bergamifer/DS-Project/hardware/DS/renders/DS7.png

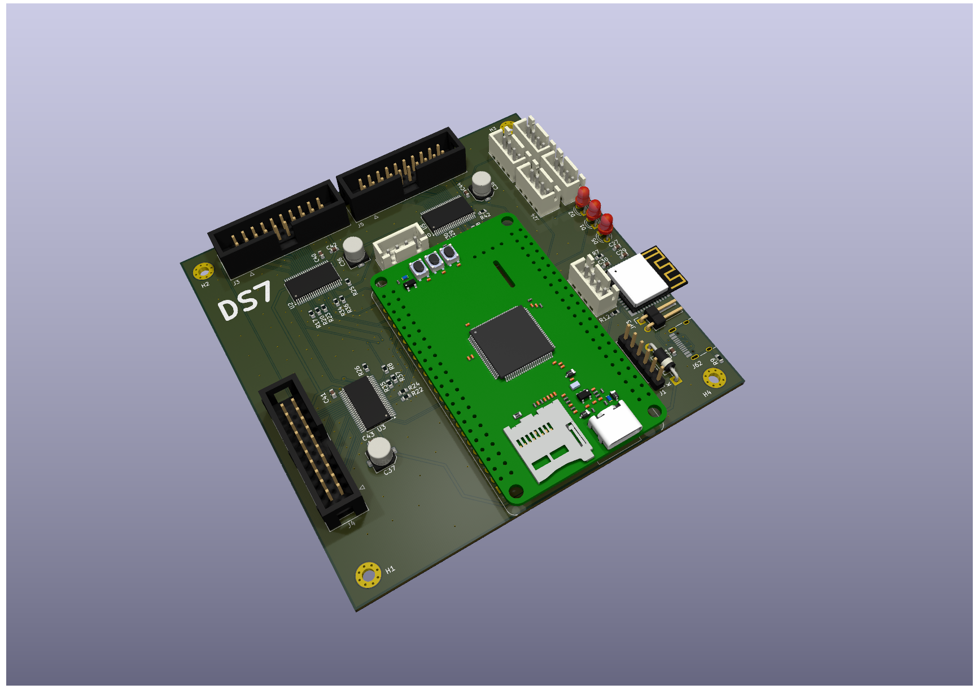
hardware/DS/renders/DS7.png
