bergamifer/DS-Project/hardware/DS/renders/DS9.png

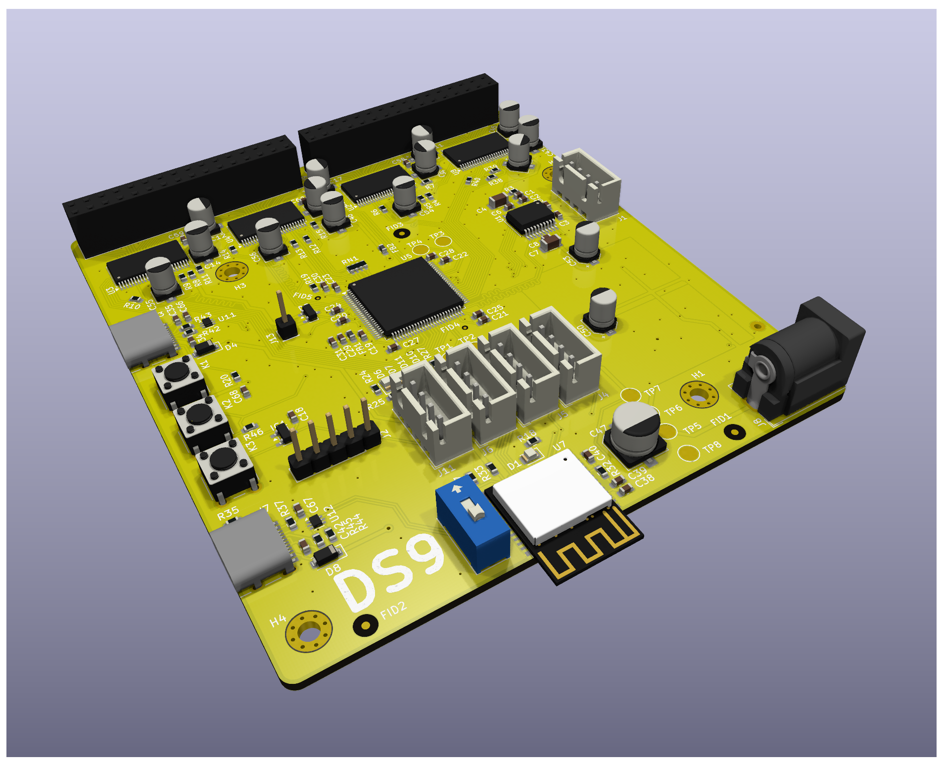
hardware/DS/renders/DS9.png
