bergamifer/DS-Project/Mis-comandos.md

# Comandos y Referencias - DS11 Beamforming (32 canales)

> Lo de más abajo que dice "DS9" es histórico. Lo vigente está en esta sección.

## Checklist al iniciar sesion

- [ ] Conectar ST-Link (SWD). ⚠️ **Cortar el pin 1 del cable** (3V3 sin Schottky
      → colapsa el dongle, ver `docs/ds11_errata.md`).
- [ ] **Si vas a usar ESP32 UART: desconectar ST-Link serial** (contención en PA0/PA1)
- [ ] Fuente a **19-20 V** (NO 24 V) y con **límite de corriente holgado** — un
      límite bajo hace reiniciar la placa al arrancar los amps.
- [ ] Abrir el monitor serie en terminal separada

---

## DS11 — Control por HTTP (lo que más se usa)

```bash
IP=domosonica.local      # mDNS; también sirve la IP de la línea "ESP:" del heartbeat

curl -s http://$IP/status                                   # telemetría completa
curl -X POST http://$IP/amps   -d '{"on":true}'             # ⚠️ arrancan APAGADOS
curl -X POST http://$IP/mode   -d '{"mode":1}'              # 0..15
curl -X POST http://$IP/volume -d '{"db":-24}'              # 0..-63, ≤-64 mute (SALIDA)
curl -X POST http://$IP/ingain -d '{"db":0}'                # 0..36 (ENTRADA: 0=línea, 30=mic)

# Foco TX (mm, relativo al centro del array; fy enfoca desde DS11)
curl -X POST http://$IP/beam -d '{"type":"tx","fx":0,"fy":-300,"fz":1000}'

# Foco de UNA fuente del MULTIFOCUS (src 0-7)
curl -X POST http://$IP/beam -d '{"type":"mf","src":2,"fx":600,"fy":0,"fz":1000}'
```

**Los amps arrancan apagados** desde el incidente de brown-out: sin `POST /amps`
la placa está muda aunque todo el pipeline corra. Sirve como herramienta de
diagnóstico — si algo reinicia con amps ON y no con OFF, es alimentación.

### Modos (16)

| # | modo | | # | modo |
|---|---|---|---|---|
| 0 | Monitor ADC | | 8-11 | RX beam / AUTOFOCUS |
| 1 | **Channel walker** (1 s/ch, 32 s la vuelta) | | 12-13 | Tono enfocado |
| 2-7 | Tonos / TX focus | | 14 | MULTIFOCUS tonos |
| | | | 15 | **MULTIFOCUS 8 entradas** (la intervención) |

### Qué mirar en el heartbeat

```
[Ns] Half: 50/s, Full: 50/s, Err: 0, Undr: N, ... | ESP: <IP>
     SYNC bancos: 1 us (839 cyc) | CPU fills: 26.6%
```

- `Err: 0` — lo único que de verdad tiene que ser cero.
- `SYNC bancos` ~1 µs. Si da **ms**, los bancos se desincronizaron.
- `CPU fills` ~26,6% en modo 7. Si volvés a ver ~60%, revirtió el I-cache o el `-O2`.
- `Undr` sube ~2/s **siempre**: son los prints bloqueantes, no el audio.

---

## Build y Flash (STM32)

```bash
cd /Users/bergamifer/STM32CubeIDE/DS-Firmware/firmware

# Solo compilar
make -j4

# Compilar + Flash via ST-Link (recomendado)
make flash-stlink # No olvidar luego resetar con boton K4

# Limpiar y recompilar
make clean && make -j4
```

**Nota DFU:** Para entrar en modo DFU, mantener BOOT0, presionar RESET, soltar BOOT0.

- Flashear en DFU:
```bash
cd firmware && make flash
```

---

## Debug Serial (UART)

```bash
# Monitor serial ST-Link (UART7, PA8/PA15)
minicom -D /dev/tty.usbmodem21102 -b 115200

# Buscar puertos serie
ls /dev/tty.usb*
ls /dev/cu.usb*

# Para salir de minicom: Ctrl+A luego X
```

## Debug Serial SCREEN (UART) <- el que estamos usando en DS11

screen /dev/cu.usbmodem11102 115200

Para matar screen:
Ctrl-A y después k, confirmás con y ← este es el atajo
Alternativa si quedó colgado de otra terminal: screen -ls y screen -X -S <id> quit

---

## Conexiones ST-Link → DS9

```
ST-Link          DS9 Board
--------         ---------
  GND    ─────   GND
  SWCLK  ─────   PA14 (SWCLK)
  SWDIO  ─────   PA13 (SWDIO)
  3.3V   ─────   3.3V  ⚠️ DS9 sin fuente externa (ver issue #1)
  RST    ─────   NRST (opcional, recomendado)
  TX     ─────   PA8  (UART7_RX) ← debug serial STM32 → host
  RX     ─────   PA15 (UART7_TX) ← debug serial host → STM32
```

```
⚠️ PA0/PA1 compartidos: ST-Link serial TX/RX vs ESP32 UART4
   Desconectar ST-Link serial ANTES de usar ESP32 (contención eléctrica)
```

```bash
# Verificar conexion ST-Link
st-info --probe
```

---

## VS Code Tasks (Cmd+Shift+B)

| Task | Descripcion |
|---|---|
| Build | Compilar (default) |
| Clean Build | Limpiar + compilar |
| Flash (ST-Link) | Flash via SWD |

---

## Webserver (control DS9)

```bash
cd /Users/bergamifer/STM32CubeIDE/DS-Firmware/webserver
./run.sh

# Acceso: http://localhost:5001
# Detener: Ctrl+C
```

---

## ESP32-C3 (IDF)

```bash
# Cargar entorno ESP-IDF
. $HOME/esp/esp-idf/export.sh

# Build + flash + monitor
idf.py build
idf.py flash -p /dev/cu.usbmodem1101
idf.py monitor -p /dev/cu.usbmodem1101

# Flash sin rebootear
idf.py flash -p /dev/cu.usbmodem1101 && idf.py monitor -p /dev/cu.usbmodem1101 --no-reset

# Listar puertos
ls /dev/cu.usb*
```

**UART DS9 wiring confirmado (trazas cruzadas en PCB, 2026-02-19):**
```
ESP32 GPIO0 (TX) ──── PA1 (STM32 UART4 RX)   ← firmware: STM32_UART_TX = GPIO_NUM_0
ESP32 GPIO1 (RX) ──── PA0 (STM32 UART4 TX)   ← firmware: STM32_UART_RX = GPIO_NUM_1
```

---

## Archivos Importantes

| Archivo | Descripcion |
|---|---|
| `firmware/Core/Src/main.c` | Init, clocks 480MHz, DMA, callbacks, main loop |
| `firmware/Core/Src/uart_protocol.c` | Parser binario ESP32→STM32 |
| `firmware/Core/Inc/uart_protocol.h` | Protocol defines, ds_config_t |
| `firmware/Core/Src/pcm1690.c` | Driver PCM1690 DAC |
| `firmware/Core/Src/epaper.c` | Driver SSD1681 e-paper |
| `firmware/STM32H743XX_FLASH.ld` | Linker script (.dma_buffer → RAM_D2) |
| `firmware/Makefile` | Build config (TARGET=ds11_beamforming) |
| `docs/pin_map.md` | Mapa completo de pines (DS10/DS11) |
| `docs/guia_operacion.md` | Guía de uso y conexionado (lenguaje no técnico) |

curl -X POST http://192.168.100.44/command \
  -H "Content-Type: application/json" \
  -d '{"master_gain":0.1,"channels":[
    {"channel_num":0,"channel_gain":1.0},{"channel_num":1,"channel_gain":1.0},
    {"channel_num":2,"channel_gain":1.0},{"channel_num":3,"channel_gain":1.0},
    {"channel_num":4,"channel_gain":1.0},{"channel_num":5,"channel_gain":1.0},
    {"channel_num":6,"channel_gain":1.0},{"channel_num":7,"channel_gain":1.0}
  ]}'
