bergamifer/DS-Project/docs/multinode.md

# Multi-nodo: coordinar 10-15 muros (~500 parlantes) sin conocer su disposición

> Escrito 2026-07-05. Responde: *"¿cómo nos preparamos para cuando el setup incluya 10-15
> de estos sistemas? ¿cómo coordinar todos los parlantes si no sabemos la disposición
> espacial?"* — La respuesta tiene tres capas independientes: **geometría** (dónde está
> cada parlante), **reloj** (cuándo dispara cada uno) y **control** (quién decide qué).

---

## 0. El estado de partida

Cada nodo DS10/DS11: 32 parlantes con geometría interna **conocida y rígida** (el muro),
STM32 que calcula delays muestra-exactos **dentro del nodo**, ESP32 con HTTP en la LAN.
Lo desconocido al montar: la **pose de cada muro** (posición + orientación en la sala) y
la **relación entre relojes** de los nodos.

La app iOS ya implementa la base: registro de nodos con pose (x, z, yaw), transformación
del foco global al marco local de cada nodo, y envío fan-out paralelo (`NodesStore.swift`).
**Con eso, 15 nodos ya se coordinan hoy a nivel de comandos** — lo que falta resolver es
geometría fina y fase.

---

## 1. Capa GEOMETRÍA — ¿dónde está cada parlante?

### Nivel 0 (hoy, sin desarrollo): pose manual + foco medido
- Cinta métrica: posición y yaw de cada muro → editor de nodos de la app.
- El error de ~5-10 cm de medir a mano **se absorbe con AUTOFOCUS**: para los puntos
  focales importantes de una obra, el foco se mide con micrófono, no se calcula.
- Suficiente para: instalación estática con focos ensayados.

### Nivel 1: survey con el iPhone (ARKit)
- El iPhone se localiza solo (~cm) caminando la sala; tocás la esquina de cada muro
  (o apuntás y el LiDAR mide) → poses de los 15 muros en un marco común, en minutos.
- Requiere: app en el teléfono físico (v2a del roadmap).

### Nivel 2: auto-survey acústico — el instrumento se releva a sí mismo
La joya, y es factible con el hardware existente: **cada nodo tiene 8 entradas ADC**.
Con 1 micrófono (barato, de medición) por nodo:

1. El nodo *j* emite un chirp por su parlante *k* (el walker ya hace esto).
2. **Todos** los nodos graban y correlacionan (el AUTOFOCUS ya hace esto).
3. Matriz de TOF entre (nodo j, parlante k) → (nodo i, mic i).
4. Multilateración / MDS (multidimensional scaling) → posiciones de todos los muros
   **a escala real** (la velocidad del sonido da la escala), salvo rotación/traslación
   global — que se fija midiendo 2-3 puntos a mano o con el iPhone.
5. Con 32 fuentes por muro, la **orientación** de cada muro también sale del ajuste.

**El detalle del reloj**: el TOF medido entre nodos incluye el offset de reloj del
receptor. Solución clásica (BeepBeep, Microsoft Research): medición **two-way**
(*j* emite y *i* graba; después *i* emite y *j* graba) — al promediar ambas, el offset
se cancela exactamente. Precisión esperable: ~1 cm.

> Prerrequisito de firmware: timestamp de emisión/captura en cuentas de muestra del
> propio nodo + comando para reportar la correlación (`CMD_GET_CAL_RESULT` extendido).

---

## 2. Capa RELOJ — ¿cuándo dispara cada parlante?

> **ARQUITECTURA REAL (aclarada por Fernando, 2026-07-05):** la señal de audio se
> distribuye **analógica** por el daisy-chain (J9, passthrough pasivo); cada nodo la
> digitaliza, beamformea y reproduce **con su propio cristal**. NO se manda MCLK por
> el cable (24.576 MHz por daisy-chain = pesadilla de integridad de señal); JP2 existe
> solo como salvavidas experimental de banco.

### Por qué la distribución analógica se auto-sincroniza

El modelo mental correcto: **cada nodo es una línea de retardo analógica**. Analógico
entra, analógico sale, retardado τ = N/fs_local (N = latencia del pipeline en muestras).
El reloj local solo importa durante los ~20 ms que la señal vive adentro del nodo — el
error de fase entre nodos **no se acumula** con el tiempo (a diferencia del contenido
generado internamente):

    Δτ entre nodos = latencia × Δppm = 20 ms × 40 ppm ≈ 0,8 µs ≈ 0,27 mm

Dos órdenes de magnitud por debajo del tamaño del foco. La fase del "grid" de muestreo
de cada ADC (que sí precede lentamente entre nodos) **no aparece en la salida**:
muestrear y reconstruir con el mismo reloj reproduce x(t−τ) exacto para señal limitada
en banda. La deriva térmica del cristal mueve ese sub-µs, no lo integra.

**Conclusión: para obras alimentadas por la señal analógica del daisy-chain — el caso
de uso real; el pipeline TX ya lee de `beam_line`, que viene del ADC — NO hace falta
ningún cable de clock.**

### Los dos "peros" reales (ninguno pide cable de clock)

1. **La latencia por nodo debe ser constante y conocida.** El offset RX-DMA↔TX-DMA se
   congela al arrancar y puede diferir entre nodos (hasta ~medio buffer, ms). Es un
   offset **constante** (no deriva).

   > ✅ **MEDIDO 2026-08-25** — `loopback_debug.md` §8. El "hasta medio buffer, ms"
   > de acá era **29× pesimista**: sobre 26 arranques, la latencia del lazo cae en
   > **tres estados discretos** dentro de **4,17 muestras = 87 µs = 30 mm**, no
   > 2500 µs. Pero el problema es real igual: 30 mm son **66° de error de fase a
   > 2,1 kHz** entre dos nodos que arranquen en estados distintos, así que el nivel
   > 1 sigue haciendo falta. Que sea cuantizado en tres estados es buena noticia:
   > apunta a una carrera de arranque con tres desenlaces, no a una dispersión
   > continua. Los reinicios fueron por NRST, pero **eso incluye POR completo de
   > los cinco codecs** (el init baja PC11/PC7 antes que nada), así que el
   > resultado vale.
   >
   > ✅ **MECANISMO EXPLICADO, mismo día** — `loopback_debug.md` §9. Se instrumentó
   > el firmware para leer `NDTR` de los DMA de RX y TX en el instante del chirp:
   > sobre 20 arranques, **la fase RX−TX determina la latencia por completo**, con
   > mapeo uno a uno y sin excepciones. O sea que el nivel 1 de acá abajo es
   > exactamente el arreglo correcto, y llevaría la dispersión entre nodos de
   > **29,8 mm a 0,21 mm (140×)**.
   >
   > 🔑 **Y el nivel 2 no necesita cable.** La fase RX−TX sale de un registro:
   > sin loopback, sin J13, sin adaptador, sin micrófono. El cable hizo falta para
   > *descubrir* la relación, no para *usarla*. Cada uno de los 10-16 nodos puede
   > leer su propia fase al arrancar y saber en qué estado quedó.

   Insight clave: los group delays de los conversores
   son constantes de datasheet idénticas en todas las placas — lo único variable es la
   fase RX↔TX dentro del STM32, visible por firmware. Jerarquía de soluciones (2026-07-05):
   - **Nivel 1 — arranque determinístico** (solo firmware). ✅ **IMPLEMENTADO Y
     VERIFICADO 2026-08-25** — `loopback_debug.md` §10. La receta original decía
     "arrancar RX primero", pero **eso es imposible**: SAI1_A genera el MCLK que
     los PCM1690 y el AK5538 necesitan para su POR, así que el TX va primero por
     obligación. Lo que sí se puede fijar es el RX, enganchándolo al wrap del DMA
     del TX. Resultado medido: la dispersión entre arranques pasó de **29,8 mm a
     0,21 mm (140×)**, y la fase quedó en 0 en 41 de 41 arranques.
   - **Nivel 2 — medición por registros** (gratis): leer NDTR del DMA RX y TX en el
     mismo instante → fase relativa exacta en muestras → compensar en el offset de la
     delay line. Verificación/auto-corrección del nivel 1.
   - **Nivel 3 — loop DAC→ADC** (idea de Fernando): NO necesario para ecualizar entre
     nodos (los conversores idénticos se cancelan), pero valioso como **self-test** de
     toda la cadena (chirp+correlación del AUTOFOCUS por el loop = test de fábrica en
     1 s) y como habilitador del truco del oscilador (abajo). Implementación DS11
     recomendada: **header 2 pines DNP tapeando VOUT ch0 del PCM1690 vía R serie ~1 kΩ**
     → cable patch a una entrada de J9 cuando se necesita; salida de línea el resto
     del tiempo. Menos invasivo que un loop fijo en placa.
2. **El contenido generado internamente sí deriva** (tonos de test, walker, chirps:
   no pasan por el ADC → cristal libre → ~1 ms cada 20-50 s entre nodos). Dos
   mitigaciones que lo resuelven (2026-07-05):
   - **Conmutación coordinada "a las T"**: el comando lleva delay de ejecución
     ("aplicá en 500 ms") y cada nodo ejecuta con timer local → el jitter WiFi
     (10-100 ms) desaparece; el error residual es 50 ppm × 0,5 s = 25 µs. Cambio
     chico al protocolo (campo extra en CMD_SET_MODE/SET_BEAM).
   - **El truco del oscilador en la cabecera** (la solución de fondo): no generar en
     15 lugares — el nodo cabecera genera por su DAC → sale por el tap de línea
     (nivel 3 de arriba) → entra al daisy-chain analógico → los 15 nodos lo
     beamformean como señal externa. El contenido generado viaja por la vía
     autosincronizante y la coherencia vuelve gratis.
   (AUTOFOCUS normal es por-nodo — mic y parlante en el mismo reloj — sin problema.)

   *Nota para calibración cruzada* (mic en nodo A midiendo parlantes del nodo B): la
   deriva durante el scan (50 ppm × 30 s ≈ 1,5 ms) contamina la comparación entre
   canales tempranos y tardíos → scans cortos o re-referenciar intercalando un canal
   fijo.

### Si algún día hiciera falta un clock físico (no ahora)

Solo si el proyecto migra a **distribución digital** del audio (más canales
independientes por nodo que los 8 analógicos). Para ese caso la opción correcta ya
está documentada en DS11_PLANNING (interconexión): **TDM re-driven sobre LVDS** por
Cat5e STP — MCLK+BICK+LRCK+DATA en los 4 pares, regenerado por cada caja (repeater),
terminación 100 Ω, drivers tipo DS90LV047/048, conector RJ45, mismo tendido. El clock
viaja embebido en el link y los SAI esclavos corren de reloj externo (BCK/FS
incluidos — resuelve de paso la objeción MCLK-no-es-BCK/FS de la revisión anterior).
Nunca 24.576 MHz crudo single-ended por el chain.

### JP2, entonces

Queda como lo que Fernando lo diseñó: un **hedge experimental** — probar clock común
entre 2 placas en banco, sin promesa de señal limpia en cable largo. No es parte de la
arquitectura de la instalación. (Verificado en netlist: puente simple sin buffer,
pin1→trunk `SAI1_MCLK`, pin2→J5.7.)

---

## 3. Capa CONTROL — ¿quién decide?

- **Hoy (implementado)**: la app iOS hace fan-out directo — foco global → marco local
  de cada nodo → `POST /beam` en paralelo. HTTP liviano: 15 nodos × 1 request por gesto
  es nada. Escala hasta el taller completo sin más infraestructura.
- **Siguiente**: un **director** (laptop o RPi en la sala) que habla OSC/WebSocket con
  las herramientas musicales (Max, SC, Ableton) y reparte a los ESP32. La app pasa a
  hablar con el director. Necesario cuando haya: partituras con timing fino, varias
  fuentes de control simultáneas, u obras que corren solas.
- **Descubrimiento**: mDNS en el ESP32 (`domosonica-N.local`) → la app arma la lista
  de nodos sola. (TODO firmware, trivial con ESP-IDF.)

---

## 4. Plan concreto por fases (cuando lleguen las DS11)

| Fase | Con qué | Qué validar |
|---|---|---|
| A | 2 nodos | Misma señal analógica a ambos → mic + correlación cruzada: verificar Δτ inter-nodo estable (sub-µs) durante 30+ min y a través de reboots; medir el offset de latencia por nodo; **primer foco de 64 parlantes alimentado por señal externa** |
| B | 2-4 nodos + 1 mic por nodo | Auto-survey acústico two-way → geometría automática; comparar contra cinta métrica |
| C | 10-15 nodos | Director OSC + partituras espaciales; estrés de red WiFi (si satura → los ESP32 a un AP dedicado o Ethernet-over-cat5 del daisy chain) |

### TODOs de firmware que habilita esto (orden sugerido)
0. **Arranque determinístico del pipeline** (TX arranca en el flanco del primer
   callback half-complete del RX, ver §2 Nivel 1) — el más barato de todos (~20
   líneas, sin hardware nuevo) y el que más valor deja listo: dado que ya iguala
   la latencia entre nodos por construcción, es el paso a hacer primero, apenas
   la Fase 1 (RX delay-and-sum) esté validada en un nodo — no hace falta esperar
   a tener la DS11 en mano para implementarlo y probarlo.
1. Lectura de `NDTR` de los DMA RX/TX para verificar el punto 0 sin señal de audio.
2. Campo de "delay de ejecución" en `CMD_SET_MODE`/`CMD_SET_BEAM` (conmutación
   coordinada "a las T", ver §2) — chico, habilita demos multi-nodo sin jitter WiFi.
3. `CMD_GET_CAL_RESULT` — exportar delays/signos/calidad del AUTOFOCUS (hoy solo serial).
4. Timestamps de emisión/captura en cuentas de muestra (para two-way ranging).
5. Chirps con códigos ortogonales (medir 32 canales en 1 s).
6. mDNS + `device_id` único por nodo (ya existe `DEVICE_ID`).
7. Sync de arranque: comando "arm" + trigger común (red o GPIO) — solo si algún día
   se agrega un pulso de sync físico (DS12+); no aplica a la arquitectura analógica actual.

---

## 5. Qué NO hace falta resolver ahora

- Streaming de audio multicanal por red (las obras v1 usan el generador interno +
  delays; el contenido por red es otra etapa).
- Cable de clock entre nodos: la distribución analógica lo hace innecesario para el caso de uso real (§2).
- Posicionamiento del público (otra capa, va por el lado de la app / UWB / visión).

## 6. Viabilidad del fenómeno acústico (evaluación 2026-07-05)

| Factor | Números |
|---|---|
| Banda útil | ~300 Hz – 2,1 kHz (paso intra-muro 8 cm → λ/2); <300 Hz enfoca el "array sala" (apertura de metros); >2,1 kHz lóbulos de rejilla |
| Tamaño del foco | 1 muro @ 2 m: haz ~50-60 cm lateral sin resolución axial. **15 muros rodeando: foco 3D real ~10-20 cm @ 1-2 kHz** |
| Ganancia focal | +30 dB por muro (32 coherentes) + hasta +23 dB entre muros → el foco emerge del campo difuso aun en salas vivas |
| Presupuesto de fase @ 1 kHz | reloj 0,8 µs ✓ · latencia ecualizada <10 µs ✓ · geometría ±1 cm = 29 µs ≈ 10° ✓ · aire ±2 °C ≈ 25 µs ✓ → coherencia >90 % alcanzable; AUTOFOCUS (medido) absorbe todo junto |
| Focos múltiples | por partición de muros (hoy) o multi-tap por canal (2-3 delays sumados; CPU al ~9 %, hay margen) |
| Riesgos rankeados | 1) geometría ±1-3 cm (auto-survey/AUTOFOCUS) · 2) variabilidad de parlantes reciclados (polaridad medida ✓, falta trim de sensibilidad) · 3) sala muy viva (RIR de la app lo diagnostica) · 4) SPL 2,5 W/canal = niveles íntimos |

**Veredicto: viable con confianza alta.** Sin bloqueantes físicos; los desafíos duros
(latencia, geometría, coordinación) tienen camino de ingeniería cerrado, la mayoría por
firmware. Y cada incertidumbre de la tabla es medible con el propio instrumento.

Ver también: [`app_ios.md`](app_ios.md) (roadmap de la app), `NodesStore.swift`
(transformación y fan-out), [`ds11_upgrades.md`](ds11_upgrades.md) (JP2/MCLK).
