bergamifer/DS-Project/docs/protocolo_medicion.md

# Protocolo de medición acústica del enfoque

> **Metodología, no bitácora.** Nació el 2026-07-10 para la DS10 (8 parlantes, array
> lineal) y sigue vigente para DS11 (32 parlantes, array 2D) — lo que cambia son los
> números, no el método.
>
> El principio central —**mic fijo, mover el foco**— es lo más importante de este
> documento: es lo que separa medir el haz de medir la sala. Los resultados de julio
> quedan como referencia de qué esperar.

---

## ✅ RESULTADOS 2026-07-12 — beamforming TX validado en el aire

Primera sesión de campo con el firmware nuevo (dither + volumen unificado + modo 14):

1. **Foco TX audible de oído**: boost sutil y detectable en `{"type":"tx","fx":1000,
   "fy":-240,"fz":4000}` (4 m, 1 m a la derecha). "Sutil" es lo ESPERADO a esa
   distancia: N Fresnel ≈ 0.13 → régimen de haz dirigido (~14° de azimut), no de foco
   puntual; lóbulo ~1.1 m de ancho. El steering funciona.
2. **MULTIFOCUS validado (modo 14)**: 4 tonos simultáneos (1300/1600/1900/2100 Hz),
   cada uno enfocado en su punto (fx −450/−150/+150/+450 @ 1m). **Caminando de
   izquierda a derecha, los tonos aparecen de grave a agudo — el mapa espacial
   coincide con la geometría configurada.** En una sola prueba quedó validado:
   - la superposición de N tablas de delay focales independientes,
   - el mapeo canal→parlante (consistente con el walker),
   - la convención de signos X del marco del oyente,
   - la lectura espacial por frecuencia (analizador espectral como "GPS" del campo).

   El modo 14 es la **precuela funcional de la intervención de 8 entradas**: las
   mismas tablas `mf_delay_q8[8][32]` van a situar 8 señales reales (poesías,
   canales de una banda, …) en 8 puntos de la sala — solo cambia la fuente
   (`delay_line[src]` en vez de tonos).

Pendiente de esta serie: cuantificar el contraste (teléfono con FFT o ECM8000+2i2,
guía en `docs/autofocus_setup.md`) y el test 2k-vs-1k de ancho de spot (~2×).

---

## A. Protocolo de medición para mañana (sin firmware nuevo)

### Principio clave: mic FIJO, mover el FOCO
No mover el micrófono por el campo de estacionarias (el nivel salta por la sala, no por el
haz). Dejar el mic quieto y steerear el foco **encima y afuera** de él: el modo de sala en
ese punto es constante y se cancela; lo que cambia es puro haz.

### Condiciones
- **Espacio abierto o absorbente** (el instinto es correcto — la sala chica y dura fue el
  problema). Afuera, o con frazadas/absorbente alrededor.
- **Distancia 0.5-1 m, NO 2 m.** La física va al revés: a 2 m el foco es más ancho pero la
  mitad de fuerte (nº de Fresnel N: 0.5m≈0.91, 1m≈0.46, 2m≈0.23). Más cerca = campo directo
  domina las reflexiones = más contraste.
- **Frecuencia: 2 kHz (modo 12).** Es la que mejor enfoca (foco ±15cm @1m vs ±27cm a 1kHz)
  sin lóbulos de rejilla (límite d=λ/2 en 2.14kHz).
- **Volumen** conservador (`/volume -20` o más), para no saturar el mic ni la sala.

### Medición con 1 mic (o teléfono con app de SPL)
Mic fijo en el objetivo, sobre el eje del centro del array, a z≈1 m.
1. Foco sobre el mic:  `POST /beam {"type":"tx","fx":0,"fy":-240,"fz":1000}` → anotar `ADCpk c0`.
2. Foco +40cm al lado: `POST /beam {"type":"tx","fx":400,"fy":-240,"fz":1000}` → anotar `c0`.
3. Foco −40cm:         `fx:-400` → anotar.
4. La caída de (1) respecto a (2)/(3) = contraste focal, con el modo de sala **cancelado**
   (mismo punto físico). Esperar varios dB de diferencia si el foco existe.
5. Repetir a z=500 y z=1500 para ver cómo cambia el contraste con la distancia.

### Medición con 2 mics ECM8000 (lo mejor — requiere preamp con phantom)
- Mic A → entrada 1 (c0), Mic B → entrada 2 (c1). El heartbeat ya imprime ambos: **no hace
  falta firmware nuevo.**
- Mic A en el objetivo, Mic B como referencia 40cm al costado.
- Steerear foco sobre A (`fx:0`): sube c0, c1 queda. Steerear sobre B (`fx:+400` si B está a
  la derecha): sube c1, c0 queda. Ese cruce es la prueba más convincente e inmune a la sala.

### Prueba cualitativa (por oído, sin instrumento)
Barrer el foco lentamente de lado a lado (`fx` de −400 a +400) parado en el punto objetivo:
si el instrumento enfoca, se oye pasar el nivel. (Automatizable — ver backlog #4.)

### Qué NO medir todavía
- Modos RX beam (2-6): usan geometría de mics placeholder de 8 canales que **nunca va a
  existir** (máx 2 mics). El instrumento es un **proyector TX**; los mics son solo medición.

---

## B. Backlog de implementación (para cuando vuelva el crédito)

Ordenado por valor:

1. ✅ **HECHO 2026-07-11** — **Dither de frecuencia (Fase B del plan de tono)** — el matador
   de modos de sala. Triángulo ±5% a 3Hz sobre `tone_base_hz`, actualizado por half-buffer
   (pasos ≤0.3%/10ms, fase continua → sin clicks). Activo siempre en modos 12/13.

2. ✅ **HECHO 2026-07-11** — **Unificar el volumen** — el `(s*master)>>8` salió del fill TX;
   `/volume` (atenuador DAC) es el único maestro. `gains[ch]` y `mute_global` conservados.
   El campo `master_gain` queda en el struct solo por compatibilidad de layout EEPROM.

3. **Modo de medición con 2 mics + contraste automático** — un modo que steerea el foco
   ON/OFF del mic automáticamente y reporta por UART el Δ dB (contraste focal) usando c0 (y
   c1 como referencia diferencial). Convierte el protocolo manual de arriba en un número.

4. **Modo "haz audible" (Fase C del plan de tono)** — `fx` barre −600→+600mm en ~6s. Parado
   enfrente se oye pasar el haz. Validación cualitativa instantánea sin instrumental.

5. **Resiliencia WiFi de la app** — tolerar 2-3 polls fallidos antes de marcar offline
   (los cortes por cambio de canal del router se vuelven invisibles). Swift puro.

6. **mDNS en el ESP32** (`domosonica.local`) — dejar de cazar la IP.

7. **Ventaneo de Hann por canal** — usa `gains[ch]` para bajar lóbulos laterales. Recién
   cuando se pueda medir el patrón (con el dither #1 y el contraste #3 andando).

8. **CMD_GET_CAL_RESULT** — exponer delays/signos/calidad del AUTOFOCUS por protocolo.
   Requiere mic + preamp; el AUTOFOCUS de 1 mic ya existe.

---

## C. Bugs de una review cruzada (2026-07-10) — verificados contra el código

Priorizados. El #1 tiene un matiz importante para el protocolo de medición (§A).

1. ✅ **FIXEADO 2026-07-11 (por rama, como se especifica abajo).**
   **`UI_ApplyCustomBeam` no maneja el estado del tono** (main.c ~2230). Apaga
   walker/monitor/autofocus pero NO toca `tone_enabled` ni `beam_out_shift`.
   - Efecto: en modo tono (12/13), un `POST /beam type=rx` deja el tono sonando → oís
     el tono de 2kHz creyendo que escuchás los mics.
   - **FIX POR RAMA (no blanket):** apagar el tono SOLO en la rama `type=rx`
     (`tone_enabled=0; beam_out_shift=5;`), y **preservarlo en `type=tx`** (steerear el
     foco del tono es un caso válido — es el protocolo de medición §A). Un fix que apague
     el tono en ambas ramas rompería la medición.
   - **Para las mediciones de §A `type=tx` YA funciona bien** con el código actual; el bug
     solo afecta `type=rx`, que no se usa mañana.

2. ✅ **FIXEADO 2026-07-11** (debounce unificado `CFG_SAVE_DEBOUNCE_MS` para modo, volumen
   y `CMD_UPDATE_CFG`; el slider ya se puede arrastrar).
   **El volumen guarda en EEPROM sin debounce** (main.c ~964). Cada `CMD_SET_VOLUME`
   dispara un save inmediato (~12ms bloqueo ≈ 6 underruns). Arrastrar el slider de volumen
   de la web = ráfaga de glitches. Reusar el `mode_save_due_tick` (debounce 3s) para el
   volumen y para `CMD_UPDATE_CFG`. **Para mañana: cambiá el volumen con `curl` a valores
   discretos, no arrastres el slider web.**

3. **ACK/NACK bloqueante en el ISR** (uart_protocol.c ~262). `send_ack` bloquea ~0.4ms
   dentro del handler de UART4, y si el main loop está en `UART_Protocol_SendStatus`
   (mismo UART) el ACK devuelve BUSY y se pierde → el ESP32 hace timeout. Encolar el ACK y
   mandarlo desde el main loop.

4. **Carrera en `current_config`** (uart_protocol.c ~216 vs main.c ~1001). El ISR hace
   `memcpy` mientras el main loop la lee; dos configs muy seguidas → lectura mezclada.
   Copiar bajo `__disable_irq()` o doble buffer.

5. **UART7 mezcla TX bloqueante + IT** — `UART_Protocol_PrintConfig` manda ~1200 bytes por
   IT (~104ms) mientras `UART_Print` es bloqueante sobre el mismo UART7 → durante esos
   ~100ms los prints devuelven BUSY y se pierden en silencio (el "Config applied" que sigue
   probablemente nunca sale). No rompe nada, explica logs faltantes.

6. **Walker: desfase de canal entre bancos en el cruce de segundo** (main.c ~2509).
   Cosmético con solo U2 poblado; en DS11 (32ch) puede dar un half de 10ms con dos
   parlantes o ninguno en cada transición de segundo.

7. **Código muerto**: `test_tone_enabled` no se setea nunca (main.c ~183) y el path
   "default" de `Fill_Audio_Beamform` (playback con `beam_config.delays[]` por canal) es
   inalcanzable con el set actual de modos. Borrarlos o marcarlos — hoy sugieren un
   comportamiento de `CMD_UPDATE_CFG` que no existe.

**Menores** — ✅ ambos fixeados 2026-07-11: `eeprom_write_page` ya solo espera los 6ms
cuando la escritura fue OK; el header de eeprom_config.c ahora dice **AF6** (el AF11 del
design review era un error, confirmado en el bring-up).

> Nota de honestidad: mi primera revisión (más arriba en la sesión) dijo "sin bugs" — se me
> pasó el #1 por no cubrir `UI_ApplyCustomBeam`. La review cruzada fue más exhaustiva.

---

### Nota de arquitectura confirmada (2026-07-10)
- El instrumento es un **proyector TX**. Los micrófonos (máx **2** ECM8000) son herramientas
  de **medición/calibración**, no beamforming RX. MIC_COUNT=8 y los modos RX beam quedan como
  código muerto — no invertir en ellos.
- ECM8000: condenser, **necesita +48V phantom + preamp** (la placa da nivel de línea, no
  phantom). Sin preamp, medir con app de SPL del teléfono (el protocolo mic-fijo/foco-móvil
  funciona igual).

---

## D. Captura remota del ADC (2026-08-23)

Hasta acá, medir en este equipo era **mirar números por el cable serie**. El modo
19 (LOOPBACK) hace una medición completa y devuelve *un* pico y *un* retardo;
todo lo demás —la forma de onda, el contenido en frecuencia, lo que pasa entre
canales— se calculaba adentro del STM32 y se tiraba.

`GET /capture?n=2048` baja las **ocho entradas crudas**. La placa deja de tener
que saber de antemano qué se le va a preguntar.

```bash
python3 tools/captura.py                   # 2048 muestras (43 ms), ~3 s de bajada
python3 tools/captura.py -n 8192           # 170 ms, ~11 s
python3 tools/captura.py archivo.ds        # analizar uno ya bajado
```

Escribe un **`.wav` de 8 canales a 48 kHz** —abrible en Audacity— y saca por
pantalla nivel por entrada, frecuencia dominante y el **retardo entre canales por
correlación cruzada**, en muestras, microsegundos y milímetros de camino
acústico.

### El autorrango, que no es un detalle

Las muestras se guardan en `int32` con los 24 bits del ADC y se transmiten en
`int16`. El desplazamiento se elige **después** de capturar, con el pico ya
conocido, como el mínimo que no recorta.

Con un desplazamiento fijo de 8 —el que haría entrar la escala completa— el piso
de ruido, que son unas decenas de cuentas, quedaría en **cero**. La primera
captura real salió con `>>0` justamente porque el pico era 286: con un
desplazamiento fijo habría sido un archivo de ceros. `crudo = muestra << shift`.

### Primera medición: el piso de ruido de las 8 entradas

Primera captura, 2048 muestras (2026-08-23):

| entrada | pico | RMS (dBFS) |
|---|---|---|
| 0-3 | 59-70 | **−113,4** |
| 4 | 286 | −102,3 |
| 5 | 268 | −103,8 |
| 6 | 165 | −106,4 |
| 7 | 121 | −107,6 |

Las entradas 4-7 tenían ~10 dB más de ruido que las 0-3. La primera lectura fue
que el gradiente seguía la separación física de los dos conectores RJ45 y que
había algo que mirar con osciloscopio. **Era el cable, no la placa** — ver abajo.

### El piso de ruido mide el cableado, no el conversor (2026-08-24)

La captura se había anotado como "sin nada conectado" y eso era falso: cuatro
entradas tenían cable. Fernando lo aclaró y el resto se resolvió midiendo.

**Cómo se identificó cada entrada, sin estar en la placa**: el jack de la Mac
estaba ocupado por el miniplug y era la salida por defecto, así que un tono
inyectado ahí entra a la DS11 y no suena por los parlantes. Se reprodujo un WAV
estéreo con **L = 492,19 Hz y R = 1007,81 Hz** (bins exactos de la FFT a
48k/2048, así no hay leakage) y la captura dijo cuál era cuál sin ambigüedad:
entrada 6 → 492,2 Hz, entrada 7 → 1007,8 Hz, ambas a −46,5 dBFS.

> Truco reutilizable: **frecuencia distinta por canal = etiqueta**. Sirve para
> verificar cualquier conexionado sin tocar la placa ni saber de antemano dónde
> entró cada cosa.

Resultado, captura de 8192 muestras (170 ms = 8 ciclos de red), en dBFS:

| banda | 0-3 (nada) | 4-5 (cable al aire) | 6-7 (cable a la Mac) |
|---|---|---|---|
| **línea de 50 Hz** | −131 … −142 | **−106,6 / −116,2** | −138 |
| 3er armónico (150 Hz) | −140 … −145 | **−114,2 / −120,1** | −134 |
| ancho de banda 5k-20k | −114,3 ± 0,1 | −103,3 / −103,9 | −105,1 / −105,9 |

Tres firmas distintas, las tres explicadas:

- **0-3, nada conectado → −113,4 dBFS.** Es el piso real del AK5538. Las cuatro
  entradas caen dentro de **0,2 dB** entre sí: el conversor está sano.
- **4-5, cable con la punta al aire → línea de 50 Hz 30 dB por encima.** Una
  punta flotante de alta impedancia es una antena de red excelente. Es la
  entrada más ruidosa de las ocho y la única con armónicos de red.
- **6-7, cable conectado a la salida de la Mac → pico en Nyquist, sin red.** La
  impedancia baja de la fuente cortocircuita la captación de 50 Hz (queda tan
  limpia como las entradas vacías); lo que sube es ruido ultrasónico, que es la
  firma del *noise shaping* del DAC sigma-delta de la Mac.

La elevación de banda ancha (~10 dB) aparece en **las cuatro entradas
cableadas**, con cable conectado o no: la agrega el cable, no el circuito.

**No hay nada que arreglar en la placa, y no hace falta el osciloscopio.** La
conclusión que sí queda en pie, y ahora confirmada: el piso del conversor son
**−113,4 dBFS**, unos 20 dB mejor que una fuente de 16 bits con dither
(≈ −93 dBFS) — el número que usa `docs/bypass_digital_veredicto.md` §5.

**Corolario de método**: al medir piso de ruido, anotar el estado de cada entrada
(vacía / cable al aire / cable a fuente). Sin ese dato la medición no significa
nada, y una entrada con el cable suelto se lee como una placa defectuosa.

### El riesgo de medir con la computadora enchufada

Advertencia de Fernando, y es correcta: si hay entradas cableadas a la
computadora, **cualquier sonido suelto cae dentro de la ventana de captura** —una
llamada de WhatsApp, una notificación, un audio— y se lee como piso de ruido. Una
captura sola no puede distinguir un piso de un accidente: son 43 o 171 ms.

Por eso `captura.py` tiene **`--repetir N`**: toma N capturas, analiza la mediana
(robusta, un outlier no la mueve) e imprime el rango por entrada, que es la
evidencia de que no hubo ninguno. Avisa si alguna entrada varía más de 6 dB.

    python3 tools/captura.py -n 8192 --repetir 5     # así se mide piso de ruido

Verificación de las cifras de arriba, 5 capturas de 8192 (2026-08-24):

| entrada | rango entre capturas |
|---|---|
| 0-3 (vacías) | **0,1 – 0,5 dB** |
| 4-5 (cable al aire) | 0,5 – 0,8 dB |
| 6-7 (cable a la Mac) | 1,4 dB |

Sin outliers. Un sonido suelto habría movido 6-7 decenas de dB, no 1,4 — el
audio a nivel audible está unos 60 dB por encima de este piso, no es sutil.

**Las dos conclusiones que importan son inmunes por construcción de todos modos**:
los −113,4 dBFS del conversor salen de las entradas 0-3, que no tienen nada
conectado, y la línea de 50 Hz sale de las 4-5, cuyo miniplug está desenchufado
de la computadora. Ninguna de las dos puede recibir audio de la Mac. Lo único que
dependía de las entradas 6-7 era la firma ultrasónica del DAC de la fuente.

### Formato

16 bytes de cabecera (`ds_cap_info_t` de `firmware/Core/Inc/uart_protocol.h`) y
después `int16` little-endian intercalados por canal. Los tramos se piden de a
uno con su offset —igual que los de firmware llevan número de tramo— así una
trama perdida se nota en vez de correr todo lo que sigue.

### Lo que habilita

- **Cuando esté el puente de J13**: en vez de un pico y un retardo, la respuesta
  completa del equipo medida sobre sí mismo.
- **Con un micrófono**: el experimento 17-vs-16 —el que decide cuánto gastar en
  hardware de DS12— deja de depender del oído y pasa a ser un número.
