bergamifer/DS-Project/docs/pcm1690_ref.md

# PCM1690 — Referencia de Configuración

**Dispositivo:** Texas Instruments PCM1690
**Proyecto:** Domosonica DS10 (4× chips = 32 canales)
**Última revisión:** Abril 2026 — designadores actualizados a DS10

## Instancias en DS10

| DAC | Ref DS10 | Ref DS9 | I2C (8-bit) | SAI | Canales |
|-----|---|---|---|-----|---|
| DAC0 | **U2** | U3 | 0x98 | SAI1_A | ch 0-7 |
| DAC1 | **U3** | U4 | 0x9C | SAI1_B | ch 8-15 |
| DAC2 | **U1** | U2 | 0x9A | SAI2_A | ch 16-23 |
| DAC3 | **U4** | U8 | 0x9E | SAI2_B | ch 24-31 |

**DS10 simplifica control:** RST y AMUTEI son buses compartidos (PC11, PC12). No hay GPIO por-chip. Llamar `PCM1690_Init()` con `pins=NULL`.

---

## Descripción General

DAC de 8 canales, 24-bit, 192 kHz sampling rate con arquitectura Delta-Sigma mejorada y salidas diferenciales.

### Especificaciones Clave

```
SNR:           113 dB (EIAJ, A-weighted @ 48 kHz)
THD+N:         -94 dB (@ 48 kHz, VOUT = 0 dB)
Rango dinámico: 113 dB
Canales:       8 (4 pares estéreo o 8 mono)
Salidas:       Diferenciales, 1.6 × VCC1 Vpp (8 Vpp típico)
Nivel DC:      0.5 × VCC1 (2.5V típico)
```

---

## Alimentación

### Requisitos de Voltaje

```c
VCC1, VCC2:  5.0V ± 0.5V  // Analógico
VDD:         3.3V ± 0.3V  // Digital
```

### Consumo de Corriente @ 48 kHz

```c
ICC (analog):   74 mA típico, 110 mA máximo
IDD (digital):  57 mA típico, 90 mA máximo
Potencia total: 558 mW típico, 847 mW máximo
```

### Esquema de Alimentación

```
[5V Reg] ──┬── VCC1 (pin 25) ──┬── C4 (10μF) ─┬── GND
           │                    └── C1 (1μF)  ─┘
           └── VCC2 (pin 47) ──┬── C5 (10μF) ─┬── GND
                               └── C2 (1μF)  ─┘

[3.3V Reg] ── VDD (pin 12) ────┬── C6 (10μF) ─┬── GND
                               └── C3 (1μF)  ─┘

VCOM (pin 26) ──── C_VCOM (1μF) ──── AGND1
```

**Notas:**
- C1-C3: cerámicos 1μF (X7R o mejor), colocar lo más cerca posible de los pines
- C4-C6: electrolíticos 10μF, baja ESR
- AGND1 (pin 27) y AGND2 (pin 46) conectados al plano analógico
- DGND (pin 13) conectado al plano digital
- Planos analógico y digital unidos en un solo punto

---

## Sistema de Reloj

### Relaciones SCKI/fS Soportadas

| **fS (kHz)** | **SCKI Soportados** | **BCK típico** |
|---|---|---|
| 48 | 256fS, 384fS, 512fS, 768fS, 1152fS | 12.288 MHz (256fS) |
| 96 | 128fS, 256fS, 384fS | 12.288 MHz (128fS) |
| 192 | 128fS, 192fS | 12.288 MHz (64fS)  |

### Configuración para Domosonica DS @ 48 kHz

```c
fS (LRCK):    48 kHz
SCKI:         12.288 MHz (256fS) ← de PLL3
BCK:          12.288 MHz (256fS)
Modo:         Single Rate (auto)
OSR Digital:  x128
OSR Modulador: x8
```

**Importante:** SCKI, BCK y LRCK deben ser síncronos (misma fuente de reloj). No requieren fase específica pero SÍ relación frecuencial exacta.

---

## Interfaces de Audio Soportadas

### Formato TDM8 (Recomendado para DS)

**Configuración:**
```c
FMTDA[3:0] = 0110  // 24-bit I²S mode TDM (Registro 65, bits 3:0)

// o

FMTDA[3:0] = 0111  // 24-bit Left-justified mode TDM
```

**Temporización TDM @ 48 kHz:**
```
Frame period: 1/48kHz = 20.833 μs
BCK:          256 cycles por frame
Slot width:   32 BCK cycles por canal
Slots:        8 slots (Ch1-Ch8)
Data width:   24 bits por slot
```

**Diagrama TDM8:**
```
LRCK   ───┐                                                      ┌──
          └──────────────────────────────────────────────────────┘
          |<------------------- 256 BCK cycles ------------------>|

BCK    ┐ ┌┐ ┌┐ ┌┐ ┌┐     ┌┐ ┌┐     ┌┐ ┌┐     ┌┐ ┌┐     ┌┐ ┌┐
       └─┘└─┘└─┘└─┘└─...─┘└─┘└─...─┘└─┘└─...─┘└─┘└─...─┘└─┘└─
         |<- Ch1 ->| ....  |<- Ch8 ->|
         32 BCK     ....    32 BCK

DIN1   [23][22]...[0]....[23][22]...[0]
       |<--- Ch1 --->|...|<--- Ch8 --->|
```

**Mapeo de canales en Single Rate:**
```
DIN1: Ch1, Ch2, Ch3, Ch4, Ch5, Ch6, Ch7, Ch8
      └─────────── 256 BCK cycles ─────────────┘
```

### Otras Interfaces Soportadas

| **Formato** | **Data bits**  | **BCK/frame** | **FMTDA[3:0]** |
|---|---|---|---|
| I²S | 16/20/24/32 | 64, 48, 32 | 0000 |
| Left-justified | 16/20/24/32 | 64, 48, 32 | 0001 |
| Right-justified  | 24 | 64, 48 | 0010 |
| Right-justified  | 16 | 64, 48, 32 | 0011 |
| DSP I²S mode | 24 | 64 | 0100 |
| DSP LJ mode | 24 | 64 | 0101 |

---

## Configuración I²C
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
