bergamifer/DS-Project/docs/img_osc/PIC_8211.png

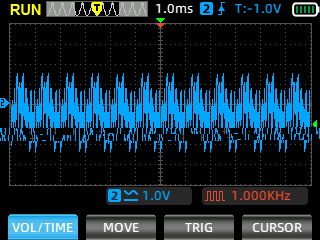
docs/img_osc/PIC_8211.png
