bergamifer/DS-Project/docs/img_osc/PIC_8212.png

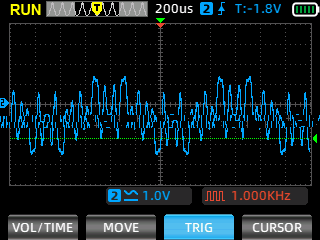
docs/img_osc/PIC_8212.png
