bergamifer/DS-Project/hardware/DS/datasheets/ampli.png

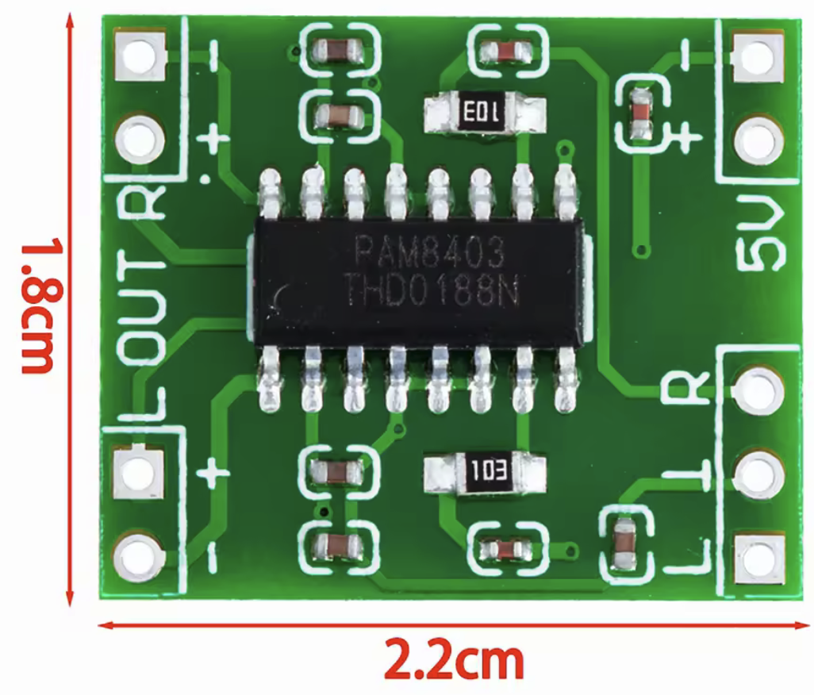
hardware/DS/datasheets/ampli.png
