bergamifer/DS-Project/hardware/DS/datasheets/Screenshot 2025-06-04 at 2.56.02 PM.png

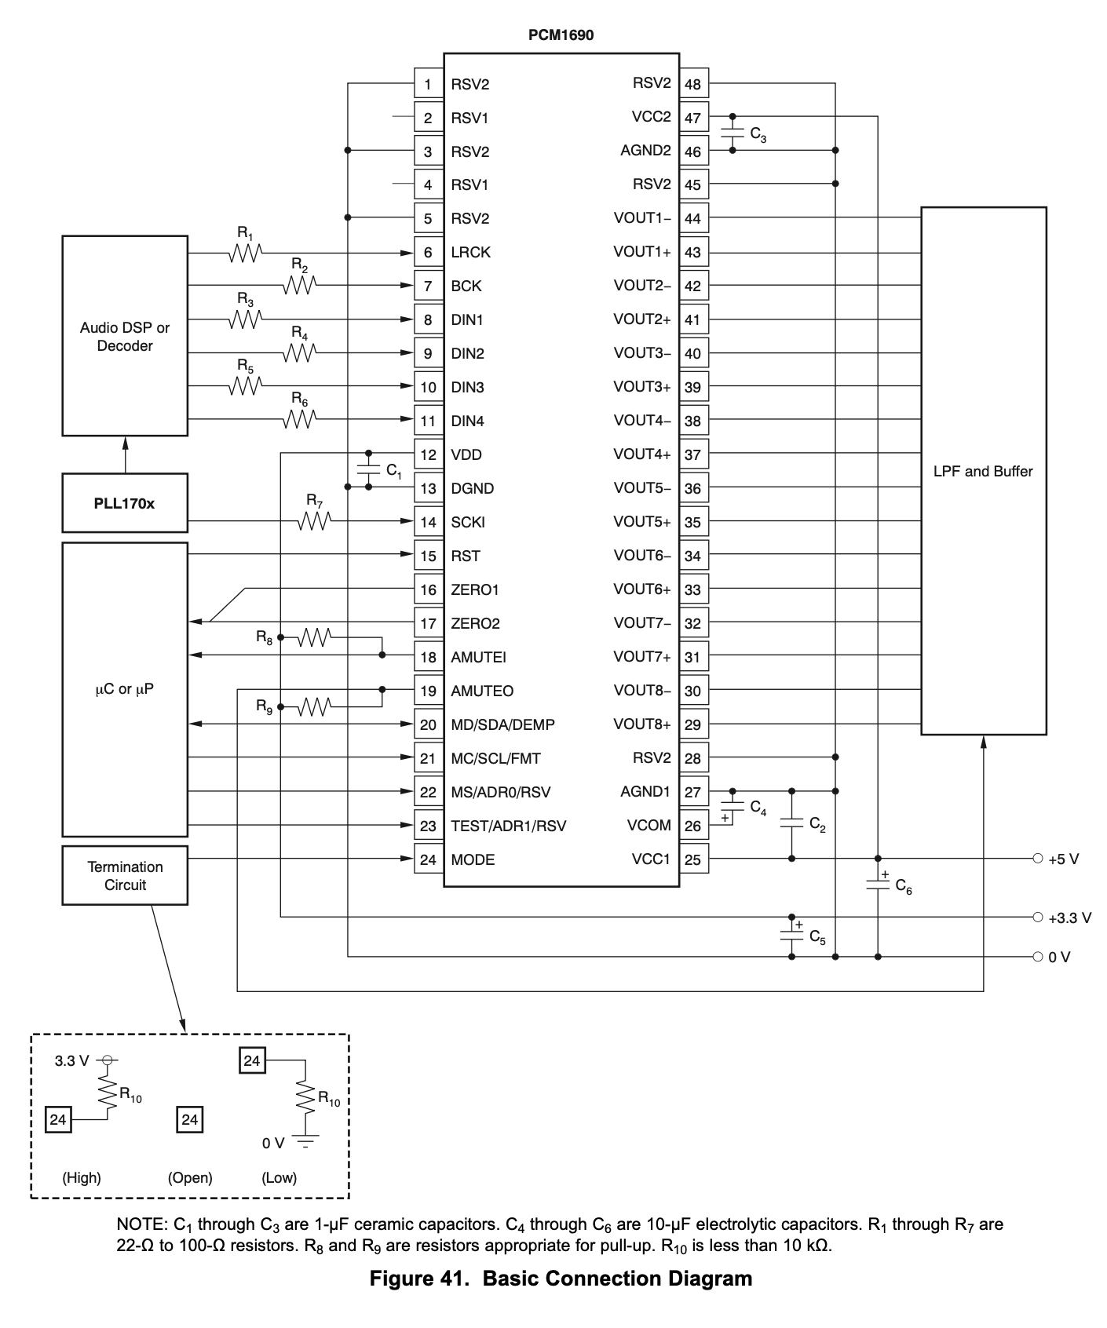
hardware/DS/datasheets/Screenshot 2025-06-04 at 2.56.02 PM.png
