bergamifer/DS-Project/hardware/DS/librerias/footprints/power-barrel-connector-jack-1.snapshot.1/Power Barrel Connector Jack 694106301002.png

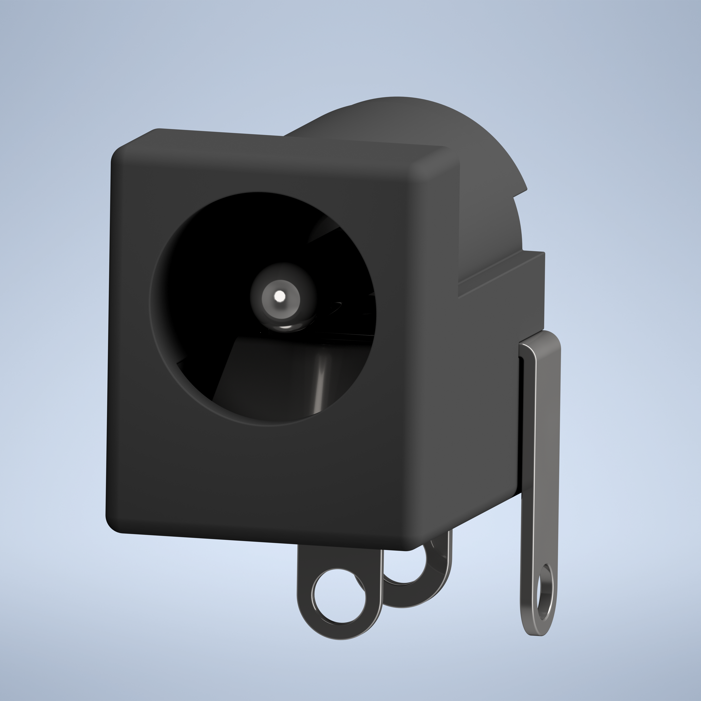
hardware/DS/librerias/footprints/power-barrel-connector-jack-1.snapshot.1/Power Barrel Connector Jack 694106301002.png
