bergamifer/DS-Project/hardware/DS/plots_png_600/_pdf/DS-B_Cu.png

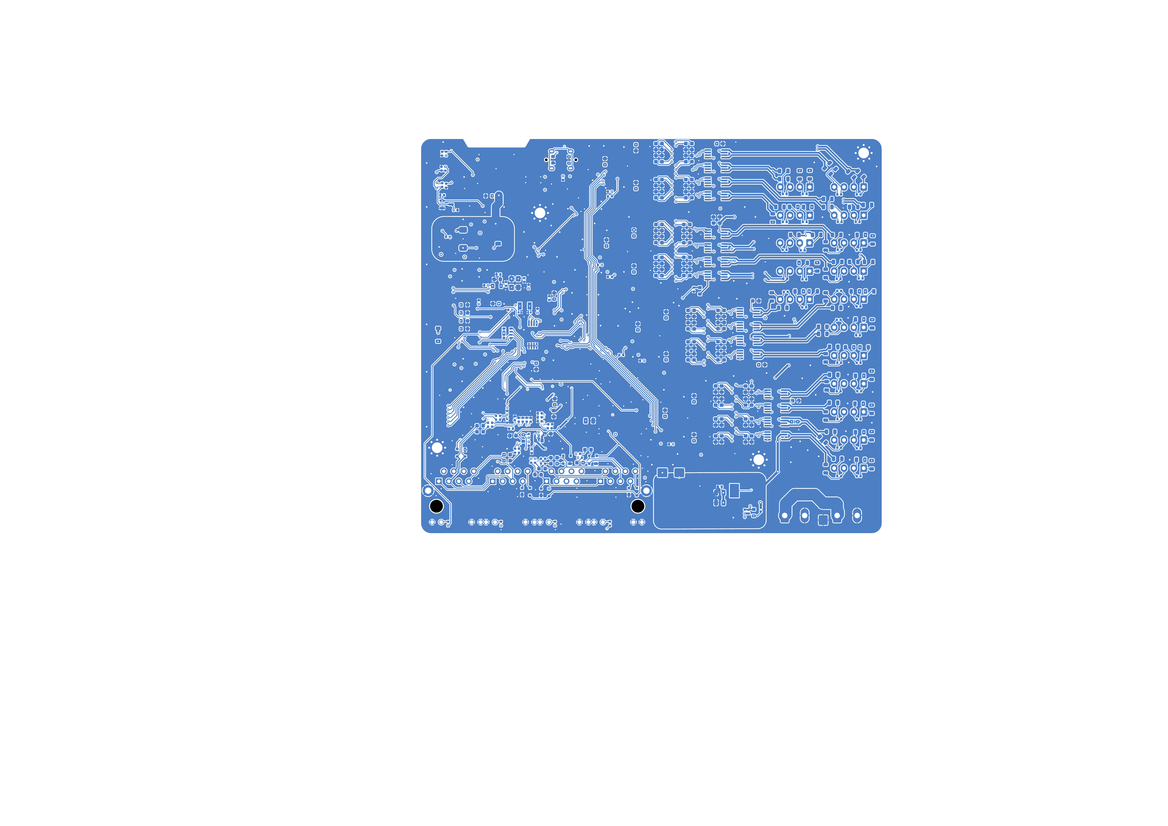
hardware/DS/plots_png_600/_pdf/DS-B_Cu.png
