bergamifer/DS-Project/hardware/DS/plots_png_600/_pdf/DS-F_Mask.png

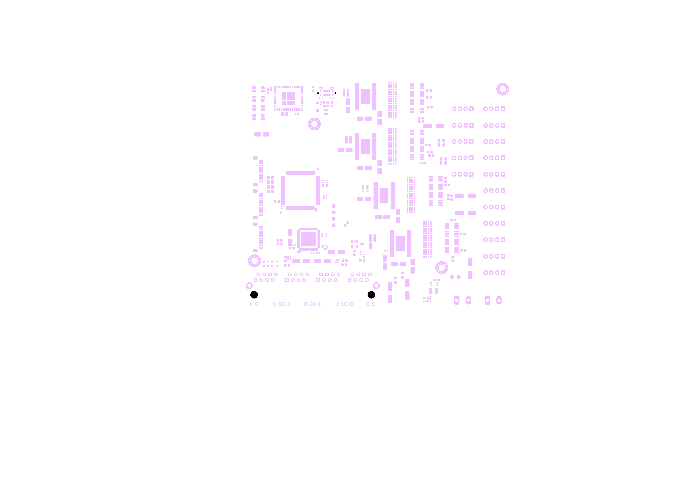
hardware/DS/plots_png_600/_pdf/DS-F_Mask.png
