bergamifer/DS-Project/hardware/DS/plots_png_600/DS-B_Cu.png

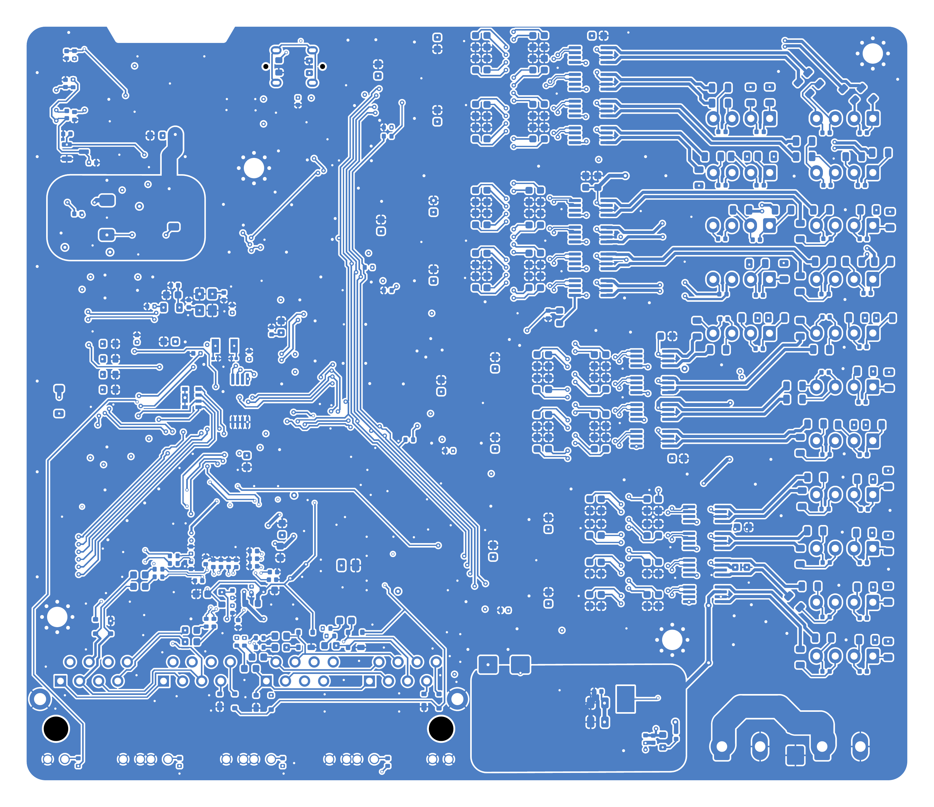
hardware/DS/plots_png_600/DS-B_Cu.png
