bergamifer/DS-Project/hardware/DS/plots_png_600/DS-B_Mask.png

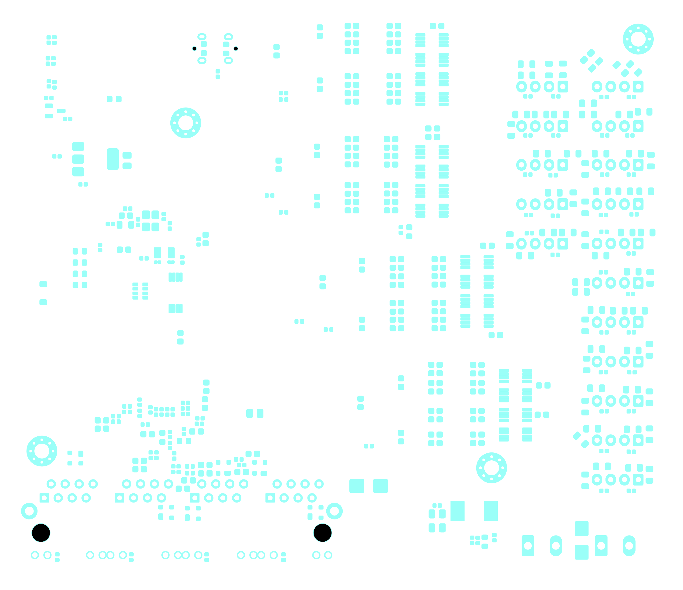
hardware/DS/plots_png_600/DS-B_Mask.png
