bergamifer/DS-Project/hardware/DS/plots_png_600/DS-B_Paste.png

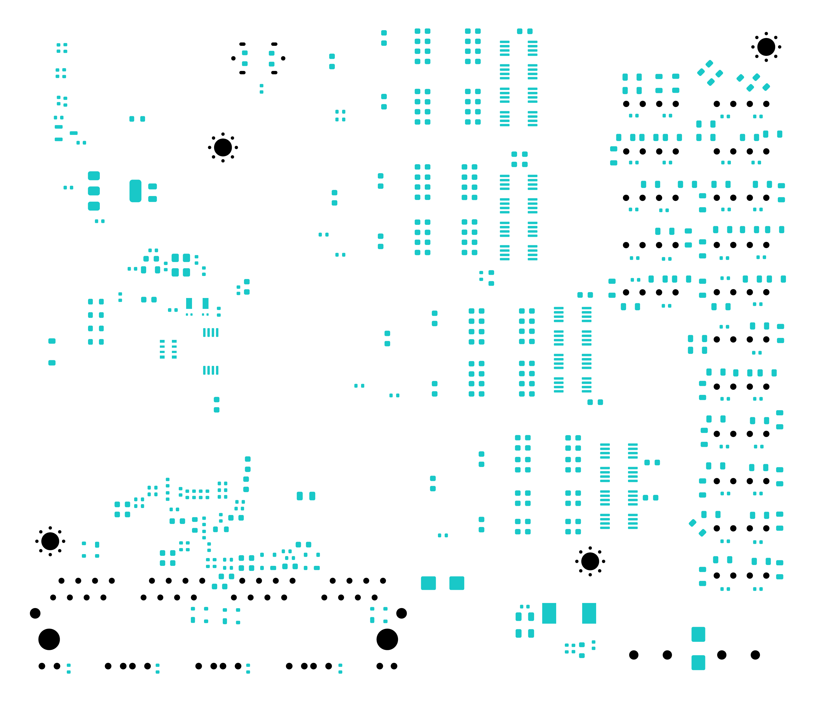
hardware/DS/plots_png_600/DS-B_Paste.png
