bergamifer/DS-Project/hardware/DS/plots_png_600/DS-B_Silkscreen.png

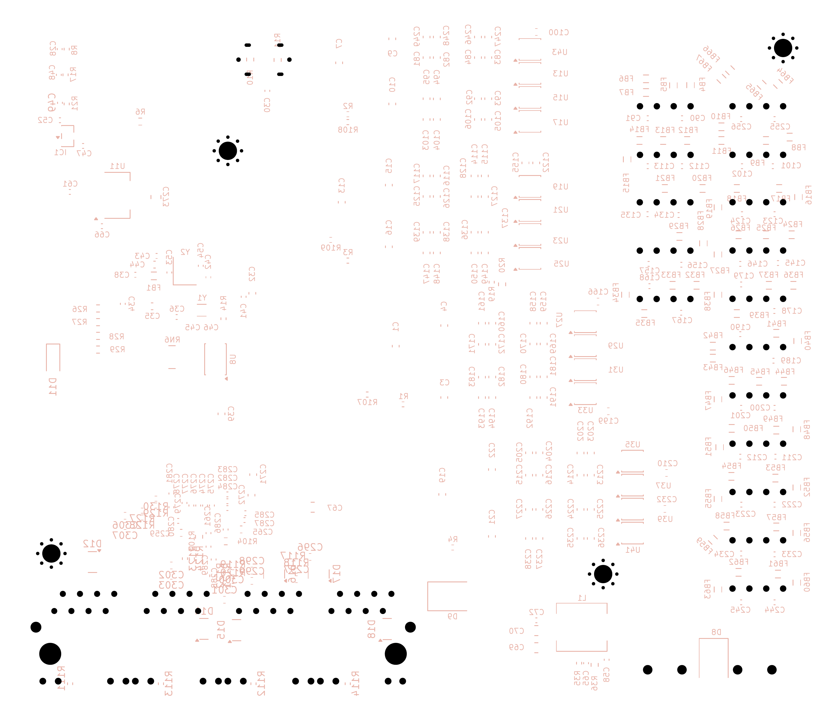
hardware/DS/plots_png_600/DS-B_Silkscreen.png
