bergamifer/DS-Project/hardware/DS/plots_png_600/DS-Edge_Cuts.png

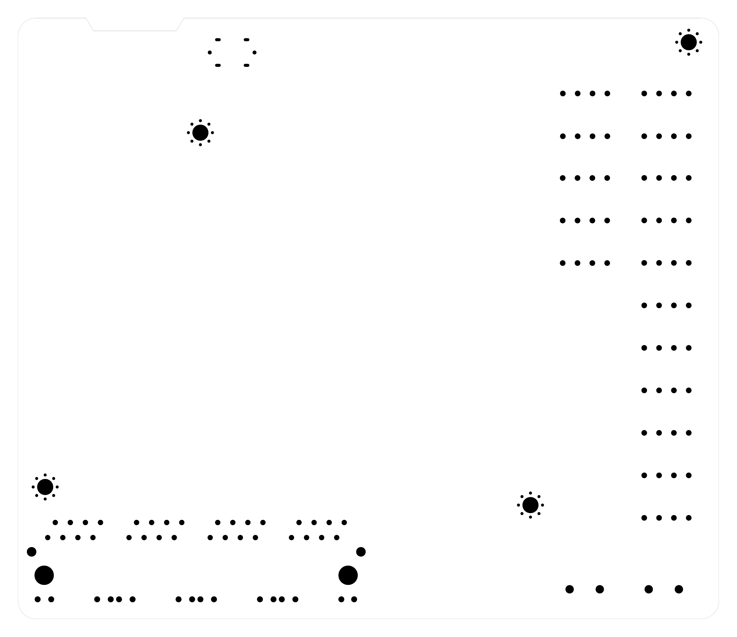
hardware/DS/plots_png_600/DS-Edge_Cuts.png
