bergamifer/DS-Project/hardware/DS/plots_png_600/DS-F_Paste.png

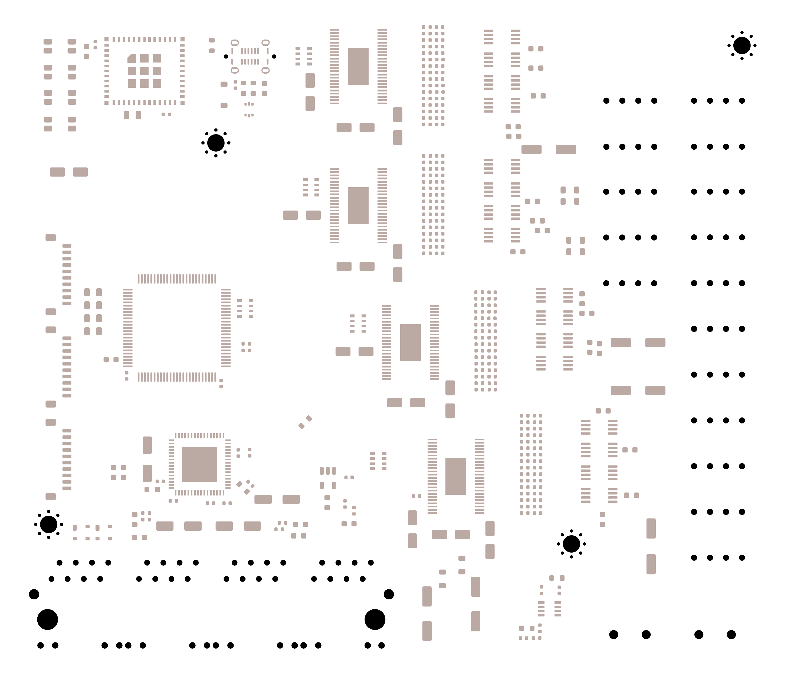
hardware/DS/plots_png_600/DS-F_Paste.png
