bergamifer/DS-Project/hardware/DS/plots_png_600/DS-In1_Cu.png

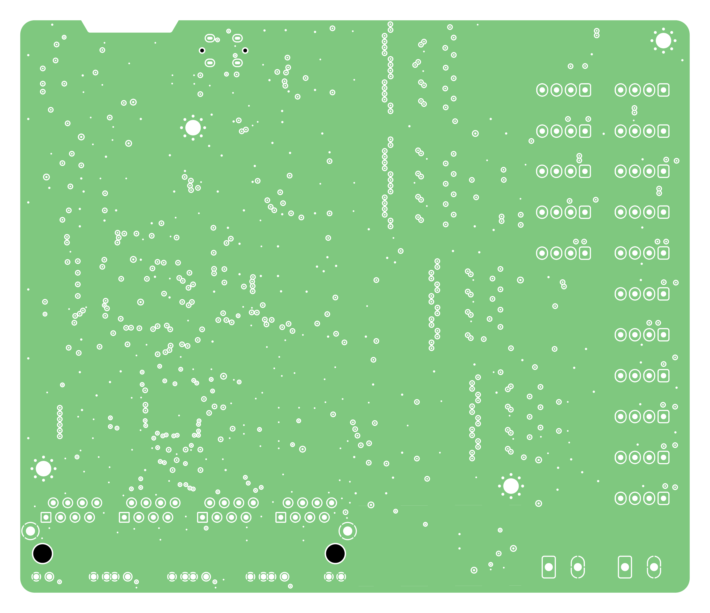
hardware/DS/plots_png_600/DS-In1_Cu.png
