bergamifer/DS-Project/hardware/DS/plots_png_600/DS-In2_Cu.png

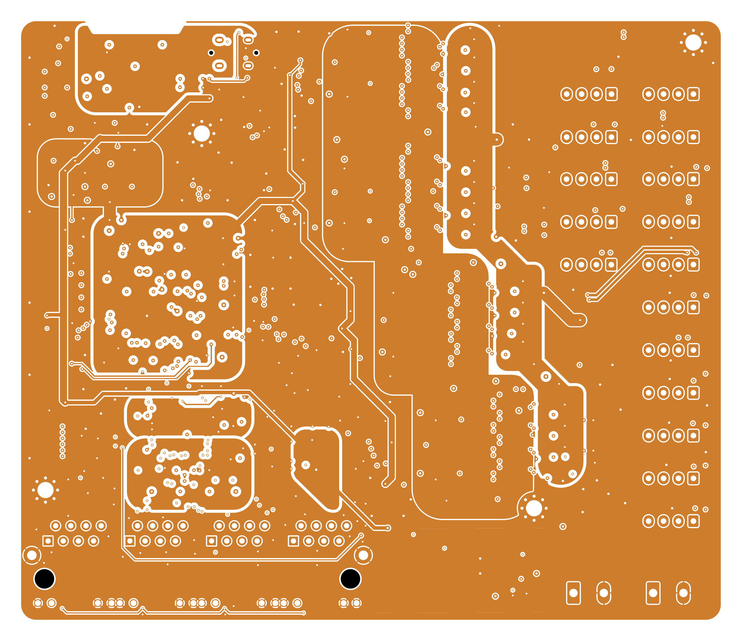
hardware/DS/plots_png_600/DS-In2_Cu.png
