bergamifer/DS-Project/hardware/DS/renders/DS7-2.png

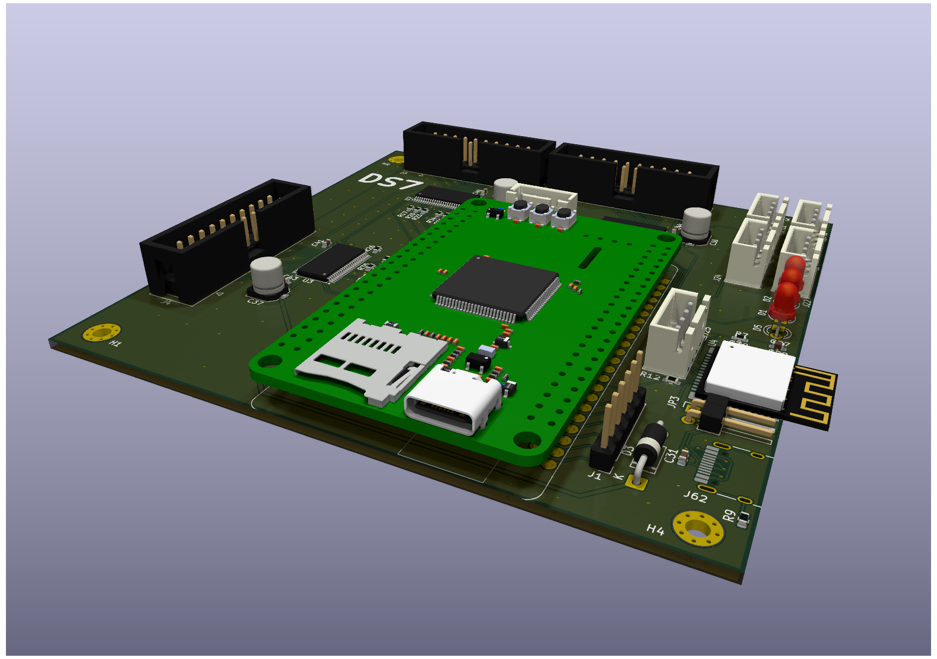
hardware/DS/renders/DS7-2.png
