bergamifer/DS-Project/hardware/DS/renders/DS7-3.png

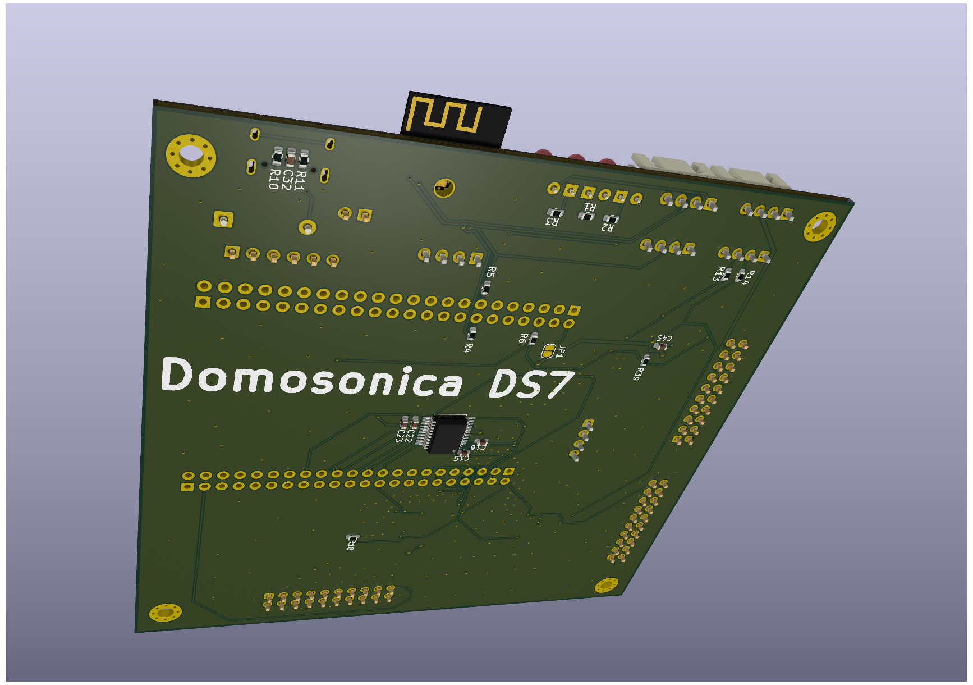
hardware/DS/renders/DS7-3.png
