bergamifer/DS-Project/hardware/DS/renders/DS9-1.png

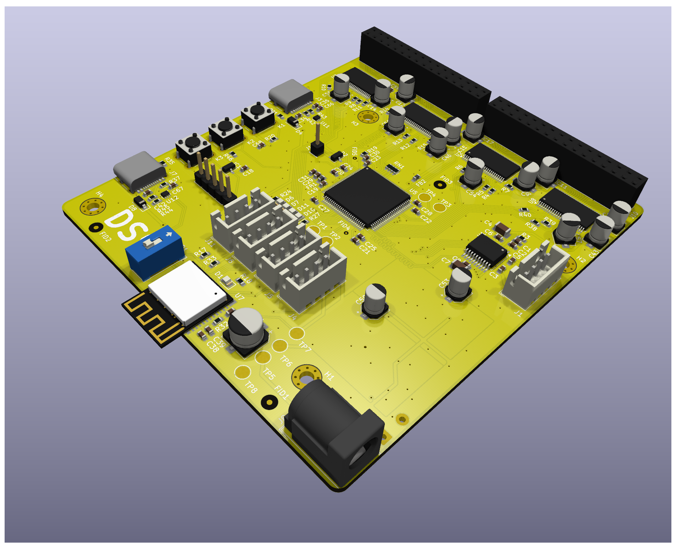
hardware/DS/renders/DS9-1.png
