bergamifer/DS-Project/hardware/DS/renders/DS9-2.png

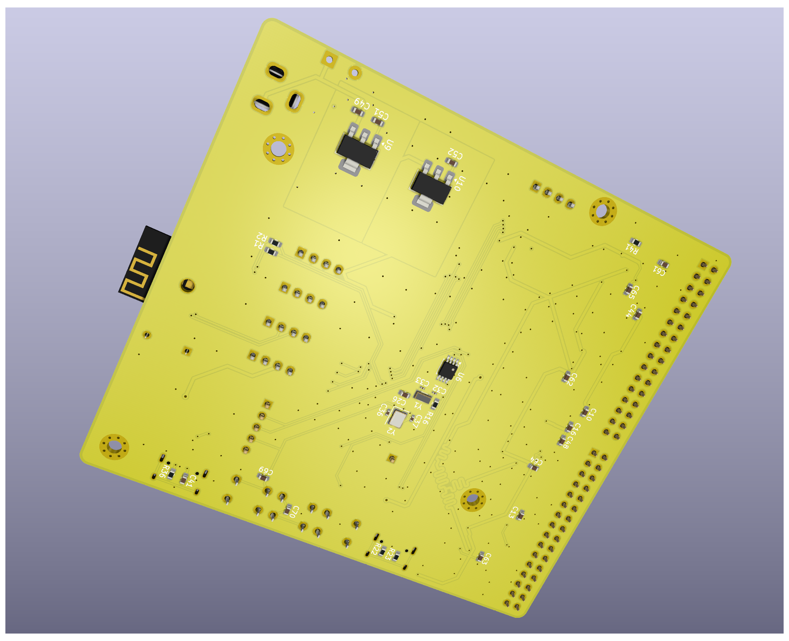
hardware/DS/renders/DS9-2.png
