bergamifer/DS-Project/hardware/DS/renders/DS9-3.png

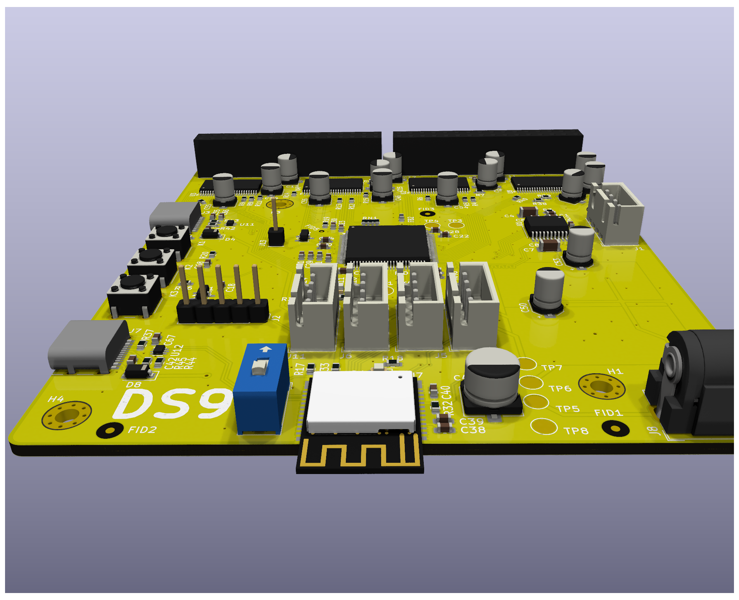
hardware/DS/renders/DS9-3.png
