bergamifer/DS-Project/hardware/DS/renders/DS9-4.png

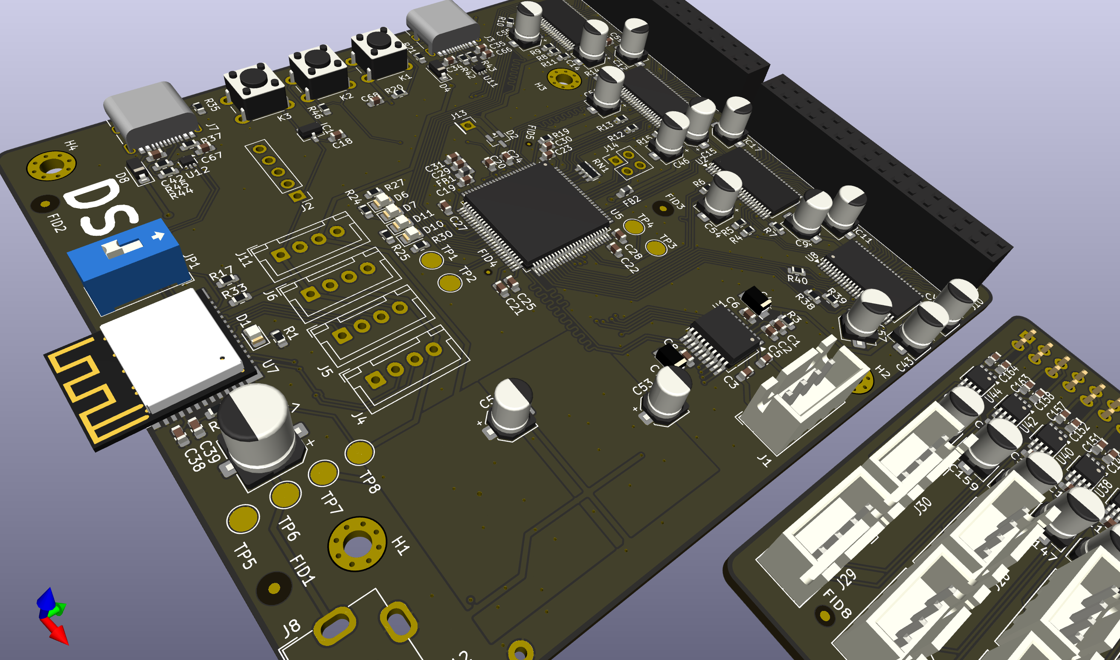
hardware/DS/renders/DS9-4.png
