bergamifer/DS-Project/hardware/DS/renders/ds10-2.png

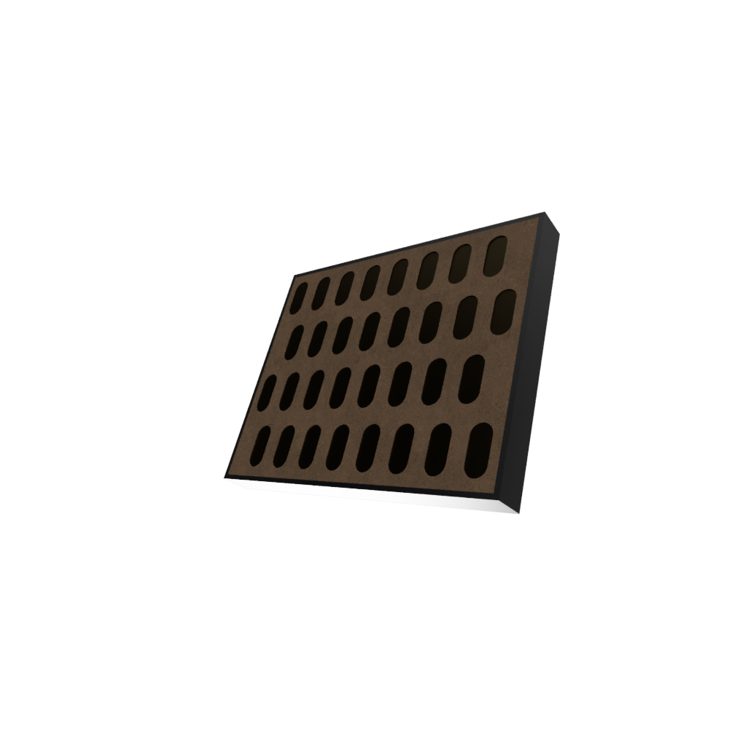
hardware/DS/renders/ds10-2.png
