bergamifer/DS-Project/hardware/DS/renders/ds10-3.png

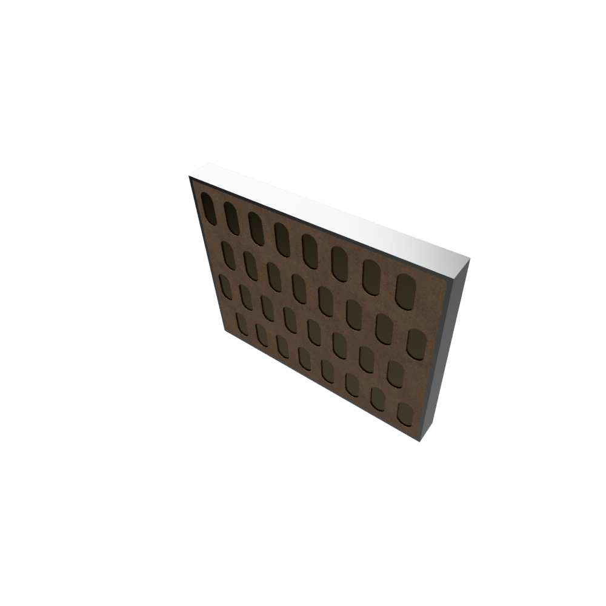
hardware/DS/renders/ds10-3.png
