bergamifer/DS-Project/hardware/DS/renders/ds10-4.PNG

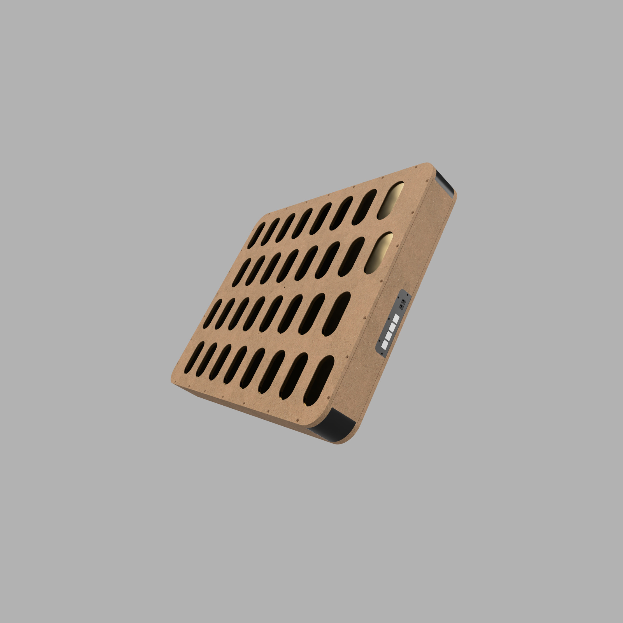
hardware/DS/renders/ds10-4.PNG
