bergamifer/DS-Project/hardware/DS/renders/DS10.png

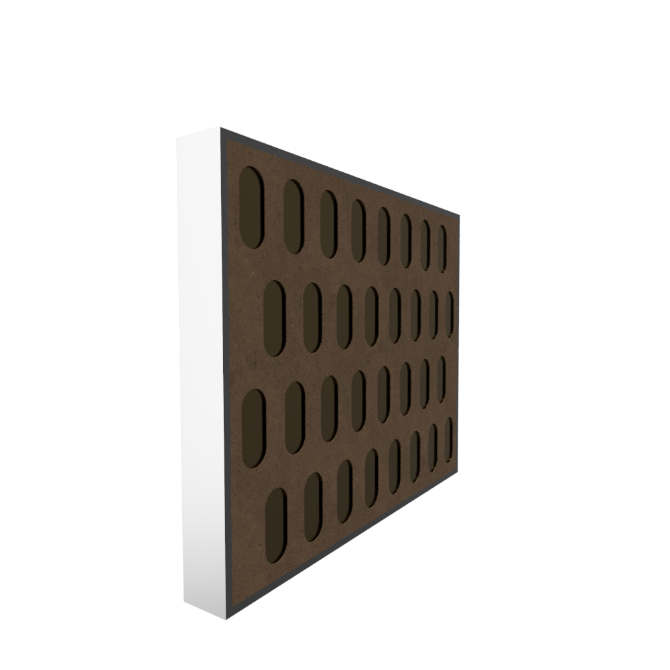
hardware/DS/renders/DS10.png
