bergamifer/DS-Project/hardware/DS/bom.xls

Comment | topDesignator | bottomDesignator | Footprint | JLCPCB Part # | Qty | Ext.Price($)
1u | C111,C133,C144,C177,C188,C221,C243,C254,C57,C89 | C1,C10,C100,C122,C13,C15,C155,C16,C166,C19,C199,C21,C210,C22,C232,C3,C35,C4,C7,C9 | C_0603_1608Metric | C15849 | 110 | 0.54
USB_C | J3 |  | USB_C_Receptacle_HRO_TYPE-C-31-M-12 | C165948 | 3 | 0.55
ESP32-C3-MINI-1 | U5 |  | ESP32-C3-MINI-1 | C2838502 | 3 | 9.36
32.768K7pF |  | Y1 | Crystal_SMD_3215-2Pin_3.2x1.5mm | C280830 | 5 | 1.92
8.2pF |  | C45,C46 | C_0201_0603Metric | C115571 | 20 | 0.12
10k | R106,R15,R16,R5 | R14,R17,R21,R8 | R_0402_1005Metric | C25744 | 44 | 0.03
100k | R30 | R35 | R_0402_1005Metric | C25741 | 40 | 0.02
25MHz12pF |  | Y2 | Crystal_SMD_3225-4Pin_3.2x2.5mm | C9006 | 7 | 0.51
10ucer | C26,C73,C74,C75,C76,C77,C78,C79,C80 | C259,C265,C272,C44 | C_0603_1608Metric | C1691 | 59 | 0.23
SW_Push | K1,K2,K3,K4 |  | SW_SPST_EVQP2_MiddlePushTravel_H2.5mm | C51927445 | 16 | 0.87
SM6T15A |  | D8 | D_SMB | C118275 | 5 | 1.06
YellowLED | D4 |  | LED_0805_2012Metric | C2296 | 20 | 0.30
GreenLED | D6 |  | LED_0805_2012Metric | C2297 | 20 | 0.32
9.09k |  | R36 | R_0603_1608Metric | C2930134 | 20 | 0.02
PAM8302 | U12,U14,U16,U18,U20,U22,U24,U26,U28,U30,U32,U34,U36,U38,U40,U42 | U13,U15,U17,U19,U21,U23,U25,U27,U29,U31,U33,U35,U37,U39,U41,U43 | MSOP-8_3x3mm_P0.65mm | C113367 | 100 | 8.14
2.2u | C37 | C39 | C_0603_1608Metric | C23630 | 40 | 0.12
MAX809TEUR+T |  | IC1 | SOT-23-3 | C16711 | 5 | 1.42
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
20k | R31 |  | R_0402_1005Metric | C25765 | 20 | 0.02
CAT24C256 |  | U8 | TSSOP-8_4.4x3mm_P0.65mm | C146734 | 3 | 1.76
100pF |  | C274,C275,C276,C277,C278,C279,C280,C281,C282,C283,C284,C285,C286,C287,C288,C289 | C_0402_1005Metric | C18164616 | 58 | 0.15
