bergamifer/DS-Project/hardware/DS/3d/DS10.step

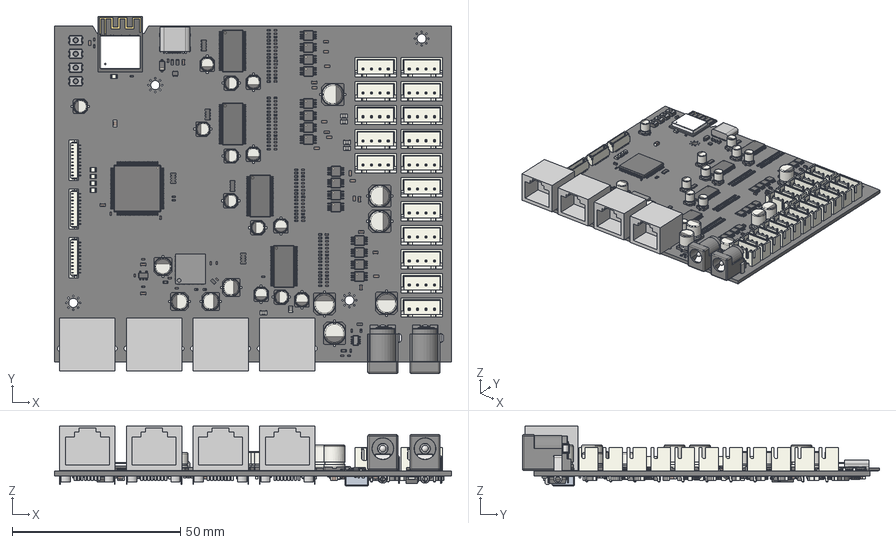
[picture p33: CAD file, 2026-07-03]
hardware/DS/3d/DS10.step
118.1 x 106.3 x 17.8 mm
R_0402_1005Metric x 86
R_0603_1608Metric x 18
C_0402_1005Metric x 148
MSOP-8_3x3mm_P0.65mm x 32
C_0603_1608Metric x 113
JST_XH_B4B-XH-A_1x04_P2.50mm_Vertical x 16
CP_Elec_4x5.7 x 13
R_Array_Convex_4x0603 x 6
LED_0805_2012Metric x 5
L_0805_2012Metric x 67
CP_Elec_5x5.4 x 4
RJ45 x 4
BODY-TSSOP x 4
LEAD-TSSOP x 192
PIN1 x 4
DAP x 4
CP_Elec_6.3x7.7 x 5
ThermalPin
PinsArrayLR x 2
PinsArrayTB
SW_SPST_EVQP2_MiddlePushTravel_H2.5mm x 4
Power Barrel Connector Jack 694106301002 x 2
D_SOD-123
JST_SH_BM10B-SRSS-TB_1x10-1MP_P1.00mm_Vertical x 3
CP_Elec_6.3x5.4
SOT-666
PinsArrayLR_2
PinsArrayLR_5
PinsArrayLR_1
PinsArrayLR_6
PinsArrayLR_7
PinsArrayLR_3
PinsArrayLR_4
USB_C_Receptacle_HRO_TYPE-C-31-M-12
LQFP-100_14x14mm_P0.5mm
C_0805_2012Metric x 4
DFN1006.STEP^DFN1006.STEP_Submodel-SOD882_part_DesignRootModel_PCB_ ESP32-C3-MINI-1_V1(2)_PCB_ESP32-C3-MINI-1_V1
R0201_20210301.STEP^R0201_20210301.STEP_Submodel-R0201_part_ DesignRootModel_PCB_ESP32-C3-MINI-1_V1(2)_PCB_ESP32-C3-MINI-1_V1 x 3
placementOutline^Submodel-noModelForPart_MINI-ANT-TYPED-H_1968823293_ Submodel-MINI-ANT-TYPED-H_1968823293_part_DesignRootModel_PCB_ ESP32-C3-MINI-1_V1(2)_PCB_E
placementOutline-0^Submodel-noModelForPart_MINI-ANT-TYPED-H_1968823293_ Submodel-MINI-ANT-TYPED-H_1968823293_part_DesignRootModel_PCB_ ESP32-C3-MINI-1_V1(2)_PCB
placementOutline-1^Submodel-noModelForPart_MINI-ANT-TYPED-H_1968823293_ Submodel-MINI-ANT-TYPED-H_1968823293_part_DesignRootModel_PCB_ ESP32-C3-MINI-1_V1(2)_PCB
placementOutline-2^Submodel-noModelForPart_MINI-ANT-TYPED-H_1968823293_ Submodel-MINI-ANT-TYPED-H_1968823293_part_DesignRootModel_PCB_ ESP32-C3-MINI-1_V1(2)_PCB
placementOutline-3^Submodel-noModelForPart_MINI-ANT-TYPED-H_1968823293_ Submodel-MINI-ANT-TYPED-H_1968823293_part_DesignRootModel_PCB_ ESP32-C3-MINI-1_V1(2)_PCB
placementOutline-4^Submodel-noModelForPart_MINI-ANT-TYPED-H_1968823293_ Submodel-MINI-ANT-TYPED-H_1968823293_part_DesignRootModel_PCB_ ESP32-C3-MINI-1_V1(2)_PCB
placementOutline-5^Submodel-noModelForPart_MINI-ANT-TYPED-H_1968823293_ Submodel-MINI-ANT-TYPED-H_1968823293_part_DesignRootModel_PCB_ ESP32-C3-MINI-1_V1(2)_PCB
trace_4^Submodel-MINI-ANT-TYPED-H_1968823293_part_DesignRootModel_PCB_ ESP32-C3-MINI-1_V1(2)_PCB_ESP32-C3-MINI-1_V1
trace_1^Submodel-MINI-ANT-TYPED-H_1968823293_part_DesignRootModel_PCB_ ESP32-C3-MINI-1_V1(2)_PCB_ESP32-C3-MINI-1_V1
C0402_20210301.STEP^C0402_20210301.STEP_Submodel-C0402_part_ DesignRootModel_PCB_ESP32-C3-MINI-1_V1(2)_PCB_ESP32-C3-MINI-1_V1
C0201_20210301.STEP^C0201_20210301.STEP_Submodel-C0201_part_ DesignRootModel_PCB_ESP32-C3-MINI-1_V1(2)_PCB_ESP32-C3-MINI-1_V1 x 11
L0201_20210301.STEP^L0201_20210301.STEP_Submodel-L0201_part_ DesignRootModel_PCB_ESP32-C3-MINI-1_V1(2)_PCB_ESP32-C3-MINI-1_V1 x 2
XTAL3225_20210301.STEP^XTAL3225_20210301.STEP_Submodel-XTAL3225_part_ DesignRootModel_PCB_ESP32-C3-MINI-1_V1(2)_PCB_ESP32-C3-MINI-1_V1
ESP32-C3_20210301.STEP^ESP32-C3_20210301.STEP_Submodel-QFN32_0P5_5_ part_DesignRootModel_PCB_ESP32-C3-MINI-1_V1(2)_PCB_ESP32-C3-MINI-1_V1
uid__4^DesignRootModel_PCB_ESP32-C3-MINI-1_V1(2)_PCB_ESP32-C3-MINI-1_ V1
uid__4-22^DesignRootModel_PCB_ESP32-C3-MINI-1_V1(2)_PCB_ ESP32-C3-MINI-1_V1
uid__4-23^DesignRootModel_PCB_ESP32-C3-MINI-1_V1(2)_PCB_ ESP32-C3-MINI-1_V1
uid__4-24^DesignRootModel_PCB_ESP32-C3-MINI-1_V1(2)_PCB_ ESP32-C3-MINI-1_V1
uid__4-25^DesignRootModel_PCB_ESP32-C3-MINI-1_V1(2)_PCB_ ESP32-C3-MINI-1_V1
uid__4-26^DesignRootModel_PCB_ESP32-C3-MINI-1_V1(2)_PCB_ ESP32-C3-MINI-1_V1
uid__4-27^DesignRootModel_PCB_ESP32-C3-MINI-1_V1(2)_PCB_ ESP32-C3-MINI-1_V1
uid__4-28^DesignRootModel_PCB_ESP32-C3-MINI-1_V1(2)_PCB_ ESP32-C3-MINI-1_V1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
