bergamifer/DS-Project/hardware/DS/DS11.step

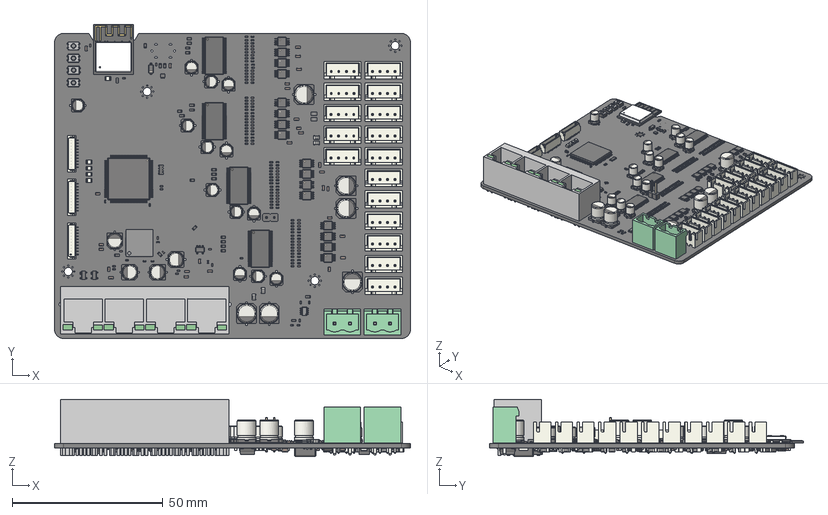
[picture p34: CAD file, 2026-09-09]
hardware/DS/DS11.step
118.1 x 104.2 x 19.0 mm
R_0402_1005Metric x 105
R_0603_1608Metric x 36
RJ45x4 v2
C_0402_1005Metric x 147
MSOP-8_3x3mm_P0.65mm x 32
C_0603_1608Metric x 129
JST_B4B_XH_A x 16
CP_Elec_4x57 x 13
LED_0805_2012Metric x 5
L_0805_2012Metric x 67
CP_Elec_5x54 x 4
SOT-143 x 8
BODY-TSSOP x 4
LEAD-TSSOP x 192
PIN1 x 4
DAP x 4
CP_Elec_63x77 x 5
ThermalPin
PinsArrayLR x 2
PinsArrayTB
PinHeader_1x02_P254mm_Vertical
MSTBVA_01x02_G_5_08mm x 2
D_SOD-123 x 2
JST_SH_BM10B-SRSS-TB_1x10-1MP_P1.00mm_Vertical x 3
SW_SPST_EVQP2_MiddlePushTravel_H2.5mm x 4
CP_Elec_63x54
SOT_666
PinsArrayLR_2
PinsArrayLR_5
PinsArrayLR_1
PinsArrayLR_6
PinsArrayLR_7
PinsArrayLR_3
PinsArrayLR_4
R_Array_Convex_4x0603 x 2
LQFP-100_14x14mm_P0.5mm
DFN1006.STEP^DFN1006.STEP_Submodel-SOD882_part_DesignRootModel_PCB_ ESP32-C3-MINI-1_V1(2)_PCB_ESP32-C3-MINI-1_V1
R0201_20210301.STEP^R0201_20210301.STEP_Submodel-R0201_part_ DesignRootModel_PCB_ESP32-C3-MINI-1_V1(2)_PCB_ESP32-C3-MINI-1_V1 x 3
placementOutline^Submodel-noModelForPart_MINI-ANT-TYPED-H_1968823293_ Submodel-MINI-ANT-TYPED-H_1968823293_part_DesignRootModel_PCB_ ESP32-C3-MINI-1_V1(2)_PCB_E
placementOutline-0^Submodel-noModelForPart_MINI-ANT-TYPED-H_1968823293_ Submodel-MINI-ANT-TYPED-H_1968823293_part_DesignRootModel_PCB_ ESP32-C3-MINI-1_V1(2)_PCB
placementOutline-1^Submodel-noModelForPart_MINI-ANT-TYPED-H_1968823293_ Submodel-MINI-ANT-TYPED-H_1968823293_part_DesignRootModel_PCB_ ESP32-C3-MINI-1_V1(2)_PCB
placementOutline-2^Submodel-noModelForPart_MINI-ANT-TYPED-H_1968823293_ Submodel-MINI-ANT-TYPED-H_1968823293_part_DesignRootModel_PCB_ ESP32-C3-MINI-1_V1(2)_PCB
placementOutline-3^Submodel-noModelForPart_MINI-ANT-TYPED-H_1968823293_ Submodel-MINI-ANT-TYPED-H_1968823293_part_DesignRootModel_PCB_ ESP32-C3-MINI-1_V1(2)_PCB
placementOutline-4^Submodel-noModelForPart_MINI-ANT-TYPED-H_1968823293_ Submodel-MINI-ANT-TYPED-H_1968823293_part_DesignRootModel_PCB_ ESP32-C3-MINI-1_V1(2)_PCB
placementOutline-5^Submodel-noModelForPart_MINI-ANT-TYPED-H_1968823293_ Submodel-MINI-ANT-TYPED-H_1968823293_part_DesignRootModel_PCB_ ESP32-C3-MINI-1_V1(2)_PCB
trace_4^Submodel-MINI-ANT-TYPED-H_1968823293_part_DesignRootModel_PCB_ ESP32-C3-MINI-1_V1(2)_PCB_ESP32-C3-MINI-1_V1
trace_1^Submodel-MINI-ANT-TYPED-H_1968823293_part_DesignRootModel_PCB_ ESP32-C3-MINI-1_V1(2)_PCB_ESP32-C3-MINI-1_V1
C0402_20210301.STEP^C0402_20210301.STEP_Submodel-C0402_part_ DesignRootModel_PCB_ESP32-C3-MINI-1_V1(2)_PCB_ESP32-C3-MINI-1_V1
C0201_20210301.STEP^C0201_20210301.STEP_Submodel-C0201_part_ DesignRootModel_PCB_ESP32-C3-MINI-1_V1(2)_PCB_ESP32-C3-MINI-1_V1 x 11
L0201_20210301.STEP^L0201_20210301.STEP_Submodel-L0201_part_ DesignRootModel_PCB_ESP32-C3-MINI-1_V1(2)_PCB_ESP32-C3-MINI-1_V1 x 2
XTAL3225_20210301.STEP^XTAL3225_20210301.STEP_Submodel-XTAL3225_part_ DesignRootModel_PCB_ESP32-C3-MINI-1_V1(2)_PCB_ESP32-C3-MINI-1_V1
ESP32-C3_20210301.STEP^ESP32-C3_20210301.STEP_Submodel-QFN32_0P5_5_ part_DesignRootModel_PCB_ESP32-C3-MINI-1_V1(2)_PCB_ESP32-C3-MINI-1_V1
uid__4^DesignRootModel_PCB_ESP32-C3-MINI-1_V1(2)_PCB_ESP32-C3-MINI-1_ V1
uid__4-22^DesignRootModel_PCB_ESP32-C3-MINI-1_V1(2)_PCB_ ESP32-C3-MINI-1_V1
uid__4-23^DesignRootModel_PCB_ESP32-C3-MINI-1_V1(2)_PCB_ ESP32-C3-MINI-1_V1
uid__4-24^DesignRootModel_PCB_ESP32-C3-MINI-1_V1(2)_PCB_ ESP32-C3-MINI-1_V1
uid__4-25^DesignRootModel_PCB_ESP32-C3-MINI-1_V1(2)_PCB_ ESP32-C3-MINI-1_V1
uid__4-26^DesignRootModel_PCB_ESP32-C3-MINI-1_V1(2)_PCB_ ESP32-C3-MINI-1_V1
uid__4-27^DesignRootModel_PCB_ESP32-C3-MINI-1_V1(2)_PCB_ ESP32-C3-MINI-1_V1
uid__4-28^DesignRootModel_PCB_ESP32-C3-MINI-1_V1(2)_PCB_ ESP32-C3-MINI-1_V1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
