bergamifer/DS-Project/hardware/DS/librerias/footprints/power-barrel-connector-jack-1.snapshot.1/Power Barrel Connector Jack 694106301002.stp

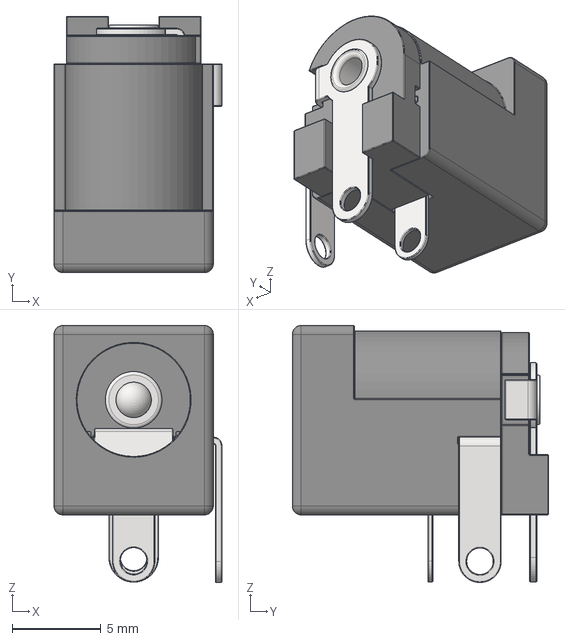
[picture p36: CAD file, 2026-07-03]
hardware/DS/librerias/footprints/power-barrel-connector-jack-1.snapshot.1/Power Barrel Connector Jack 694106301002.stp
9.49 x 14.5 x 14.5 mm
