bergamifer/DS-Project/hardware/DS/librerias/LIB_AK5538VN/AK5538VN/3D/AK5538VN.stp

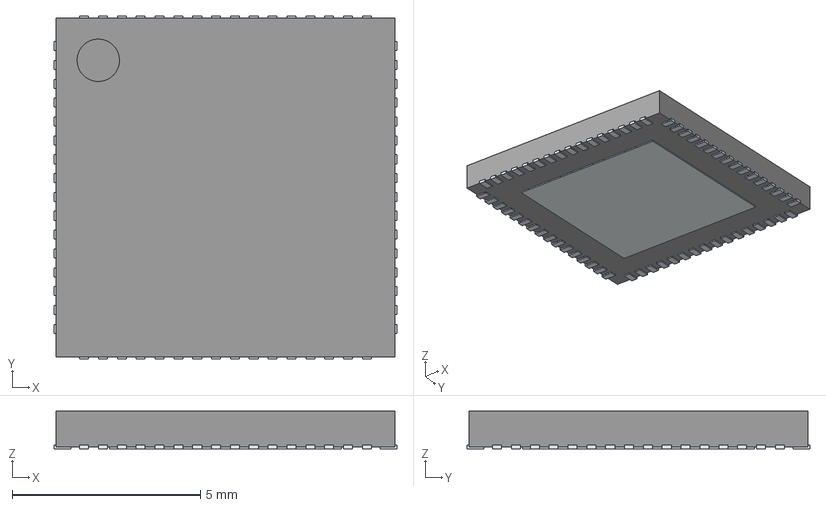
[picture p37: CAD file, 2026-07-03]
hardware/DS/librerias/LIB_AK5538VN/AK5538VN/3D/AK5538VN.stp
9.10 x 9.10 x 1.00 mm
ThermalPin
PinsArrayLR
PinsArrayTB
