bergamifer/DS-Project/hardware/DS/librerias/LIB_MAX809TEUR+T/MAX809TEUR+T/MAX809TEUR+T.stp

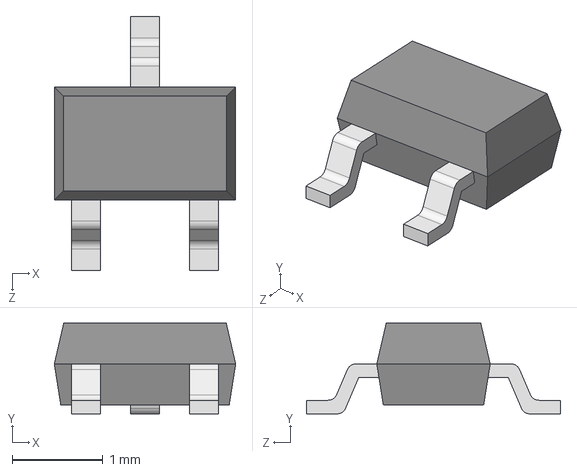
[picture p38: CAD file, 2026-07-03]
hardware/DS/librerias/LIB_MAX809TEUR+T/MAX809TEUR+T/MAX809TEUR+T.stp
2.00 x 1.00 x 2.80 mm
