bergamifer/DS-Project/hardware/DS/librerias/LIB_MP2315SGJ-P/MP2315SGJ-P/3D/MP2315SGJ-P.stp

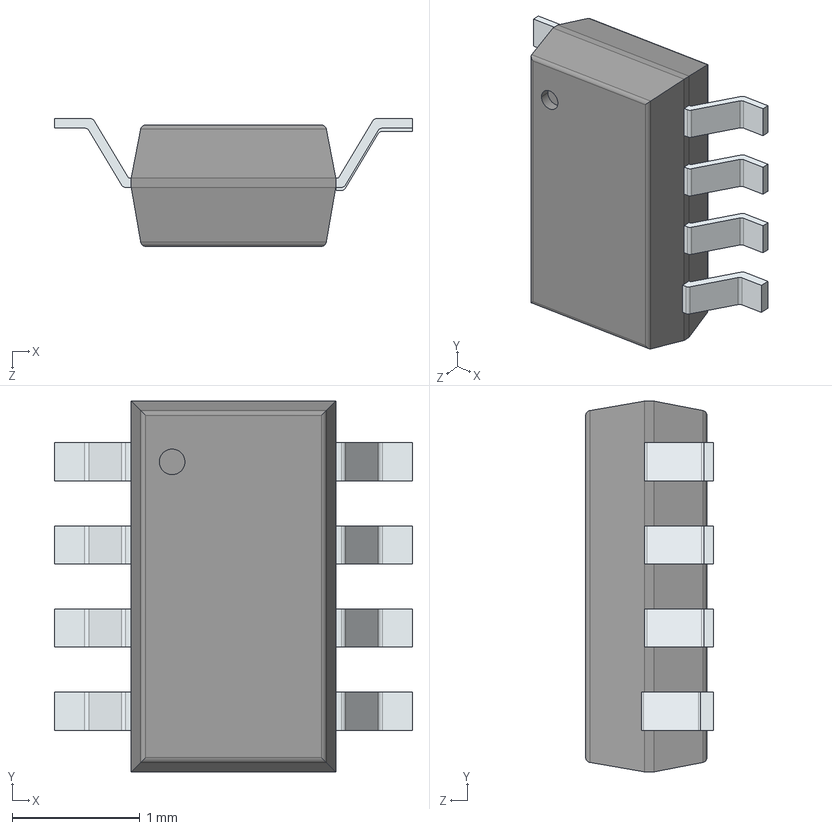
[picture p39: CAD file, 2026-07-03]
hardware/DS/librerias/LIB_MP2315SGJ-P/MP2315SGJ-P/3D/MP2315SGJ-P.stp
2.80 x 2.90 x 1.00 mm
PinsArrayLR_2
PinsArrayLR_5
PinsArrayLR_1
PinsArrayLR
PinsArrayLR_6
PinsArrayLR_7
PinsArrayLR_3
PinsArrayLR_4
