bergamifer/DS-Project/hardware/DS/librerias/PCM1690/PCM1690DCA.stp

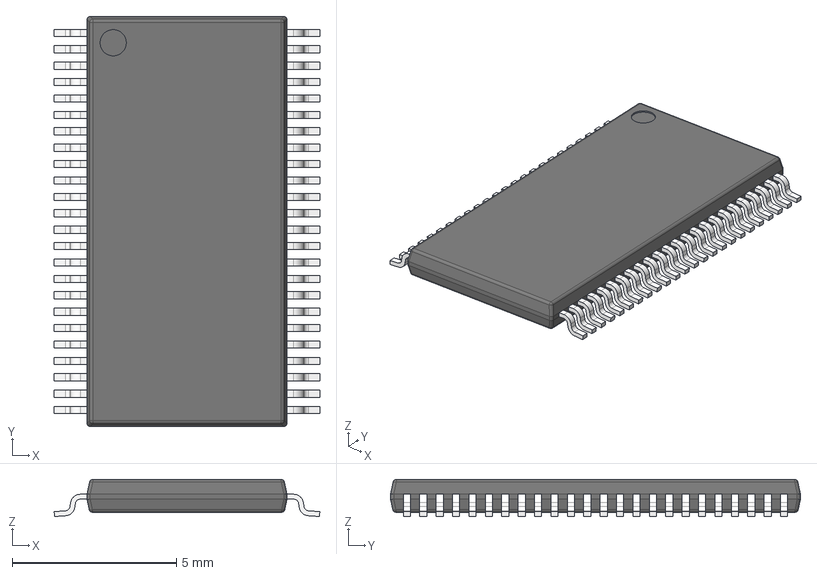
[picture p40: CAD file, 2026-07-03]
hardware/DS/librerias/PCM1690/PCM1690DCA.stp
8.10 x 12.5 x 1.13 mm
BODY-TSSOP
LEAD-TSSOP x 48
PIN1
DAP
