bergamifer/DS-Project/hardware/DS/librerias/USB-C PCB vertical.stp

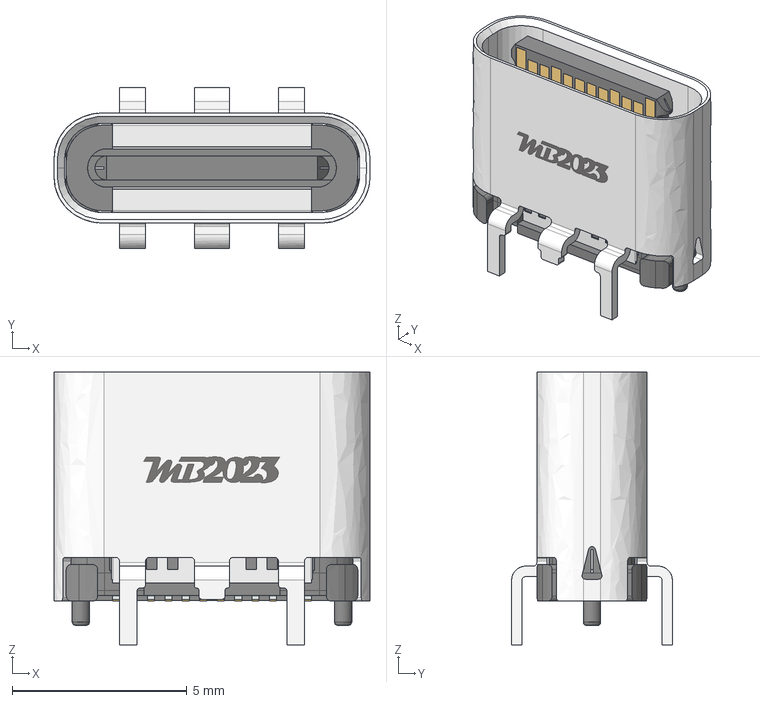
[picture p41: CAD file, 2026-07-03]
hardware/DS/librerias/USB-C PCB vertical.stp
9.04 x 4.60 x 7.80 mm
