bergamifer/DS-Project/hardware/DS/3d/RJ45x4.step

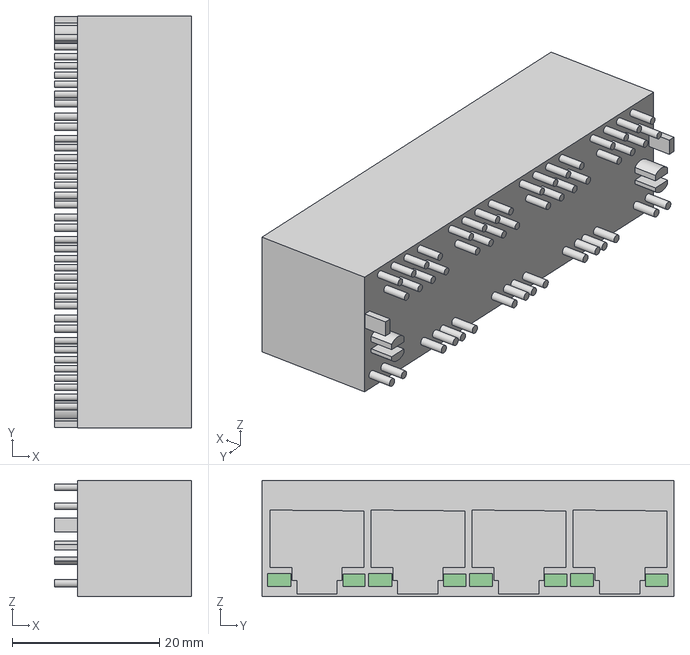
[picture p42: CAD file, 2026-07-03]
hardware/DS/3d/RJ45x4.step
18.6 x 55.9 x 15.8 mm
