bergamifer/DS-Project/hardware/DS/librerias/footprints/USB_C_Receptacle_HRO_TYPE-C-31-M-12.step

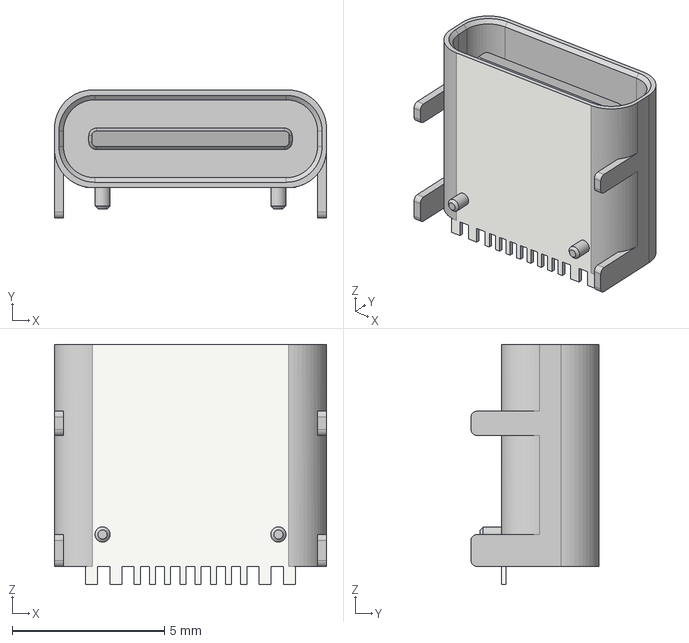
[picture p43: CAD file, 2026-07-03]
hardware/DS/librerias/footprints/USB_C_Receptacle_HRO_TYPE-C-31-M-12.step
8.94 x 4.21 x 7.90 mm
