bergamifer/DS-Project/hardware/DS/librerias/footprints/RJ45.step

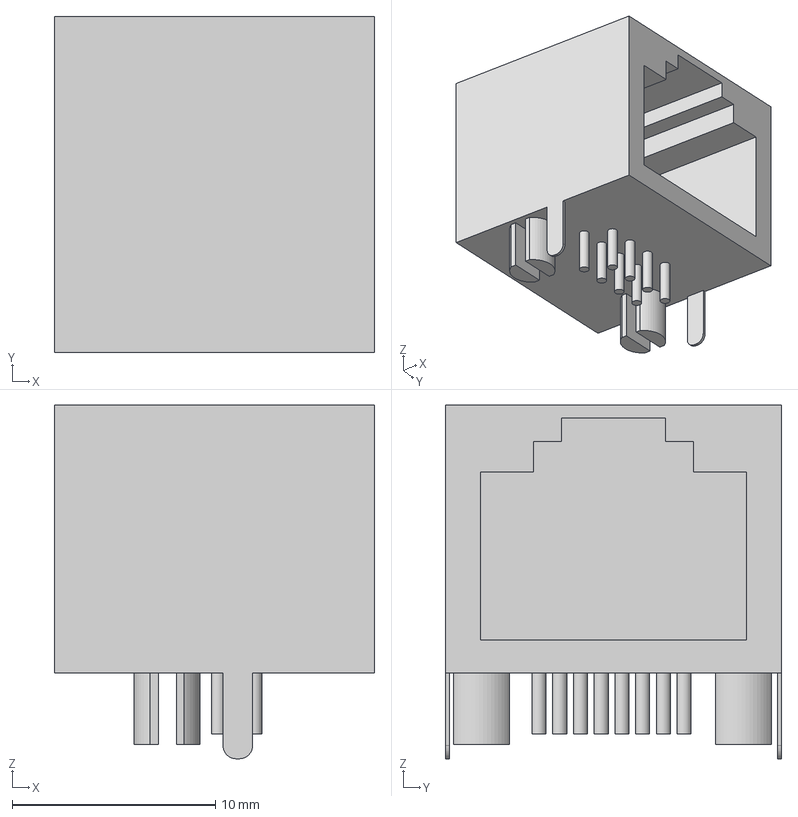
[picture p44: CAD file, 2026-07-03]
hardware/DS/librerias/footprints/RJ45.step
15.8 x 16.5 x 17.4 mm
