bergamifer/DS-Project/hardware/DS/librerias/footprints/STM32H7xx CoreBoard WeAct Studio V12 3D.step

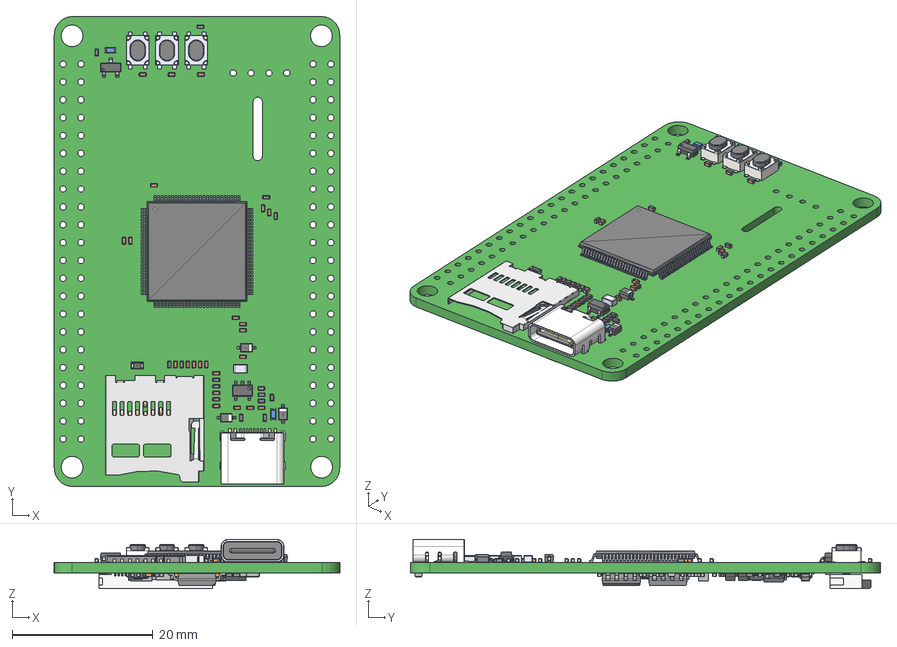
[picture p45: CAD file, 2026-07-03]
hardware/DS/librerias/footprints/STM32H7xx CoreBoard WeAct Studio V12 3D.step
40.6 x 66.9 x 6.98 mm
User Library-0402(1005M) Res x 45
User Library-0402(1005M) Cap x 50
Maxim Integrated Logo 1 - 1
Maxim Integrated Logo 1
R0603 x 6
Extruded x 8
User Library-SO8-Wide-5mmx5mm x 2
User Library-SOD323 x 3
NX3215SA
User Library-XTAL-SMT-3225
User Library-SOT23-3 x 2
User Library-SOT23-5
User Library-Chip Inductor (2)
User Library-FPC0.5-SMT-24P-B x 2
User Library-0603(1608M) LED x 2
CircuitWorks-SOT-23 x 9
FH34SRJ-8S-0.5SH_RGB8421504
USB_Type-C_A
User Library-473521001_microSD x 3
SOLID^SW-SMD_4P-L4.2-W3.3-P2.15-LS5.1_SW1_3D_PCB1_2023-06-10(2)_3D_ PCB1_2023-06-10 x 3
