bergamifer/DS-Project/hardware/DS/librerias/footprints/TMCMA1C106MTRF.stp

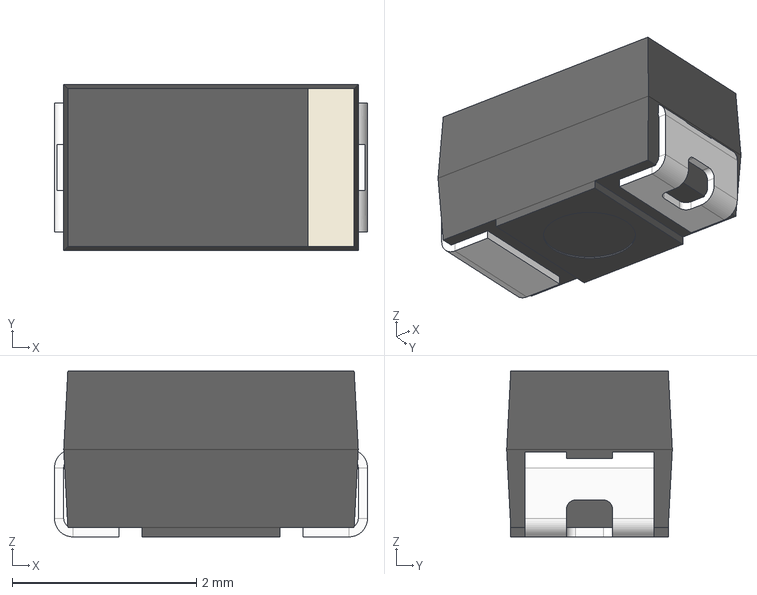
[picture p46: CAD file, 2026-07-03]
hardware/DS/librerias/footprints/TMCMA1C106MTRF.stp
3.40 x 1.80 x 1.80 mm
Base-2
Terminal
