bergamifer/DS-Project/(list of files, cad)

Other CAD files:
hardware/DS/librerias/LIB_AK5538VN/AK5538VN/Allegro/qfn50p900x900x100-65n.psm
hardware/DS/librerias/LIB_AK5538VN/AK5538VN/DEHDL/ak5538vn/chips/chips.prt
hardware/DS/librerias/LIB_MP2315SGJ-P/MP2315SGJ-P/Allegro/sot65p280x100-8n.psm
hardware/DS/librerias/LIB_MP2315SGJ-P/MP2315SGJ-P/DEHDL/mp2315sgj_p/chips/chips.prt
