bergamifer/DS-Project/docs/historico/Schematic_DS9.pdf

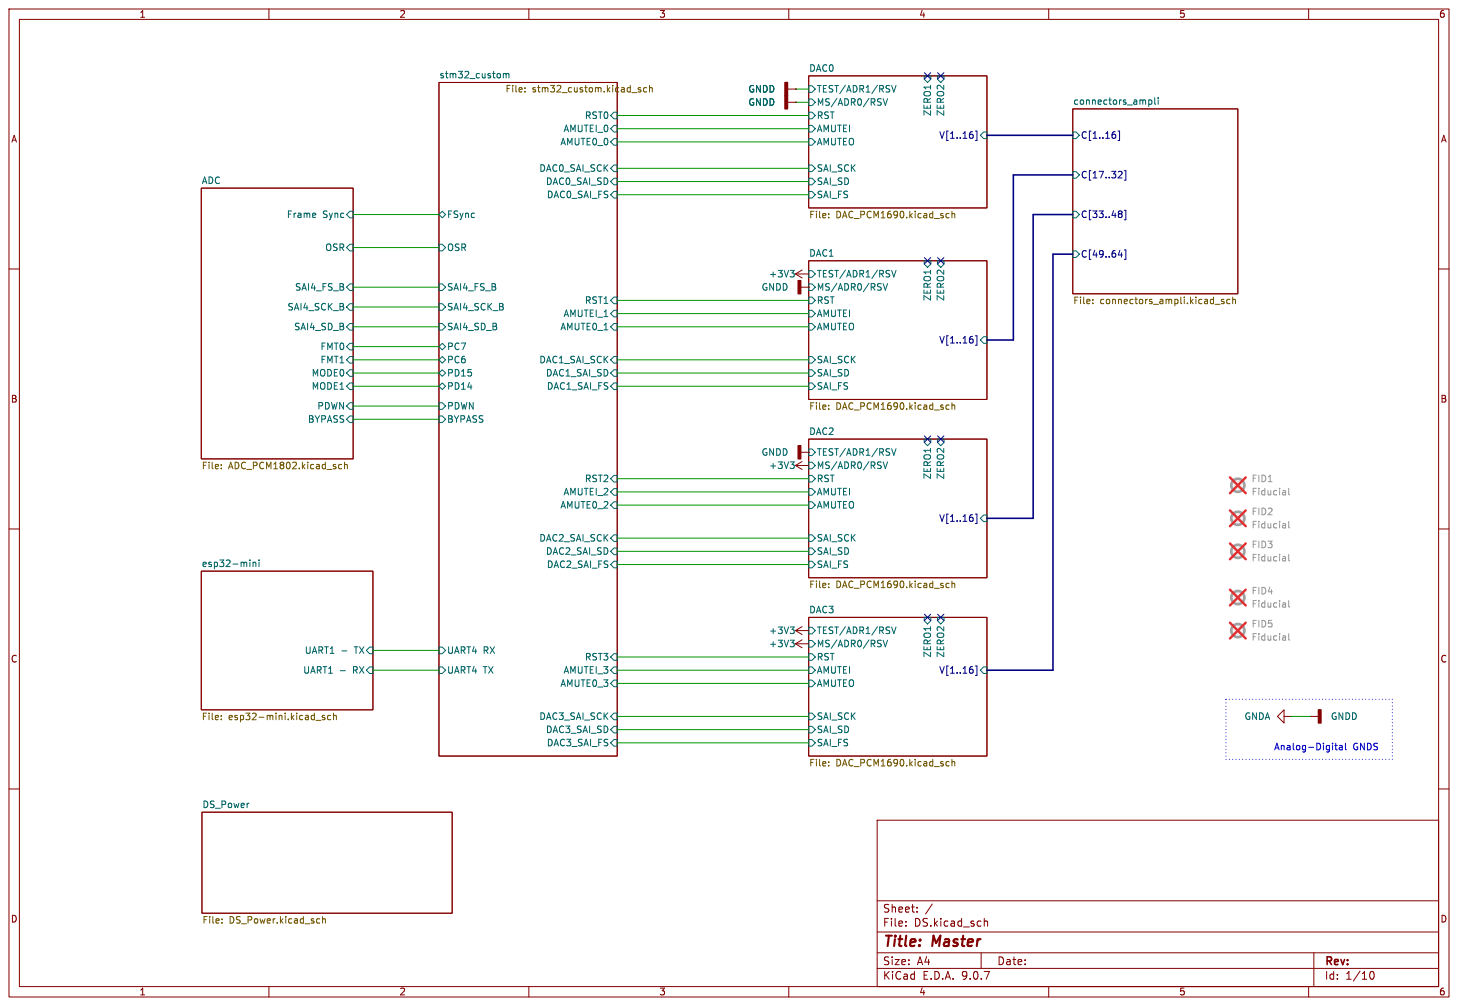
[picture p47: page 1]

connectors_ampli File: connectors_ampli.kicad_sch DS_Power File: DS_Power.kicad_sch UART1 - RX UART1 - TX

FID5 Fiducial FID3 Fiducial GNDD GNDD

Id: 1/10 Title: Master File: DS.kicad_sch Sheet: /

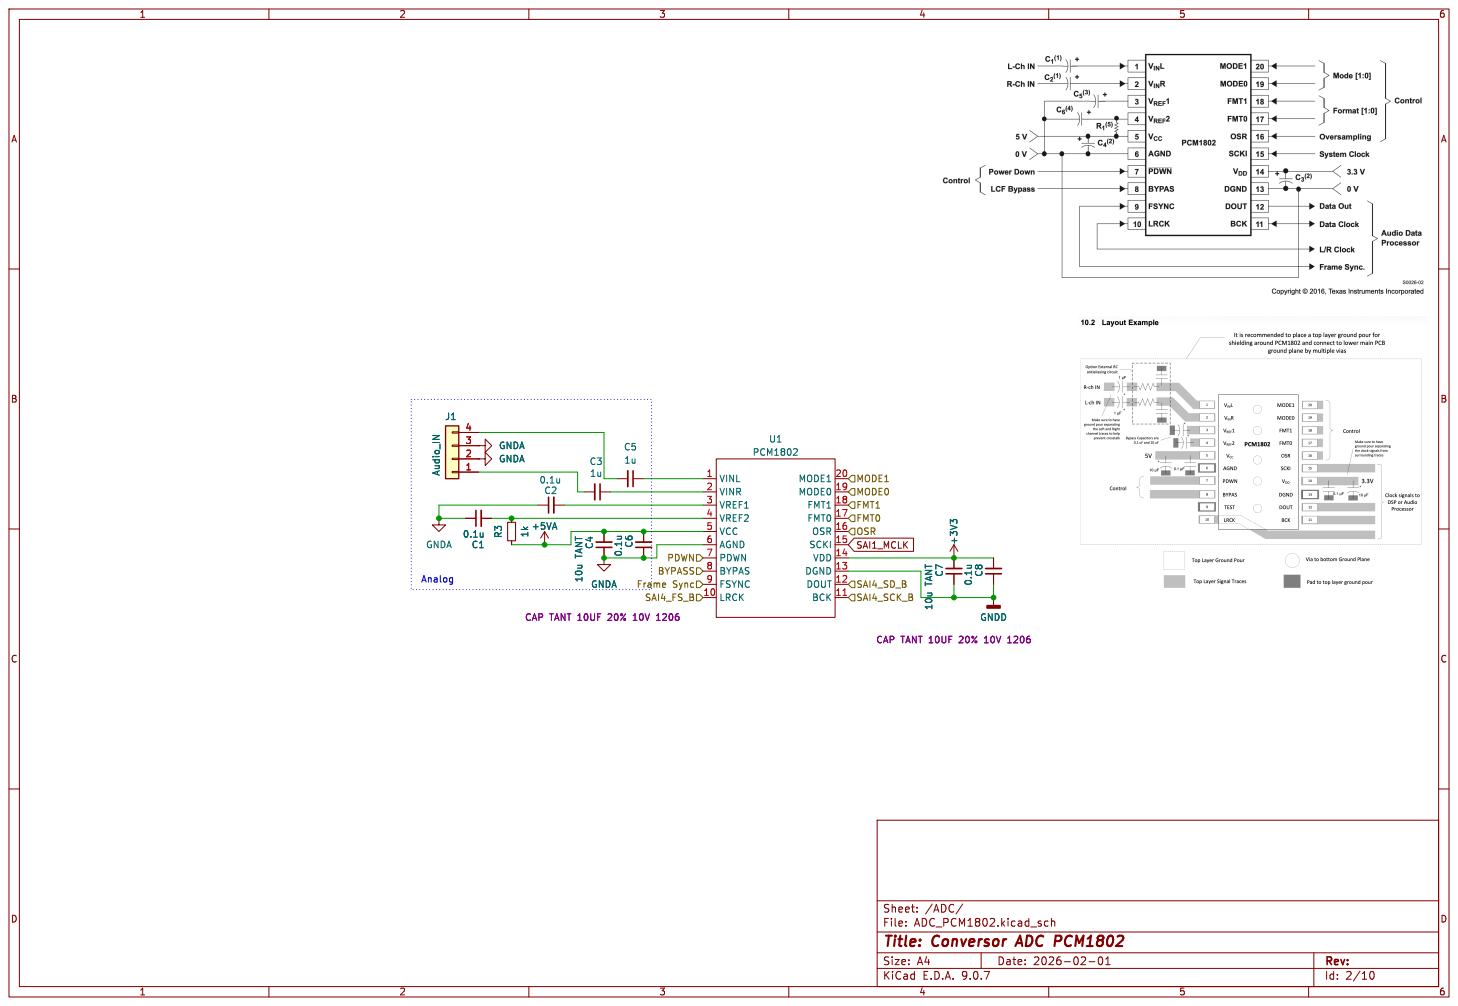
[picture p48: page 2]

Id: 2/10 Title: Conversor ADC PCM1802

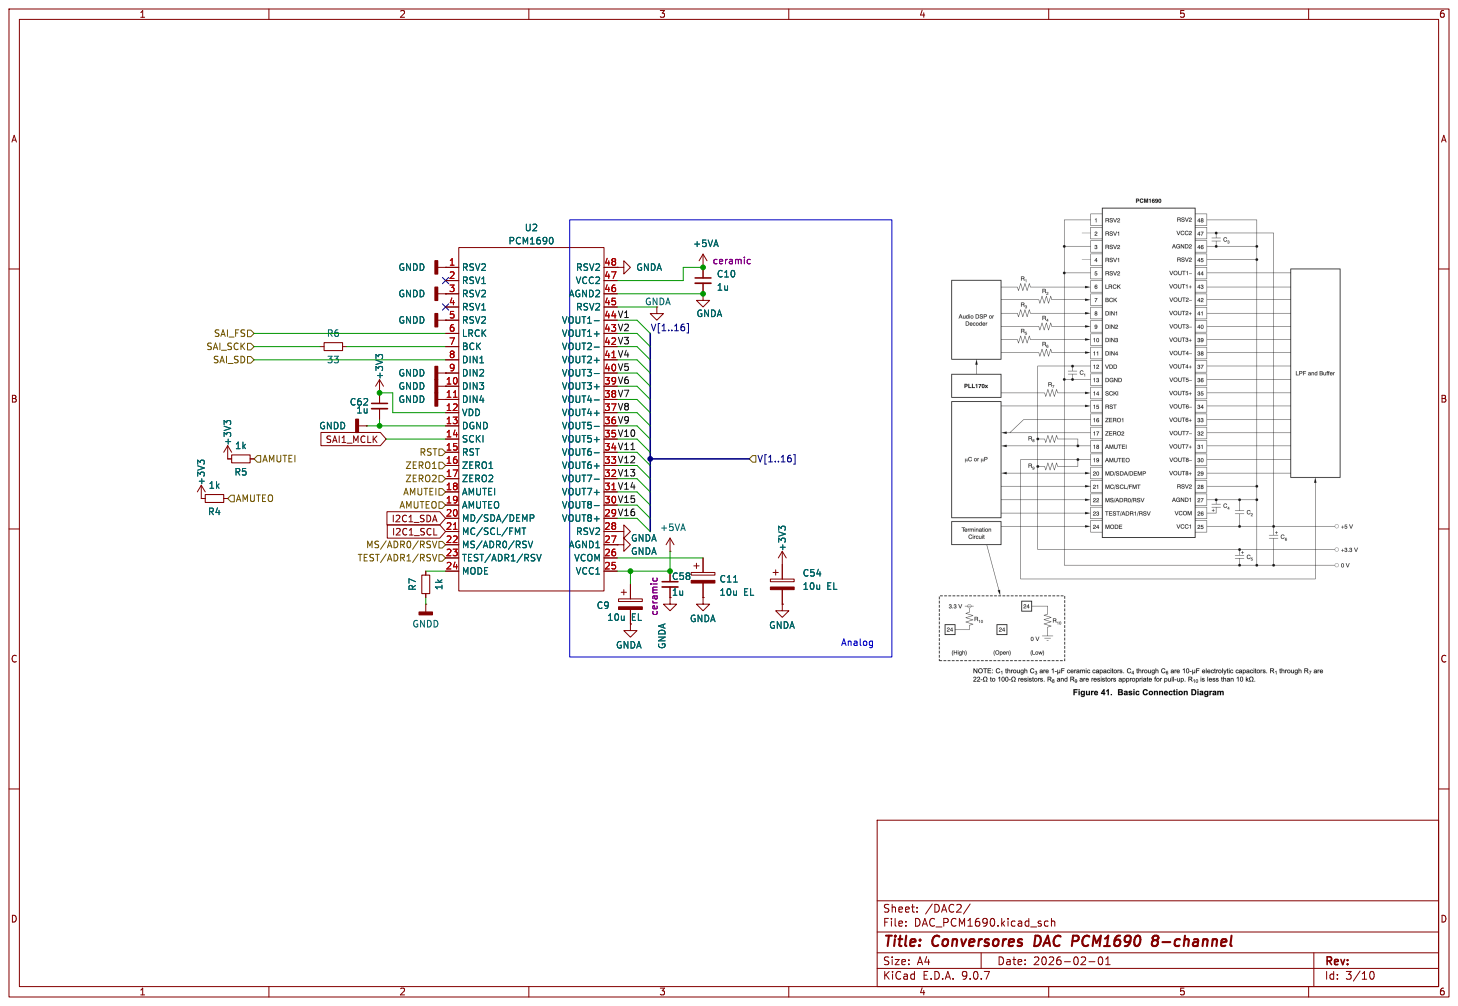
[picture p49: page 3]

TEST/ADR1/RSV MS/ADR0/RSV

Id: 3/10 Title: Conversores DAC PCM1690 8-channel File: DAC_PCM1690.kicad_sch Sheet: /DAC2/ C9

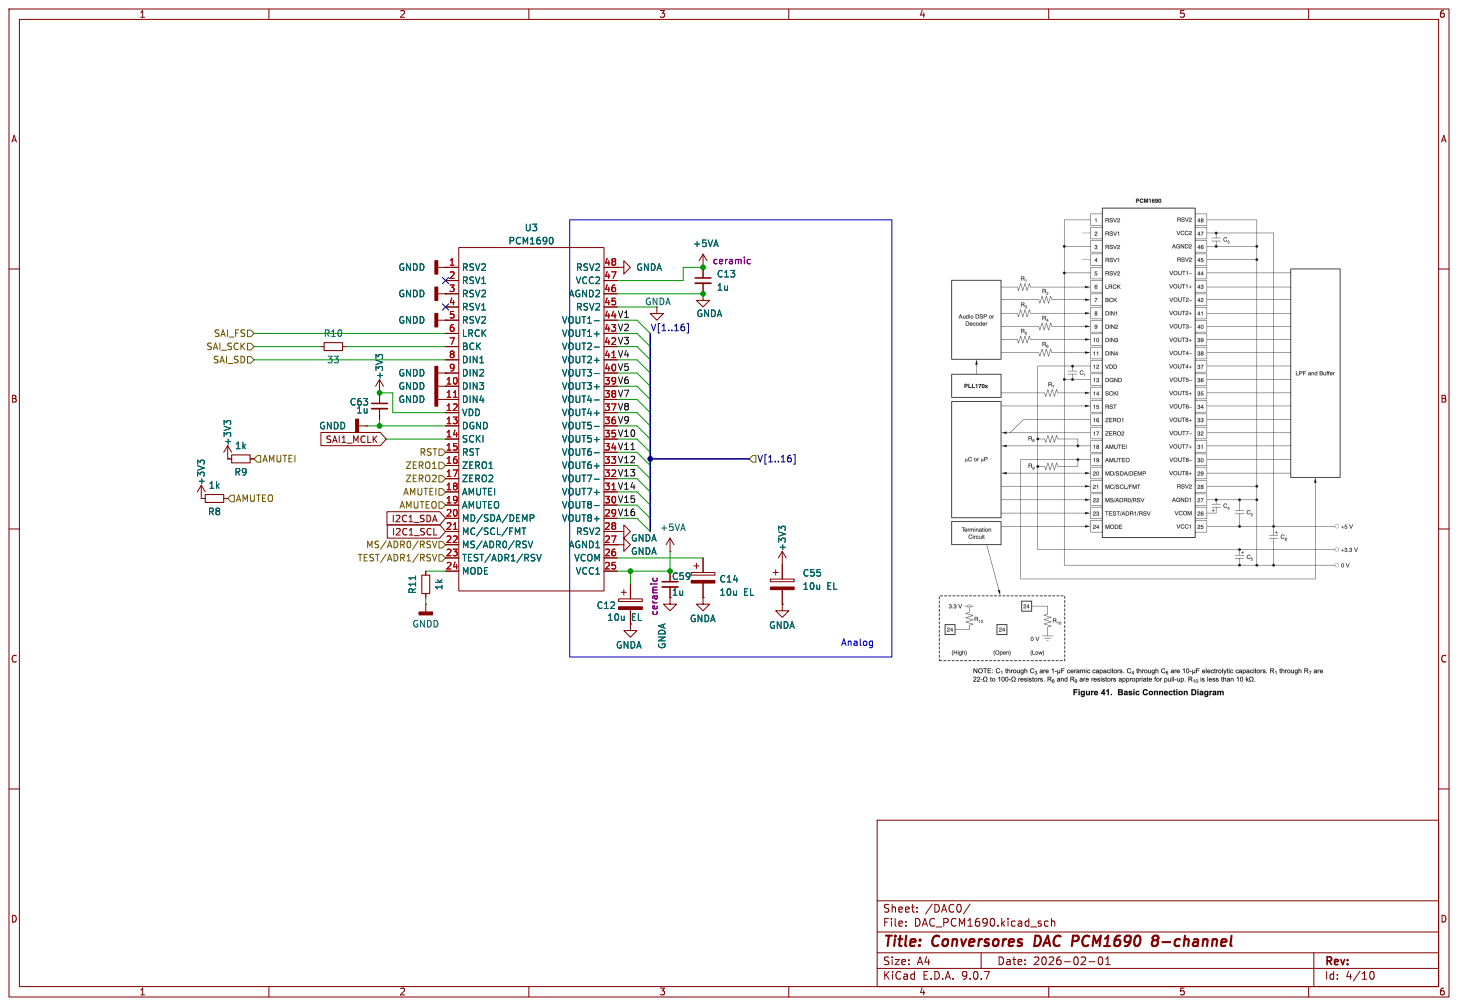
[picture p50: page 4]

TEST/ADR1/RSV MS/ADR0/RSV

Id: 4/10 Title: Conversores DAC PCM1690 8-channel File: DAC_PCM1690.kicad_sch Sheet: /DAC0/ C12

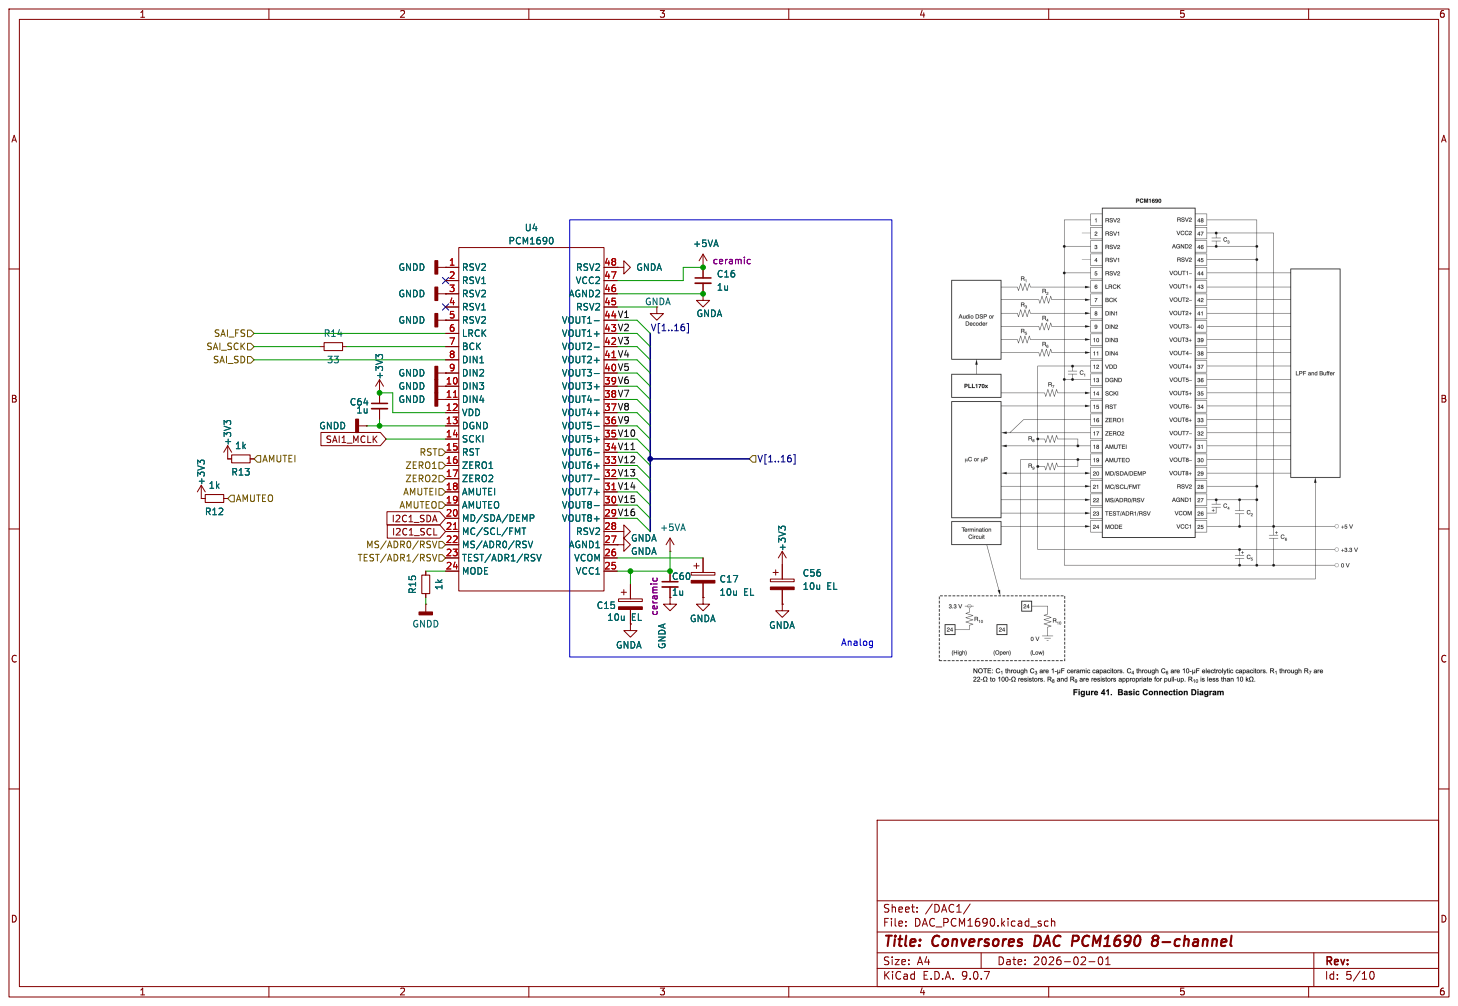
[picture p51: page 5]

TEST/ADR1/RSV MS/ADR0/RSV

Id: 5/10 Title: Conversores DAC PCM1690 8-channel File: DAC_PCM1690.kicad_sch Sheet: /DAC1/ C15

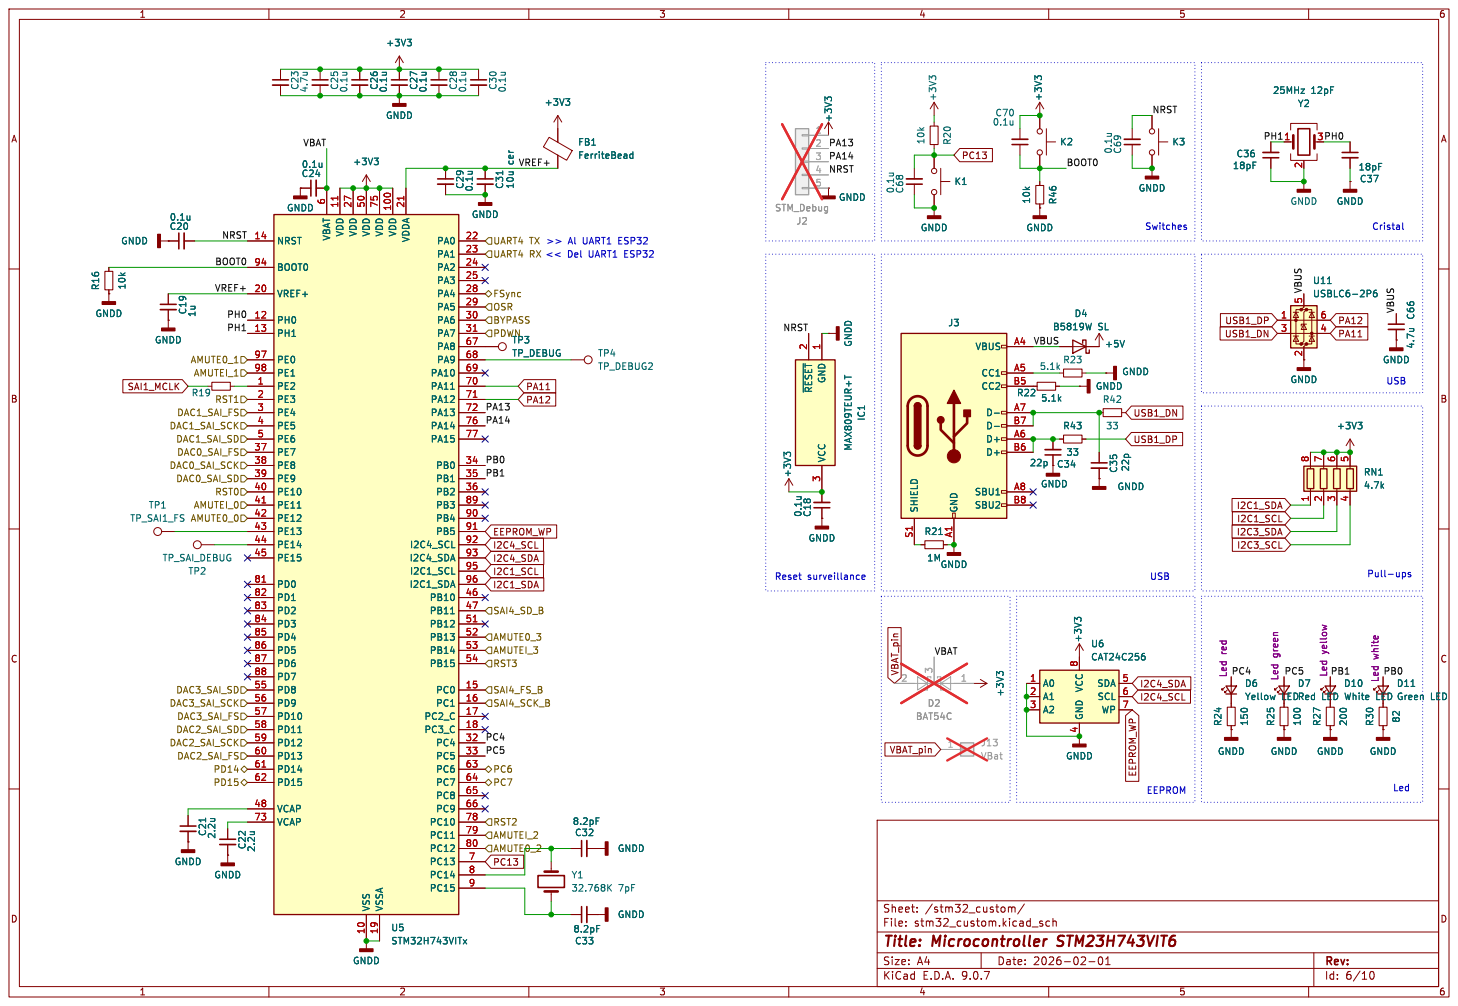
[picture p52: page 6]

4 SDA 5 SCL 6 WP 7 GNDD+3V3 +3V3 10k R46 GNDD GNDD +3V3 K2 K3 GNDD K1 GNDD

6 VDD 11 VDD 27 VDD 50 VSS 10 VDD 75 VSSA 19 VDD 100 VDDA 21 PA0 22 PA1 23 PA2 24 PA3 25 PA4 28 PA5 29 PA6 30 PA7 31 PA8 67 PA9 68 PA10 69 PA11 70 PA12 71 PA13 72 PA14 76 PA15 77 PB0 34 PB1 35 PB2 36 PB3 89 PB4 90 PB5 91

4 SDA 5 SCL 6 WP 7 U6 CAT24C256 GNDD GNDD GNDD R27 200 D10 White LED Led yellow

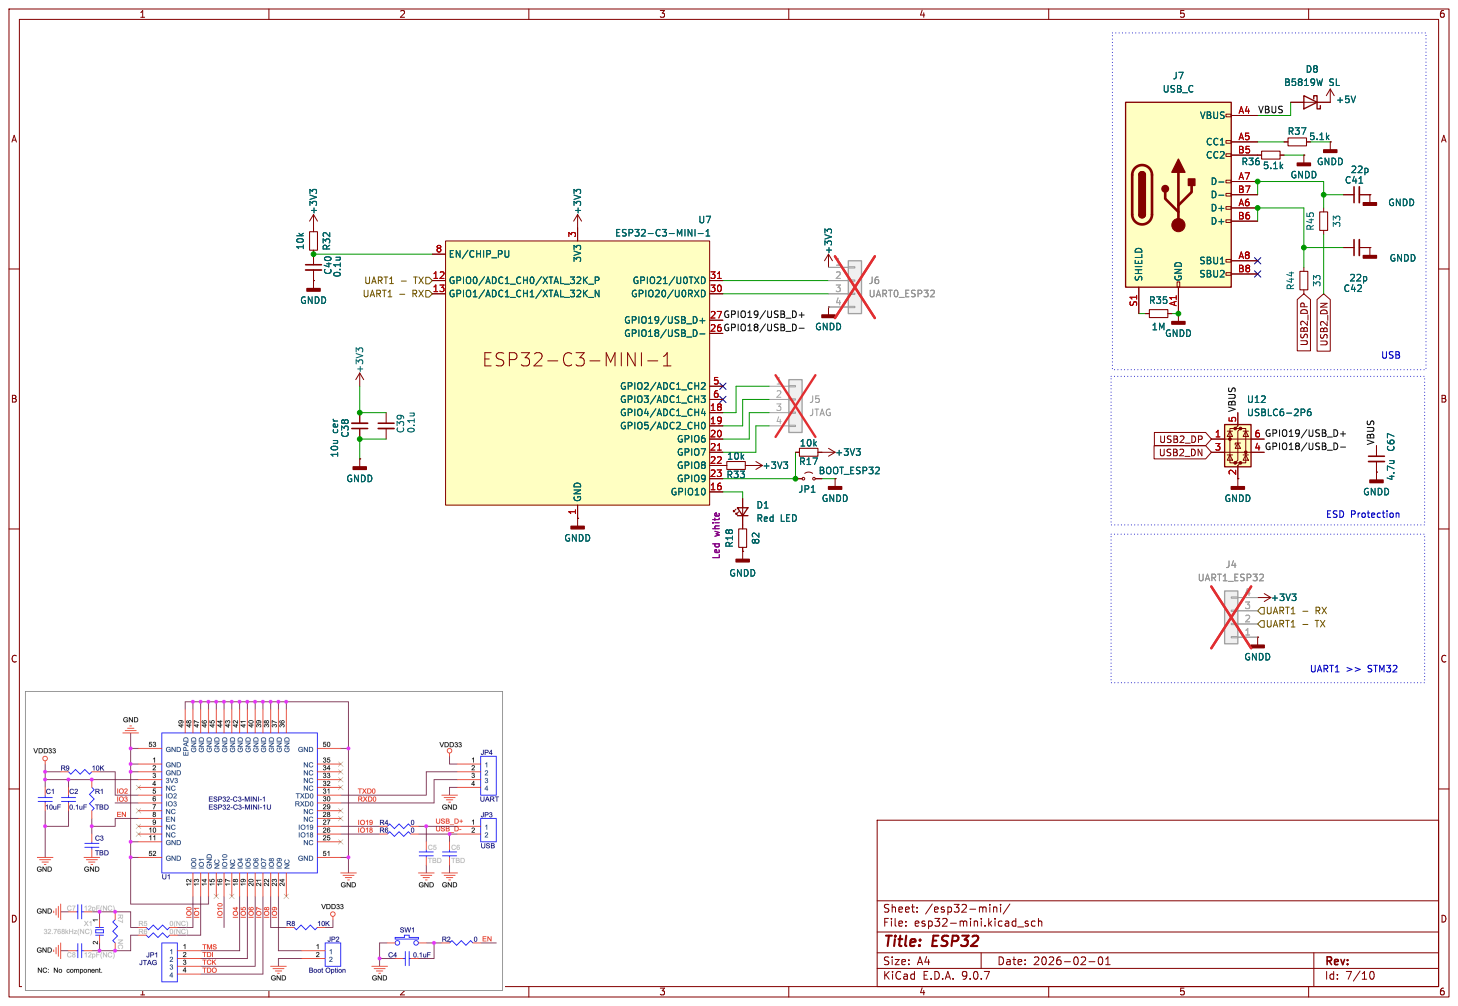
[picture p53: page 7]

1 GPIO21/U0TXD 31 GPIO20/U0RXD 30 GPIO19/USB_D+ 27 GPIO18/USB_D- 26 GPIO2/ADC1_CH2 5 GPIO3/ADC1_CH3 6 GPIO4/ADC1_CH4 18 GPIO5/ADC2_CH0 19 GPIO6 20 GPIO7 21 GPIO8 22 GPIO9 23 GPIO10 16 U7 ESP32-C3-MINI-1 SHIELD S1 GND A1 VBUS A4 CC1 A5 CC2 B5 D- A7 D- B7 D+ A6 D+ B6 SBU1 A8 SBU2 B8

File: esp32-mini.kicad_sch Sheet: /esp32-mini/ GNDD

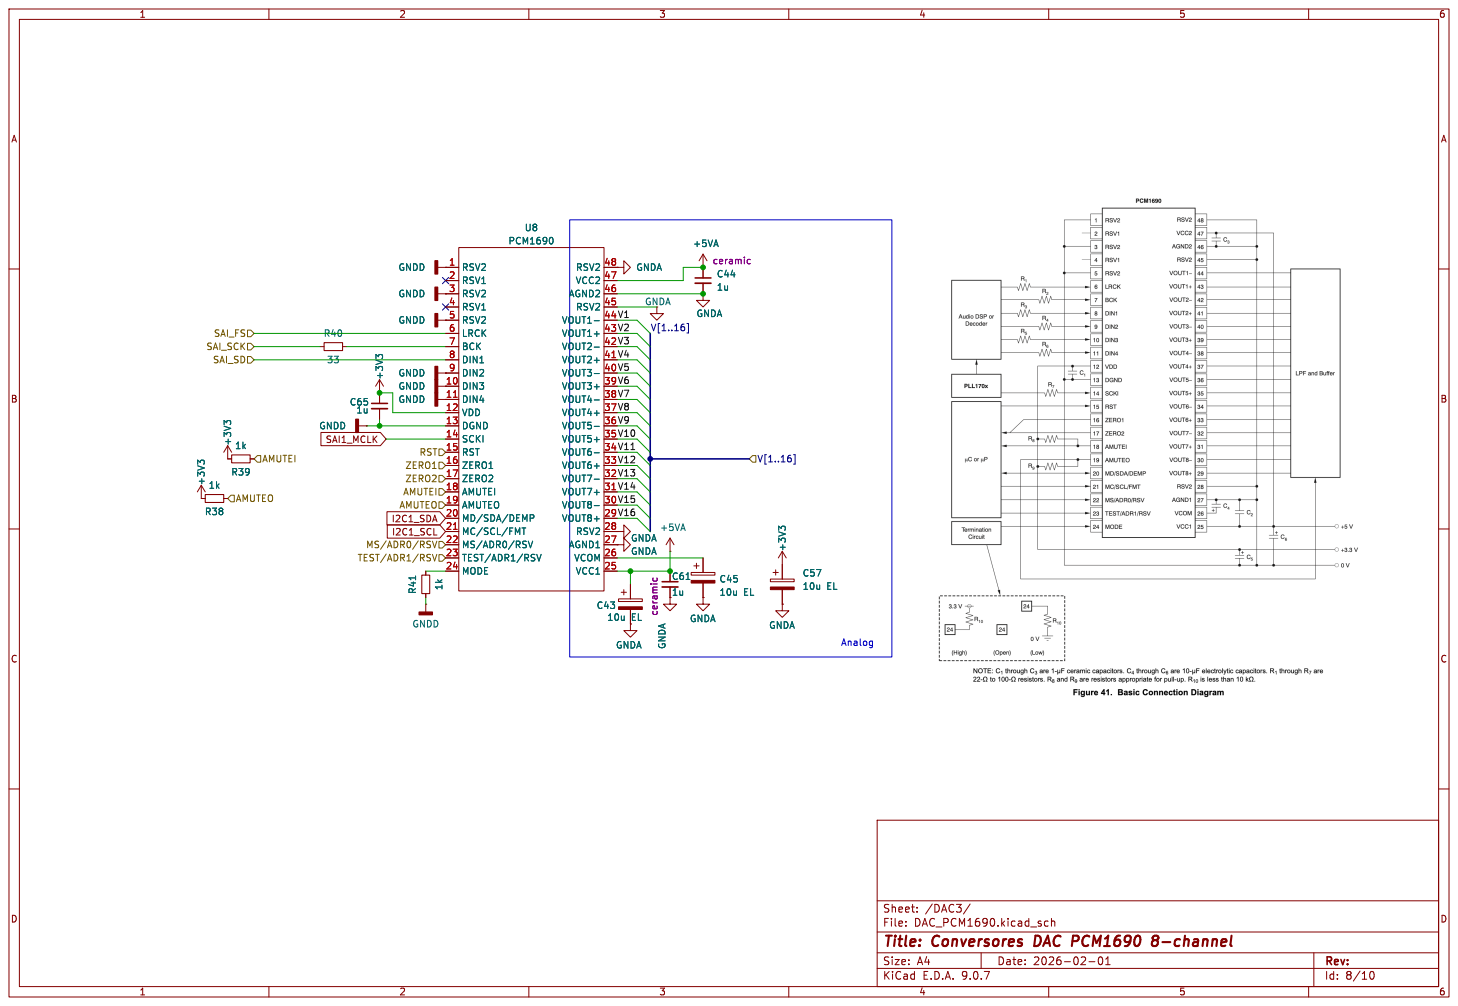
[picture p54: page 8]

TEST/ADR1/RSV MS/ADR0/RSV

Id: 8/10 Title: Conversores DAC PCM1690 8-channel File: DAC_PCM1690.kicad_sch Sheet: /DAC3/ C43

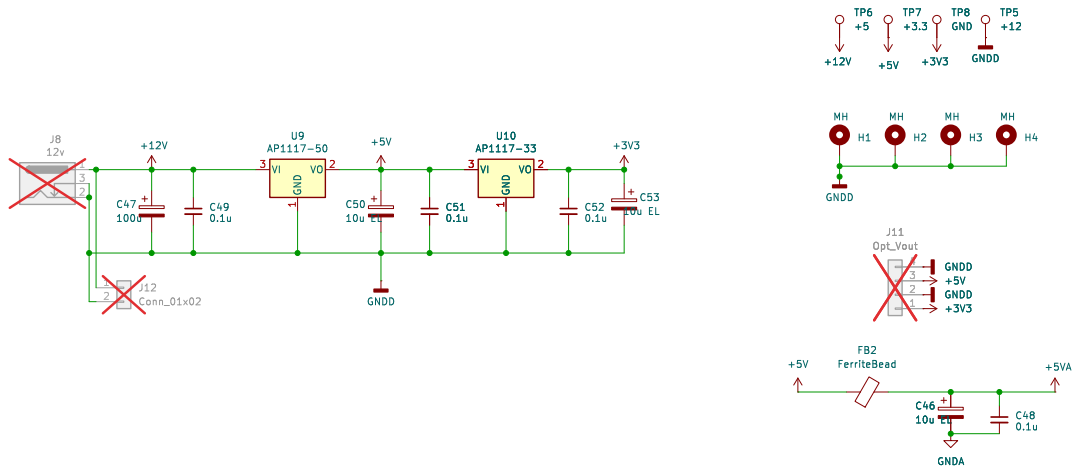
[picture p55: page 9]

File: DS_Power.kicad_sch Sheet: /DS_Power/
Id: 9/10 Title: Power supply 12V

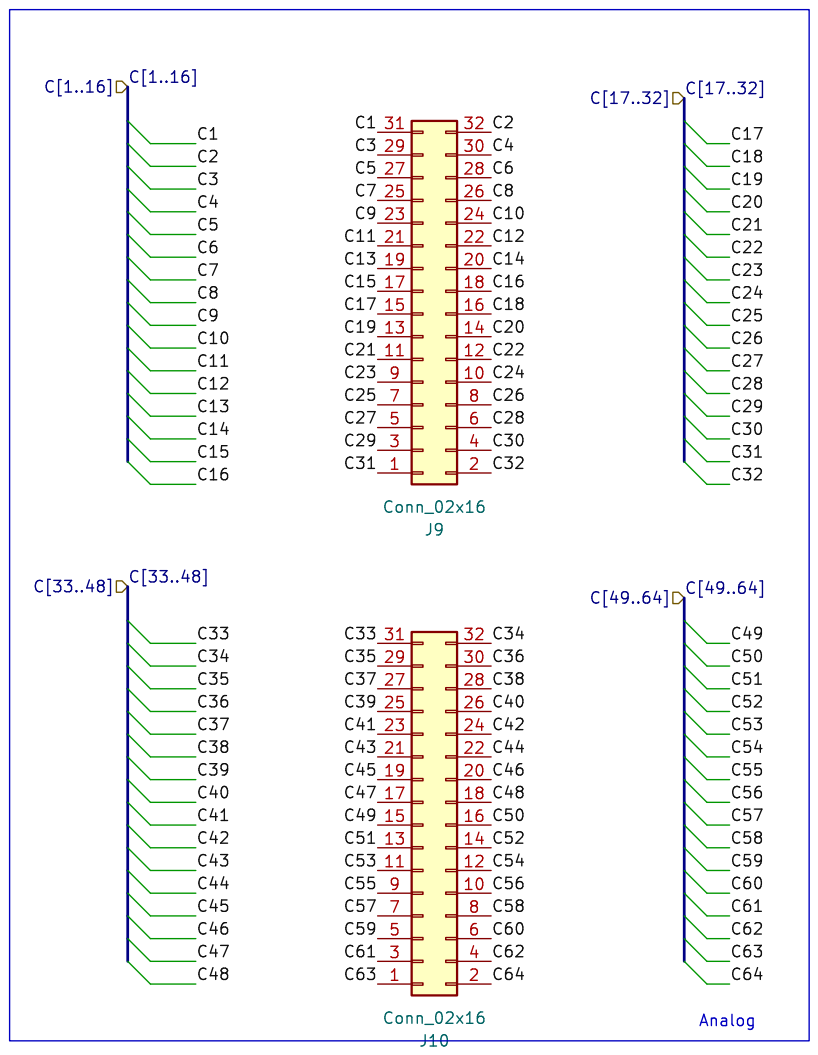
[picture p56: page 10]
