bergamifer/DS-Project/hardware/DS/plot/DS.pdf

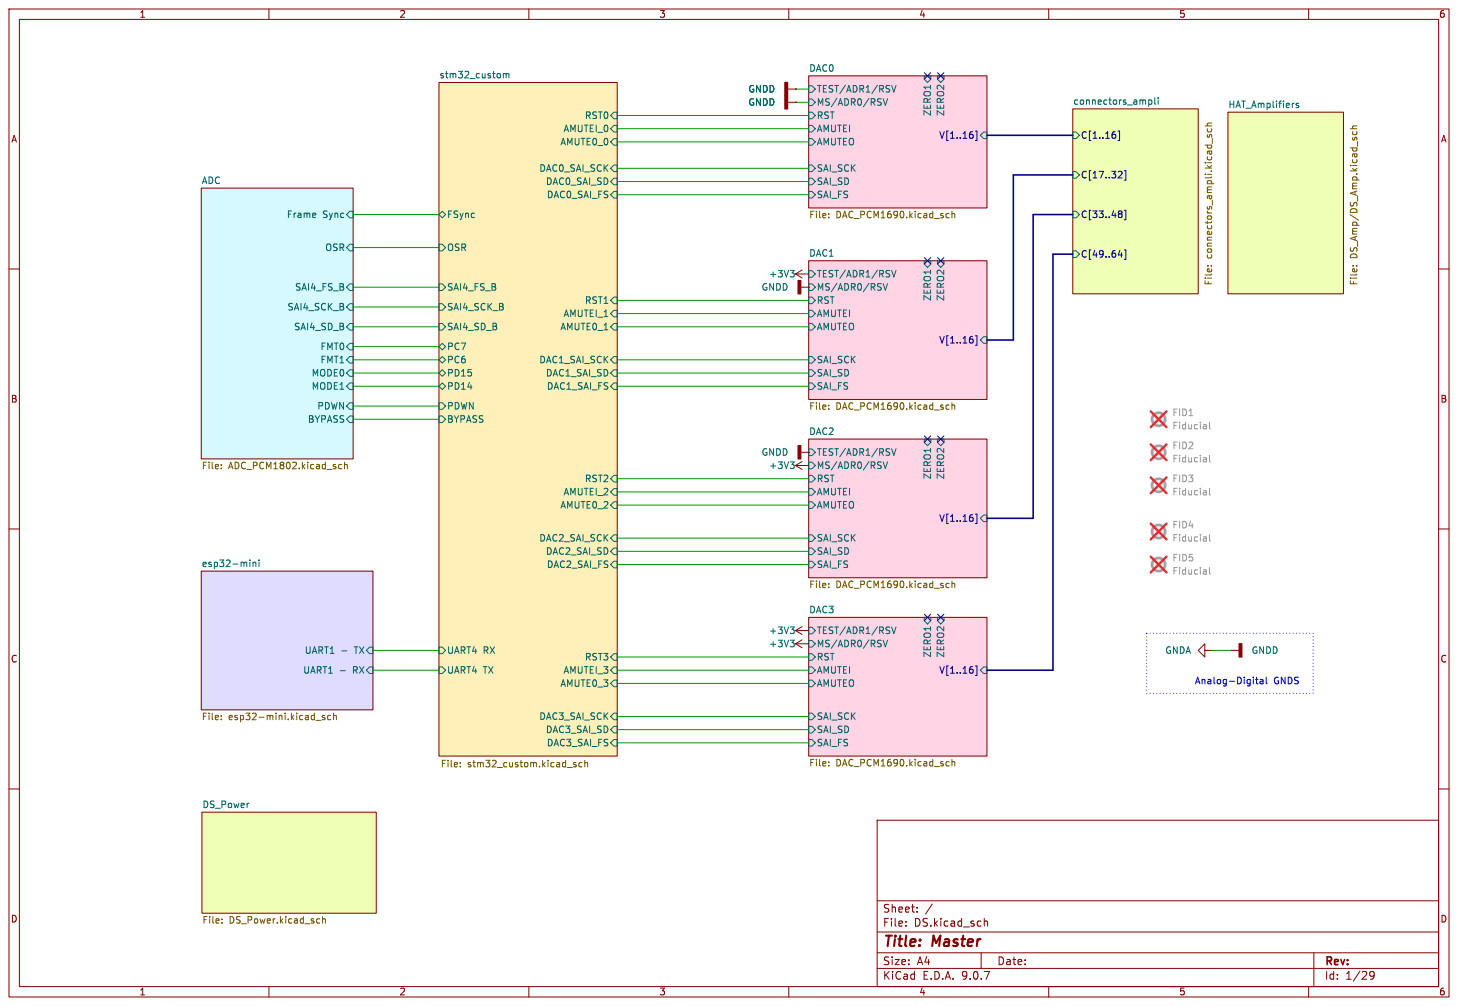
[picture p57: page 1]

Id: 1/29 Title: Master File: DS.kicad_sch Sheet: /

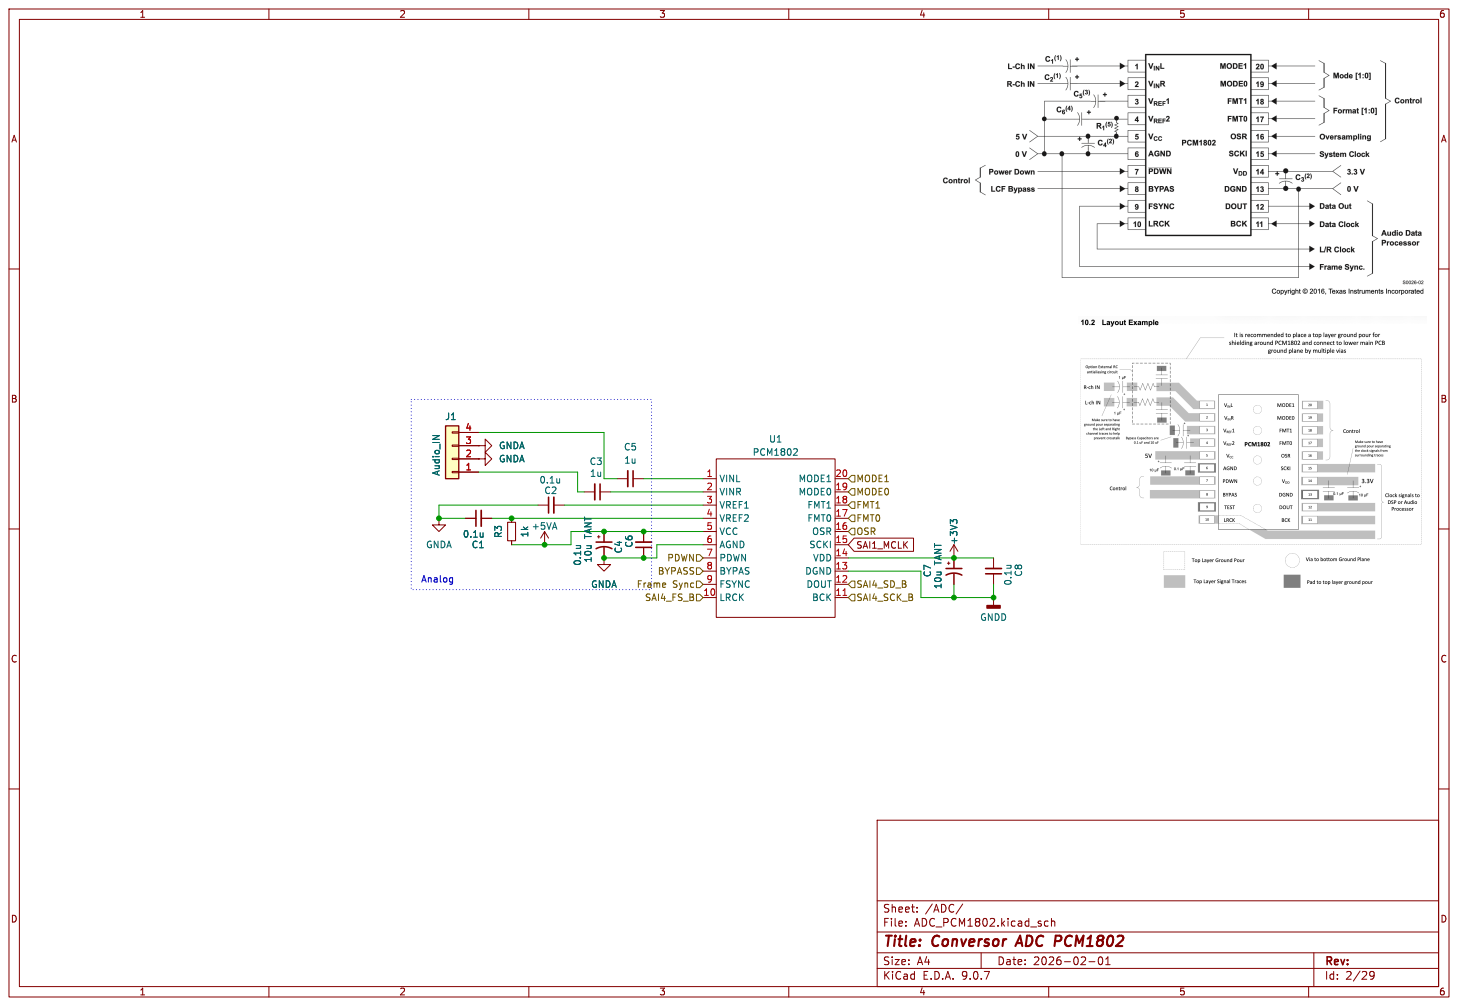
[picture p58: page 2]

File: ADC_PCM1802.kicad_sch Sheet: /ADC/
Id: 2/29 Title: Conversor ADC PCM1802

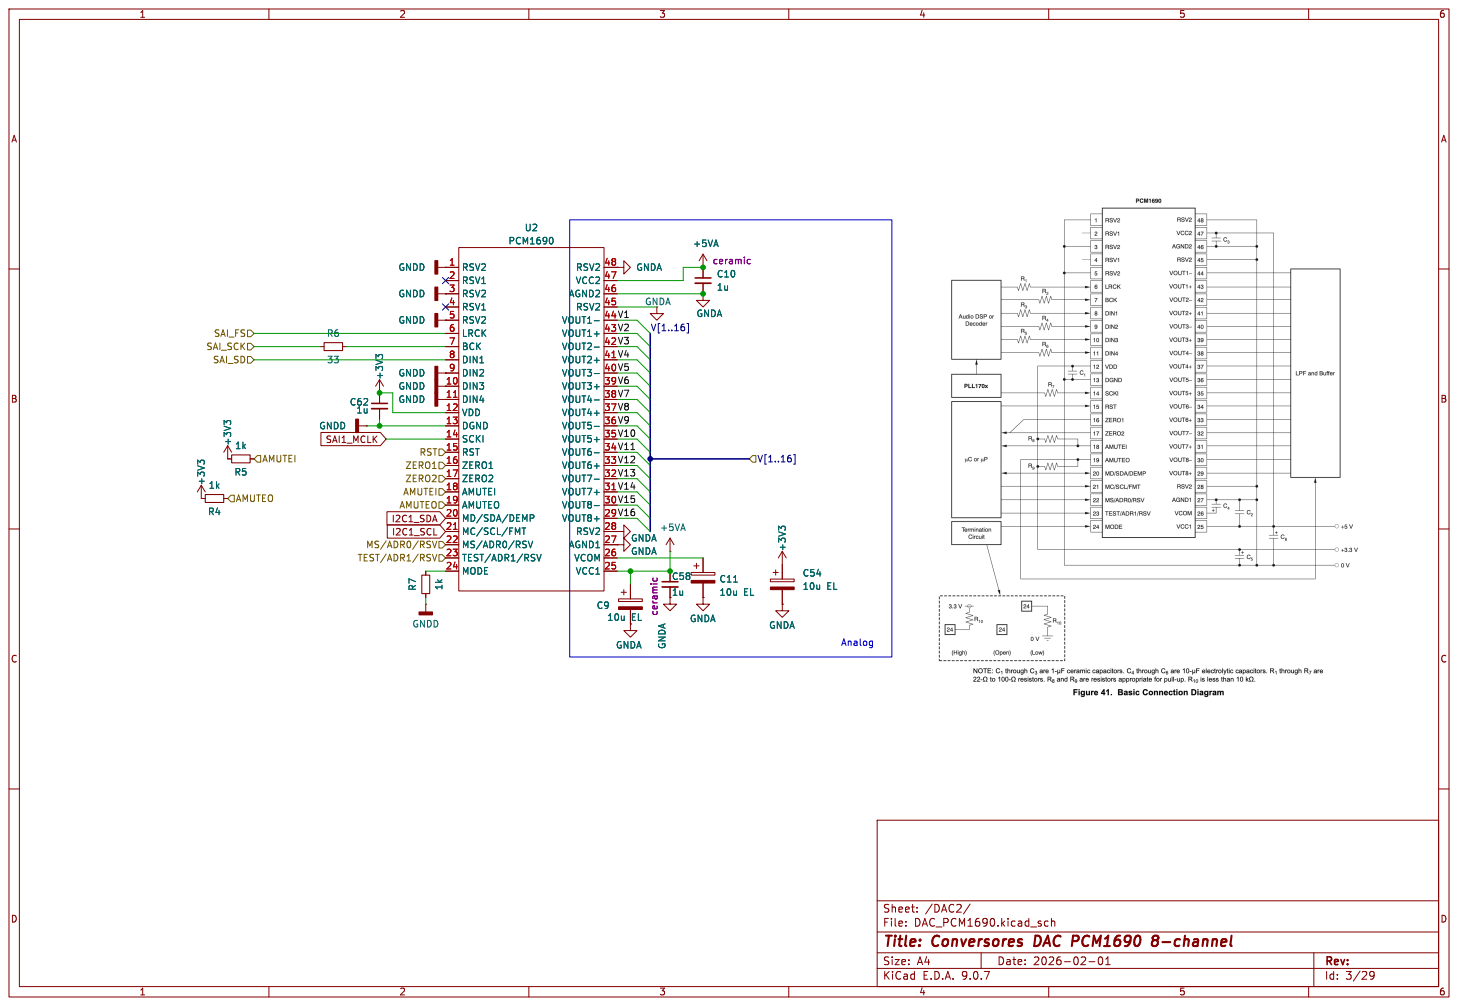
[picture p59: page 3]

TEST/ADR1/RSV MS/ADR0/RSV

Id: 3/29 Title: Conversores DAC PCM1690 8-channel File: DAC_PCM1690.kicad_sch Sheet: /DAC2/ C9

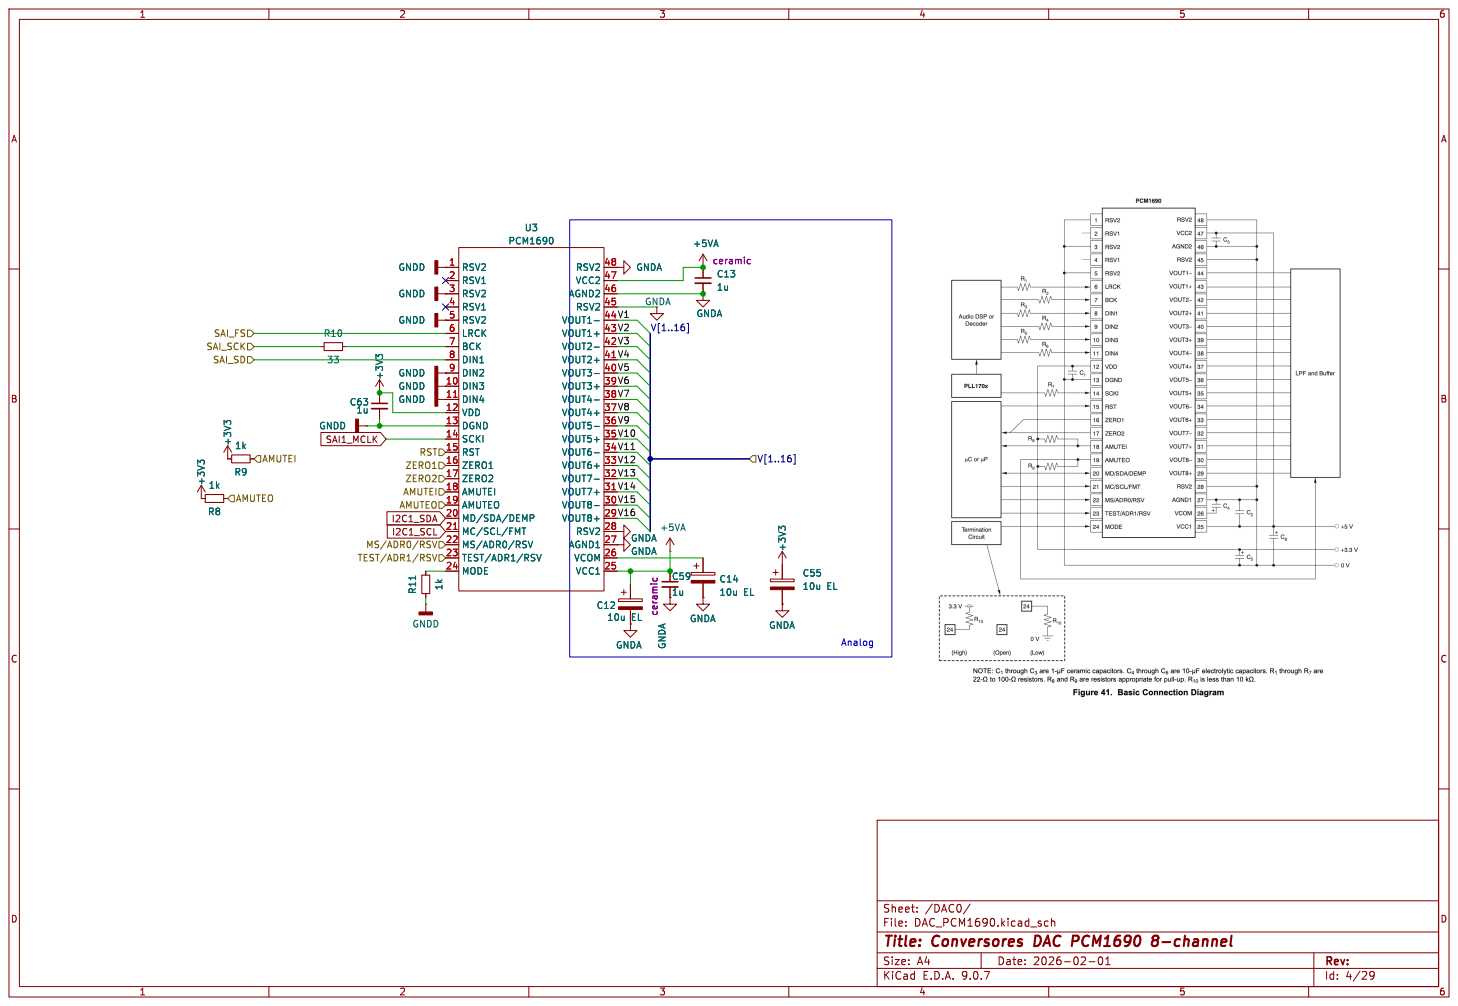
[picture p60: page 4]

TEST/ADR1/RSV MS/ADR0/RSV

Id: 4/29 Title: Conversores DAC PCM1690 8-channel File: DAC_PCM1690.kicad_sch Sheet: /DAC0/ C12

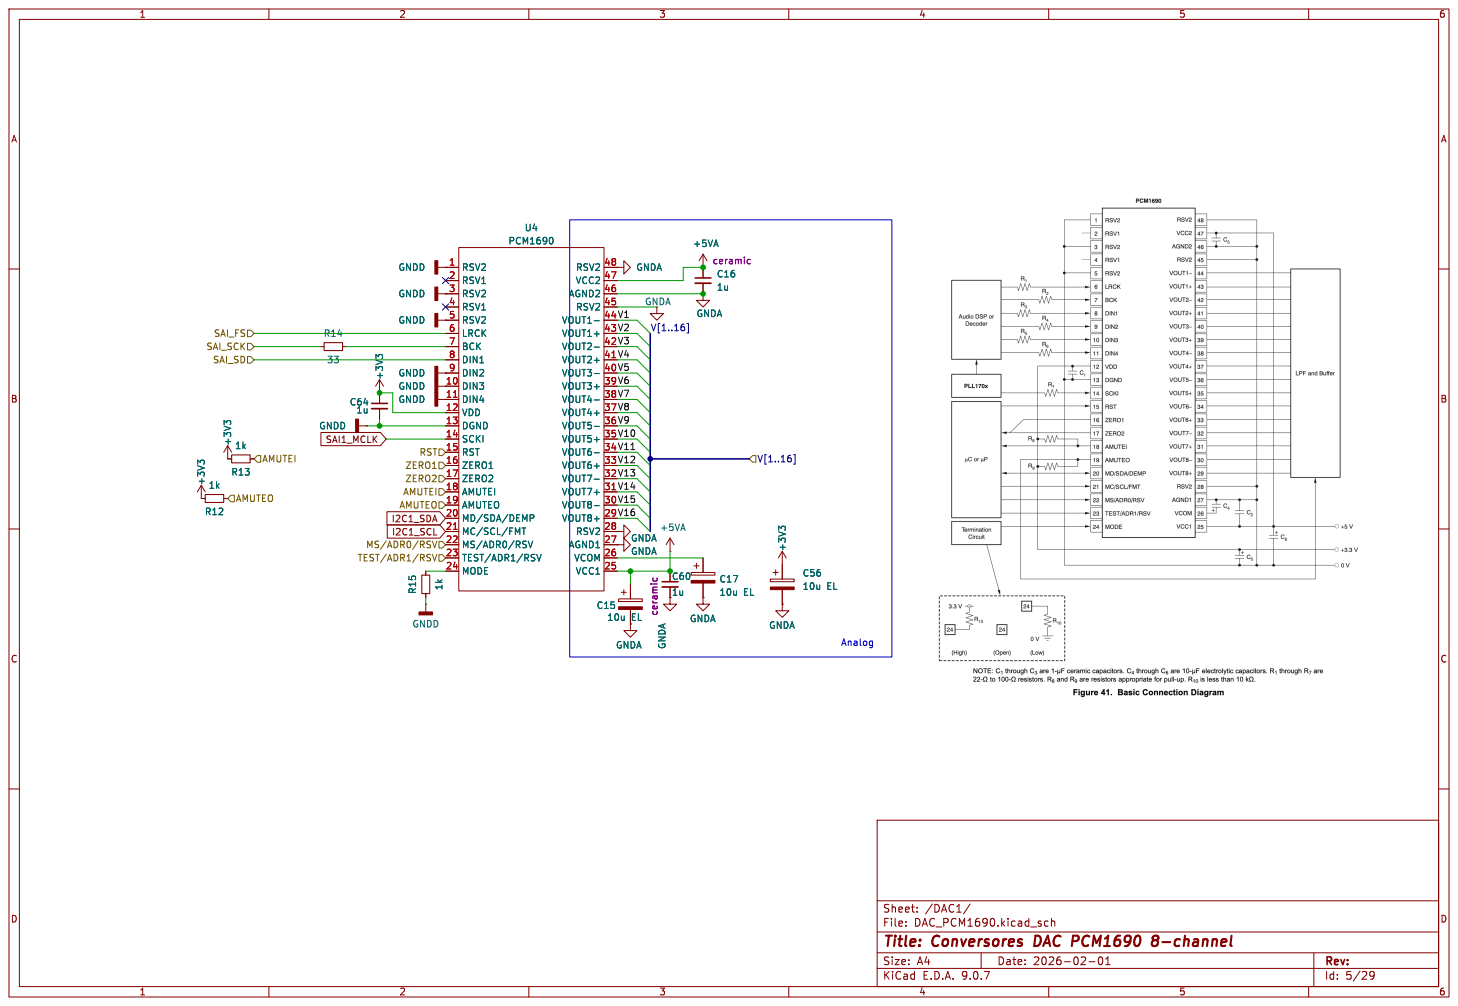
[picture p61: page 5]

TEST/ADR1/RSV MS/ADR0/RSV

Id: 5/29 Title: Conversores DAC PCM1690 8-channel File: DAC_PCM1690.kicad_sch Sheet: /DAC1/ C15

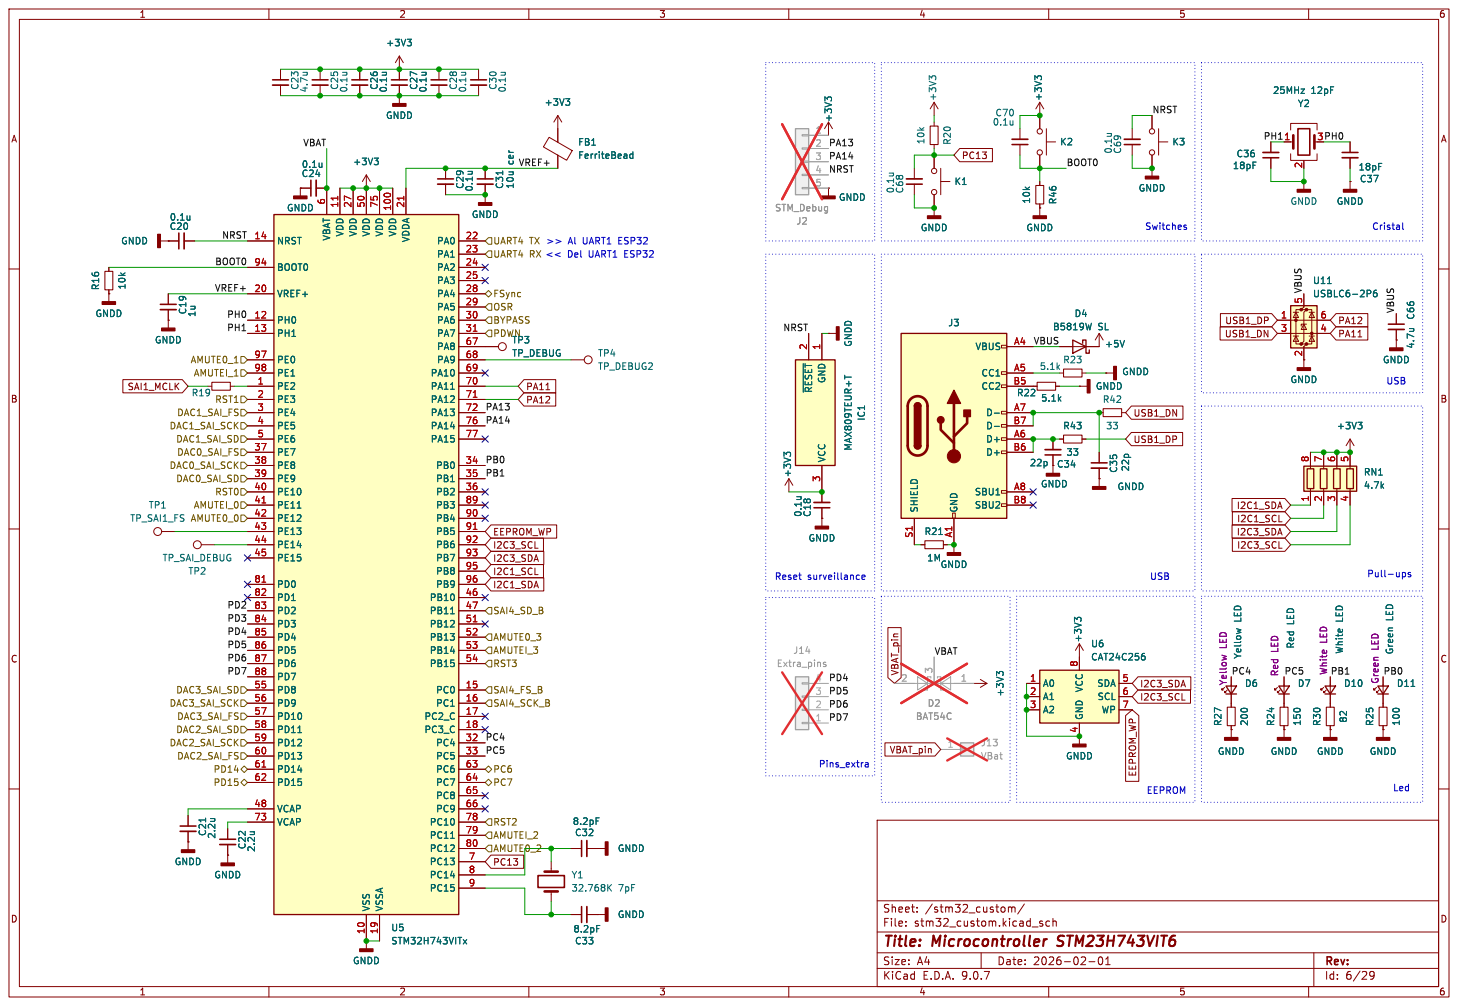
[picture p62: page 6]

6 VDD 11 VDD 27 VDD 50 VSS 10 VDD 75 VSSA 19 VDD 100 VDDA 21 PA0 22 PA1 23 PA2 24 PA3 25 PA4 28 PA5 29 PA6 30 PA7 31 PA8 67 PA9 68 PA10 69 PA11 70 PA12 71 PA13 72 PA14 76 PA15 77 PB0 34 PB1 35 PB2 36 PB3 89 PB4 90 PB5 91 PB6 92 PB7 93 PB8 95 PB9 96 PB10 46 PB11 47 PB12 51 PB13 52 PB14 53 PB15 54 PC0 15 PC1 16 PC2_C 17 PC3_C 18 PC4 32 PC5 33 PC6 63 PC7 64 PC8 65 PC9 66 PC10 78 PC11 79 PC12 80 PC13 7 PC14 8 PC15 9 C22 2.2u GNDD GNDD C21 2.2u GNDD C19 1u GNDD R16 10k GNDD
0.1u GNDD

6 VDD 11 VDD 27 VDD 50 VSS 10 VDD 75 VSSA 19 VDD 100 VDDA 21 PA0 22 PA1 23 PA2 24 PA3 25 PA4 28 PA5 29 PA6 30 PA7 31 PA8 67 PA9 68 PA10 69 PA11 70 PA12 71 PA13 72 PA14 76 PA15 77 PB0 34 PB1 35 PB2 36 PB3 89 PB4 90 PB5 91 PB6 92 PB7 93 PB8 95 PB9 96 PB10 46 PB11 47 PB12 51 PB13 52 PB14 53 PB15 54 PC0 15 PC1 16 PC2_C 17 PC3_C 18 PC4 32 PC5 33 PC6 63 PC7 64 PC8 65 PC9 66 PC10 78 PC11 79 PC12 80 PC13 7 PC14 8 PC15 9 U5STM32H743VITx

4 SDA 5 SCL 6 WP 7 U6 CAT24C256 +3V3 GNDD R24 150 D10 White LED White LED

4 SDA 5 SCL 6 WP 7 +3V3 GNDD R24 150 D10 White LED White LED

D7 Red LED Red LED

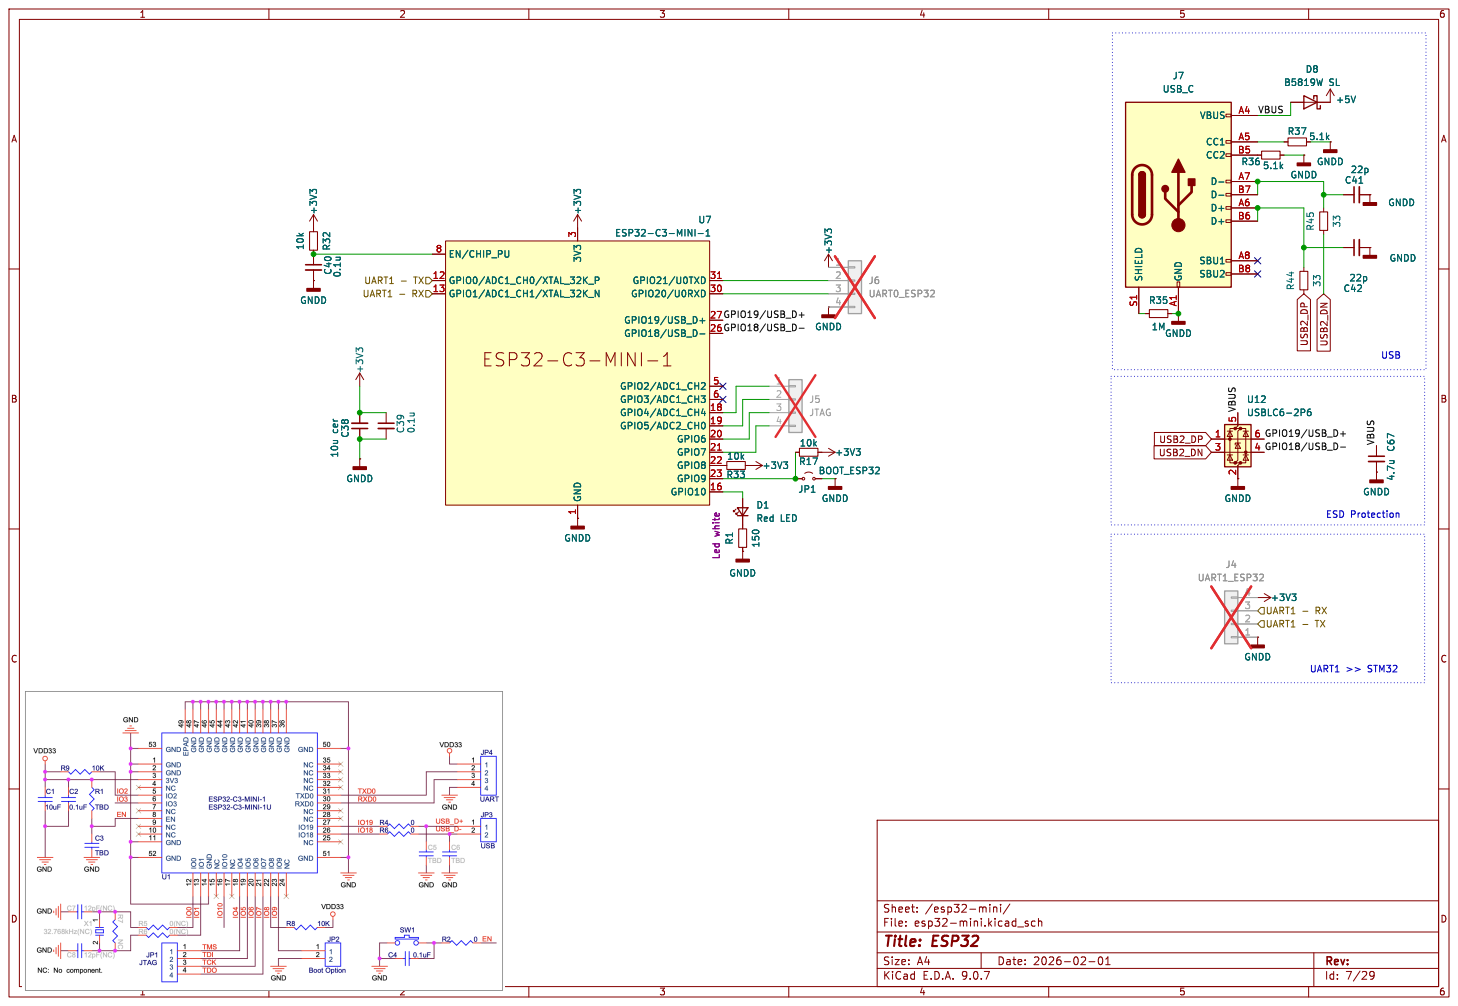
[picture p63: page 7]

1 GPIO21/U0TXD 31 GPIO20/U0RXD 30 GPIO19/USB_D+ 27 GPIO18/USB_D- 26 GPIO2/ADC1_CH2 5 GPIO3/ADC1_CH3 6 GPIO4/ADC1_CH4 18 GPIO5/ADC2_CH0 19 GPIO6 20 GPIO7 21 GPIO8 22 GPIO9 23 GPIO10 16 U7 ESP32-C3-MINI-1 SHIELD S1 GND A1 VBUS A4 CC1 A5 CC2 B5 D- A7 D- B7 D+ A6 D+ B6 SBU1 A8 SBU2 B8

File: esp32-mini.kicad_sch Sheet: /esp32-mini/ GNDD

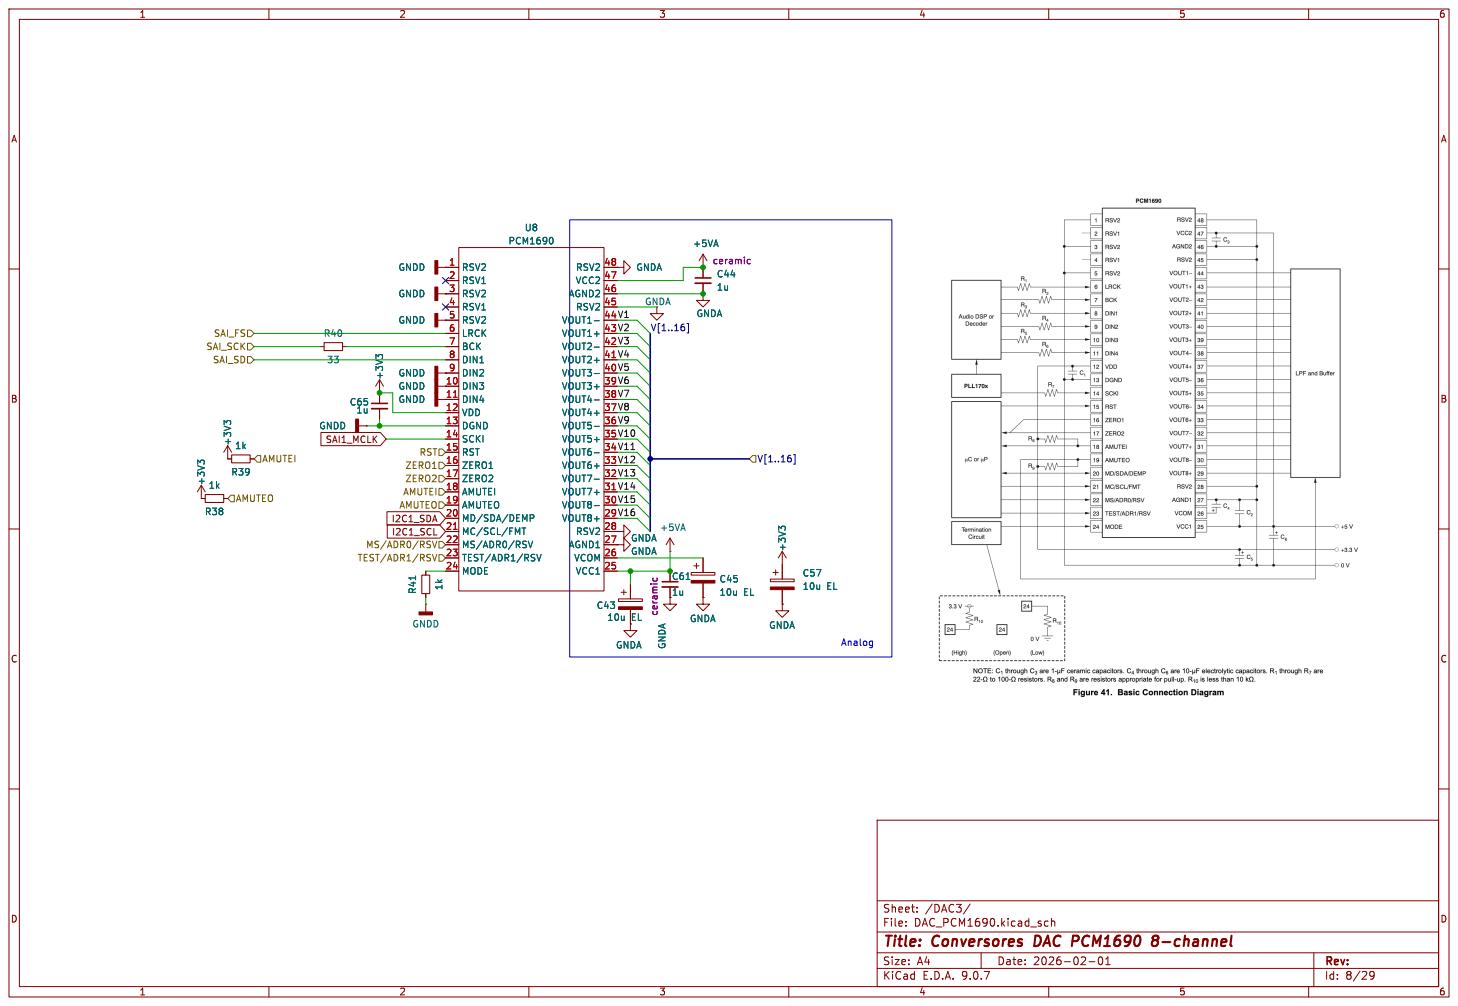
[picture p64: page 8]

TEST/ADR1/RSV MS/ADR0/RSV

Id: 8/29 Title: Conversores DAC PCM1690 8-channel File: DAC_PCM1690.kicad_sch Sheet: /DAC3/ C43

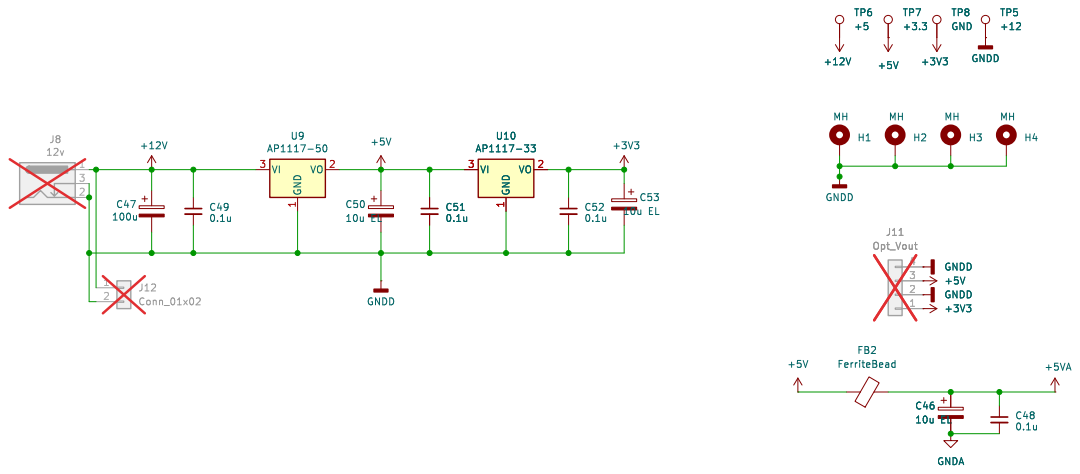
[picture p65: page 9]

File: DS_Power.kicad_sch Sheet: /DS_Power/
Id: 9/29 Title: Power supply 12V


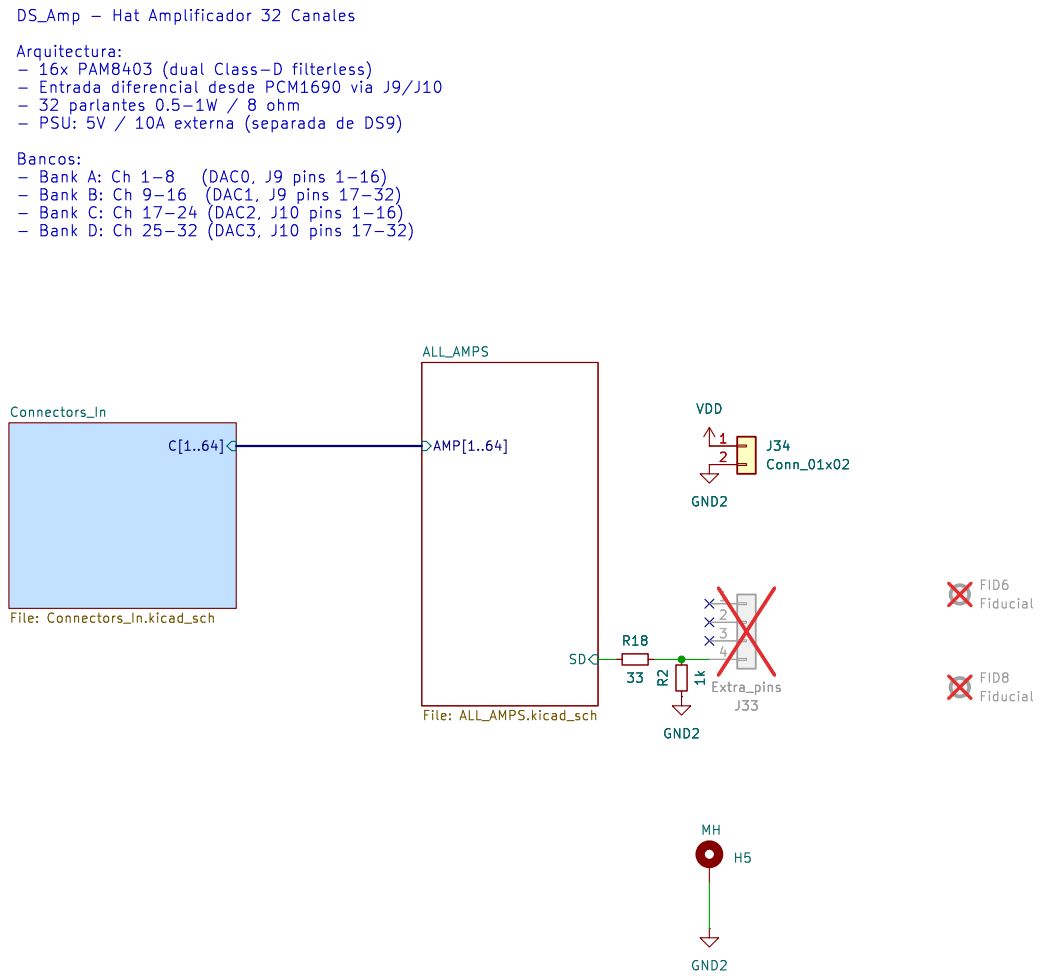
[picture p66: page 11]

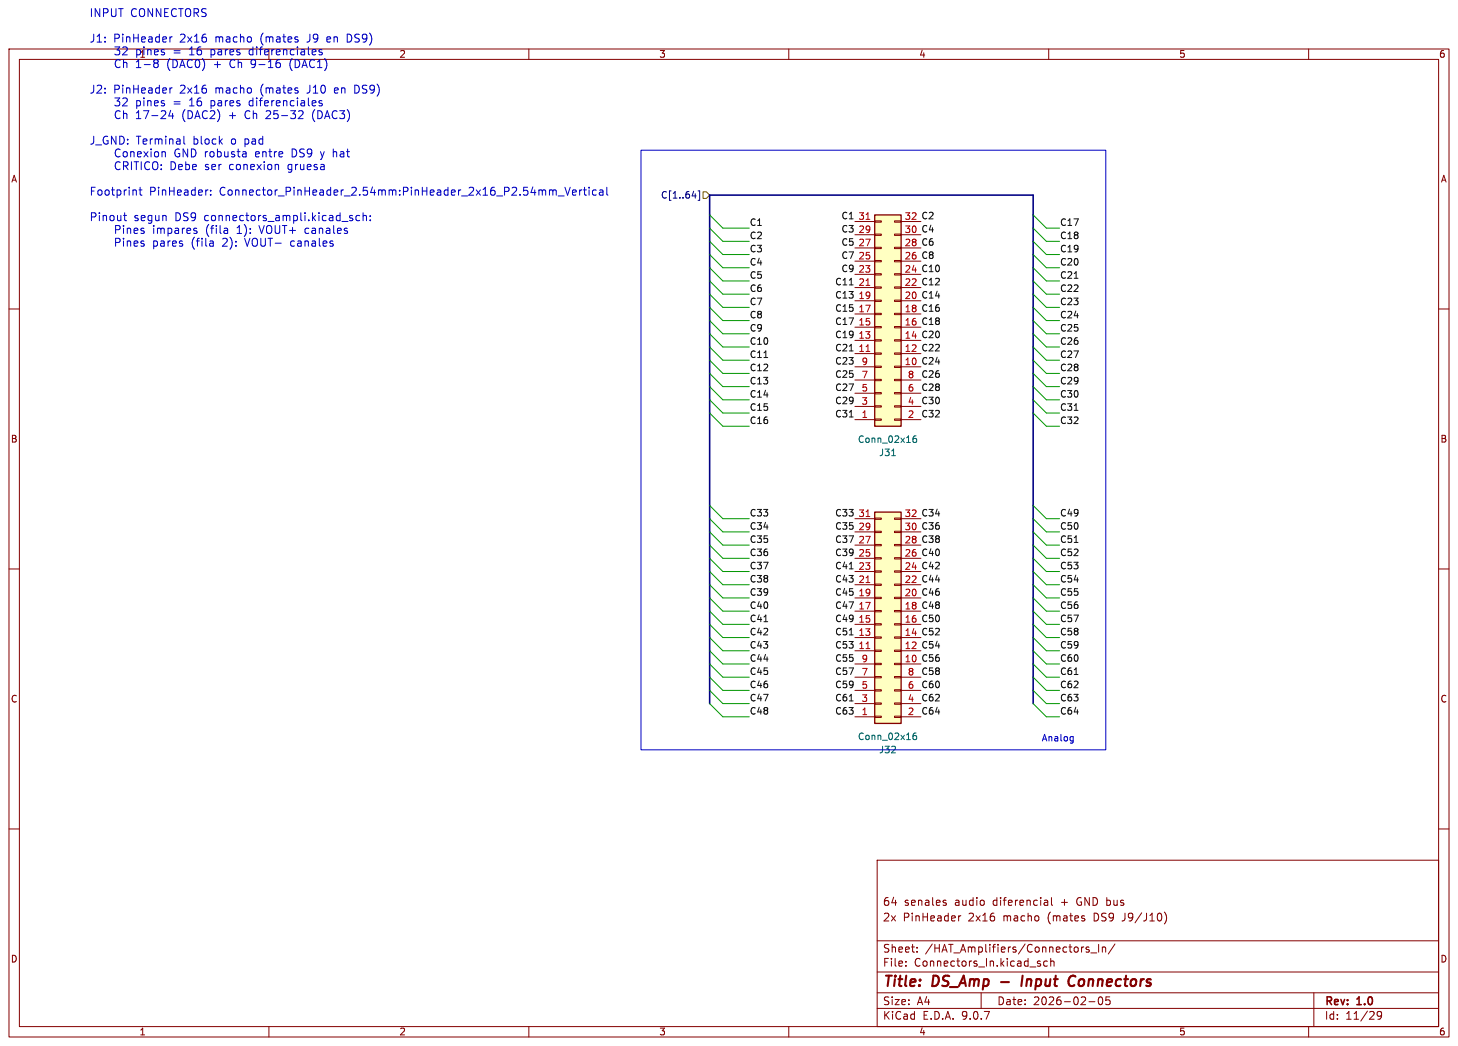
[picture p67: page 12]

J_GND: Terminal block o pad
Conexion GND robusta entre DS9 y hat CRITICO: Debe ser conexion gruesa

Id: 11/29 Title: DS_Amp - Input Connectors

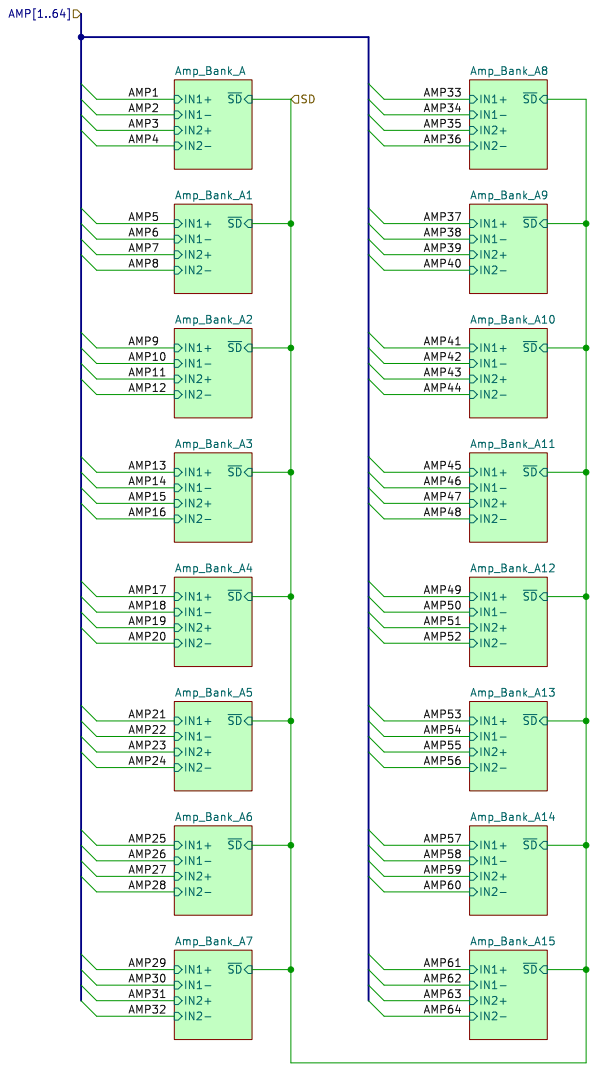
[picture p68: page 13]

Id: 16/29 Title: File: ALL_AMPS.kicad_sch Sheet: /HAT_Amplifiers/ALL_AMPS/

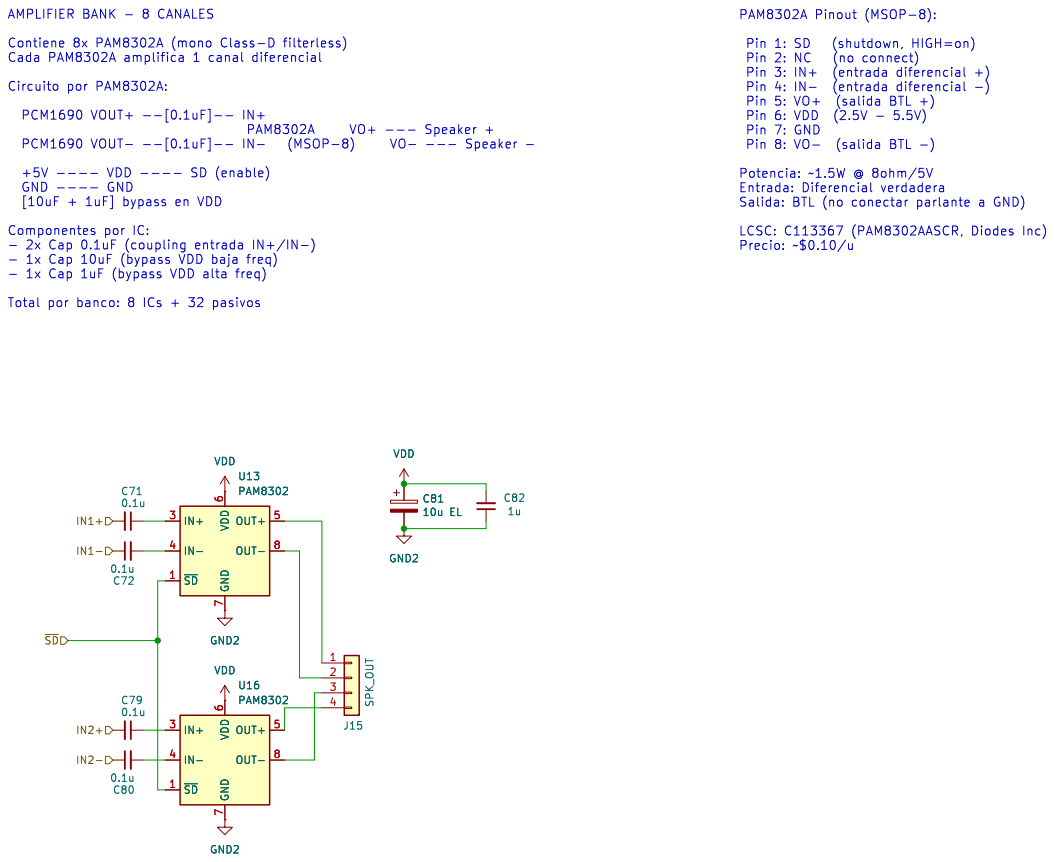
[picture p69: page 14]

LCSC: C113367 (PAM8302AASCR, Diodes Inc) Precio: ~$0.10/u U13 PAM8302

- 1x Cap 10uF (bypass VDD baja freq)

7 OUT+ 5 OUT- 8 VDD GND2 GND2 VDD VDD
10u EL VDD

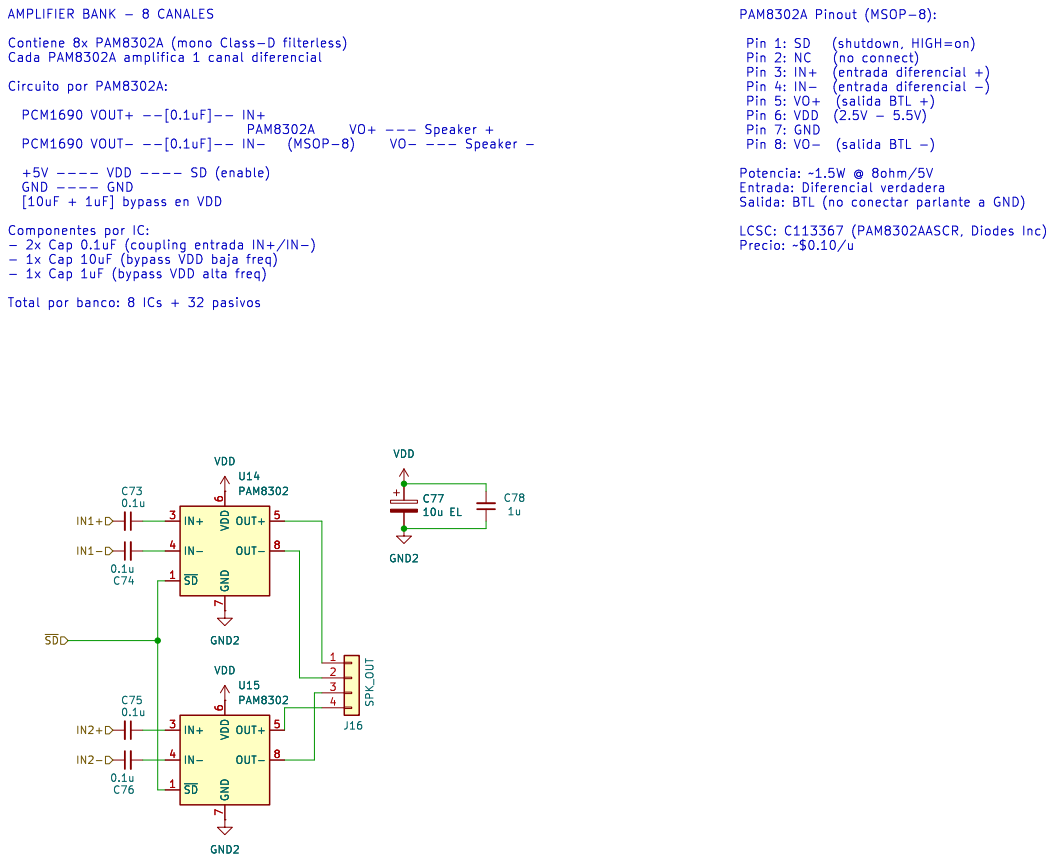
[picture p70: page 15]

LCSC: C113367 (PAM8302AASCR, Diodes Inc) Precio: ~$0.10/u AMPLIFIER BANK - 8 CANALES

- 1x Cap 10uF (bypass VDD baja freq)
- 1x Cap 1uF (bypass VDD alta freq) Total por banco: 8 ICs + 32 pasivos U14 PAM8302

7 OUT+ 5 OUT- 8 GND2 GND2 VDD VDD
10u EL VDD

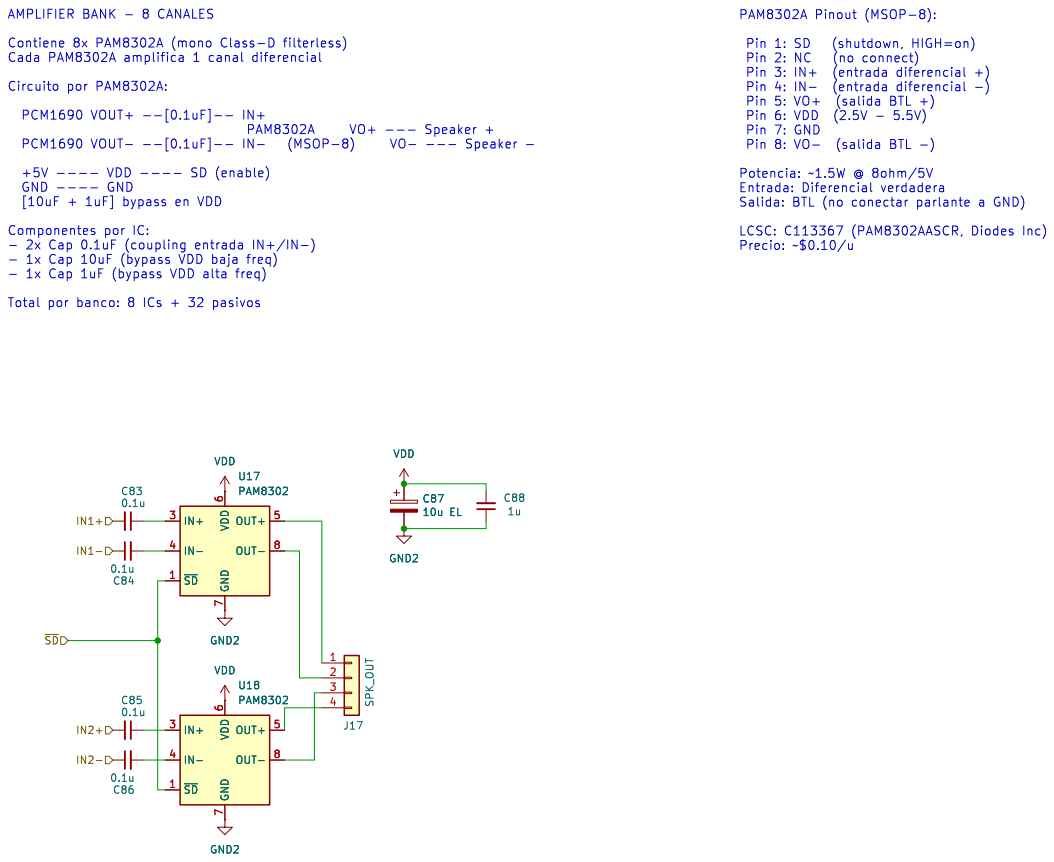
[picture p71: page 16]

LCSC: C113367 (PAM8302AASCR, Diodes Inc) Precio: ~$0.10/u U17 PAM8302

- 1x Cap 10uF (bypass VDD baja freq)

7 OUT+ 5 OUT- 8 VDD GND2 GND2 VDD VDD

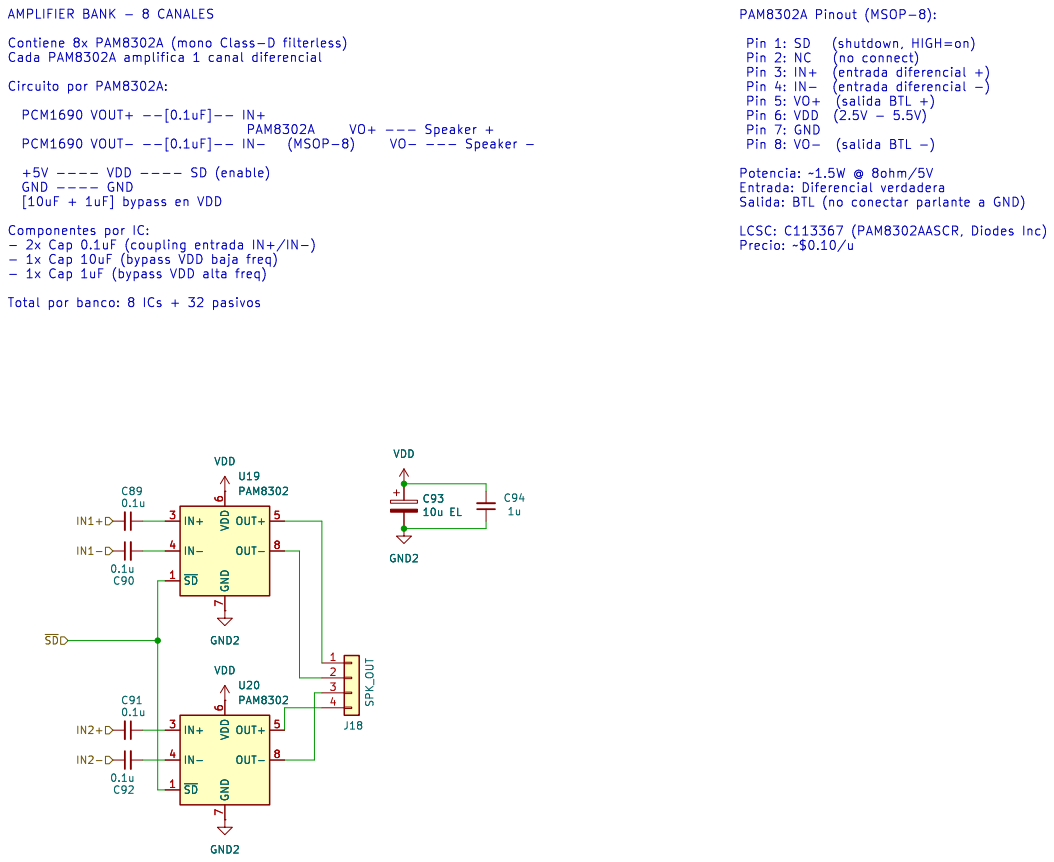
[picture p72: page 17]

LCSC: C113367 (PAM8302AASCR, Diodes Inc) Precio: ~$0.10/u U19 PAM8302

- 1x Cap 10uF (bypass VDD baja freq)

7 OUT+ 5 OUT- 8 GND2 GND2 VDD VDD

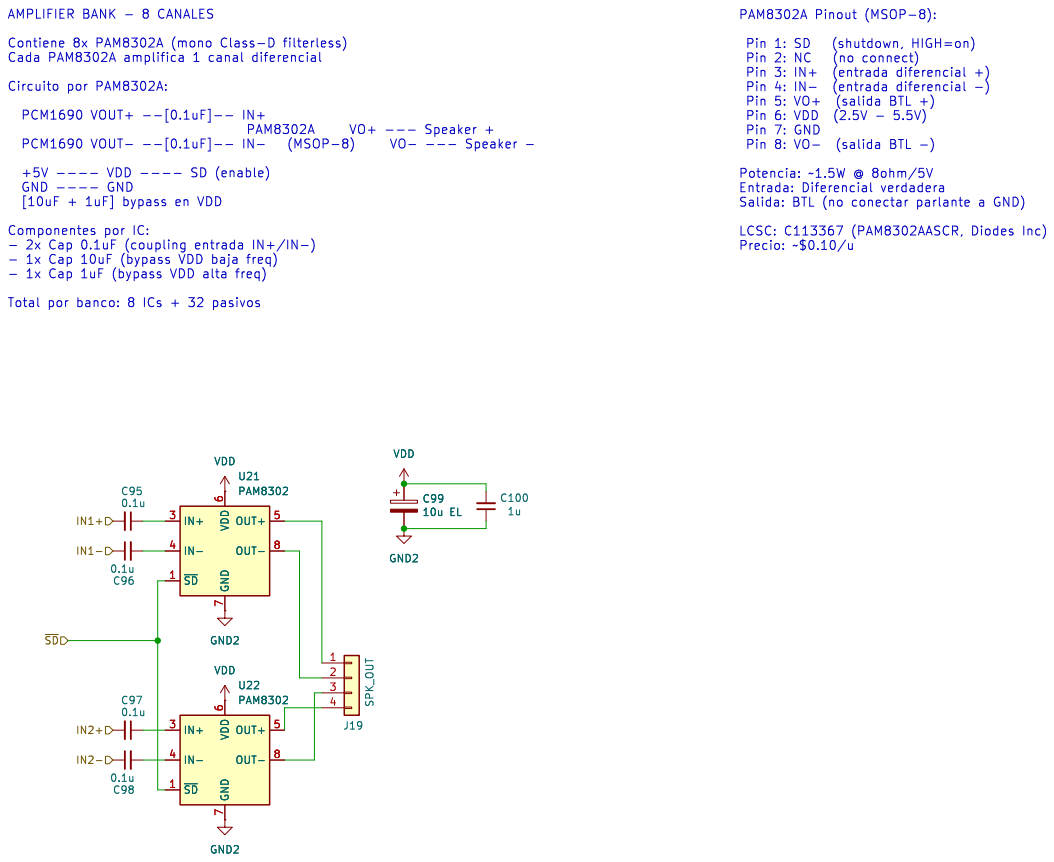
[picture p73: page 18]

LCSC: C113367 (PAM8302AASCR, Diodes Inc) Precio: ~$0.10/u AMPLIFIER BANK - 8 CANALES

- 1x Cap 10uF (bypass VDD baja freq)
- 1x Cap 1uF (bypass VDD alta freq) Total por banco: 8 ICs + 32 pasivos U21 PAM8302

7 OUT+ 5 OUT- 8 VDD GND2 VDD VDD

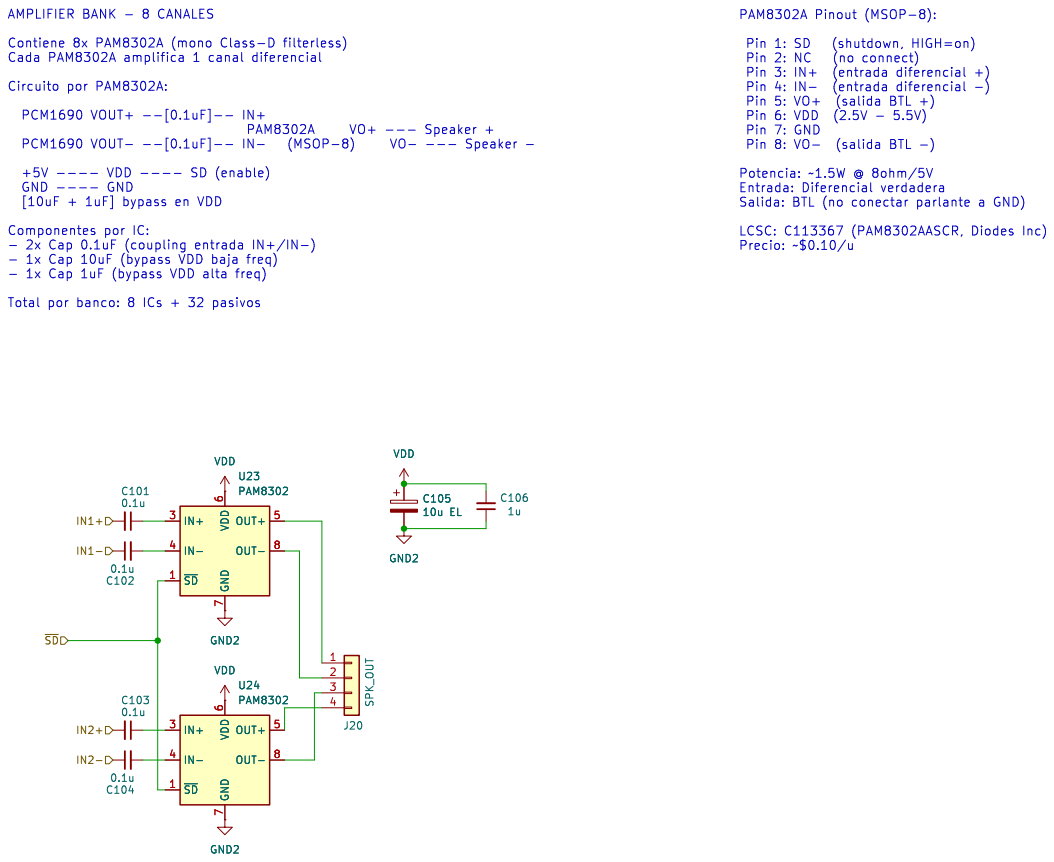
[picture p74: page 19]

LCSC: C113367 (PAM8302AASCR, Diodes Inc) Precio: ~$0.10/u U23 PAM8302

- 1x Cap 10uF (bypass VDD baja freq)

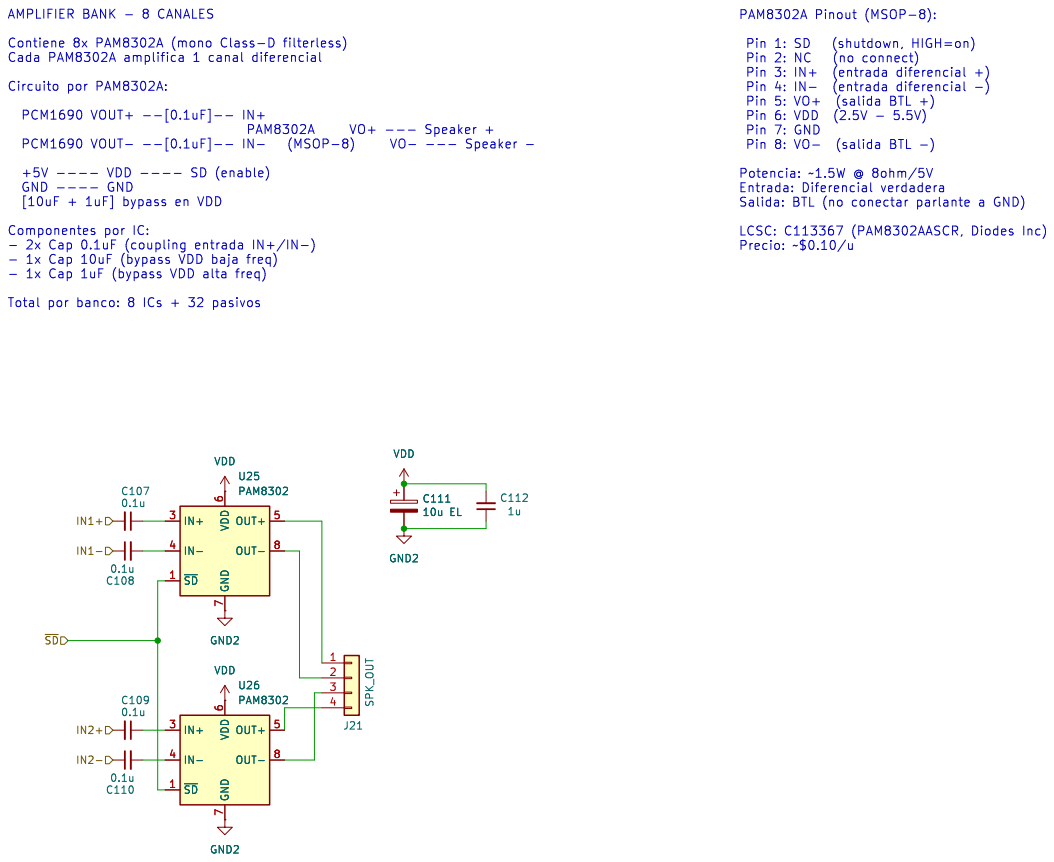
[picture p75: page 20]

LCSC: C113367 (PAM8302AASCR, Diodes Inc) Precio: ~$0.10/u AMPLIFIER BANK - 8 CANALES

- 1x Cap 10uF (bypass VDD baja freq)
- 1x Cap 1uF (bypass VDD alta freq) Total por banco: 8 ICs + 32 pasivos U25 PAM8302

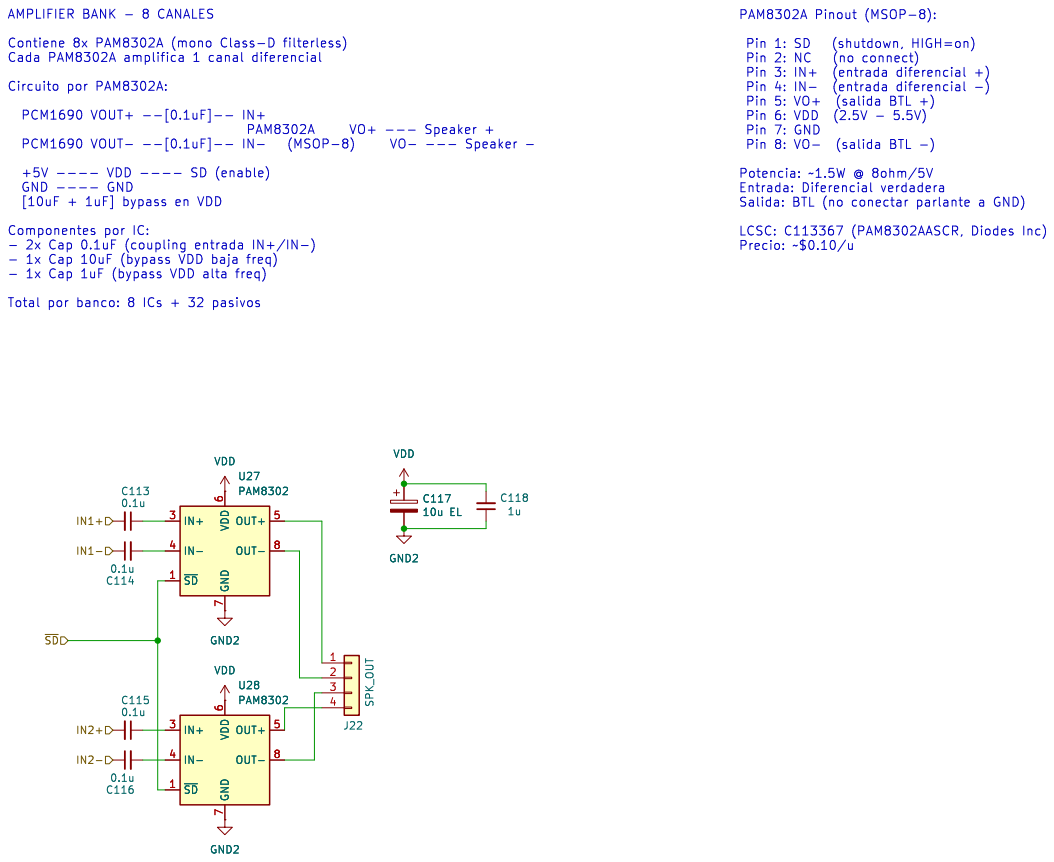
[picture p76: page 21]

LCSC: C113367 (PAM8302AASCR, Diodes Inc) Precio: ~$0.10/u AMPLIFIER BANK - 8 CANALES

- 1x Cap 10uF (bypass VDD baja freq)
- 1x Cap 1uF (bypass VDD alta freq) Total por banco: 8 ICs + 32 pasivos U27 PAM8302

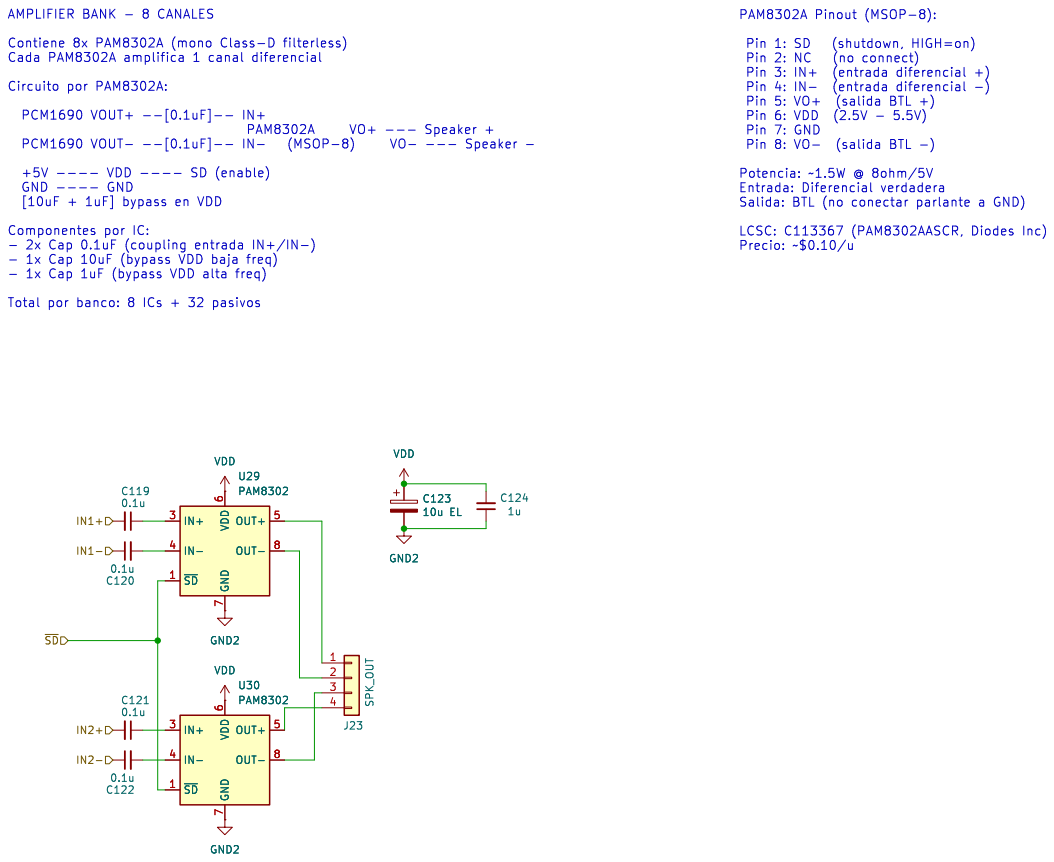
[picture p77: page 22]

LCSC: C113367 (PAM8302AASCR, Diodes Inc) Precio: ~$0.10/u AMPLIFIER BANK - 8 CANALES

- 1x Cap 10uF (bypass VDD baja freq)
- 1x Cap 1uF (bypass VDD alta freq) Total por banco: 8 ICs + 32 pasivos U29 PAM8302

7 OUT+ 5 OUT- 8 VDD GND2 VDD GND2 VDD

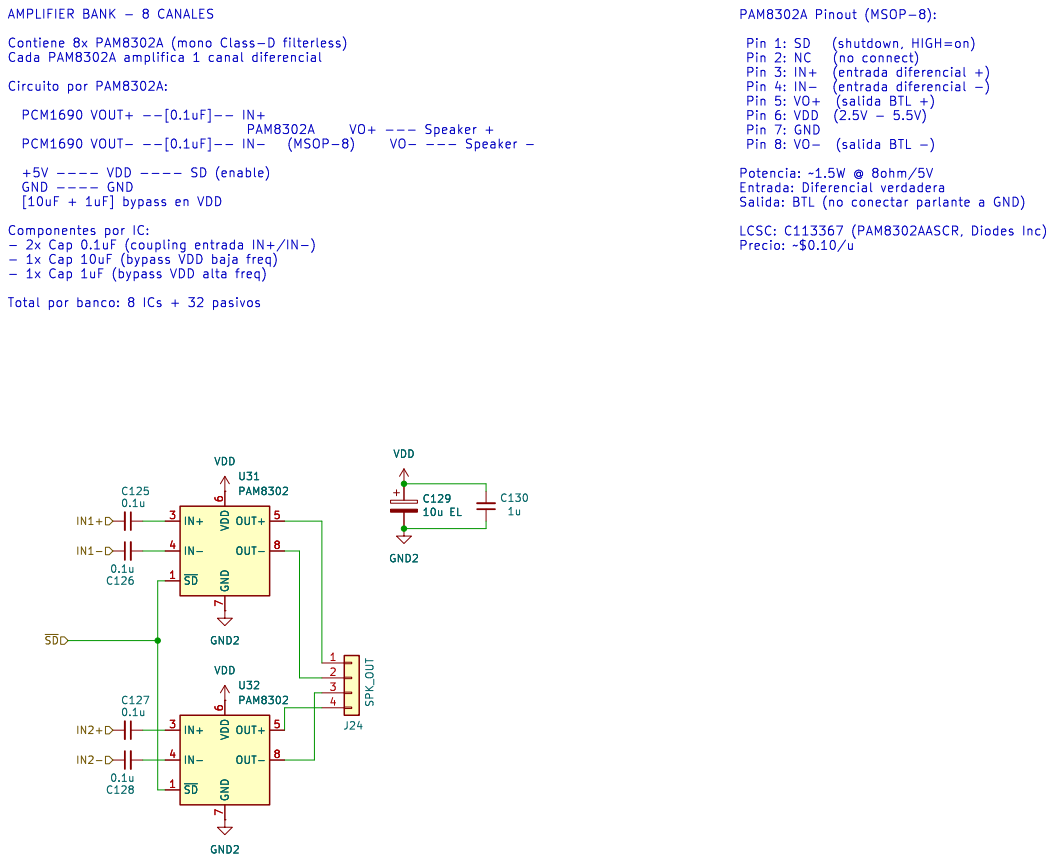
[picture p78: page 23]

LCSC: C113367 (PAM8302AASCR, Diodes Inc) Precio: ~$0.10/u AMPLIFIER BANK - 8 CANALES

- 1x Cap 10uF (bypass VDD baja freq)
- 1x Cap 1uF (bypass VDD alta freq) Total por banco: 8 ICs + 32 pasivos U31 PAM8302

7 OUT+ 5 OUT- 8 GND2 VDD VDD

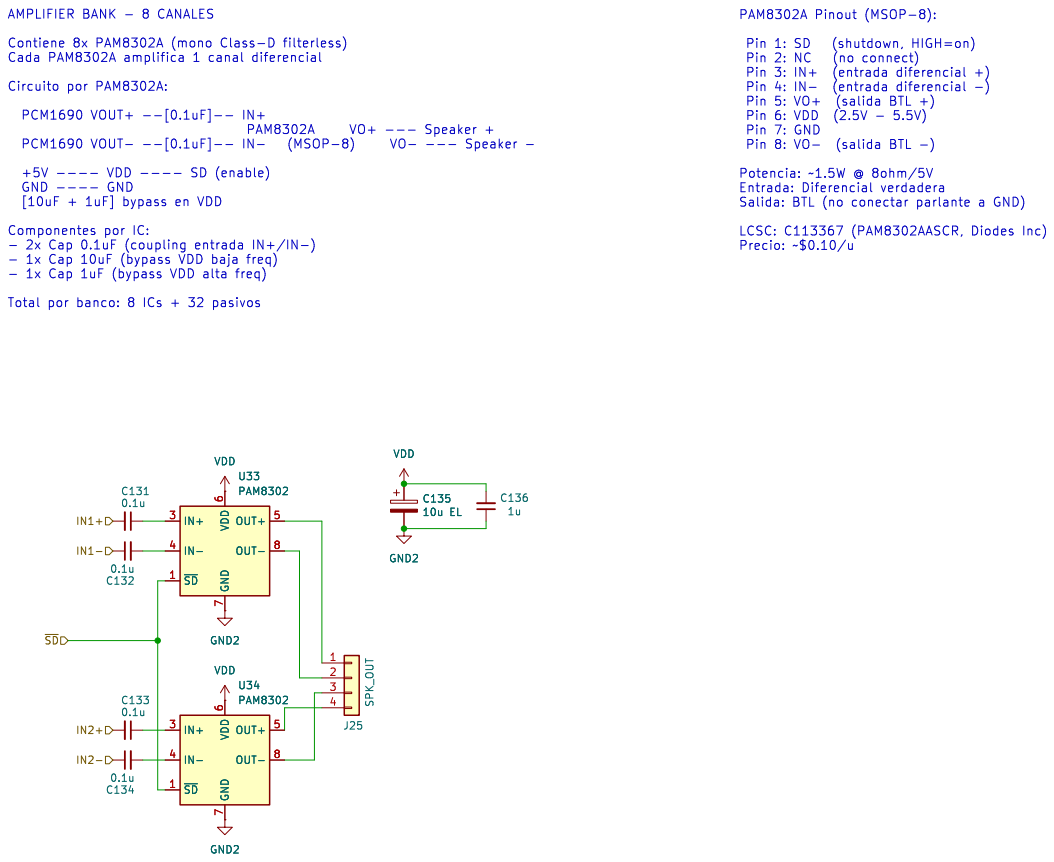
[picture p79: page 24]

LCSC: C113367 (PAM8302AASCR, Diodes Inc) Precio: ~$0.10/u AMPLIFIER BANK - 8 CANALES

- 1x Cap 10uF (bypass VDD baja freq)
- 1x Cap 1uF (bypass VDD alta freq) Total por banco: 8 ICs + 32 pasivos U33 PAM8302

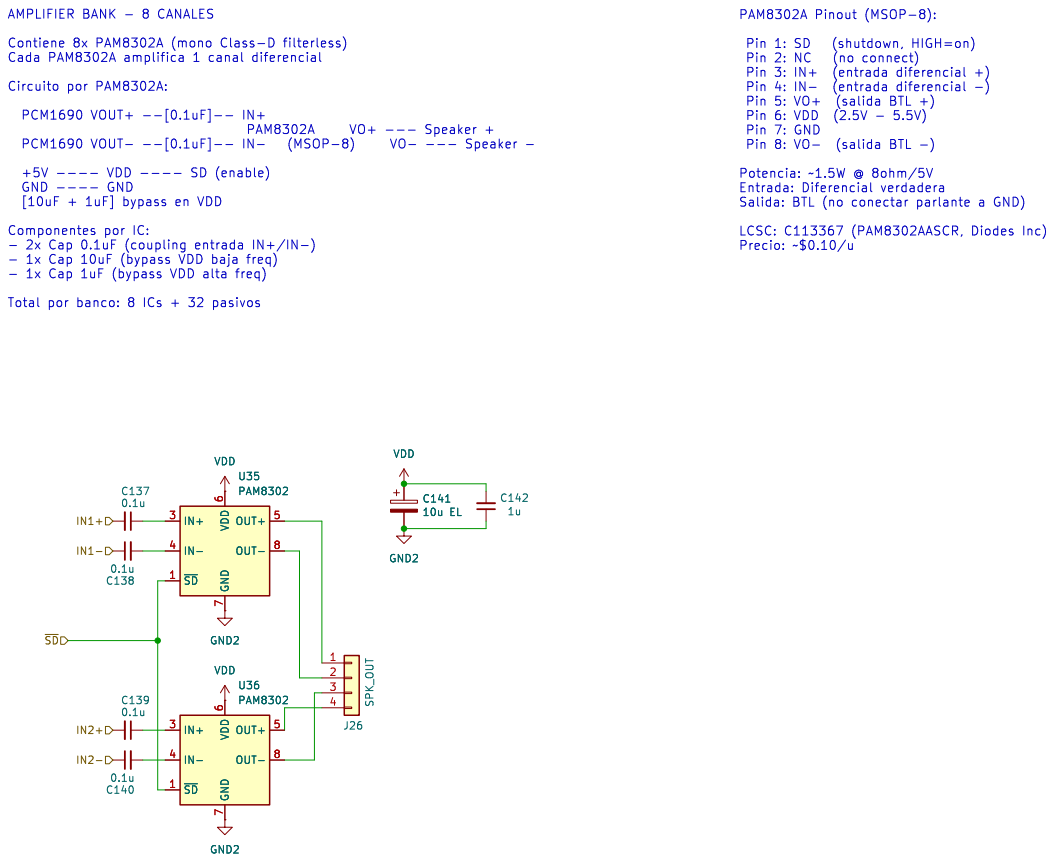
[picture p80: page 25]

LCSC: C113367 (PAM8302AASCR, Diodes Inc) Precio: ~$0.10/u AMPLIFIER BANK - 8 CANALES

- 1x Cap 10uF (bypass VDD baja freq)
- 1x Cap 1uF (bypass VDD alta freq) Total por banco: 8 ICs + 32 pasivos U35 PAM8302

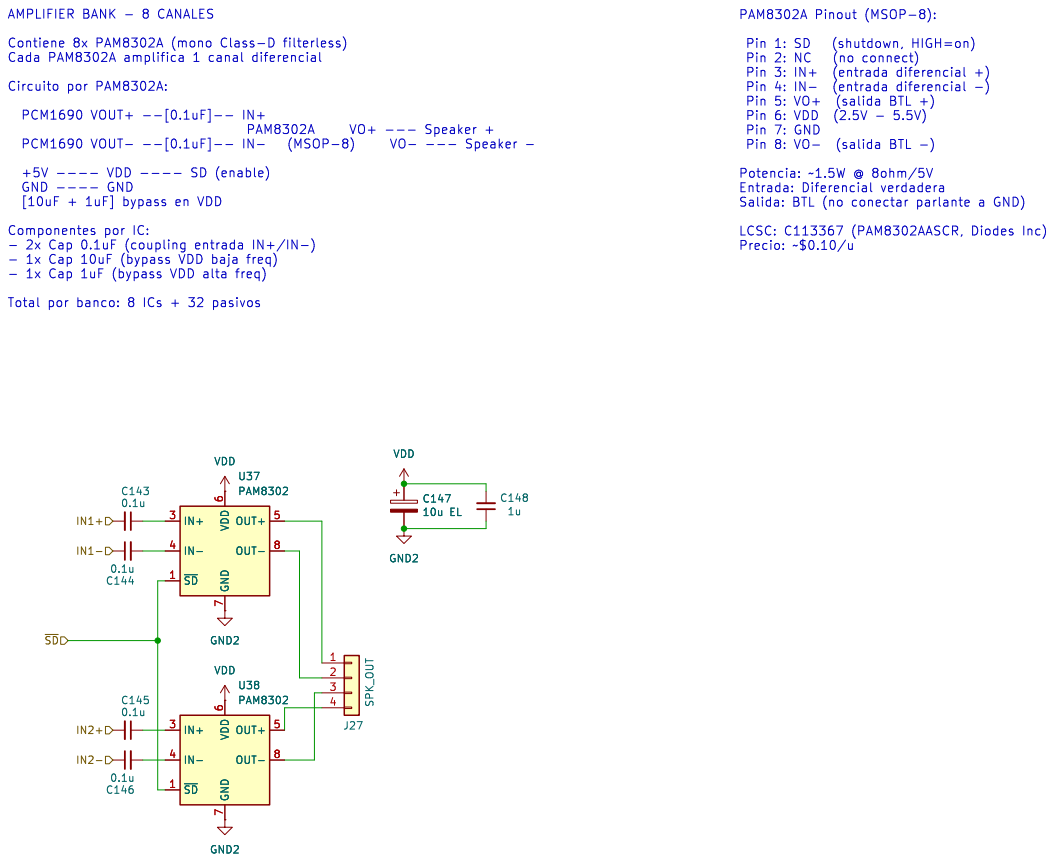
[picture p81: page 26]

LCSC: C113367 (PAM8302AASCR, Diodes Inc) Precio: ~$0.10/u AMPLIFIER BANK - 8 CANALES

- 1x Cap 10uF (bypass VDD baja freq)
- 1x Cap 1uF (bypass VDD alta freq) Total por banco: 8 ICs + 32 pasivos U37 PAM8302

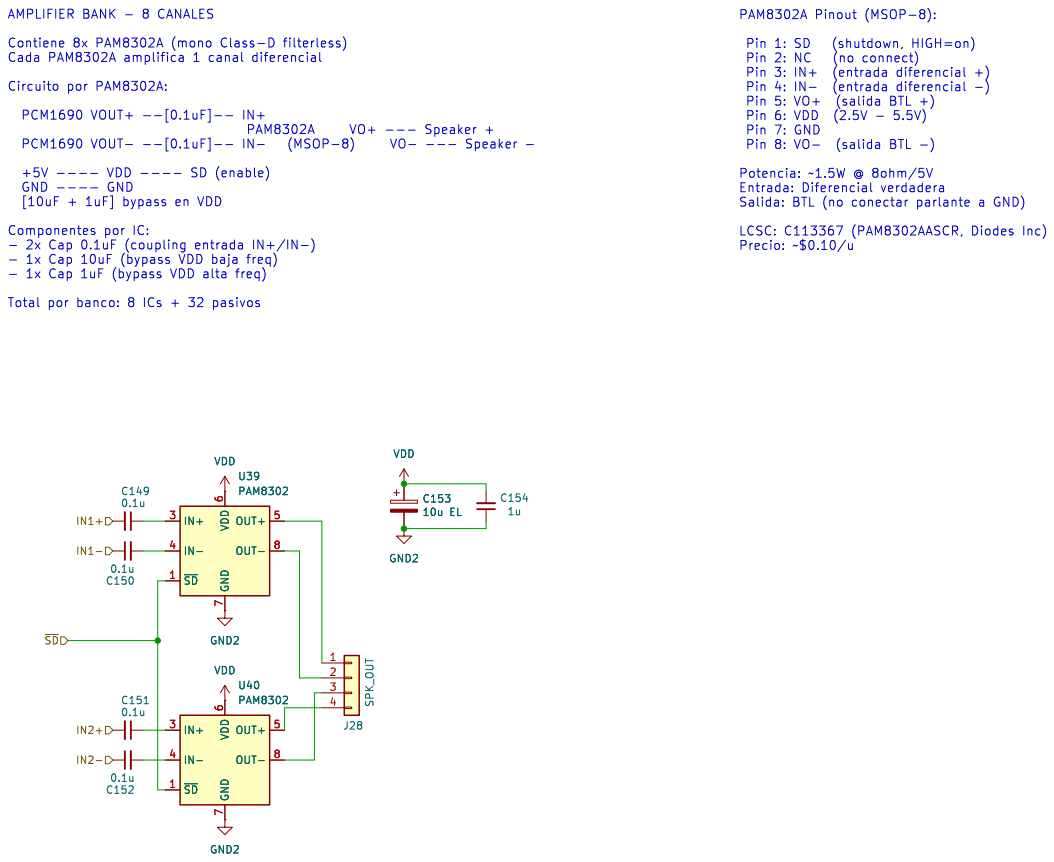
[picture p82: page 27]

LCSC: C113367 (PAM8302AASCR, Diodes Inc) Precio: ~$0.10/u AMPLIFIER BANK - 8 CANALES

- 1x Cap 10uF (bypass VDD baja freq)
- 1x Cap 1uF (bypass VDD alta freq) Total por banco: 8 ICs + 32 pasivos U39 PAM8302

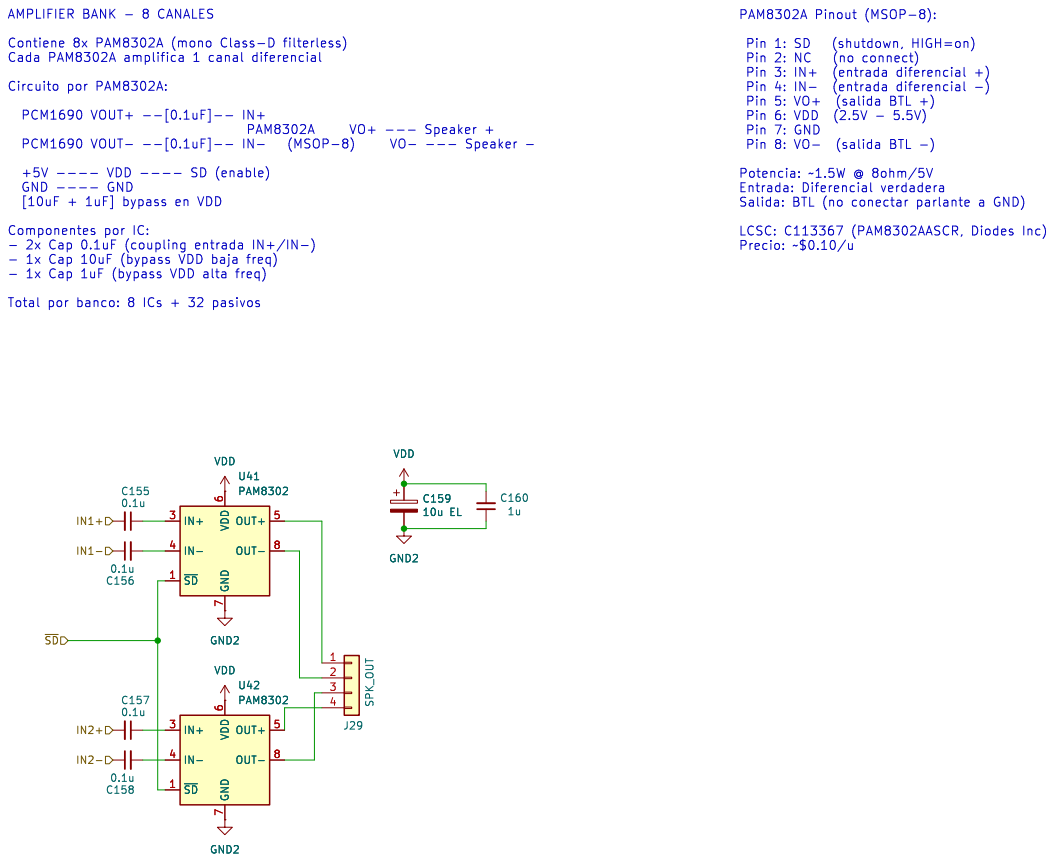
[picture p83: page 28]

LCSC: C113367 (PAM8302AASCR, Diodes Inc) Precio: ~$0.10/u AMPLIFIER BANK - 8 CANALES

- 1x Cap 10uF (bypass VDD baja freq)
- 1x Cap 1uF (bypass VDD alta freq) Total por banco: 8 ICs + 32 pasivos U41 PAM8302

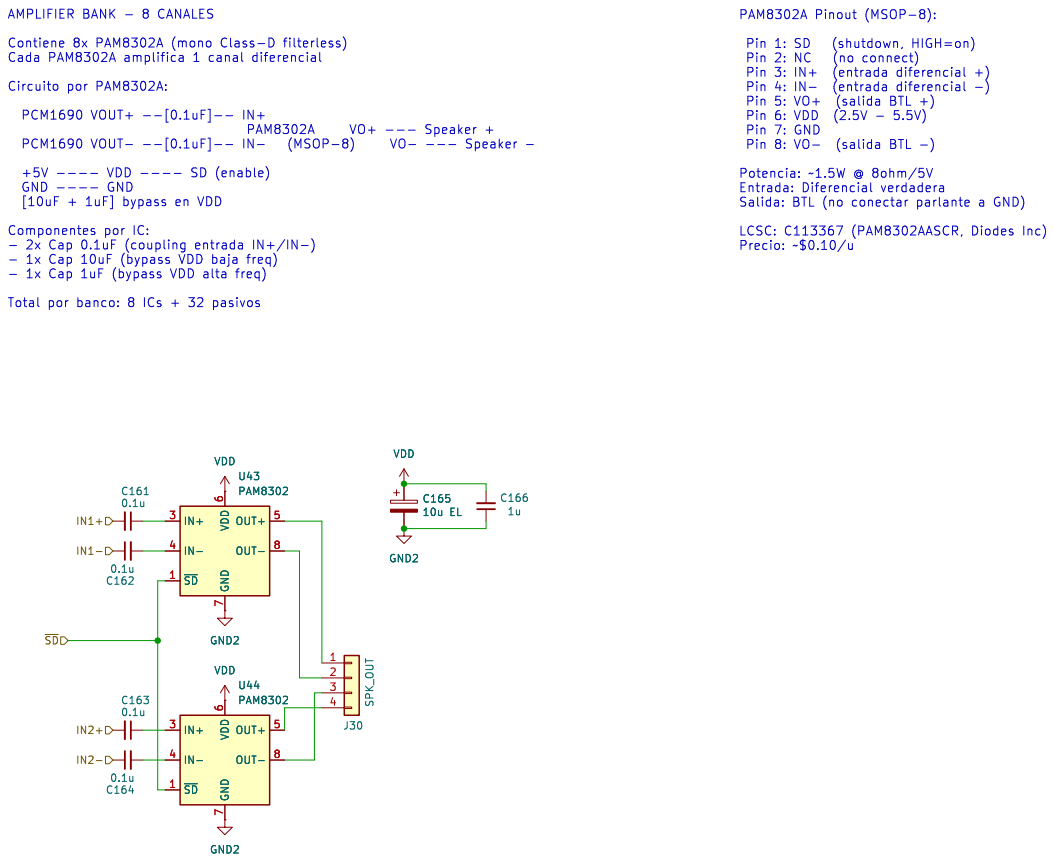
[picture p84: page 29]

LCSC: C113367 (PAM8302AASCR, Diodes Inc) Precio: ~$0.10/u AMPLIFIER BANK - 8 CANALES

- 1x Cap 10uF (bypass VDD baja freq)
- 1x Cap 1uF (bypass VDD alta freq) Total por banco: 8 ICs + 32 pasivos U43 PAM8302
