bergamifer/DS-Project/hardware/DS/plots_png_600/_pdf/DS-F_Silkscreen.pdf

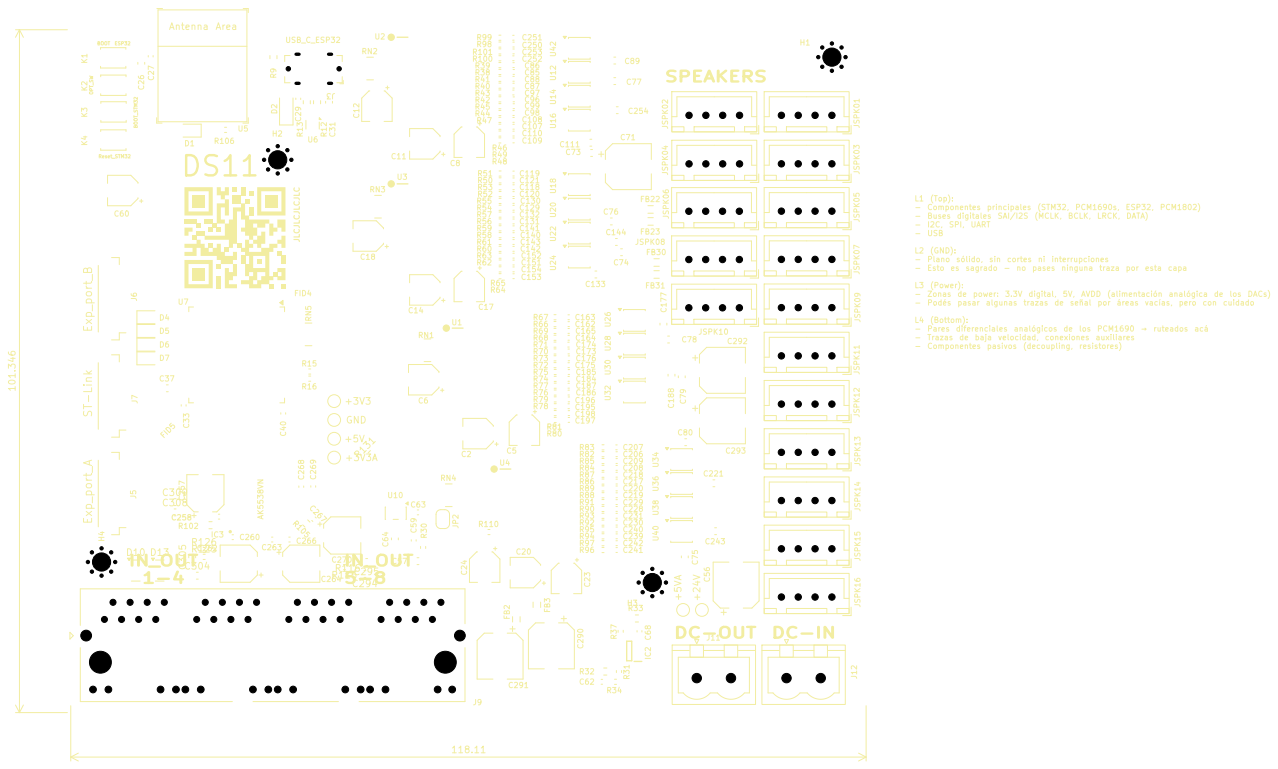
[picture p85: page 1]

L4 (Bottom): - Pares diferenciales analógicos de los PCM1690 → ruteados acá - Trazas de baja velocidad, conexiones auxiliares - Componentes pasivos (decoupling, resistores) JLCJLCJLCJLC

L1 (Top): - Componentes principales (STM32, PCM1690s, ESP32, PCM1802) - Buses digitales SAI/I2S (MCLK, BCLK, LRCK, DATA) - I2C, SPI, UART - USB

L2 (GND): - Plano sólido, sin cortes ni interrupciones - Esto es sagrado - no pases ninguna traza por esta capa

L3 (Power): - Zonas de power: 3.3V digital, 5V, AVDD (alimentación analógica de los DACs) - Podés pasar algunas trazas de señal por áreas vacías, pero con cuidado

DC-OUT DC-IN
