bergamifer/DS-Project/hardware/DS/plot/print.pdf

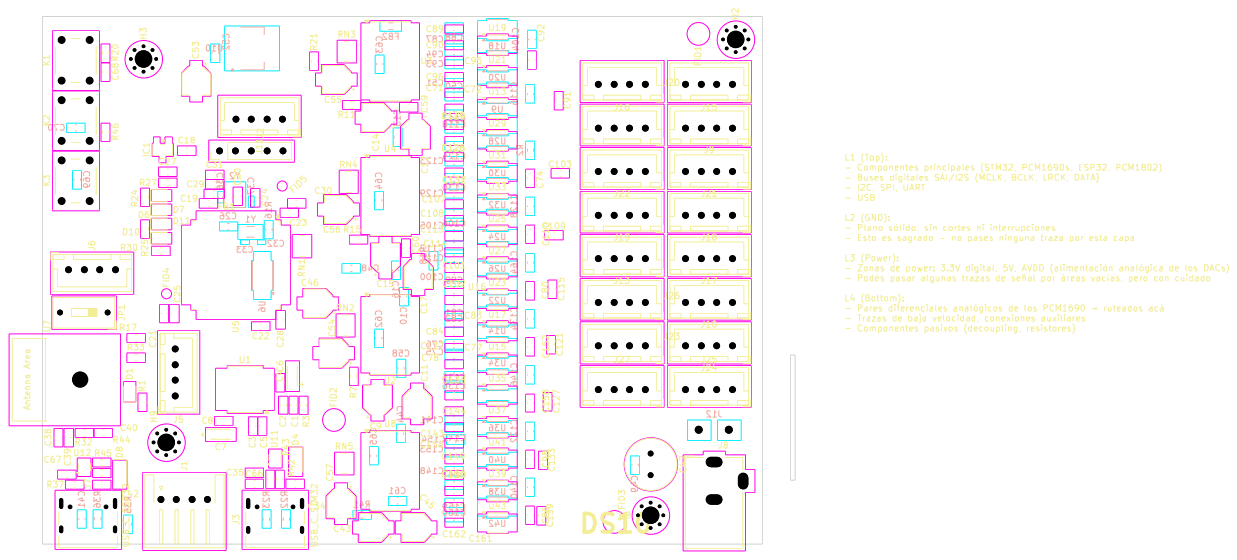
[picture p86: page 1]
