bergamifer/DS-Project/hardware/DS/plots_png_600/_pdf/DS-B_Cu.pdf

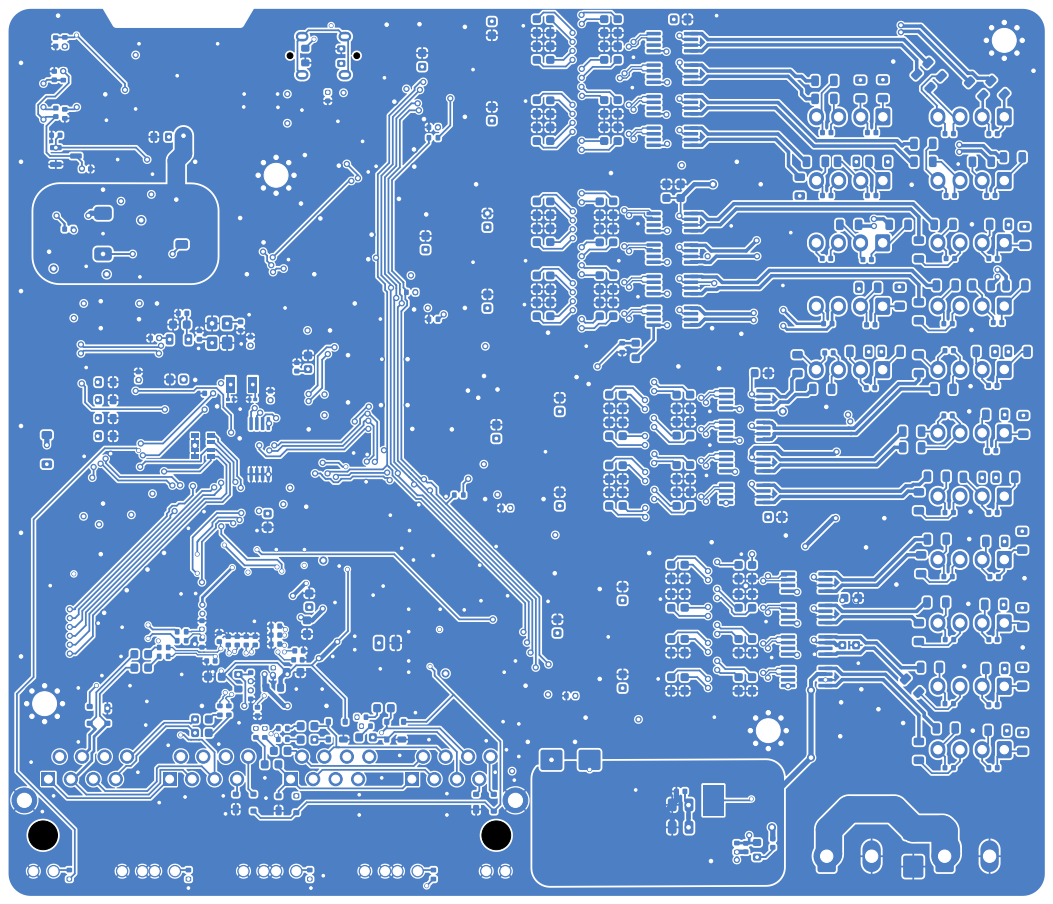
[picture p87: page 1]
