bergamifer/DS-Project/hardware/DS/plots_png_600/_pdf/DS-B_Mask.pdf

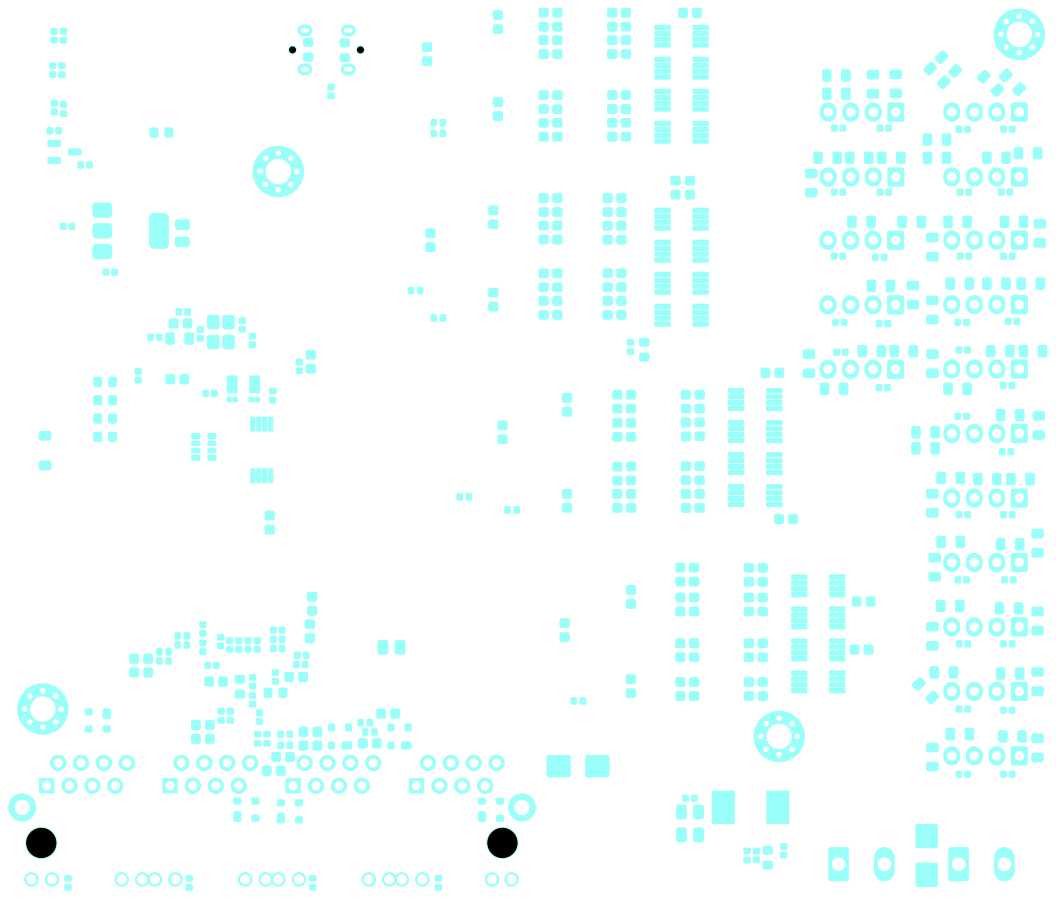
[picture p88: page 1]
