bergamifer/DS-Project/hardware/DS/plots_png_600/_pdf/DS-B_Paste.pdf

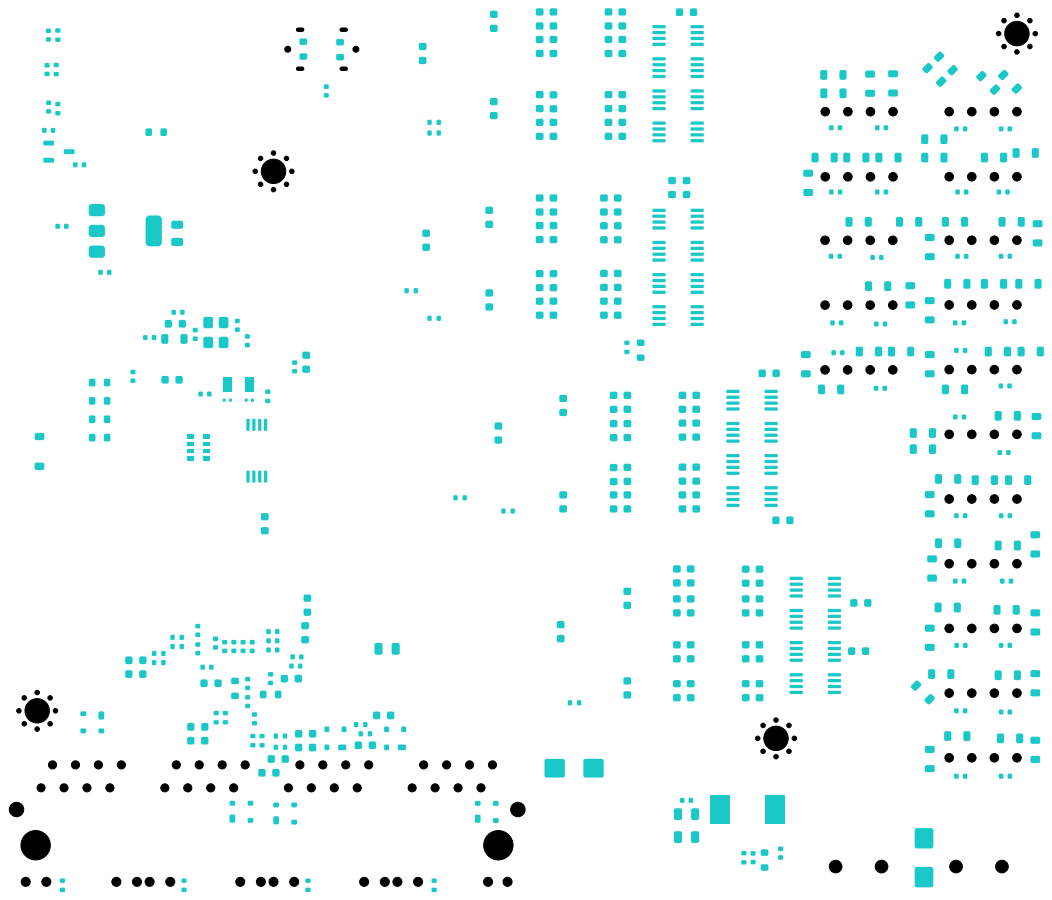
[picture p89: page 1]
