bergamifer/DS-Project/hardware/DS/plots_png_600/_pdf/DS-B_Silkscreen.pdf

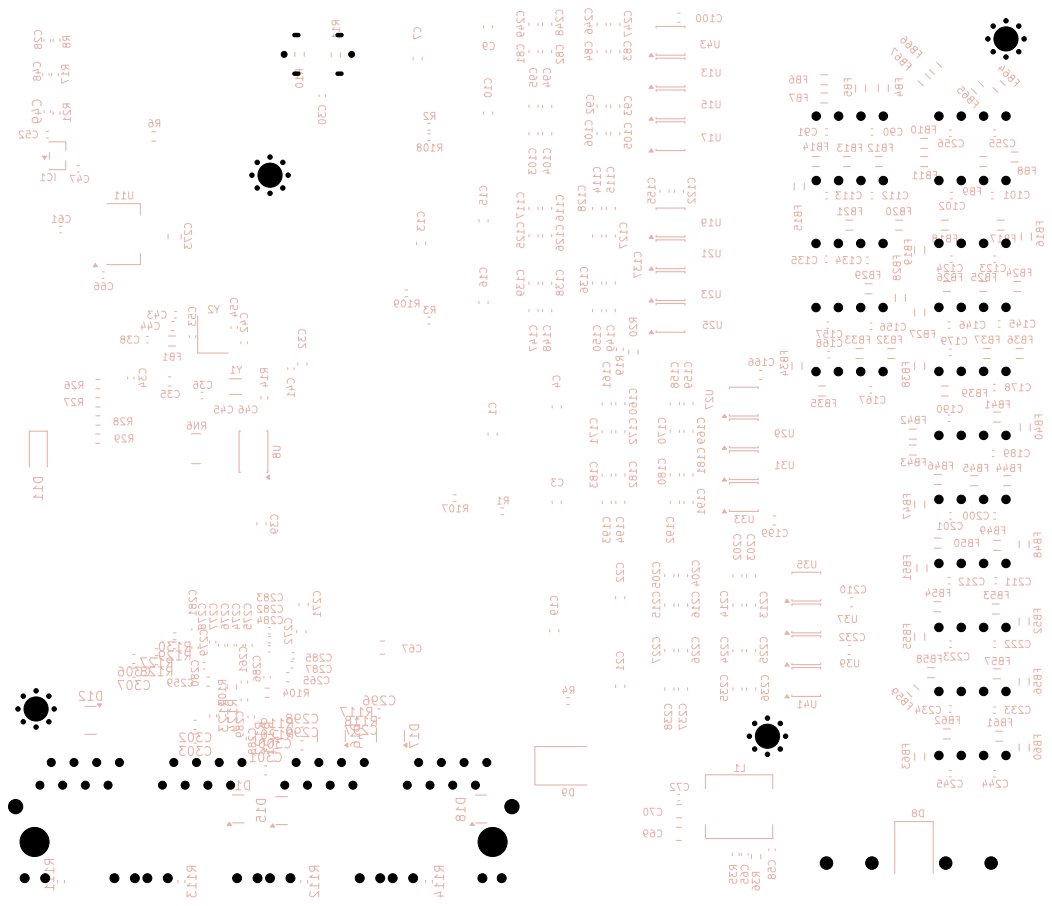
[picture p90: page 1]
