bergamifer/DS-Project/hardware/DS/plots_png_600/_pdf/DS-Edge_Cuts.pdf

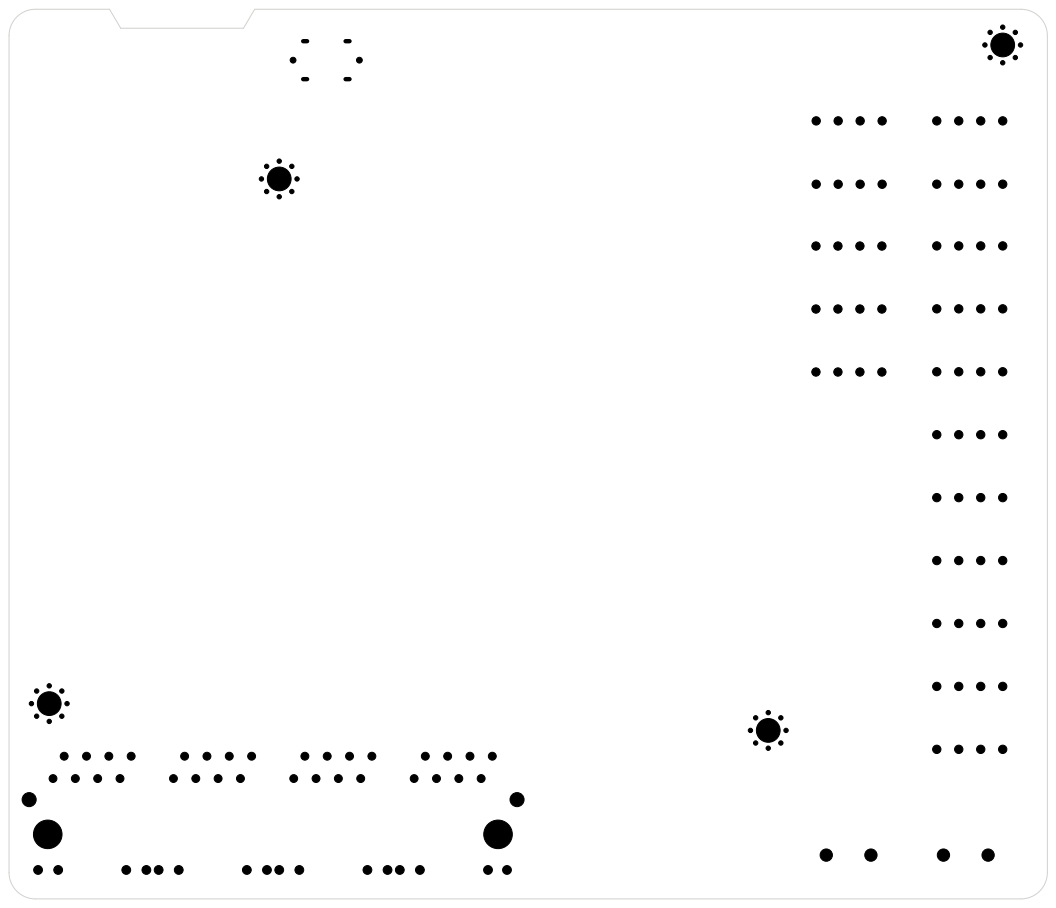
[picture p91: page 1]
