bergamifer/DS-Project/hardware/DS/plots_png_600/_pdf/DS-F_Cu.pdf

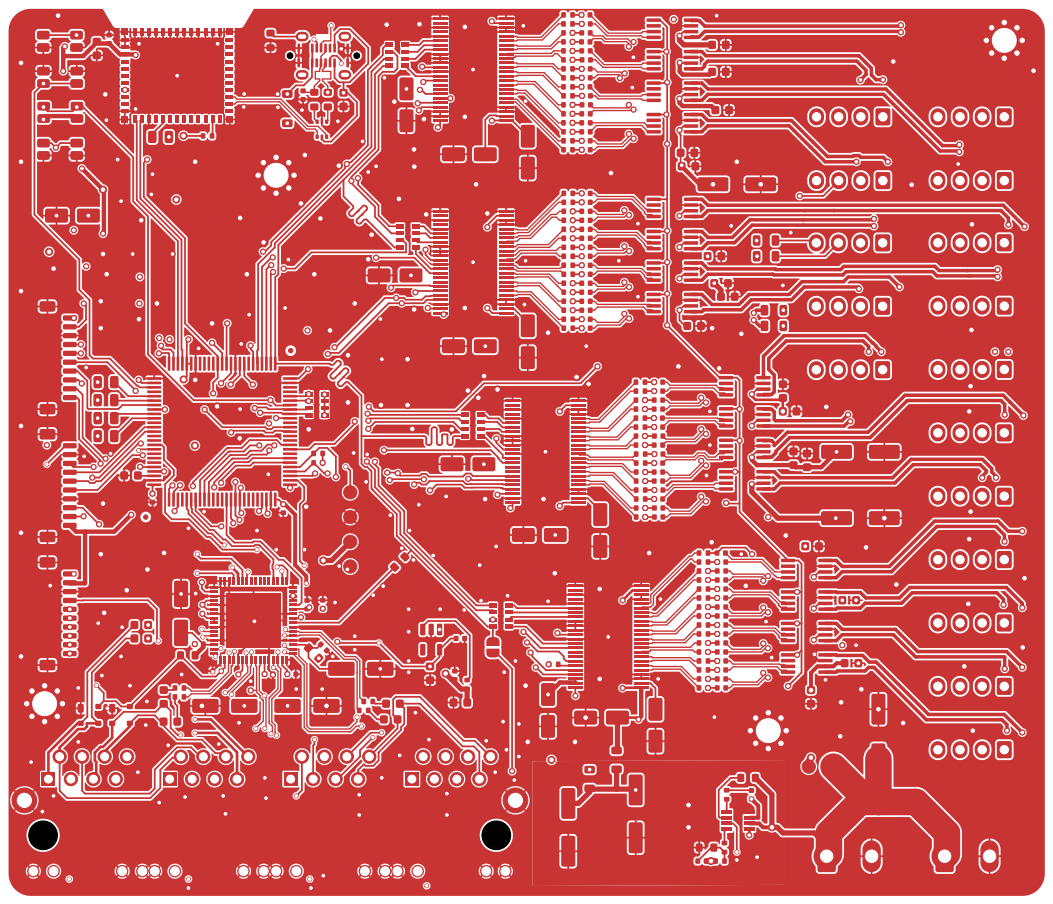
[picture p92: page 1]
