bergamifer/DS-Project/hardware/DS/plots_png_600/_pdf/DS-F_Mask.pdf

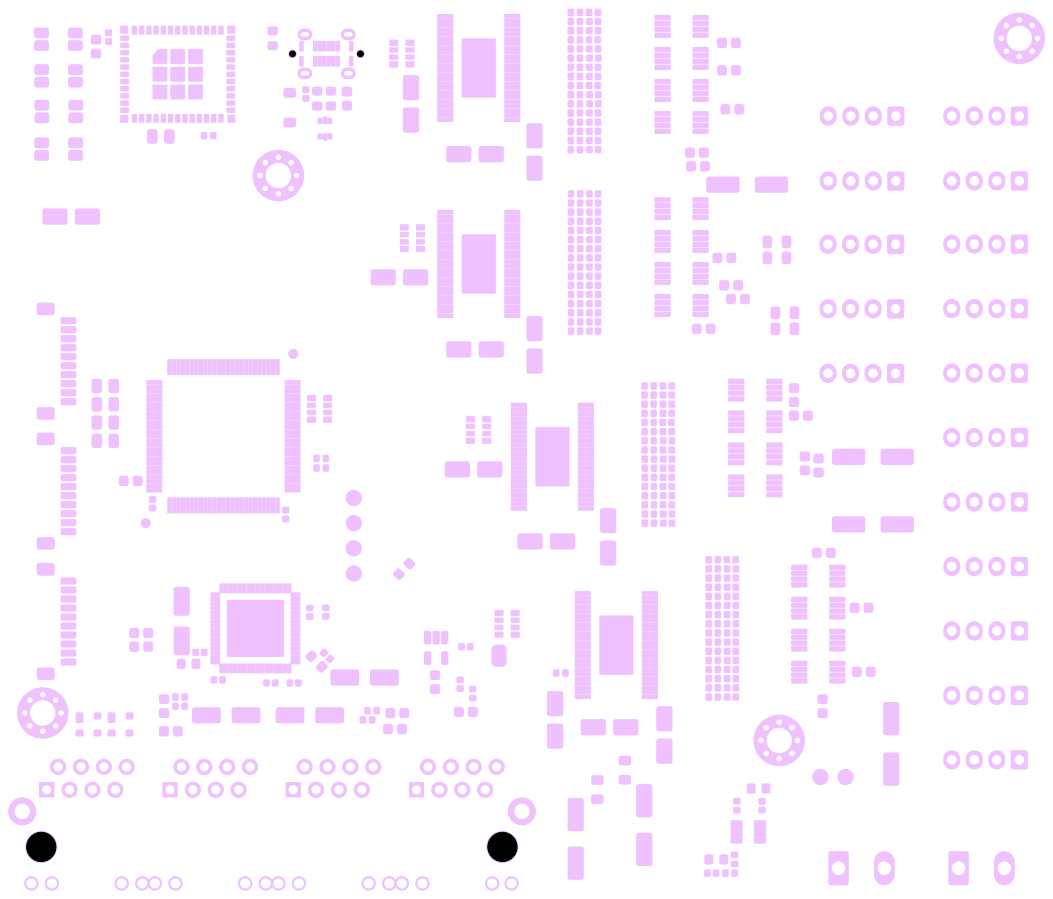
[picture p93: page 1]
