bergamifer/DS-Project/hardware/DS/plots_png_600/_pdf/DS-F_Paste.pdf

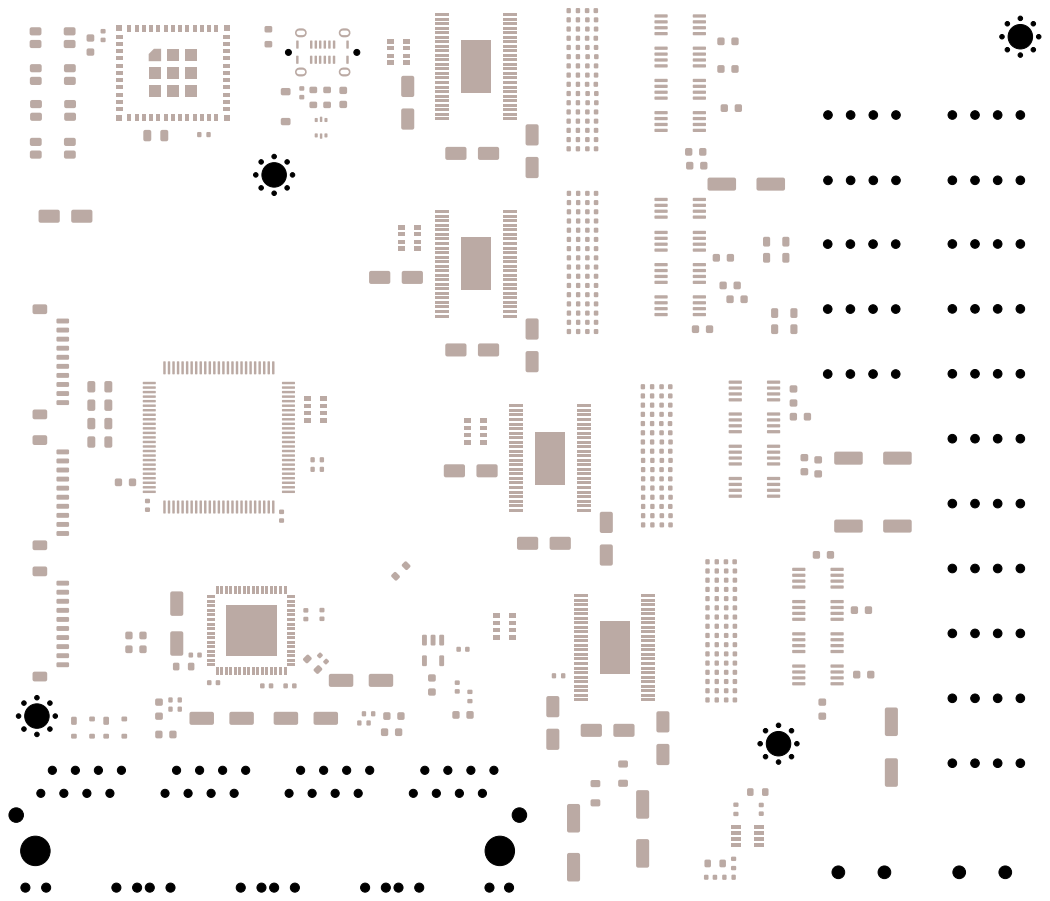
[picture p94: page 1]
