bergamifer/DS-Project/hardware/DS/plots_png_600/_pdf/DS-In1_Cu.pdf

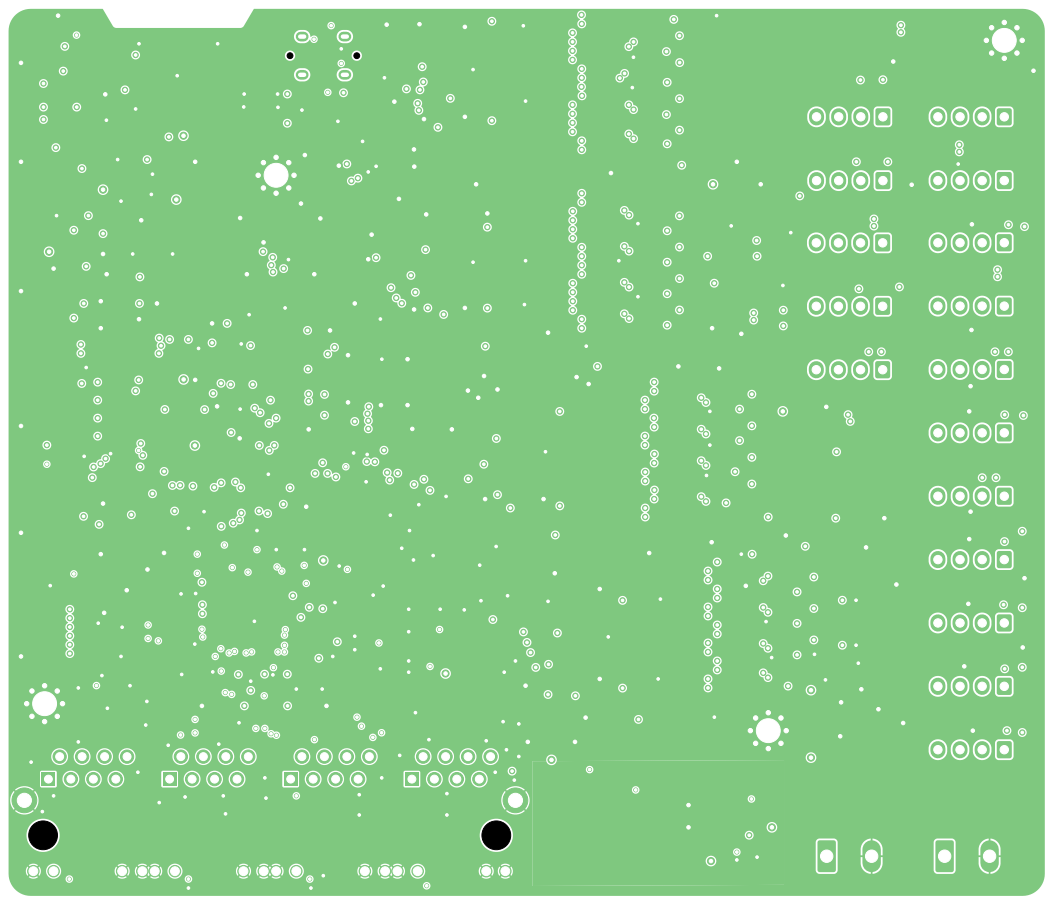
[picture p95: page 1]
