bergamifer/DS-Project/hardware/DS/plots_png_600/_pdf/DS-In2_Cu.pdf

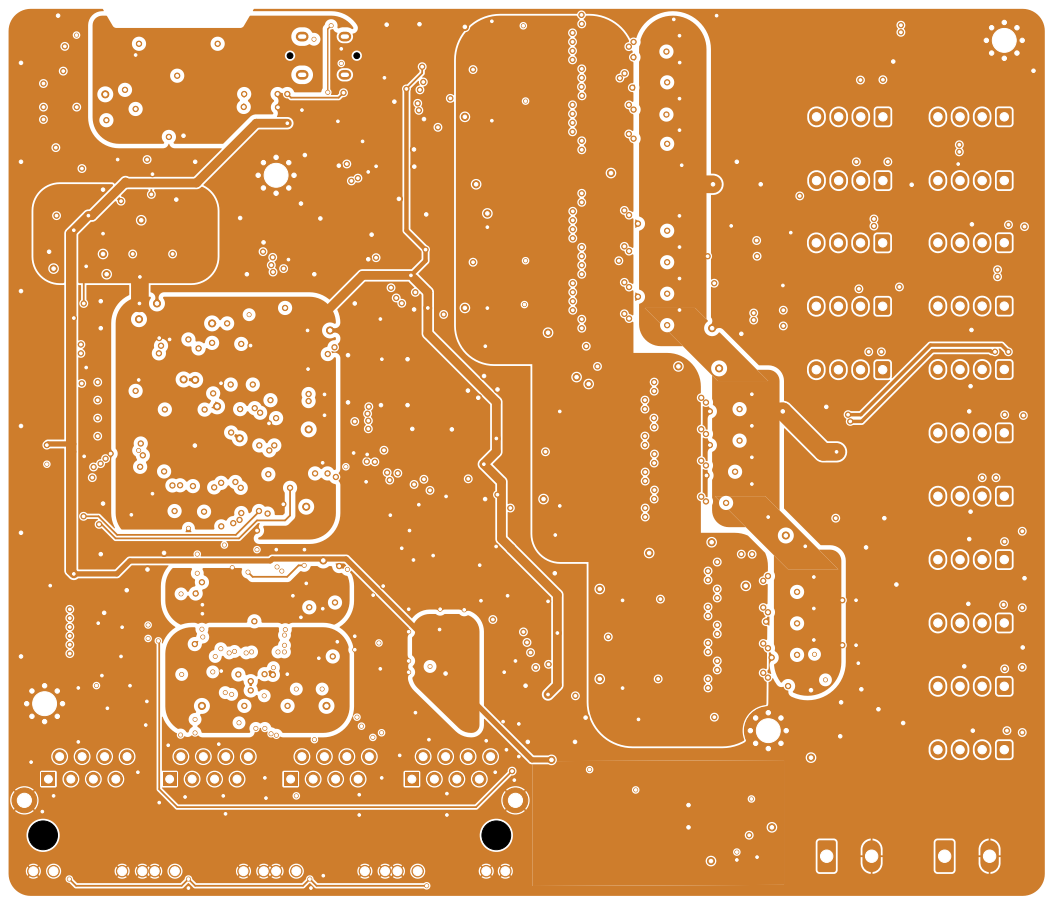
[picture p96: page 1]
