bergamifer/DS-Project/(list of files, drawings)

Other design files:
hardware/DS/librerias/LIB_AK5538VN/AK5538VN/Altium/AK5538VN.SchLib
hardware/DS/librerias/LIB_AK5538VN/AK5538VN/Altium/QFN50P900X900X100-65N.PcbLib
hardware/DS/librerias/LIB_MP2315SGJ-P/MP2315SGJ-P/Altium/MP2315SGJ-P.SchLib
hardware/DS/librerias/LIB_MP2315SGJ-P/MP2315SGJ-P/Altium/SOT65P280X100-8N.PcbLib
