bergamifer/DS-Project/hardware/DS/DS.kicad_pcb

## KiCad design hardware/DS/DS.kicad_pcb (2026-09-29)

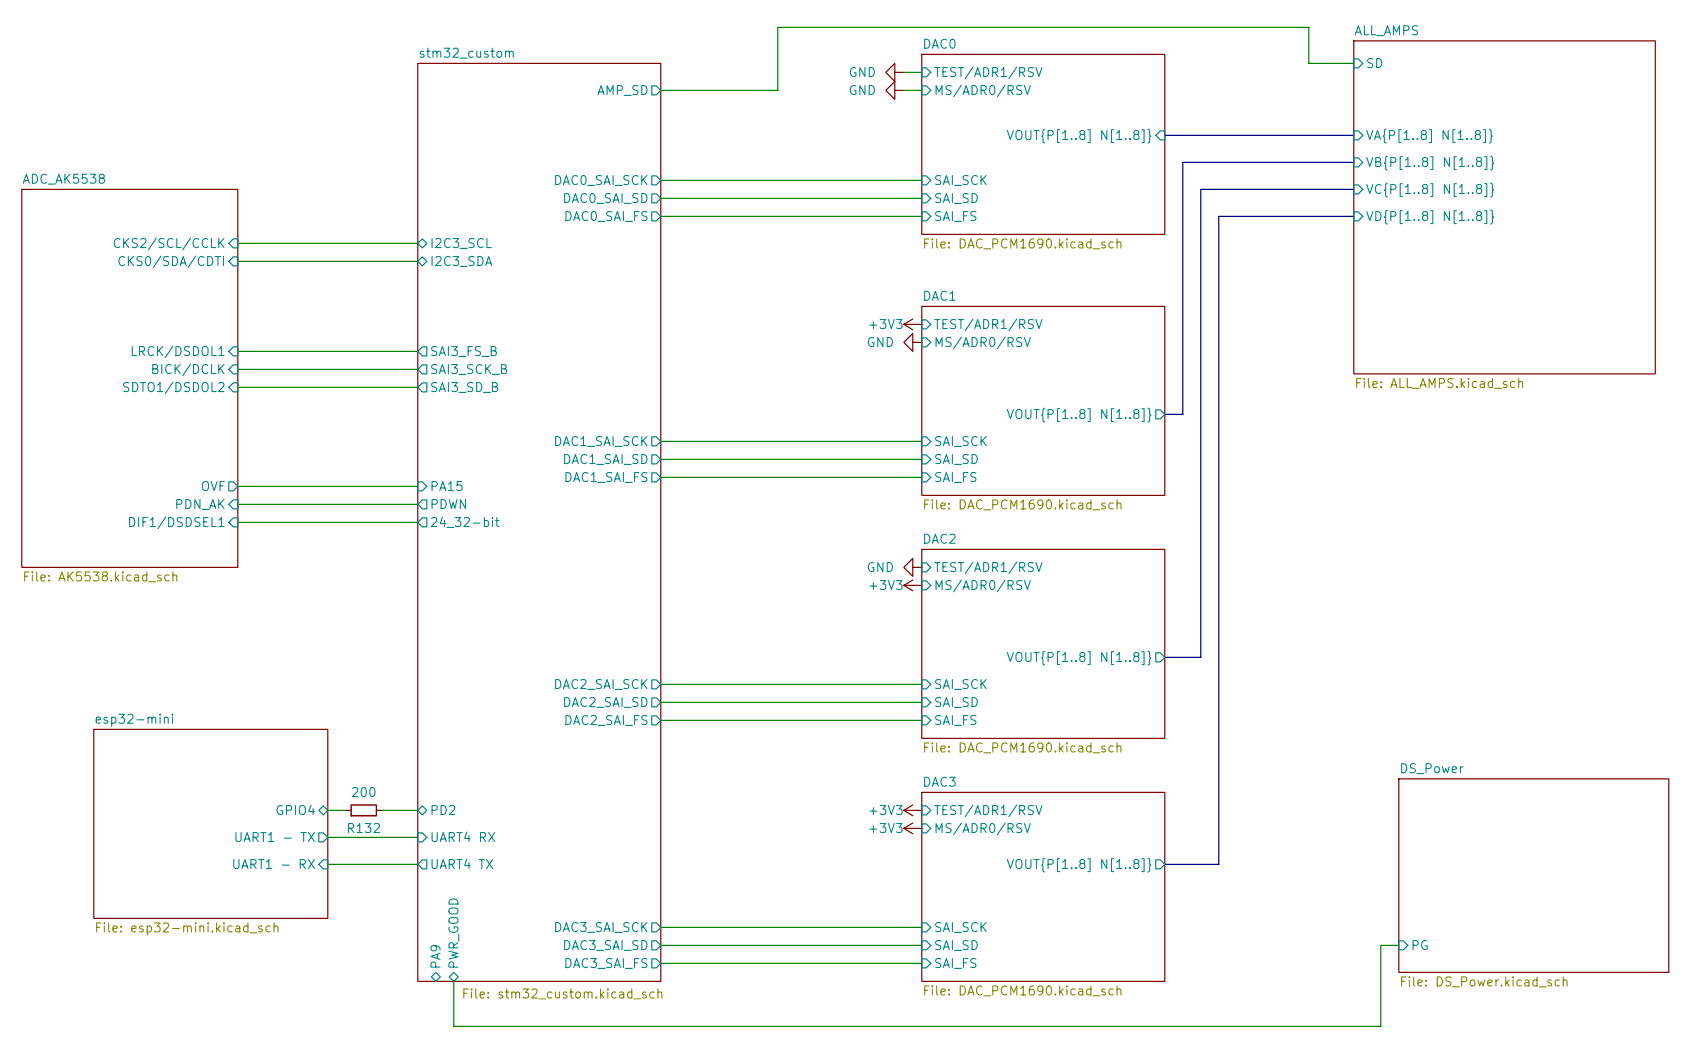
[picture p97: schematic DS.kicad_sch, Master DS11]

Parts:
R132: 200; R_0603_1608Metric; Mouser part 594-MCT06030C1200FP5

Connections:
/esp32-mini/GPIO8: R132.1; also elsewhere on the board
/stm32_custom/PC13: R132.2; also elsewhere on the board

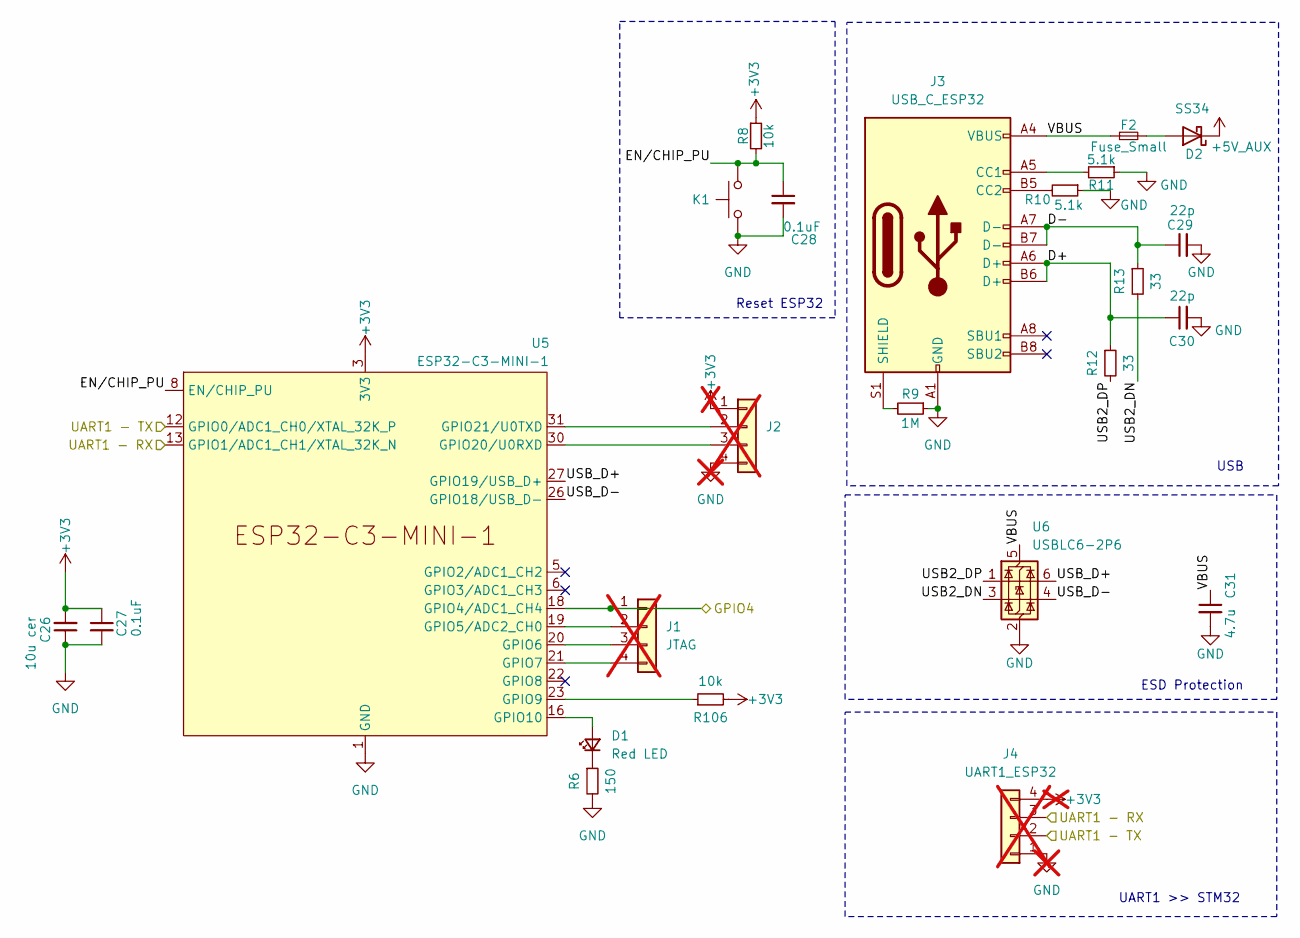
[picture p98: schematic esp32-mini.kicad_sch, ESP32]

Parts:
C26: 10u cer; C_0603_1608Metric; Mouser part 187-CL10A106MA8NRWC
C27, C28: 0.1uF; C_0402_1005Metric; Mouser part 581-KGM15BR71E104KT
C29, C30: 22p; C_0402_1005Metric; Mouser part 581-KGM15ACG1E220JT
C31: 4.7u; C_0603_1608Metric; Mouser part 581-06036C475KAT2A
D1: Red LED; LED_0805_2012Metric; Mouser part 720-BPS2THVG2J8L55S
D2: SS34; D_SMA; Manufacturer_Part_Number SS14HE; LCSC C8678
F2: Fuse_Small; Fuse_1206_3216Metric; Manufacturer_Part_Number SMD1206P110TF/16; LCSC C523825
J1: JTAG; JST_XH_B4B-XH-A_1x04_P2.50mm_Vertical; Manufacturer_Part_Number B4B-XH-A; not fitted
J2: UART0_ESP32; JST_XH_B4B-XH-A_1x04_P2.50mm_Vertical; Manufacturer_Part_Number B4B-XH-A; LCSC C594232; not fitted
J3: USB_C_ESP32; USB_C_Receptacle_G-Switch_GT-USB-7051x; Mouser part 538-217179-0001
J4: UART1_ESP32; JST_XH_B4B-XH-A_1x04_P2.50mm_Vertical; Manufacturer_Part_Number B4B-XH-A; not fitted
K1: BOOT ESP32; SW_SPST_EVQP2_MiddlePushTravel_H2.5mm; Manufacturer_Part_Number TS-1185-W-4P-H1.8-160; LCSC C51927445
R6: 150; R_0603_1608Metric; Manufacturer_Part_Number 0603WAF1500T5E; LCSC C22808
R8, R106: 10k; R_0402_1005Metric; Mouser part 603-RC0603JR-1310KL
R9: 1M; R_0603_1608Metric; Mouser part 603-RC0603FR-131ML
R10, R11: 5.1k; R_0603_1608Metric; Mouser part 708-RMCF0603FT5K10
R12, R13: 33; R_0603_1608Metric; Mouser part 71-CRCW060333R0FKEAC
U5: ESP32-C3-MINI-1; Manufacturer_Part_Number ESP32-C3-MINI-1-N4; LCSC C2838502
U6: USBLC6-2P6; SOT-666; Manufacturer_Part_Number USBLC6-2P6; LCSC C15999

Connections:
+3V3: C26.2, C27.1, J2.1, J4.4, R8.1, R106.2, U5.3 (3V3); also elsewhere on the board
+5V_AUX: D2.1 (K); also elsewhere on the board
/esp32-mini/D+: C30.1, J3.A6 (D+), J3.B6 (D+), R12.1
/esp32-mini/D-: C29.1, J3.A7 (D-), J3.B7 (D-), R13.1
/esp32-mini/EN/CHIP_PU: C28.1, K1.2, R8.2, U5.8 (EN/CHIP_PU)
/esp32-mini/GPIO8: U5.22 (GPIO8); also elsewhere on the board
/esp32-mini/UART1 - RX: J4.3, U5.13 (GPIO1/ADC1_CH1/XTAL_32K_N); also elsewhere on the board
/esp32-mini/UART1 - TX: J4.2, U5.12 (GPIO0/ADC1_CH0/XTAL_32K_P); also elsewhere on the board
/esp32-mini/USB2_DN: R13.2, U6.3 (I/O2)
/esp32-mini/USB2_DP: R12.2, U6.1 (I/O1)
/esp32-mini/USB_D+: U5.27 (GPIO19/USB_D+), U6.6 (I/O1)
/esp32-mini/USB_D-: U5.26 (GPIO18/USB_D-), U6.4 (I/O2)
/esp32-mini/VBUS: C31.1, F2.1, J3.A4 (VBUS), J3.A9 (VBUS), J3.B4 (VBUS), J3.B9 (VBUS), U6.5 (VBUS)
GND: C26.1, C27.2, C28.2, C29.2, C30.2, C31.2, J2.4, J3.A1 (GND), J3.A12 (GND), J3.B1 (GND), J3.B12 (GND), J4.1, K1.1, R6.2, R9.1, R10.1, R11.1, U5.1 (GND), U5.2 (GND), U5.11 (GND), U5.14 (GND), U5.36 (GND), U5.37 (GND), U5.38 (GND), U5.39 (GND), U5.40 (GND), U5.41 (GND), U5.42 (GND), U5.43 (GND), U5.44 (GND), U5.45 (GND), U5.46 (GND), U5.47 (GND), U5.48 (GND), U5.49 (GND), U5.50 (GND), U5.51 (GND), U5.52 (GND), U5.53 (GND), U6.2 (GND); also elsewhere on the board
unnamed: D1.2 (A), U5.16 (GPIO10)
unnamed: D1.1 (K), R6.1
unnamed: D2.2 (A), F2.2
unnamed: J3.A5 (CC1), R11.2
unnamed: J3.B5 (CC2), R10.2
unnamed: J3.S1 (SHIELD), R9.2
unnamed: J1.1, U5.18 (GPIO4/ADC1_CH4)
unnamed: J1.2, U5.19 (GPIO5/ADC2_CH0)
unnamed: J1.3, U5.20 (GPIO6)
unnamed: J1.4, U5.21 (GPIO7)
unnamed: R106.1, U5.23 (GPIO9)
unnamed: J2.3, U5.30 (GPIO20/U0RXD)
unnamed: J2.2, U5.31 (GPIO21/U0TXD)

Notes on the sheet:
Reset ESP32
ESD Protection
UART1 >> STM32
USB

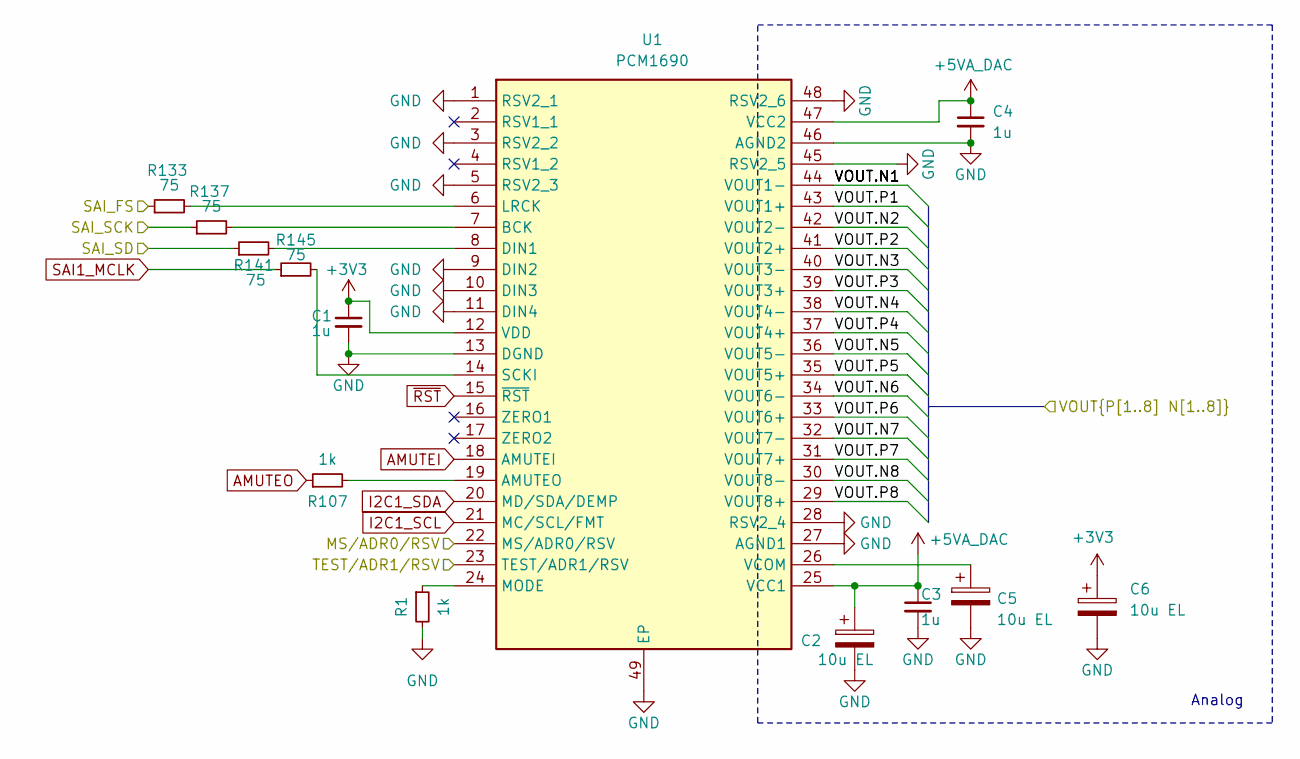
[picture p99: schematic DAC_PCM1690.kicad_sch, Conversores DAC PCM1690 8-channel]

Parts:
C1, C3, C4: 1u; C_0603_1608Metric; Mouser part 791-0603B105M160CT
C2, C5, C6: 10u EL; CP_Elec_4x5.7; Manufacturer_Part_Number AEC-SMD-10UF-50V; LCSC C134745
R1, R107: 1k; R_0402_1005Metric; Manufacturer_Part_Number CRCW06031K00FKEA; LCSC C11702
R133, R137, R141, R145: 75; R_0603_1608Metric; Manufacturer_Part_Number 0603WAF750JT5E; LCSC C4275
U1: PCM1690; SOP50P810X120-49N; Mouser part 595-PCM1690DCAR

Connections:
+3V3: C1.1, C6.1, U1.12 (VDD), U1.22 (MS/ADR0/RSV); also elsewhere on the board
+5VA_DAC: C2.1, C3.1, C4.1, U1.25 (VCC1), U1.47 (VCC2); also elsewhere on the board
/ALL_AMPS/VC.N1: U1.44 (VOUT1-); also elsewhere on the board
/ALL_AMPS/VC.N2: U1.42 (VOUT2-); also elsewhere on the board
/ALL_AMPS/VC.N3: U1.40 (VOUT3-); also elsewhere on the board
/ALL_AMPS/VC.N4: U1.38 (VOUT4-); also elsewhere on the board
/ALL_AMPS/VC.N5: U1.36 (VOUT5-); also elsewhere on the board
/ALL_AMPS/VC.N6: U1.34 (VOUT6-); also elsewhere on the board
/ALL_AMPS/VC.N7: U1.32 (VOUT7-); also elsewhere on the board
/ALL_AMPS/VC.N8: U1.30 (VOUT8-); also elsewhere on the board
/ALL_AMPS/VC.P1: U1.43 (VOUT1+); also elsewhere on the board
/ALL_AMPS/VC.P2: U1.41 (VOUT2+); also elsewhere on the board
/ALL_AMPS/VC.P3: U1.39 (VOUT3+); also elsewhere on the board
/ALL_AMPS/VC.P4: U1.37 (VOUT4+); also elsewhere on the board
/ALL_AMPS/VC.P5: U1.35 (VOUT5+); also elsewhere on the board
/ALL_AMPS/VC.P6: U1.33 (VOUT6+); also elsewhere on the board
/ALL_AMPS/VC.P7: U1.31 (VOUT7+); also elsewhere on the board
/ALL_AMPS/VC.P8: U1.29 (VOUT8+); also elsewhere on the board
/DAC2/SAI_FS: R133.1; also elsewhere on the board
/DAC2/SAI_SCK: R137.1; also elsewhere on the board
/DAC2/SAI_SD: R141.1; also elsewhere on the board
AMUTEI: U1.18 (AMUTEI); also elsewhere on the board
AMUTEO: R107.1; also elsewhere on the board
GND: C1.2, C2.2, C3.2, C4.2, C5.2, C6.2, R1.2, U1.1 (RSV2_1), U1.3 (RSV2_2), U1.5 (RSV2_3), U1.9 (DIN2), U1.10 (DIN3), U1.11 (DIN4), U1.13 (DGND), U1.23 (TEST/ADR1/RSV), U1.27 (AGND1), U1.28 (RSV2_4), U1.45 (RSV2_5), U1.46 (AGND2), U1.48 (RSV2_6), U1.49 (EP); also elsewhere on the board
I2C1_SCL: U1.21 (MC/SCL/FMT); also elsewhere on the board
I2C1_SDA: U1.20 (MD/SDA/DEMP); also elsewhere on the board
unnamed: R107.2, U1.19 (AMUTEO)
unnamed: R137.2, U1.7 (BCK)
unnamed: R141.2, U1.8 (DIN1)
unnamed: R133.2, U1.6 (LRCK)
unnamed: R1.1, U1.24 (MODE)
unnamed: R145.2, U1.14 (SCKI)
unnamed: C5.1, U1.26 (VCOM)
SAI1_MCLK: R145.1; also elsewhere on the board
~RST: U1.15 (~RST); also elsewhere on the board

Parts of its further copies:
C7, C9, C10, C13, C15, C16, C19, C21, C22: 1u; C_0603_1608Metric; Mouser part 791-0603B105M160CT
C8, C11, C12, C14, C17, C18, C20, C23, C24: 10u EL; CP_Elec_4x5.7; Manufacturer_Part_Number AEC-SMD-10UF-50V; LCSC C134745
R2, R3, R4, R108, R109, R110: 1k; R_0402_1005Metric; Manufacturer_Part_Number CRCW06031K00FKEA; LCSC C11702
R134, R135, R136, R138, R139, R140, R142, R143, R144, R146, R147, R148: 75; R_0603_1608Metric; Manufacturer_Part_Number 0603WAF750JT5E; LCSC C4275
U2, U3, U4: PCM1690; SOP50P810X120-49N; Mouser part 595-PCM1690DCAR

Connections of its further copies:
+3V3: C7.1, C12.1, C13.1, C18.1, C19.1, C24.1, U2.12 (VDD), U3.12 (VDD), U3.23 (TEST/ADR1/RSV), U4.12 (VDD), U4.22 (MS/ADR0/RSV), U4.23 (TEST/ADR1/RSV); also elsewhere on the board
+5VA_DAC: C8.1, C9.1, C10.1, C14.1, C15.1, C16.1, C20.1, C21.1, C22.1, U2.25 (VCC1), U2.47 (VCC2), U3.25 (VCC1), U3.47 (VCC2), U4.25 (VCC1), U4.47 (VCC2); also elsewhere on the board
/ALL_AMPS/VA.N1: U2.44 (VOUT1-); also elsewhere on the board
/ALL_AMPS/VA.N2: U2.42 (VOUT2-); also elsewhere on the board
/ALL_AMPS/VA.N3: U2.40 (VOUT3-); also elsewhere on the board
/ALL_AMPS/VA.N4: U2.38 (VOUT4-); also elsewhere on the board
/ALL_AMPS/VA.N5: U2.36 (VOUT5-); also elsewhere on the board
/ALL_AMPS/VA.N6: U2.34 (VOUT6-); also elsewhere on the board
/ALL_AMPS/VA.N7: U2.32 (VOUT7-); also elsewhere on the board
/ALL_AMPS/VA.N8: U2.30 (VOUT8-); also elsewhere on the board
/ALL_AMPS/VA.P1: U2.43 (VOUT1+); also elsewhere on the board
/ALL_AMPS/VA.P2: U2.41 (VOUT2+); also elsewhere on the board
/ALL_AMPS/VA.P3: U2.39 (VOUT3+); also elsewhere on the board
/ALL_AMPS/VA.P4: U2.37 (VOUT4+); also elsewhere on the board
/ALL_AMPS/VA.P5: U2.35 (VOUT5+); also elsewhere on the board
/ALL_AMPS/VA.P6: U2.33 (VOUT6+); also elsewhere on the board
/ALL_AMPS/VA.P7: U2.31 (VOUT7+); also elsewhere on the board
/ALL_AMPS/VA.P8: U2.29 (VOUT8+); also elsewhere on the board
/ALL_AMPS/VB.N1: U3.44 (VOUT1-); also elsewhere on the board
/ALL_AMPS/VB.N2: U3.42 (VOUT2-); also elsewhere on the board
/ALL_AMPS/VB.N3: U3.40 (VOUT3-); also elsewhere on the board
/ALL_AMPS/VB.N4: U3.38 (VOUT4-); also elsewhere on the board
/ALL_AMPS/VB.N5: U3.36 (VOUT5-); also elsewhere on the board
/ALL_AMPS/VB.N6: U3.34 (VOUT6-); also elsewhere on the board
/ALL_AMPS/VB.N7: U3.32 (VOUT7-); also elsewhere on the board
/ALL_AMPS/VB.N8: U3.30 (VOUT8-); also elsewhere on the board
/ALL_AMPS/VB.P1: U3.43 (VOUT1+); also elsewhere on the board
/ALL_AMPS/VB.P2: U3.41 (VOUT2+); also elsewhere on the board
/ALL_AMPS/VB.P3: U3.39 (VOUT3+); also elsewhere on the board
/ALL_AMPS/VB.P4: U3.37 (VOUT4+); also elsewhere on the board
/ALL_AMPS/VB.P5: U3.35 (VOUT5+); also elsewhere on the board
/ALL_AMPS/VB.P6: U3.33 (VOUT6+); also elsewhere on the board
/ALL_AMPS/VB.P7: U3.31 (VOUT7+); also elsewhere on the board
/ALL_AMPS/VB.P8: U3.29 (VOUT8+); also elsewhere on the board
/ALL_AMPS/VD.N1: U4.44 (VOUT1-); also elsewhere on the board
/ALL_AMPS/VD.N2: U4.42 (VOUT2-); also elsewhere on the board
/ALL_AMPS/VD.N3: U4.40 (VOUT3-); also elsewhere on the board
/ALL_AMPS/VD.N4: U4.38 (VOUT4-); also elsewhere on the board
/ALL_AMPS/VD.N5: U4.36 (VOUT5-); also elsewhere on the board
/ALL_AMPS/VD.N6: U4.34 (VOUT6-); also elsewhere on the board
/ALL_AMPS/VD.N7: U4.32 (VOUT7-); also elsewhere on the board
/ALL_AMPS/VD.N8: U4.30 (VOUT8-); also elsewhere on the board
/ALL_AMPS/VD.P1: U4.43 (VOUT1+); also elsewhere on the board
/ALL_AMPS/VD.P2: U4.41 (VOUT2+); also elsewhere on the board
/ALL_AMPS/VD.P3: U4.39 (VOUT3+); also elsewhere on the board
/ALL_AMPS/VD.P4: U4.37 (VOUT4+); also elsewhere on the board
/ALL_AMPS/VD.P5: U4.35 (VOUT5+); also elsewhere on the board
/ALL_AMPS/VD.P6: U4.33 (VOUT6+); also elsewhere on the board
/ALL_AMPS/VD.P7: U4.31 (VOUT7+); also elsewhere on the board
/ALL_AMPS/VD.P8: U4.29 (VOUT8+); also elsewhere on the board
/DAC0/SAI_FS: R134.1, R135.1; also elsewhere on the board
/DAC0/SAI_SCK: R138.1, R139.1; also elsewhere on the board
/DAC0/SAI_SD: R142.1; also elsewhere on the board
/DAC1/SAI_SD: R143.1; also elsewhere on the board
/DAC2/SAI_FS: R136.1; also elsewhere on the board
/DAC2/SAI_SCK: R140.1; also elsewhere on the board
/DAC3/SAI_SD: R144.1; also elsewhere on the board
AMUTEI: U2.18 (AMUTEI), U3.18 (AMUTEI), U4.18 (AMUTEI); also elsewhere on the board
AMUTEO: R108.1, R109.1, R110.1; also elsewhere on the board
GND: C7.2, C8.2, C9.2, C10.2, C11.2, C12.2, C13.2, C14.2, C15.2, C16.2, C17.2, C18.2, C19.2, C20.2, C21.2, C22.2, C23.2, C24.2, R2.2, R3.2, R4.2, U2.1 (RSV2_1), U2.3 (RSV2_2), U2.5 (RSV2_3), U2.9 (DIN2), U2.10 (DIN3), U2.11 (DIN4), U2.13 (DGND), U2.22 (MS/ADR0/RSV), U2.23 (TEST/ADR1/RSV), U2.27 (AGND1), U2.28 (RSV2_4), U2.45 (RSV2_5), U2.46 (AGND2), U2.48 (RSV2_6), U2.49 (EP), U3.1 (RSV2_1), U3.3 (RSV2_2), U3.5 (RSV2_3), U3.9 (DIN2), U3.10 (DIN3), U3.11 (DIN4), U3.13 (DGND), U3.22 (MS/ADR0/RSV), U3.27 (AGND1), U3.28 (RSV2_4), U3.45 (RSV2_5), U3.46 (AGND2), U3.48 (RSV2_6), U3.49 (EP), U4.1 (RSV2_1), U4.3 (RSV2_2), U4.5 (RSV2_3), U4.9 (DIN2), U4.10 (DIN3), U4.11 (DIN4), U4.13 (DGND), U4.27 (AGND1), U4.28 (RSV2_4), U4.45 (RSV2_5), U4.46 (AGND2), U4.48 (RSV2_6), U4.49 (EP); also elsewhere on the board
I2C1_SCL: U2.21 (MC/SCL/FMT), U3.21 (MC/SCL/FMT), U4.21 (MC/SCL/FMT); also elsewhere on the board
I2C1_SDA: U2.20 (MD/SDA/DEMP), U3.20 (MD/SDA/DEMP), U4.20 (MD/SDA/DEMP); also elsewhere on the board
unnamed: R108.2, U2.19 (AMUTEO)
unnamed: R138.2, U2.7 (BCK)
unnamed: R142.2, U2.8 (DIN1)
unnamed: R134.2, U2.6 (LRCK)
unnamed: R2.1, U2.24 (MODE)
unnamed: R146.2, U2.14 (SCKI)
unnamed: C11.1, U2.26 (VCOM)
unnamed: R109.2, U3.19 (AMUTEO)
unnamed: R139.2, U3.7 (BCK)
unnamed: R143.2, U3.8 (DIN1)
unnamed: R135.2, U3.6 (LRCK)
unnamed: R3.1, U3.24 (MODE)
unnamed: R147.2, U3.14 (SCKI)
unnamed: C17.1, U3.26 (VCOM)
unnamed: R110.2, U4.19 (AMUTEO)
unnamed: R140.2, U4.7 (BCK)
unnamed: R144.2, U4.8 (DIN1)
unnamed: R136.2, U4.6 (LRCK)
unnamed: R4.1, U4.24 (MODE)
unnamed: R148.2, U4.14 (SCKI)
unnamed: C23.1, U4.26 (VCOM)
SAI1_MCLK: R146.1, R147.1, R148.1; also elsewhere on the board
~RST: U2.15 (~RST), U3.15 (~RST), U4.15 (~RST); also elsewhere on the board

Notes on the sheet:
Analog

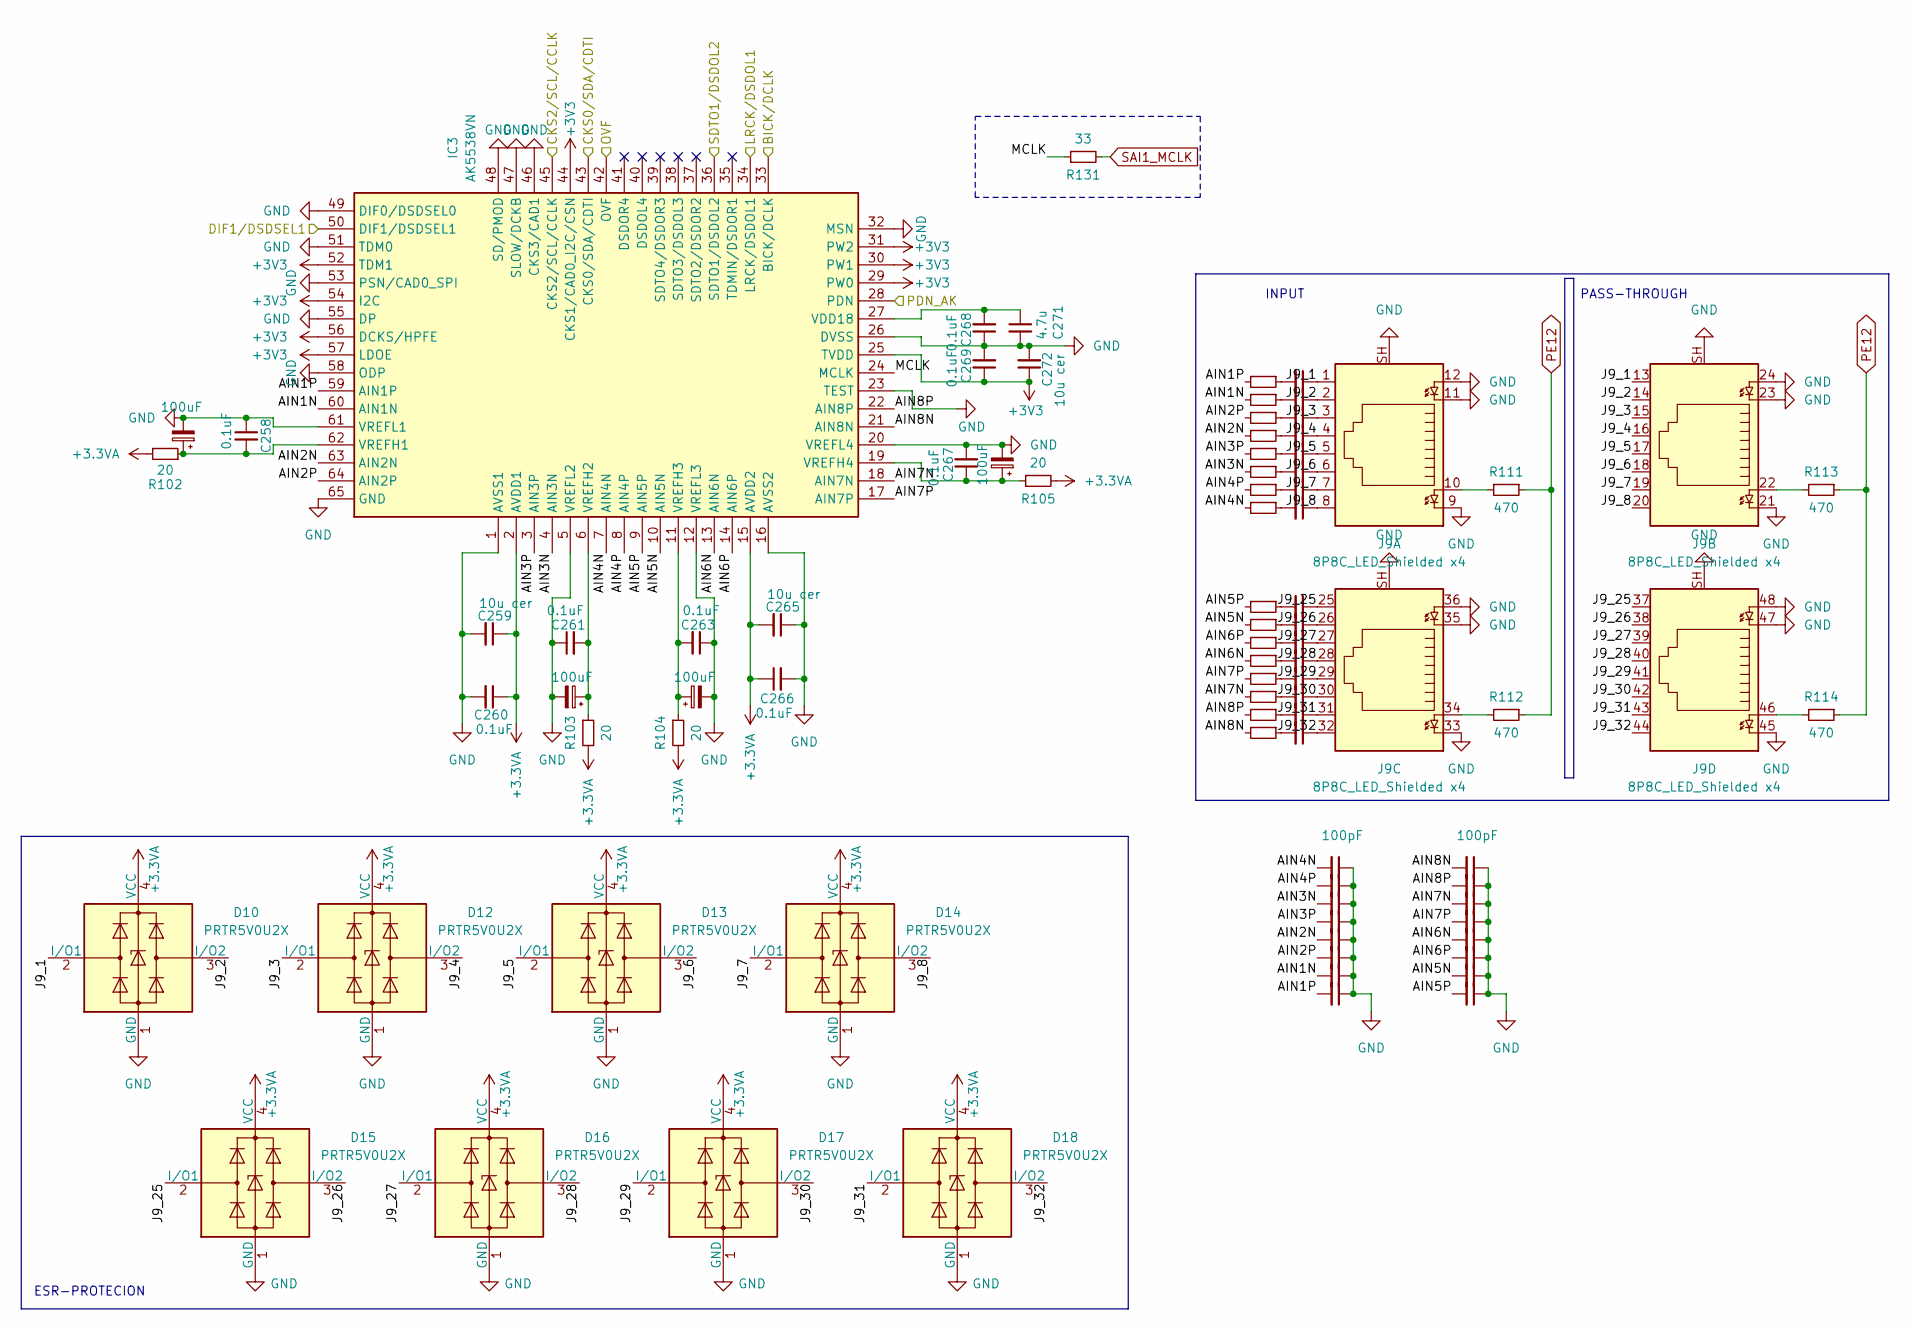
[picture p100: schematic AK5538.kicad_sch, ADC - Analog inputs]

Parts:
C257, C262, C264, C270: 100uF; CP_Elec_5x5.4; Manufacturer_Part_Number RVT1A101M0505; LCSC C18221491
C258, C260, C261, C263, C266, C267, C268, C269: 0.1uF; C_0402_1005Metric; Mouser part 581-KGM15BR71E104KT
C259, C265, C272: 10u cer; C_0603_1608Metric; Mouser part 187-CL10A106MA8NRWC
C271: 4.7u; C_0603_1608Metric; Mouser part 581-06036C475KAT2A
C274, C275, C276, C277, C278, C279, C280, C281, C282, C283, C284, C285, C286, C287, C288, C289: 100pF; C_0402_1005Metric; Mouser part TCC0402COG101F500AT
C294, C295, C296, C297, C298, C299, C300, C301, C302, C303, C304, C305, C306, C307, C308, C309: 2.2u; C_0603_1608Metric; Mouser part 187-CL10A225KO8NNNC
D10, D12, D13, D14, D15, D16, D17, D18: PRTR5V0U2X; SOT-143; LCSC C5158049
IC3: AK5538VN; QFN50P900X900X100-65N; Mouser Part Number 412-AK5538VN
J9: 8P8C_LED_Shielded x4; RJ45_Amphenol_RJHSE538X-04; Manufacturer_Part_Number RJ-052-4-2; LCSC C7205134
R102, R103, R104, R105: 20; R_0603_1608Metric; Manufacturer_Part_Number 0603WAF200JT5E; LCSC C22950
R111, R112, R113, R114, R115, R116, R117, R118, R119, R120, R121, R122, R123, R124, R125, R126, R127, R128, R129, R130: 470; R_0402_1005Metric; Manufacturer_Part_Number 0402WGF4700TCE; LCSC C25117
R131: 33; R_0603_1608Metric; Mouser part 71-CRCW060333R0FKEAC

Connections:
+3.3VA: C259.1, C260.1, C265.2, C266.1, D10.4 (VCC), D12.4 (VCC), D13.4 (VCC), D14.4 (VCC), D15.4 (VCC), D16.4 (VCC), D17.4 (VCC), D18.4 (VCC), IC3.2 (AVDD1), IC3.15 (AVDD2), R102.2, R103.2, R104.2, R105.2; also elsewhere on the board
+3V3: C269.1, C272.1, IC3.25 (TVDD), IC3.29 (PW0), IC3.30 (PW1), IC3.31 (PW2), IC3.44 (CKS1/CAD0_I2C/CSN), IC3.52 (TDM1), IC3.54 (I2C), IC3.56 (DCKS/HPFE), IC3.57 (LDOE); also elsewhere on the board
/ADC_AK5538/AIN1N: C280.2, IC3.60 (AIN1N), R129.2
/ADC_AK5538/AIN1P: C281.2, IC3.59 (AIN1P), R130.2
/ADC_AK5538/AIN2N: C278.2, IC3.63 (AIN2N), R127.2
/ADC_AK5538/AIN2P: C279.2, IC3.64 (AIN2P), R128.2
/ADC_AK5538/AIN3N: C276.2, IC3.4 (AIN3N), R125.2
/ADC_AK5538/AIN3P: C277.2, IC3.3 (AIN3P), R126.2
/ADC_AK5538/AIN4N: C274.2, IC3.7 (AIN4N), R123.2
/ADC_AK5538/AIN4P: C275.2, IC3.8 (AIN4P), R124.2
/ADC_AK5538/AIN5N: C288.2, IC3.10 (AIN5N), R121.2
/ADC_AK5538/AIN5P: C289.2, IC3.9 (AIN5P), R122.2
/ADC_AK5538/AIN6N: C286.2, IC3.13 (AIN6N), R119.2
/ADC_AK5538/AIN6P: C287.2, IC3.14 (AIN6P), R120.2
/ADC_AK5538/AIN7N: C284.2, IC3.18 (AIN7N), R117.2
/ADC_AK5538/AIN7P: C285.2, IC3.17 (AIN7P), R118.2
/ADC_AK5538/AIN8N: C282.2, IC3.21 (AIN8N), R115.2
/ADC_AK5538/AIN8P: C283.2, IC3.22 (AIN8P), R116.2
/ADC_AK5538/BICK/DCLK: IC3.33 (BICK/DCLK); also elsewhere on the board
/ADC_AK5538/CKS0/SDA/CDTI: IC3.43 (CKS0/SDA/CDTI); also elsewhere on the board
/ADC_AK5538/CKS2/SCL/CCLK: IC3.45 (CKS2/SCL/CCLK); also elsewhere on the board
/ADC_AK5538/DIF1/DSDSEL1: IC3.50 (DIF1/DSDSEL1); also elsewhere on the board
/ADC_AK5538/J9_1: C309.1, D10.2 (I/O1), J9.1, J9.13
/ADC_AK5538/J9_2: C308.1, D10.3 (I/O2), J9.2, J9.14
/ADC_AK5538/J9_3: C307.1, D12.2 (I/O1), J9.3, J9.15
/ADC_AK5538/J9_4: C306.1, D12.3 (I/O2), J9.4, J9.16
/ADC_AK5538/J9_5: C305.1, D13.2 (I/O1), J9.5, J9.17
/ADC_AK5538/J9_6: C304.1, D13.3 (I/O2), J9.6, J9.18
/ADC_AK5538/J9_7: C303.1, D14.2 (I/O1), J9.7, J9.19
/ADC_AK5538/J9_8: C302.1, D14.3 (I/O2), J9.8, J9.20
/ADC_AK5538/J9_25: C301.1, D15.2 (I/O1), J9.25, J9.37
/ADC_AK5538/J9_26: C300.1, D15.3 (I/O2), J9.26, J9.38
/ADC_AK5538/J9_27: C299.1, D16.2 (I/O1), J9.27, J9.39
/ADC_AK5538/J9_28: C298.1, D16.3 (I/O2), J9.28, J9.40
/ADC_AK5538/J9_29: C297.1, D17.2 (I/O1), J9.29, J9.41
/ADC_AK5538/J9_30: C296.1, D17.3 (I/O2), J9.30, J9.42
/ADC_AK5538/J9_31: C295.1, D18.2 (I/O1), J9.31, J9.43
/ADC_AK5538/J9_32: C294.1, D18.3 (I/O2), J9.32, J9.44
/ADC_AK5538/LRCK/DSDOL1: IC3.34 (LRCK/DSDOL1); also elsewhere on the board
/ADC_AK5538/MCLK: IC3.24 (MCLK), R131.1
/ADC_AK5538/OVF: IC3.42 (OVF); also elsewhere on the board
/ADC_AK5538/PDN_AK: IC3.28 (PDN); also elsewhere on the board
/ADC_AK5538/SDTO1/DSDOL2: IC3.36 (SDTO1/DSDOL2); also elsewhere on the board
GND: C257.2, C258.1, C259.2, C260.2, C261.1, C262.2, C263.1, C264.2, C265.1, C266.2, C267.2, C268.1, C269.2, C270.2, C271.2, C272.2, C274.1, C275.1, C276.1, C277.1, C278.1, C279.1, C280.1, C281.1, C282.1, C283.1, C284.1, C285.1, C286.1, C287.1, C288.1, C289.1, D10.1 (GND), D12.1 (GND), D13.1 (GND), D14.1 (GND), D15.1 (GND), D16.1 (GND), D17.1 (GND), D18.1 (GND), IC3.1 (AVSS1), IC3.5 (VREFL2), IC3.12 (VREFL3), IC3.16 (AVSS2), IC3.20 (VREFL4), IC3.23 (TEST), IC3.26 (DVSS), IC3.32 (MSN), IC3.46 (CKS3/CAD1), IC3.47 (SLOW/DCKB), IC3.48 (SD/PMOD), IC3.49 (DIF0/DSDSEL0), IC3.51 (TDM0), IC3.53 (PSN/CAD0_SPI), IC3.55 (DP), IC3.58 (ODP), IC3.61 (VREFL1), IC3.65 (GND), J9.9, J9.11, J9.12, J9.21, J9.23, J9.24, J9.33, J9.35, J9.36, J9.45, J9.47, J9.48, J9.SH; also elsewhere on the board
unnamed: C294.2, R115.1
unnamed: C295.2, R116.1
unnamed: C296.2, R117.1
unnamed: C297.2, R118.1
unnamed: C298.2, R119.1
unnamed: C299.2, R120.1
unnamed: C300.2, R121.1
unnamed: C301.2, R122.1
unnamed: C302.2, R123.1
unnamed: C303.2, R124.1
unnamed: C304.2, R125.1
unnamed: C305.2, R126.1
unnamed: C306.2, R127.1
unnamed: C307.2, R128.1
unnamed: C308.2, R129.1
unnamed: C309.2, R130.1
unnamed: C268.2, C271.1, IC3.27 (VDD18)
unnamed: C257.1, C258.2, IC3.62 (VREFH1), R102.1
unnamed: C261.2, C262.1, IC3.6 (VREFH2), R103.1
unnamed: C263.2, C264.1, IC3.11 (VREFH3), R104.1
unnamed: C267.1, C270.1, IC3.19 (VREFH4), R105.1
unnamed: J9.10, R111.2
unnamed: J9.22, R113.2
unnamed: J9.34, R112.2
unnamed: J9.46, R114.2
PE12: R111.1, R112.1, R113.1, R114.1; also elsewhere on the board
SAI1_MCLK: R131.2; also elsewhere on the board

Notes on the sheet:
PASS-THROUGH
INPUT
ESR-PROTECION

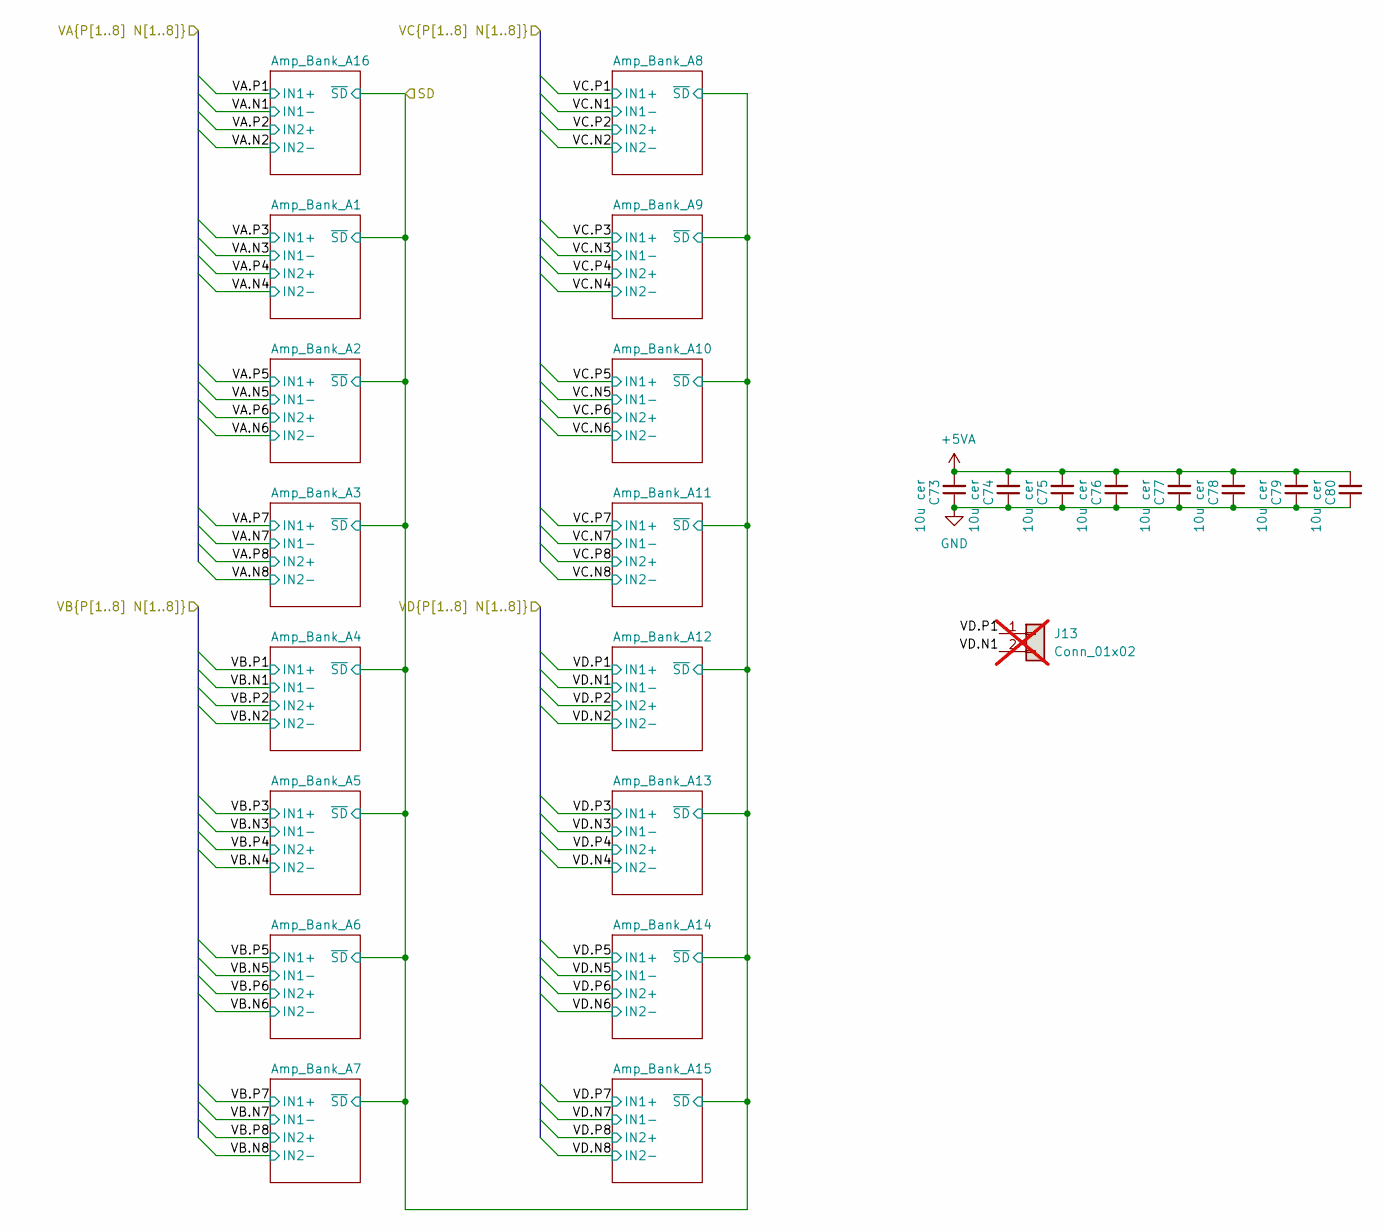
[picture p101: schematic ALL_AMPS.kicad_sch, Amplifiers PAM]

Parts:
C73, C74, C75, C76, C77, C78, C79, C80: 10u cer; C_0603_1608Metric; Mouser part 187-CL10A106MA8NRWC
J13: Conn_01x02; PinHeader_1x02_P2.54mm_Vertical; not fitted

Connections:
+5VA: C73.2, C74.2, C75.2, C76.2, C77.2, C78.2, C79.2, C80.2; also elsewhere on the board
/ALL_AMPS/VD.N1: J13.2; also elsewhere on the board
/ALL_AMPS/VD.P1: J13.1; also elsewhere on the board
GND: C73.1, C74.1, C75.1, C76.1, C77.1, C78.1, C79.1, C80.1; also elsewhere on the board
