bergamifer/DS-Project/hardware/DS/DS.kicad_pcb

## KiCad design hardware/DS/DS.kicad_pcb (continued)

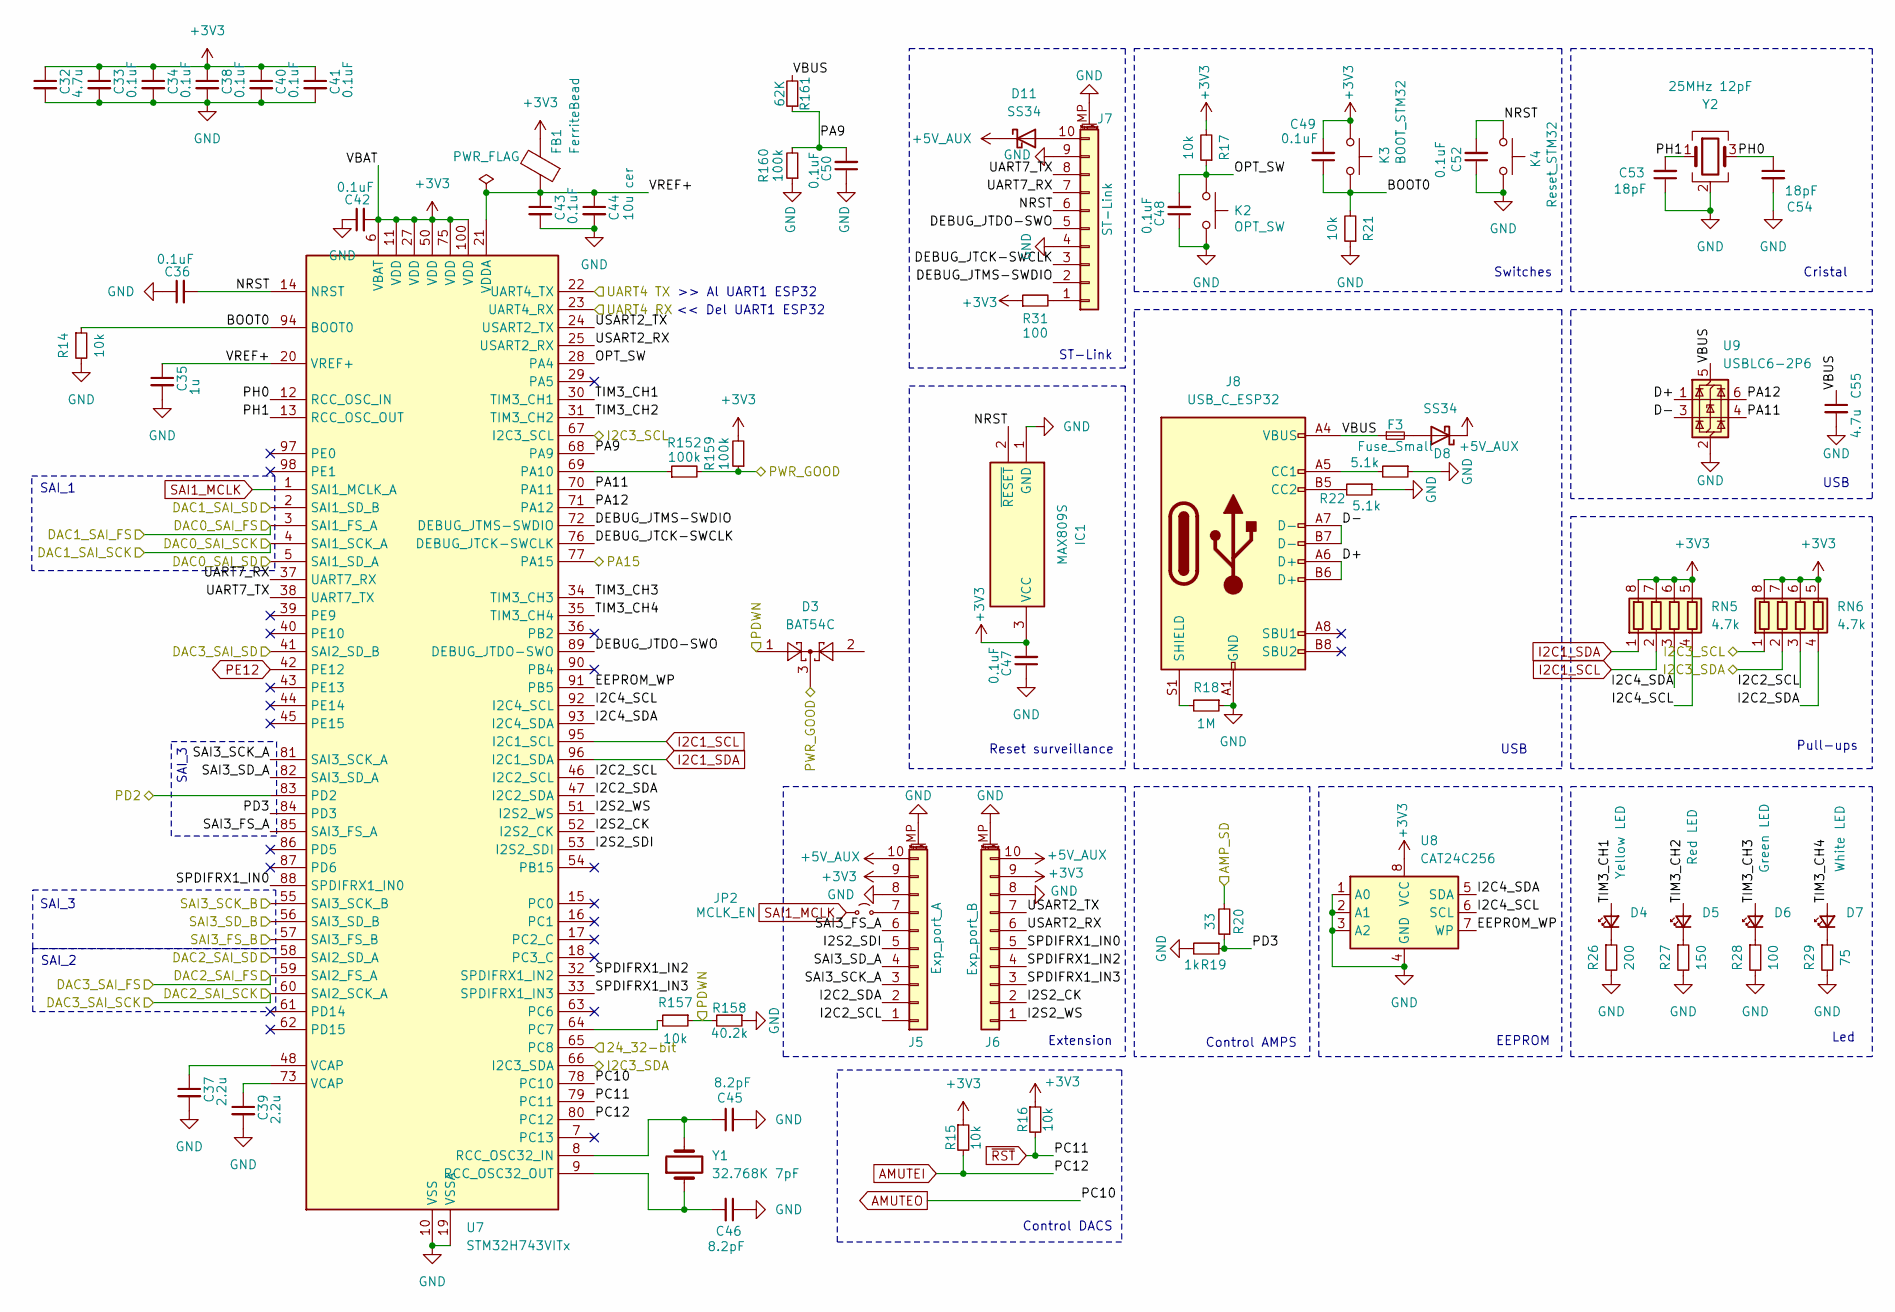
[picture p102: schematic stm32_custom.kicad_sch, Microcontroller STM23H743VIT6]

Parts:
C32, C55: 4.7u; C_0603_1608Metric; Mouser part 581-06036C475KAT2A
C33, C34, C36, C38, C40, C41, C42, C43, C47, C48, C49, C50, C52: 0.1uF; C_0402_1005Metric; Mouser part 581-KGM15BR71E104KT
C35: 1u; C_0603_1608Metric; Mouser part 791-0603B105M160CT
C37, C39: 2.2u; C_0603_1608Metric; Mouser part 187-CL10A225KO8NNNC
C44: 10u cer; C_0603_1608Metric; Mouser part 187-CL10A106MA8NRWC
C45, C46: 8.2pF; C_0201_0603Metric; Mouser part 77-VJ0603A120JXQPBC
C53, C54: 18pF; C_0402_1005Metric; Mouser part 80-C0603C100K3G
D3: BAT54C; SOT-23
D4: Yellow LED; LED_0805_2012Metric; Mouser part 604-APT1608SURCK-AMT
D5: Red LED; LED_0805_2012Metric; Mouser part 604-APT1608CGCK
D6: Green LED; LED_0805_2012Metric; Mouser part 720-BPS2THVG2J8L55S
D7: White LED; LED_0805_2012Metric; Mouser part 327-FKY1111CTR
D8, D11: SS34; D_SMA; Manufacturer_Part_Number SS14HE; LCSC C8678
F3: Fuse_Small; Fuse_1206_3216Metric; Manufacturer_Part_Number SMD1206P110TF/16; LCSC C523825
FB1: FerriteBead; L_0805_2012Metric; Mouser part 81-BLM18DN601SN1D
IC1: MAX809S; SOT-23-3; Mouser Part Number 700-MAX809TEURT
J5: Exp_port_A; JST_SH_BM10B-SRSS-TB_1x10-1MP_P1.00mm_Vertical; Manufacturer_Part_Number HX 1.0-10P LT; LCSC C5343037
J6: Exp_port_B; JST_SH_BM10B-SRSS-TB_1x10-1MP_P1.00mm_Vertical; Manufacturer_Part_Number HX 1.0-10P LT; LCSC C5343037
J7: ST-Link; JST_SH_BM10B-SRSS-TB_1x10-1MP_P1.00mm_Vertical; Manufacturer_Part_Number HX 1.0-10P LT; LCSC C5343037
J8: USB_C_ESP32; USB_C_Receptacle_G-Switch_GT-USB-7051x; Mouser part 538-217179-0001
JP2: MCLK_EN; SolderJumper-2_P1.3mm_Open_RoundedPad1.0x1.5mm; Manufacturer_Part_Number SMQS-01R-TP; LCSC C5299502
K2: OPT_SW; SW_SPST_EVQP2_MiddlePushTravel_H2.5mm; Manufacturer_Part_Number TS-1185-W-4P-H1.8-160; LCSC C51927445
K3: BOOT_STM32; SW_SPST_EVQP2_MiddlePushTravel_H2.5mm; Manufacturer_Part_Number TS-1185-W-4P-H1.8-160; LCSC C51927445
K4: Reset_STM32; SW_SPST_EVQP2_MiddlePushTravel_H2.5mm; Manufacturer_Part_Number TS-1185-W-4P-H1.8-160; LCSC C51927445
R14, R15, R16, R17, R21, R157: 10k; R_0402_1005Metric; Mouser part 603-RC0603JR-1310KL
R18: 1M; R_0603_1608Metric; Mouser part 603-RC0603FR-131ML
R19: 1k; R_0402_1005Metric; Manufacturer_Part_Number CRCW06031K00FKEA; LCSC C11702
R20: 33; R_0603_1608Metric; Mouser part 71-CRCW060333R0FKEAC
R22, R23: 5.1k; R_0603_1608Metric; Mouser part 708-RMCF0603FT5K10
R26: 200; R_0603_1608Metric; Mouser part 594-MCT06030C1200FP5
R27: 150; R_0603_1608Metric; Manufacturer_Part_Number 0603WAF1500T5E; LCSC C22808
R28, R31: 100; R_0603_1608Metric; Manufacturer_Part_Number RCT03100RJLF; LCSC C177347
R29: 75; R_0603_1608Metric; Manufacturer_Part_Number 0603WAF750JT5E; LCSC C4275
R152, R159, R160: 100k; R_0402_1005Metric; LCSC C25741
R158: 40.2k; R_0402_1005Metric; LCSC C2933097
R161: 62K; R_0402_1005Metric; LCSC C37825
RN5, RN6: 4.7k; R_Array_Convex_4x0603; Manufacturer_Part_Number 4D03WGJ0472T5E; LCSC C1980
U7: STM32H743VITx; LQFP-100_14x14mm_P0.5mm; Manufacturer_Part_Number STM32H743VIT6; LCSC C114409
U8: CAT24C256; TSSOP-8_4.4x3mm_P0.65mm; Manufacturer_Part_Number CAT24C256YI-GT3; LCSC C146734
U9: USBLC6-2P6; SOT-666; Manufacturer_Part_Number USBLC6-2P6; LCSC C15999
Y1: 32.768K 7pF; Crystal_SMD_3215-2Pin_3.2x1.5mm; Manufacturer_Part_Number NX3215SA-32.768kHz-EXS00A-MU00202; LCSC C280830
Y2: 25MHz 12pF; Crystal_SMD_3225-4Pin_3.2x2.5mm; Manufacturer_Part_Number X322525MOB4SI; LCSC C9006

Connections:
+3V3: C32.1, C33.1, C34.1, C38.1, C40.1, C41.1, C42.2, C47.2, C49.2, FB1.2, IC1.3 (VCC), J5.9, J6.9, K3.1, R15.1, R16.1, R17.2, R31.1, R159.2, RN5.5 (R4.2), RN5.6 (R3.2), RN5.7 (R2.2), RN5.8 (R1.2), RN6.5 (R4.2), RN6.6 (R3.2), RN6.7 (R2.2), RN6.8 (R1.2), U7.6 (VBAT), U7.11 (VDD), U7.27 (VDD), U7.50 (VDD), U7.75 (VDD), U7.100 (VDD), U8.8 (VCC); also elsewhere on the board
+5V_AUX: D8.1 (K), D11.1 (K), J5.10, J6.10; also elsewhere on the board
/ADC_AK5538/BICK/DCLK: U7.55 (SAI3_SCK_B); also elsewhere on the board
/ADC_AK5538/CKS0/SDA/CDTI: RN6.2 (R2.1), U7.66 (I2C3_SDA); also elsewhere on the board
/ADC_AK5538/CKS2/SCL/CCLK: RN6.1 (R1.1), U7.67 (I2C3_SCL); also elsewhere on the board
/ADC_AK5538/DIF1/DSDSEL1: U7.65 (PC8); also elsewhere on the board
/ADC_AK5538/LRCK/DSDOL1: U7.57 (SAI3_FS_B); also elsewhere on the board
/ADC_AK5538/OVF: U7.77 (PA15); also elsewhere on the board
/ADC_AK5538/PDN_AK: D3.1, R157.1, R158.2; also elsewhere on the board
/ADC_AK5538/SDTO1/DSDOL2: U7.56 (SAI3_SD_B); also elsewhere on the board
/ALL_AMPS/SD: R20.2; also elsewhere on the board
/DAC0/SAI_FS: U7.3 (SAI1_FS_A); also elsewhere on the board
/DAC0/SAI_SCK: U7.4 (SAI1_SCK_A); also elsewhere on the board
/DAC0/SAI_SD: U7.5 (SAI1_SD_A); also elsewhere on the board
/DAC1/SAI_SD: U7.2 (SAI1_SD_B); also elsewhere on the board
/DAC2/SAI_FS: U7.59 (SAI2_FS_A); also elsewhere on the board
/DAC2/SAI_SCK: U7.60 (SAI2_SCK_A); also elsewhere on the board
/DAC2/SAI_SD: U7.58 (SAI2_SD_A); also elsewhere on the board
/DAC3/SAI_SD: U7.41 (SAI2_SD_B); also elsewhere on the board
/DS_Power/PG: D3.3, R152.2, R159.1; also elsewhere on the board
/esp32-mini/UART1 - RX: U7.22 (UART4_TX); also elsewhere on the board
/esp32-mini/UART1 - TX: U7.23 (UART4_RX); also elsewhere on the board
/stm32_custom/BOOT0: C49.1, K3.2, R14.1, R21.2, U7.94 (BOOT0)
/stm32_custom/D+: J8.A6 (D+), J8.B6 (D+), U9.1 (I/O1)
/stm32_custom/D-: J8.A7 (D-), J8.B7 (D-), U9.3 (I/O2)
/stm32_custom/DEBUG_JTCK-SWCLK: J7.3, U7.76 (DEBUG_JTCK-SWCLK)
/stm32_custom/DEBUG_JTDO-SWO: J7.5, U7.89 (DEBUG_JTDO-SWO)
/stm32_custom/DEBUG_JTMS-SWDIO: J7.2, U7.72 (DEBUG_JTMS-SWDIO)
/stm32_custom/EEPROM_WP: U7.91 (PB5), U8.7 (WP)
/stm32_custom/I2C2_SCL: J5.1, RN6.3 (R3.1), U7.46 (I2C2_SCL)
/stm32_custom/I2C2_SDA: J5.2, RN6.4 (R4.1), U7.47 (I2C2_SDA)
/stm32_custom/I2C4_SCL: RN5.4 (R4.1), U7.92 (I2C4_SCL), U8.6 (SCL)
/stm32_custom/I2C4_SDA: RN5.3 (R3.1), U7.93 (I2C4_SDA), U8.5 (SDA)
/stm32_custom/I2S2_CK: J6.2, U7.52 (I2S2_CK)
/stm32_custom/I2S2_SDI: J5.5, U7.53 (I2S2_SDI)
/stm32_custom/I2S2_WS: J6.1, U7.51 (I2S2_WS)
/stm32_custom/NRST: C36.2, C52.2, IC1.2 (~RESET), J7.6, K4.1, U7.14 (NRST)
/stm32_custom/OPT_SW: C48.2, K2.1, R17.1, U7.28 (PA4)
/stm32_custom/PA9: C50.2, R160.2, R161.1, U7.68 (PA9)
/stm32_custom/PA11: U7.70 (PA11), U9.4 (I/O2)
/stm32_custom/PA12: U7.71 (PA12), U9.6 (I/O1)
/stm32_custom/PC13: U7.7 (PC13); also elsewhere on the board
/stm32_custom/PD3: R19.1, R20.1, U7.84 (PD3)
/stm32_custom/PH0: C54.1, U7.12 (RCC_OSC_IN), Y2.3
/stm32_custom/PH1: C53.2, U7.13 (RCC_OSC_OUT), Y2.1
/stm32_custom/SAI3_FS_A: J5.6, U7.85 (SAI3_FS_A)
/stm32_custom/SAI3_SCK_A: J5.3, U7.81 (SAI3_SCK_A)
/stm32_custom/SAI3_SD_A: J5.4, U7.82 (SAI3_SD_A)
/stm32_custom/SPDIFRX1_IN0: J6.5, U7.88 (SPDIFRX1_IN0)
/stm32_custom/SPDIFRX1_IN2: J6.4, U7.32 (SPDIFRX1_IN2)
/stm32_custom/SPDIFRX1_IN3: J6.3, U7.33 (SPDIFRX1_IN3)
/stm32_custom/TIM3_CH1: D4.2 (A), U7.30 (TIM3_CH1)
/stm32_custom/TIM3_CH2: D5.2 (A), U7.31 (TIM3_CH2)
/stm32_custom/TIM3_CH3: D6.2 (A), U7.34 (TIM3_CH3)
/stm32_custom/TIM3_CH4: D7.2 (A), U7.35 (TIM3_CH4)
/stm32_custom/UART7_RX: J7.7, U7.37 (UART7_RX)
/stm32_custom/UART7_TX: J7.8, U7.38 (UART7_TX)
/stm32_custom/USART2_RX: J6.6, U7.25 (USART2_RX)
/stm32_custom/USART2_TX: J6.7, U7.24 (USART2_TX)
/stm32_custom/VBUS: C55.1, F3.1, J8.A4 (VBUS), J8.A9 (VBUS), J8.B4 (VBUS), J8.B9 (VBUS), R161.2, U9.5 (VBUS)
/stm32_custom/VREF+: C35.1, C43.1, C44.1, FB1.1, U7.20 (VREF+), U7.21 (VDDA)
AMUTEI: R15.2, U7.80 (PC12); also elsewhere on the board
AMUTEO: U7.78 (PC10); also elsewhere on the board
GND: C32.2, C33.2, C34.2, C35.2, C36.1, C37.2, C38.2, C39.2, C40.2, C41.2, C42.1, C43.2, C44.2, C45.2, C46.1, C47.1, C48.1, C50.1, C52.1, C53.1, C54.2, C55.2, IC1.1 (GND), J5.8, J5.MP (MountPin), J6.8, J6.MP (MountPin), J7.4, J7.9, J7.MP (MountPin), J8.A1 (GND), J8.A12 (GND), J8.B1 (GND), J8.B12 (GND), K2.2, K4.2, R14.2, R18.1, R19.2, R21.1, R22.1, R23.1, R26.2, R27.2, R28.2, R29.2, R158.1, R160.1, U7.10 (VSS), U7.19 (VSSA), U7.26 (VSS), U7.49 (VSS), U7.74 (VSS), U7.99 (VSS), U8.1 (A0), U8.2 (A1), U8.3 (A2), U8.4 (GND), U9.2 (GND), Y2.2 (G), Y2.4 (G); also elsewhere on the board
I2C1_SCL: RN5.2 (R2.1), U7.95 (I2C1_SCL); also elsewhere on the board
I2C1_SDA: RN5.1 (R1.1), U7.96 (I2C1_SDA); also elsewhere on the board
unnamed: C37.1, U7.48 (VCAP)
unnamed: C39.1, U7.73 (VCAP)
unnamed: D4.1 (K), R26.1
unnamed: D5.1 (K), R27.1
unnamed: D6.1 (K), R28.1
unnamed: D7.1 (K), R29.1
unnamed: D8.2 (A), F3.2
unnamed: D11.2 (A), J7.10
unnamed: J5.7, JP2.2 (B)
unnamed: J7.1, R31.2
unnamed: J8.A5 (CC1), R23.2
unnamed: J8.B5 (CC2), R22.2
unnamed: J8.S1 (SHIELD), R18.2
unnamed: R152.1, U7.69 (PA10)
unnamed: R157.2, U7.64 (PC7)
unnamed: C45.1, U7.8 (RCC_OSC32_IN), Y1.2
unnamed: C46.2, U7.9 (RCC_OSC32_OUT), Y1.1
PE12: U7.42 (PE12); also elsewhere on the board
SAI1_MCLK: JP2.1 (A), U7.1 (SAI1_MCLK_A); also elsewhere on the board
~RST: R16.2, U7.79 (PC11); also elsewhere on the board

Notes on the sheet:
ST-Link
SAI_1
Switches
SAI_3
Control AMPS
USB
<< Del UART1 ESP32
Cristal
>> Al UART1 ESP32
SAI_2
Reset surveillance
Extension
EEPROM
Control DACS
Pull-ups
Led

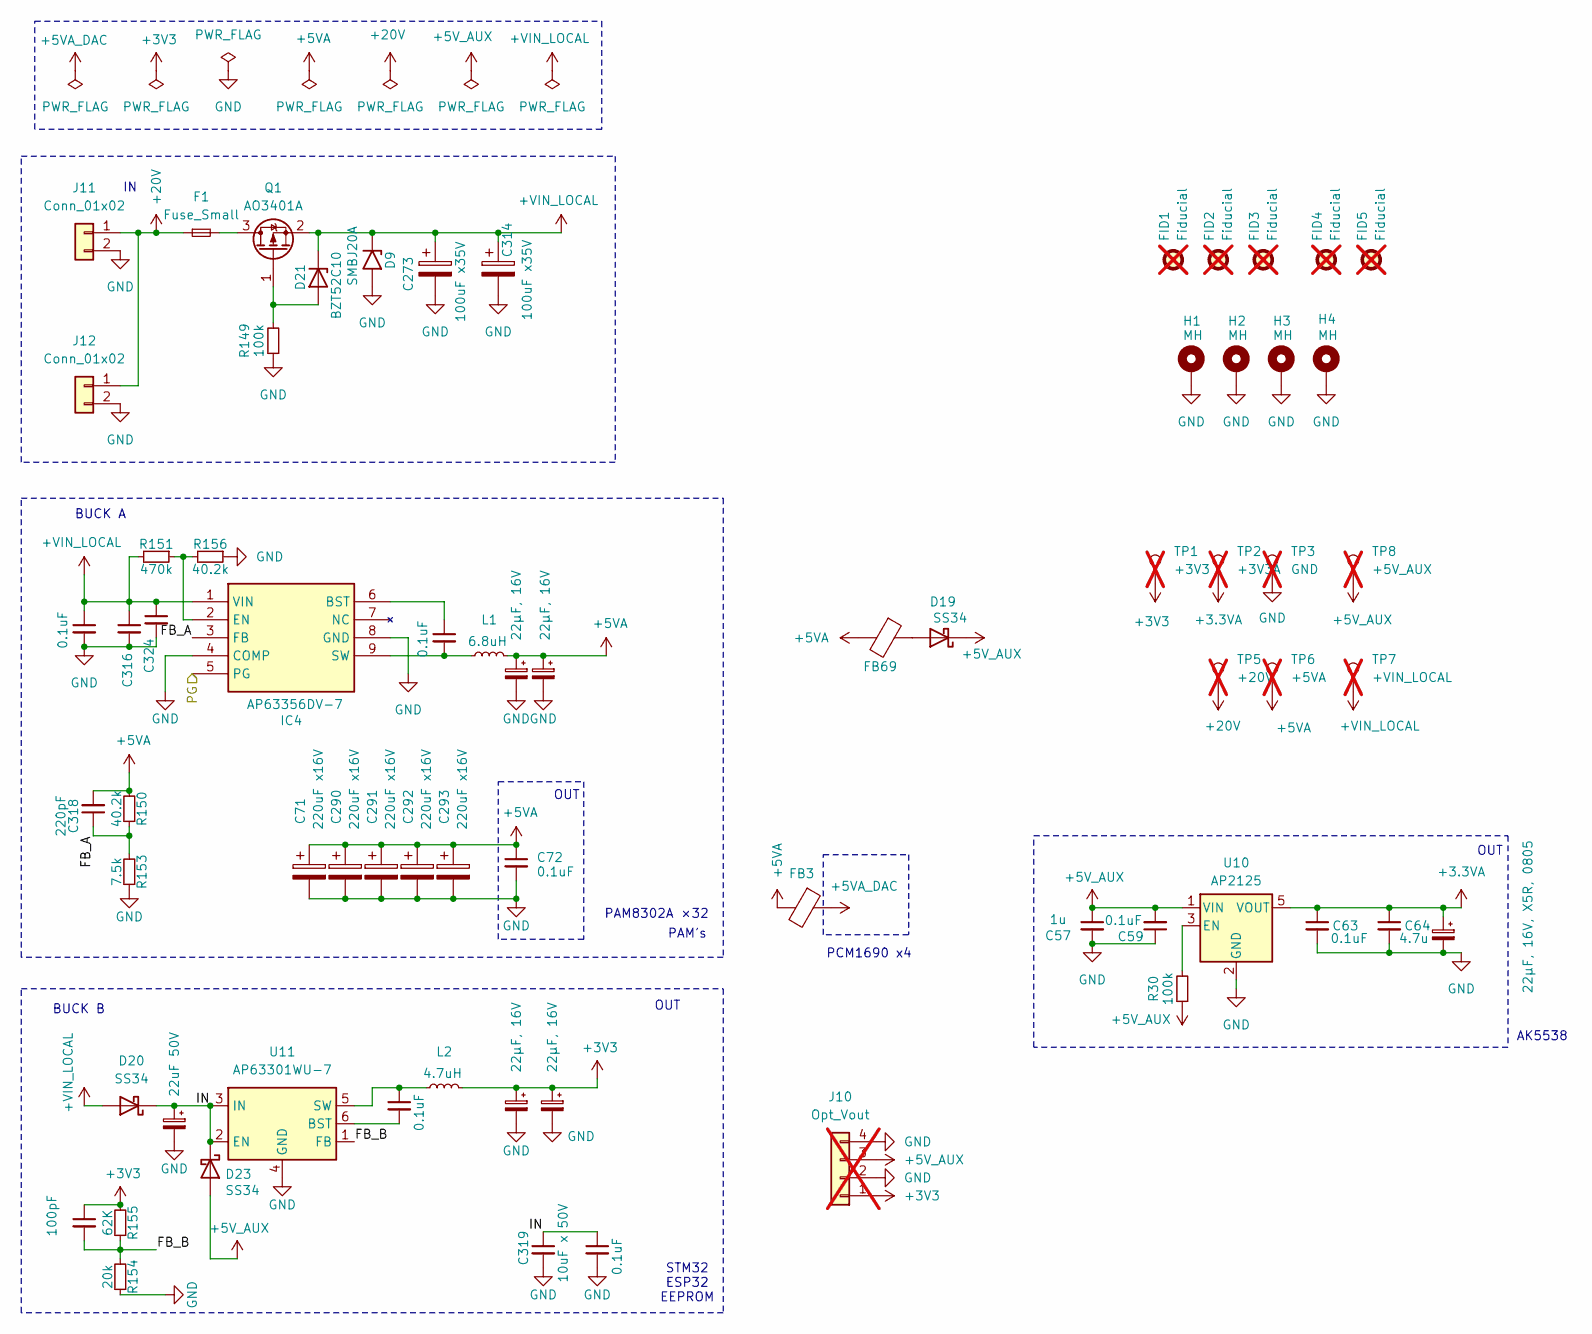
[picture p103: schematic DS_Power.kicad_sch, Power supply 20V]

Parts:
C57: 1u; C_0603_1608Metric; Mouser part 791-0603B105M160CT
C59, C61, C63, C72, C315, C317, C320: 0.1uF; C_0402_1005Metric; Mouser part 581-KGM15BR71E104KT
C60: 22uF 50V; CP_Elec_6.3x5.4; Manufacturer_Part_Number RVT1H220M0605; LCSC C72505
C64: 4.7u; C_0603_1608Metric; Mouser part 581-06036C475KAT2A
C67: 22µF, 16V, X5R, 0805; C_0805_2012Metric; LCSC C45783
C69, C70, C321, C322: 22µF, 16V; C_0805_2012Metric; LCSC C45783
C71, C290, C291, C292, C293: 220uF x16V; CP_Elec_6.3x7.7; LCSC C25503905
C273, C314: 100uF x35V; CP_Elec_6.3x7.7; LCSC C2836437
C316, C319, C324: 10uF x 50V; C_1210_3225Metric; LCSC C138687
C318: 220pF; C_0402_1005Metric; Mouser part 581-KGM15BR71E104KT
C323: 100pF; C_0402_1005Metric; Mouser part TCC0402COG101F500AT
D9: SMBJ20A; D_SMB; Manufacturer_Part_Number SMBJ24A; LCSC C364296
D19: SS34; D_SMA; Manufacturer_Part_Number SS14HE; LCSC C8678
D20, D23: SS34; D_SMA; LCSC C8678
D21: BZT52C10; D_SOD-123F; LCSC C173431
F1: Fuse_Small; Fuse_1206_3216Metric; LCSC C136345
FB3, FB69: FerriteBead; L_0805_2012Metric; Mouser part 81-BLM18DN601SN1D
FID1, FID2, FID3: Fiducial; Fiducial_1mm_Mask3mm; not fitted
FID4, FID5: Fiducial; Fiducial_0.5mm_Mask1mm; not fitted
H1, H2, H3, H4: MH; MountingHole_2.7mm_Pad_Via
IC4: AP63356DV-7; AP63356DV7; Mouser Part Number 621-AP63356DV-7
J10: Opt_Vout; JST_XH_B4B-XH-A_1x04_P2.50mm_Vertical; Manufacturer_Part_Number B4B-XH-A; not fitted
J11, J12: Conn_01x02; PhoenixContact_MSTBVA_2,5_2-G-5,08_1x02_P5.08mm_Vertical; LCSC C41784016
L1: 6.8uH; L_Sunlord_MWSA1004S; LCSC C408485
L2: 4.7uH; L_Sunlord_MWSA0603S; LCSC C408447
Q1: AO3401A; SOT-23; LCSC C15127
R30, R149: 100k; R_0402_1005Metric; LCSC C25741
R150, R156: 40.2k; R_0402_1005Metric; LCSC C2933097
R151: 470k; R_0603_1608Metric; LCSC C23178
R153: 7.5k; R_0603_1608Metric; LCSC C23234
R154: 20k; R_0402_1005Metric; LCSC C25765
R155: 62K; R_0402_1005Metric; LCSC C37825
TP1: +3V3; TestPoint_Pad_D1.5mm; not fitted
TP2: +3V3A; TestPoint_Pad_D1.5mm; not fitted
TP3: GND; TestPoint_Pad_D1.5mm; not fitted
TP5: +20V; TestPoint_Pad_D1.5mm; not fitted
TP6: +5VA; TestPoint_Pad_D1.5mm; not fitted
TP7: +VIN_LOCAL; TestPoint_Pad_D1.5mm; not fitted
TP8: +5V_AUX; TestPoint_Pad_D1.5mm; not fitted
U10: AP2125; SOT-23-5; LCSC C110463
U11: AP63301WU-7; TSOT-23-6; LCSC C2158003

Connections:
+3.3VA: C63.1, C64.1, C67.1, TP2.1 (1_1), U10.5 (VOUT); also elsewhere on the board
+3V3: C321.1, C322.1, C323.1, J10.1, L2.2, R155.2, TP1.1 (1_1); also elsewhere on the board
+5VA: C69.1, C70.1, C71.1, C72.1, C290.1, C291.1, C292.1, C293.1, C318.2, FB3.2, FB69.2, L1.2, R150.2, TP6.1 (1_1); also elsewhere on the board
+5VA_DAC: FB3.1; also elsewhere on the board
+5V_AUX: C57.1, C59.2, D19.1 (K), D23.2 (A), J10.3, R30.1, TP8.1 (1_1), U10.1 (VIN); also elsewhere on the board
+20V: F1.1, J11.1, J12.1, TP5.1 (1_1)
+VIN_LOCAL: C273.1, C314.1, C315.1, C316.1, C324.1, D9.1 (A1), D20.2 (A), D21.1 (K), IC4.1 (VIN), Q1.2 (S), R151.2, TP7.1 (1_1)
/DS_Power/FB_A: C318.1, IC4.3 (FB), R150.1, R153.2
/DS_Power/FB_B: C323.2, R154.2, R155.1, U11.1 (FB)
/DS_Power/IN: C60.1, C319.1, C320.1, D20.1 (K), D23.1 (K), U11.2 (EN), U11.3 (IN)
/DS_Power/PG: IC4.5 (PG); also elsewhere on the board
GND: C57.2, C59.1, C60.2, C63.2, C64.2, C67.2, C69.2, C70.2, C71.2, C72.2, C273.2, C290.2, C291.2, C292.2, C293.2, C314.2, C315.2, C316.2, C319.2, C320.2, C321.2, C322.2, C324.2, D9.2 (A2), H1.1 (1_1), H2.1 (1_1), H3.1 (1_1), H4.1 (1_1), IC4.4 (COMP), IC4.8 (GND), J10.2, J10.4, J11.2, J12.2, R149.1, R153.1, R154.1, R156.1, TP3.1 (1_1), U10.2 (GND), U11.4 (GND); also elsewhere on the board
unnamed: D19.2 (A), FB69.1
unnamed: D21.2 (A), Q1.1 (G), R149.2
unnamed: C317.1, IC4.6 (BST)
unnamed: IC4.2 (EN), R151.1, R156.2
unnamed: C317.2, IC4.9 (SW), L1.1
unnamed: F1.2, Q1.3 (D)
unnamed: R30.2, U10.3 (EN)
unnamed: C61.2, U11.6 (BST)
unnamed: C61.1, L2.1, U11.5 (SW)

Notes on the sheet:
PAM8302A ×32
PAM's
BUCK A
PCM1690 x4
AK5538
OUT
STM32 ESP32 EEPROM
BUCK B
