bergamifer/DS-Project/hardware/DS/DS.kicad_pcb

## KiCad design hardware/DS/DS.kicad_pcb (continued)

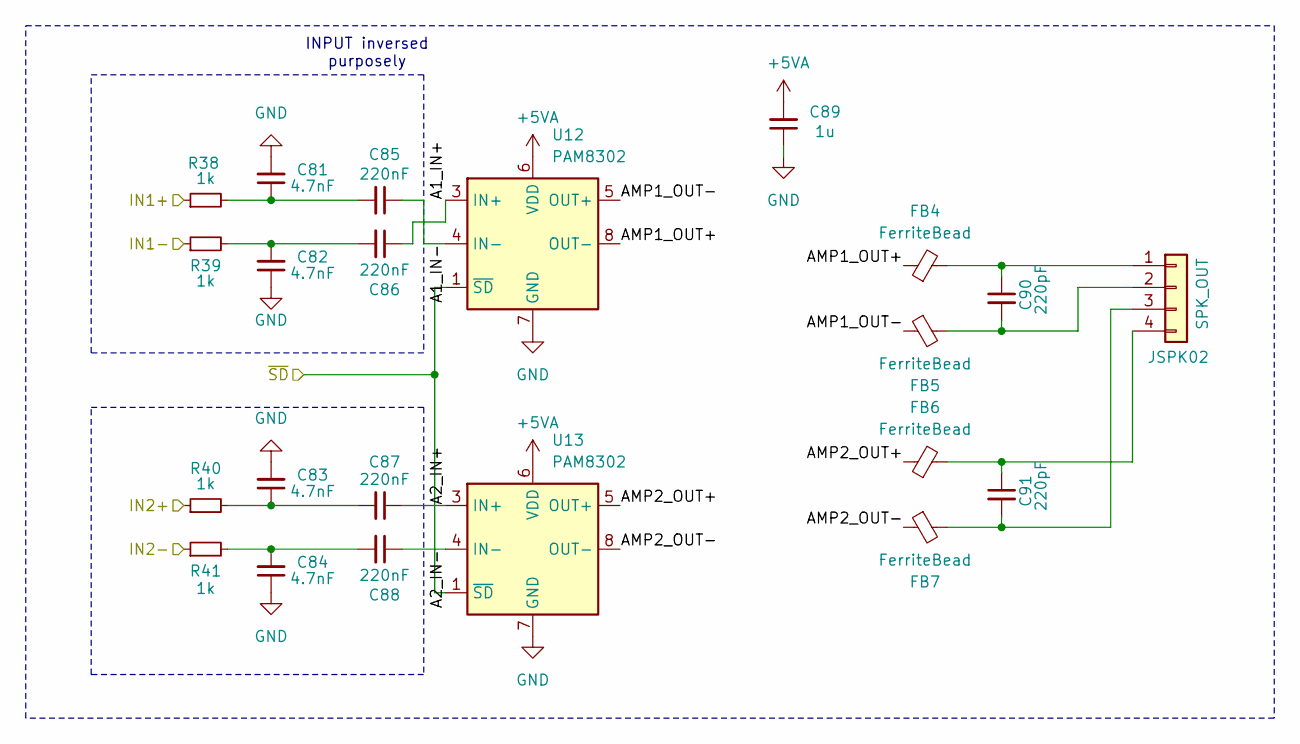
[picture p104: schematic Amp_Bank.kicad_sch, DS_Amp - Amplifier Bank (8 channels)]

Parts:
C81, C82, C83, C84: 4.7nF; C_0603_1608Metric; Manufacturer_Part_Number GCM1885C1H472GA16D; LCSC C2961271
C85, C86, C87, C88: 220nF; C_0402_1005Metric; Manufacturer_Part_Number CL05B224KO5NNNC; LCSC C16772
C89: 1u; C_0603_1608Metric; Mouser part 791-0603B105M160CT
C90, C91: 220pF; C_0402_1005Metric; Mouser part 581-KGM15BR71E104KT
FB4, FB5, FB6, FB7: FerriteBead; L_0805_2012Metric; Manufacturer_Part_Number SCBW201209U601T; LCSC C21286
JSPK02: SPK_OUT; JST_XH_B4B-XH-A_1x04_P2.50mm_Vertical; Manufacturer_Part_Number 8821WV-04KP; LCSC C5447988
R38, R39, R40, R41: 1k; R_0402_1005Metric; Manufacturer_Part_Number 0402WGF1001TCE; LCSC C11702
U12, U13: PAM8302; MSOP-8_3x3mm_P0.65mm; Manufacturer_Part_Number PAM8302AASCR; LCSC C113367

Connections:
+5VA: C89.2, U12.6 (VDD), U13.6 (VDD); also elsewhere on the board
/ALL_AMPS/Amp_Bank_A1/A1_IN+: C86.1, U12.3 (IN+)
/ALL_AMPS/Amp_Bank_A1/A1_IN-: C85.1, U12.4 (IN-)
/ALL_AMPS/Amp_Bank_A1/A2_IN+: C87.1, U13.3 (IN+)
/ALL_AMPS/Amp_Bank_A1/A2_IN-: C88.1, U13.4 (IN-)
/ALL_AMPS/Amp_Bank_A1/AMP1_OUT+: FB4.1, U12.8 (OUT-)
/ALL_AMPS/Amp_Bank_A1/AMP1_OUT-: FB5.1, U12.5 (OUT+)
/ALL_AMPS/Amp_Bank_A1/AMP2_OUT+: FB6.1, U13.5 (OUT+)
/ALL_AMPS/Amp_Bank_A1/AMP2_OUT-: FB7.1, U13.8 (OUT-)
/ALL_AMPS/SD: U12.1 (~SD), U13.1 (~SD); also elsewhere on the board
/ALL_AMPS/VA.N3: R39.1; also elsewhere on the board
/ALL_AMPS/VA.N4: R41.1; also elsewhere on the board
/ALL_AMPS/VA.P3: R38.1; also elsewhere on the board
/ALL_AMPS/VA.P4: R40.1; also elsewhere on the board
GND: C81.2, C82.1, C83.2, C84.1, C89.1, U12.7 (GND), U13.7 (GND); also elsewhere on the board
unnamed: C81.1, C85.2, R38.2
unnamed: C82.2, C86.2, R39.2
unnamed: C83.1, C87.2, R40.2
unnamed: C84.2, C88.2, R41.2
unnamed: C90.1, FB4.2, JSPK02.1
unnamed: C90.2, FB5.2, JSPK02.2
unnamed: C91.2, FB7.2, JSPK02.3
unnamed: C91.1, FB6.2, JSPK02.4

Parts of its further copies:
C92, C93, C94, C95, C103, C104, C105, C106, C114, C115, C116, C117, C125, C126, C127, C128, C136, C137, C138, C139, C147, C148, C149, C150, C158, C159, C160, C161, C169, C170, C171, C172, C180, C181, C182, C183, C191, C192, C193, C194, C202, C203, C204, C205, C213, C214, C215, C216, C224, C225, C226, C227, C235, C236, C237, C238, C246, C247, C248, C249: 4.7nF; C_0603_1608Metric; Manufacturer_Part_Number GCM1885C1H472GA16D; LCSC C2961271
C96, C97, C98, C99, C107, C108, C109, C110, C118, C119, C120, C121, C129, C130, C131, C132, C140, C141, C142, C143, C151, C152, C153, C154, C162, C163, C164, C165, C173, C174, C175, C176, C184, C185, C186, C187, C195, C196, C197, C198, C206, C207, C208, C209, C217, C218, C219, C220, C228, C229, C230, C231, C239, C240, C241, C242, C250, C251, C252, C253: 220nF; C_0402_1005Metric; Manufacturer_Part_Number CL05B224KO5NNNC; LCSC C16772
C100, C111, C122, C133, C144, C155, C166, C177, C188, C199, C210, C221, C232, C243, C254: 1u; C_0603_1608Metric; Mouser part 791-0603B105M160CT
C101, C102, C112, C113, C123, C124, C134, C135, C145, C146, C156, C157, C167, C168, C178, C179, C189, C190, C200, C201, C211, C212, C222, C223, C233, C234, C244, C245, C255, C256: 220pF; C_0402_1005Metric; Mouser part 581-KGM15BR71E104KT
FB8, FB9, FB10, FB11, FB12, FB13, FB14, FB15, FB16, FB17, FB18, FB19, FB20, FB21, FB22, FB23, FB24, FB25, FB26, FB27, FB28, FB29, FB30, FB31, FB32, FB33, FB34, FB35, FB36, FB37, FB38, FB39, FB40, FB41, FB42, FB43, FB44, FB45, FB46, FB47, FB48, FB49, FB50, FB51, FB52, FB53, FB54, FB55, FB56, FB57, FB58, FB59, FB60, FB61, FB62, FB63, FB64, FB65, FB66, FB67: FerriteBead; L_0805_2012Metric; Manufacturer_Part_Number SCBW201209U601T; LCSC C21286
JSPK01, JSPK03, JSPK04, JSPK05, JSPK06, JSPK07, JSPK08, JSPK09, JSPK10, JSPK11, JSPK12, JSPK13, JSPK14, JSPK15, JSPK16: SPK_OUT; JST_XH_B4B-XH-A_1x04_P2.50mm_Vertical; Manufacturer_Part_Number 8821WV-04KP; LCSC C5447988
R42, R43, R44, R45, R46, R47, R48, R49, R50, R51, R52, R53, R54, R55, R56, R57, R58, R59, R60, R61, R62, R63, R64, R65, R66, R67, R68, R69, R70, R71, R72, R73, R74, R75, R76, R77, R78, R79, R80, R81, R82, R83, R84, R85, R86, R87, R88, R89, R90, R91, R92, R93, R94, R95, R96, R97, R98, R99, R100, R101: 1k; R_0402_1005Metric; Manufacturer_Part_Number 0402WGF1001TCE; LCSC C11702
U14, U15, U16, U17, U18, U19, U20, U21, U22, U23, U24, U25, U26, U27, U28, U29, U30, U31, U32, U33, U34, U35, U36, U37, U38, U39, U40, U41, U42, U43: PAM8302; MSOP-8_3x3mm_P0.65mm; Manufacturer_Part_Number PAM8302AASCR; LCSC C113367

Connections of its further copies:
+5VA: C100.2, C111.2, C122.2, C133.2, C144.2, C155.2, C166.2, C177.2, C188.2, C199.2, C210.2, C221.2, C232.2, C243.2, C254.2, U14.6 (VDD), U15.6 (VDD), U16.6 (VDD), U17.6 (VDD), U18.6 (VDD), U19.6 (VDD), U20.6 (VDD), U21.6 (VDD), U22.6 (VDD), U23.6 (VDD), U24.6 (VDD), U25.6 (VDD), U26.6 (VDD), U27.6 (VDD), U28.6 (VDD), U29.6 (VDD), U30.6 (VDD), U31.6 (VDD), U32.6 (VDD), U33.6 (VDD), U34.6 (VDD), U35.6 (VDD), U36.6 (VDD), U37.6 (VDD), U38.6 (VDD), U39.6 (VDD), U40.6 (VDD), U41.6 (VDD), U42.6 (VDD), U43.6 (VDD); also elsewhere on the board
/ALL_AMPS/Amp_Bank_A2/A1_IN+: C97.1, U14.3 (IN+)
/ALL_AMPS/Amp_Bank_A2/A1_IN-: C96.1, U14.4 (IN-)
/ALL_AMPS/Amp_Bank_A2/A2_IN+: C98.1, U15.3 (IN+)
/ALL_AMPS/Amp_Bank_A2/A2_IN-: C99.1, U15.4 (IN-)
/ALL_AMPS/Amp_Bank_A2/AMP1_OUT+: FB8.1, U14.8 (OUT-)
/ALL_AMPS/Amp_Bank_A2/AMP1_OUT-: FB9.1, U14.5 (OUT+)
/ALL_AMPS/Amp_Bank_A2/AMP2_OUT+: FB10.1, U15.5 (OUT+)
/ALL_AMPS/Amp_Bank_A2/AMP2_OUT-: FB11.1, U15.8 (OUT-)
/ALL_AMPS/Amp_Bank_A3/A1_IN+: C108.1, U16.3 (IN+)
/ALL_AMPS/Amp_Bank_A3/A1_IN-: C107.1, U16.4 (IN-)
/ALL_AMPS/Amp_Bank_A3/A2_IN+: C109.1, U17.3 (IN+)
/ALL_AMPS/Amp_Bank_A3/A2_IN-: C110.1, U17.4 (IN-)
/ALL_AMPS/Amp_Bank_A3/AMP1_OUT+: FB12.1, U16.8 (OUT-)
/ALL_AMPS/Amp_Bank_A3/AMP1_OUT-: FB13.1, U16.5 (OUT+)
/ALL_AMPS/Amp_Bank_A3/AMP2_OUT+: FB14.1, U17.5 (OUT+)
/ALL_AMPS/Amp_Bank_A3/AMP2_OUT-: FB15.1, U17.8 (OUT-)
/ALL_AMPS/Amp_Bank_A4/A1_IN+: C119.1, U18.3 (IN+)
/ALL_AMPS/Amp_Bank_A4/A1_IN-: C118.1, U18.4 (IN-)
/ALL_AMPS/Amp_Bank_A4/A2_IN+: C120.1, U19.3 (IN+)
/ALL_AMPS/Amp_Bank_A4/A2_IN-: C121.1, U19.4 (IN-)
/ALL_AMPS/Amp_Bank_A4/AMP1_OUT+: FB16.1, U18.8 (OUT-)
/ALL_AMPS/Amp_Bank_A4/AMP1_OUT-: FB17.1, U18.5 (OUT+)
/ALL_AMPS/Amp_Bank_A4/AMP2_OUT+: FB18.1, U19.5 (OUT+)
/ALL_AMPS/Amp_Bank_A4/AMP2_OUT-: FB19.1, U19.8 (OUT-)
/ALL_AMPS/Amp_Bank_A5/A1_IN+: C130.1, U20.3 (IN+)
/ALL_AMPS/Amp_Bank_A5/A1_IN-: C129.1, U20.4 (IN-)
/ALL_AMPS/Amp_Bank_A5/A2_IN+: C131.1, U21.3 (IN+)
/ALL_AMPS/Amp_Bank_A5/A2_IN-: C132.1, U21.4 (IN-)
/ALL_AMPS/Amp_Bank_A5/AMP1_OUT+: FB20.1, U20.8 (OUT-)
/ALL_AMPS/Amp_Bank_A5/AMP1_OUT-: FB21.1, U20.5 (OUT+)
/ALL_AMPS/Amp_Bank_A5/AMP2_OUT+: FB22.1, U21.5 (OUT+)
/ALL_AMPS/Amp_Bank_A5/AMP2_OUT-: FB23.1, U21.8 (OUT-)
/ALL_AMPS/Amp_Bank_A6/A1_IN+: C141.1, U22.3 (IN+)
/ALL_AMPS/Amp_Bank_A6/A1_IN-: C140.1, U22.4 (IN-)
/ALL_AMPS/Amp_Bank_A6/A2_IN+: C142.1, U23.3 (IN+)
/ALL_AMPS/Amp_Bank_A6/A2_IN-: C143.1, U23.4 (IN-)
/ALL_AMPS/Amp_Bank_A6/AMP1_OUT+: FB24.1, U22.8 (OUT-)
/ALL_AMPS/Amp_Bank_A6/AMP1_OUT-: FB25.1, U22.5 (OUT+)
/ALL_AMPS/Amp_Bank_A6/AMP2_OUT+: FB26.1, U23.5 (OUT+)
/ALL_AMPS/Amp_Bank_A6/AMP2_OUT-: FB27.1, U23.8 (OUT-)
/ALL_AMPS/Amp_Bank_A7/A1_IN+: C152.1, U24.3 (IN+)
/ALL_AMPS/Amp_Bank_A7/A1_IN-: C151.1, U24.4 (IN-)
/ALL_AMPS/Amp_Bank_A7/A2_IN+: C153.1, U25.3 (IN+)
/ALL_AMPS/Amp_Bank_A7/A2_IN-: C154.1, U25.4 (IN-)
/ALL_AMPS/Amp_Bank_A7/AMP1_OUT+: FB28.1, U24.8 (OUT-)
/ALL_AMPS/Amp_Bank_A7/AMP1_OUT-: FB29.1, U24.5 (OUT+)
/ALL_AMPS/Amp_Bank_A7/AMP2_OUT+: FB30.1, U25.5 (OUT+)
/ALL_AMPS/Amp_Bank_A7/AMP2_OUT-: FB31.1, U25.8 (OUT-)
/ALL_AMPS/Amp_Bank_A8/A1_IN+: C163.1, U26.3 (IN+)
/ALL_AMPS/Amp_Bank_A8/A1_IN-: C162.1, U26.4 (IN-)
/ALL_AMPS/Amp_Bank_A8/A2_IN+: C164.1, U27.3 (IN+)
/ALL_AMPS/Amp_Bank_A8/A2_IN-: C165.1, U27.4 (IN-)
/ALL_AMPS/Amp_Bank_A8/AMP1_OUT+: FB32.1, U26.8 (OUT-)
/ALL_AMPS/Amp_Bank_A8/AMP1_OUT-: FB33.1, U26.5 (OUT+)
/ALL_AMPS/Amp_Bank_A8/AMP2_OUT+: FB34.1, U27.5 (OUT+)
/ALL_AMPS/Amp_Bank_A8/AMP2_OUT-: FB35.1, U27.8 (OUT-)
/ALL_AMPS/Amp_Bank_A9/A1_IN+: C174.1, U28.3 (IN+)
/ALL_AMPS/Amp_Bank_A9/A1_IN-: C173.1, U28.4 (IN-)
/ALL_AMPS/Amp_Bank_A9/A2_IN+: C175.1, U29.3 (IN+)
/ALL_AMPS/Amp_Bank_A9/A2_IN-: C176.1, U29.4 (IN-)
/ALL_AMPS/Amp_Bank_A9/AMP1_OUT+: FB36.1, U28.8 (OUT-)
/ALL_AMPS/Amp_Bank_A9/AMP1_OUT-: FB37.1, U28.5 (OUT+)
/ALL_AMPS/Amp_Bank_A9/AMP2_OUT+: FB38.1, U29.5 (OUT+)
/ALL_AMPS/Amp_Bank_A9/AMP2_OUT-: FB39.1, U29.8 (OUT-)
/ALL_AMPS/Amp_Bank_A10/A1_IN+: C185.1, U30.3 (IN+)
/ALL_AMPS/Amp_Bank_A10/A1_IN-: C184.1, U30.4 (IN-)
/ALL_AMPS/Amp_Bank_A10/A2_IN+: C186.1, U31.3 (IN+)
/ALL_AMPS/Amp_Bank_A10/A2_IN-: C187.1, U31.4 (IN-)
/ALL_AMPS/Amp_Bank_A10/AMP1_OUT+: FB40.1, U30.8 (OUT-)
/ALL_AMPS/Amp_Bank_A10/AMP1_OUT-: FB41.1, U30.5 (OUT+)
/ALL_AMPS/Amp_Bank_A10/AMP2_OUT+: FB42.1, U31.5 (OUT+)
/ALL_AMPS/Amp_Bank_A10/AMP2_OUT-: FB43.1, U31.8 (OUT-)
/ALL_AMPS/Amp_Bank_A11/A1_IN+: C196.1, U32.3 (IN+)
/ALL_AMPS/Amp_Bank_A11/A1_IN-: C195.1, U32.4 (IN-)
/ALL_AMPS/Amp_Bank_A11/A2_IN+: C197.1, U33.3 (IN+)
/ALL_AMPS/Amp_Bank_A11/A2_IN-: C198.1, U33.4 (IN-)
/ALL_AMPS/Amp_Bank_A11/AMP1_OUT+: FB44.1, U32.8 (OUT-)
/ALL_AMPS/Amp_Bank_A11/AMP1_OUT-: FB45.1, U32.5 (OUT+)
/ALL_AMPS/Amp_Bank_A11/AMP2_OUT+: FB46.1, U33.5 (OUT+)
/ALL_AMPS/Amp_Bank_A11/AMP2_OUT-: FB47.1, U33.8 (OUT-)
/ALL_AMPS/Amp_Bank_A12/A1_IN+: C207.1, U34.3 (IN+)
/ALL_AMPS/Amp_Bank_A12/A1_IN-: C206.1, U34.4 (IN-)
/ALL_AMPS/Amp_Bank_A12/A2_IN+: C208.1, U35.3 (IN+)
/ALL_AMPS/Amp_Bank_A12/A2_IN-: C209.1, U35.4 (IN-)
/ALL_AMPS/Amp_Bank_A12/AMP1_OUT+: FB48.1, U34.8 (OUT-)
/ALL_AMPS/Amp_Bank_A12/AMP1_OUT-: FB49.1, U34.5 (OUT+)
/ALL_AMPS/Amp_Bank_A12/AMP2_OUT+: FB50.1, U35.5 (OUT+)
/ALL_AMPS/Amp_Bank_A12/AMP2_OUT-: FB51.1, U35.8 (OUT-)
/ALL_AMPS/Amp_Bank_A13/A1_IN+: C218.1, U36.3 (IN+)
/ALL_AMPS/Amp_Bank_A13/A1_IN-: C217.1, U36.4 (IN-)
/ALL_AMPS/Amp_Bank_A13/A2_IN+: C219.1, U37.3 (IN+)
/ALL_AMPS/Amp_Bank_A13/A2_IN-: C220.1, U37.4 (IN-)
/ALL_AMPS/Amp_Bank_A13/AMP1_OUT+: FB52.1, U36.8 (OUT-)
/ALL_AMPS/Amp_Bank_A13/AMP1_OUT-: FB53.1, U36.5 (OUT+)
/ALL_AMPS/Amp_Bank_A13/AMP2_OUT+: FB54.1, U37.5 (OUT+)
/ALL_AMPS/Amp_Bank_A13/AMP2_OUT-: FB55.1, U37.8 (OUT-)
/ALL_AMPS/Amp_Bank_A14/A1_IN+: C229.1, U38.3 (IN+)
/ALL_AMPS/Amp_Bank_A14/A1_IN-: C228.1, U38.4 (IN-)
/ALL_AMPS/Amp_Bank_A14/A2_IN+: C230.1, U39.3 (IN+)
/ALL_AMPS/Amp_Bank_A14/A2_IN-: C231.1, U39.4 (IN-)
/ALL_AMPS/Amp_Bank_A14/AMP1_OUT+: FB56.1, U38.8 (OUT-)
/ALL_AMPS/Amp_Bank_A14/AMP1_OUT-: FB57.1, U38.5 (OUT+)
/ALL_AMPS/Amp_Bank_A14/AMP2_OUT+: FB58.1, U39.5 (OUT+)
/ALL_AMPS/Amp_Bank_A14/AMP2_OUT-: FB59.1, U39.8 (OUT-)
/ALL_AMPS/Amp_Bank_A15/A1_IN+: C240.1, U40.3 (IN+)
/ALL_AMPS/Amp_Bank_A15/A1_IN-: C239.1, U40.4 (IN-)
/ALL_AMPS/Amp_Bank_A15/A2_IN+: C241.1, U41.3 (IN+)
/ALL_AMPS/Amp_Bank_A15/A2_IN-: C242.1, U41.4 (IN-)
/ALL_AMPS/Amp_Bank_A15/AMP1_OUT+: FB60.1, U40.8 (OUT-)
/ALL_AMPS/Amp_Bank_A15/AMP1_OUT-: FB61.1, U40.5 (OUT+)
/ALL_AMPS/Amp_Bank_A15/AMP2_OUT+: FB62.1, U41.5 (OUT+)
/ALL_AMPS/Amp_Bank_A15/AMP2_OUT-: FB63.1, U41.8 (OUT-)
/ALL_AMPS/Amp_Bank_A16/A1_IN+: C251.1, U42.3 (IN+)
/ALL_AMPS/Amp_Bank_A16/A1_IN-: C250.1, U42.4 (IN-)
/ALL_AMPS/Amp_Bank_A16/A2_IN+: C252.1, U43.3 (IN+)
/ALL_AMPS/Amp_Bank_A16/A2_IN-: C253.1, U43.4 (IN-)
/ALL_AMPS/Amp_Bank_A16/AMP1_OUT+: FB64.1, U42.8 (OUT-)
/ALL_AMPS/Amp_Bank_A16/AMP1_OUT-: FB65.1, U42.5 (OUT+)
/ALL_AMPS/Amp_Bank_A16/AMP2_OUT+: FB66.1, U43.5 (OUT+)
/ALL_AMPS/Amp_Bank_A16/AMP2_OUT-: FB67.1, U43.8 (OUT-)
/ALL_AMPS/SD: U14.1 (~SD), U15.1 (~SD), U16.1 (~SD), U17.1 (~SD), U18.1 (~SD), U19.1 (~SD), U20.1 (~SD), U21.1 (~SD), U22.1 (~SD), U23.1 (~SD), U24.1 (~SD), U25.1 (~SD), U26.1 (~SD), U27.1 (~SD), U28.1 (~SD), U29.1 (~SD), U30.1 (~SD), U31.1 (~SD), U32.1 (~SD), U33.1 (~SD), U34.1 (~SD), U35.1 (~SD), U36.1 (~SD), U37.1 (~SD), U38.1 (~SD), U39.1 (~SD), U40.1 (~SD), U41.1 (~SD), U42.1 (~SD), U43.1 (~SD); also elsewhere on the board
/ALL_AMPS/VA.N1: R99.1; also elsewhere on the board
/ALL_AMPS/VA.N2: R101.1; also elsewhere on the board
/ALL_AMPS/VA.N5: R43.1; also elsewhere on the board
/ALL_AMPS/VA.N6: R45.1; also elsewhere on the board
/ALL_AMPS/VA.N7: R47.1; also elsewhere on the board
/ALL_AMPS/VA.N8: R49.1; also elsewhere on the board
/ALL_AMPS/VA.P1: R98.1; also elsewhere on the board
/ALL_AMPS/VA.P2: R100.1; also elsewhere on the board
/ALL_AMPS/VA.P5: R42.1; also elsewhere on the board
/ALL_AMPS/VA.P6: R44.1; also elsewhere on the board
/ALL_AMPS/VA.P7: R46.1; also elsewhere on the board
/ALL_AMPS/VA.P8: R48.1; also elsewhere on the board
/ALL_AMPS/VB.N1: R51.1; also elsewhere on the board
/ALL_AMPS/VB.N2: R53.1; also elsewhere on the board
/ALL_AMPS/VB.N3: R55.1; also elsewhere on the board
/ALL_AMPS/VB.N4: R57.1; also elsewhere on the board
/ALL_AMPS/VB.N5: R59.1; also elsewhere on the board
/ALL_AMPS/VB.N6: R61.1; also elsewhere on the board
/ALL_AMPS/VB.N7: R63.1; also elsewhere on the board
/ALL_AMPS/VB.N8: R65.1; also elsewhere on the board
/ALL_AMPS/VB.P1: R50.1; also elsewhere on the board
/ALL_AMPS/VB.P2: R52.1; also elsewhere on the board
/ALL_AMPS/VB.P3: R54.1; also elsewhere on the board
/ALL_AMPS/VB.P4: R56.1; also elsewhere on the board
/ALL_AMPS/VB.P5: R58.1; also elsewhere on the board
/ALL_AMPS/VB.P6: R60.1; also elsewhere on the board
/ALL_AMPS/VB.P7: R62.1; also elsewhere on the board
/ALL_AMPS/VB.P8: R64.1; also elsewhere on the board
/ALL_AMPS/VC.N1: R67.1; also elsewhere on the board
/ALL_AMPS/VC.N2: R69.1; also elsewhere on the board
/ALL_AMPS/VC.N3: R71.1; also elsewhere on the board
/ALL_AMPS/VC.N4: R73.1; also elsewhere on the board
/ALL_AMPS/VC.N5: R75.1; also elsewhere on the board
/ALL_AMPS/VC.N6: R77.1; also elsewhere on the board
/ALL_AMPS/VC.N7: R79.1; also elsewhere on the board
/ALL_AMPS/VC.N8: R81.1; also elsewhere on the board
/ALL_AMPS/VC.P1: R66.1; also elsewhere on the board
/ALL_AMPS/VC.P2: R68.1; also elsewhere on the board
/ALL_AMPS/VC.P3: R70.1; also elsewhere on the board
/ALL_AMPS/VC.P4: R72.1; also elsewhere on the board
/ALL_AMPS/VC.P5: R74.1; also elsewhere on the board
/ALL_AMPS/VC.P6: R76.1; also elsewhere on the board
/ALL_AMPS/VC.P7: R78.1; also elsewhere on the board
/ALL_AMPS/VC.P8: R80.1; also elsewhere on the board
/ALL_AMPS/VD.N1: R83.1; also elsewhere on the board
/ALL_AMPS/VD.N2: R85.1; also elsewhere on the board
/ALL_AMPS/VD.N3: R87.1; also elsewhere on the board
/ALL_AMPS/VD.N4: R89.1; also elsewhere on the board
/ALL_AMPS/VD.N5: R91.1; also elsewhere on the board
/ALL_AMPS/VD.N6: R93.1; also elsewhere on the board
/ALL_AMPS/VD.N7: R95.1; also elsewhere on the board
/ALL_AMPS/VD.N8: R97.1; also elsewhere on the board
/ALL_AMPS/VD.P1: R82.1; also elsewhere on the board
/ALL_AMPS/VD.P2: R84.1; also elsewhere on the board
/ALL_AMPS/VD.P3: R86.1; also elsewhere on the board
/ALL_AMPS/VD.P4: R88.1; also elsewhere on the board
/ALL_AMPS/VD.P5: R90.1; also elsewhere on the board
/ALL_AMPS/VD.P6: R92.1; also elsewhere on the board
/ALL_AMPS/VD.P7: R94.1; also elsewhere on the board
/ALL_AMPS/VD.P8: R96.1; also elsewhere on the board
GND: C92.2, C93.1, C94.2, C95.1, C100.1, C103.2, C104.1, C105.2, C106.1, C111.1, C114.2, C115.1, C116.2, C117.1, C122.1, C125.2, C126.1, C127.2, C128.1, C133.1, C136.2, C137.1, C138.2, C139.1, C144.1, C147.2, C148.1, C149.2, C150.1, C155.1, C158.2, C159.1, C160.2, C161.1, C166.1, C169.2, C170.1, C171.2, C172.1, C177.1, C180.2, C181.1, C182.2, C183.1, C188.1, C191.2, C192.1, C193.2, C194.1, C199.1, C202.2, C203.1, C204.2, C205.1, C210.1, C213.2, C214.1, C215.2, C216.1, C221.1, C224.2, C225.1, C226.2, C227.1, C232.1, C235.2, C236.1, C237.2, C238.1, C243.1, C246.2, C247.1, C248.2, C249.1, C254.1, U14.7 (GND), U15.7 (GND), U16.7 (GND), U17.7 (GND), U18.7 (GND), U19.7 (GND), U20.7 (GND), U21.7 (GND), U22.7 (GND), U23.7 (GND), U24.7 (GND), U25.7 (GND), U26.7 (GND), U27.7 (GND), U28.7 (GND), U29.7 (GND), U30.7 (GND), U31.7 (GND), U32.7 (GND), U33.7 (GND), U34.7 (GND), U35.7 (GND), U36.7 (GND), U37.7 (GND), U38.7 (GND), U39.7 (GND), U40.7 (GND), U41.7 (GND), U42.7 (GND), U43.7 (GND); also elsewhere on the board
unnamed: C92.1, C96.2, R42.2
unnamed: C93.2, C97.2, R43.2
unnamed: C94.1, C98.2, R44.2
unnamed: C95.2, C99.2, R45.2
unnamed: C103.1, C107.2, R46.2
unnamed: C104.2, C108.2, R47.2
unnamed: C105.1, C109.2, R48.2
unnamed: C106.2, C110.2, R49.2
unnamed: C114.1, C118.2, R50.2
unnamed: C115.2, C119.2, R51.2
unnamed: C116.1, C120.2, R52.2
unnamed: C117.2, C121.2, R53.2
unnamed: C125.1, C129.2, R54.2
unnamed: C126.2, C130.2, R55.2
unnamed: C127.1, C131.2, R56.2
unnamed: C128.2, C132.2, R57.2
unnamed: C136.1, C140.2, R58.2
unnamed: C137.2, C141.2, R59.2
unnamed: C138.1, C142.2, R60.2
unnamed: C139.2, C143.2, R61.2
unnamed: C147.1, C151.2, R62.2
unnamed: C148.2, C152.2, R63.2
unnamed: C149.1, C153.2, R64.2
unnamed: C150.2, C154.2, R65.2
unnamed: C158.1, C162.2, R66.2
unnamed: C159.2, C163.2, R67.2
unnamed: C160.1, C164.2, R68.2
unnamed: C161.2, C165.2, R69.2
unnamed: C169.1, C173.2, R70.2
unnamed: C170.2, C174.2, R71.2
unnamed: C171.1, C175.2, R72.2
unnamed: C172.2, C176.2, R73.2
unnamed: C180.1, C184.2, R74.2
unnamed: C181.2, C185.2, R75.2
unnamed: C182.1, C186.2, R76.2
unnamed: C183.2, C187.2, R77.2
unnamed: C191.1, C195.2, R78.2
unnamed: C192.2, C196.2, R79.2
unnamed: C193.1, C197.2, R80.2
unnamed: C194.2, C198.2, R81.2
unnamed: C202.1, C206.2, R82.2
unnamed: C203.2, C207.2, R83.2
unnamed: C204.1, C208.2, R84.2
unnamed: C205.2, C209.2, R85.2
unnamed: C213.1, C217.2, R86.2
unnamed: C214.2, C218.2, R87.2
unnamed: C215.1, C219.2, R88.2
unnamed: C216.2, C220.2, R89.2
unnamed: C224.1, C228.2, R90.2
unnamed: C225.2, C229.2, R91.2
unnamed: C226.1, C230.2, R92.2
unnamed: C227.2, C231.2, R93.2
unnamed: C235.1, C239.2, R94.2
unnamed: C236.2, C240.2, R95.2
unnamed: C237.1, C241.2, R96.2
unnamed: C238.2, C242.2, R97.2
unnamed: C246.1, C250.2, R98.2
unnamed: C247.2, C251.2, R99.2
unnamed: C248.1, C252.2, R100.2
unnamed: C249.2, C253.2, R101.2
unnamed: C255.1, FB64.2, JSPK01.1
unnamed: C255.2, FB65.2, JSPK01.2
unnamed: C256.2, FB67.2, JSPK01.3
unnamed: C256.1, FB66.2, JSPK01.4
unnamed: C101.1, FB8.2, JSPK03.1
unnamed: C101.2, FB9.2, JSPK03.2
unnamed: C102.2, FB11.2, JSPK03.3
unnamed: C102.1, FB10.2, JSPK03.4
unnamed: C112.1, FB12.2, JSPK04.1
unnamed: C112.2, FB13.2, JSPK04.2
unnamed: C113.2, FB15.2, JSPK04.3
unnamed: C113.1, FB14.2, JSPK04.4
unnamed: C123.1, FB16.2, JSPK05.1
unnamed: C123.2, FB17.2, JSPK05.2
unnamed: C124.2, FB19.2, JSPK05.3
unnamed: C124.1, FB18.2, JSPK05.4
unnamed: C134.1, FB20.2, JSPK06.1
unnamed: C134.2, FB21.2, JSPK06.2
unnamed: C135.2, FB23.2, JSPK06.3
unnamed: C135.1, FB22.2, JSPK06.4
unnamed: C145.1, FB24.2, JSPK07.1
unnamed: C145.2, FB25.2, JSPK07.2
unnamed: C146.2, FB27.2, JSPK07.3
unnamed: C146.1, FB26.2, JSPK07.4
unnamed: C156.1, FB28.2, JSPK08.1
unnamed: C156.2, FB29.2, JSPK08.2
unnamed: C157.2, FB31.2, JSPK08.3
unnamed: C157.1, FB30.2, JSPK08.4
unnamed: C178.1, FB36.2, JSPK09.1
unnamed: C178.2, FB37.2, JSPK09.2
unnamed: C179.2, FB39.2, JSPK09.3
unnamed: C179.1, FB38.2, JSPK09.4
unnamed: C167.1, FB32.2, JSPK10.1
unnamed: C167.2, FB33.2, JSPK10.2
unnamed: C168.2, FB35.2, JSPK10.3
unnamed: C168.1, FB34.2, JSPK10.4
unnamed: C189.1, FB40.2, JSPK11.1
unnamed: C189.2, FB41.2, JSPK11.2
unnamed: C190.2, FB43.2, JSPK11.3
unnamed: C190.1, FB42.2, JSPK11.4
unnamed: C200.1, FB44.2, JSPK12.1
unnamed: C200.2, FB45.2, JSPK12.2
unnamed: C201.2, FB47.2, JSPK12.3
unnamed: C201.1, FB46.2, JSPK12.4
unnamed: C211.1, FB48.2, JSPK13.1
unnamed: C211.2, FB49.2, JSPK13.2
unnamed: C212.2, FB51.2, JSPK13.3
unnamed: C212.1, FB50.2, JSPK13.4
unnamed: C222.1, FB52.2, JSPK14.1
unnamed: C222.2, FB53.2, JSPK14.2
unnamed: C223.2, FB55.2, JSPK14.3
unnamed: C223.1, FB54.2, JSPK14.4
unnamed: C233.1, FB56.2, JSPK15.1
unnamed: C233.2, FB57.2, JSPK15.2
unnamed: C234.2, FB59.2, JSPK15.3
unnamed: C234.1, FB58.2, JSPK15.4
unnamed: C244.1, FB60.2, JSPK16.1
unnamed: C244.2, FB61.2, JSPK16.2
unnamed: C245.2, FB63.2, JSPK16.3
unnamed: C245.1, FB62.2, JSPK16.4

Notes on the sheet:
INPUT inversed purposely

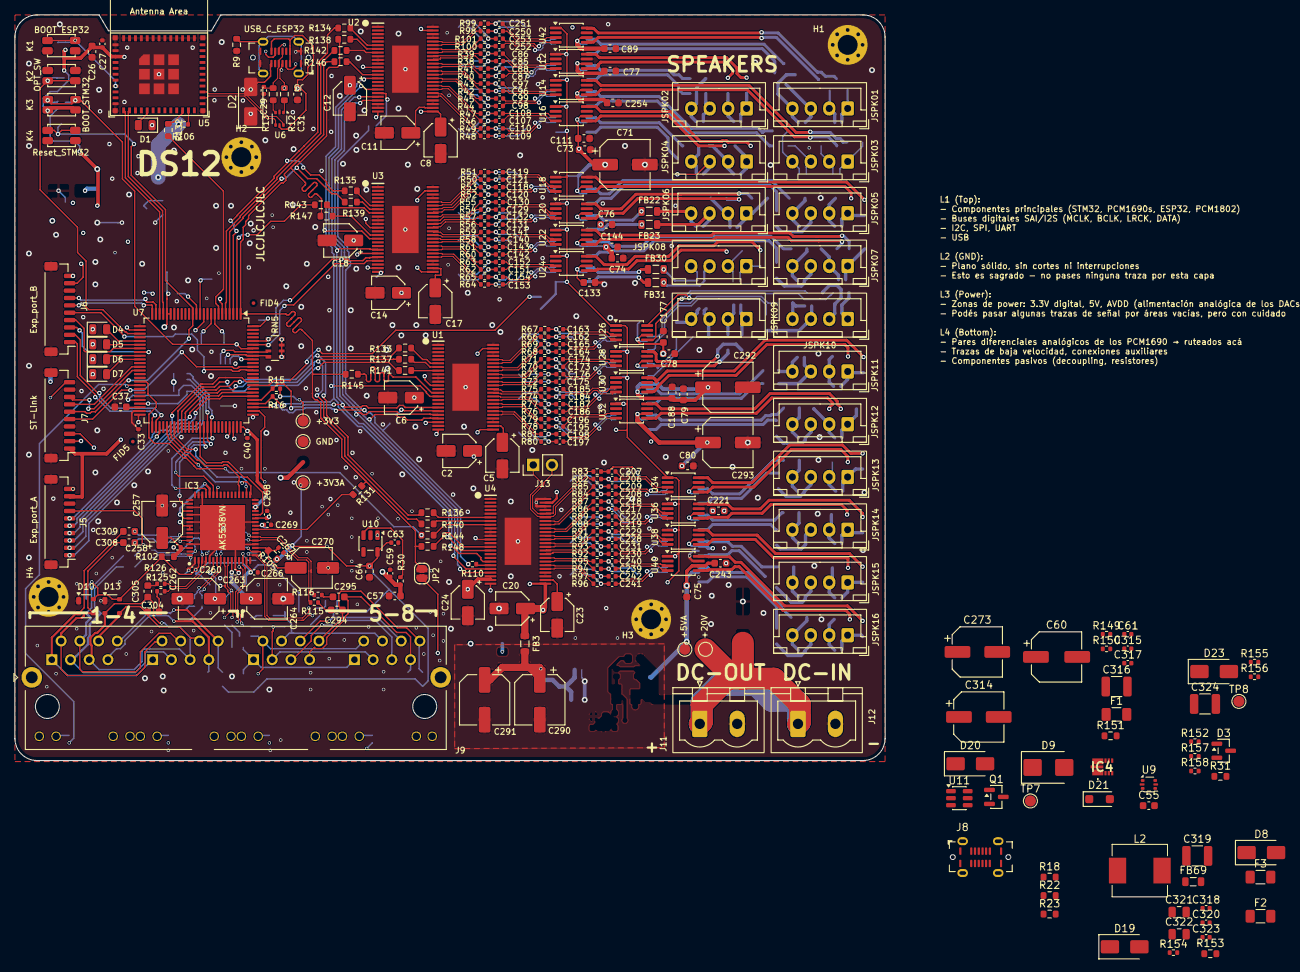
[picture p105: board DS.kicad_pcb from above]

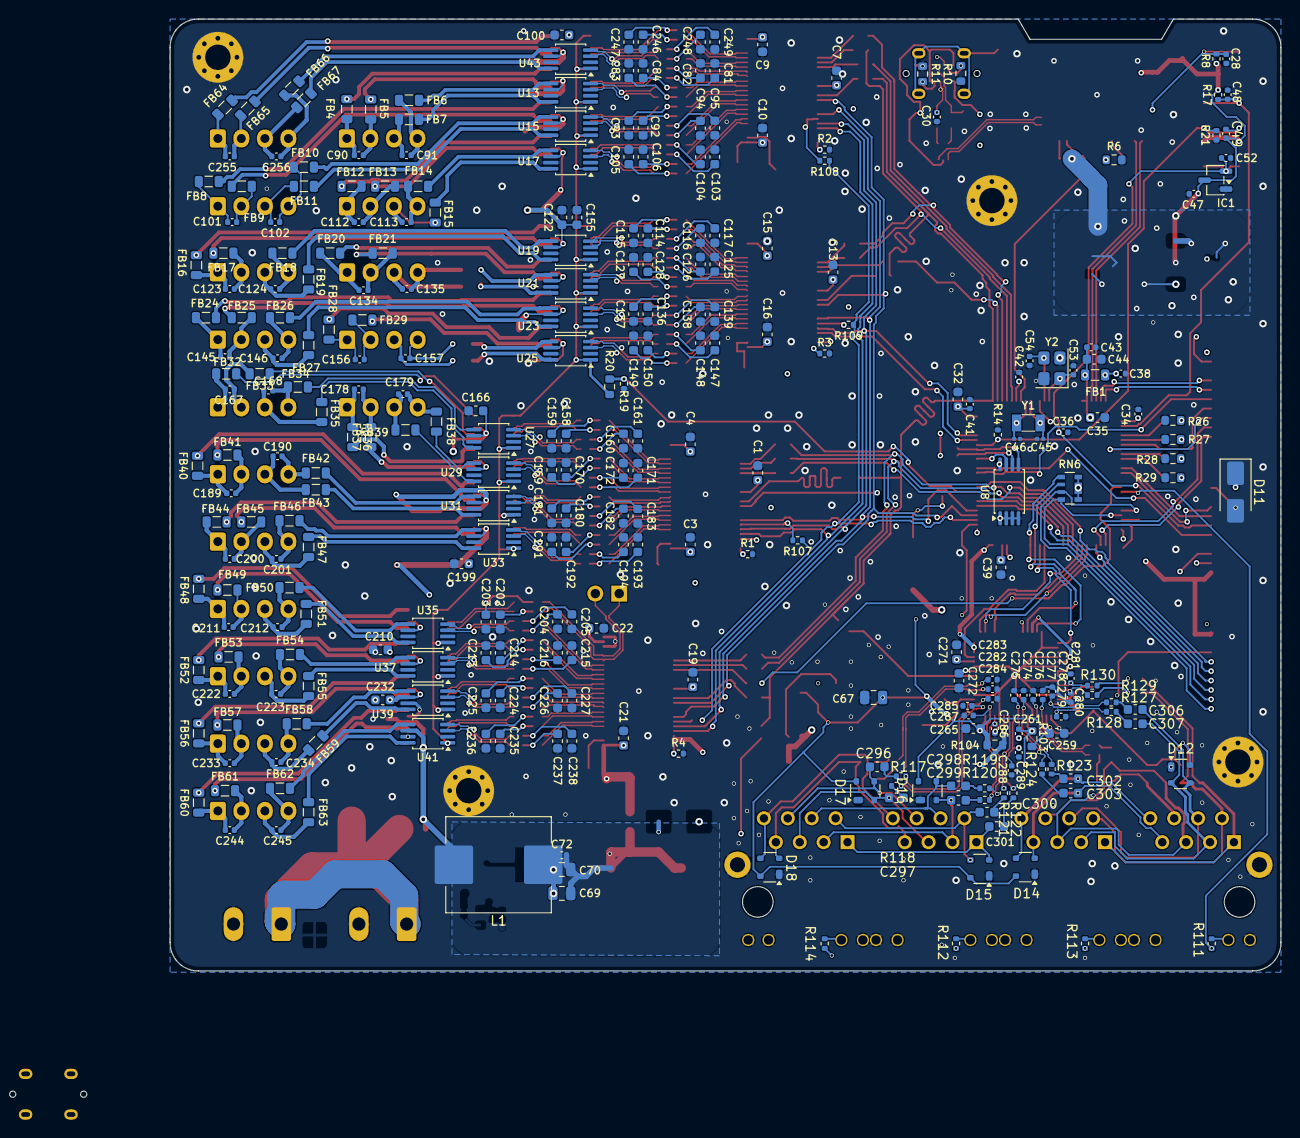
[picture p106: board DS.kicad_pcb from below]

Board: 4 copper layers, 118.1 x 101.2 mm, 647 parts (298 on the bottom side), 524 nets.
