bergamifer/DS-Project/hardware/DS/Versiones/DS7.kicad_pcb

## KiCad design hardware/DS/Versiones/DS7.kicad_pcb (2026-07-03)

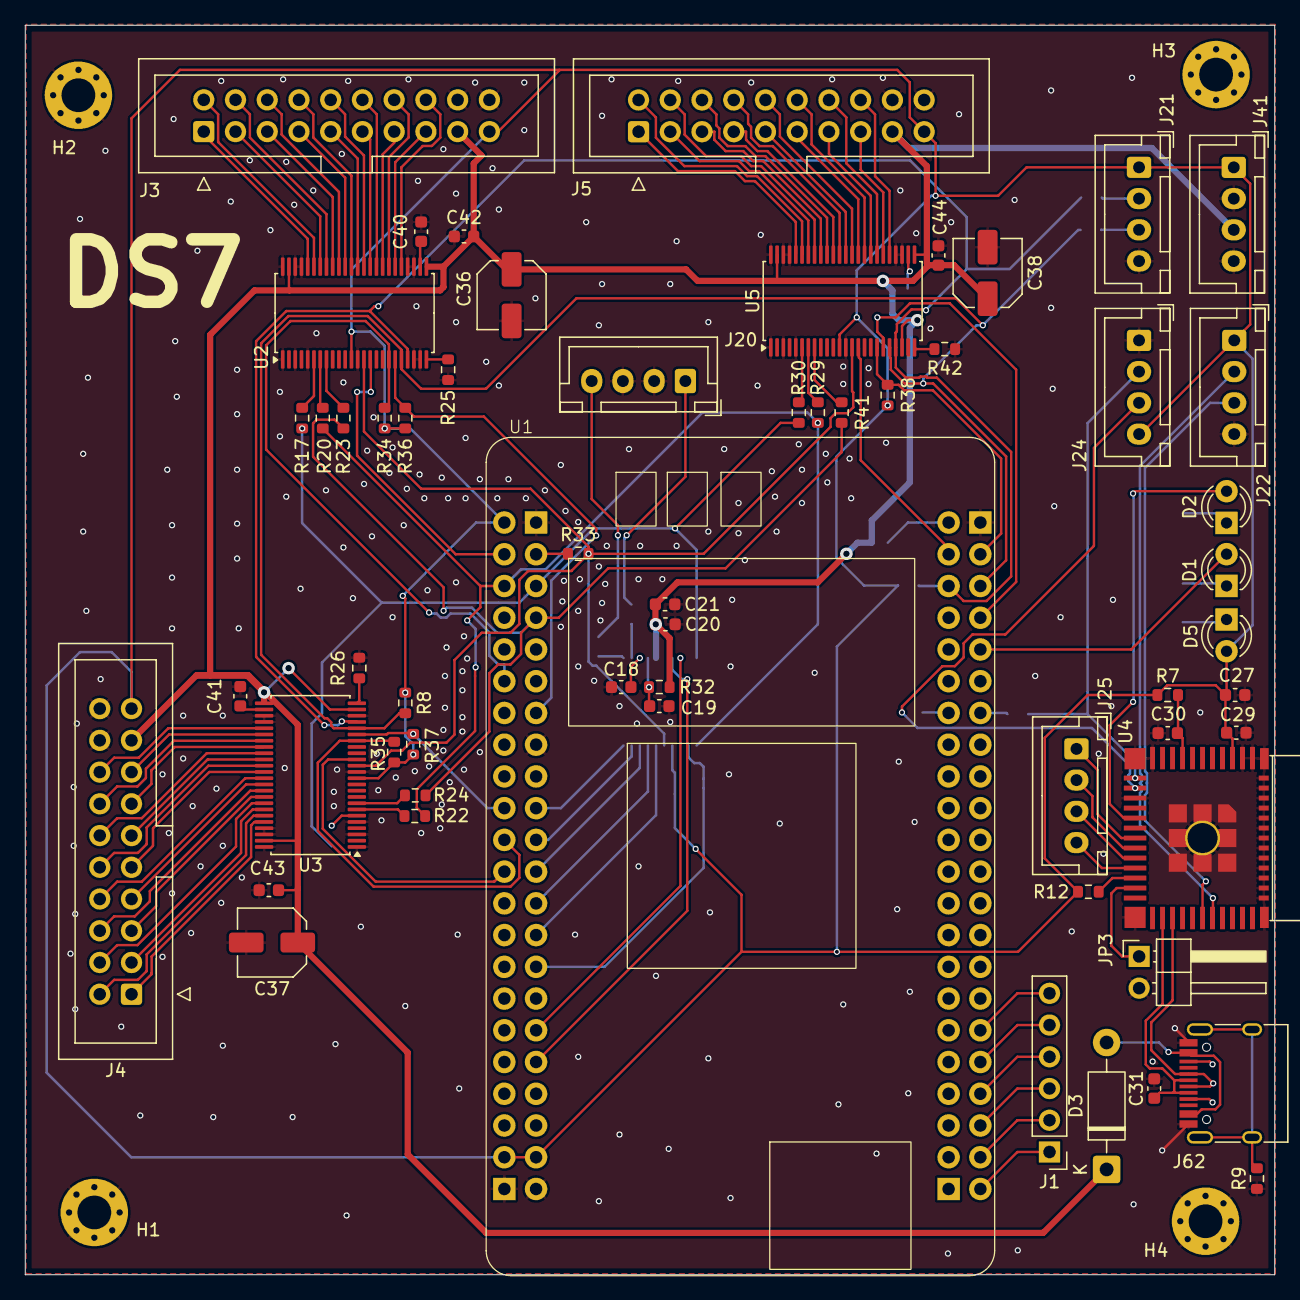
[picture p107: board DS7.kicad_pcb from above]

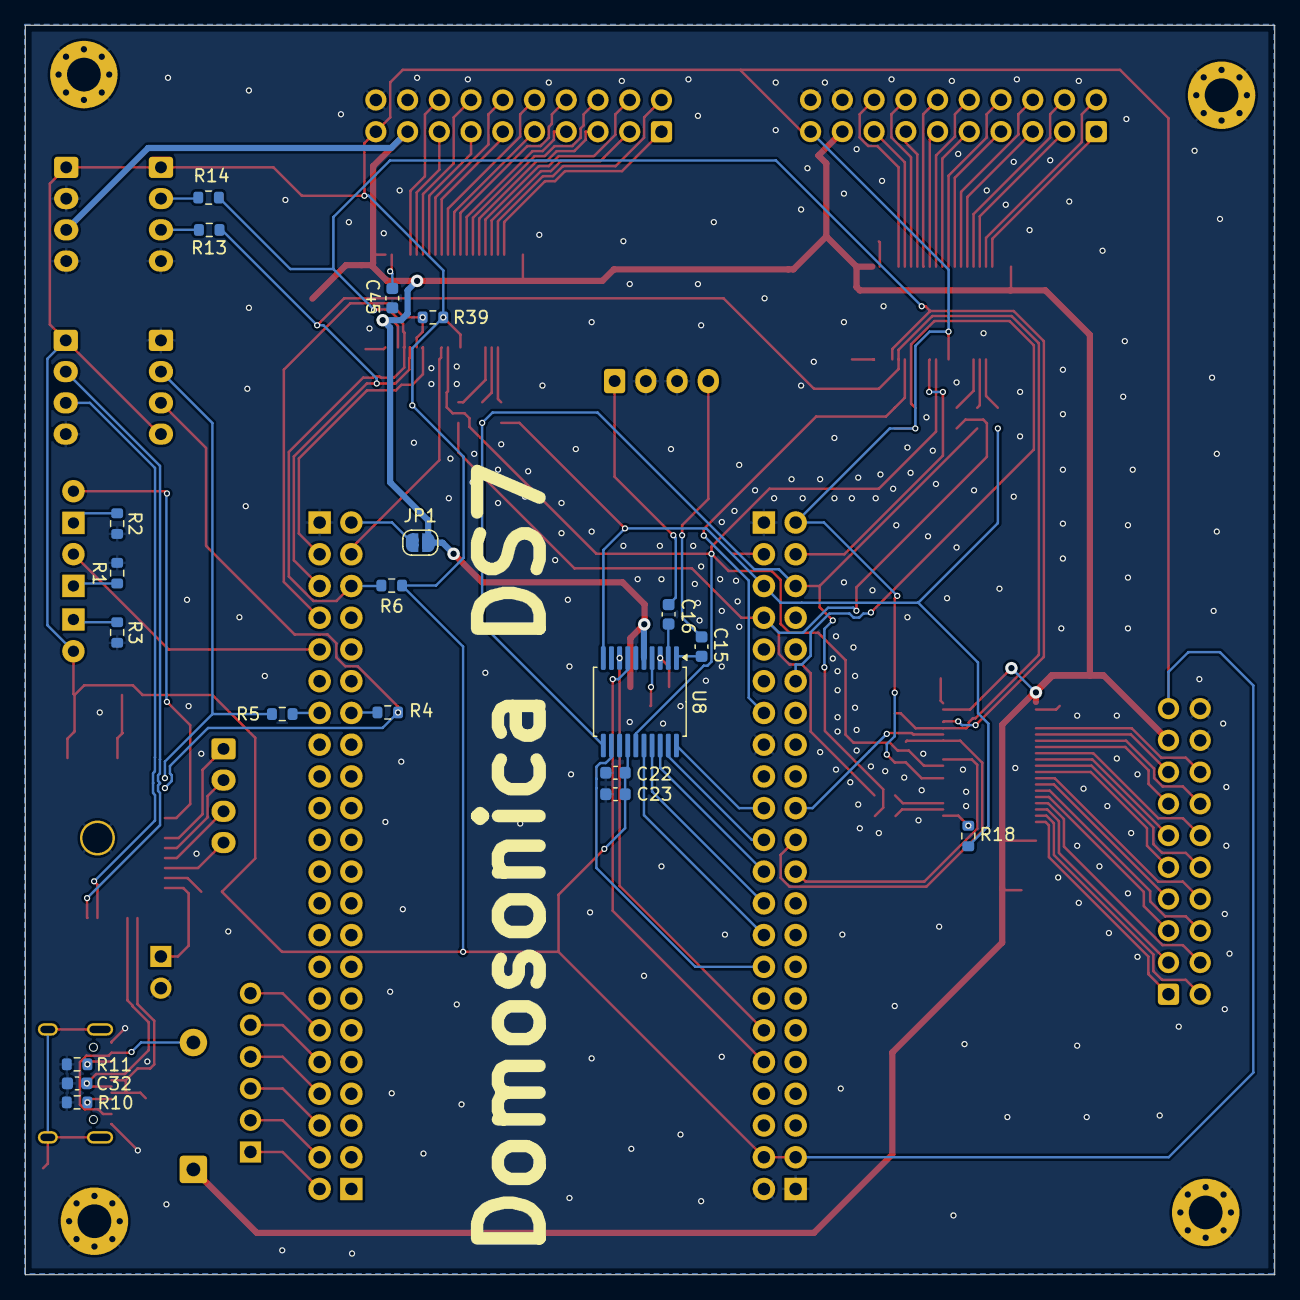
[picture p108: board DS7.kicad_pcb from below]

Board: 2 copper layers, 100.0 x 100.0 mm, 83 parts (20 on the bottom side), 129 nets.

Parts:
C15, C16, C40, C41, C42, C43, C44, C45: 1u; C_0603_1608Metric
C18, C19, C20, C23, C29, C30: 0.1u; C_0603_1608Metric
C21, C22, C27: 10u; C_0603_1608Metric
C31, C32: 22pF; C_0603_1608Metric
C36, C37, C38: 10u; C_Elec_5x5.4
D1, D2, D5: LED; LED_D3.0mm
D3: 1N5819; D_DO-41_SOD81_P10.16mm_Horizontal
H1, H2, H3, H4: MH; MountingHole_2.7mm_Pad_Via
J1: Optional header; PinHeader_1x06_P2.54mm_Vertical
J3, J4, J5: Conn_02x10_Odd_Even; IDC-Header_2x10_P2.54mm_Vertical
J20, J41: Conn_01x04; JST_XH_B4B-XH-A_1x04_P2.50mm_Vertical
J21: I2C; JST_XH_B4B-XH-A_1x04_P2.50mm_Vertical
J22: UART0_ESP32; JST_XH_B4B-XH-A_1x04_P2.50mm_Vertical
J24: UART1_ESP32; JST_XH_B4B-XH-A_1x04_P2.50mm_Vertical
J25: JTAG; JST_XH_B4B-XH-A_1x04_P2.50mm_Vertical
J62: USB_C_Receptacle_USB2.0_16P; USB_C_Receptacle_HRO_TYPE-C-31-M-12
JP1: Open; SolderJumper-2_P1.3mm_Open_RoundedPad1.0x1.5mm
JP3: BOOT_ESP32; PinHeader_1x02_P2.54mm_Horizontal
R1, R3, R25, R26, R32, R34, R35, R36, R37, R38, R39, R42: 1k; R_0603_1608Metric
R2, R4, R5: 220; R_0603_1608Metric
R6, R8, R10, R11: 5.1k; R_0603_1608Metric
R7, R12: 10k; R_0603_1608Metric
R9: 1M; R_0603_1608Metric
R13, R14: 22; R_0603_1608Metric
R17, R18, R20, R22, R23, R24, R29, R30, R33, R41: 51; R_0603_1608Metric
U1: MiniSTM32H7xx
U2, U3, U5: PCM1690; TSSOP-48_6.1x12.5mm_P0.5mm
U4: ESP32-C3-MINI-1; ESP32-C3-MINI-1_HandSoldering
U8: PCM1802; SSOP-20_5.3x7.2mm_P0.65mm

Connections:
+5V: C20.2, C21.2, C36.1, C37.1, C38.1, C42.1, C43.1, C44.1, D3.1 (K), J3.17, J4.17, J5.17, J41.3, JP1.2 (B), R32.2, U2.25 (VCC1), U2.47 (VCC2), U3.23 (TEST/ADR1/RSV), U3.25 (VCC1), U3.47 (VCC2), U5.22 (MS/ADR0/RSV), U5.25 (VCC1), U5.47 (VCC2), U8.5 (VCC)
/ADC/FMT0: U1.B25 (PC4), U8.17 (FMT0)
/ADC/FMT1: U1.B23 (PA6), U8.18 (FMT1)
/ADC/MODE0: U1.B21 (PA4), U8.19 (MODE0)
/ADC/MODE1: U1.B19 (PA2), U8.20 (MODE1)
/ADC/OSR: U1.B27 (PB0), U8.16 (OSR)
/DAC0/AMUTEI: R34.2, U1.B12 (PC1), U2.18 (AMUTEI)
/DAC0/AMUTEO: R36.2, U1.B14 (PC3), U2.19 (AMUTEO)
/DAC0/V1: J3.1, U2.44 (VOUT1-)
/DAC0/V2: J3.2, U2.43 (VOUT1+)
/DAC0/V3: J3.3, U2.42 (VOUT2-)
/DAC0/V4: J3.4, U2.41 (VOUT2+)
/DAC0/V5: J3.5, U2.40 (VOUT3-)
/DAC0/V6: J3.6, U2.39 (VOUT3+)
/DAC0/V7: J3.7, U2.38 (VOUT4-)
/DAC0/V8: J3.8, U2.37 (VOUT4+)
/DAC0/V9: J3.9, U2.36 (VOUT5-)
/DAC0/V10: J3.10, U2.35 (VOUT5+)
/DAC0/V11: J3.11, U2.34 (VOUT6-)
/DAC0/V12: J3.12, U2.33 (VOUT6+)
/DAC0/V13: J3.13, U2.32 (VOUT7-)
/DAC0/V14: J3.14, U2.31 (VOUT7+)
/DAC0/V15: J3.15, U2.30 (VOUT8-)
/DAC0/V16: J3.16, U2.29 (VOUT8+)
/DAC1/AMUTEI: R35.2, U1.B22 (PA5), U3.18 (AMUTEI)
/DAC1/AMUTEO: R37.2, U1.B20 (PA3), U3.19 (AMUTEO)
/DAC1/RST: U1.B24 (PA7), U3.15 (RST)
/DAC1/V1: J4.1, U3.44 (VOUT1-)
/DAC1/V2: J4.2, U3.43 (VOUT1+)
/DAC1/V3: J4.3, U3.42 (VOUT2-)
/DAC1/V4: J4.4, U3.41 (VOUT2+)
/DAC1/V5: J4.5, U3.40 (VOUT3-)
/DAC1/V6: J4.6, U3.39 (VOUT3+)
/DAC1/V7: J4.7, U3.38 (VOUT4-)
/DAC1/V8: J4.8, U3.37 (VOUT4+)
/DAC1/V9: J4.9, U3.36 (VOUT5-)
/DAC1/V10: J4.10, U3.35 (VOUT5+)
/DAC1/V11: J4.11, U3.34 (VOUT6-)
/DAC1/V12: J4.12, U3.33 (VOUT6+)
/DAC1/V13: J4.13, U3.32 (VOUT7-)
/DAC1/V14: J4.14, U3.31 (VOUT7+)
/DAC1/V15: J4.15, U3.30 (VOUT8-)
/DAC1/V16: J4.16, U3.29 (VOUT8+)
/DAC2/AMUTEI: R38.2, U1.A3 (PE1), U5.18 (AMUTEI)
/DAC2/AMUTEO: R39.2, U1.A7 (PB7), U5.19 (AMUTEO)
/DAC2/RST: U1.A4 (PE0), U5.15 (RST)
/DAC2/V1: J5.1, U5.44 (VOUT1-)
/DAC2/V2: J5.2, U5.43 (VOUT1+)
/DAC2/V3: J5.3, U5.42 (VOUT2-)
/DAC2/V4: J5.4, U5.41 (VOUT2+)
/DAC2/V5: J5.5, U5.40 (VOUT3-)
/DAC2/V6: J5.6, U5.39 (VOUT3+)
/DAC2/V7: J5.7, U5.38 (VOUT4-)
/DAC2/V8: J5.8, U5.37 (VOUT4+)
/DAC2/V9: J5.9, U5.36 (VOUT5-)
/DAC2/V10: J5.10, U5.35 (VOUT5+)
/DAC2/V11: J5.11, U5.34 (VOUT6-)
/DAC2/V12: J5.12, U5.33 (VOUT6+)
/DAC2/V13: J5.13, U5.32 (VOUT7-)
/DAC2/V14: J5.14, U5.31 (VOUT7+)
/DAC2/V15: J5.15, U5.30 (VOUT8-)
/DAC2/V16: J5.16, U5.29 (VOUT8+)
/WeAct miniSTM32/UART TX: R4.2, U1.A14 (PD5)
/esp32-mini/UART1 - RX: J24.3, R4.1, U4.13 (GPIO1/ADC1_CH1/XTAL_32K_N)
/esp32-mini/UART1 - TX: J24.2, R5.1, U4.12 (GPIO0/ADC1_CH0/XTAL_32K_P)
GND: C18.1, C19.1, C20.1, C21.1, C22.1, C23.1, C27.1, C29.2, C30.2, C31.2, C32.2, C36.2, C37.2, C38.2, C40.2, C41.2, C42.2, C43.2, C44.2, C45.2, H1.1, H2.1, H3.1, H4.1, J3.18, J3.20, J4.18, J4.20, J5.18, J5.20, J20.2, J20.3, J21.4, J22.4, J24.1, J41.2, J41.4, J62.A1 (GND), J62.A12 (GND), J62.B1 (GND), J62.B12 (GND), JP3.2 (B), R1.2, R2.2, R3.2, R9.1, R10.1, R11.1, R25.2, R26.2, R42.2, U1.A1 (GND), U1.B1 (GND), U1.B15 (GND), U1.B43 (GND), U1.B44 (GND), U2.1 (RSV2), U2.3 (RSV2), U2.5 (RSV2), U2.13 (DGND), U2.22 (MS/ADR0/RSV), U2.23 (TEST/ADR1/RSV), U2.27 (AGND1), U2.28 (RSV2), U2.45 (RSV2), U2.46 (AGND2), U2.48 (RSV2), U3.1 (RSV2), U3.3 (RSV2), U3.5 (RSV2), U3.13 (DGND), U3.22 (MS/ADR0/RSV), U3.27 (AGND1), U3.28 (RSV2), U3.45 (RSV2), U3.46 (AGND2), U3.48 (RSV2), U4.1 (GND), U4.2 (GND), U4.11 (GND), U4.14 (GND), U4.36 (GND), U4.37 (GND), U4.38 (GND), U4.39 (GND), U4.40 (GND), U4.41 (GND), U4.42 (GND), U4.43 (GND), U4.44 (GND), U4.45 (GND), U4.46 (GND), U4.47 (GND), U4.48 (GND), U4.49 (GND), U4.50 (GND), U4.51 (GND), U4.52 (GND), U4.53 (GND), U5.1 (RSV2), U5.3 (RSV2), U5.5 (RSV2), U5.13 (DGND), U5.23 (TEST/ADR1/RSV), U5.27 (AGND1), U5.28 (RSV2), U5.45 (RSV2), U5.46 (AGND2), U5.48 (RSV2), U8.6 (AGND), U8.13 (DGND)
GPIO10: D2.2 (A), U4.16 (GPIO10)
I2C_SCL: R6.2, R14.1, U1.A6 (PB8), U2.21 (MC/SCL/FMT), U3.21 (MC/SCL/FMT), U5.21 (MC/SCL/FMT)
I2C_SDA: R8.2, R13.1, U1.A5 (PB9), U2.20 (MD/SDA/DEMP), U3.20 (MD/SDA/DEMP), U5.20 (MD/SDA/DEMP)
LCD_LED: U1.B33 (PE10), U8.8 (BYPAS)
LCD_SCL: U1.B35 (PE12), U8.7 (PDWN)
LED_STATUS: D1.2 (A), U1.A9 (PB5)
unnamed: D1.1 (K), R1.1
unnamed: D2.1 (K), R2.1
unnamed: D3.2 (A), J62.A4 (VBUS), J62.A9 (VBUS), J62.B4 (VBUS), J62.B9 (VBUS)
unnamed: D5.1 (K), R3.1
unnamed: J1.1, U1.A43 (PB13)
unnamed: J1.2, U1.A41 (PB15)
unnamed: J1.3, U1.A39 (PD9)
unnamed: J1.6, U1.A33 (PD15)
unnamed: C16.2, J20.1
unnamed: C15.2, J20.4
unnamed: J21.2, R14.2
unnamed: J21.3, R13.2
unnamed: J22.2, U4.31 (GPIO21/U0TXD)
unnamed: J22.3, U4.30 (GPIO20/U0RXD)
unnamed: J25.1, U4.18 (GPIO4/ADC1_CH4)
unnamed: J25.2, U4.19 (GPIO5/ADC2_CH0)
unnamed: J25.3, U4.20 (GPIO6)
unnamed: J25.4, U4.21 (GPIO7)
unnamed: J62.A5 (CC1), R10.2
unnamed: J62.B5 (CC2), R11.2
unnamed: J62.S1 (SHIELD), R9.2
unnamed: JP1.1 (A), U1.A2 (5V)
unnamed: JP3.1 (A), U4.23 (GPIO9)
unnamed: R20.1, U2.7 (BCK)
unnamed: R23.1, U2.8 (DIN1)
unnamed: R17.1, U2.6 (LRCK)
unnamed: R25.1, U2.24 (MODE)
unnamed: C40.1, U2.26 (VCOM)
unnamed: R22.1, U3.7 (BCK)
unnamed: R24.1, U3.8 (DIN1)
unnamed: R18.1, U3.6 (LRCK)
unnamed: R26.1, U3.24 (MODE)
unnamed: C41.1, U3.26 (VCOM)
unnamed: C30.1, R7.1, U4.8 (EN/CHIP_PU)
unnamed: R12.1, U4.22 (GPIO8)
unnamed: C31.1, J62.A7 (D-), J62.B7 (D-), U4.26 (GPIO18/USB_D-)
unnamed: C32.1, J62.A6 (D+), J62.B6 (D+), U4.27 (GPIO19/USB_D+)
unnamed: R29.1, U5.7 (BCK)
unnamed: R41.1, U5.8 (DIN1)
unnamed: R30.1, U5.6 (LRCK)
unnamed: R42.1, U5.24 (MODE)
unnamed: C45.1, U5.26 (VCOM)
unnamed: C15.1, U8.1 (VINL)
unnamed: C16.1, U8.2 (VINR)
unnamed: C18.2, U8.3 (VREF1)
unnamed: C19.2, R32.1, U8.4 (VREF2)
PB2: U1.B29 (PB2), U8.12 (DOUT)
PD6: R5.2, U1.A13 (PD6)
PD11: J1.4, U1.A37 (PD11)
PD13: J1.5, U1.A35 (PD13)
PE2: R33.1, U1.B3 (PE2)
PE3: U1.B4 (PE3), U2.15 (RST)
SAI1 MCLK: R33.2, U2.14 (SCKI), U3.14 (SCKI), U5.14 (SCKI), U8.15 (SCKI)
SAI1_FS_A: R17.2, R18.2, R30.2, U1.B5 (PE4), U8.10 (LRCK)
SAI1_SCK_A: R20.2, R22.2, R29.2, U1.B6 (PE5), U8.11 (BCK)
SAI1_SD_A: R23.2, R24.2, R41.2, U1.B7 (PE6)
VDD-MCU: C22.2, C23.2, C27.2, C29.1, D5.2 (A), J3.19, J4.19, J5.19, J21.1, J22.1, J24.4, J41.1, R6.1, R7.2, R8.1, R12.2, R34.1, R35.1, R36.1, R37.1, R38.1, R39.1, U1.B2 (3V3), U1.B41 (3V3), U1.B42 (3V3), U2.12 (VDD), U3.12 (VDD), U4.3 (3V3), U5.12 (VDD), U8.14 (VDD)
