bergamifer/DS-Project/hardware/DS/Versiones/DS9.kicad_pcb

## KiCad design hardware/DS/Versiones/DS9.kicad_pcb (2026-07-03)

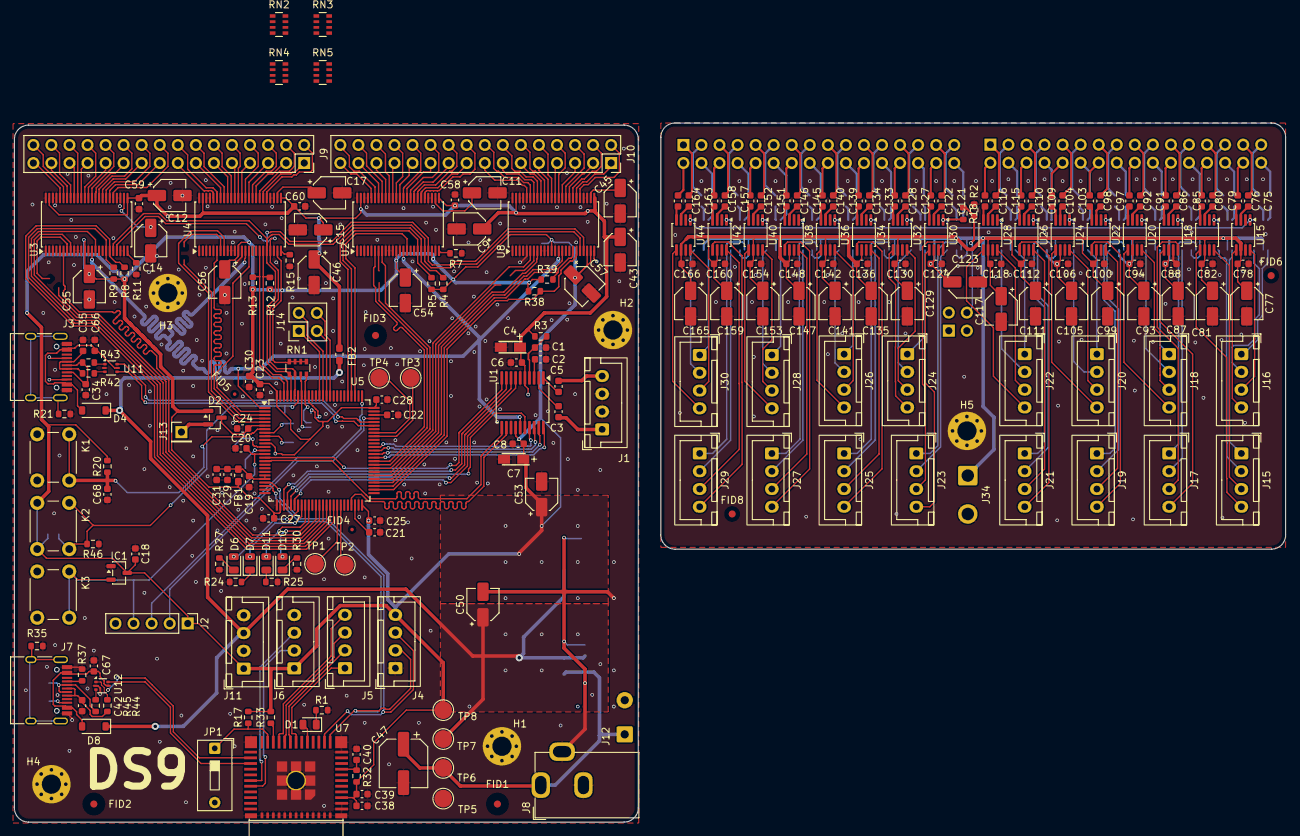
[picture p109: board DS9.kicad_pcb from above]

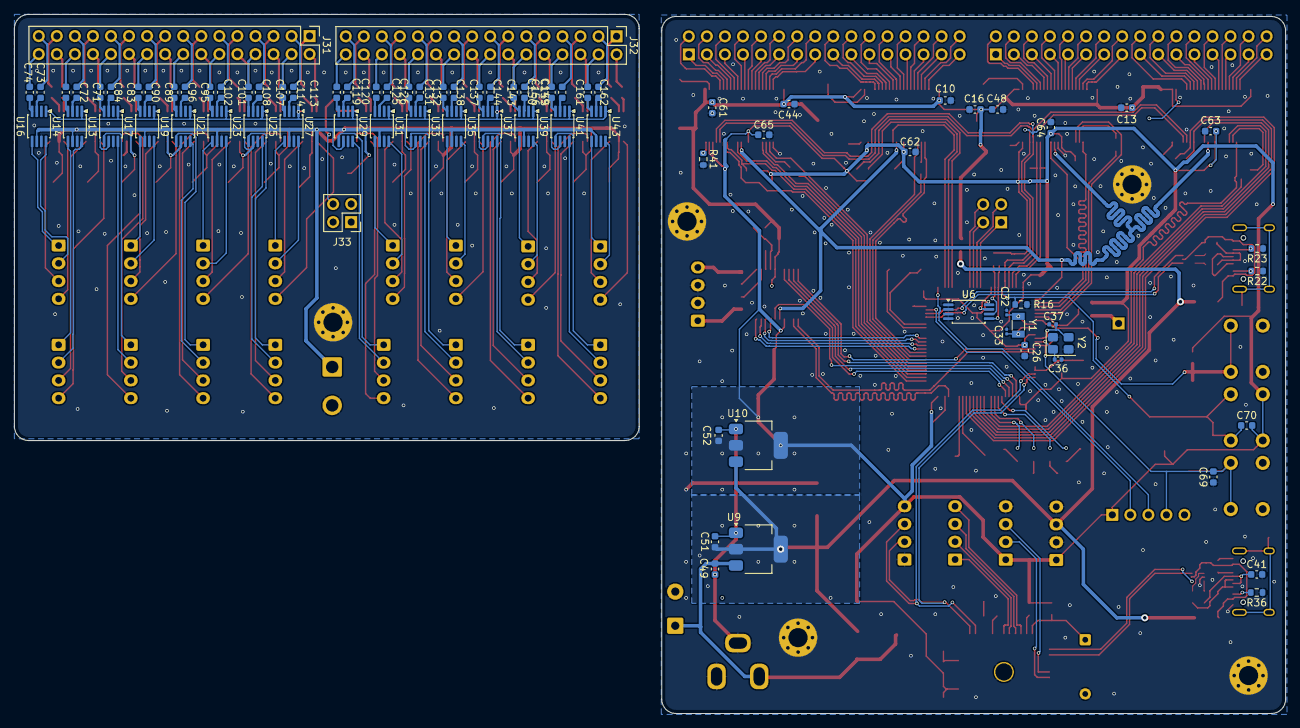
[picture p110: board DS9.kicad_pcb from below]

Board: 2 copper layers, 178.8 x 98.3 mm, 322 parts (82 on the bottom side), 399 nets.

Parts:
C1, C2, C6, C8, C18, C20, C24, C25, C26, C27, C28, C29, C30, C39, C40, C48, C49, C51, C52, C68, C69, C70, C71, C72, C73, C74, C75, C76, C79, C80, C83, C84, C85, C86, C89, C90, C91, C92, C95, C96, C97, C98, C101, C102, C103, C104, C107, C108, C109, C110, C113, C114, C115, C116, C119, C120, C121, C122, C125, C126, C127, C128, C131, C132, C133, C134, C137, C138, C139, C140, C143, C144, C145, C146, C149, C150, C151, C152, C155, C156, C157, C158, C161, C162, C163, C164: 0.1u; C_0603_1608Metric
C3, C5, C10, C13, C16, C19, C44, C58, C59, C60, C61, C62, C63, C64, C65, C78, C82, C88, C94, C100, C106, C112, C118, C124, C130, C136, C142, C148, C154, C160, C166: 1u; C_0603_1608Metric
C4, C7: 10u TANT; CAPPM3216X180N
C9, C11, C12, C14, C15, C17, C43, C45, C46, C50, C53, C54, C55, C56, C57, C77, C81, C87, C93, C99, C105, C111, C117, C123, C129, C135, C141, C147, C153, C159, C165: 10u EL; CP_Elec_4x5.7
C21, C22: 2.2u; C_0603_1608Metric
C23, C66, C67: 4.7u; C_0603_1608Metric
C31, C38: 10u cer; C_0603_1608Metric
C32, C33: 8.2pF; C_0201_0603Metric
C34, C35, C41, C42: 22p; C_0603_1608Metric
C36, C37: 18pF; C_0402_1005Metric
C47: 100u; CP_Elec_6.3x7.7
D1, D7: Red LED; LED_0805_2012Metric
D2: BAT54C; SOT-23
D4, D8: B5819W SL; D_SOD-123
D6: Yellow LED; LED_0805_2012Metric
D10: White LED; LED_0805_2012Metric
D11: Green LED; LED_0805_2012Metric
FB1, FB2: FerriteBead; L_0603_1608Metric_Pad1.05x0.95mm_HandSolder
FID1, FID2, FID3: Fiducial; Fiducial_1mm_Mask3mm
FID4, FID5: Fiducial; Fiducial_0.5mm_Mask1mm
FID6, FID8: Fiducial; Fiducial_1mm_Mask2mm
H1, H2, H3, H4, H5: MH; MountingHole_2.7mm_Pad_Via
IC1: MAX809TEUR+T; SOT-23-3
J1: Audio_IN; JST_XH_B4B-XH-A_1x04_P2.50mm_Vertical
J2: STM_Debug; PinHeader_1x05_P2.54mm_Vertical
J3, J7: USB_C; USB_C_Receptacle_HRO_TYPE-C-31-M-12
J4: UART1_ESP32; JST_XH_B4B-XH-A_1x04_P2.50mm_Vertical
J5: JTAG; JST_XH_B4B-XH-A_1x04_P2.50mm_Vertical
J6: UART0_ESP32; JST_XH_B4B-XH-A_1x04_P2.50mm_Vertical
J8: 12v; BarrelJack_CUI_PJ-102AH_Horizontal
J9, J10: Conn_02x16; PinSocket_2x16_P2.54mm_Vertical
J11: Opt_Vout; JST_XH_B4B-XH-A_1x04_P2.50mm_Vertical
J12: Conn_01x02; SolderWire-0.5sqmm_1x02_P4.8mm_D0.9mm_OD2.3mm
J13: VBat; PinHeader_1x01_P2.54mm_Vertical
J14: Extra_pins; PinHeader_2x02_P2.54mm_Vertical
J15, J16, J17, J18, J19, J20, J21, J22, J23, J24, J25, J26, J27, J28, J29, J30: SPK_OUT; JST_XH_B4B-XH-A_1x04_P2.50mm_Vertical
J31, J32: Conn_02x16; PinHeader_2x16_P2.54mm_Vertical
J33: Extra_pins; PinSocket_2x02_P2.54mm_Vertical
J34: Conn_01x02; SolderWire-1sqmm_1x02_P5.4mm_D1.4mm_OD2.7mm
JP1: BOOT_ESP32; SW_DIP_SPSTx01_Slide_9.78x4.72mm_W7.62mm_P2.54mm
K1, K2, K3: SW_Push; SW_PUSH_6mm
R1, R24: 150; R_0603_1608Metric
R2, R3, R4, R5, R7, R8, R9, R11, R12, R13, R15, R38, R39, R41: 1k; R_0603_1608Metric
R16, R17, R20, R32, R33, R46: 10k; R_0603_1608Metric
R18, R42, R43, R44, R45: 33; R_0603_1608Metric
R21, R35: 1M; R_0603_1608Metric
R22, R23, R36, R37: 5.1k; R_0603_1608Metric
R25: 100; R_0603_1608Metric
R27: 200; R_0603_1608Metric
R30: 82; R_0603_1608Metric
RN1: 4.7k; R_Array_Convex_4x0603
RN2, RN3, RN4, RN5: 33; R_Array_Convex_4x0603
TP1: TP_SAI1_FS; TestPoint_Pad_D2.5mm
TP2: TP_SAI_DEBUG; TestPoint_Pad_D2.5mm
TP3: TP_DEBUG; TestPoint_Pad_D2.5mm
TP4: TP_DEBUG2; TestPoint_Pad_D2.5mm
TP5: +12; TestPoint_Pad_D2.5mm
TP6: +5; TestPoint_Pad_D2.5mm
TP7: +3.3; TestPoint_Pad_D2.5mm
TP8: GND; TestPoint_Pad_D2.5mm
U1: PCM1802; SSOP-20_5.3x7.2mm_P0.65mm
U2, U3, U4, U8: PCM1690; TSSOP-48_6.1x12.5mm_P0.5mm
U5: STM32H743VITx; LQFP-100_14x14mm_P0.5mm
U6: CAT24C256; TSSOP-8_4.4x3mm_P0.65mm
U7: ESP32-C3-MINI-1; ESP32-C3-MINI-1_HandSoldering
U9: AP1117-50; SOT-223-3_TabPin2
U10: AP1117-33; SOT-223-3_TabPin2
U11, U12: USBLC6-2P6; SOT-666
U13, U14, U15, U16, U17, U18, U19, U20, U21, U22, U23, U24, U25, U26, U27, U28, U29, U30, U31, U32, U33, U34, U35, U36, U37, U38, U39, U40, U41, U42, U43, U44: PAM8302; MSOP-8_3x3mm_P0.65mm
Y1: 32.768K 7pF; Crystal_SMD_3215-2Pin_3.2x1.5mm
Y2: 25MHz 12pF; Crystal_SMD_3225-4Pin_3.2x2.5mm

Connections:
+3V3: C7.1, C8.2, C18.2, C23.1, C25.1, C26.1, C27.1, C28.1, C30.1, C38.2, C39.1, C52.1, C53.1, C54.1, C55.1, C56.1, C57.1, C62.1, C63.1, C64.1, C65.1, C70.2, D2.1, FB1.2, IC1.3 (VCC), J2.1, J4.4, J6.1, J11.1, K2.1, R4.1, R5.1, R8.1, R9.1, R12.1, R13.1, R17.2, R20.2, R32.2, R33.2, R38.1, R39.1, RN1.5 (R4.2), RN1.6 (R3.2), RN1.7 (R2.2), RN1.8 (R1.2), TP8.1, U1.14 (VDD), U2.12 (VDD), U2.22 (MS/ADR0/RSV), U3.12 (VDD), U4.12 (VDD), U4.23 (TEST/ADR1/RSV), U5.11 (VDD), U5.27 (VDD), U5.50 (VDD), U5.75 (VDD), U5.100 (VDD), U6.8 (VCC), U7.3 (3V3), U8.12 (VDD), U8.22 (MS/ADR0/RSV), U8.23 (TEST/ADR1/RSV), U10.2 (VO)
+5V: C50.1, C51.1, D4.1 (K), D8.1 (K), FB2.1, J11.3, TP7.1, U9.2 (VO), U10.3 (VI)
+5VA: C4.1, C6.2, C9.1, C10.1, C12.1, C13.1, C15.1, C16.1, C43.1, C44.1, C46.1, C48.1, C58.1, C59.1, C60.1, C61.1, FB2.2, R3.2, U1.5 (VCC), U2.25 (VCC1), U2.47 (VCC2), U3.25 (VCC1), U3.47 (VCC2), U4.25 (VCC1), U4.47 (VCC2), U8.25 (VCC1), U8.47 (VCC2)
+12V: C47.1, C49.1, J8.1, J12.1, TP6.1, U9.3 (VI)
/ADC/BYPASS: U1.8 (BYPAS), U5.30 (PA6)
/ADC/FMT0: U1.17 (FMT0), U5.64 (PC7)
/ADC/FMT1: U1.18 (FMT1), U5.63 (PC6)
/ADC/Frame Sync: U1.9 (FSYNC), U5.28 (PA4)
/ADC/MODE0: U1.19 (MODE0), U5.62 (PD15)
/ADC/MODE1: U1.20 (MODE1), U5.61 (PD14)
/ADC/OSR: U1.16 (OSR), U5.29 (PA5)
/ADC/PDWN: U1.7 (PDWN), U5.31 (PA7)
/ADC/SAI4_FS_B: U1.10 (LRCK), U5.15 (PC0)
/ADC/SAI4_SCK_B: U1.11 (BCK), U5.16 (PC1)
/ADC/SAI4_SD_B: U1.12 (DOUT), U5.47 (PB11)
/DAC0/AMUTEI: R9.2, U3.18 (AMUTEI), U5.41 (PE11)
/DAC0/AMUTEO: R8.2, U3.19 (AMUTEO), U5.42 (PE12)
/DAC0/RST: U3.15 (RST), U5.40 (PE10)
/DAC0/SAI_FS: RN3.1 (R1.1), U5.37 (PE7)
/DAC0/SAI_SCK: RN3.2 (R2.1), U5.38 (PE8)
/DAC0/SAI_SD: RN3.3 (R3.1), U5.39 (PE9)
/DAC0/V1: J9.31, U3.44 (VOUT1-)
/DAC0/V2: J9.32, U3.43 (VOUT1+)
/DAC0/V3: J9.29, U3.42 (VOUT2-)
/DAC0/V4: J9.30, U3.41 (VOUT2+)
/DAC0/V5: J9.27, U3.40 (VOUT3-)
/DAC0/V6: J9.28, U3.39 (VOUT3+)
/DAC0/V7: J9.25, U3.38 (VOUT4-)
/DAC0/V8: J9.26, U3.37 (VOUT4+)
/DAC0/V9: J9.23, U3.36 (VOUT5-)
/DAC0/V10: J9.24, U3.35 (VOUT5+)
/DAC0/V11: J9.21, U3.34 (VOUT6-)
/DAC0/V12: J9.22, U3.33 (VOUT6+)
/DAC0/V13: J9.19, U3.32 (VOUT7-)
/DAC0/V14: J9.20, U3.31 (VOUT7+)
/DAC0/V15: J9.17, U3.30 (VOUT8-)
/DAC0/V16: J9.18, U3.29 (VOUT8+)
/DAC1/AMUTEI: R13.2, U4.18 (AMUTEI), U5.98 (PE1)
/DAC1/AMUTEO: R12.2, U4.19 (AMUTEO), U5.97 (PE0)
/DAC1/RST: U4.15 (RST), U5.2 (PE3)
/DAC1/SAI_FS: RN4.1 (R1.1), U5.3 (PE4)
/DAC1/SAI_SCK: RN4.2 (R2.1), U5.4 (PE5)
/DAC1/SAI_SD: RN4.3 (R3.1), U5.5 (PE6)
/DAC1/V1: J9.15, U4.44 (VOUT1-)
/DAC1/V2: J9.16, U4.43 (VOUT1+)
/DAC1/V3: J9.13, U4.42 (VOUT2-)
/DAC1/V4: J9.14, U4.41 (VOUT2+)
/DAC1/V5: J9.11, U4.40 (VOUT3-)
/DAC1/V6: J9.12, U4.39 (VOUT3+)
/DAC1/V7: J9.9, U4.38 (VOUT4-)
/DAC1/V8: J9.10, U4.37 (VOUT4+)
/DAC1/V9: J9.7, U4.36 (VOUT5-)
/DAC1/V10: J9.8, U4.35 (VOUT5+)
/DAC1/V11: J9.5, U4.34 (VOUT6-)
/DAC1/V12: J9.6, U4.33 (VOUT6+)
/DAC1/V13: J9.3, U4.32 (VOUT7-)
/DAC1/V14: J9.4, U4.31 (VOUT7+)
/DAC1/V15: J9.1, U4.30 (VOUT8-)
/DAC1/V16: J9.2, U4.29 (VOUT8+)
/DAC2/AMUTEI: R5.2, U2.18 (AMUTEI), U5.79 (PC11)
/DAC2/AMUTEO: R4.2, U2.19 (AMUTEO), U5.80 (PC12)
/DAC2/RST: U2.15 (RST), U5.78 (PC10)
/DAC2/SAI_FS: RN2.1 (R1.1), U5.60 (PD13)
/DAC2/SAI_SCK: RN2.2 (R2.1), U5.59 (PD12)
/DAC2/SAI_SD: RN2.3 (R3.1), U5.58 (PD11)
/DAC2/V1: J10.31, U2.44 (VOUT1-)
/DAC2/V2: J10.32, U2.43 (VOUT1+)
/DAC2/V3: J10.29, U2.42 (VOUT2-)
/DAC2/V4: J10.30, U2.41 (VOUT2+)
/DAC2/V5: J10.27, U2.40 (VOUT3-)
/DAC2/V6: J10.28, U2.39 (VOUT3+)
/DAC2/V7: J10.25, U2.38 (VOUT4-)
/DAC2/V8: J10.26, U2.37 (VOUT4+)
/DAC2/V9: J10.23, U2.36 (VOUT5-)
/DAC2/V10: J10.24, U2.35 (VOUT5+)
/DAC2/V11: J10.21, U2.34 (VOUT6-)
/DAC2/V12: J10.22, U2.33 (VOUT6+)
/DAC2/V13: J10.19, U2.32 (VOUT7-)
/DAC2/V14: J10.20, U2.31 (VOUT7+)
/DAC2/V15: J10.17, U2.30 (VOUT8-)
/DAC2/V16: J10.18, U2.29 (VOUT8+)
/DAC3/AMUTEI: R39.2, U5.53 (PB14), U8.18 (AMUTEI)
/DAC3/AMUTEO: R38.2, U5.52 (PB13), U8.19 (AMUTEO)
/DAC3/RST: U5.54 (PB15), U8.15 (RST)
/DAC3/SAI_FS: RN5.1 (R1.1), U5.57 (PD10)
/DAC3/SAI_SCK: RN5.2 (R2.1), U5.56 (PD9)
/DAC3/SAI_SD: RN5.3 (R3.1), U5.55 (PD8)
/DAC3/V1: J10.15, U8.44 (VOUT1-)
/DAC3/V2: J10.16, U8.43 (VOUT1+)
/DAC3/V3: J10.13, U8.42 (VOUT2-)
/DAC3/V4: J10.14, U8.41 (VOUT2+)
/DAC3/V5: J10.11, U8.40 (VOUT3-)
/DAC3/V6: J10.12, U8.39 (VOUT3+)
/DAC3/V7: J10.9, U8.38 (VOUT4-)
/DAC3/V8: J10.10, U8.37 (VOUT4+)
/DAC3/V9: J10.7, U8.36 (VOUT5-)
/DAC3/V10: J10.8, U8.35 (VOUT5+)
/DAC3/V11: J10.5, U8.34 (VOUT6-)
/DAC3/V12: J10.6, U8.33 (VOUT6+)
/DAC3/V13: J10.3, U8.32 (VOUT7-)
/DAC3/V14: J10.4, U8.31 (VOUT7+)
/DAC3/V15: J10.1, U8.30 (VOUT8-)
/DAC3/V16: J10.2, U8.29 (VOUT8+)
/HAT_Amplifiers/ALL_AMPS/AMP1: C73.2, J31.31
/HAT_Amplifiers/ALL_AMPS/AMP2: C74.1, J31.32
/HAT_Amplifiers/ALL_AMPS/AMP3: C75.2, J31.29
/HAT_Amplifiers/ALL_AMPS/AMP4: C76.1, J31.30
/HAT_Amplifiers/ALL_AMPS/AMP5: C71.2, J31.27
/HAT_Amplifiers/ALL_AMPS/AMP6: C72.1, J31.28
/HAT_Amplifiers/ALL_AMPS/AMP7: C79.2, J31.25
/HAT_Amplifiers/ALL_AMPS/AMP8: C80.1, J31.26
/HAT_Amplifiers/ALL_AMPS/AMP9: C83.2, J31.23
/HAT_Amplifiers/ALL_AMPS/AMP10: C84.1, J31.24
/HAT_Amplifiers/ALL_AMPS/AMP11: C85.2, J31.21
/HAT_Amplifiers/ALL_AMPS/AMP12: C86.1, J31.22
/HAT_Amplifiers/ALL_AMPS/AMP13: C89.2, J31.19
/HAT_Amplifiers/ALL_AMPS/AMP14: C90.1, J31.20
/HAT_Amplifiers/ALL_AMPS/AMP15: C91.2, J31.17
/HAT_Amplifiers/ALL_AMPS/AMP16: C92.1, J31.18
/HAT_Amplifiers/ALL_AMPS/AMP17: C95.2, J31.15
/HAT_Amplifiers/ALL_AMPS/AMP18: C96.1, J31.16
/HAT_Amplifiers/ALL_AMPS/AMP19: C97.2, J31.13
/HAT_Amplifiers/ALL_AMPS/AMP20: C98.1, J31.14
/HAT_Amplifiers/ALL_AMPS/AMP21: C101.2, J31.11
/HAT_Amplifiers/ALL_AMPS/AMP22: C102.1, J31.12
/HAT_Amplifiers/ALL_AMPS/AMP23: C103.2, J31.9
/HAT_Amplifiers/ALL_AMPS/AMP24: C104.1, J31.10
/HAT_Amplifiers/ALL_AMPS/AMP25: C107.2, J31.7
/HAT_Amplifiers/ALL_AMPS/AMP26: C108.1, J31.8
/HAT_Amplifiers/ALL_AMPS/AMP27: C109.2, J31.5
/HAT_Amplifiers/ALL_AMPS/AMP28: C110.1, J31.6
/HAT_Amplifiers/ALL_AMPS/AMP29: C113.2, J31.3
/HAT_Amplifiers/ALL_AMPS/AMP30: C114.1, J31.4
/HAT_Amplifiers/ALL_AMPS/AMP31: C115.2, J31.1
/HAT_Amplifiers/ALL_AMPS/AMP32: C116.1, J31.2
/HAT_Amplifiers/ALL_AMPS/AMP33: C119.2, J32.31
/HAT_Amplifiers/ALL_AMPS/AMP34: C120.1, J32.32
/HAT_Amplifiers/ALL_AMPS/AMP35: C121.2, J32.29
/HAT_Amplifiers/ALL_AMPS/AMP36: C122.1, J32.30
/HAT_Amplifiers/ALL_AMPS/AMP37: C125.2, J32.27
/HAT_Amplifiers/ALL_AMPS/AMP38: C126.1, J32.28
/HAT_Amplifiers/ALL_AMPS/AMP39: C127.2, J32.25
/HAT_Amplifiers/ALL_AMPS/AMP40: C128.1, J32.26
/HAT_Amplifiers/ALL_AMPS/AMP41: C131.2, J32.23
/HAT_Amplifiers/ALL_AMPS/AMP42: C132.1, J32.24
/HAT_Amplifiers/ALL_AMPS/AMP43: C133.2, J32.21
/HAT_Amplifiers/ALL_AMPS/AMP44: C134.1, J32.22
/HAT_Amplifiers/ALL_AMPS/AMP45: C137.2, J32.19
/HAT_Amplifiers/ALL_AMPS/AMP46: C138.1, J32.20
/HAT_Amplifiers/ALL_AMPS/AMP47: C139.2, J32.17
/HAT_Amplifiers/ALL_AMPS/AMP48: C140.1, J32.18
/HAT_Amplifiers/ALL_AMPS/AMP49: C143.2, J32.15
/HAT_Amplifiers/ALL_AMPS/AMP50: C144.1, J32.16
/HAT_Amplifiers/ALL_AMPS/AMP51: C145.2, J32.13
/HAT_Amplifiers/ALL_AMPS/AMP52: C146.1, J32.14
/HAT_Amplifiers/ALL_AMPS/AMP53: C149.2, J32.11
/HAT_Amplifiers/ALL_AMPS/AMP54: C150.1, J32.12
/HAT_Amplifiers/ALL_AMPS/AMP55: C151.2, J32.9
/HAT_Amplifiers/ALL_AMPS/AMP56: C152.1, J32.10
/HAT_Amplifiers/ALL_AMPS/AMP57: C155.2, J32.7
/HAT_Amplifiers/ALL_AMPS/AMP58: C156.1, J32.8
/HAT_Amplifiers/ALL_AMPS/AMP59: C157.2, J32.5
/HAT_Amplifiers/ALL_AMPS/AMP60: C158.1, J32.6
/HAT_Amplifiers/ALL_AMPS/AMP61: C161.2, J32.3
/HAT_Amplifiers/ALL_AMPS/AMP62: C162.1, J32.4
/HAT_Amplifiers/ALL_AMPS/AMP63: C163.2, J32.1
/HAT_Amplifiers/ALL_AMPS/AMP64: C164.1, J32.2
/HAT_Amplifiers/ALL_AMPS/SD: R18.2, U13.1 (~SD), U14.1 (~SD), U15.1 (~SD), U16.1 (~SD), U17.1 (~SD), U18.1 (~SD), U19.1 (~SD), U20.1 (~SD), U21.1 (~SD), U22.1 (~SD), U23.1 (~SD), U24.1 (~SD), U25.1 (~SD), U26.1 (~SD), U27.1 (~SD), U28.1 (~SD), U29.1 (~SD), U30.1 (~SD), U31.1 (~SD), U32.1 (~SD), U33.1 (~SD), U34.1 (~SD), U35.1 (~SD), U36.1 (~SD), U37.1 (~SD), U38.1 (~SD), U39.1 (~SD), U40.1 (~SD), U41.1 (~SD), U42.1 (~SD), U43.1 (~SD), U44.1 (~SD)
/esp32-mini/GPIO18/USB_D-: U7.26 (GPIO18/USB_D-), U12.4 (I/O2)
/esp32-mini/GPIO19/USB_D+: U7.27 (GPIO19/USB_D+), U12.6 (I/O1)
/esp32-mini/UART1 - RX: J4.3, U5.22 (PA0), U7.13 (GPIO1/ADC1_CH1/XTAL_32K_N)
/esp32-mini/UART1 - TX: J4.2, U5.23 (PA1), U7.12 (GPIO0/ADC1_CH0/XTAL_32K_P)
/esp32-mini/VBUS: C67.1, D8.2 (A), J7.A4 (VBUS), J7.A9 (VBUS), J7.B4 (VBUS), J7.B9 (VBUS), U12.5 (VBUS)
/stm32_custom/BOOT0: C70.1, K2.2, R16.1, R46.2, U5.94 (BOOT0)
/stm32_custom/NRST: C20.2, C69.2, IC1.2 (~RESET), J2.4, K3.1, U5.14 (NRST)
/stm32_custom/PA13: J2.2, U5.72 (PA13)
/stm32_custom/PA14: J2.3, U5.76 (PA14)
/stm32_custom/PB0: D11.2 (A), U5.34 (PB0)
/stm32_custom/PB1: D10.2 (A), U5.35 (PB1)
/stm32_custom/PC4: D6.2 (A), U5.32 (PC4)
/stm32_custom/PC5: D7.2 (A), U5.33 (PC5)
/stm32_custom/PD4: J14.4, U5.85 (PD4)
/stm32_custom/PD5: J14.3, U5.86 (PD5)
/stm32_custom/PD6: J14.2, U5.87 (PD6)
/stm32_custom/PD7: J14.1, U5.88 (PD7)
/stm32_custom/PH0: C37.1, U5.12 (PH0), Y2.3
/stm32_custom/PH1: C36.2, U5.13 (PH1), Y2.1
/stm32_custom/VBAT: C24.2, D2.3, U5.6 (VBAT)
/stm32_custom/VBUS: C66.1, D4.2 (A), J3.A4 (VBUS), J3.A9 (VBUS), J3.B4 (VBUS), J3.B9 (VBUS), U11.5 (VBUS)
/stm32_custom/VREF+: C19.1, C29.1, C31.1, FB1.1, U5.20 (VREF+), U5.21 (VDDA)
EEPROM_WP: U5.91 (PB5), U6.7 (WP)
GND2: C77.2, C78.1, C81.2, C82.1, C87.2, C88.1, C93.2, C94.1, C99.2, C100.1, C105.2, C106.1, C111.2, C112.1, C117.2, C118.1, C123.2, C124.1, C129.2, C130.1, C135.2, C136.1, C141.2, C142.1, C147.2, C148.1, C153.2, C154.1, C159.2, C160.1, C165.2, C166.1, H5.1, J34.2, R2.2, U13.7 (GND), U14.7 (GND), U15.7 (GND), U16.7 (GND), U17.7 (GND), U18.7 (GND), U19.7 (GND), U20.7 (GND), U21.7 (GND), U22.7 (GND), U23.7 (GND), U24.7 (GND), U25.7 (GND), U26.7 (GND), U27.7 (GND), U28.7 (GND), U29.7 (GND), U30.7 (GND), U31.7 (GND), U32.7 (GND), U33.7 (GND), U34.7 (GND), U35.7 (GND), U36.7 (GND), U37.7 (GND), U38.7 (GND), U39.7 (GND), U40.7 (GND), U41.7 (GND), U42.7 (GND), U43.7 (GND), U44.7 (GND)
GNDA: C1.1, C2.1, C4.2, C6.1, C7.2, C8.1, C9.2, C10.2, C11.2, C12.2, C13.2, C14.2, C15.2, C16.2, C17.2, C18.1, C19.2, C20.1, C21.2, C22.2, C23.2, C24.1, C25.2, C26.2, C27.2, C28.2, C29.2, C30.2, C31.2, C32.2, C33.2, C34.1, C35.2, C36.1, C37.2, C38.1, C39.2, C40.2, C41.2, C42.2, C43.2, C44.2, C45.2, C46.2, C47.2, C48.2, C49.2, C50.2, C51.2, C52.2, C53.2, C54.2, C55.2, C56.2, C57.2, C58.2, C59.2, C60.2, C61.2, C62.2, C63.2, C64.2, C65.2, C66.2, C67.2, C68.1, C69.1, H1.1, H2.1, H3.1, H4.1, IC1.1 (GND), J1.2, J1.3, J2.5, J3.A1 (GND), J3.A12 (GND), J3.B1 (GND), J3.B12 (GND), J4.1, J6.4, J7.A1 (GND), J7.A12 (GND), J7.B1 (GND), J7.B12 (GND), J8.2, J8.3, J11.2, J11.4, J12.2, JP1.2 (B), K1.2, K3.2, R1.2, R7.2, R11.2, R15.2, R16.2, R21.1, R22.1, R23.1, R24.2, R25.2, R27.2, R30.2, R35.1, R36.1, R37.1, R41.2, R46.1, TP5.1, U1.6 (AGND), U1.13 (DGND), U2.1 (RSV2), U2.3 (RSV2), U2.5 (RSV2), U2.9 (DIN2), U2.10 (DIN3), U2.11 (DIN4), U2.13 (DGND), U2.23 (TEST/ADR1/RSV), U2.27 (AGND1), U2.28 (RSV2), U2.45 (RSV2), U2.46 (AGND2), U2.48 (RSV2), U3.1 (RSV2), U3.3 (RSV2), U3.5 (RSV2), U3.9 (DIN2), U3.10 (DIN3), U3.11 (DIN4), U3.13 (DGND), U3.22 (MS/ADR0/RSV), U3.23 (TEST/ADR1/RSV), U3.27 (AGND1), U3.28 (RSV2), U3.45 (RSV2), U3.46 (AGND2), U3.48 (RSV2), U4.1 (RSV2), U4.3 (RSV2), U4.5 (RSV2), U4.9 (DIN2), U4.10 (DIN3), U4.11 (DIN4), U4.13 (DGND), U4.22 (MS/ADR0/RSV), U4.27 (AGND1), U4.28 (RSV2), U4.45 (RSV2), U4.46 (AGND2), U4.48 (RSV2), U5.10 (VSS), U5.19 (VSSA), U5.26 (VSS), U5.49 (VSS), U5.74 (VSS), U5.99 (VSS), U6.1 (A0), U6.2 (A1), U6.3 (A2), U6.4 (GND), U7.1 (GND), U7.2 (GND), U7.11 (GND), U7.14 (GND), U7.36 (GND), U7.37 (GND), U7.38 (GND), U7.39 (GND), U7.40 (GND), U7.41 (GND), U7.42 (GND), U7.43 (GND), U7.44 (GND), U7.45 (GND), U7.46 (GND), U7.47 (GND), U7.48 (GND), U7.49 (GND), U7.50 (GND), U7.51 (GND), U7.52 (GND), U7.53 (GND), U8.1 (RSV2), U8.3 (RSV2), U8.5 (RSV2), U8.9 (DIN2), U8.10 (DIN3), U8.11 (DIN4), U8.13 (DGND), U8.27 (AGND1), U8.28 (RSV2), U8.45 (RSV2), U8.46 (AGND2), U8.48 (RSV2), U9.1 (GND), U10.1 (GND), U11.2 (GND), U12.2 (GND), Y2.2 (G), Y2.4 (G)
I2C1_SCL: RN1.2 (R2.1), U2.21 (MC/SCL/FMT), U3.21 (MC/SCL/FMT), U4.21 (MC/SCL/FMT), U5.95 (PB8), U8.21 (MC/SCL/FMT)
I2C1_SDA: RN1.1 (R1.1), U2.20 (MD/SDA/DEMP), U3.20 (MD/SDA/DEMP), U4.20 (MD/SDA/DEMP), U5.96 (PB9), U8.20 (MD/SDA/DEMP)
I2C3_SCL: RN1.4 (R4.1), U5.92 (PB6), U6.6 (SCL)
I2C3_SDA: RN1.3 (R3.1), U5.93 (PB7), U6.5 (SDA)
unnamed: C21.1, U5.48 (VCAP)
unnamed: C22.1, U5.73 (VCAP)
unnamed: C34.2, J3.A6 (D+), J3.B6 (D+), R43.2
unnamed: C35.1, J3.A7 (D-), J3.B7 (D-), R42.2
unnamed: C41.1, J7.A7 (D-), J7.B7 (D-), R45.1
unnamed: C42.1, J7.A6 (D+), J7.B6 (D+), R44.1
unnamed: D1.2 (A), U7.16 (GPIO10)
unnamed: D1.1 (K), R1.1
unnamed: D6.1 (K), R27.1
unnamed: D7.1 (K), R24.1
unnamed: D10.1 (K), R30.1
unnamed: D11.1 (K), R25.1
unnamed: C3.2, J1.1
unnamed: C5.2, J1.4
unnamed: J3.A5 (CC1), R23.2
unnamed: J3.B5 (CC2), R22.2
unnamed: J3.S1 (SHIELD), R21.2
unnamed: J5.1, U7.18 (GPIO4/ADC1_CH4)
unnamed: J5.2, U7.19 (GPIO5/ADC2_CH0)
unnamed: J5.3, U7.20 (GPIO6)
unnamed: J5.4, U7.21 (GPIO7)
unnamed: J6.2, U7.31 (GPIO21/U0TXD)
unnamed: J6.3, U7.30 (GPIO20/U0RXD)
unnamed: J7.A5 (CC1), R37.2
unnamed: J7.B5 (CC2), R36.2
unnamed: J7.S1 (SHIELD), R35.2
unnamed: J15.1, U13.5 (OUT+)
unnamed: J15.2, U13.8 (OUT-)
unnamed: J15.3, U16.8 (OUT-)
unnamed: J15.4, U16.5 (OUT+)
unnamed: J16.1, U14.5 (OUT+)
unnamed: J16.2, U14.8 (OUT-)
unnamed: J16.3, U15.8 (OUT-)
unnamed: J16.4, U15.5 (OUT+)
unnamed: J17.1, U17.5 (OUT+)
unnamed: J17.2, U17.8 (OUT-)
unnamed: J17.3, U18.8 (OUT-)
unnamed: J17.4, U18.5 (OUT+)
unnamed: J18.1, U19.5 (OUT+)
unnamed: J18.2, U19.8 (OUT-)
unnamed: J18.3, U20.8 (OUT-)
unnamed: J18.4, U20.5 (OUT+)
unnamed: J19.1, U21.5 (OUT+)
unnamed: J19.2, U21.8 (OUT-)
unnamed: J19.3, U22.8 (OUT-)
unnamed: J19.4, U22.5 (OUT+)
unnamed: J20.1, U23.5 (OUT+)
unnamed: J20.2, U23.8 (OUT-)
unnamed: J20.3, U24.8 (OUT-)
unnamed: J20.4, U24.5 (OUT+)
unnamed: J21.1, U25.5 (OUT+)
unnamed: J21.2, U25.8 (OUT-)
unnamed: J21.3, U26.8 (OUT-)
unnamed: J21.4, U26.5 (OUT+)
unnamed: J22.1, U27.5 (OUT+)
unnamed: J22.2, U27.8 (OUT-)
unnamed: J22.3, U28.8 (OUT-)
unnamed: J22.4, U28.5 (OUT+)
unnamed: J23.1, U29.5 (OUT+)
unnamed: J23.2, U29.8 (OUT-)
unnamed: J23.3, U30.8 (OUT-)
unnamed: J23.4, U30.5 (OUT+)
unnamed: J24.1, U31.5 (OUT+)
unnamed: J24.2, U31.8 (OUT-)
unnamed: J24.3, U32.8 (OUT-)
unnamed: J24.4, U32.5 (OUT+)
unnamed: J25.1, U33.5 (OUT+)
unnamed: J25.2, U33.8 (OUT-)
unnamed: J25.3, U34.8 (OUT-)
unnamed: J25.4, U34.5 (OUT+)
unnamed: J26.1, U35.5 (OUT+)
unnamed: J26.2, U35.8 (OUT-)
unnamed: J26.3, U36.8 (OUT-)
unnamed: J26.4, U36.5 (OUT+)
unnamed: J27.1, U37.5 (OUT+)
unnamed: J27.2, U37.8 (OUT-)
unnamed: J27.3, U38.8 (OUT-)
unnamed: J27.4, U38.5 (OUT+)
unnamed: J28.1, U39.5 (OUT+)
unnamed: J28.2, U39.8 (OUT-)
unnamed: J28.3, U40.8 (OUT-)
unnamed: J28.4, U40.5 (OUT+)
unnamed: J29.1, U41.5 (OUT+)
unnamed: J29.2, U41.8 (OUT-)
unnamed: J29.3, U42.8 (OUT-)
unnamed: J29.4, U42.5 (OUT+)
unnamed: J30.1, U43.5 (OUT+)
unnamed: J30.2, U43.8 (OUT-)
unnamed: J30.3, U44.8 (OUT-)
unnamed: J30.4, U44.5 (OUT+)
unnamed: J33.4, R2.1, R18.1
unnamed: JP1.1 (A), R17.1, U7.23 (GPIO9)
unnamed: RN2.8 (R1.2), U2.6 (LRCK)
unnamed: RN2.7 (R2.2), U2.7 (BCK)
unnamed: RN2.6 (R3.2), U2.8 (DIN1)
unnamed: RN2.5 (R4.2), U2.14 (SCKI)
unnamed: RN3.8 (R1.2), U3.6 (LRCK)
unnamed: RN3.7 (R2.2), U3.7 (BCK)
unnamed: RN3.6 (R3.2), U3.8 (DIN1)
unnamed: RN3.5 (R4.2), U3.14 (SCKI)
unnamed: RN4.8 (R1.2), U4.6 (LRCK)
unnamed: RN4.7 (R2.2), U4.7 (BCK)
unnamed: RN4.6 (R3.2), U4.8 (DIN1)
unnamed: RN4.5 (R4.2), U4.14 (SCKI)
unnamed: RN5.8 (R1.2), U8.6 (LRCK)
unnamed: RN5.7 (R2.2), U8.7 (BCK)
unnamed: RN5.6 (R3.2), U8.8 (DIN1)
unnamed: RN5.5 (R4.2), U8.14 (SCKI)
unnamed: C5.1, U1.1 (VINL)
unnamed: C3.1, U1.2 (VINR)
unnamed: C2.2, U1.3 (VREF1)
unnamed: C1.2, R3.1, U1.4 (VREF2)
unnamed: R7.1, U2.24 (MODE)
unnamed: C11.1, U2.26 (VCOM)
unnamed: R11.1, U3.24 (MODE)
unnamed: C14.1, U3.26 (VCOM)
unnamed: R15.1, U4.24 (MODE)
unnamed: C17.1, U4.26 (VCOM)
unnamed: TP3.1, U5.67 (PA8)
unnamed: TP4.1, U5.68 (PA9)
unnamed: C32.1, U5.8 (PC14), Y1.2
unnamed: C33.1, U5.9 (PC15), Y1.1
unnamed: TP1.1, U5.43 (PE13)
unnamed: TP2.1, U5.44 (PE14)
unnamed: C40.1, R32.1, U7.8 (EN/CHIP_PU)
unnamed: R33.1, U7.22 (GPIO8)
unnamed: R41.1, U8.24 (MODE)
unnamed: C45.1, U8.26 (VCOM)
unnamed: C71.1, U13.3 (IN+)
unnamed: C72.2, U13.4 (IN-)
unnamed: C73.1, U14.3 (IN+)
unnamed: C74.2, U14.4 (IN-)
unnamed: C75.1, U15.3 (IN+)
unnamed: C76.2, U15.4 (IN-)
unnamed: C79.1, U16.3 (IN+)
unnamed: C80.2, U16.4 (IN-)
unnamed: C83.1, U17.3 (IN+)
unnamed: C84.2, U17.4 (IN-)
unnamed: C85.1, U18.3 (IN+)
unnamed: C86.2, U18.4 (IN-)
unnamed: C89.1, U19.3 (IN+)
unnamed: C90.2, U19.4 (IN-)
unnamed: C91.1, U20.3 (IN+)
unnamed: C92.2, U20.4 (IN-)
unnamed: C95.1, U21.3 (IN+)
unnamed: C96.2, U21.4 (IN-)
unnamed: C97.1, U22.3 (IN+)
unnamed: C98.2, U22.4 (IN-)
unnamed: C101.1, U23.3 (IN+)
unnamed: C102.2, U23.4 (IN-)
unnamed: C103.1, U24.3 (IN+)
unnamed: C104.2, U24.4 (IN-)
unnamed: C107.1, U25.3 (IN+)
unnamed: C108.2, U25.4 (IN-)
unnamed: C109.1, U26.3 (IN+)
unnamed: C110.2, U26.4 (IN-)
unnamed: C113.1, U27.3 (IN+)
unnamed: C114.2, U27.4 (IN-)
unnamed: C115.1, U28.3 (IN+)
unnamed: C116.2, U28.4 (IN-)
unnamed: C119.1, U29.3 (IN+)
unnamed: C120.2, U29.4 (IN-)
unnamed: C121.1, U30.3 (IN+)
unnamed: C122.2, U30.4 (IN-)
unnamed: C125.1, U31.3 (IN+)
unnamed: C126.2, U31.4 (IN-)
unnamed: C127.1, U32.3 (IN+)
unnamed: C128.2, U32.4 (IN-)
unnamed: C131.1, U33.3 (IN+)
unnamed: C132.2, U33.4 (IN-)
unnamed: C133.1, U34.3 (IN+)
unnamed: C134.2, U34.4 (IN-)
unnamed: C137.1, U35.3 (IN+)
unnamed: C138.2, U35.4 (IN-)
unnamed: C139.1, U36.3 (IN+)
unnamed: C140.2, U36.4 (IN-)
unnamed: C143.1, U37.3 (IN+)
unnamed: C144.2, U37.4 (IN-)
unnamed: C145.1, U38.3 (IN+)
unnamed: C146.2, U38.4 (IN-)
unnamed: C149.1, U39.3 (IN+)
unnamed: C150.2, U39.4 (IN-)
unnamed: C151.1, U40.3 (IN+)
unnamed: C152.2, U40.4 (IN-)
unnamed: C155.1, U41.3 (IN+)
unnamed: C156.2, U41.4 (IN-)
unnamed: C157.1, U42.3 (IN+)
unnamed: C158.2, U42.4 (IN-)
unnamed: C161.1, U43.3 (IN+)
unnamed: C162.2, U43.4 (IN-)
unnamed: C163.1, U44.3 (IN+)
unnamed: C164.2, U44.4 (IN-)
PA11: U5.70 (PA11), U11.4 (I/O2)
PA12: U5.71 (PA12), U11.6 (I/O1)
PC13: C68.2, K1.1, R20.1, U5.7 (PC13)
SAI1_MCLK: RN2.4 (R4.1), RN3.4 (R4.1), RN4.4 (R4.1), RN5.4 (R4.1), U1.15 (SCKI), U5.1 (PE2)
USB1_DN: R42.1, U11.3 (I/O2)
USB1_DP: R43.1, U11.1 (I/O1)
USB2_DN: R45.2, U12.3 (I/O2)
USB2_DP: R44.2, U12.1 (I/O1)
VBAT_pin: D2.2, J13.1
VDD: C77.1, C78.2, C81.1, C82.2, C87.1, C88.2, C93.1, C94.2, C99.1, C100.2, C105.1, C106.2, C111.1, C112.2, C117.1, C118.2, C123.1, C124.2, C129.1, C130.2, C135.1, C136.2, C141.1, C142.2, C147.1, C148.2, C153.1, C154.2, C159.1, C160.2, C165.1, C166.2, J34.1, U13.6 (VDD), U14.6 (VDD), U15.6 (VDD), U16.6 (VDD), U17.6 (VDD), U18.6 (VDD), U19.6 (VDD), U20.6 (VDD), U21.6 (VDD), U22.6 (VDD), U23.6 (VDD), U24.6 (VDD), U25.6 (VDD), U26.6 (VDD), U27.6 (VDD), U28.6 (VDD), U29.6 (VDD), U30.6 (VDD), U31.6 (VDD), U32.6 (VDD), U33.6 (VDD), U34.6 (VDD), U35.6 (VDD), U36.6 (VDD), U37.6 (VDD), U38.6 (VDD), U39.6 (VDD), U40.6 (VDD), U41.6 (VDD), U42.6 (VDD), U43.6 (VDD), U44.6 (VDD)
