bergamifer/DS-Project/firmware/Core/Src/main.c

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
/* Includes ------------------------------------------------------------------*/
#include "main.h"

/* USER CODE BEGIN Includes */
#include <string.h>
#include <stdio.h>
#include <math.h>
#include "uart_protocol.h"
#include "pcm1690.h"
#include "pin_definitions.h"
#include "eeprom_config.h"
#include "ota.h"
/* USER CODE END Includes */

/* USER CODE BEGIN PD */
#define AUDIO_SAMPLE_RATE    48000
/* 240 muestras = 5 ms por medio buffer @48kHz.
 *
 * Era 480 (10 ms). El buffer domina la latencia total: de los 11,4 ms del
 * pipeline, 10 eran esto. Bajarlo a la mitad deja el total en ~6,4 ms (−44%).
 *
 * El precio es que el deadline de fill pasa de 10 ms a 5 ms. Eso obligó a hacer
 * cooperativas las cuatro operaciones que bloqueaban más que eso —los prints del
 * heartbeat, el guardado en EEPROM, SendStatus y el cambio de volumen— porque
 * cualquiera de ellas habría producido pops. Ese trabajo ya está hecho y
 * verificado con 0 underruns; ver docs/ds11_perf.md.
 *
 * ADC_BUFFER_SAMPLES lo sigue automáticamente, así que el pipeline entero queda
 * consistente. */
#define AUDIO_BUFFER_SAMPLES 240      // 5ms @ 48kHz (era 480 = 10ms)
#define AUDIO_CHANNELS       8        // TDM8 (8 channels per PCM1690)
#define AUDIO_BUFFER_SIZE    (AUDIO_BUFFER_SAMPLES * AUDIO_CHANNELS)

#define CPU_FREQ_MHZ         480      // CPU clock after PLL1 config

#define ADC_CHANNELS         8        // AK5538VN 8ch TDM256 input
#define ADC_BUFFER_SAMPLES   AUDIO_BUFFER_SAMPLES  // 480 samples = 10ms
#define ADC_BUFFER_SIZE      (ADC_BUFFER_SAMPLES * ADC_CHANNELS)   // 960 samples

// Beamforming delay line
#define DELAY_LINE_SIZE      1024     // power of 2 for fast & mask
#define DELAY_LINE_MASK      (DELAY_LINE_SIZE - 1)
#define MAX_DELAY_SAMPLES    64       // ~1.33ms @ 48kHz = ~45.7cm at 343 m/s
#define BEAM_NUM_CHANNELS    32

// ===== RX beamforming (delay-and-sum over the 8 ADC inputs) =====
#define MIC_COUNT            8
#define SPEED_OF_SOUND_MM_S  343000.0f
// PLACEHOLDER geometry: uniform linear array along X, 50mm pitch.
// EDIT mic_pos_x_mm[] below when the real input/mic geometry is decided —
// the steering math only depends on that table.
#define MIC_SPACING_MM       50.0f

// ===== TX beamforming — speaker array geometry (DS 4×8 brick pattern) =====
// Listener frame, facing the cones: X = to the LISTENER's right, Y = from
// row 1 toward row 4 (physical up/down TBC by user), Z = out toward listener.
// Rows 1&3 (r=0,2) aligned; rows 2&4 (r=1,3) shifted +40mm in X.
// Channel map placeholder: ch = row*8 + col, col 0 = leftmost (row-major) —
// to be validated with the channel walker on real DS11 hardware.
/* ===== GEOMETRÍA DEL ARRAY =====
 *
 * Un solo interruptor. La DS11 es una grilla 8×4; la DS12 pasa a 2 filas × 16
 * columnas entrelazadas (ver hardware/DS/DS12_PLANNING.md §0.8 y §0.8.1).
 * El entrelazado NO necesita código nuevo: SPK_ROW_DX_MM ya corre las filas
 * impares 40 mm, que es justo el paso efectivo que busca el 2×16.
 *
 * ⚠️ Cambiar esto con el hardware equivocado NO da error: el haz se forma
 * igual, pero apuntando a otro lado. Confirmalo con el channel walker. */
#define SPK_LAYOUT_2X16  0        /* 0 = DS11 (8×4) · 1 = DS12 (2×16) */

#if SPK_LAYOUT_2X16
  #define SPK_ROWS        2
  #define SPK_COLS       16
#else
  #define SPK_ROWS        4
  #define SPK_COLS        8
#endif

#define SPK_X_PITCH_MM_I  80      /* enteros: los usa el _Static_assert de abajo, */
#define SPK_Y_PITCH_MM_I 160      /* que necesita una expresión constante entera  */
#define SPK_ROW_DX_MM_I   40      /* (C11 §6.7.10: nada de punto flotante ahí)    */

#define SPK_X_PITCH_MM   ((float)SPK_X_PITCH_MM_I)
#define SPK_Y_PITCH_MM   ((float)SPK_Y_PITCH_MM_I)
#define SPK_ROW_DX_MM    ((float)SPK_ROW_DX_MM_I)   // brick offset de las filas impares

/* Extensión del array, DERIVADA — no la escribas a mano, que fue justo el error. */
#define SPK_SPAN_X_MM_I  ((SPK_COLS - 1) * SPK_X_PITCH_MM_I + SPK_ROW_DX_MM_I)
#define SPK_SPAN_Y_MM_I  ((SPK_ROWS - 1) * SPK_Y_PITCH_MM_I)

/* Por la desigualdad triangular, ningún foco puede exigir un retardo mayor que
 * la diagonal del array. 8×4 → 768 mm ≈ 108 muestras; 2×16 → 1250 mm ≈ 175.
 * Cota superior dura: delay + 480 ≤ 1024 ⇒ ≤ 544.
 *
 * 🔧 2026-09-11: esto era 128, un número derivado A MANO de la geometría 8×4.
 * Con el 2×16 hacen falta 175 y Beam_SetTxFocus RECORTA EN SILENCIO: el haz se
 * forma igual, pero mal, y nada lo delata. El assert de abajo convierte ese
 * modo de falla en un error de compilación. */
#define TX_MAX_DELAY_SAMPLES 192

_Static_assert(
    (long long)TX_MAX_DELAY_SAMPLES * TX_MAX_DELAY_SAMPLES * 343000LL * 343000LL
      > ((long long)SPK_SPAN_X_MM_I * SPK_SPAN_X_MM_I
       + (long long)SPK_SPAN_Y_MM_I * SPK_SPAN_Y_MM_I) * 48000LL * 48000LL,
    "TX_MAX_DELAY_SAMPLES no cubre la diagonal del array: el foco se recortaria "
    "en silencio en los extremos. Subilo (cota dura: 544).");
/* Los 343000 y 48000 son SPEED_OF_SOUND_MM_S y AUDIO_SAMPLE_RATE en entero;
 * si alguno cambia, cambialo también acá. */
_Static_assert(TX_MAX_DELAY_SAMPLES + 480 <= 1024,
    "TX_MAX_DELAY_SAMPLES excede la linea de retardo (delay + 480 <= 1024).");

// ===== Channel walker (sequential per-channel test tone) =====
#define WALKER_SECONDS_PER_CH 1
// DS11: los 4 PCM1690 poblados → 32 canales. El walker recorre el array
// completo (32 s por vuelta) y valida el mapa canal→parlante + el cableado
// JSPK, incluida la doble inversión deliberada de los canales impares
// (ver docs/ds11_upgrades.md: al JST llega la polaridad correcta).
#define WALKER_NUM_CH        32

// ===== AUTOFOCUS: measured focal calibration with a microphone =====
// Place a mic AT the desired focal point, feed it into ADC input 1 (ch0).
// The scan plays a 10ms chirp through each speaker in turn, captures the mic,
// and cross-correlates against the chirp reference → per-speaker time of
// flight. delay_k = max(tof) − tof_k then FOCUSES the array exactly at the
// mic — measured, not modeled: absorbs geometry error, channel mapping AND
// polarity (a negative correlation peak = inverted speaker → speaker_sign).
// All fixed pipeline latencies (TX buffer wait, DAC/ADC group delay) are
// identical for every speaker, so they cancel in the relative delays.
#define CAL_MIC_CH        0                       // default: mic 1 = ADC ch0
/* ===== El SEGUNDO microfono del banco (docs/banco_dos_microfonos.md) =====
 *
 * El scan mide, parlante por parlante, TOF = t0 + tau_k + |p_k - m|/c: instante
 * de disparo, retardo propio del parlante y camino geometrico, los tres
 * sumados. Separar tau_k de lo demas es un ajuste por minimos cuadrados que se
 * hace afuera (tools/calfase.py, issue #21), y ese ajuste SIEMPRE devuelve
 * residuos: que existan no prueba que sean del parlante. Pueden ser una
 * reflexion de la sala o un error de geometria que el ajuste no supo absorber.
 *
 * La unica forma de distinguirlos es medir desde DOS posiciones y comparar: si
 * los tau_k coinciden, son del parlante y generalizan; si no, no hay
 * calibracion. Hasta ahora eso pedia correr el scan, MOVER el microfono y
 * correrlo de nuevo — dos corridas separadas por minutos, con otro t0, otra
 * temperatura y la mano de alguien dentro del campo.
 *
 * Con dos entradas se mide en la MISMA pasada, con los MISMOS chirps: t0, sala
 * y temperatura son identicos por construccion, asi que cualquier diferencia
 * entre los dos juegos de tau_k es de la sala o de la geometria y nada mas. Y
 * lo hace posible un banco FIJO, que es justamente el que no se puede mover.
 *
 * Memoria: la captura pasa de int32 a int16 y gana una dimension, o sea que
 * ocupa EXACTAMENTE lo mismo (2 x 4800 x 2 = 19.200 B). No es un ahorro
 * forzado: el LOOPBACK ya captura en 16 bits desde siempre y correlaciona
 * igual. 16 bits son 96 dB de rango contra los ~60 dB que da un microfono de
 * medicion en una sala, asi que la precision la sigue poniendo el aire.
 * Quedaban 17,9 kB libres de DTCM: duplicar en int32 no entraba. */
#define CAL_NUM_MIC       2
/* Que entradas son los microfonos. Variables y no #define desde la v17: el
 * arnes real dio senal en c0 y c7 —el RJ45 no reparte los pares como uno
 * espera— y con 0/1 clavados el AUTOFOCUS media un canal vacio SIN decir nada
 * raro: la calidad salia baja y parecia ruido de sala. */
static volatile uint8_t cal_mic_ch[CAL_NUM_MIC] = { CAL_MIC_CH, 1 };
/* Ventana de busqueda del segundo microfono alrededor del pico del primero.
 * +-128 muestras son +-2,7 ms = +-91 cm de diferencia de camino, contra los
 * 25 cm que separan los microfonos del banco: 3,6x de margen. Acotarla no es
 * solo velocidad (257 lags en vez de 4320, o sea +6% en vez de +100%): tambien
 * RECHAZA un maximo espurio lejano, que en el segundo microfono no tendria
 * ningun otro filtro. Si el pico real cayera fuera, la calidad lo delata. */
#define CAL_MIC2_WIN      128
#define CAL_CHIRP_LEN     480                     // 10ms 500Hz→6kHz linear chirp
#define CAL_CAPTURE_LEN   4800                    // 100ms capture window
#define CAL_MAX_LAG       (CAL_CAPTURE_LEN - CAL_CHIRP_LEN)
#define CAL_SETTLE_HALVES 10                      // 100ms of silence between speakers
#define CAL_CORR_CHUNK    128                     // lags per main-loop pass (~0.5ms)
// DS11: 32 parlantes ≈ 8 s de scan (~250 ms por parlante: settle + captura +
// correlación chunked). El mic no se mueve durante todo el barrido.
#define CAL_NUM_CH        WALKER_NUM_CH           // scan the populated channels
/* USER CODE END PD */

/* Beamforming config — los 32 canales, mismo alcance que el ds_config_t del ESP32 */
typedef struct {
    uint8_t  master_gain;                   // 0-255 → 0.0-1.0
    uint8_t  mute_global;                   // 0=unmuted, 1=muted
    uint16_t delays[BEAM_NUM_CHANNELS];     // delay in samples per channel
    uint8_t  gains[BEAM_NUM_CHANNELS];      // gain per channel 0-255
    uint32_t mutes;                         // bitfield: bit N = channel N muted
    int8_t   master_vol_db;                 // PCM1690 attenuation, dB (0..-63, ≤-64 mute)
    uint8_t  last_mode;                     // ui_states index restored at boot
    uint8_t  in_gain_db;                    // ganancia de ENTRADA, dB (0..36)
    /* ===== Calibración del AUTOFOCUS, persistida (v5) =====
     * Hasta ahora el scan medía bien y el resultado se EVAPORABA: los retardos
     * se pisaban al cambiar de modo y las polaridades no sobrevivían al
     * reinicio. O sea que la calibración había que rehacerla, con el micrófono
     * en su lugar, cada vez que se encendía el equipo — que es exactamente lo
     * que no se puede pedir en una instalación.
     *
     * Persistirla es viable porque el SYNC entre bancos mide 4 µs y es
     * REPRODUCIBLE arranque tras arranque (medido 2026-08-13): si variara por
     * encendido, una calibración dejaría de valer tras un ciclo de
     * alimentación. Ese era el "no se puede" que ya no aplica.
     *
     * Son dos cosas distintas y se usan distinto:
     *  - cal_sign: propiedad del HARDWARE (cableado/polaridad del parlante). No
     *    depende de dónde esté el foco → se aplica SIEMPRE, en todos los modos.
     *  - cal_delay_q8: es UN foco, el del punto donde estaba el micrófono. NO
     *    generaliza a otros puntos → se recupera a pedido (modo 18), nunca solo.
     */
    int8_t   cal_sign[BEAM_NUM_CHANNELS];   // polaridad medida (+1/−1)
    uint16_t cal_delay_q8[BEAM_NUM_CHANNELS]; // foco medido en el punto del mic
    uint8_t  cal_valid;                     // 1 = hay una calibración guardada
    /* ===== Arranque autónomo (v6) — issue #19 =====
     * Los 32 amplificadores arrancan apagados y se encienden por comando. Eso
     * es una herramienta de diagnóstico que vale la pena (separa "reinicia por
     * consumo" de "reinicia igual"), pero ata el sonido a que el ESP32 esté
     * vivo Y EN RED: en una instalación, un nodo que pierde el WiFi queda mudo
     * toda la función y no hay forma de encenderlo sin ir hasta la placa.
     *
     * Con `autostart` en 1 el nodo se enciende solo, sin red y sin nadie. Es
     * opt-in y se persiste: en el banco sigue arrancando mudo, que es lo que
     * uno quiere cuando está midiendo.
     *
     * `autostart_fails` es el freno. Se INCREMENTA Y SE GUARDA ANTES de
     * encender, y se limpia recién cuando el nodo lleva un rato estable con los
     * amps prendidos. Así, si el que reinicia el equipo es el consumo de los
     * amplificadores, cada intento deja su marca en la EEPROM aunque la
     * alimentación se caiga en el acto — y tras AUTOSTART_MAX_FAILS el nodo
     * deja de intentar y espera un comando, en vez de quedar rebotando. */
    uint8_t  autostart;                     // 1 = encender los amps sin red
    uint8_t  autostart_fails;               // intentos que no llegaron a estables
} beam_config_t;
/* La calibración llevó la config de 108 a 208 bytes. Sin este chequeo, cruzar
 * el techo se manifestaría como "el equipo dejó de recordar los ajustes",
 * mucho después y lejos del campo que lo causó — el guardado es diferido y
 * falla en silencio salvo por una línea del serie. */
/* La v6 tiene el MISMO tamaño que la v5: los dos uint8_t nuevos entraron en el
 * relleno. Si esto deja de valer, la entrada { 5, 208 } de cfg_layouts deja de
 * ser el tamaño de la v5 y hay que revisarla. */
_Static_assert(sizeof(beam_config_t) == 208,
               "cambio el tamano de beam_config_t: revisar cfg_layouts[]");
_Static_assert(sizeof(beam_config_t) <= EEPROM_CFG_MAX_SIZE,
               "beam_config_t no entra en el buffer de la EEPROM");


I2C_HandleTypeDef hi2c1;
I2C_HandleTypeDef hi2c3;

SAI_HandleTypeDef hsai_BlockA1;
SAI_HandleTypeDef hsai_BlockB1;
SAI_HandleTypeDef hsai_BlockA2;
SAI_HandleTypeDef hsai_BlockB2;
SAI_HandleTypeDef hsai_BlockB3;
DMA_HandleTypeDef hdma_sai1_a;
DMA_HandleTypeDef hdma_sai1_b;
DMA_HandleTypeDef hdma_sai2_a;
DMA_HandleTypeDef hdma_sai2_b;
DMA_HandleTypeDef hdma_sai3_b;
UART_HandleTypeDef huart7;
UART_HandleTypeDef huart4;

ADC_HandleTypeDef hadc3;
/* Vigilancia del riel de 3V3 — ver el comentario largo junto a Rail_Poll(). */
static volatile uint16_t vdda_mv      = 0;       /* ultima lectura, en mV */
static volatile uint16_t vdda_min_mv  = 0xFFFF;  /* minimo desde el ultimo /status */
static volatile uint16_t vdda_min_abs = 0xFFFF;  /* minimo desde que arranco */
static volatile int32_t  cpu_temp_x10 = -9990;
/* "REL1" — firma que distingue un registro de respaldo escrito por nosotros de
 * la basura que queda tras un corte de alimentacion real. Sin ella, un patron
 * arbitrario de arranque se leeria como una medicion. */
#define RAIL_BKP_MAGIC  0x52454C31u
/* El minimo que tenia el riel JUSTO ANTES del ultimo reinicio. 0 = no hay dato
 * (primer arranque, o corte de luz que borro el dominio de respaldo). */
static volatile uint16_t vdda_pre_reset_mv = 0;
/* Cuantas veces se reinicio la placa con el riel por debajo del umbral del
 * MAX809. Sobrevive a los reinicios, se pierde con la alimentacion. */
static volatile uint16_t rail_deaths = 0;
TIM_HandleTypeDef htim3;

/* USER CODE BEGIN PV */

/* ===== DMA Double Buffer (ping-pong) =====
 * Layout: [HALF_A (480 × 8ch)][HALF_B (480 × 8ch)]
 *          ^                    ^
 *          HalfCplt fills A     FullCplt fills B
 *
 * TDM8: 8 channels interleaved per sample frame
 * While DMA sends HALF_B → CPU fills HALF_A (and vice versa)
 * MUST be in RAM_D2 for DMA1 access (DTCMRAM NOT DMA-accessible on STM32H7!)
 */
static int32_t audio_buffer[AUDIO_BUFFER_SIZE * 2] __attribute__((section(".dma_buffer"), aligned(32)));
static int32_t audio_buffer_1b[AUDIO_BUFFER_SIZE * 2] __attribute__((section(".dma_buffer"), aligned(32)));
static int32_t audio_buffer_2a[AUDIO_BUFFER_SIZE * 2] __attribute__((section(".dma_buffer"), aligned(32)));
static int32_t audio_buffer_2b[AUDIO_BUFFER_SIZE * 2] __attribute__((section(".dma_buffer"), aligned(32)));
static int32_t audio_buffer_3b_rx[ADC_BUFFER_SIZE * 2] __attribute__((section(".dma_buffer"), aligned(32)));

// Circular delay lines for beamforming — 8 independent channels (AK5538VN 8ch)
// delay_line[0] = ADC ch0 (main beam source); [1]-[7] las 8 entradas del modo 15.
// NO es memoria DMA: la escribe la CPU en Process_ADC_Half copiando desde
// audio_buffer_3b_rx. Por eso vive en DTCMRAM (0 wait states, acoplada al core)
// y no en RAM_D2 (vía AXI, que es donde la ponía .dma_buffer). Es la estructura
// más leída del pipeline — el modo 15 hace 8 lecturas por muestra de salida y
// por canal. 32 KB de los 128 KB de DTCM.
static int32_t delay_line[8][DELAY_LINE_SIZE] __attribute__((aligned(32)));
static uint32_t delay_write_pos = 0;

// Active beamforming config (copied from ESP32 ds_config_t on update)
static beam_config_t beam_config;

/* ===== Test Tone: 1kHz sine @ 48kHz sample rate =====
 * 48 samples per period (48000/1000 = 48), amplitude = -6dBFS (0x400000 peak)
 * 240 samples por medio buffer = exactamente 5 períodos → sin error de fase
 * entre llamadas. SET test_tone_enabled = 0 to restore normal beamforming mode
 *
 * ⚠️ NO const, A PROPÓSITO — no lo "arregles".
 *
 * Con `const` la tabla queda en .rodata, o sea en FLASH, y como el D-cache está
 * apagado cada lectura paga los wait states del flash. Sin const va a .data,
 * que este linker script pone en DTCMRAM (0 wait states, ver la sección .data
 * en STM32H743XX_FLASH.ld) y el startup la copia sola.
 *
 * No es cosmético: el modo 14 lee esta tabla DOS veces por (muestra × canal ×
 * fuente) = 61440 lecturas por ventana de 5 ms, y con la tabla en flash perdía
 * el 15% de los deadlines (1234 underruns en 20 s medidos el 2026-08-18)
 * mientras el modo 15 —que es MÁS pesado pero lee delay_line desde DTCM— no
 * perdía ninguno. Misma causa raíz que el arreglo de rendimiento de agosto: en
 * este chip lo que importa no es cuántas operaciones hacés sino de qué memoria
 * leés. Los modos 12/13 la leen una vez por muestra, por eso nunca sufrieron.
 *
 * La sección explícita tampoco es opcional: sacar el `const` no alcanza, porque
 * con -O2 GCC ve que nadie la escribe y la manda a .rodata igual. Verificar con
 *   arm-none-eabi-nm build/ds11_beamforming.elf | grep sine_table
 * → tiene que dar 0x2000xxxx (DTCM) y 'd', no 0x08xxxxxx y 'r'. */
__attribute__((section(".data")))
static int32_t sine_table_1khz[48] = {
         0,   547466,  1085575,  1605080,  2097152,  2553318,
   2965812,  3327563,  3632372,  3875034,  4051387,  4158422,
   4194304,  4158422,  4051387,  3875034,  3632372,  3327563,
   2965812,  2553318,  2097152,  1605080,  1085575,   547466,
         0,  -547466, -1085575, -1605080, -2097152, -2553318,
  -2965812, -3327563, -3632372, -3875034, -4051387, -4158422,
  -4194304, -4158422, -4051387, -3875034, -3632372, -3327563,
  -2965812, -2553318, -2097152, -1605080, -1085575,  -547466
};
static volatile uint8_t test_tone_enabled = 0; /* 1 = 1kHz test tone; 0 = use monitor/beamform */
static uint32_t test_tone_phase = 0;

/* ADC monitor mode: route the live digitized ADC straight to the DACs so you
 * can HEAR what the AK5538 is capturing. Each DAC channel plays its matching
 * ADC channel (ch0→ch0 …), repitiendo las 8 entradas en cada fila de 8
 * parlantes (DS11: 4 filas). Escalado por la ganancia de entrada (ver abajo)
 * y clampeado a FS de 24 bits. Takes priority over test tone and beamform. */
static volatile uint8_t adc_monitor_enabled = 1;   /* 1 = live ADC→DAC monitor */

/* ===== Ganancia de ENTRADA — ajustable en runtime y PERSISTENTE =====
 *
 * La estructura de ganancia estaba al revés y ese era el cuello de botella real:
 * el modo 0 amplificaba +30 dB (para poder oír un micrófono) y después el
 * atenuador del PCM1690 tiraba −40 dB. Con una fuente de LÍNEA el resultado es
 * que el clamp digital recorta mucho antes de que a los parlantes les llegue
 * nada — medido 2026-08-18: ADCpk 448804 (−25 dBFS) × 32 = +4,6 dBFS, con
 * SALIDA(clip) = 3152 recortes/s y el ADC ni enterado (OVF = 0).
 *
 * Es un ajuste GLOBAL, no por modo: la ganancia que hace falta depende de QUÉ
 * ESTÁ ENCHUFADO, no del modo de beamforming activo. Por eso se guarda en la
 * EEPROM junto al volumen — se configura una vez por instalación y sobrevive
 * al reboot (antes había que mandar el comando después de cada arranque).
 *
 * El default es 0 dB = LÍNEA, porque las entradas de la DS11 son de línea:
 * J9 no lleva bias de micrófono (ver ds11-netlist-hallazgos), así que un
 * electret necesita preamp externo igual. El +30 dB es el caso excepcional.
 *
 * Multiplicador Q8 en vez de shift, para pasos de 1 dB en lugar de 6. El
 * multiply extra por muestra es despreciable: el monitor va al 4,3% de CPU. */
static const uint16_t gain_q8_tbl[37] = {
    256,   287,   322,   362,   406,   455,   511,   573,   643,   722,
    810,   908,  1019,  1144,  1283,  1440,  1615,  1812,  2033,  2282,
   2560,  2872,  3223,  3616,  4057,  4552,  5108,  5731,  6430,  7215,
   8095,  9083, 10192, 11435, 12830, 14396, 16153 };
#define IN_GAIN_DB_MAX  36
#define IN_GAIN_DB_MIC  30      /* preset "micrófono" (×32) — con preamp externo */
#define IN_GAIN_DB_LINE 0       /* preset "línea" (×1) — el default de fábrica  */
static volatile uint8_t  in_gain_db  = IN_GAIN_DB_LINE;
static volatile uint16_t in_gain_q8  = 256;       /* = tabla[0] */

static inline int32_t Apply_In_Gain(int32_t s) {
  return (int32_t)(((int64_t)s * (int32_t)in_gain_q8) >> 8);
}

/* Medición de nivel STICKY — ver el comentario en Process_ADC_Half.
 * adc_peak_hold: pico por canal sobre TODAS las muestras (escala 24-bit).
 * adc_ovf_latch: cuántos medios buffers vieron el pin OVF alto (ADC saturando).
 * out_clip_count: cuántas muestras de SALIDA se recortaron (boost excesivo).
 * Juntos separan las dos saturaciones posibles, que suenan igual pero se
 * arreglan distinto. El pico se limpia al imprimirse (es un peak-hold); los
 * dos contadores son MONOTÓNICOS y se publican en /status — el heartbeat
 * imprime su delta. */
static volatile int32_t  adc_peak_hold[ADC_CHANNELS];
/* DOS peak-holds, no uno, porque tienen dos consumidores que se pisaban.
 *
 * El serie drena adc_peak_hold una vez por segundo. /status (telemetría, lo que
 * ve la página) NO podía leer el mismo: el que llegara primero se comía el pico
 * y el otro veía cero. La solución que había era recalcular el pico en el
 * handler de status sobre el buffer DMA vivo — o sea sobre UNA ventana de 10 ms
 * de cada intervalo de sondeo. Es exactamente el muestreo al 1% que en agosto
 * hizo concluir "al ADC le sobran 45 dB" mientras el equipo saturaba de forma
 * audible: se arregló para el serie y quedó sin arreglar para la red.
 *
 * Importa ahora porque el detector de micrófono cuelga de esto: con ventanas de
 * 10 ms un micrófono captando una sala parpadearía entre "vivo" y "muerto". */
static volatile int32_t  adc_peak_net[ADC_CHANNELS];
static volatile uint32_t adc_ovf_latch = 0;
static volatile uint32_t out_clip_count = 0;

/* ===== Detección de micrófono / señal de entrada =====
 * Nace del AUTOFOCUS: el scan mide con un micrófono en la entrada 1, y hasta
 * ahora la única forma de saber si ese micrófono estaba vivo era mirar los
 * números del serie. Si no lo estaba, el scan igual "terminaba" y dejaba 32
 * retardos de basura enfocando nada — un fallo silencioso.
 *
 * Piso de ruido MEDIDO con las entradas al aire, 12 muestras del pico de 1 s
 * sobre todas las muestras (2026-08-19): máximo 437 cuentas en escala de 24
 * bits. Ojo con los números viejos de 43-224 que andan por los comentarios: son
 * de cuando el pico se calculaba sobre una ventana de 10 ms, o sea el 1% del
 * tiempo — subestiman el piso por un factor de ~2.
 *
 * El umbral queda ~13 dB por encima de ese máximo: no lo dispara el ruido
 * propio, y cualquier micrófono con preamplificador captando una sala en
 * silencio lo cruza de sobra (−40 dBFS son 83886 cuentas, 40× el umbral).
 *
 * La histéresis existe porque una fuente real tiene pausas: alguien deja de
 * hablar y el micrófono no se desenchufó. */
#define MIC_LIVE_THRESH   2000      /* pico de 1 s que cuenta como "hay señal" */
#define MIC_LIVE_HOLD_S   3         /* segundos que sigue "vivo" tras la última */
static volatile uint8_t mic_live_mask = 0;    /* bit N = entrada N con señal */

/* ===== Operating states — cycled with user button K2 (PA4, press = LOW) =====
 * Flat list: each press advances one state and prints the new one on UART7.
 *   0 ADC monitor  → 1 channel walker → 2..6 RX beam at preset azimuths → wrap
 * Exactly one of adc_monitor_enabled / walker_enabled / beam_enabled is set. */
/* Eje del barrido automático (campo .sweep). Los valores viven acá arriba
 * porque la tabla ui_states[] los usa; la mecánica está más abajo, en el
 * bloque BARRIDO. */
#define SWEEP_AXIS_X    1
#define SWEEP_AXIS_Y    2
typedef struct {
  const char *name;
  uint8_t monitor, walker, beam;
  int16_t az_deg;                 // RX beam steering azimuth
  uint8_t tx;                     // 1 = TX steered output (Phase 2)
  int16_t fx_mm, fy_mm, fz_mm;    // TX focal point, relative to array center
  uint8_t af;                     // 1 = AUTOFOCUS mic-scan mode
  uint8_t tone;                   // 1 = internal tone source feeds beam_line
  uint16_t tone_hz;               // tone frequency (keep ≤2140: d=λ/2 limit)
  uint8_t mf;                     // 1 = MULTIFOCUS tonos (N fuentes internas)
  uint8_t mfin;                   // 1 = MULTIFOCUS de ENTRADAS (8 ADC → 8 focos)
  uint8_t sweep;                  // eje del barrido automático: 0 no, 1 = X, 2 = Y
  uint8_t calfoc;                 // 1 = usa el foco MEDIDO por AUTOFOCUS, no el geométrico
  uint8_t loopb;                  // 1 = LOOPBACK: medición eléctrica del camino de salida
  uint8_t fsweep;                 // 1 = BARRIDO DE FRECUENCIA por el lazo (Test D)
  uint8_t fhold;                  // 1 = el barrido NO avanza: tono fijo (medición con téster)
  uint8_t psweep;                 // 1 = BARRIDO DE FASE por parlante (uno por vez)
  uint8_t fchirp;                 // 1 = CHIRP ENFOCADO (mide el directo, sin sala)
} ui_state_t;
static const ui_state_t ui_states[] = {
  { .name = "ADC monitor",                  .monitor = 1 },
  { .name = "Channel walker (1s/ch)",       .walker = 1 },
  { .name = "RX beam az=0 (broadside)",     .beam = 1, .az_deg =   0 },
  { .name = "RX beam az=+30",               .beam = 1, .az_deg =  30 },
  { .name = "RX beam az=-30",               .beam = 1, .az_deg = -30 },
  { .name = "RX beam az=+60",               .beam = 1, .az_deg =  60 },
  { .name = "RX beam az=-60",               .beam = 1, .az_deg = -60 },
  // TX steering presets (Phase 2): tono interno de 2 kHz enfocado en 4 puntos
  // distintos. Caminando la sala se oye el spot moverse — el modo se valida
  // solo, sin instrumental y sin nada conectado a la entrada.
  //
  // 2 kHz, NO 1 kHz: la apertura en X son 600 mm (8 columnas × 80 mm + 40 de
  // ladrillo). A 1 kHz eso es 1,75 λ y el spot a 1 m sale de ±286 mm — los
  // focos de izquierda y derecha, separados 1 m, casi se solapan y desde el
  // centro suenan IGUAL (verificado a oído el 2026-08-19: "8 y 9 hacen lo
  // mismo que el 13"). A 2 kHz la apertura es 3,50 λ y el spot cae a ±143 mm:
  // el doble de resolución. El techo es 2144 Hz (c/2d, lóbulos de rejilla),
  // así que 2 kHz es lo mejor que este array puede hacer.
  //
  // La fuente era el RX beam (los micrófonos) hasta 2026-08-18. El diseño
  // asumía micrófonos en la placa, y la DS11 no los tiene: J9 son entradas de
  // LÍNEA sin bias, así que estos modos reproducían lo que hubiera enchufado
  // en el ADC y no se distinguían del modo 0 salvo por el retardo. Escuchar la
  // entrada ya lo hacen los modos 2-6 (beam RX) y, mucho mejor, el 15
  // (cada entrada en su propio punto). Lo que faltaba era demostrar el
  // steering, y para eso la fuente tiene que ser interna.
  //
  // X en el marco del OYENTE MIRANDO LOS CONOS (si L/R salen espejados en la
  // caja real, invertir el signo de las coords SPK — una línea). Y hacia fila 4.
  { .name = "TX 2k ondulante LEJOS 2m",     .beam = 1, .tx = 1, .tone = 1,
    .tone_hz = 2000, .fx_mm =    0, .fy_mm = 0, .fz_mm = 2000 },
  { .name = "TX 2k ondulante izq 0.5m @1m", .beam = 1, .tx = 1, .tone = 1,
    .tone_hz = 2000, .fx_mm = -500, .fy_mm = 0, .fz_mm = 1000 },
  { .name = "TX 2k ondulante der 0.5m @1m", .beam = 1, .tx = 1, .tone = 1,
    .tone_hz = 2000, .fx_mm =  500, .fy_mm = 0, .fz_mm = 1000 },
  { .name = "TX 2k ondulante CERCA 0.3m",   .beam = 1, .tx = 1, .tone = 1,
    .tone_hz = 2000, .fx_mm =    0, .fy_mm = 0, .fz_mm =  300 },
  // Measured focal calibration: mic at the target point → ADC input 1 (c0),
  // chirp scan of every speaker → TOF-derived delays + polarity, then a
  // steered tone focused at the mic. Re-enter the mode to re-scan.
  { .name = "AUTOFOCUS scan (mic->ADC c0)",  .af = 1 },
  // Internal tone → beam_line → the TX steering path runs UNCHANGED (Q8
  // fractional delays, gains, signs): directionality validation with no mic
  // on the board (docs/historico (plan implementado: modos 12-13)). DS11: las 4 filas pobladas →
  // fy=0 (centro del array); en DS10 iba a -240 para apuntar al plano de la
  // única fila poblada. Ahora la apertura vertical (480mm) también enfoca.
  // 2kHz spot @1m: ±14cm; 1kHz: ±27cm (ratio ~2 is the self-validating
  // test). APPEND ONLY: the ESP32/web/app mirror these indices.
  { .name = "TX 2k ondulante centro @1m",   .beam = 1, .tx = 1, .tone = 1,
    .tone_hz = 2000, .fx_mm = 0, .fy_mm = 0, .fz_mm = 1000 },
  { .name = "TX 1k ondulante centro @1m (spot 2x)", .beam = 1, .tx = 1, .tone = 1,
    .tone_hz = 1000, .fx_mm = 0, .fy_mm = 0, .fz_mm = 1000 },
  // MULTIFOCUS: 4 tonos internos, cada uno enfocado en su propio punto —
  // caminando la sala, un analizador espectral "lee" la posición por cuál
  // frecuencia domina. Precuela de la intervención de 8 entradas analógicas
  // (mismas tablas mf_delay_q8; solo cambiará la fuente de señal).
  { .name = "MULTIFOCUS 4 tonos @1m",       .mf = 1 },
  // MULTIFOCUS de entradas — LA INTERVENCIÓN: cada entrada analógica del
  // AK5538 se proyecta enfocada en su propio punto de la sala (8 señales
  // reales — voces, instrumentos — en 8 lugares). Mismas tablas de foco que
  // el modo 14; la fuente es delay_line[src] en vez de tonos.
  { .name = "MULTIFOCUS 8 entradas @1m",    .mfin = 1 },
  // BARRIDO: el foco recorre solo la sala de izquierda a derecha y vuelta. Es la
  // demostración del steering que NO exige caminar ni comparar dos modos: parado
  // en un punto fijo, el nivel sube cuando el foco pasa por vos y baja cuando se
  // va. Mismo tono ondulante de 2 kHz que los presets.
  { .name = "TX 2k BARRIDO izq<->der @1m", .beam = 1, .tx = 1, .tone = 1,
    .tone_hz = 2000, .fx_mm = 0, .fy_mm = 0, .fz_mm = 1000, .sweep = SWEEP_AXIS_X },
  // BARRIDO VERTICAL — NO es "el 16 pero en Y": es un EXPERIMENTO, y la
  // frecuencia es el experimento.
  //
  // El 2026-08-19 Fernando reportó que el eje vertical del modo 15 no se
  // percibe. La causa es geométrica: las filas están a 160 mm, que a 2 kHz son
  // 0,93 λ — muy por encima del límite de muestreo espacial d ≤ λ/2. El array
  // vertical está ALIASEADO a esa frecuencia: en vez de un foco produce lóbulos
  // de rejilla. El techo vertical es c/2d = 1072 Hz, contra 2144 Hz del
  // horizontal (columnas a 80 mm).
  //
  // A 800 Hz (±5% de dither → 840 Hz máx) el paso vertical es 0,37 λ: DENTRO
  // del límite, sin lóbulos de rejilla, en todo el rango de steering. Si acá se
  // percibe movimiento vertical y a 2 kHz no, la causa está confirmada como
  // aliasing y bajar el paso de filas en la DS12 se justifica. Si tampoco se
  // percibe, el limitante son las 4 filas (apertura 480 mm = 1,12 λ a 800 Hz →
  // haz de ~51°, spot de ±45 cm a 1 m) y achicar el paso NO alcanza: hay que
  // agregar filas. Las dos respuestas deciden gasto de hardware — ver
  // hardware/DS/DS12_PLANNING.md §0.5.
  { .name = "BARRIDO VERTICAL 800Hz arriba<->abajo @1m", .beam = 1, .tx = 1,
    .tone = 1, .tone_hz = 800, .fx_mm = 0, .fy_mm = 0, .fz_mm = 1000,
    .sweep = SWEEP_AXIS_Y },
  // FOCO CALIBRADO — recupera de la EEPROM los retardos MEDIDOS por el último
  // AUTOFOCUS, en vez de calcularlos con la geometría nominal. Absorbe error de
  // geometría, de mapeo de canales y de polaridad: es el foco real en el punto
  // donde estaba el micrófono.
  //
  // Existe como modo aparte, y no aplicándose solo al arrancar, porque
  // cal_delay_q8 NO es una corrección general: es UN foco, el de ese punto.
  // Aplicarlo por defecto pisaría el foco de cualquier otro modo con el de un
  // micrófono que ya no está ahí. Las POLARIDADES sí se aplican siempre (son
  // del hardware, no del punto) y se restauran en el boot.
  //
  // Si no hay calibración guardada, el modo lo dice y cae al foco geométrico
  // de 1 m — no se queda mudo ni miente.
  { .name = "TX foco CALIBRADO (AUTOFOCUS guardado)", .beam = 1, .tx = 1,
    .tone = 1, .tone_hz = 2000, .fx_mm = 0, .fy_mm = 0, .fz_mm = 1000,
    .calfoc = 1 },
  // LOOPBACK: no suena para nadie — es un modo de banco. Emite el chirp por un
  // canal de cada banco y mide lo que vuelve por el ADC a través de los
  // adaptadores pasivos (docs/loopback_debug.md). Informa por el serie cada 2 s.
  // Sin adaptadores conectados dice "sin senal" y no hace nada más.
  { .name = "LOOPBACK electrico (par e impar de cada banco -> ADC)", .loopb = 1 },
  // BARRIDO DE FRECUENCIA: tampoco suena para nadie. Emite un tono por canal de
  // cada banco y lo detecta coherentemente en las ocho entradas, punto por punto
  // de 20 Hz a 20 kHz. Con el cable de J13 mide la cadena DAC → ADC SIN
  // amplificadores ni 24 V; ver el comentario largo en FS_SETTLE para qué NO
  // alcanza a ver. Informa la tabla completa cada ~7 s.
  { .name = "BARRIDO DE FRECUENCIA por el lazo (20 Hz - 20 kHz)", .fsweep = 1 },
  // TONO FIJO — el mismo emisor del barrido, congelado en un punto.
  //
  // Existe para medir con INSTRUMENTOS DE AFUERA. Todo lo demás que emite un
  // tono no sirve para eso: el barrido cambia de frecuencia cada medio segundo
  // y los modos "ondulante" llevan un LFO triangular de 3 Hz que modula la
  // amplitud un 10% (ver TONE_DITHER_PERIOD) — un téster no puede leer ni uno
  // ni otro.
  //
  // Acá el nivel es conocido y quieto, sale por los MISMOS canales del lazo
  // (§23: ch0/1, 8/9, 16/17, 24/25) y el ADC lo mide al mismo tiempo por el
  // adaptador. O sea que la lectura de afuera y la de adentro son del mismo
  // tono en el mismo instante: eso es lo que permite cerrar la estructura de
  // ganancia de §20 sin suponer ningún eslabón.
  //
  // 500 Hz por dos motivos: la respuesta ahí es plana (-0,02 dB medido, §22.2)
  // y es la zona donde cualquier téster de mano mide bien en alterna. A 2 kHz
  // muchos leen bajo, y arriba de 4 kHz directamente no especifican.
  { .name = "TONO FIJO 500 Hz por el lazo (medicion con tester)",
    .fsweep = 1, .fhold = 1 },
  /* FASE POR PARLANTE — 32 parlantes de a uno, 14 frecuencias cada uno.
   *
   * Es el modo que contesta "¿llegan todos en fase al punto de escucha, y sigue
   * siendo cierto en toda la banda?". Ninguno de los que ya estaban podía:
   * el AUTOFOCUS recorre los parlantes de a uno pero devuelve UN escalar
   * (el retardo de grupo del chirp, promediado sobre 500 Hz-6 kHz), y el modo
   * 20 mide fase contra frecuencia pero con los cuatro bancos sonando juntos,
   * o sea que mide la SUMA — y una suma no se puede desarmar.
   *
   * Tarda ~3 minutos y no se parece a música: son tonos puros, uno por vez,
   * recorriendo el muro. No es un modo para escuchar. Ver el comentario largo
   * de PS_NUM_SPK y docs/banco_dos_microfonos.md §4. */
  { .name = "FASE por parlante (32 x 14 tonos, ~3 min)", .psweep = 1 },
  /* CHIRP ENFOCADO — el array entero emite el chirp CON los retardos del foco.
   *
   * Es el unico modo que mide el haz SIN la sala: la correlacion se queda con
   * la primera llegada. Nacio porque el 2026-09-03 el perfil medido con tono
   * continuo en una sala de 3x2,5 m salio inservible —el maximo de un microfono
   * caia a 400 mm de donde estaba el microfono— mientras el chirp del AUTOFOCUS
   * ubicaba los dos microfonos con 3 mm de error.
   *
   * El foco se mueve con POST /beam como en cualquier otro modo y el resultado
   * se lee con GET /foco. Ver el comentario largo de FC_PERIOD_MS. */
  { .name = "CHIRP ENFOCADO (mide el directo, sin sala)",
    .beam = 1, .tx = 1, .fx_mm = 0, .fy_mm = 0, .fz_mm = 1000, .fchirp = 1 },
};
#define UI_NUM_STATES (sizeof(ui_states) / sizeof(ui_states[0]))
/* Un nombre mas largo que un tramo entero no se podria mandar NUNCA: el lazo de
 * CMD_GET_MODES cortaria sin avanzar y el ESP32 pediria el mismo indice para
 * siempre. Se verifica en compilacion en vez de descubrirlo colgado. */
_Static_assert(MODE_NAME_MAX <= PROTO_MAX_PAYLOAD - sizeof(ds_modes_hdr_t),
               "un nombre de modo no entra en un tramo de CMD_MODES_DATA");
static volatile uint8_t ui_state_idx = 0;

/* ===== Channel walker state ===== */
static volatile uint8_t walker_enabled = 0;
// Frame counter @48kHz; advanced ONLY by the ch_offset==0 (SAI1_A) fill so all
// 4 banks derive the same active channel. Banks 1B/2A/2B see it post-advance
// (+480), which is phase-exact here: 480 % 48 == 0 (10 full sine periods).
static uint32_t walker_frame = 0;

/* ===== RX beam (delay-and-sum) state =====
 * beam_line[] holds the summed beam in 24-bit scale (delay_line samples are
 * 32-bit ADC scale, so each term is >>8 before accumulating; the sum of 8 is
 * then >>3 so a coherent identical signal on all mics comes out at ~unity).
 * Written by Process_ADC_Half at the same positions/cadence as delay_line,
 * read by the TX fills exactly like the ADC monitor reads delay_line. */
static volatile uint8_t beam_enabled = 0;
static int32_t beam_line[DELAY_LINE_SIZE] __attribute__((aligned(32)));
static uint16_t rx_delay[MIC_COUNT] = {0};        // per-mic delay in samples
static volatile int16_t beam_az_deg = 0;
/* Ganancia de salida del beam. Cuando la fuente es el ADC sigue a in_gain_q8
 * (misma cadena de ganancia que el monitor: los modos 2-6 recortaban igual que
 * el 0 cuando la entrada era de línea). MUST be unity (256) en modos de tono:
 * el tono interno ya está a -6dBFS y ×32 satura contra los PAM —
 * UI_ApplyState() la fija por modo. */
static volatile uint16_t beam_out_q8 = 256;

/* ===== Internal tone source (TX directionality without a mic) =====
 * Writes beam_line[] at the same positions/cadence as the RX beam, so the
 * TX steering path is reused as-is and the delay stays a true TIME delay at
 * any frequency (unlike the CAL_DONE tone, whose phase trick is 1kHz-only).
 * Phase accumulator in table-index Q16 over sine_table_1khz[48] (one exact
 * 1kHz period @48k): step per sample = f/1000 indices. Main-loop context. */
static volatile uint8_t  tone_enabled = 0;
static volatile uint16_t tone_freq_hz = 2000;
static uint32_t tone_phase_q16 = 0;
/* Dither de frecuencia (Fase B, docs/historico (plan implementado: modos 12-13)): triángulo ±5%
 * a ~3Hz alrededor de tone_base_hz. El haz es de retardos puros (banda ancha)
 * → no cambia; los modos de la sala se promedian y la medición se estabiliza.
 * El acumulador de fase de Tone_NextSample es continuo → sin clicks. La
 * frecuencia se actualiza una vez por half-buffer (pasos ≤0.3% cada 10ms).
 * Techo: 2000×1.05 = 2100 Hz < 2140 (límite d=λ/2, sin grating lobes). */
/* Dither de frecuencia: triángulo de ±5% a 3 Hz sobre la base (a 2 kHz son
 * 1900-2100 Hz). Se oye como un tono ONDULANTE, y de ahí el nombre de los modos
 * — no es un tono puro y llamarlo así confundía.
 *
 * No es cosmético ni un defecto: un tono PURO en una sala arma ondas
 * estacionarias con nodos fijos en el espacio, así que caminando se escucha el
 * patrón de la SALA en vez del foco del beam. El dither los emborrona. La
 * verificación del steering del 2026-08-19 —modo 8 más fuerte a 50 cm a la
 * izquierda, modo 9 a la derecha— funcionó gracias a esto. */
#define TONE_DITHER_PERIOD 16000   /* samples @48kHz → LFO de 3 Hz */
static volatile uint16_t tone_base_hz = 2000;
static uint32_t tone_dither_pos = 0;
/* El dither se apaga SOLO para medir (CMD_SET_TONE). Por defecto va prendido en
 * todos los modos de tono, y volver a elegir un modo lo re-enciende: el que
 * escucha nunca hereda un tono puro que dejó puesto una medición. */
static volatile uint8_t tone_dither_en = 1;
// Input/mic X positions in mm (linear placeholder — see MIC_SPACING_MM note)
static float mic_pos_x_mm[MIC_COUNT] = {
  0.0f * MIC_SPACING_MM, 1.0f * MIC_SPACING_MM, 2.0f * MIC_SPACING_MM,
  3.0f * MIC_SPACING_MM, 4.0f * MIC_SPACING_MM, 5.0f * MIC_SPACING_MM,
  6.0f * MIC_SPACING_MM, 7.0f * MIC_SPACING_MM
};

/* ===== TX steering (Phase 2) state =====
 * tx_delay[] is deliberately SEPARATE from beam_config.delays[]: the ESP32
 * config path overwrites beam_config.delays[0..15] on every command (and in
 * beam mode delays[0..7] double as raw RX delays), so aliasing TX steering
 * onto it would silently destroy the focus each time a config arrives.
 * Gains/mutes/master ARE shared from beam_config (per-channel trims). */
/* ============================================================
 * CHIRP ENFOCADO (modo 23) — medir el foco SIN la sala
 * ============================================================
 *
 * El array entero emite el chirp CON los retardos del foco, el microfono lo
 * correlaciona, y se toma el pico de la PRIMERA llegada. Eso mide el sonido
 * directo y descarta las reflexiones por construccion.
 *
 * POR QUE HIZO FALTA. El 2026-09-03, midiendo el perfil del haz con tono
 * continuo en una sala de 3 x 2,5 m, el resultado salio inservible: el campo
 * reverberante compite con el directo y el perfil de un microfono llegaba a
 * tener el maximo a 400 mm de donde estaba el microfono. La misma noche, el
 * chirp del AUTOFOCUS ajusto la posicion de los dos microfonos con 3 mm de
 * error. La diferencia entre los dos no es la precision: es que la correlacion
 * de un chirp se queda con la primera llegada y el tono continuo mide la SUMA
 * de todo lo que hay en la sala.
 *
 * Con esto, el numero del que depende la instalacion —cuanto cae el nivel fuera
 * del foco— se puede medir en la sala que hay, en vez de esperar una mejor.
 *
 * COMO REUSA LO QUE YA ESTABA. No hay emisor nuevo: el chirp se escribe en
 * `beam_line` y el camino de salida de siempre le aplica `tx_delay_q8[]`, o sea
 * los retardos del foco vigente. Cambiar el foco es un POST /beam como en
 * cualquier otro modo. La captura y la correlacion son las del AUTOFOCUS.
 *
 * LA PRIMERA LLEGADA, no el maximo. El maximo global de la correlacion PUEDE
 * ser una reflexion —basta que el foco apunte lejos del microfono y que una
 * pared devuelva mas que el directo—, y justamente en esos puntos es donde
 * importa no equivocarse, porque son los que miden el contraste. Se busca el
 * primer maximo local que pase el 50% del maximo global.
 *
 * VENTANA DE BUSQUEDA. La primera medicion recorre todos los lags; las
 * siguientes solo +-FC_WIN alrededor de la anterior. Mover el foco corre la
 * llegada unas pocas decenas de muestras, asi que 256 sobran, y acotar hace la
 * medicion ~8 veces mas rapida — que es lo que la vuelve usable para barrer.
 */
#define FC_PERIOD_MS   400     /* una medicion completa cada 400 ms */
#define FC_WIN         256     /* +-muestras alrededor de la llegada anterior */
typedef enum { FC_IDLE = 0, FC_ARM, FC_CAPT, FC_CORR, FC_WAIT } fc_state_t;
static volatile uint8_t     fc_enabled = 0;
static volatile fc_state_t  fc_state = FC_IDLE;
static volatile uint16_t    fc_chirp_pos = 0;
static volatile uint32_t    fc_next_ms = 0;
static volatile uint8_t     fc_mic = 0;
static uint32_t fc_corr_lag = 0, fc_corr_end = 0, fc_n_lags = 1;
static int64_t  fc_best_mag = 0, fc_mag_sum = 0;
static int32_t  fc_best_lag = 0;
static int32_t  fc_lag[CAL_NUM_MIC];       /* llegada, muestras Q8 */
static int32_t  fc_peak[CAL_NUM_MIC];      /* |correlacion| del pico */
static uint16_t fc_q10[CAL_NUM_MIC];       /* pico/promedio x10 */
static int32_t  fc_prev_lag = -1;          /* para acotar la busqueda */
/* Numero de medicion COMPLETA. Es lo que le permite al que barre saber que lo
 * que lee es posterior al cambio de foco y no la medicion anterior — sin esto,
 * un barrido rapido lee todo corrido un punto y nadie se entera. */
static volatile uint16_t fc_seq = 0;
static volatile uint16_t fc_retries = 0;   /* ciclos que hubo que reintentar */
static uint32_t fc_capt_deadline = 0;

static volatile uint8_t tx_steer_enabled = 0;
/* TX delays in Q8 fixed point (Fase 3): value = samples×256, so one LSB is
 * 1/256 sample ≈ 0.03mm of acoustic path. The fill interpolates linearly
 * between the two adjacent beam_line samples — the first rung of the
 * sub-sample ladder (polyphase FIR only if measurements ever demand it). */
static uint16_t tx_delay_q8[BEAM_NUM_CHANNELS] = {0}; // ≤ TX_MAX_DELAY_SAMPLES<<8
static int8_t speaker_sign[BEAM_NUM_CHANNELS];       // +1 all — DS11 alternating-
                                                     // polarity fix goes here later
/* Mapeo del arnes: 1 = el canal k mueve el cono k^1. Variable y no constante
 * para poder hacer la prueba A/B a oido en caliente (CMD_SET_SPKMAP). Arranca
 * SIEMPRE en el valor MEDIDO, asi que un reinicio devuelve el muro a lo
 * correcto sin que nadie se tenga que acordar. El porque esta en el comentario
 * largo de SPK_PAIR_SWAP, junto a Beam_InitTxGeometry. */
#define SPK_PAIR_SWAP  1
static volatile uint8_t spk_pair_swap = SPK_PAIR_SWAP;

static float spk_x_mm[BEAM_NUM_CHANNELS];            // built by Beam_InitTxGeometry
static float spk_y_mm[BEAM_NUM_CHANNELS];
static float spk_center_x_mm = 0, spk_center_y_mm = 0;
// Last TX focal point — reported in CMD_STATUS telemetry
static int16_t tx_focus_x_mm = 0, tx_focus_y_mm = 0, tx_focus_z_mm = 0;

/* ===== BARRIDO (modos 16 y 17) — el foco recorre la sala solo =====
 * Los presets 8/9 prueban el steering, pero exigen pararse en un punto
 * descentrado y comparar dos modos de memoria. Acá el foco se mueve solo: parado
 * donde sea, el nivel sube cuando el foco pasa por vos y baja cuando se va. Es
 * la demostración que se entiende sin explicación previa.
 *
 * Triángulo de ±SWEEP_X_MM en 2×SWEEP_HALF_MS. Se reapunta cada SWEEP_STEP_MS
 * desde el main loop: 32 raíces cuadradas por paso, ~3 µs. Ver el comentario de
 * SWEEP_STEP_MS para por qué son 5 ms y no 50 — el salto al reapuntar SÍ se
 * oía. */
#define SWEEP_X_MM      700     /* amplitud a cada lado del centro */
/* Amplitud vertical menor que la horizontal, y no por gusto: la apertura en Y
 * son 480 mm contra 600 mm en X, y a 800 Hz el haz vertical es MUCHO más ancho
 * (±45 cm a 1 m). Barrer ±700 mm sacaría el foco fuera de la zona donde el
 * array todavía puede formarlo, y el recorrido se percibiría como un simple
 * subir y bajar de volumen. ±600 mm es poco más de un ancho de haz a cada
 * lado: el máximo recorrido que sigue siendo un foco moviéndose. */
#define SWEEP_Y_MM      600
#define SWEEP_HALF_MS   2500    /* medio recorrido → ciclo completo de 5 s */
/* 200 actualizaciones por segundo, no 20.
 *
 * Con 50 ms el foco se reapunta 20 veces por segundo, y cada reapuntada mueve
 * el retardo de cada parlante ~0,04 muestras. Eso es un ESCALON de ~1% de
 * amplitud en la señal de salida — y el comentario que estaba acá decía que no
 * se oía. Se oye: pasa 20 veces por segundo, EN FASE en los 32 parlantes a la
 * vez, o sea un zumbido de 20 Hz perfectamente periódico. Fernando lo reportó
 * el 2026-09-03 escuchando el modo 16 ("se escucha un pedito"), que es
 * exactamente como suena una serie de clics a 20 Hz.
 *
 * El error del razonamiento anterior fue mirar el TAMAÑO del escalón y no su
 * REPETICIÓN: 1% es despreciable una vez y es una nota grave veinte veces por
 * segundo.
 *
 * Bajar a 5 ms hace dos cosas a la vez: el escalón se achica 10× (0,004
 * muestras) y su frecuencia sube a 200 Hz, donde además el array casi no radia.
 * El costo son 32 raíces cuadradas cada 5 ms = ~0,06% de CPU. */
#define SWEEP_STEP_MS   5
static volatile uint8_t sweep_axis = 0;   /* 0 = quieto, SWEEP_AXIS_X / _Y */
/* Instante en que se entro al modo. El triangulo se cuenta DESDE ACA y no desde
 * el reloj de la placa, y arranca en el centro del recorrido.
 *
 * Antes usaba HAL_GetTick() crudo, asi que el primer reapunte tiraba el foco
 * donde el triangulo estuviera pasando en ese momento — medido el 2026-09-03,
 * saltos de 89 a 662 mm segun la suerte. En los parlantes del borde eso son
 * ~20 muestras de retardo en un solo buffer: un clic al entrar al modo, uno
 * solo, que es exactamente lo que Fernando reporto ("aparece uno al principio").
 * Arrancar en el centro lo empalma con el (0,0,1000) que dejo UI_ApplyState. */
static uint32_t sweep_t0_ms = 0;

/* ===== MULTIFOCUS (modo 14) — N fuentes internas, cada una con su foco =====
 * Precuela de la intervención de 8 entradas analógicas: la infraestructura
 * (tabla de delays POR FUENTE + Beam_UpdateMFocus) es la que después va a
 * alimentar el modo 8-in — ahí la fuente será delay_line[src] (los ADC) en
 * vez de tonos, con las MISMAS tablas de foco.
 * Para senos, un retardo de tiempo d equivale EXACTO a un offset de fase
 * d×inc — se precalcula en mf_phoff_q16 al setear foco/frecuencia, así el
 * fill no multiplica en 64 bits por muestra. La fase de cada ventana se
 * deriva de mf_frame.
 *
 * ⚠️ mf_frame lo avanza **Process_ADC_Half**, junto a delay_write_pos, y NINGÚN
 * fill lo toca. Antes lo avanzaba el fill de SAI1_A y los otros tres bancos lo
 * leían ya adelantado un buffer entero: eso sólo era inocuo si f×buffer/48000
 * daba entero, o sea con buffer de 480 y frecuencias múltiplo de 100 Hz. Al
 * bajar el buffer a 240 la condición pasó a ser múltiplo de **200**, y
 * 1300/1900/2100 dejaron de cumplirla → las filas 2-3 quedaban en CONTRAFASE
 * con las 0-1 para 3 de los 4 tonos: el foco no salía débil, salía cancelado.
 *
 * Moverlo a otro banco sólo cambiaba de banco privilegiado y dejaba en pie el
 * segundo problema: si ESE banco no se llenaba en una pasada, la fase no
 * avanzaba y el tono repetía la misma ventana. El reloj del pipeline es el RX
 * —Service_Fills lo procesa antes que los 4 TX para que todos vean el mismo
 * snapshot de wp—, así que mf_frame va ahí y el problema desaparece de raíz. */
#define MF_MAX_SRC   8              // techo: las 8 entradas de la intervención
#define MF_NUM_SRC   4              // fuentes activas hoy (4 tonos)
#define MF_SRC_SHIFT 2              // c/fuente a -6dBFS/4 → suma ≤ -6dBFS
#define TONE_PERIOD_Q16 (48u << 16)
static volatile uint8_t mfocus_enabled = 0;
// Defaults: sin relaciones armónicas entre sí, todas < 2140 Hz (límite d=λ/2).
// Focos separados 300mm ≥ ancho del spot (~±14cm @2kHz, ~±23cm @1.3kHz).
// Ya NO hace falta que sean múltiplo de nada: la fase entre bancos dejó de
// depender de la frecuencia al mover el avance de mf_frame al último banco.
static const uint16_t mf_def_freq[MF_NUM_SRC] = { 1300, 1600, 1900, 2100 };
static const int16_t  mf_def_fx[MF_NUM_SRC]   = { -450, -150,  150,  450 };
static uint16_t mf_freq_hz[MF_MAX_SRC];
static int16_t  mf_fx_mm[MF_MAX_SRC], mf_fy_mm[MF_MAX_SRC], mf_fz_mm[MF_MAX_SRC];
static uint32_t mf_inc_q16[MF_MAX_SRC];                      // paso de fase/muestra
static uint16_t mf_delay_q8[MF_MAX_SRC][BEAM_NUM_CHANNELS];  // foco por fuente
static uint32_t mf_phoff_q16[MF_MAX_SRC][BEAM_NUM_CHANNELS]; // delay→fase precalc
static uint32_t mf_frame = 0;       // avanzado SOLO por el fill de SAI1_A

/* Modo 15: MULTIFOCUS de ENTRADAS — la intervención. Cada entrada analógica
 * (delay_line[src], capturadas siempre por Process_ADC_Half) se proyecta
 * enfocada en su punto usando LAS MISMAS tablas mf_delay_q8 del modo 14,
 * con delay temporal verdadero (interpolación Q8 sobre la línea, igual que
 * el TX steering sobre beam_line) — vale para señal arbitraria. */
#define MF_IN_NUM_SRC MF_MAX_SRC    // las 8 entradas del AK5538
static volatile uint8_t mfocus_in_enabled = 0;
/* La ganancia de entrada de este modo es la global (in_gain_q8): ver el
 * comentario de Apply_In_Gain. Ojo con subirla acá: son 8 fuentes sumadas,
 * y 8 × FS × ×32 desbordaría el int32 del acumulador — por eso el clamp
 * del lazo va ANTES del gain por canal. */

/* ===== AUTOFOCUS scan state =====
 * Sequence per speaker: SETTLE (silence, room decay) → ARM (next fill of the
 * speaker's bank emits the chirp and starts the mic capture) → CAPT (fill
 * 100ms) → CORR (cross-correlation, chunked across main-loop passes so the
 * audio pipeline never misses a deadline) → next speaker … → DONE (play a
 * steered tone focused at the mic, using the MEASURED delays & signs). */
typedef enum {
  CAL_IDLE = 0, CAL_SETTLE, CAL_ARM, CAL_CAPT, CAL_CORR, CAL_DONE
} cal_state_t;
static volatile uint8_t autofocus_enabled = 0;
static volatile cal_state_t cal_state = CAL_IDLE;
static volatile uint8_t  cal_ch = 0;            // speaker being measured
static volatile uint16_t cal_settle = 0;        // settle halves remaining
static volatile uint8_t  cal_capturing = 0;
/* Posición dentro del chirp: existe porque el chirp (480) es más largo que una
 * ventana de fill (240) y hay que emitirlo a lo largo de varias. */
static volatile uint16_t cal_chirp_pos = 0;
static volatile uint16_t cal_cap_count = 0;
static int32_t cal_chirp[CAL_CHIRP_LEN];        // 24-bit chirp ref (Cal_Init)
/* [microfono][muestra], 16 bits — ver el comentario de CAL_MIC2_CH */
static int16_t cal_capture[CAL_NUM_MIC][CAL_CAPTURE_LEN];
static volatile uint8_t cal_mic = 0;            // microfono que se esta correlacionando
// Correlation scratch (persist across chunked passes)
static uint32_t cal_corr_lag = 0;
static uint32_t cal_corr_end = 0;               // fin del barrido en curso
static uint32_t cal_n_lags = 1;                 // lags recorridos, para el peak/avg
static int64_t  cal_best_mag = 0;
static int32_t  cal_best_lag = 0;
static int8_t   cal_best_sign = 1;
static int64_t  cal_mag_sum = 0;                // for the peak/avg quality ratio
// Per-speaker results
static int32_t  cal_tof_q8[BEAM_NUM_CHANNELS];  // time of flight, Q8 samples
static int8_t   cal_meas_sign[BEAM_NUM_CHANNELS];
static uint16_t cal_quality[BEAM_NUM_CHANNELS]; // peak/avg ×10 (≥CAL_Q_MIN = solid)
/* Lo mismo, medido por el segundo microfono. Deliberadamente SEPARADO de
 * cal_tof_q8[]: el foco y las polaridades que se aplican y se guardan en la
 * EEPROM siguen saliendo del microfono 1 y de nadie mas. El segundo esta para
 * VALIDAR, no para participar — mezclar los dos convertiria una comprobacion
 * independiente en parte de lo que se quiere comprobar. */
static int32_t  cal_tof2_q8[BEAM_NUM_CHANNELS];
static int8_t   cal_sign2[BEAM_NUM_CHANNELS];
static uint16_t cal_quality2[BEAM_NUM_CHANNELS];
/* Umbral de calidad = peak/avg de la correlación ×10, o sea "cuánto sobresale
 * el eco del parlante por encima del resto de la ventana".
 *
 * ⚠️ EL 50 QUE HABÍA ERA EXACTAMENTE EL VALOR DEL RUIDO. Fernando lo detectó el
 * 2026-08-20: con el micrófono DESCONECTADO el scan reportaba "4/32 útiles" una
 * vez y "7/32" otra. No era casual, y la cuenta lo confirma. Correlacionando
 * ruido blanco contra el chirp, |c| es media-normal:
 *
 *   promedio  = σ·√(2/π)          = 0,798 σ
 *   máximo sobre N = CAL_MAX_LAG = 4320 lags
 *             ≈ σ·√(2·ln N)       = 4,09 σ
 *   peak/avg  ≈ 5,13  →  q10 ≈ 51
 *
 * O sea que el umbral estaba clavado en la MEDIANA de la distribución del
 * ruido: cada canal era una moneda al aire, y 4-7 de 32 caían del lado bueno.
 *
 * Con 100 hace falta un máximo de ~8σ, cuya probabilidad sobre 4320 lags es del
 * orden de 5·10⁻¹²: nunca. Una detección real tiene ganancia de proceso de
 * √480 ≈ 22 en amplitud, así que queda muy por encima. */
#define CAL_Q_MIN 100
/* Pico absoluto de la captura, porque peak/avg es un cociente y NO distingue
 * "señal" de "ruido fuerte": si al micrófono le subís el preamp, el ruido crece
 * arriba y abajo y el cociente no se entera. Este gate sí. */
static volatile int32_t cal_cap_peak = 0;        // microfono 1 (el que decide)
static volatile int32_t cal_cap_peak2 = 0;      // microfono 2
/* Progreso y resultado del scan, publicados en /status (v7). Sin esto, correr
 * el AUTOFOCUS exigía tener el cable serie enchufado para saber si sirvió. */
static volatile uint8_t cal_progress = 0;   // parlantes medidos, 0..CAL_NUM_CH
static volatile uint8_t cal_ok_count = 0;   // de esos, con q ≥ CAL_Q_MIN

/* ===== LOOPBACK — medir el camino de salida por vía ELÉCTRICA =====
 *
 * El AUTOFOCUS mide a través de la sala: lo que devuelve incluye eco,
 * reverberación y la posición del micrófono. Este modo mide el EQUIPO, con un
 * cable: se realimentan salidas de parlante a entradas del ADC a través de un
 * adaptador pasivo (divisor + pasabajos, ver docs/loopback_debug.md §4.2).
 *
 * Lo que habilita, y no se puede medir de ninguna otra forma hoy:
 *
 *   El SYNC entre bancos MEDIDO DEL LADO ANALÓGICO. El número de 4 µs que
 *   publica el heartbeat sale de comparar marcas de DWT->CYCCNT en los
 *   callbacks de DMA: mide cuándo se entera el SOFTWARE, no cuándo sale la
 *   señal. SAI1_A y SAI2_A son masters asíncronos entre sí y su offset queda
 *   fijo al arrancar los streams — es un dato de hardware que nunca se
 *   verificó por fuera del micro.
 *
 * Por eso se emite en los cuatro bancos A LA VEZ y se captura en la misma
 * ventana: el ADC muestrea sus 8 entradas en la misma trama TDM, así que es
 * perfectamente síncrono. Cualquier diferencia entre los retardos medidos es
 * skew REAL de la salida.
 *
 * La correlación es la del AUTOFOCUS. La diferencia es que acá no hay sala en
 * el medio: sin eco, el pico es limpio y el resultado es del equipo. */
#define LB_NUM_EMIT     8      /* el canal PAR y el IMPAR de cada banco */
/* Se miden las OCHO entradas, no cuatro.
 *
 * La primera versión capturaba las entradas 0-3 asumiendo que cada sonda iba a
 * su índice. Eso obliga a cablear de una forma concreta y a acertarle — y el
 * primer cable real (J13 → entrada 4) ya no encajaba. Midiendo las ocho, el
 * firmware DESCUBRE dónde entró la señal en vez de exigir que se lo declaren:
 * se conecta donde sea y el informe dice qué entrada la vio. */
#define LB_NUM_IN       ADC_CHANNELS
/* 50 ms de ventana. La ida y vuelta DAC→adaptador→ADC son unos pocos buffers
 * (~15-20 ms); 50 ms deja margen de sobra y el retardo absoluto se imprime,
 * así que si alguna vez cayera cerca del borde se vería. */
#define LB_CAPTURE_LEN  2400
#define LB_MAX_LAG      (LB_CAPTURE_LEN - CAL_CHIRP_LEN)
#define LB_CORR_CHUNK   128    /* lags por pasada — mismo criterio que el scan */
#define LB_PERIOD_MS    2000   /* repetir la medición cada 2 s */
/* Canales que emiten el chirp. Con un solo adaptador la sonda 0 mide y el resto
 * informa "sin señal" — el modo nunca exigió tenerlos todos.
 *
 * DOS por banco desde el 2026-08-28: el par y el impar. Antes era uno por banco
 * (0, 8, 16, 24), que es lo que mide el skew entre los cuatro SAI — y eso sigue
 * saliendo, porque los cuatro pares siguen emitiendo a la vez.
 *
 * Lo que HABILITA el impar es la prueba de polaridad del arnés, que
 * `ds11-netlist-hallazgos.md` dejó anotada como condición previa al
 * beamforming. Cada JSPK lleva dos canales y su pinout es "+ − − +": en el
 * canal PAR el "+" es el pin 1, en el IMPAR es el pin 4 — una doble inversión
 * deliberada (el impar entra invertido al PAM y sale por OUT−). Si el arnés
 * asume 1=+,2=−,3=+,4=− la mitad de los parlantes queda en contrafase, y en un
 * array eso es una rampa de fase de π por elemento: destruye el foco.
 *
 * Con adaptadores en los pines 1/2 y 4/3 del mismo conector, ambos canales
 * excitados a la vez y la polaridad informada por canal, el lazo contesta esa
 * pregunta en una sola captura. Antes no podía: emitía sólo por canales pares. */
static const uint8_t lb_emit_ch[LB_NUM_EMIT] = { 0, 1, 8, 9, 16, 17, 24, 25 };
typedef enum { LB_IDLE = 0, LB_ARM, LB_CAPT, LB_CORR, LB_WAIT } lb_state_t;
static volatile uint8_t   lb_enabled = 0;
static volatile lb_state_t lb_state = LB_IDLE;
/* int16 y no int32: ocho entradas × 2400 muestras entrarían 76,8 kB en 32 bits y
 * no hay tanto DTCM libre. A 16 bits son los mismos 38,4 kB que ocupaban cuatro
 * canales en 32, y NO se pierde información útil: el piso de ruido del ADC son
 * ~437 cuentas en escala de 24 bits, o sea ~1,7 después del >>16, contra 0,5 de
 * paso de cuantización. El ruido propio ya dithera el bit menos significativo.
 * Para correlacionar sobra: 480 muestras dan 21,9× de ganancia de proceso. */
static int16_t  lb_capture[LB_NUM_IN][LB_CAPTURE_LEN];
static volatile uint16_t lb_cap_count = 0;
static volatile uint8_t  lb_capturing = 0;
static volatile uint16_t lb_chirp_pos = 0;
/* Posición de emisión POR BANCO. Antes los cuatro leían lb_chirp_pos y sólo el
 * banco 24 lo avanzaba, para que dentro de una pasada de Service_Fills los
 * cuatro emitieran el mismo trozo. Eso vale mientras cada pasada llene UNA
 * mitad por banco — pero si el lazo se demora más de 5 ms, la pasada llena las
 * DOS: los bancos 0/8/16 emiten el mismo trozo dos veces mientras el 24 avanza
 * dos veces, y quedan 240 muestras desfasados. Con una posición propia por
 * banco el resultado no depende de cómo se agrupen las mitades en la pasada.
 * Medido: pasa 7 veces por arranque (contador dbl_fill), siempre antes de la
 * primera captura — pero un guardado de EEPROM bloquea ~12 ms y lo dispararía
 * en plena medición, metiendo 5 ms de skew en el modo que mide skew. */
static volatile uint16_t lb_bank_pos[4] = {0,0,0,0};
static volatile uint32_t lb_next_ms = 0;
/* Estado de la correlación, persistente entre pasadas (igual que el scan) */
static uint8_t  lb_probe = 0;
static uint32_t lb_corr_lag = 0;
static int64_t  lb_best_mag = 0, lb_mag_sum = 0;
static int32_t  lb_best_lag = 0;
static int8_t   lb_best_sign = 1;
/* Fase de los DMA en el instante de armar el chirp. Se llenan en el fill del
 * banco 24 y se imprimen en el informe; ver el comentario largo allá. Los dos
 * DMA están programados con la misma cuenta (AUDIO_BUFFER_SIZE*2 =
 * ADC_BUFFER_SIZE*2 = 3840 palabras), así que las posiciones son directamente
 * comparables sin escalar. */
#define LB_DMA_WORDS    (AUDIO_BUFFER_SIZE * 2)
static volatile uint32_t lb_ndtr_rx = 0, lb_ndtr_tx = 0;

/* Instrumentación del ARMADO de la captura — la carrera que §10 dejó anotada.
 *
 * El síntoma: 1 de cada 25 arranques informaba exactamente 240,00 muestras menos
 * —medio buffer justo— con la MISMA fase de DMA. §9 estableció que la fase
 * determina la latencia uno a uno, así que si la fase no cambió, lo que cambió
 * no es el pipeline: es dónde EMPIEZA la ventana capturada.
 *
 * Por qué puede correrse medio buffer: `lb_capturing = 1` se pone en el fill del
 * banco 24, y Service_Fills procesa las mitades del RX ANTES de los cuatro
 * fills. Al armar, la mitad que el RX acaba de terminar puede estar ya consumida
 * —y entonces la captura abre con la mitad que el DMA está escribiendo ahora— o
 * seguir pendiente porque el borde cayó después del chequeo de arriba —y
 * entonces abre con la anterior, 240 muestras más atrás—. Las dos alternativas
 * están separadas por exactamente medio buffer, que es el tamaño del artefacto.
 *
 * Estos tres registros convierten esa conjetura en dato: qué había pendiente al
 * armar, con qué mitad abrió la captura de verdad, y cuántos bordes de RX
 * pasaron en el medio. */
static volatile uint8_t  lb_arm_pend = 0;   /* mitades de RX pendientes al armar */
static volatile uint8_t  lb_cap_half = 0xFF;/* mitad del RX que ABRIÓ la captura */
static volatile uint32_t lb_arm_rxcb = 0;   /* cb_rx3b_count al armar */
static volatile uint32_t lb_cap_rxcb = 0;   /* cb_rx3b_count al primer copiado */

/** @brief Convierte dos lecturas de NDTR en la fase RX-TX, en muestras.
 *
 * NDTR cuenta hacia ABAJO desde la cuenta programada, así que la posición del
 * DMA es (total - NDTR), y dividida por los canales da el índice de muestra
 * dentro del doble buffer. La resta se normaliza a [0, nsamp) porque es una fase
 * circular: sin envolver, el mismo desfasaje se leería como +470 o como -10
 * según dónde caiga.
 */
static int32_t DMA_PhaseFrom(uint32_t ndtr_rx, uint32_t ndtr_tx)
{
    int32_t nsamp = (int32_t)(LB_DMA_WORDS / AUDIO_CHANNELS);
    int32_t d = (int32_t)((LB_DMA_WORDS - ndtr_rx) / ADC_CHANNELS)
              - (int32_t)((LB_DMA_WORDS - ndtr_tx) / AUDIO_CHANNELS);
    while (d < 0)       d += nsamp;
    while (d >= nsamp)  d -= nsamp;
    return d;
}

/** @brief Fase RX-TX de los DMA, medida AHORA.
 *
 * Este número determina la latencia del pipeline de este nodo — medido sobre 20
 * arranques con mapeo uno a uno (docs/loopback_debug.md §9).
 *
 * Lo importante: sale de dos registros. **No hace falta loopback, ni J13, ni
 * adaptador, ni micrófono.** El cable hizo falta para descubrir la relación, no
 * para usarla: cualquier nodo de una instalación de 10-16 cajas puede reportar
 * el suyo y saber en qué estado arrancó (multinode.md §2, nivel 2).
 *
 * Se lee con las interrupciones apagadas para que ningún ISR caiga entre las dos
 * lecturas — el DMA avanza aunque el CPU esté en otra cosa.
 */
static int32_t DMA_PhaseSamples(void)
{
    uint32_t nrx, ntx;
    uint32_t pm = __get_PRIMASK();
    __disable_irq();
    nrx = __HAL_DMA_GET_COUNTER(&hdma_sai3_b);
    ntx = __HAL_DMA_GET_COUNTER(&hdma_sai2_b);
    __set_PRIMASK(pm);
    return DMA_PhaseFrom(nrx, ntx);
}
/* Resultados por ENTRADA */
static int32_t  lb_lag_q8[LB_NUM_IN];
static int8_t   lb_sign[LB_NUM_IN];
static uint16_t lb_q10[LB_NUM_IN];
static int32_t  lb_peak[LB_NUM_IN];
/* Umbral de pico en escala de 16 bits: MIC_LIVE_THRESH está en 24 bits. */
#define LB_PEAK_MIN   (MIC_LIVE_THRESH >> 8)

/* ===== BARRIDO DE FRECUENCIA por el lazo (Test D) =============================
 *
 * Qué mide: amplitud contra frecuencia de la cadena DAC → ADC, emitiendo un
 * tono por los mismos canales que el LOOPBACK y detectándolo coherentemente en
 * las ocho entradas. Con el cable de J13 puesto, eso es la salida del PCM1690
 * del canal 24 tomada antes del amplificador — así que **no hace falta 24 V ni
 * amplificadores**, que es justamente lo que hoy está bloqueado.
 *
 * ⚠️ Alcance, para no leer de más el resultado. J13 pincha entre la R serie de
 * 1 kΩ y el capacitor de acople de 220 nF, y con la placa sin 24 V el PAM8302A
 * está apagado. O sea que este barrido **NO ve el pasaalto de 723 Hz** de §2.1
 * —ése lo forman el acople y la entrada del amplificador— ni nada del clase D.
 * Lo que se mide es DAC + cable + entrada del ADC. Confirmar los 723 Hz sigue
 * necesitando los adaptadores de §4.2 y alimentación.
 *
 * Por qué detección coherente y no pico. El pico mide señal MÁS ruido, y en los
 * extremos del barrido —donde la respuesta cae— eso es un piso que miente:
 * la curva se aplana en el ruido en vez de seguir bajando. Correlacionando
 * contra seno y coseno de la MISMA frecuencia, el ruido se promedia a cero y la
 * ventana de 9600 muestras da ~40 dB de ganancia de proceso. Además la magnitud
 * sqrt(I²+Q²) no depende de la fase, así que no hay que alinear nada con el
 * retardo del lazo (273,7 muestras, §13).
 *
 * La referencia sale de `sine_table_1khz`, la MISMA tabla y la misma
 * interpolación que usan los modos de tono: si se reimplementara acá, el
 * barrido mediría su propia copia. El error de la interpolación lineal sobre 48
 * puntos son −53 dB de armónicos, y la detección coherente ni los ve. */
#define FS_SETTLE     4800u   /* 100 ms de asentamiento: 6τ del acople de entrada */
#define FS_WINDOW     9600u   /* 200 ms de medición — múltiplo exacto de 240 */
/* Cuentas en la referencia para llamar viva a una entrada. Bajo a propósito:
 * con 100 el barrido de volumen se cortaba en −24 dB —tapando justo el rango
 * operativo de −40 dB (§3)— cuando el piso real de la detección coherente son
 * 1-3 cuentas, medido en las entradas sin cable. Con 10 llega a −45 dB. Debajo
 * de ~15 cuentas el error crece a más de 1 dB: el barrido informa el nivel y
 * quien lo lee decide, en vez de que un umbral decida por él. */
#define FS_LIVE_MIN   10
#define FS_PAUSE_MS   2000u
/* Log-espaciadas de 20 Hz a 20 kHz, con 723 (el pasaalto del amp, §2.1) y 800
 * (el modo 17) agregadas aunque este camino no las vea: si alguna vez se mide
 * con los adaptadores, la grilla es la misma y las corridas se comparan. */
#define FS_NUM_BASE   22
/* Cada punto se mide DOS veces, a f y a f+FS_DF, para sacar el retardo de grupo
 * de la diferencia de fase. La separación no es libre: el retardo se resuelve
 * sin ambigüedad sólo si Δφ < π, o sea τ < 1/(2·Δf). Con 40 Hz eso son 12,5 ms
 * = 600 muestras, contra los ~274 medidos en §13 — 2,2× de margen. Más chico
 * daría más margen pero menos resolución en la fase; más grande promedia el
 * retardo sobre una banda demasiado ancha. */
#define FS_DF         40
#define FS_NUM_PTS    (FS_NUM_BASE * 2)
#define FS_REF_BASE   12      /* 1000 Hz — el 0 dB de la tabla */
static const uint16_t fs_base[FS_NUM_BASE] = {
     20,   30,   45,   63,   90,  125,  180,  250,  355,  500,
    723,  800, 1000, 1400, 2000, 2800, 4000, 5600, 8000,11200,
  16000,20000
};
/* ============================================================
 * BARRIDO DE FASE POR PARLANTE (modo 22)
 * ============================================================
 *
 * Un tono puro, UN parlante por vez, y detección coherente en las ocho
 * entradas. Por cada par (parlante, frecuencia) quedan la amplitud Y LA FASE
 * con que ese parlante llega al punto de escucha.
 *
 * POR QUE NO ALCANZABA CON LO QUE YA HABIA
 * ---------------------------------------------------------------
 * El AUTOFOCUS ya recorre los 32 parlantes de a uno, pero correlaciona un
 * chirp: devuelve UN escalar por parlante —el retardo de grupo promediado
 * sobre 500 Hz-6 kHz— y ahí se termina. Si un parlante llega bien en 1 kHz y
 * mal en 3 kHz, el chirp promedia las dos cosas y el número que sale no
 * describe ninguna.
 *
 * El BARRIDO DE FRECUENCIA (modo 20) sí mide fase contra frecuencia, pero con
 * los cuatro bancos emitiendo A LA VEZ: lo que mide es la SUMA en el micrófono.
 * Una suma no se puede desarmar — dos parlantes en contrafase dan lo mismo que
 * dos parlantes mudos.
 *
 * Este modo es el producto cartesiano que faltaba: 32 parlantes x 14
 * frecuencias, cada uno solo. Es lo único que puede contestar "¿llegan todos
 * en fase, y sigue siendo cierto en toda la banda?".
 *
 * LO QUE SE PUEDE LEER DE ESTO, Y QUE NO SE PODIA ANTES
 * ---------------------------------------------------------------
 * - **Arribo en fase.** Restándole a cada parlante su fase geométrica
 *   (2*pi*f*d_k/c, y d_k se conoce), lo que queda tiene que ser IGUAL para los
 *   32. La DISPERSION de ese residuo entre parlantes, frecuencia por
 *   frecuencia, es literalmente "cuánto se desalinean". Y no hace falta
 *   desenvolver nada: es una comparación a f fija.
 * - **Polaridad contra retardo, que el chirp NO distingue.** Un parlante
 *   invertido tiene pi de desfase A TODAS las frecuencias; uno con el retardo
 *   mal tiene un desfase que CRECE con f. En el retardo de grupo del AUTOFOCUS
 *   los dos se ven parecidos.
 * - **Si un retardo alcanza.** Si el residuo de un parlante es una recta en f,
 *   es retardo puro y un solo número lo corrige. Si se curva —probable cerca
 *   de la resonancia de 125-180 Hz de loopback_debug.md §28— NINGUN retardo lo
 *   corrige, y eso hay que saberlo antes de construir una calibración encima.
 * - **Diagnóstico del nodo, de yapa.** Un parlante mudo da amplitud de piso en
 *   las 14 frecuencias; uno flojo, una fila entera baja; uno mal mapeado, un
 *   retardo que no cierra con su posición.
 *
 * Y hay una propiedad que lo hace válido en TODA la banda: con un solo parlante
 * emitiendo no hay array, así que **no hay lóbulos de rejilla**. El techo de
 * 2140 Hz que limita a los modos enfocados acá no aplica; por eso la grilla
 * llega a 5 kHz.
 *
 * COSTO
 * ---------------------------------------------------------------
 * 32 x 14 x 400 ms = 3 minutos. Los resultados viven en la AXI SRAM, que tiene
 * 256 kB sin usar: en DTCM no entrarían (quedan ~18 kB) y en RAM_D2 competirían
 * con los buffers de DMA. No es memoria de DMA — la escribe el CPU una vez cada
 * 400 ms.
 *
 * DELIBERADAMENTE SEPARADO del modo 20
 * ---------------------------------------------------------------
 * Comparte la idea del detector y no comparte una línea de código. Se podría
 * haber parametrizado `fs_*` con un "¿un parlante o todos?" y ahorrar unas
 * treinta líneas; no se hizo porque esas treinta líneas están en el camino
 * caliente del audio, que ya se rompió una vez esta semana por un cambio que
 * parecía inocuo. Duplicar un lazo de acumulación es más barato que enhebrar
 * condicionales por adentro de algo que anda. */
#define PS_NUM_SPK   32
#define PS_NUM_PTS   14
#define PS_SETTLE    4800u    /* 100 ms, igual que el modo 20 */
/* 300 ms y no 200: un parlante solo llega ~30 dB más bajo que los 32 juntos, y
 * la ganancia de proceso de la detección coherente va con la raíz de la
 * ventana. 300 ms dan ~42 dB, que es lo que hace medible un canal solo contra
 * el ruido de una sala real. */
#define PS_WINDOW    14400u
/* Tercios de octava de 250 Hz a 5 kHz. Abajo de 250 el parlante está en su
 * resonancia y la sala manda; arriba de 5 kHz la tabla de 48 puntos deja de ser
 * un seno limpio (9,6 muestras por ciclo). El techo de 2140 Hz de los modos
 * enfocados NO aplica: sin array no hay lóbulos de rejilla. */
static const uint16_t ps_freq[PS_NUM_PTS] = {
   250,  315,  400,  500,  630,  800, 1000,
  1250, 1600, 2000, 2500, 3150, 4000, 5000
};
/* I y Q normalizados por parlante, punto y entrada. Se guardan los dos y no la
 * magnitud: la fase es el punto de este modo, y guardar sólo el módulo la
 * tiraría — que es exactamente el error que el modo 20 ya había corregido. */
static float ps_fi[PS_NUM_SPK][PS_NUM_PTS][ADC_CHANNELS] __attribute__((section(".axi_ram")));
static float ps_fq[PS_NUM_SPK][PS_NUM_PTS][ADC_CHANNELS] __attribute__((section(".axi_ram")));
/* Fase del emisor al abrir cada punto. Igual que fs_tx0 y por el mismo motivo:
 * forzarla a cero rompía la amplitud de forma repetible (§15) y anotarla no
 * cuesta nada. Sin esto las fases de dos parlantes distintos no comparten
 * origen y no se pueden restar — o sea, el modo no mediría nada. */
static uint32_t ps_tx0[PS_NUM_SPK][PS_NUM_PTS] __attribute__((section(".axi_ram")));

typedef enum { PS_IDLE = 0, PS_RUN, PS_DONE } ps_state_t;
static volatile uint8_t     ps_enabled = 0;
static volatile ps_state_t  ps_state = PS_IDLE;
static volatile uint8_t     ps_spk = 0;        /* parlante en curso, 0..31 */
static volatile uint8_t     ps_pt = 0;         /* punto de frecuencia, 0..13 */
static volatile uint8_t     ps_point_ready = 0;
static volatile uint32_t    ps_n = 0;          /* muestras dentro del punto (RX) */
static int64_t  ps_i[ADC_CHANNELS], ps_q[ADC_CHANNELS];
static uint32_t ps_tx_phase = 0;               /* fase del emisor (contexto fill) */
static uint32_t ps_rx_phase = 0;               /* fase del detector (contexto RX) */

_Static_assert(PS_SETTLE % AUDIO_BUFFER_SAMPLES == 0
               && PS_WINDOW % AUDIO_BUFFER_SAMPLES == 0,
               "los puntos tienen que cerrar en un borde de mitad");
_Static_assert(PS_NUM_SPK <= BEAM_NUM_CHANNELS, "mas parlantes de los que hay");

/** @brief Incremento de fase Q16 del punto en curso. Misma cuenta que
 *  Tone_NextSample y que FS_Inc: la tabla es la misma, así que emisor y
 *  detector ven la misma frecuencia por construcción. */
static inline uint32_t PS_Inc(void) {
  uint8_t k = ps_pt;
  if (k >= PS_NUM_PTS) k = 0;         /* mismo clamp que FS_Inc, y por lo mismo */
  return ((uint32_t)ps_freq[k] << 16) / 1000u;
}
/** @brief La frecuencia REAL emitida. `inc` es entero, así que 3150 pedidos son
 *  3149,96 emitidos — despreciable para la amplitud y NO para la fase, que se
 *  multiplica por el retardo. */
static inline float PS_FreqReal(uint8_t k) {
  uint32_t inc = ((uint32_t)ps_freq[k] << 16) / 1000u;
  return (float)inc * 1000.0f / 65536.0f;
}

static volatile uint8_t  fs_enabled = 0;
/* Punto en el que se congela el barrido, o 0xFF para barrer normalmente.
 * FS_HOLD_BASE es el índice en fs_base[]; 9 = 500 Hz. Los puntos van de a dos
 * (la detección coherente usa base y base+FS_DF), de ahí el ×2. */
#define FS_HOLD_BASE  9
static volatile uint8_t  fs_hold_pt = 0xFF;
static volatile uint8_t  fs_idx = 0;
static volatile uint8_t  fs_point_ready = 0;
static volatile uint32_t fs_n = 0;          /* muestras dentro del punto (contexto RX) */
static volatile uint32_t fs_next_ms = 0;
static uint32_t fs_tx_phase = 0;            /* fase del emisor  (contexto de fill) */
static uint32_t fs_bank_ph[4] = {0,0,0,0};  /* fase por banco — ver lb_bank_pos */
static uint32_t fs_rx_phase = 0;            /* fase del detector (contexto RX) */
static int64_t  fs_i[ADC_CHANNELS], fs_q[ADC_CHANNELS];
/* I y Q normalizados, no la magnitud: con los dos se saca amplitud Y fase, y la
 * fase es la que da el retardo de grupo. Guardar sólo el módulo la tiraba. */
static float fs_fi[FS_NUM_PTS][ADC_CHANNELS];
static float fs_fq[FS_NUM_PTS][ADC_CHANNELS];
/* Fase del EMISOR al abrir cada punto. No se fuerza a cero: se anota.
 *
 * El retardo de grupo sale de restar las fases de las dos sub-medidas de un
 * punto, y eso sólo funciona si las dos comparten origen. La primera versión lo
 * conseguía poniendo `fs_tx_phase = 0` al abrir cada punto — y funcionaba para
 * la fase, pero **rompía la amplitud**: medido en A/B contra el mismo firmware
 * sin esa línea, 4 kHz caía 34%, 2 kHz 19% y 1 kHz 10%, de forma perfectamente
 * repetible en 7 barridos, mientras el resto de la tabla no se movía. El
 * mecanismo exacto quedó sin identificar (ver docs/loopback_debug.md §15).
 *
 * Anotar la fase en vez de pisarla da el mismo origen común SIN tocar un solo
 * sample emitido, así que la amplitud queda como estaba y el retardo también
 * sale. La corrección es sumarle 2π·fs_tx0/(48·65536) a la fase detectada. */
static uint32_t fs_tx0[FS_NUM_PTS];

/** @brief Incremento de fase Q16 sobre la tabla de 48 entradas, para fs_freqs[i].
 *  Idéntico al de Tone_NextSample: a 1 kHz da exactamente una entrada por
 *  muestra (48 muestras por ciclo a 48 kHz). Lo usan el emisor y el detector,
 *  así que las dos frecuencias son la misma por construcción y la magnitud no
 *  deriva por más larga que sea la ventana. */
static inline uint16_t FS_FreqOf(uint8_t i) {
  return (uint16_t)(fs_base[i >> 1] + ((i & 1u) ? FS_DF : 0u));
}
static inline uint32_t FS_Inc(uint8_t i) {
  /* El clamp no es paranoia: lo leen el emisor y el detector desde
   * Service_Fills, que corre ANIDADO dentro de UART_Print mientras el informe
   * se imprime. Ahí fs_idx vale FS_NUM_PTS por un rato y sin este clamp se
   * indexa la tabla fuera de rango — HardFault con BFAR justo pasado el final
   * del DTCM, que es exactamente como se descubrió. */
  if (i >= FS_NUM_PTS) i = 0;
  return ((uint32_t)FS_FreqOf(i) << 16) / 1000u;
}
/** @brief La frecuencia REAL del punto, no la nominal.
 *  `inc` es entero, así que 1040 Hz pedidos son 1039,99 Hz emitidos. La
 *  diferencia es despreciable para la amplitud y NO lo es para el retardo de
 *  grupo, que divide por Δf: usar el nominal metería un sesgo de escala. */
static inline float FS_FreqReal(uint8_t i) {
  return (float)FS_Inc(i) * 1000.0f / 65536.0f;
}
/** @brief Un punto de la tabla de seno, interpolado, con la fase en Q16. */
static inline int32_t FS_Sine(uint32_t ph) {
  uint32_t idx = ph >> 16;
  int32_t  fr  = (int32_t)(ph & 0xFFFF);
  int32_t  s0  = sine_table_1khz[idx];
  int32_t  s1  = sine_table_1khz[(idx + 1u) % 48u];
  return s0 + (int32_t)(((int64_t)(s1 - s0) * fr) >> 16);
}
#define FS_PHASE_MAX  (48u << 16)
_Static_assert(FS_SETTLE % AUDIO_BUFFER_SAMPLES == 0
               && FS_WINDOW % AUDIO_BUFFER_SAMPLES == 0,
               "los puntos tienen que cerrar en un borde de mitad");
_Static_assert(FS_REF_BASE < FS_NUM_BASE, "la referencia esta fuera de la tabla");
_Static_assert(FS_NUM_PTS <= 255, "fs_idx es uint8_t");

/* Extra right-shift applied to the -6dBFS sine table.
 * Now 0: the PAM8302A clipping headroom is handled by the PCM1690's own
 * -24dB digital attenuation (registers 72-79, PCM1690_ATTEN_DEFAULT). The
 * -6dBFS table → -30dBFS at the DAC output → clean ~0.5W at the speaker.
 * Kept as a knob for quick test-tone level changes (each step = -6dB). */
static volatile uint8_t test_tone_shift = 0;

// DS10: RST and AMUTEI are shared bus signals (PC11/PC12) — no per-chip GPIO.
// PCM1690_Init receives NULL pins; RST/MUTE are controlled before calling Init.
static const uint8_t dac_addrs[4] = {
    PCM1690_ADDR_DAC0, PCM1690_ADDR_DAC1, PCM1690_ADDR_DAC2, PCM1690_ADDR_DAC3
};

/* Estado del banco de amplificadores (pin SD, PD3). ARRANCA EN 0: tras el
 * incidente del 2026-08-04 (reinicio al primer tono del walker, con el buck
 * al limite y 660uF de bulk en vez de 880) los amps ya NO se habilitan solos
 * al bootear — se prenden por comando (POST /amps) una vez que la placa esta
 * estable. Asi un problema de alimentacion no deja la placa en loop de
 * reinicio imposible de diagnosticar. */
static volatile uint8_t amps_enabled = 0;

/* ===== Arranque autónomo de los amplificadores — issue #19 =====
 *
 * 15 s de espera antes de encender: da tiempo a que el pipeline se asiente y a
 * que alguien que esté en la placa alcance a apagarlo si no era lo que queria.
 * 60 s con los amps prendidos y sin errores nuevos para declarar el intento
 * bueno y borrar el contador. Tres intentos: si el consumo de los amplificadores
 * es lo que reinicia el equipo, tres veces alcanza para saberlo y seguir
 * intentando solo produce un nodo que rebota toda la noche. */
#define AUTOSTART_ARM_MS      15000u
#define AUTOSTART_STABLE_MS   60000u
#define AUTOSTART_MAX_FAILS   3

typedef enum {
  AS_OFF = 0,      /* desactivado, o ya se rindió */
  AS_WAIT,         /* contando los 15 s */
  AS_SETTLING,     /* amps encendidos, contando los 60 s */
  AS_DONE,         /* estable: contador limpio */
  AS_GAVEUP        /* se rindió tras AUTOSTART_MAX_FAILS */
} autostart_state_t;

static autostart_state_t autostart_state = AS_OFF;
static uint32_t autostart_t0 = 0;         /* referencia del temporizador */
static uint32_t autostart_und0 = 0;       /* underruns al armar */
static uint32_t autostart_sai0 = 0;       /* errores de SAI al armar */

/* Causa del último reset, latcheada en main() antes de que nada la pise.
 *
 * Existe por una pregunta concreta que apareció el 2026-08-27 y que no se pudo
 * contestar con el log: la placa se reinició con los amplificadores encendidos
 * y no había forma de saber si fue un corte de luz o el hundimiento del riel
 * de la falla #2 (C290 removido, 660 uF de bulk sobre los 32 PAM8302A). El
 * ESP32 no se había reiniciado, lo que apuntaba al riel — pero era inferencia,
 * no medición. Esto lo mide.
 *
 * Va en el heartbeat y no sólo en el banner de arranque a propósito: en aquel
 * reinicio el banner SE PERDIO (el log salta de [86447s] a [3s] sin banner,
 * porque el VCP del ST-Link tarda en volver). La telemetría periódica no se
 * pierde. */
static uint32_t reset_rsr = 0;
static const char *reset_tag = "?";
/* 1 = un POST /beam pisó los flags de modo: ui_state_idx ya no describe lo que
 * suena. Se publica en el status (STATE_F_CUSTOM) para que la UI no mienta. */
static volatile uint8_t custom_beam_active = 0;

// EEPROM deferred save flag (set when config changes, save in low-priority window)
static volatile uint8_t eeprom_save_pending = 0;
// Config-save debounce: HAL_GetTick() deadline (0 = nothing pending). Any config
// change (modo K2, /volume, CMD_UPDATE_CFG) re-arma el deadline; la EEPROM se
// escribe UNA vez, 3s después del último cambio. Un slider arrastrado ya no
// genera una ráfaga de saves de ~12ms (≈6 underruns cada uno).
#define CFG_SAVE_DEBOUNCE_MS 3000
static volatile uint32_t cfg_save_due_tick = 0;

static inline void Arm_Config_Save(void) {
  cfg_save_due_tick = HAL_GetTick() + CFG_SAVE_DEBOUNCE_MS;
  if (cfg_save_due_tick == 0) cfg_save_due_tick = 1;  // 0 = "nothing pending"
}

// LED dimmer state machine (DS10 TIM3 4-channel: CH1=D4/PA6 Yellow, CH2=D5/PA7 Red,
//                                                  CH3=D6/PB0 Green,  CH4=D7/PB1 White)
// 4 phases of 3s each (12s full cycle): one LED fade-in 0→max while others off.
#define DIMMER_STEPS     300UL
#define DIMMER_STEP_CYC  (480000000UL / 100UL)  // 10ms @ 480MHz
#define DIMMER_ARR       999UL
#define DIMMER_NUM_PHASES 4
static uint8_t  dimmer_phase    = 0;
static uint32_t dimmer_step     = 0;
static uint32_t last_dimmer_dwt = 0;
static const uint32_t dimmer_channels[DIMMER_NUM_PHASES] = {
    TIM_CHANNEL_1,  // D4 Yellow PA6
    TIM_CHANNEL_2,  // D5 Red    PA7
    TIM_CHANNEL_3,  // D6 Green  PB0
    TIM_CHANNEL_4,  // D7 White  PB1
};

// ===== ISR → Main loop deferred processing flags =====
// ISR sets flag, main loop processes buffer and clears flag
// This keeps ISR execution < 20 cycles (vs ~50000 with sinf())
/* Cuántas veces una pasada de Service_Fills llenó LAS DOS mitades del mismo
 * banco. Importa porque el avance del emisor (chirp del modo 19, tono del 20)
 * vive en el banco 24: en una pasada doble, los bancos 0/8/16 emiten el mismo
 * trozo dos veces mientras el 24 avanza dos veces, y quedan 240 muestras
 * desfasados. Justo el error que el modo 19 existe para medir. */
static volatile uint32_t dbl_fill[4] = {0,0,0,0};

/* ===== ¿El fill lee un bloque FRESCO, o repite el anterior? =====
 *
 * Los modos que salen del delay_line —el monitor, los beams RX, el TX steering
 * y el MULTIFOCUS de entradas— leen la ventana de 240 muestras que
 * Process_ADC_Half acaba de escribir. Si en una pasada hay un fill de TX pero la
 * mitad del RX todavia no llego, el fill vuelve a leer LA MISMA ventana; si
 * llegan dos mitades entre dos fills, una no sale nunca. Repetir y saltear
 * suenan igual: rotura. Sano = 200 / 0 / 0 por segundo.
 *
 * ⚠️ Hubo un cursor de lectura aca y fue un error caro. La idea —consumir las
 * ventanas en orden en vez de saltar siempre a la mas nueva— es correcta, pero
 * la implementacion ataba la eleccion de ventana a las banderas del BANCO 0 y se
 * la pasaba a los otros tres. Los cuatro bancos NO siempre caen en la misma
 * pasada del main loop: medido, ~20 veces por segundo el banco 0 no tiene
 * bandera y los otros si, y esos se llenaban con la ventana que ya habian
 * emitido. Diez por ciento de repeticiones en 24 de los 32 canales.
 *
 * Y los contadores no lo vieron, porque miden que el cursor AVANCE bien, no que
 * APUNTE bien. Lo delato el oido, y despues un contador escrito para eso.
 *
 * Cada banco vuelve a derivar su ventana de delay_write_pos, como el codigo
 * original, que no acopla los bancos entre si. Lo que hace que eso ALCANCE hoy y
 * no alcanzara antes son las otras dos correcciones: la fase de los DMA a media
 * ventana del borde (a586a34) y el heartbeat que dejo de trabar el lazo 37 ms
 * (04fb2e0). Sin trabones del main loop, el RX no se adelanta dos ventanas. */
static volatile uint32_t fill_fresh  = 0;   /* ventanas con datos nuevos */
static volatile uint32_t fill_repeat = 0;   /* wp no avanzo: ventana repetida */
static volatile uint32_t fill_skip   = 0;   /* wp avanzo de mas: ventana perdida */
static volatile uint32_t fill_max_lag = 0;  /* avance maximo visto, en muestras */
static uint32_t dwp_prev = 0;
static uint8_t  dwp_init = 0;

/** @brief Una medicion por ventana de TX que produce el banco 0. */
static void Fill_CheckFreshness(uint8_t nwin)
{
  uint32_t now = delay_write_pos;
  if (!dwp_init) { dwp_init = 1; dwp_prev = now; return; }
  uint32_t d = (now - dwp_prev) & DELAY_LINE_MASK;
  if (d > fill_max_lag) fill_max_lag = d;
  if (d == 0)                                          fill_repeat += nwin;
  else if (d == (uint32_t)nwin * AUDIO_BUFFER_SAMPLES) fill_fresh  += nwin;
  else                                                 fill_skip   += nwin;
  dwp_prev = now;
}
static volatile uint8_t need_fill_first_half = 0;
static volatile uint8_t need_fill_second_half = 0;
static volatile uint8_t need_fill_2a_first_half = 0;
static volatile uint8_t need_fill_2a_second_half = 0;
static volatile uint8_t need_fill_1b_first_half = 0;
static volatile uint8_t need_fill_1b_second_half = 0;
static volatile uint8_t need_fill_2b_first_half = 0;
static volatile uint8_t need_fill_2b_second_half = 0;
static volatile uint8_t rx_3b_first_half_ready = 0;
static volatile uint8_t rx_3b_second_half_ready = 0;

/* Underrun = bandera puesta y no servida antes de la próxima ISR, o sea un
 * deadline de fill perdido = medio buffer repetido = un pop.
 *
 * Hay DOS contadores a propósito. `underrun_count` se pone en cero cada 60 s,
 * porque el resumen periódico informa "por ciclo". `underrun_total` NO se
 * resetea nunca y es el que va a la telemetría: sin él, `/status` parecía
 * acumulativo pero retrocedía sola cada minuto, y cualquier medición por
 * diferencia daba números imposibles (negativos incluidos). Lo mismo para los
 * errores del SAI. */
static volatile uint32_t underrun_count = 0;
static volatile uint32_t underrun_total = 0;
static volatile uint32_t sai_error_total = 0;

// Callback counters for debug
static volatile uint32_t half_complete_count = 0;
static volatile uint32_t full_complete_count = 0;
static volatile uint32_t error_count = 0;
static volatile uint32_t last_sai_error = 0;

// Per-SAI-block callback counters (Half+Full) — to localize silent channels.
// If 1B/2A/2B don't advance, those DACs never get the tone (ch8-31 silent).
static volatile uint32_t cb_a1_count = 0;
static volatile uint32_t cb_1b_count = 0;
static volatile uint32_t cb_2a_count = 0;
static volatile uint32_t cb_2b_count = 0;
// RX (ADC) DMA callback counter — if this does NOT advance ~100/s, the SAI3_B
// RX DMA is stalled and audio_buffer_3b_rx is frozen (explains "input does
// nothing"). This is the decisive ADC data-path liveness check.
static volatile uint32_t cb_rx3b_count = 0;

// ===== Latency & Jitter measurement via DWT cycle counter =====
// DWT->CYCCNT runs at CPU clock (480MHz → 2.08ns/cycle)
static volatile uint32_t last_half_isr_cycles = 0;
static volatile uint32_t last_full_isr_cycles = 0;

// Jitter tracking: callback period variation (Half + Full combined)
static volatile uint32_t jitter_min_cycles = 0xFFFFFFFF;
static volatile uint32_t jitter_max_cycles = 0;
static volatile uint64_t jitter_sum_cycles = 0;
static volatile uint32_t jitter_sample_count = 0;

/* Costo TOTAL de los 4 bancos (DS11): el min/avg/max de abajo mide SOLO los
 * fills de SAI1_A, así que con 32 canales subrepresenta ~4× el trabajo real.
 * fill_all_cycles acumula TODOS los fills; el heartbeat lo derivada a %CPU.
 * Presupuesto: 480M ciclos/s → cada 1% son 4.8M ciclos/s. */
static volatile uint64_t fill_all_cycles = 0;
/* Último % de CPU en fills (×10), calculado en el heartbeat y publicado por
 * telemetría: sin esto, "este modo no entra en presupuesto" sólo se podía
 * diagnosticar con el cable serie enchufado. */
static volatile uint16_t cpu_fills_x10 = 0;
/* Lo mismo para el procesamiento de ENTRADA, que estaba sin medir.
 *
 * `fill_all_cycles` cuenta los cuatro fills de salida, y las marcas de DWT
 * empiezan DESPUÉS de las dos llamadas a Process_ADC_Half — así que todo el
 * lado del ADC quedaba fuera del presupuesto publicado: las delay lines, el
 * MULTIFOCUS de entradas, los detectores coherentes, y cualquier reproductor
 * futuro. Alguien podía mirar /status, ver el mismo porcentaje que antes y
 * declarar victoria mientras los underruns subían. */
static volatile uint64_t adc_all_cycles = 0;
static volatile uint16_t cpu_adc_x10 = 0;
/* Offset entre bancos: timestamp del último Half callback de cada master.
 * SAI1_A y SAI2_A son masters asíncronos entre sí — si arrancan separados,
 * ese desfase queda fijo para siempre. Se reporta en la línea SYNC. */
static volatile uint32_t cb_a1_half_dwt = 0;
static volatile uint32_t cb_2a_half_dwt = 0;

// Processing latency: fill buffer + cache clean
static volatile uint32_t fill_min_cycles = 0xFFFFFFFF;
static volatile uint32_t fill_max_cycles = 0;
static volatile uint64_t fill_sum_cycles = 0;
static volatile uint32_t fill_sample_count = 0;

// UART TX buffer
static char uart_buf[128];

// Test cycle counter (for 60s status reports)
static uint32_t test_cycle = 0;

/* USER CODE END PV */

void SystemClock_Config(void);
void PeriphCommonClock_Config(void);
static void MX_GPIO_Init(void);
static void MX_DMA_Init(void);
static void MX_I2C1_Init(void);
static void MX_I2C3_Init(void);
static void MX_UART7_Init(void);
static void MX_SAI1_Init(void);
static void MX_UART4_Init(void);
static void MX_SAI2_Init(void);
static void MX_SAI3_Init(void);
static void MX_ADC3_Init(void);
static void MX_TIM3_Init(void);
/* USER CODE BEGIN PFP */
static int32_t Read_CPU_Temperature(void);
static void Rail_Poll(void);
static void Fill_Audio_Beamform(int32_t *buffer, uint32_t samples, uint32_t ch_offset);
static void Process_ADC_Half(int32_t *rx_buf, uint32_t samples);
static void Service_Fills(void);
static void Set_In_Gain(uint8_t db);
static void Set_Amps(uint8_t on);
static void Autostart_Tick(void);
static void Autostart_ManualOverride(uint8_t turning_on);
static void Config_LoadDefaults(void);
static void Config_FactoryReset(void);
static void UART_Print(const char *str);
static void Check_Memory_Placement(void);
static void Beam_UpdateDelays(int16_t az_deg);
static void Beam_InitTxGeometry(void);
static void Beam_UpdateTxFocus(int16_t fx_mm, int16_t fy_mm, int16_t fz_mm);
static void Beam_SetTxFocus(int16_t fx_mm, int16_t fy_mm, int16_t fz_mm);
static void Beam_UpdateMFocus(uint8_t src, uint16_t f_hz,
                              int16_t fx_mm, int16_t fy_mm, int16_t fz_mm);
static void MFocus_ApplyDefaults(void);
static void MFocusIn_ApplyDefaults(void);
static uint8_t Apply_Master_Volume(int8_t db);
static void UI_ApplyState(uint8_t idx);
static void UI_ApplyCustomBeam(const ds_beam_req_t *req);
static void Cal_Init(void);
static void Cal_StartScan(void);
static void Cal_Process(void);
static void LB_Process(void);
static void FS_Process(void);
static void PS_Process(void);
static void PS_Start(void);
static void FC_Process(void);
static void FC_Start(void);
static void FC_Arm(void);
static void OTA_ServiceRequests(void);
static void Health_Run(ds_health_t *h);
/* USER CODE END PFP */

/**
 * @brief Servicia todos los fills pendientes (RX del ADC + los 4 bancos TX).
 *
 * Extraido del main loop para poder llamarlo TAMBIEN desde UART_Print mientras
 * espera al UART. Un heartbeat de ~238 chars a 115200 bloquea ~20 ms, mas que el
 * deadline de 10 ms del fill, y cada deadline perdido es un medio buffer repetido
 * en los 32 canales a la vez = un pop audible una vez por segundo. Con esto el
 * print deja de robarle tiempo al audio.
 *
 * El guard de reentrada es defensivo: hoy ningun fill imprime, pero si alguno lo
 * hiciera en el futuro esto evita la recursion en vez de desbordar el stack.
 */
/* Overrides de los hooks __weak de eeprom_config.c y uart_protocol.c: durante
 * los ~12 ms de un guardado en EEPROM y los ~5,2 ms de una trama de status,
 * seguir sirviendo los fills en vez de dejar morir los deadlines. Los tres
 * bloqueos largos del sistema (print, EEPROM, status) quedan así cooperativos. */
void EEPROM_Yield(void)        { Service_Fills(); }
void UART_Protocol_Yield(void) { Service_Fills(); }
/* Lo mismo para la verificación del CRC de una imagen OTA (~1,4 ms de un tirón
 * sobre 80 kB). El borrado de un sector NO se puede cooperativizar: ahí el CPU
 * queda en espera activa sobre el registro de estado del flash. Por eso el
 * borrado se hace con los amplificadores ya apagados. */
void OTA_Yield(void)           { Service_Fills(); }

/* ============================================================
 * Actualización de firmware por WiFi — lado main loop
 *
 * Recibe la imagen del ESP32 y la deja en el banco 2 (ota.c). No la aplica: eso
 * lo hace el bootloader en el próximo arranque, y por eso una carga que sale
 * mal —CRC que no cierra, WiFi que se corta, la corriente que se va— no cuesta
 * absolutamente nada: el firmware que está corriendo vive en el banco 1 y este
 * código no lo puede tocar. Ver ota.h.
 *
 * El equipo queda MUDO durante la carga, a propósito: el borrado del sector
 * bloquea el CPU cientos de milisegundos y eso son decenas de deadlines de fill
 * perdidos. En vez de dejar que salga por los parlantes como una serie de pops,
 * se apagan los amplificadores en FW_BEGIN. Vuelven con el reinicio (arrancan
 * apagados) y se prenden a mano como siempre.
 * ============================================================ */

/* Número de tramo esperado. La comprobación no es paranoia: sin ella, un ACK
 * que se pierda hace que el ESP32 reenvíe el mismo tramo y el STM32 lo escriba
 * DOS VECES, corriendo todo lo que sigue medio tramo — con el CRC fallando al
 * final y sin ninguna pista de dónde. */
static volatile int16_t sync_us_last = 0;   /* último SYNC entre bancos, ver el heartbeat */

/* ============================================================
 * Captura remota del ADC
 *
 * Guarda las 8 entradas crudas para bajarlas y analizarlas afuera. Hasta ahora
 * medir era mirar números por el serie: el modo 19 hace una medición completa y
 * devuelve UN pico y UN retardo, y todo lo demás —la forma de onda, el
 * contenido en frecuencia, lo que pasa entre canales— se calculaba adentro y se
 * tiraba. Con las muestras afuera, la placa deja de tener que saber de antemano
 * qué se le va a preguntar.
 *
 * Vive en la AXI SRAM, que estaba ENTERA sin usar: 256 kB acá no le sacan nada
 * a nadie. En DTCM no entraría (quedan ~23 kB) y en RAM_D2 competiría con los
 * buffers de DMA.
 *
 * Se guarda en int32 con los 24 bits del ADC y se transmite en int16 con
 * autorrango — ver ds_cap_info_t. Guardar la precisión completa y decidir el
 * desplazamiento DESPUÉS, con el pico ya conocido, es lo que permite capturar
 * tanto un chirp a fondo de escala como el piso de ruido de 437 cuentas.
 * ============================================================ */
#define CAP_MAX_SAMPLES   8192      /* 170 ms a 48 kHz; 8192×8×4 = 256 kB */

typedef enum { CAP_IDLE = 0, CAP_FILL, CAP_READY } cap_state_t;

static int32_t cap_buf[CAP_MAX_SAMPLES][ADC_CHANNELS] __attribute__((section(".axi_ram")));
static volatile cap_state_t cap_state = CAP_IDLE;
static volatile uint16_t    cap_want = 0;      /* muestras pedidas */
static volatile uint16_t    cap_count = 0;     /* muestras ya guardadas */
static uint8_t              cap_shift = 0;     /* autorrango, calculado al llenar */
static int32_t              cap_peak = 0;
static uint8_t              cap_info_due = 0;  /* hay un CAP_START esperando respuesta */

static uint16_t ota_seq_next = 0;

/* Reinicio diferido tras una carga exitosa. No se reinicia en el acto: primero
 * tiene que salir el ACK, y después el ESP32 tiene que contestarle al navegador
 * que la carga terminó. Si el STM32 se reinicia antes, la página muestra un
 * error justo cuando todo salió bien. */
static uint32_t ota_reboot_at = 0;

/* Una carga que se queda a mitad —el ESP32 se reinicia, el navegador se cierra,
 * el WiFi se cae— dejaría la sesión abierta para siempre, con el equipo mudo y
 * /status informando "recibiendo 43%" indefinidamente. No es peligroso, pero es
 * un estado del que nadie sabe cómo salir. Treinta segundos son un orden de
 * magnitud más que el tramo más lento. */
#define OTA_IDLE_TIMEOUT_MS  30000

/* ============================================================
 * Autodiagnóstico — lo que los chips REALMENTE tienen adentro
 *
 * Vuelve a leer por I2C la configuración de los cuatro PCM1690, del AK5538VN y
 * de la EEPROM. No es telemetría: es una prueba activa, y por eso existe.
 *
 * El caso que justifica todo esto: un PCM1690 al que se le fue el registro de
 * formato deja de decodificar el TDM y saca ruido o silencio — y sin embargo
 * `underruns` sigue en cero, el CPU sigue igual y el /status entero se ve
 * perfecto. Ningún contador pasivo lo ve. Sólo se nota escuchando, o leyendo
 * los registros.
 *
 * Se devuelven los VALORES, no un veredicto: un rojo que no se puede discutir
 * es un rojo en el que no se confía.
 *
 * ⚠️ Bloquea unos pocos ms de I2C. Corre en el main loop, nunca en una ISR.
 * ============================================================ */
static void Health_Run(ds_health_t *h)
{
  memset(h, 0, sizeof(*h));

  for (uint32_t d = 0; d < 4; d++) {
    uint8_t v = 0;
    if (PCM1690_ReadReg(&hi2c1, dac_addrs[d], PCM1690_REG_FORMAT, &v) == PCM1690_OK) {
      h->dac_present |= (uint8_t)(1u << d);
      h->dac_fmt[d] = v;
      if (PCM1690_ReadReg(&hi2c1, dac_addrs[d], PCM1690_REG_ATTEN_CH1, &v) == PCM1690_OK)
        h->dac_att[d] = v;
    }
    Service_Fills();       /* cada lectura son ~200 µs; igual no se dejan morir */
  }

  /* AK5538VN por I2C3. R02/R03/R04 son los que se escriben en el arranque; que
   * sigan ahí confirma que el chip no se reinició por su cuenta. */
  for (uint8_t r = 1; r <= 4; r++) {
    uint8_t v = 0xEE;
    if (HAL_I2C_Mem_Read(&hi2c3, AK5538_ADDR, r, I2C_MEMADD_SIZE_8BIT, &v, 1, 50) == HAL_OK) {
      h->ak_present = 1;
      h->ak_regs[r - 1] = v;
    }
  }
  Service_Fills();

  h->eeprom_present = EEPROM_IsAvailable() ? 1 : 0;
  h->eeprom_ver     = EEPROM_CFG_VERSION;
  h->sync_us        = sync_us_last;
}

static void OTA_ServiceRequests(void)
{
  static uint32_t ota_last_ms = 0;

  if (UART_Protocol_GetFwAbort()) {
    OTA_Abort();
    UART_Print("OTA: carga cancelada\r\n");
  }

  if (OTA_GetState() == OTA_ST_RECV && ota_last_ms != 0 &&
      (HAL_GetTick() - ota_last_ms) > OTA_IDLE_TIMEOUT_MS) {
    OTA_Abort();
    ota_last_ms = 0;
    UART_Print("OTA: la carga se cortó y no volvió — sesión abandonada\r\n");
  }

  static uint8_t pl[PROTO_MAX_PAYLOAD];
  uint8_t  cmd = 0;
  uint16_t n   = 0;
  if (!UART_Protocol_TakeFwRequest(&cmd, pl, &n)) return;

  ota_last_ms = HAL_GetTick();

  uint8_t ok = 0;

  if (cmd == CMD_FW_BEGIN && n == sizeof(ds_fw_begin_t)) {
    ds_fw_begin_t b;
    memcpy(&b, pl, sizeof(b));
    Set_Amps(0);                       /* mudo antes de bloquear en el borrado */
    ok = (OTA_Begin(b.len, b.fw_id, b.build) == 0);
    ota_seq_next = 0;
    if (ok) {
      snprintf(uart_buf, sizeof(uart_buf),
               "OTA: recibiendo %lu bytes (id %08lX) — amps apagados\r\n",
               (unsigned long)b.len, (unsigned long)b.fw_id);
    } else {
      snprintf(uart_buf, sizeof(uart_buf), "OTA: no arranco — %s\r\n", OTA_GetError());
    }
    UART_Print(uart_buf);

  } else if (cmd == CMD_FW_DATA && n >= 3) {
    uint16_t seq = (uint16_t)pl[0] | ((uint16_t)pl[1] << 8);
    if (seq == ota_seq_next) {
      ok = (OTA_Data(&pl[2], (uint16_t)(n - 2)) == 0);
      if (ok) ota_seq_next++;
      else {
        snprintf(uart_buf, sizeof(uart_buf), "OTA: fallo en el tramo %u — %s\r\n",
                 (unsigned)seq, OTA_GetError());
        UART_Print(uart_buf);
      }
    } else if ((uint16_t)(seq + 1U) == ota_seq_next) {
      /* Reenvío del tramo anterior: se perdió NUESTRO ack, no sus datos. Se
       * vuelve a ACKear sin escribir nada. */
      ok = 1;
    } else {
      snprintf(uart_buf, sizeof(uart_buf),
               "OTA: tramo fuera de orden (llego %u, esperaba %u) — carga abortada\r\n",
               (unsigned)seq, (unsigned)ota_seq_next);
      UART_Print(uart_buf);
      OTA_Abort();
    }

  } else if (cmd == CMD_FW_END && n == 4) {
    uint32_t crc = (uint32_t)pl[0]        | ((uint32_t)pl[1] << 8)
                 | ((uint32_t)pl[2] << 16) | ((uint32_t)pl[3] << 24);
    ok = (OTA_End(crc) == 0);
    if (ok) {
      UART_Print("OTA: imagen verificada. Reiniciando para aplicarla...\r\n");
      ota_reboot_at = HAL_GetTick() + 1500;
    } else {
      snprintf(uart_buf, sizeof(uart_buf), "OTA: imagen RECHAZADA — %s\r\n", OTA_GetError());
      UART_Print(uart_buf);
    }
  }

  UART_Protocol_FwReply(ok);
}

static void Service_Fills(void) {
  static volatile uint8_t in_service = 0;
  if (in_service) return;
  in_service = 1;

  // ===== Deferred buffer fill: beamform from delay line =====
  // ISR sets flag, we process here in main context.
  //
  // SAI3_B RX must run BEFORE the 4 TX fills below: all 4 TX groups read
  // delay_write_pos independently, so if RX advanced it between two TX
  // fills within the same pass, those groups would read different time
  // windows — a phase skew across DAC banks that's silent in passthrough
  // (delay=0) but would break beamforming once real per-channel delays
  // are in use. Processing RX first makes wp stable for the rest of
  // this loop iteration, so all 4 TX fills see the same snapshot.
  if (rx_3b_first_half_ready) {
    rx_3b_first_half_ready = 0;
    __DSB();
    uint32_t t0 = DWT->CYCCNT;
    Process_ADC_Half(&audio_buffer_3b_rx[0], ADC_BUFFER_SAMPLES);
    adc_all_cycles += DWT->CYCCNT - t0;
  }
  if (rx_3b_second_half_ready) {
    rx_3b_second_half_ready = 0;
    __DSB();
    uint32_t t0 = DWT->CYCCNT;
    Process_ADC_Half(&audio_buffer_3b_rx[ADC_BUFFER_SIZE], ADC_BUFFER_SAMPLES);
    adc_all_cycles += DWT->CYCCNT - t0;
  }

  /* Las banderas del banco 0 se leen y se limpian UNA VEZ, con las
   * interrupciones apagadas: entre dos lecturas de la misma bandera cabe una
   * ISR, y ahi se emitian ventanas que la cuenta no veia. */
  uint8_t f0, f1;
  {
    uint32_t pm = __get_PRIMASK();
    __disable_irq();
    f0 = need_fill_first_half;  need_fill_first_half  = 0;
    f1 = need_fill_second_half; need_fill_second_half = 0;
    __set_PRIMASK(pm);
  }
  {
    uint8_t nwin = (uint8_t)((f0 ? 1 : 0) + (f1 ? 1 : 0));
    if (nwin) Fill_CheckFreshness(nwin);
  }

  // SAI1_A: channels 0-7
  uint8_t did_first_0 = 0;
  if (f0) {
    did_first_0 = 1;
    __DSB();
    uint32_t t0 = DWT->CYCCNT;
    Fill_Audio_Beamform(&audio_buffer[0], AUDIO_BUFFER_SAMPLES, 0);
    __DSB();
    uint32_t dt = DWT->CYCCNT - t0;
    if (dt < fill_min_cycles) fill_min_cycles = dt;
    if (dt > fill_max_cycles) fill_max_cycles = dt;
    fill_sum_cycles += dt;
    fill_all_cycles += dt;
    fill_sample_count++;
  }
  if (f1 && did_first_0) dbl_fill[0]++;
  if (f1) {
    __DSB();
    uint32_t t0 = DWT->CYCCNT;
    Fill_Audio_Beamform(&audio_buffer[AUDIO_BUFFER_SIZE], AUDIO_BUFFER_SAMPLES, 0);
    __DSB();
    uint32_t dt = DWT->CYCCNT - t0;
    if (dt < fill_min_cycles) fill_min_cycles = dt;
    if (dt > fill_max_cycles) fill_max_cycles = dt;
    fill_sum_cycles += dt;
    fill_all_cycles += dt;
    fill_sample_count++;
  }

  // SAI1_B: channels 8-15 (DAC1 U3)
  uint8_t did_first_1 = 0;
  if (need_fill_1b_first_half) {
    need_fill_1b_first_half = 0;
    did_first_1 = 1;
    __DSB();
    uint32_t t0 = DWT->CYCCNT;
    Fill_Audio_Beamform(&audio_buffer_1b[0], AUDIO_BUFFER_SAMPLES, 8);
    __DSB();
    fill_all_cycles += DWT->CYCCNT - t0;
  }
  if (need_fill_1b_second_half && did_first_1) dbl_fill[1]++;
  if (need_fill_1b_second_half) {
    need_fill_1b_second_half = 0;
    __DSB();
    uint32_t t0 = DWT->CYCCNT;
    Fill_Audio_Beamform(&audio_buffer_1b[AUDIO_BUFFER_SIZE], AUDIO_BUFFER_SAMPLES, 8);
    __DSB();
    fill_all_cycles += DWT->CYCCNT - t0;
  }

  // SAI2_A: channels 16-23 (DAC2 U1)
  uint8_t did_first_2 = 0;
  if (need_fill_2a_first_half) {
    need_fill_2a_first_half = 0;
    did_first_2 = 1;
    __DSB();
    uint32_t t0 = DWT->CYCCNT;
    Fill_Audio_Beamform(&audio_buffer_2a[0], AUDIO_BUFFER_SAMPLES, 16);
    __DSB();
    fill_all_cycles += DWT->CYCCNT - t0;
  }
  if (need_fill_2a_second_half && did_first_2) dbl_fill[2]++;
  if (need_fill_2a_second_half) {
    need_fill_2a_second_half = 0;
    __DSB();
    uint32_t t0 = DWT->CYCCNT;
    Fill_Audio_Beamform(&audio_buffer_2a[AUDIO_BUFFER_SIZE], AUDIO_BUFFER_SAMPLES, 16);
    __DSB();
    fill_all_cycles += DWT->CYCCNT - t0;
  }

  // SAI2_B: channels 24-31 (DAC3 U4)
  uint8_t did_first_3 = 0;
  if (need_fill_2b_first_half) {
    need_fill_2b_first_half = 0;
    did_first_3 = 1;
    __DSB();
    uint32_t t0 = DWT->CYCCNT;
    Fill_Audio_Beamform(&audio_buffer_2b[0], AUDIO_BUFFER_SAMPLES, 24);
    __DSB();
    fill_all_cycles += DWT->CYCCNT - t0;
  }
  if (need_fill_2b_second_half && did_first_3) dbl_fill[3]++;
  if (need_fill_2b_second_half) {
    need_fill_2b_second_half = 0;
    __DSB();
    uint32_t t0 = DWT->CYCCNT;
    Fill_Audio_Beamform(&audio_buffer_2b[AUDIO_BUFFER_SIZE], AUDIO_BUFFER_SAMPLES, 24);
    __DSB();
    fill_all_cycles += DWT->CYCCNT - t0;
  }

  in_service = 0;
}
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
