bergamifer/DS-Project/firmware/Core/Inc/uart_protocol.h

/**
 * @file    uart_protocol.h
 * @brief   Binary UART protocol for ESP32-S2 Mini -> STM32H743 communication
 *
 * Protocol: Header(2) + Cmd(1) + Length(2,LE) + Payload(N) + Checksum(1) + Footer(2)
 * See uart-stm32-protocol.md for full specification.
 */

#ifndef UART_PROTOCOL_H
#define UART_PROTOCOL_H

#include "stm32h7xx_hal.h"
#include <stdint.h>

/* Protocol framing */
#define PROTO_HEADER_1      0xAA
#define PROTO_HEADER_2      0x55
#define PROTO_FOOTER_1      0x0D
#define PROTO_FOOTER_2      0x0A

/* Commands (ESP32 → STM32 unless noted) */
#define CMD_UPDATE_CFG      0x01
#define CMD_SET_MODE        0x02    /* payload: uint8 mode index (ui_states) */
#define CMD_GET_STATUS      0x03    /* payload: none (len=0) */
#define CMD_STATUS          0x04    /* STM32 → ESP32 response, ds_status_t */
#define CMD_SET_BEAM        0x07    /* payload: ds_beam_req_t (custom steer) */
#define CMD_ESP_INFO        0x08    /* ESP32 → STM32: IP en ASCII. NO se ACKea a
                                     * propósito: el ESP32 lo empuja sin pedir nada,
                                     * y un ACK espurio le daría el ack_sem a un
                                     * comando HTTP concurrente esperando el suyo. */
#define CMD_SET_VOLUME      0x09    /* payload: int8 dB (0..-63, ≤-64 = mute). Control
                                     * maestro sobre la atenuación del PCM1690 — afecta
                                     * TODOS los modos por igual (walker incluido). */
#define CMD_SET_AMPS        0x0A    /* payload: uint8 (1=on, 0=off). Enable del banco
                                     * de 32 PAM8302A (pin SD, PD3). Permite correr
                                     * todo el pipeline en silencio para aislar si un
                                     * reinicio es por demanda de los amplificadores. */
#define CMD_SET_INGAIN      0x0B    /* payload: uint8 dB (0..36). Ganancia de la
                                     * ETAPA DE ENTRADA, distinta del volumen (que
                                     * es el atenuador del DAC, a la salida). Con
                                     * fuentes de línea va en 0-12; +30 es para
                                     * micrófonos. Ver el comentario de in_gain_q8
                                     * en main.c: amplificar +30 y atenuar −40
                                     * después hacía recortar el clamp digital. */
#define CMD_FACTORY_RESET   0x0C    /* payload: none. Vuelve TODO a fábrica —
                                     * volumen, ganancia de entrada, modo,
                                     * gains/mutes/delays y los focos de ambos
                                     * MULTIFOCUS— y lo persiste. Salida de
                                     * emergencia cuando el instrumento quedó
                                     * en un estado raro a fuerza de ajustes
                                     * en vivo, varios de los cuales se
                                     * guardan solos. */
#define CMD_SELFTEST        0x0D    /* payload: none. Pide un AUTODIAGNÓSTICO:
                                     * el STM32 vuelve a leer por I2C lo que los
                                     * chips REALMENTE tienen adentro y contesta
                                     * con ds_health_t (CMD_HEALTH). A diferencia
                                     * del status —que es telemetría pasiva— esto
                                     * es una prueba ACTIVA, y por eso hace falta:
                                     * un DAC que perdió su configuración sigue
                                     * produciendo underruns=0 y CPU normal. */
#define CMD_HEALTH          0x0E    /* STM32 → ESP32, ds_health_t */

/* ===== Captura remota del ADC (0x0F-0x12) =====
 *
 * Bajar las muestras crudas de las 8 entradas para analizarlas en la
 * computadora: forma de onda, espectro, fase entre canales, correlación.
 *
 * Existe porque hasta ahora medir era mirar números por el serie. El modo 19
 * (LOOPBACK) hace una medición completa y devuelve UN pico y UN retardo; todo
 * lo demás —cómo es la onda, qué frecuencias, qué pasa entre canales— se
 * calculaba adentro y se tiraba. Con las muestras crudas afuera, la placa deja
 * de tener que saber qué se le va a preguntar.
 *
 * La transferencia va pedido-respuesta, un tramo por vez, como el status: no
 * hace falta control de flujo porque el que pide es el que consume. */
#define CMD_CAP_START       0x0F    /* payload: uint16 n_samples. La respuesta
                                     * (CMD_CAP_INFO) llega recién cuando la
                                     * captura se llenó — hasta 170 ms. */
#define CMD_CAP_INFO        0x10    /* STM32 → ESP32, ds_cap_info_t */
#define CMD_CAP_READ        0x11    /* payload: uint32 offset en bytes */
#define CMD_CAP_DATA        0x12    /* STM32 → ESP32: [offset:4][datos:≤124] */

/* Datos por tramo. 124 y no 128 porque los primeros 4 bytes llevan el offset —
 * el mismo motivo por el que CMD_FW_DATA lleva número de tramo: sin él, una
 * trama perdida corre todo lo que sigue y el archivo sale mal sin avisar. */
#define CAP_CHUNK_BYTES     (PROTO_MAX_PAYLOAD - 4)

/* ===== Resultado del AUTOFOCUS (lectura, no dispara nada) =====
 *
 * El scan del AUTOFOCUS mide, parlante por parlante, tiempo de vuelo, polaridad
 * y calidad de la correlación. Hasta la v11 esos números SÓLO salían por el
 * puerto serie: para usarlos había que tener el cable enchufado y parsear texto.
 *
 * Los 32 canales no entran en una trama (32 × 7 = 224 bytes contra 128 de
 * payload), así que la lectura va por tramos como la captura: el pedido lleva
 * el índice del primer canal y la respuesta dice cuántos manda. Dos tramas
 * cubren los 32.
 *
 * NO dispara un scan. Devuelve lo que haya medido el último, y `state` +
 * `progress` dicen si está a mitad de camino. */
#define CMD_GET_CAL         0x13    /* payload: uint8 índice del primer canal */
#define CMD_CAL_DATA        0x14    /* STM32 → ESP32: ds_cal_hdr_t + N×ds_cal_ch_t */

/* Canales por trama. 6 + 16×7 = 118 ≤ PROTO_MAX_PAYLOAD. */
#define CAL_CHUNK_CH        16

/* ===== La lista de modos, pedida en vez de copiada =====
 *
 * `ui_states[]` del STM32 estaba duplicada a mano en DOS lugares mas: MODE_NAMES
 * del ESP32 y names[] de la pagina web. No era cosmetico: POST /mode validaba el
 * indice contra la copia del ESP32, asi que un modo agregado en el STM32 y
 * olvidado alla quedaba inalcanzable por HTTP — y el sintoma era mudo, porque
 * /status informaba el num_modes del STM32 y la API decia tener mas modos de los
 * que aceptaba. Paso dos veces (issue #20).
 *
 * Ahora el STM32 es la unica fuente y las otras dos la piden al arrancar. Los
 * nombres no entran en una trama, asi que el pedido trae el indice del primero y
 * la respuesta dice cuantos manda, igual que CMD_GET_CAL.
 *
 * ⚠️ 0x15 NO se puede usar: es CMD_NACK. */
#define CMD_SET_AUTOSTART   0x18    /* payload: uint8 (1=on, 0=off). Arranque
                                     * autonomo de los amplificadores: con esto
                                     * en 1 el nodo se enciende SOLO, sin red y
                                     * sin nadie. Se persiste. Es lo que evita
                                     * que un nodo que pierde el WiFi quede mudo
                                     * toda la funcion (issue #19). */
#define CMD_GET_MODES       0x16    /* payload: uint8 indice del primer modo */
#define CMD_MODES_DATA      0x17    /* STM32 → ESP32: ds_modes_hdr_t + nombres
                                     * NUL-terminados, uno detras del otro */

/* El tono de medicion: [hz:2 LE][dither:1].
 *
 * Los modos de tono traen la frecuencia clavada en ui_states[] y todos llevan
 * el LFO triangular de ±5% en 3 Hz (TONE_DITHER_PERIOD). Eso es DELIBERADO para
 * escuchar —decorrela los modos de la sala, si no lo que se oye es la onda
 * estacionaria y no el foco— y es exactamente lo que arruina una medicion: la
 * captura remota son 170 ms contra un LFO de 333 ms, asi que cada corrida cae
 * en una fase distinta del dither y el nivel no repite.
 *
 * Con esto el que mide fija la frecuencia y apaga el dither, y la emision pasa
 * a ser determinista. NO se persiste: es un estado de banco, y que sobreviva a
 * un reinicio seria una trampa. Cambiar de modo lo devuelve al valor de la
 * tabla, tambien a proposito — el que escucha nunca se queda con un tono puro
 * puesto por una medicion de hace tres dias. */
#define CMD_SET_TONE        0x19

/* ===== BARRIDO DE FASE POR PARLANTE (0x1A-0x1D) =====
 *
 * El modo 22 mide, parlante por parlante y frecuencia por frecuencia, con qué
 * amplitud y con qué FASE llega cada uno al punto de escucha. Son
 * 32 x 14 x 8 = 3584 medidas complejas; no entran en una trama ni en diez, así
 * que se bajan por tramos con el mismo patrón que la captura del ADC: el pedido
 * lleva el offset en bytes y la respuesta devuelve lo que entra.
 *
 * Primero se pide el encabezado (CMD_GET_PHASE_INFO), que dice estado,
 * progreso, la grilla de frecuencias y cuántos bytes hay. Recién con eso el
 * lector sabe si vale la pena bajar algo: un barrido tarda ~3 minutos, y
 * preguntar "¿terminó?" tiene que costar una trama y no catorce kilobytes. */
/* Que entradas del ADC son los microfonos de medicion: [ch1:1][ch2:1].
 *
 * Estaban clavadas en 0 y 1. El 2026-09-03 el arnes real dio senal en c0 y c7
 * —el RJ45 no reparte los pares como uno espera— y el AUTOFOCUS quedo midiendo
 * un canal vacio sin decir nada raro: la calidad daba baja y parecia ruido de
 * sala. Un numero de canal es una propiedad del CABLEADO, no del firmware.
 *
 * NO se persiste, a proposito. Es un dato de banco, y que sobreviva a un
 * reinicio significa que dentro de un mes alguien mide con el cableado de hoy
 * sin saberlo. Las herramientas lo mandan siempre antes de medir, y el
 * encabezado del resultado dice con cuales se midio. */
#define CMD_SET_MICS        0x1E    /* payload: [ch1:1][ch2:1], 0..7 */
/* Mapeo del arnes: 0 = canal k -> cono k, 1 = canal k -> cono k^1.
 *
 * Existe para poder hacer la prueba A/B A OIDO, sin reflashear y sin cortar el
 * sonido. El arnes cruzado le da a cada parlante el retardo de su vecino: los
 * residuos medidos van de -79 a +131 us, que a 2 kHz son 72 grados de fase.
 * Eso deberia oirse, y "deberia" no es una medicion.
 *
 * NO se persiste, y el default de compilacion es el mapeo MEDIDO (cruzado). Un
 * reinicio vuelve solo a lo correcto: se puede desenfocar el muro para escuchar
 * la diferencia sin riesgo de dejarlo asi. */
#define CMD_SET_SPKMAP      0x1F    /* payload: uint8 (0 directo, 1 cruzado) */
#define CMD_GET_PHASE_INFO  0x1A    /* payload: none */
#define CMD_PHASE_INFO      0x1B    /* STM32 → ESP32: ds_phase_info_t */
#define CMD_PHASE_READ      0x1C    /* payload: uint32 offset en bytes */
#define CMD_PHASE_DATA      0x1D    /* STM32 → ESP32: [offset:4][datos:≤124] */

/* Techo de la grilla de frecuencias del encabezado. El firmware usa 14; el
 * campo es fijo para que ds_phase_info_t tenga tamaño conocido. */
#define PHASE_MAX_PTS       16

/* ===== Actualización de firmware por WiFi (0x20-0x23) =====
 *
 * Los tres primeros NO se contestan desde el parser: el ACK lo manda el MAIN
 * LOOP recién cuando terminó de escribir la flash. Eso no es un detalle de
 * implementación sino el control de flujo: mientras el ESP32 espera el ACK de
 * un tramo, no manda el siguiente, y así la transferencia va exactamente al
 * ritmo al que el STM32 puede grabar. Sin eso habría que inventar una ventana y
 * un buffer, y el borrado de un sector (cientos de ms) lo desbordaría igual.
 *
 * Por eso también los tiempos de espera del ESP32 son distintos por comando:
 * FW_BEGIN puede tardar segundos (borra), FW_DATA milisegundos, FW_END otra vez
 * segundos (relee toda la imagen para el CRC). */

#define CMD_FW_BEGIN        0x20    /* payload: ds_fw_begin_t */
#define CMD_FW_DATA         0x21    /* payload: [seq:2 LE][datos:1..FW_CHUNK_MAX] */
#define CMD_FW_END          0x22    /* payload: uint32 LE = CRC32 de la imagen */
#define CMD_FW_ABORT        0x23    /* payload: none */

/* ===== CHIRP ENFOCADO (0x24-0x25) =====
 * El modo 23 mide, con ventana temporal, el nivel del sonido DIRECTO en los dos
 * microfonos para el foco vigente. Se lee cuando se quiere; no dispara nada. */
#define CMD_GET_FOCUS       0x24    /* payload: none */
#define CMD_FOCUS_DATA      0x25    /* STM32 → ESP32: ds_focus_t */

#define CMD_ACK             0x06
#define CMD_NACK            0x15

/* Payload constraints */
/* Techo del payload. Era 64 y el status ya ocupaba 63 — un campo más y el ESP32
 * empezaba a descartar la trama por larga, sin error visible. 128 deja lugar
 * para el status extendido y para una config de los 32 canales (102 bytes).
 * ⚠️ Cambiarlo obliga a cambiarlo EN AMBOS LADOS (firmware_esp32c3). */
#define PROTO_MAX_PAYLOAD   128
/* Los 32 canales de DS11. Era 16 —la mitad del array— así que gains/mutes/delays
 * de las filas 3 y 4 no se podían tocar desde el ESP32. */
/* Nombre de modo mas largo hoy: "BARRIDO VERTICAL 800Hz arriba<->abajo @1m" =
 * 41. Se deja margen y se verifica en compilacion del lado del STM32. */
#define MODE_NAME_MAX       64

#define CFG_PAYLOAD_SIZE    102
#define CFG_NUM_CHANNELS    32

/** @brief Cabecera de CMD_MODES_DATA. */
typedef struct __attribute__((packed)) {
    uint8_t first;   /* indice del primer nombre de este tramo */
    uint8_t count;   /* cuantos nombres van en este tramo */
    uint8_t total;   /* cuantos modos tiene el STM32 en total */
    uint8_t bytes;   /* bytes de nombres que siguen a esta cabecera */
} ds_modes_hdr_t;
/* Datos de la imagen en CMD_FW_DATA. Son 126 y no 128 porque los dos primeros
 * bytes del payload llevan el número de tramo. Nada obliga a que sea múltiplo
 * de la palabra de flash (32 B): ota.c acumula en RAM y baja de a 32. */
#define FW_CHUNK_MAX        (PROTO_MAX_PAYLOAD - 2)
#define PROTO_VERSION      22   /* v2: + master_vol_db; v3: + in_gain_db y los
                                 * dos contadores de saturación; v4: +
                                 * state_flags, y ds_config_t pasa a 32 canales;
                                 * v5: + uptime_ms DEL STM32;
                                 * v6: + cpu_fills_x10 — el presupuesto de CPU
                                 * del pipeline sólo se veía por el serie, así
                                 * que diagnosticar "este modo no entra" pedía
                                 * un cable. Ahora sale por /status.
                                 * v7: + mic_live_mask / cal_progress /
                                 * cal_ok_count — el AUTOFOCUS se puede correr
                                 * y juzgar desde la página, sin serie.
                                 * v8: + fw_id / fw_build / ota_state / ota_pct.
                                 * Con actualización por WiFi, "¿qué binario
                                 * está corriendo?" deja de ser obvio: ya no
                                 * es el último que uno flasheó a mano.
                                 * v9: + CMD_SELFTEST/CMD_HEALTH. ds_status_t NO
                                 * cambió — lo que cambió es el repertorio de
                                 * comandos, que también es contrato.
                                 * v11: + CMD_GET_CAL/CMD_CAL_DATA — el
                                 * resultado del AUTOFOCUS deja de vivir sólo en
                                 * el serie. Es lo que habilita separar el
                                 * retardo propio de cada parlante del camino
                                 * geométrico (issue #21).
                                 * v12: + CMD_GET_MODES/CMD_MODES_DATA — la
                                 * lista de modos deja de estar copiada a mano
                                 * en el ESP32 y en la página (issue #20).
                                 * v13: + CMD_SET_AUTOSTART y los flags
                                 * STATE_F_AUTOSTART / STATE_F_AUTO_HELD — el
                                 * nodo puede encender los amplificadores sin
                                 * red (issue #19).
                                 * v14: + reset_rsr — por que arranco la placa,
                                 * por red. Sin esto la causa de un reset solo
                                 * se ve con el cable serie puesto, y los resets
                                 * por alimentacion aparecen justo cuando el
                                 * cable no esta.
                                 * v15: + CMD_SET_TONE — frecuencia del tono y
                                 * dither, por red. Es lo que habilita medir con
                                 * el banco de dos microfonos sin nadie delante
                                 * de la placa: el host barre foco y frecuencia
                                 * y baja las capturas. ds_status_t NO cambio.
                                 * v16: + el BARRIDO DE FASE POR PARLANTE y sus
                                 * cuatro comandos. Era la medicion que faltaba:
                                 * el AUTOFOCUS recorre los parlantes de a uno
                                 * pero devuelve UN escalar por parlante, y el
                                 * barrido de frecuencia da fase contra
                                 * frecuencia pero con los cuatro bancos sonando
                                 * juntos, o sea la SUMA. Ninguno de los dos
                                 * podia contestar si los 32 llegan EN FASE al
                                 * punto de escucha. ds_status_t NO cambio.
                                 * v17: + CMD_SET_MICS, y ds_cal_hdr_t crece a 8
                                 * bytes con los dos numeros de entrada. El arnes
                                 * real dio senal en c0 y c7, no en c0 y c1: que
                                 * canal es el microfono es una propiedad del
                                 * cableado.
                                 * v18: + CMD_SET_SPKMAP — cambiar el mapeo del
                                 * arnes en caliente, para poder A/B a oido lo
                                 * que se midio.
                                 * v19: + el CHIRP ENFOCADO y su lectura. Es el
                                 * unico modo que mide el haz sin la sala: la
                                 * correlacion se queda con la primera llegada.
                                 * ds_status_t NO cambio.
                                 * v20: + vdda_mv / vdda_min_mv / vdda_min_abs.
                                 * El STM32 mide su propio riel de 3V3 contra la
                                 * referencia interna, sin hardware nuevo. Es el
                                 * riel que vigila el MAX809 a 3,08 V y el que
                                 * reinicia la placa al encender los amps.
                                 * v21: + cpu_adc_x10. El lado de la ENTRADA
                                 * estaba fuera del presupuesto publicado.
                                 * v22: + vdda_pre_reset_mv / rail_deaths. El
                                 * minimo del riel sobrevive al reinicio en un
                                 * registro de respaldo: antes moria con el
                                 * chip, que es cuando mas hacia falta. */
#define ESP_IP_MAXLEN       15      /* "255.255.255.255" */

/**
 * @brief Device configuration received from ESP32
 *
 * 102 bytes, little-endian, packed — can be cast directly from payload
 * since both STM32 (Cortex-M7) and ESP32 (Xtensa/RISC-V) are LE.
 */
typedef struct __attribute__((packed)) {
    uint8_t  master_gain;       /* 0-255 maps to 0.0-1.0 */
    uint8_t  mute_global;       /* 0=unmuted, 1=muted */
    uint16_t delays[CFG_NUM_CHANNELS];  /* delay_samples per channel (LE) */
    uint8_t  gains[CFG_NUM_CHANNELS];   /* gain per channel (0-255) */
    uint32_t mutes;             /* bitfield: bit N = channel N muted. 32 bits
                                 * porque con 16 no se podía silenciar más allá
                                 * del canal 15 — la mitad del array. */
} ds_config_t;

_Static_assert(sizeof(ds_config_t) == CFG_PAYLOAD_SIZE,
               "ds_config_t must be exactly CFG_PAYLOAD_SIZE bytes");

/**
 * @brief Custom beam request (CMD_SET_BEAM) — steer outside the K2 presets.
 * type 0 = RX beam steering (az_deg); type 1 = TX focal point (fx/fy/fz mm
 * relative to the speaker-array center, listener frame);
 * type 2 = MULTIFOCUS: az_deg lleva el ÍNDICE DE FUENTE (0..7) y fx/fy/fz el
 * foco de esa fuente (reuso del struct, sin cambio de tamaño). Aplica al modo
 * MULTIFOCUS activo: tonos (modo 14, fuentes 0-3 audibles) o entradas
 * analógicas (modo 15, fuentes 0-7); si no hay ninguno activo entra al 14.
 */
typedef struct __attribute__((packed)) {
    uint8_t type;
    int16_t az_deg;
    int16_t fx_mm, fy_mm, fz_mm;
} ds_beam_req_t;

_Static_assert(sizeof(ds_beam_req_t) == 9, "ds_beam_req_t must be 9 bytes");

/**
 * @brief Apertura de una carga de firmware (CMD_FW_BEGIN).
 *
 * El tamaño va por adelantado a propósito: con él el STM32 borra SÓLO los
 * sectores del staging que la imagen va a ocupar (uno, con los ~80 kB de hoy)
 * en vez del banco entero. La diferencia son cientos de milisegundos contra
 * varios segundos, y durante el borrado el equipo está mudo.
 *
 * fw_id y build no se verifican: viajan para que el firmware nuevo pueda decir
 * por /status qué binario es, sin depender de que uno se acuerde.
 */
typedef struct __attribute__((packed)) {
    uint32_t len;       /* bytes de la imagen */
    uint32_t fw_id;     /* hash git corto */
    uint32_t build;     /* epoch unix de compilación */
} ds_fw_begin_t;

_Static_assert(sizeof(ds_fw_begin_t) == 12, "ds_fw_begin_t must be 12 bytes");

/**
 * @brief Cabecera de una captura (CMD_CAP_INFO).
 *
 * Las muestras viajan en int16 pero se guardan en int32 con los 24 bits del
 * ADC. `shift` es el AUTORRANGO: se elige después de capturar, con el pico ya
 * conocido, como el mínimo desplazamiento que evita recortar.
 *
 * Eso importa de verdad. Con un desplazamiento fijo de 8 (el que haría entrar
 * la escala completa) el piso de ruido —unas 437 cuentas de 24 bits— quedaría
 * en 1 LSB y medir ruido sería imposible. Con autorrango, una captura de puro
 * ruido usa shift=0 y llega entera. Para reconstruir la escala de 24 bits:
 * `crudo = muestra << shift`.
 */
typedef struct __attribute__((packed)) {
    uint16_t n_samples;
    uint8_t  n_channels;
    uint8_t  shift;          /* muestra_enviada = crudo_24bit >> shift */
    uint32_t rate_hz;
    int32_t  peak;           /* pico absoluto en escala de 24 bits (máx 8388607) */
    uint32_t total_bytes;    /* n_samples × n_channels × 2 */
} ds_cap_info_t;

_Static_assert(sizeof(ds_cap_info_t) == 16, "ds_cap_info_t must be 16 bytes");

/**
 * @brief Resultado del autodiagnóstico (CMD_HEALTH).
 *
 * Todo lo de acá se lee POR I2C en el momento de pedirlo, no es un valor
 * cacheado del arranque. Ésa es la diferencia con ds_status_t y la razón de que
 * exista: los contadores pasivos no ven un chip que perdió su configuración.
 * Un PCM1690 al que se le fue el registro de formato deja de decodificar el
 * TDM y saca ruido o silencio, y sin embargo `underruns` sigue en cero, el CPU
 * sigue igual y el status entero se ve perfecto.
 *
 * Se mandan los VALORES LEÍDOS, no sólo un veredicto: un rojo que no se puede
 * discutir es un rojo en el que no se confía. La página muestra las dos cosas.
 */
typedef struct __attribute__((packed)) {
    uint8_t  dac_present;    /* bit N = el DAC N contesta por I2C */
    uint8_t  dac_fmt[4];     /* registro 65 (FORMAT) de cada DAC — se espera 0x06 */
    uint8_t  dac_att[4];     /* registro 72 (ATT ch1) — dB = −(255−att)/2 */
    uint8_t  ak_present;     /* 1 = el AK5538VN contesta por I2C3 */
    uint8_t  ak_regs[4];     /* R01..R04 — se espera R02=0x31 R03=0x40 R04=0x02 */
    uint8_t  eeprom_present;
    uint8_t  eeprom_ver;     /* versión de layout guardada */
    int16_t  sync_us;        /* desfase entre los dos bancos de SAI. Vale µs
                              * sueltos; milisegundos significa que las filas
                              * 0-1 y 2-3 están tocando ventanas de tiempo
                              * distintas y el enfoque vertical no existe. */
    uint8_t  rsv[2];
} ds_health_t;

_Static_assert(sizeof(ds_health_t) == 20, "ds_health_t must be 20 bytes");

/**
 * @brief Una medicion del CHIRP ENFOCADO (CMD_FOCUS_DATA).
 *
 * `seq` es el numero de medicion COMPLETA. Es el campo que hace usable el modo
 * para barrer: despues de mover el foco hay que esperar a que `seq` cambie
 * ANTES de creerle al nivel, porque si no se lee la medicion del foco anterior
 * y el barrido entero sale corrido un punto — sin que nada avise.
 *
 * `peak` es el pico de la correlacion normalizado, o sea la amplitud de la
 * PRIMERA llegada. `lag_q8` es cuando llego, en muestras Q8; el offset absoluto
 * incluye el retardo del pipeline y no significa nada por si solo, pero su
 * variacion al mover el foco si.
 */
typedef struct __attribute__((packed)) {
    uint16_t seq;              /* mediciones completas desde que arranco el modo */
    uint8_t  state;            /* fc_state_t */
    uint8_t  n_mic;
    int32_t  peak[2];          /* amplitud de la primera llegada */
    int32_t  lag_q8[2];        /* cuando llego, muestras Q8 */
    uint16_t q10[2];           /* pico/promedio x10 — <100 no es confiable */
    int16_t  fx_mm, fy_mm, fz_mm;   /* el foco con el que se midio */
    uint16_t retries;          /* ciclos que hubo que reintentar — ver abajo */
} ds_focus_t;

/* `retries` NO es telemetria de adorno. Un ciclo que se pierde y se reintenta
 * en silencio deja creer que la medicion salio bien; contarlo es lo que
 * convierte una falla intermitente en algo que se ve. Si crece durante un
 * barrido, los puntos de ese barrido no son comparables entre si. */
_Static_assert(sizeof(ds_focus_t) == 32, "ds_focus_t cambio de tamano");

/**
 * @brief Encabezado del BARRIDO DE FASE POR PARLANTE (CMD_PHASE_INFO).
 *
 * `state`: 0 = nunca corrió, 1 = corriendo, 2 = terminado. Con 1, `progress`
 * dice cuántos parlantes van; lo de los que faltan son ceros y NO hay que
 * leerlos como "ese parlante no suena".
 *
 * FORMATO DE LOS DATOS (CMD_PHASE_DATA), por si alguien lo lee sin el script:
 * dos int16 little-endian por cada terna (parlante, punto, entrada), en ese
 * orden de anidamiento — parlante el más externo, entrada el más interno:
 *
 *   [0] amplitud en dBFS x100      (int16; -32000 = por debajo de todo)
 *   [1] fase en unidades de 2*pi/65536, con el origen del emisor ya restado
 *
 * La fase viaja CORREGIDA por la fase del emisor al abrir cada punto. Sin esa
 * corrección, dos parlantes medidos en instantes distintos no comparten origen,
 * restarles la geometría no daría nada, y el modo no mediría lo único que vino
 * a medir.
 *
 * dB x100 y fase en Q16 en vez de dos floats: la mitad de bytes —14 kB en lugar
 * de 28— por 0,01 dB y 0,0055 grados de resolución, que están varios órdenes de
 * magnitud por debajo del ruido de cualquier sala.
 */
typedef struct __attribute__((packed)) {
    uint8_t  n_spk;                    /* parlantes recorridos */
    uint8_t  n_pts;                    /* frecuencias por parlante */
    uint8_t  n_ch;                     /* entradas del ADC guardadas */
    uint8_t  state;                    /* 0 idle, 1 corriendo, 2 listo */
    uint8_t  progress;                 /* parlantes terminados */
    uint8_t  reserved;
    uint32_t total_bytes;              /* n_spk * n_pts * n_ch * 4 */
    uint16_t freq_hz[PHASE_MAX_PTS];   /* la grilla; valen los n_pts primeros */
} ds_phase_info_t;

_Static_assert(sizeof(ds_phase_info_t) == 10 + 2 * PHASE_MAX_PTS,
               "ds_phase_info_t cambio de tamano");

/**
 * @brief Cabecera de un tramo del resultado del AUTOFOCUS (CMD_CAL_DATA).
 *
 * Va en TODAS las tramas, no sólo en la primera: así cada una se entiende sola
 * y el lector no tiene que acordarse de lo que vino antes. Son 6 bytes.
 */
typedef struct __attribute__((packed)) {
    uint8_t  first;        /* índice del primer canal de esta trama */
    uint8_t  count;        /* cuántos canales vienen acá */
    uint8_t  n_channels;   /* total que recorre el scan (CAL_NUM_CH × micrófonos) */
    uint8_t  state;        /* cal_state_t: 0 IDLE 1 SETTLE 2 ARM 3 CAPT 4 CORR 5 DONE */
    uint8_t  progress;     /* parlantes ya medidos */
    uint8_t  ok_count;     /* de ésos, con calidad ≥ CAL_Q_MIN */
    uint8_t  mic1;         /* entrada del ADC del micrófono 1 */
    uint8_t  mic2;         /* ídem del 2 */
} ds_cal_hdr_t;

/* Los dos canales viajan CON el resultado y no aparte: un scan que no dice con
 * qué entradas se midió es un scan que dentro de una semana no se puede
 * interpretar, y el error es silencioso — los números salen igual de plausibles
 * con el micrófono equivocado. */
_Static_assert(sizeof(ds_cal_hdr_t) == 8, "ds_cal_hdr_t must be 8 bytes");

/**
 * @brief Medición de UN parlante (CMD_CAL_DATA).
 *
 * `tof_q8` es el dato crudo, sin normalizar: el pico de la correlación en
 * MUESTRAS Q8 (1/256 de muestra = 81 ns = 28 µm de camino acústico). Se manda
 * crudo a propósito, porque lo que vale del scan no es el número absoluto sino
 * la diferencia entre parlantes, y cualquier normalización que haga el firmware
 * le saca información al que después quiera restarle la geometría.
 *
 * Lo que mide mezcla tres cosas —el instante de disparo, el retardo propio del
 * parlante y el camino hasta el micrófono—, y separarlas es un ajuste por
 * mínimos cuadrados que se hace afuera. Ver issue #21.
 */
typedef struct __attribute__((packed)) {
    int32_t  tof_q8;       /* pico de correlación, muestras Q8 */
    int8_t   sign;         /* polaridad medida: +1 / −1 */
    uint16_t quality;      /* pico/promedio ×10 — ≥100 es una medición sólida */
} ds_cal_ch_t;

_Static_assert(sizeof(ds_cal_ch_t) == 7, "ds_cal_ch_t must be 7 bytes");
_Static_assert(sizeof(ds_cal_hdr_t) + CAL_CHUNK_CH * sizeof(ds_cal_ch_t)
               <= PROTO_MAX_PAYLOAD, "un tramo de calibracion no entra en una trama");

/**
 * @brief Telemetry snapshot (CMD_STATUS response). Little-endian packed —
 * the ESP32 casts it directly. Extend only by APPENDING fields and bumping
 * PROTO_VERSION so old ESP32 firmware keeps parsing its known prefix.
 */
typedef struct __attribute__((packed)) {
    uint8_t  proto_ver;      /* PROTO_VERSION */
    uint8_t  mode_idx;       /* current ui_states index */
    uint8_t  num_modes;
    int16_t  rx_az_deg;      /* current RX beam azimuth */
    int16_t  fx_mm, fy_mm, fz_mm;  /* last TX focal point */
    uint32_t underruns;
    uint32_t sai_errors;
    uint8_t  ovf;            /* AK5538 overflow pin (1 = clipping) */
    uint8_t  cal_state;      /* AUTOFOCUS: 0 idle … 5 done (cal_state_t) */
    int32_t  adc_pk[8];      /* per-channel input peak, 24-bit scale */
    int8_t   master_vol_db;  /* v2: volumen maestro actual (0..-63, ≤-64 mute) */
    uint8_t  in_gain_db;     /* v3: ganancia de ENTRADA actual (0..36) */
    uint32_t adc_ovf_count;  /* v3: medios buffers con OVF alto, MONOTÓNICO */
    uint32_t out_clip_count; /* v3: muestras de salida recortadas, MONOTÓNICO */
    uint8_t  state_flags;    /* v4: ver STATE_F_* */
    uint32_t uptime_ms;      /* v5: uptime del STM32 (HAL_GetTick) */
    uint16_t cpu_fills_x10;  /* v6: % de CPU en los 4 fills, ×10 (263 = 26,3%) */
    /* v7 — los tres existen para que el AUTOFOCUS se pueda correr SIN una
     * terminal serie abierta. Hasta ahora el scan sólo se contaba por UART:
     * desde la página no había forma de saber si el micrófono estaba vivo, por
     * qué parlante iba, ni si el resultado servía. */
    uint8_t  mic_live_mask;  /* v7: bit N = entrada N con señal (no sólo ruido) */
    uint8_t  cal_progress;   /* v7: parlantes ya medidos, 0..CAL_NUM_CH */
    uint8_t  cal_ok_count;   /* v7: de esos, cuántos con calidad suficiente */
    /* v8 — identidad del binario que está corriendo. Antes alcanzaba con
     * acordarse de qué se había flasheado; con OTA la placa puede tener un
     * firmware que uno subió desde otra máquina, o desde el celular. */
    uint32_t fw_id;          /* v8: hash git corto de la compilación */
    uint32_t fw_build;       /* v8: epoch unix de la compilación */
    uint8_t  ota_state;      /* v8: ota_state_t — 0 idle, 1 recibiendo, 2 lista, 3 error */
    uint8_t  ota_pct;        /* v8: avance de la carga, 0..100 */
    /* v9 — la fase RX↔TX de los DMA, en muestras, medida AHORA.
     *
     * Es el nivel 2 de multinode.md §2 y sale de dos registros: no necesita
     * loopback, ni J13, ni adaptador, ni micrófono (loopback_debug.md §9). Cada
     * nodo de una instalación puede decir por HTTP en qué estado de fase
     * arrancó — que es lo único que hacía falta para compensarlo. Se imprimía en
     * el heartbeat desde agosto, o sea que hasta ahora pedía un cable serie. */
    int16_t  dma_phase;
    /* ===== Por que arranco esta placa (v14) =====
     * RCC->RSR crudo, latcheado antes de HAL_Init(). Se manda entero y no un
     * codigo: la interpretacion se hace afuera, y asi una lectura vieja sigue
     * siendo util cuando cambie lo que sabemos de los flags.
     *
     * Vivia SOLO en el puerto serie, y esa es exactamente la informacion que
     * falta cuando hay que sacar el cable — que es cuando aparecen los resets.
     * El 2026-09-02 la placa se reiniciaba al encender los amplificadores y la
     * causa estaba a un cable de distancia que ya no estaba. */
    uint32_t reset_rsr;      /* v9: fase RX-TX en muestras, 0..479 */
    /* v20: el riel de 3V3, medido por el propio STM32 contra su referencia
     * interna — sin un solo componente agregado. IC1 (MAX809T) reinicia la
     * placa cuando esto baja de 3080 mV, y hasta ahora el equipo era CIEGO a
     * eso: el amperimetro de la fuente promedia y mide dos conversiones antes.
     *
     * `min` se limpia al leerse (como adc_pk): es el hundimiento mas profundo
     * DESDE LA LECTURA ANTERIOR, que es lo unico que detecta un evento de
     * milisegundos con un sondeo de un segundo. `min_abs` no se limpia nunca. */
    uint16_t vdda_mv;        /* ultima lectura */
    uint16_t vdda_min_mv;    /* minimo desde el /status anterior */
    uint16_t vdda_min_abs;   /* minimo desde que arranco la placa */
    /* v21: el % de CPU del lado de la ENTRADA, que estaba sin medir. Las marcas
     * de DWT de Service_Fills empiezan DESPUES de Process_ADC_Half, asi que
     * `cpu_fills_x10` no incluia las delay lines, el MULTIFOCUS de entradas,
     * los detectores coherentes, ni ningun reproductor futuro. Se podia mirar
     * el status, ver el mismo numero y declarar victoria con los underruns
     * subiendo. */
    uint16_t cpu_adc_x10;
    /* v22: rescatados del dominio de respaldo, que sobrevive al NRST.
     * `vdda_pre_reset_mv` es cuanto tenia el riel justo antes del ultimo
     * reinicio — el dato que hasta ahora moria con el chip. 0 = no hay
     * (primer arranque, o corte de alimentacion real).
     * `rail_deaths` cuenta los reinicios con el riel por debajo de 3080 mV. */
    uint16_t vdda_pre_reset_mv;
    uint16_t rail_deaths;
} ds_status_t;

/* Estado REAL, no el nominal.
 *
 * STATE_F_CUSTOM existe porque `mode_idx` puede mentir: UI_ApplyCustomBeam
 * (POST /beam) cambia lo que suena sin tocar ui_state_idx, a propósito, para
 * que el próximo K2 retome el ciclo donde estaba. La consecuencia es que la
 * página puede mostrar "modo 13" mientras la placa hace otra cosa — eso costó
 * una sesión entera de debug el 2026-08-18. Con este bit la UI dice la verdad.
 * Lo limpia UI_ApplyState, o sea elegir un modo.
 *
 * STATE_F_AMPS: la UI no tenía forma de saber si los amps están encendidos —
 * sólo recordaba el último botón apretado, y eso se vuelve falso con un reboot
 * o con el K2 largo. */
#define STATE_F_AMPS    0x01    /* banco de 32 PAM8302A habilitado */
#define STATE_F_CUSTOM  0x02    /* beam custom: mode_idx NO describe lo que suena */
/* v7: hay una calibración de AUTOFOCUS guardada en EEPROM. Sin esto, la única
 * forma de saber si el equipo arrancó con las polaridades medidas o con las
 * nominales era leer el log de arranque — que se pierde al reiniciar. */
#define STATE_F_CALIB   0x04
/* STATE_F_AUTOSTART: el arranque autonomo esta activado en este nodo.
 * STATE_F_AUTO_HELD: esta activado pero SUSPENDIDO — ya fallo AUTOSTART_MAX_FAILS
 * veces seguidas y no va a volver a intentar solo. Son dos cosas distintas y la
 * UI tiene que poder distinguirlas: la primera es "va a sonar solo", la segunda
 * es "creias que iba a sonar solo y no va a pasar". */
#define STATE_F_AUTOSTART 0x08
#define STATE_F_AUTO_HELD 0x10

/* El `uptime_ms` que publicaba /status era el del ESP32, no el del STM32: un
 * reinicio del STM32 era INVISIBLE desde la red. Se descubrió el 2026-08-18
 * midiendo underruns, cuando el contador BAJÓ de 6 a 0 — un contador monótono
 * que retrocede es un reboot, y no había con qué confirmarlo. */
_Static_assert(sizeof(ds_status_t) == 101, "ds_status_t must be 101 bytes");
/* ⚠️ Un payload por encima de PROTO_MAX_PAYLOAD hace que el ESP32 descarte la
 * trama por larga y el endpoint quede mudo SIN dar error — de ahí los asserts. */
_Static_assert(sizeof(ds_status_t) <= PROTO_MAX_PAYLOAD,
               "ds_status_t no entra en PROTO_MAX_PAYLOAD");
_Static_assert(CFG_PAYLOAD_SIZE <= PROTO_MAX_PAYLOAD,
               "ds_config_t no entra en PROTO_MAX_PAYLOAD");

/**
 * @brief Initialize UART protocol module
 * @param huart_esp  UART handle for ESP32 communication (UART4)
 * @param huart_dbg  UART handle for debug output (UART7)
 */
void UART_Protocol_Init(UART_HandleTypeDef *huart_esp, UART_HandleTypeDef *huart_dbg);

/**
 * @brief Se lleva una COPIA de la última config recibida, si hay una nueva.
 * @param dst  destino; se llena sólo si la función devuelve 1.
 * @return 1 una vez por config nueva, 0 si no hay ninguna pendiente.
 *
 * ⚠️ REGLA DEL MÓDULO: nada devuelve un puntero a memoria que escribe el ISR.
 * Reemplaza al par HasNewConfig()/GetConfig(), donde el segundo entregaba el
 * buffer vivo y el main loop leía de ahí mientras el ISR podía estar
 * escribiéndole encima una trama nueva. La copia va con la IRQ apagada.
 */
uint8_t UART_Protocol_TakeConfig(ds_config_t *dst);

/**
 * @brief Print a config snapshot to debug UART (minicom).
 * @param cfg  la copia obtenida con UART_Protocol_TakeConfig().
 */
void UART_Protocol_PrintConfig(const ds_config_t *cfg);

/**
 * @brief Get total bytes received on UART4 RX (diagnostic)
 */
uint32_t UART_Protocol_GetRxByteCount(void);

/**
 * @brief Poll for a CMD_SET_MODE request.
 * @return Requested mode index (≥0) once per request, -1 if none pending.
 */
int32_t UART_Protocol_GetModeRequest(void);

/**
 * @brief Poll for a CMD_SET_BEAM request.
 * @return 1 and fills *req once per request, 0 if none pending.
 */
uint8_t UART_Protocol_GetBeamRequest(ds_beam_req_t *req);

/**
 * @brief Poll for a CMD_GET_STATUS request (cleared on read).
 */
uint8_t UART_Protocol_StatusRequested(void);

/**
 * @brief Hook llamado mientras SendStatus espera al UART.
 *
 * Por defecto no hace nada (definición __weak). main.c la redefine para servir
 * los fills de audio pendientes. Sin eso, los ~5,2 ms que tarda la trama de
 * status bloquean el main loop — tolerable con el buffer de 480 muestras
 * (deadline 10 ms), inadmisible si se baja a 240 (deadline 5 ms).
 */
void UART_Protocol_Yield(void);
/** @brief Escribe en el serie de debug. main.c la redefine para encolar en vez
 *         de bloquear; la definición __weak es bloqueante. */
void UART_Debug_Write(const char *str);

/**
 * @brief Send a CMD_STATUS frame to the ESP32.
 *
 * ~5,2 ms a 115200, pero NO bloquea el pipeline de audio: sirve los fills
 * pendientes entre byte y byte vía UART_Protocol_Yield(). Llamar SOLO desde el
 * main loop — nunca desde una ISR.
 */
void UART_Protocol_SendStatus(const ds_status_t *st);

/**
 * @brief Copia la IP del ESP32 (CMD_ESP_INFO) al buffer del llamador.
 * @param dst       destino; queda NUL-terminado siempre.
 * @param dst_size  tamaño de dst (≥ ESP_IP_MAXLEN+1 para no truncar).
 *
 * Copia en vez de devolver el puntero, por la misma regla que TakeConfig: la
 * cadena la escribe el ISR y una trama nueva a mitad de lectura mezclaría dos
 * direcciones. Queda "" mientras no se haya recibido ninguna.
 */
void UART_Protocol_CopyEspIp(char *dst, uint32_t dst_size);

/**
 * @brief Poll for a CMD_SET_VOLUME request.
 * @param db  destino: dB pedidos (0..-63, ≤-64 = mute).
 * @return 1 y llena *db una vez por request, 0 si no hay ninguno pendiente.
 */
uint8_t UART_Protocol_GetVolumeRequest(int8_t *db);

/**
 * @brief Poll for a CMD_SET_INGAIN request.
 * @param db  destino: ganancia de entrada pedida en dB (0..36).
 * @return 1 y llena *db una vez por request, 0 si no hay ninguno pendiente.
 */
uint8_t UART_Protocol_GetInGainRequest(uint8_t *db);

/**
 * @brief Poll for a CMD_SET_AMPS request.
 * @param on  destino: 1 = habilitar los 32 amps, 0 = apagarlos.
 * @return 1 y llena *on una vez por request, 0 si no hay ninguno pendiente.
 */
uint8_t UART_Protocol_GetAmpsRequest(uint8_t *on);

/**
 * @brief Poll for a CMD_FACTORY_RESET request.
 * @return 1 una vez por request, 0 si no hay ninguno pendiente.
 */
uint8_t UART_Protocol_GetFactoryResetRequest(void);

/* ===== Actualización de firmware: par tomar-pedido / contestar =====
 *
 * A diferencia de todos los demás comandos, éstos NO se contestan desde el
 * parser. El parser guarda el pedido y se aparta; el main loop lo ejecuta —
 * borrado o escritura de flash, que puede tardar de milisegundos a segundos— y
 * recién entonces contesta con UART_Protocol_FwReply(). El ESP32 no manda el
 * tramo siguiente hasta ver ese ACK, así que la transferencia se autorregula
 * sola al ritmo de la flash. Ver el comentario de CMD_FW_BEGIN.
 *
 * Hay UN solo pedido pendiente a la vez. Si llega otro antes de que el main loop
 * conteste el anterior, el parser lo rechaza con NACK en vez de encolarlo: eso
 * sólo puede pasar si el otro extremo no está respetando el ACK, y en una carga
 * de firmware es mucho mejor cortar que seguir a ciegas. */

/**
 * @brief Se lleva el pedido de firmware pendiente, si hay uno.
 * @param cmd      destino: CMD_FW_BEGIN / CMD_FW_DATA / CMD_FW_END.
 * @param payload  destino, al menos PROTO_MAX_PAYLOAD bytes.
 * @param len      destino: bytes válidos en payload.
 * @return 1 si había un pedido, 0 si no.
 *
 * ⚠️ Después de un 1 hay que llamar SIEMPRE a UART_Protocol_FwReply(): hasta
 * que eso pase el parser rechaza todo lo que llegue, y la carga se cuelga.
 */
uint8_t UART_Protocol_TakeFwRequest(uint8_t *cmd, uint8_t *payload, uint16_t *len);

/**
 * @brief Contesta el pedido tomado con TakeFwRequest y libera el lugar.
 * @param ok  1 → ACK, 0 → NACK.
 */
void UART_Protocol_FwReply(uint8_t ok);

/**
 * @brief Poll for a CMD_FW_ABORT request (ése sí se ACKea desde el parser:
 *        cancelar no escribe nada).
 */
uint8_t UART_Protocol_GetFwAbort(void);

/**
 * @brief Poll for a CMD_SELFTEST request (cleared on read).
 *
 * El trabajo es del main loop: son lecturas I2C, y de I2C no se toca nada desde
 * una ISR. Igual que el status, no lleva ACK — la trama CMD_HEALTH es la
 * respuesta.
 */
uint8_t UART_Protocol_SelfTestRequested(void);

/** @brief Manda una trama CMD_HEALTH. Sólo desde el main loop, como SendStatus. */
void UART_Protocol_SendHealth(const ds_health_t *h);

/**
 * @brief Poll for a CMD_CAP_START request.
 * @param n  destino: muestras pedidas.
 * @return 1 y llena *n una vez por pedido, 0 si no hay ninguno.
 */
uint8_t UART_Protocol_GetCapStart(uint16_t *n);

/**
 * @brief Poll for a CMD_CAP_READ request.
 * @param off  destino: offset en bytes dentro de la captura.
 */
uint8_t UART_Protocol_GetCapRead(uint32_t *off);

/** @brief Manda CMD_CAP_INFO. Sólo desde el main loop. */
void UART_Protocol_SendCapInfo(const ds_cap_info_t *info);

/** @brief Manda CMD_CAP_DATA con un tramo. Sólo desde el main loop. */
void UART_Protocol_SendCapData(uint32_t offset, const uint8_t *data, uint16_t len);

/**
 * @brief Poll de un pedido CMD_GET_CAL.
 * @param first  destino: índice del primer canal pedido.
 * @return 1 si había pedido (la bandera se baja al leerla).
 */
uint8_t UART_Protocol_GetCalReq(uint8_t *first);

/** @brief Manda un tramo CMD_CAL_DATA. Sólo desde el main loop, como SendStatus. */
void UART_Protocol_SendCalData(const ds_cal_hdr_t *hdr, const ds_cal_ch_t *chs);

/** @brief Le dice al parser cuántos modos existen, para que pueda NACKear un
 *         CMD_SET_MODE fuera de rango en vez de ACKearlo y descartarlo. */
void UART_Protocol_SetModeCount(uint8_t n);
/** @brief ¿Llegó un CMD_SET_AUTOSTART? Devuelve 1 y el valor pedido. */
uint8_t UART_Protocol_GetAutostartRequest(uint8_t *on);
/** @brief ¿Llegó un CMD_SET_TONE? Devuelve 1, la frecuencia y si va con dither. */
uint8_t UART_Protocol_GetToneRequest(uint16_t *hz, uint8_t *dither);
/** @brief ¿Llegó un CMD_GET_FOCUS? */
uint8_t UART_Protocol_FocusRequested(void);
/** @brief Contesta CMD_FOCUS_DATA. Sólo desde el main loop, como SendStatus. */
void UART_Protocol_SendFocus(const ds_focus_t *f);
/** @brief ¿Llegó un CMD_SET_SPKMAP? Devuelve 1 y el mapeo pedido. */
uint8_t UART_Protocol_GetSpkMapRequest(uint8_t *cruzado);
/** @brief ¿Llegó un CMD_SET_MICS? Devuelve 1 y las dos entradas pedidas. */
uint8_t UART_Protocol_GetMicsRequest(uint8_t *m1, uint8_t *m2);
/** @brief ¿Llegó un CMD_GET_PHASE_INFO? */
uint8_t UART_Protocol_PhaseInfoRequested(void);
/** @brief Contesta CMD_PHASE_INFO. Sólo desde el main loop, como SendStatus. */
void UART_Protocol_SendPhaseInfo(const ds_phase_info_t *info);
/** @brief ¿Llegó un CMD_PHASE_READ? Devuelve 1 y el offset pedido. */
uint8_t UART_Protocol_GetPhaseRead(uint32_t *off);
/** @brief Contesta CMD_PHASE_DATA con `len` bytes desde `off`. */
void UART_Protocol_SendPhaseData(uint32_t off, const uint8_t *data, uint16_t len);
/** @brief ¿Llegó un CMD_GET_MODES? Devuelve 1 y el índice del primer modo. */
uint8_t UART_Protocol_GetModesReq(uint8_t *first);
/** @brief Contesta CMD_MODES_DATA. `names` son `hdr->count` cadenas contiguas
 *         NUL-terminadas cuyo largo total es `hdr->bytes`. */
void UART_Protocol_SendModesData(const ds_modes_hdr_t *hdr, const char *names);

#endif /* UART_PROTOCOL_H */
