bergamifer/DS-Project/(commit log)

2026-01-16 version final para mandar a pcbway
    [ADC_PCM1802.kicad_sch, DAC_PCM1690.kicad_sch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]
2026-01-16 agrego el README.md inicial con instrucciones
2026-01-17 Refactor: Renombrado de proyecto a DS para versionado semántico
    [DS.kicad_pcb, DS.kicad_sch]
2026-01-17 Fix: Eliminados archivos ignorados del repositorio
    [DS7-B_Cu.gbr, DS7-B_Mask.gbr, DS7-B_Paste.gbr, DS7-B_Silkscreen.gbr, DS7-Edge_Cuts.gbr, DS7-F_Cu.gbr, DS7-F_Mask.gbr, DS7-F_Paste.gbr]
2026-01-17 Agregué advertencias
    [DS.kicad_sch, esp32-mini.kicad_sch]
2026-01-17 actualizacion de .gitignore
2026-01-21 Se actualizaron algunas librerias del esquematico y se tomo nota de los errores de duplicación de uso de patas.
    [DS.kicad_pcb, DS.kicad_sch, STM32.kicad_sch]
2026-01-22 Primeras intervenciones de claude en el contexto
    - Actualizado DS_Hardware_Map.md: aclaradas direcciones I2C (7-bit), arquitectura SAI1/SAI4
    - Actualizado PowerSpecs.md: configuración para 8 sistemas con fuente Mean Well LRS-100-12
    - Actualizado delays_calculation.md: cálculos de memoria para delays de 100ms
    - Actualizado memory_map.md: eliminado dato inconsistente de DMA buffers
    - Actualizado pcm1690_quick_ref.md: formato 7-bit, strapping pins a 3.3V
    - Creado stm32/stm32_sai_config.md: configuración completa TDM para SAI1/SAI4
    - Creado stm32/audio_architecture.md: diagrama de bloques y arquitectura completa
    - Creado stm32/pin_alternate_functions.md: tabla de pines y código HAL
    - Creado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
2026-01-22 Agregar archivos de referencia de registros STM32H743
    Archivos creados con información extraída del conocimiento del RM0433:
    - stm32/rcc_registers_ref.md: Configuración completa de PLL3 para audio
    * Cálculos detallados para generar 12.288 MHz desde HSE 25 MHz
    * Registros RCC_PLLCKSELR, RCC_PLL3DIVR, RCC_PLLCFGR, RCC_PLL3FRACR
    * Clock source selection para SAI1 y SAI4
    * Ejemplos de código HAL
    - stm32/sai_registers_ref.md: Referencia completa de registros SAI
    * Todos los registros: SAI_GCR, SAI_xCR1, SAI_xCR2, SAI_xFRCR, SAI_xSLOTR
    * Configuración para TDM8 (DACs) e I2S (ADC)
    * Bit fields y valores para 48 kHz, 24-bit
    * Cálculos de MCKDIV y timing
    - stm32/dma_mapping_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
2026-01-22 Corrección CRÍTICA: SAI4 usa BDMA, no DMA2
    Verificación exhaustiva contra RM0433 Reference Manual reveló error
    arquitectónico significativo en la documentación de DMA.
    CORRECCIONES PRINCIPALES:
    - ❌ Error: SAI4_B documentado con DMA2 Stream 2 + DMAMUX1 request 113
    - ✅ Correcto: SAI4_B usa BDMA Channel 7 + DMAMUX2 request 16
    - Razón: SAI4 está en dominio D3/APB4, debe usar BDMA (no DMA1/DMA2)
    ARCHIVOS ACTUALIZADOS:
    1. stm32/dma_mapping_ref.md - Reescrito completamente
    - Agregada sección BDMA con registros y configuración
    - Ejemplos de código para BDMA Channel 7 + SAI4_B
    - Aclaración de 3 controladores DMA: DMA1, DMA2, BDMA
    - DMAMUX1 vs DMAMUX2 explicado
    2. stm32/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
2026-01-23 Limpieza y organización de documentación
    ARCHIVOS ELIMINADOS (obsoletos/duplicados):
    - DS.net - Netlist de KiCad (verificado, ya en contexto)
    - datasheets/rm0433.txt - 6.5MB (se puede regenerar si necesario)
    - dma_streams_map.md - Obsoleto (reemplazado por dma_mapping_ref.md)
    - stm32/dma_mapping_ref.md.OLD - Backup temporal
    - stm32/stm32_dma_streams.md - Obsoleto (info incorrecta)
    - stm32/stm32_sai_quick_ref.md - Duplicado (info en sai_registers_ref.md)
    - stm32/sai_registers.md - Duplicado (keeping sai_registers_ref.md)
    ARCHIVOS CREADOS:
    - README.md - Índice organizado de toda la documentación
    * Estructura clara por categorías
    * Quick reference con configuración hardware
    * Links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
2026-01-23 Ya generamos el primer ioc de stm32
2026-01-23 Add webserver files for DS Beamforming Control
    - Create requirements.txt with necessary dependencies for Flask and WebSocket support.
    - Add run.sh script to set up and run the Flask server with a virtual environment.
    - Implement CSS styles in style.css for a responsive and modern UI.
    - Develop main.js for frontend functionality, including WebSocket communication and device management.
    - Create index.html as the main template for the web interface, including device controls and logging.
2026-01-24 Version DS8 lista
    [ADC_PCM1802.kicad_sch, DAC_PCM1690.kicad_sch, DS.kicad_pcb, DS.kicad_sch, DS7.kicad_pcb, DS7.kicad_sch, DS_Power.kicad_sch, Power Barrel Connector Jack 694106301002.stp]
2026-01-31 Add audio architecture and GPIO control documentation for DS Beamforming
    - Introduced `audio_architecture.md` detailing the audio system overview, components, clock synchronization, hardware configuration, audio flow for beamforming, initialization sequence, and verification checklist.
    - Added `gpio_control.md` outlining reserved GPIOs for system control, proposed functions for power button, error LED, audio activity LED, mute button, calibration mode, and speaker amplifier enable, along with their configurations and behaviors.
2026-02-02 Remove lock file for KiCad schematic to prevent conflicts. New version sent to JLCPCB
    [ADC_PCM1802.kicad_sch, DAC_PCM1690.kicad_sch, DS.kicad_pcb, DS.kicad_sch, DS8.kicad_pcb, DS8.kicad_sch, DS_Power.kicad_sch, ESP32-C3-MINI-1.STEP]
2026-02-02 Add .DS_Store files to firmware directories
    - Added .DS_Store file to the firmware root directory.
    - Created .DS_Store file in the firmware/Core directory.
    - Created .DS_Store file in the firmware/Drivers directory.
2026-02-03 Add GPIO header file with function declarations for DS9 v2.0
    - Introduced gpio.h to define GPIO initialization, DAC, ADC, EEPROM, LED, and power control functions.
    - Functions include GPIO initialization for various peripherals, DAC control for reset and mute operations, ADC configuration, EEPROM write protection, LED control, and power management.
    [pin_definitions.h]
2026-02-13 New DS10 already under review. Errors corrected mostly on SAI ports mis addressed
    [ADC_PCM1802.kicad_sch, ALL_AMPS.kicad_sch, Amp_Bank.kicad_sch, Connectors_In.kicad_sch, Connectors_Out.kicad_sch, DAC_PCM1690.kicad_sch, DS.kicad_pcb, DS.kicad_sch]
2026-02-13 PowerSpecs acatualizado
    [Connectors_In.kicad_sch, Connectors_Out.kicad_sch, DS_Amp.kicad_sch, Power.kicad_sch]
2026-02-20 feat: Consolidate working DS9 firmware from WeAct_test_audio
    Migrates all working code from WeAct_test_audio project:
    STM32 firmware (firmware/):
    - main.c: 480MHz, 5x SAI DMA, beamforming pipeline, PCM1690 I2C init
    - uart_protocol.c/h: binary ESP32→STM32 config protocol (115200 8N1)
    - pcm1690.c/h: PCM1690 DAC driver, TDM8 init, I2C control
    - epaper.c/h: SSD1681 e-paper driver (SPI2)
    - pin_definitions_ds10.h: DS9/DS10 GPIO mapping
    - Makefile: GCC ARM toolchain + st-flash targets
    - HAL SAI/SPI drivers added
    ESP32-C3 firmware (firmware_esp32c3/):
    - main.c: WiFi STA + HTTP server + UART1 binary bridge + STM32 monitor task
    - sdkconfig.defaults: USB Serial/JTAG console
    Docs:
    - ds9_pin_audit.m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
2026-02-20 docs: Add WeAct prototype notes and clean up repo artifacts
    - Add WeAct-AudioTest-CLAUDE.md: historical session log documenting the
    WeAct STM32H743 prototype phase used to validate SAI1 I2S/TDM8,
    PLL3 MCLK 12.288MHz, PCM1690 I2C init sequence, DMA pipeline, and
    the beamforming algorithm before porting to DS9 hardware.
    - Remove DS_calendar.ics: unrelated calendar file, no project value.
    - Update .gitignore: add firmware/build_*/ pattern to exclude
    build_i2c/ and build_led/ directories (standalone test build artifacts).
2026-02-20 docs: Rewrite README to reflect current DS9 firmware state
    Replace outdated January 2026 content (2x DAC, SAI4+BDMA, wrong pins,
    "ready to implement") with accurate description of the working system:
    - Hardware target: STM32H743 + ESP32-C3-MINI-1
    - 5x SAI DMA circular, 32ch TX + 2ch RX, DS10 pinout table
    - 4x PCM1690 with correct I2C addresses (0x4C-0x4F)
    - Beamforming pipeline diagram (ADC → delay lines → Fill → DACs)
    - PLL1/PLL3 clock table, memory layout, UART binary protocol spec
    - Known issues (PA0→GPIO0, dual-beam, 32ch protocol)
    - Repo structure and next steps
2026-02-20 refactor: Rename build target to ds9_beamforming, drop WeAct/DS10 labels
    - Makefile: TARGET = ds9_beamforming (was Weact_test_audio)
    Build output: firmware/build/ds9_beamforming.bin
    Flash: make flash-stlink
    - main.c: banner "DS9 Beamforming Audio" (was "WeAct Beamforming Audio
    (DS10 config)"). Remove stale LED comment referencing WeAct/DS10.
    - system_clock.c: HSE comment says DS9 (was WeAct board crystal).
    - epaper.c/h: brief says DS9 (was WeAct 1.54").
    - stm32h7xx_hal_msp.c: PE11 comment clarifies DS9 shared-pin
    workaround (was "DS10 correct pin").
    Status confirmed on hardware: 50 Half/s, 50 Full/s, 0 errors, 0
    underruns, jitter 0µs, fill ~921µs, 4/4 PCM1690 OK.
    Co-Authored-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
    [main.c, system_clock.c]
2026-02-20 fix(esp32): swap UART TX/RX GPIOs to match DS9 PCB wiring
    DS9 PCB has GPIO0 traced to STM32 PA1 (UART4 RX) and GPIO1 to
    STM32 PA0 (UART4 TX) — opposite of what the names suggest.
    Previous config (TX=GPIO1, RX=GPIO0) was sending frames to STM32 PA0
    (its TX pin), so STM32 received 0 bytes. STM32 debug output was being
    transmitted on PA0 but ESP32 was listening on GPIO0→PA1 (STM32 RX),
    which never transmits.
    Fix:
    STM32_UART_TX = GPIO_NUM_0 (→ PA1 = STM32 UART4 RX)
    STM32_UART_RX = GPIO_NUM_1 (← PA0 = STM32 UART4 TX)
    Also update all comments, DIAG printf, and header block to reflect
    the correct DS9 PCB trace reality.
    [main.c]
2026-02-20 fix: resolve HardFault on boot, add diagnostics, clean up docs
    Firmware fixes:
    - Replace all SCB_CleanDCache_by_Addr/InvalidateDCache with __DSB()
    (D-cache was never enabled; these calls caused HardFault on boot)
    - Add HardFault handler with register dump (PC/LR/HFSR/CFSR/BFAR)
    via direct UART4 polling — no HAL or SysTick dependency
    - Switch heartbeat timer from HAL_GetTick to DWT->CYCCNT
    (immune to SysTick starvation by priority-0 SAI/I2C ISRs)
    - Add LED diagnostic init: D6=PC4 boot, D7=PC5 TX, D11=PB0 RX
    - Clear UART4 ORE/error flags before arming Receive_IT
    ESP32 fixes:
    - Remove GPIO test block (no longer needed)
    - Add 3s delay before UART monitor (wait for STM32 PLL/I2C init)
    D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
    [main.c, uart_protocol.c]
2026-02-21 STM32 temp sensor working
2026-02-21 archivo de mas
2026-02-21 feat: EEPROM config persistence via I2C4 (CAT24C256)
    - New eeprom_config.c/h: save/load beam_config_t to EEPROM with CRC16
    - Fix: EEPROM is on I2C4 AF6 (PB6/PB7), not I2C3 AF4 as schematic says
    - Fix: PB5 debug toggles moved to PB1 (D10) — PB5 is EEPROM WP
    - Deferred save via flag to minimize audio underruns (~6 per save)
    - Boot loads saved config, HTTP POST triggers save automatically
    [eeprom_config.c, eeprom_config.h, main.c, pin_definitions.h, uart_protocol.c]
2026-02-23 implementacion de dimmer leds
2026-02-24 feat: SAI1_A TDM8 — 8-channel audio verified on DAC1 U4 (PCM1690)
    Test infrastructure for DAC1 U4 audio verification:
    - 1kHz -6dBFS sine table (48 samples, 10 periods per half-buffer)
    - U4-only init path: SAI1_A + DAC1 only, other SAI/DAC blocks disabled
    - PCM1690 register readback (13 regs) printed after init for verification
    - SAI1_A status check: SAIEN + SR flags printed after DMA start
    - Buffer dump in heartbeat: Slots0-3 and Slots4-7 shown per second
    ROOT CAUSE ch5-8 silent: PCM1690 auto-detects sample rate from SCKI ratio.
    With SCKI=256×fS (PLL3P=28 → 12.288MHz) the chip enters DUAL RATE mode,
    mapping TDM channels 5-8 to DIN2 which is not connected on DS9 PCB.
    FIX — SCKI=512×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
    [main.c, pcm1690.c]
2026-02-25 feat: enable all 4 PCM1690 DACs — 32ch TDM8 firmware ready
    Extends SAI init from U4-only to all 4 DACs (32 channels total).
    Architecture is fully operational for DAC1 U4; DAC0/2/3 will work
    once DS9 PCB SAI wiring is bodged/corrected.
    Init sequence (order-dependent):
    1. Pre-fill all 4 DMA buffers with silence (audio_buffer..2b)
    2. SAI1_A DMA start → MCLK=24.576MHz on PE2 (PCM1690 POR gate)
    3. Init 4x PCM1690 via I2C1: DAC0(U3), DAC1(U4), DAC2(U2), DAC3(U8)
    - PE3 (DAC1_RST) and PE11 (DAC0_AMUTEI) temporarily as GPIO output
    4. Reconfigure pin conflicts back to SAI AF:
    - PE3 → SAI1_SD_B (AF6) [was DAC1_RST]
    - PE11 → SAI2_SD_B (AF10) [was DAC0_AMUTEI]
    5. SAI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
    [main.c]
2026-02-26 fix: skip SAI1_B and SAI2_B DMA — DS9 PCB pin conflicts destroy audio
    Root cause: two DS9 PCB routing bugs make SAI1_B and SAI2_B destructive:
    - PE3 (SAI1_SD_B) is wired to DAC1_RST (U4) — not to any DAC DIN
    - PE11 (SAI2_SD_B) is wired to DAC0_AMUTEI (U3) — not to any DAC DIN
    When SAI1_B DMA runs with PE3 reconfigured as AF6, the serial audio
    bitstream drives DAC1 RST: every 0-bit in the stream pulls RST LOW and
    resets U4. Continuous reset → no stable audio output on U4.
    When SAI2_B DMA runs with PE11 reconfigured as AF10, the bitstream
    drives DAC0 AMUTEI at BCK speed → DAC0 muted/unmuted at 12MHz.
    - Do NOT reconfigure PE3 and PE11 as SAI AF pins
    - Do NOT start SA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
    [main.c]
2026-03-01 feat: enable SAI1_B (DAC0 U3) + SAI3_B TX (DAC3 U8) — 4 SAI active
    SAI3_B converted from Master RX (ADC) to Master TX TDM8 for DAC3 U8
    on bodged PD8/PD9/PD10 pins. SAI1_B enabled as Slave TX sync for
    DAC0 U3 via PE3 (bodged from DAC1_RST). DAC1 U4 RST must be tied
    to VCC externally.
    Active SAI blocks: SAI1_A (DAC1), SAI1_B (DAC0), SAI2_A (DAC2), SAI3_B (DAC3)
    SAI2_B still skipped (PE11=DAC0_AMUTEI conflict).
    [main.c]
2026-03-06 DS10: Replace PCM1802 with AK5538VN 8ch ADC, add AVDD clean supply
    - Add AK5538VN (8ch 32-bit TDM256 ADC) replacing PCM1802 (2ch 24-bit)
    - New schematic: AK5538.kicad_sch
    - Library: librerias/LIB_AK5538VN/ (KiCad symbol + QFN64 footprint)
    - Power: AP2125K-3.3 LDO from 5V rail for clean AVDD (isolated from DVDD)
    - SAI target: SAI3_A, TDM256 slave, MCLK shared at 12.288MHz
    - Add PCM1690 library files (librerias/PCM1690/)
    - Add new footprints: QFN50P900X900X100-65N, C_Array 4x0402, SOP50P810X120-49N, SW_SPST
    - Update sym-lib-table with new libraries
    - Add DS10_DESIGN_REVIEW.md: full design review with AK5538VN integration,
    SPDIFRX analysis, expansion connector, JLCPCB cost optimizatio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
    [ADC_PCM1802.kicad_sch, AK5538.kicad_sch, AK5538VN.SchLib, AK5538VN.stp, ALL_AMPS.kicad_sch, Adafruit PAM8302.kicad_sch, Amp_Bank.kicad_sch, DAC_PCM1690.kicad_sch]
2026-03-19 DS10: Document power supply, audio distribution, and update schematics
    Add 24V bus + MP2315S buck converter design, Cat5e/RJ45 audio
    distribution architecture, and ferrite isolation between amp/digital
    rails to DS_Amp_Design_Notes.md. Update .gitignore for KiCad lock
    and backup files. Includes latest schematic and PCB layout changes.
    [AK5538.kicad_sch, ALL_AMPS.kicad_sch, Amp_Bank.kicad_sch, DS.kicad_pcb, DS.kicad_sch, DS_Power.kicad_sch, esp32-mini.kicad_sch, stm32_custom.kicad_sch]
2026-03-19 Update README.md to reflect DS10 current architecture
    Rewrite from outdated DS7 description (TFT display, 2-layer PCB) to
    current DS10: 32-channel beamforming audio with integrated PAM8302A
    amps, AK5538VN ADC, 4-layer PCB, 24V power distribution, and Cat5e
    audio distribution for ~500 speaker installations.
2026-03-24 DS10: Add 24V power supply (MP2315S), PCB layout with 4-layer zones, fix AK5538VN bugs
    Power Supply:
    - MP2315S buck converter 24V→5V (3A, 500kHz, SOT-23-8)
    - T-type feedback network: R28(40.2k) + R26(7.5k) + R19(20k) for 5.03V output
    - AAM network: R12(9.09k) + R13(100k) for optimal PWM/PFM transition
    - EN divider: R29(470k) for 24V input
    - Output: 2x22µF ceramic (X5R, 16V, 1206), L1=4.9µH shielded inductor
    - Ferrite bead FB2 isolates +5VA (amps) from +5V (LDOs)
    Power Distribution Architecture:
    - +5VA: direct buck output → 32x PAM8302A
    - +5VA_DAC: separated from +5VA via FB68 → PCM1690 AVDD (new net)
    - +5V: filtered through FB2 → AP1117 LDO → +3V3 digital
    - +5V: filtered through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
    [ADC_PCM1802.kicad_sch, AK5538.kicad_sch, ALL_AMPS.kicad_sch, Amp_Bank.kicad_sch, DAC_PCM1690.kicad_sch, DS.kicad_pcb, DS.kicad_sch, DS_Power.kicad_sch]
2026-03-25 DS10: Fix critical bugs, complete design verification (570-net netlist)
    Critical fixes applied:
    - AK5538VN TDM mode: swapped TDM0/TDM1 pins (was TDM128, now TDM256)
    Pin 51 (TDM0) → GND, Pin 52 (TDM1) → +3V3
    - STM32 VBAT (U7/6): connected to +3V3 (was floating with only cap)
    - Reannotated all designators for consistent numbering
    Verified from complete 570-net netlist (no script crash):
    - SAI1 → DAC0(U2)+DAC1(U3), SAI2 → DAC2(U1)+DAC3(U4) — correct
    - SAI3_B → AK5538VN: BICK(U7/55), SDTO1(U7/56), LRCK(U7/57)
    - I2C3 → AK5538VN: SDA(U7/66→IC3/43), SCL(U7/67→IC3/45) with RN6
    - 4 DAC I2C addresses unique: U2=0x4C, U1=0x4D, U3=0x4E, U4=0x4F
    - +3.3VA net: U10(AP2125K) output →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
    [AK5538.kicad_sch, ALL_AMPS.kicad_sch, Amp_Bank.kicad_sch, DAC_PCM1690.kicad_sch, DS.kicad_pcb, DS.kicad_sch, DS_Power.kicad_sch, esp32-mini.kicad_sch]
2026-03-27 Agregue proteccion en la entrada de 24v, tambien un pullup para el booteo del esp32
    [AK5538.kicad_sch, Amp_Bank.kicad_sch, DAC_PCM1690.kicad_sch, DS.kicad_pcb, DS_Power.kicad_sch, stm32_custom.kicad_sch]
2026-03-31 DS10: Production release — sent to JLCPCB (5 units)
    Schematic changes since last commit:
    - Added SMBJ24A TVS diode on 24V input (parallel +24V to GND) for surge protection
    - Added ESP32 GPIO9 external 10kΩ pull-up to +3V3 (fixes boot mode issue)
    - Connected AK5538 OVF (IC3/42) to STM32 PA15 (U7/77) for overflow detection
    - Added 16x 100pF C0G/NP0 caps on AK5538 analog inputs (AINxP/AINxN)
    - Renamed speaker connectors to JSPK01-JSPK16 for clarity
    - Selected CBW201209U601T (C21286) as universal ferrite for all 67 positions
    PCB layout:
    - Full 4-layer layout with JLC04161H-7628 stackup
    - Component placement: Buck → PAMs → STM32/ESP32 → DACs → ADC → RJ45
    - Zone strategy: L2=solid GN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
    [AK5538.kicad_sch, Amp_Bank.kicad_sch, DAC_PCM1690.kicad_sch, DS.kicad_pcb, DS.kicad_sch, DS10.step, DS_Power.kicad_sch, RJ45.step]
2026-03-31 DS10: Update docs for production milestone (2026-03-31)
    README.md:
    - Updated status from "Verificacion" to "Produccion" (sent to JLCPCB)
    - Added all pre-production fixes: TVS, GPIO9 pull-up, OVF, 100pF caps, JSPK renaming
    - Added critical components section: ferrite selection, STM32 consignment, THT manual solder
    - Added post-production improvement list: C47 SMD replacement, J32 chain detection, thermal
    DS10_DESIGN_REVIEW.md:
    - Added Section 9 additional fixes (2026-03-31): 8 items completed pre-production
    - Updated remaining DRC/ERC as non-critical for production
    - Added post-production improvements: C47→polymer SMD, J32 switch, MP2315S thermal, ESD, SAI routing
    - Added Section 10: PRODU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
2026-04-01 DS10: Final pre-release — MP2315S thermal improvements
    PCB thermal management for MP2315S (IC2, SOT-23-8):
    - Added solid copper fill on SW node / inductor L1 footprint (L1 top layer)
    - Added GND via stitching around IC2 (0.4/0.8mm, 6-10 vias, L1 → L2 plane)
    - SOT-23-8 has no exposed thermal pad; heat path: pins → GND copper → vias → L2
    - Vias placed within 3-4mm of IC, in surrounding GND pour (not under component)
    - L2 confirmed solid/uncut under entire buck converter area
    Updated Gerbers for JLCPCB production order.
    Docs: updated README and DS10_DESIGN_REVIEW with thermal details and
    post-production improvement list.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
    [DS.kicad_pcb]
2026-04-09 DS10: Final production release — order placed at JLCPCB (2026-04-09)
    Schematic fixes since last commit:
    - AMUTEO wire-OR: added 4x 1kΩ series resistors (R107-R110), one per DAC output
    to limit conflict current during power-up (push-pull outputs, 4x PCM1690)
    - D8 TVS: corrected value from SM6T15A (15V) to SMBJ24A (24V standoff, 600W peak)
    LCSC C726830 — wrong value would have clamped the 24V rail
    - 22µF caps: corrected Comment field (1206 → 0805, footprint was already correct)
    - PWR_FLAG added on required power nets to resolve ERC power_pin_not_driven
    - AMUTEO ERC warnings suppressed (wire-OR intentional)
    - Removed SAI bus length matching serpentines (unnecessary at 12.288MHz,
    p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
    [ALL_AMPS.kicad_sch, DAC_PCM1690.kicad_sch, DS.kicad_pcb, DS_Power.kicad_sch, stm32_custom.kicad_sch]
2026-04-29 DS10: Add firmware configuration reference (Section 11)
    Complete STM32 + ESP32 port map verified against netlist, for the bring-up
    firmware session. Covers SAI, I2C, UART, GPIO, LEDs, buttons, and expansion
    headers with exact pin numbers and alternate functions.
    Also fixes several stale comments in earlier sections (SAI3_B not SAI3_A,
    AMUTEO R107-R110 note, button assignments K1-K4 corrected per netlist).
2026-04-30 feat(DS10): complete firmware and docs migration DS9→DS10
    Firmware:
    - pin_definitions.h: full rewrite for DS10 netlist (2026-04-02, 574 nets)
    - Shared DAC RST/MUTE bus (PC11/PC12/PC10) replacing 12 per-chip DS9 GPIOs
    - AK5538VN ADC: PDN(PC7), DIF1(PC8), OVF(PA15)
    - PAM8302A amp bank: PAM_SD(PD3)
    - 4 LEDs via TIM3 PWM (PA6/PA7/PB0/PB1)
    - I2C3 (PA8/PC9 AF4) for AK5538VN
    - I2C4 AF6→AF11 (PB6/PB7)
    - UART7: PA8/PA15→PE7/PE8 AF7
    - AUDIO_ADC_CHANNELS 2→8, AUDIO_MCLK_FREQ 12.288→24.576 MHz
    - main.h: remove stale DS9 CubeMX defines (ADC_OSR=PB0, LED_STATUS=PB5)
    - main.c: shared DAC RST init, AK5538 PDN sequence, MX_SAI3_Init TDM256 (8ch),
    MX_I2C3_Init, MX_TIM3_Init CH1/CH2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
2026-05-16 fix(DS10): critical pre-flash fixes — EEPROM AF11, AK_PDN polarity, all-DAC fills
    Pre-flash code review found 4 critical bugs:
    1. eeprom_config.c: I2C4 AF was GPIO_AF6_I2C4 → should be GPIO_AF11_I2C4
    for PB6/PB7 on STM32H743 LQFP100 (per datasheet Tables 13-14).
    Now uses EEPROM_I2C_AF macro from pin_definitions.h.
    2. AK_PDN polarity inverted vs AK5538VN datasheet:
    "L" = Reset & Power-Down (chip OFF), "H" = Normal operation (chip RUNNING)
    - MX_GPIO_Init: init LOW (chip OFF during boot, was HIGH = chip running)
    - After SAI3_B DMA start: set HIGH to release PDN (was LOW = chip OFF)
    pin_definitions.h comment updated with explicit datasheet language.
    3. main loop: SAI2_A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
    [eeprom_config.c, main.c, pin_definitions.h]
2026-05-16 feat(DS10): 4-LED dimmer, I2C4 in MspInit (#10), cleanup DS9 refs
    LED dimmer extended to all 4 channels (resolves user request):
    - DS10 firmware was animating only CH3/CH4 (D6 green, D7 white)
    - Now sweeps D4(yellow PA6) → D5(red PA7) → D6(green PB0) → D7(white PB1)
    in 4 phases of 3s each (12s full cycle), one LED fade-in at a time
    - New dimmer_channels[] table indexed by dimmer_phase (DIMMER_NUM_PHASES=4)
    #10 — I2C4 added to HAL_I2C_MspInit:
    - New I2C4 branch: D3PCLK1 source, AF11, NVIC priority 2 (same as I2C3)
    - Matching I2C4 branch in HAL_I2C_MspDeInit
    - eeprom_config.c::EEPROM_Init() simplified: removed inline GPIO/clock setup
    (now done by MspInit via standard HAL flow)
    DS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
    [eeprom_config.c, eeprom_config.h, main.c, pcm1690.h, system_clock.c]
2026-05-28 DS10: Add bring-up procedure (DS10_BRINGUP.md)
    First-power-on guide for the boards received from JLCPCB. Documents the
    24V-first workflow that avoids the USB-only inrush problem (USB charging
    1.1mF of +5VA bulk through FB2 trips the laptop port OCP), the current-
    limited smoke-test procedure, rail verification, the STM32 SWD / ESP32 USB
    flashing flow, and ground-loop mitigation (laptop on battery / floating PSU).
    Also flags D8 TVS status: BOM had SM6T15A (15V) with no LCSC number, so it
    likely shipped unpopulated — no 24V transient protection this run. Corrected
    local BOM to SMBJ24A (C726830) for future batches; permanent fix belongs in
    the KiCad schematic since the BOM is regenerated fro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
2026-05-29 fix(DS10): UART RX overrun recovery, I2C NVIC trap, HardFault amp mute
    Exhaustive pre-flash code review (Opus 4.8). No new bring-up blockers;
    the 4 criticals from the prior review remain correctly fixed. Addressed
    robustness issues found:
    1. UART4 RX overrun no longer kills the ESP32 link permanently.
    Added HAL_UART_ErrorCallback: on ORE/NE/FE/PE (likely during a long
    blocking debug print or ~12ms EEPROM save with FIFO disabled), it
    clears flags, resyncs the parser, and re-arms HAL_UART_Receive_IT.
    Previously the RX-IT chain aborted and was never re-armed → deaf link.
    2. Removed I2C3/I2C4 NVIC enables (latent trap). All I2C transfers are
    blocking, so the IRQs never assert,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
    [uart_protocol.c]
2026-06-10 feat(DS10): route debug to UART7 (J7/ST-Link VCP) + auto-reset on flash
    Direct STM32 debug via ST-Link, no ESP32 in the loop:
    - J7 pinout confirmed: pins 7/8 = UART7_RX/TX (PE7/PE8). The ST-Link's
    VCP bridges these to USB (/dev/cu.usbmodem*).
    - UART_Print now transmits on UART7 (was UART4). Boot banner + heartbeat
    + all status now come out J7 → ST-Link VCP.
    - HAL_SAI_ErrorCallback output moved to UART7.
    - HardFault dump (stm32h7xx_it.c) now polls UART7 registers, so crash
    dumps also appear on the ST-Link VCP.
    - UART4 (PA0/PA1) stays reserved for the ESP32 binary protocol (RX still
    armed; dormant without ESP32). uart_protocol dbg/config dumps already
    used UART7 — now everything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
    [main.c]
2026-06-10 fix(DS10): revert EEPROM I2C4 to AF6 (AF11 was a design-review error)
    First DS10 boot showed EEPROM not detected (available=0) despite correct
    hardware (U8 placed, RN5 4.7k pull-ups, PB5/6/7 = pins 91/92/93). Root
    cause: AF11 leaves PB6/PB7 unconnected to I2C4 on STM32H743 → no SCL/SDA
    toggling → no ACK.
    DS9 empirically proved PB6/PB7 + AF6 = working I2C4 (CAT24C256 found at
    0x50) on the same silicon. The DS10 design review's "AF11" was a doc error
    (same source had the MCLK 12.288 vs 24.576 mistake). Reverted EEPROM_I2C_AF
    to GPIO_AF6_I2C4.
    Build verified: 57508 bytes, 0 errors.
    [main.c, pin_definitions.h]
2026-06-10 perf(DS10): trim heartbeat to 1 line/sec, verbose details every 10s
    The per-second heartbeat printed 6+ blocking lines on UART7. Each burst
    blocked the main loop long enough to delay the SAI fills, causing ~6
    software-detected underruns/sec (329 over 60s — benign, the DMA reuses
    the previous buffer half, but it tripped the test's Undr==0 criterion and
    spammed the serial).
    Now: one concise line per second (Half/Full/Err/Undr/RX). Fill/Jitter/Temp
    and the buffer-slot dump print only every 10th heartbeat. EEPROM confirmed
    working with AF6 (available=1) in the same session.
    Build verified: 57552 bytes, 0 errors.
    [main.c]
2026-06-10 fix(DS10): test tone -30dBFS (PAM clipping), AK5538 I2C probe, ADC RX dump
    Speaker test on U2 ch0/ch1 confirmed audio but square-wave distortion.
    Root cause is arithmetic, not a fault: PAM8302A has fixed +24dB gain on a
    5V rail → max clean input ≈ 630mVpp diff ≈ -22dBFS at the PCM1690 (8Vpp
    diff FS). The -6dBFS tone (4Vpp) overdrove the amp by ~16dB.
    - New test_tone_shift (default 4 = -24dB): tone now -30dBFS ≈ 250mVpp at
    the PAM input ≈ 0.5W/4Ω clean. Board power draw with 2 speakers should
    drop well below the clipped 5.4W.
    - AK5538VN liveness probe on I2C3 at boot: ACK at 0x28 proves the ADC is
    powered and out of PDN (config itself is hardware-strapped, no writes).
    - Hear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
    [main.c]
2026-06-11 Docs: DS10 batch-1 defect findings + DS11 master plan
    - DS10_BRINGUP.md: mandatory pre-power gate (rail-to-GND resistance +
    IC orientation check) and confirmed batch-1 defects: JLCPCB assembled
    U1/U3/U4 (PCM1690) rotated 180° against the provided CPL (all four at
    270°), shorting +3V3 (7.8R) and +5VA_DAC (13R); D8 populated with
    SM6T15A (15V TVS) instead of SMBJ24A on the 24V rail.
    - DS11_PLANNING.md (new): master plan for the next revision — 10 fixes
    (RJ45 orientation, 24V daisy-chain connector, D8, USB inrush jumper,
    silk/ERC cleanups), ST-Link 5V powering topology (3 diode-OR'd 5V
    sources), hardwired power LED + test points, anti-error fabrication
    gates (DFM 3D review,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
2026-06-11 fix(DS10): SAI 24-bit data alignment — root cause of distorted audio (DS9 legacy bug)
    THE BUG: SAI with DataSize=24 transmits bits [23:0] of the FIFO word
    (right-aligned, RM0433). The fill code did `out = s << 8`, placing the
    24-bit sample in bits [31:8] — so the SAI actually transmitted the low
    16 bits of the sample plus 8 zero bits. The waveform wrapped 64× per
    cycle at -6dBFS → sawtooth-like harmonic hash over the 1kHz fundamental.
    This explains every symptom across two boards:
    - "1kHz but square/saturated" on speakers (DS10): wrapping harmonics.
    - Large HF hash on the scope riding the 1kHz fundamental — it was real
    signal distortion, not common-mode feedthrough nor probe pick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
    [main.c]
2026-06-11 feat(DS10): AK5538 found at I2C 0x11 — fix address, add register dump
    First boot with clean sine confirmed by ear: the SAI 24-bit alignment fix
    (4db688d) was the root cause of the distortion heard since DS9.
    I2C3 bus scan found the AK5538VN ACKing at 7-bit 0x11 (8-bit 0x22) —
    matches the AKM scheme 0x10 + CAD1·2 + CAD0 with CAD0=1 strapping. The
    design review's "7-bit 0x14" was its 5th documented error. AK5538_ADDR
    updated 0x28 → 0x22.
    Added a boot-time register dump (0x00-0x17) over I2C3: the RX data looks
    misframed (only slot 0 carries data, never-negative stuck patterns), so
    the chip is alive but its strap-derived output mode likely isn't the
    TDM256 the SAI expects. The dump will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
    [main.c, pin_definitions.h]
2026-06-11 feat(DS10): enable AK5538 TDM256 via I2C — straps left it in stereo mode
    Register dump from first boot with working I2C (addr 0x22):
    R00=FF (all 8ch powered), R01=01 (RSTN normal), R02=01 (HPF on),
    R03=00 → TDM[1:0]=00 = TDM DISABLED (stereo mode).
    The hardware straps did NOT select TDM256 (contrary to the design
    review's claim) — the chip was outputting 2-channel stereo format while
    SAI3_B expects 8×32-bit TDM slots. That explains the misframed RX data
    (stuck patterns in slot 0 only, zeros elsewhere).
    Boot now programs TDM256 over I2C: RSTN=0 → Control2(0x03)=0x40
    (TDM[1:0]=10) → RSTN=1, with R01-R03 readback printed for verification.
    Register values are based on the AKM fa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
    [main.c]
2026-06-11 feat(DS10): ADC ch0 min/max meter — AK5538 TDM256 capture CONFIRMED
    Boot log after the TDM256 I2C config (16f8519): R03 readback = 0x40 and
    all 8 RX slots now carry data with correct framing — 24-bit MSB-aligned
    in 32-bit slots (values end in 0x00; ±FS = 0x7FFFFF00/0x80000000). The
    ADC is converting: channels sit at ±full-scale because the floating
    high-impedance differential inputs saturate on ambient hum/EMI, with
    occasional mid-range values as the hum crosses through — expected
    behavior with nothing connected.
    Added a ch0 min/max meter over the full half-buffer (480 frames = 10ms)
    to the verbose heartbeat: floating → ±FS, grounded → ~0, injected tone →
    symmetric min/max at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
    [main.c]
2026-06-15 docs(DS10): consolidate bring-up findings + DS11 upgrade plan, fix stale refs
    Documentation cleanup after the DS10 bring-up reached working audio + ADC.
    New documents:
    - docs/ds10_bringup_findings.md: complete record of the 7 issues found and
    fixed (SAI alignment root cause, EEPROM AF6, AK5538 addr 0x11, TDM via
    I2C, PAM clipping levels, AK_PDN polarity, JLCPCB rotation), plus verified
    data (12V input OK, 5VA clean, debug on UART7) and lessons learned.
    - docs/ds11_upgrades.md: production-board recommendations. Key decision:
    KEEP the AK5538 strap wiring as-is and configure TDM over I2C (the strap
    pins share the I2C bus; re-wiring buys nothing). Plus DAC->PAM attenuator
    for +20dB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
2026-06-15 feat(DS10): output level via PCM1690 digital attenuation (-24dB), retire SW shift
    Fix the PAM8302A clipping the proper way — in the DAC, no components:
    - PCM1690 registers 72-79 now set to -24dB at init (PCM1690_ATTEN_DEFAULT,
    new PCM1690_ATTEN_24DB=0xCF) so a full-scale digital signal lands just
    under the amp's +24dB/5V clip point. Per-channel → doubles as future
    volume/balance control.
    - test_tone_shift back to 0: the table uses its full range, the DAC does
    the attenuation. Same audible level (-30dBFS out), now applies to ALL
    audio, not just the test tone. Verify in boot: Reg72-79 read 0xCF.
    - ds11_upgrades.md: corrected the overstated "+20dB SNR" claim. Digital
    atte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
    [main.c, pcm1690.c, pcm1690.h]
2026-06-22 DS11: schematic work + DS10 defect/claim resolution
    Esquemático DS11 (casi cerrado):
    - D8 -> SMBJ24A (C726830), corrige TVS de 15V en riel 24V
    - Schottky SS34 (C8678) en serie con FB2: aisla PAMs/+5VA del path USB
    - Schottky B5819W en serie con JP3 (ST-Link 5V); VTREF a +3V3 directo
    - PWR_FLAG (corrige 6x ERC power_pin_not_driven)
    - LED power hardwired en +3V3 (470R) + test points
    - LEDs verdes del RJ45x4 en PE12 (4x 470R)
    - K1 rediseñado: reset HW del ESP32 (EN + RC 10k/100nF); boot GPIO8 eliminado
    - TVS PRTR5V0U2X (SOT-143, C5158049) en pares diferenciales RJ45
    - RJ45x4 RJHSE538X-04 orientado hacia afuera
    - Terminal block MSTBVA 2,5/2-G-5,08 para 24V (clusters de 4 cajas)
    Docs/memoria: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
    [ADC_PCM1802.kicad_sch, AK5538.kicad_sch, ALL_AMPS.kicad_sch, Adafruit PAM8302.kicad_sch, Amp_Bank.kicad_sch, DAC_PCM1690.kicad_sch, DS.kicad_pcb, DS.kicad_sch]
2026-06-23 debug(DS10): per-SAI fill counters + 4-buffer TX dump to localize silent ch8-31
    With all 4 PCM1690 now populated, ch8-31 (DAC1/U3, DAC2/U1, DAC3/U4) are
    silent while ch0-7 (DAC0/U2, SAI1_A) play the tone. The firmware fills all
    4 TX buffers identically, so this isolates whether the 1B/2A/2B fills are
    actually running.
    Heartbeat verbose now prints:
    - TXbuf A1/1B/2A/2B: slot 0 of frame 2 from each of the 4 TX buffers
    - fills/s A1/1B/2A/2B: per-SAI Half+Full callback counts (new cb_*_count)
    Interpretation:
    - 1B/2A/2B counts ~100/s AND buffers show the tone (0x00109087) → buffers
    fine → problem is hardware (SAI SD/clock routing to U3/U1/U4 after rework).
    - 1B/2A/2B counts 0 OR buffers 0x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
    [main.c]
2026-06-24 debug(DS10): dump SAIEN/WCKCFG/OVRUDR/FLVL for all 4 TX SAI blocks at boot
    Careful code review for a software cause of silent ch8-31 found none:
    - MspInit GPIO is correct and symmetric (PE3 AF6, PD11/12/13 AF10, PE11
    AF10), DMA streams/requests right, and MX_GPIO_Init's analog list does
    NOT touch the SAI pins (and runs before SAI init anyway) → no pin clobber.
    - MX_SAI2_Init config is byte-for-byte identical to the working SAI1_A.
    - The per-SAI fill counters already proved all 4 DMAs drain at 100/s, i.e.
    all 4 blocks are shifting data out their SD pins.
    Last software check without a scope: extend the boot SAI status dump from
    SAI1_A only to all 4 TX blocks, decoding SAIEN, MODE, OVR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
    [main.c]
2026-06-24 docs(DS10): fix wrong SAI2_A FS/SCK comment in MspInit (PD12=FS, PD13=SCK)
    While reviewing for the silent ch8-31, found the MspInit comment contradicts
    pin_definitions.h: it claimed PD12=SCK_A / PD13=FS_A, but the STM32H743 AF10
    silicon mapping (DS12110 Tables 13-14, and pin_definitions.h) is the reverse:
    PD12=SAI2_FS_A (LRCK), PD13=SAI2_SCK_A (BCK).
    The AF setting is what the silicon honors, so functionally the STM32 always
    drives FS on PD12 and BCK on PD13 — but if the DS10 PCB was routed with the
    old DS9-era swapped assumption (PD12→BCK, PD13→LRCK), U1/U4 receive FS↔BCK
    crossed and stay silent while still ACKing on I2C (I2C/MCLK are independent).
    This is a prime suspect for the S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
2026-06-30 fix(DS10): AK5538 ADC clock mode CKS=512fs — root cause of input-independent railing
    The AK5538 output railed on all 8 channels with OVF=1, totally independent
    of the analog inputs (shorting AINxP/N at the chip pins did nothing).
    Supplies (AVDD), references (VREFH/L) and input bias (1.25V, P=N) all
    measured correct, and SAI3_B RX DMA was alive (data changing) — so it was
    neither front-end, supply, nor a frozen buffer.
    Root cause: the clock-mode bits CKS3-0 (Control1 reg 0x02 bits [6:3]) were
    never programmed. Default 0000 = 128fs Quad-Speed, but the board feeds 512fs
    (24.576MHz MCLK shared with the PCM1690s). The mismatch ran the delta-sigma
    modulator at the wrong oversampling -> perman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
    [main.c]
2026-06-30 chore(esp32): move WiFi credentials to gitignored secrets.h
    The public repo had the home WiFi SSID/password hardcoded in main.c. Move
    them to firmware_esp32c3/main/secrets.h (gitignored) with a committed
    secrets.h.example template; main.c now #includes secrets.h.
    NOTE: credentials committed earlier remain in git history and should be
    considered exposed (rotate those network passwords).
2026-07-02 fix(DS10): serialize delay_write_pos across RX/TX + trim blocking heartbeat
    Process RX before the 4 TX fills in the main loop so all DAC banks read
    the same delay_write_pos snapshot per pass — silent today in passthrough
    (delay=0) but would desync phase between DAC groups once beamforming
    uses real per-channel delays.
    Also drop the solved-bug diagnostics (TXbuf/fills-per-SAI/ADC hex dumps)
    from the 10th-heartbeat verbose block: cut its UART7 blocking time and
    the resulting spurious underruns from ~15 to ~4 per block. Verified
    Err=0 and ~0us jitter over a 9.5min+ soak test, all 8 AK5538 channels
    confirmed alive via touch test.
    [main.c]
2026-07-02 docs: DS11 netlist review + beamforming roadmap (Fable analysis)
    Add the exported DS11 KiCad netlist to the repo (docs/DS11_netlist.net)
    and document a deep review of it: critical findings (missing mic bias on
    J9, alternating output polarity between odd/even channels, a channel
    swap on JSPK09/10, the MP2315S buck running at its input voltage limit)
    plus confirmed-correct items, folded into ds11_upgrades.md.
    New docs/beamforming_roadmap.md captures the firmware architecture
    audit and the phased plan from passthrough to real delay-and-sum
    beamforming (channel walker -> RX sum -> TX steering -> sub-sample
    precision -> protocol), cross-linked from ds10_bringup_findings.md's
    new entry for today'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
2026-07-03 feat(beam): fases 0-2 — modos K2, channel walker, RX delay-and-sum, TX steering
    K2 (PA4) cycles 11 states: ADC monitor -> channel walker (1s/ch, verifies
    speaker mapping) -> 5 RX beam presets (az 0/+-30/+-60, far-field linear
    mic array placeholder 50mm) -> 4 TX focal presets (near-field, real 4x8
    brick speaker geometry: 80mm X pitch, 160mm Y pitch, rows 2&4 +40mm).
    RX: Process_ADC_Half computes beam_line[] = normalized delay-and-sum of
    the 8 ADC channels; BEAMpk meter in the heartbeat. TX: per-channel focal
    delays (farthest speaker fires first), tx_delay[32] kept separate from
    beam_config.delays (ESP32 config clobbers those on every command), gains/
    mutes/master shared. TX_MAX_DELAY_SAMPL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
2026-07-03 feat(beam): fase 3 + AUTOFOCUS — delays fraccionales Q8 y calibración medida con mic
    Fase 3: tx_delay pasa a Q8 (1/256 muestra ≈ 0.03mm); el fill TX interpola
    linealmente entre muestras adyacentes de beam_line (primer escalón de la
    escalera sub-muestra del roadmap; FIR polifásico solo si la medición lo
    pide). Print de delays en samples.frac.
    AUTOFOCUS (estado 12 de K2): mic de medición en ADC input 1 (c0) colocado
    en el punto focal deseado. Scan secuencial: chirp 500Hz→6kHz de 10ms por
    parlante, captura de 100ms, correlación cruzada chunked (128 lags/pasada,
    ~0.6ms — nunca rompe el deadline de audio) → TOF por parlante con refine
    sub-muestra (parábola sobre |corr|) y POLARI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
2026-07-03 docs(beam): fase 3 + AUTOFOCUS en roadmap + spec de control remoto de modos
    Documenta la interpolación Q8, el modo AUTOFOCUS (chirp scan, TOF sub-
    muestra, polaridad medida, calidad) y deja la spec concreta para el cambio
    de modo remoto via webserver: CMD_SET_MODE/CMD_GET_STATUS/CMD_EVENT sobre
    el framing UART existente, endpoint POST /mode en el ESP32, y UI_ApplyState
    como única puerta de entrada compartida con K2.
2026-07-03 feat(beam): fase 4 — control remoto completo via ESP32 + UI web embebida
    Protocolo UART extendido (mismo framing AA55/checksum/0D0A existente):
    - CMD_SET_MODE (0x02): cambia entre los 12 estados de ui_states remotamente;
    entra por UI_ApplyState(), la misma puerta que K2 — cero estado duplicado.
    - CMD_SET_BEAM (0x07): steering custom fuera de presets — RX az arbitrario
    o foco TX (fx,fy,fz)mm — via UI_ApplyCustomBeam() con la misma higiene de
    flags (aborta AUTOFOCUS, un solo modo activo).
    - CMD_GET_STATUS (0x03) → CMD_STATUS (0x04): telemetría ds_status_t de 53
    bytes (modo, az RX, foco TX, underruns, errores SAI, OVF, estado del scan
    AUTOFOCUS, peaks de los 8 canales ADC).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
    [main.c, uart_protocol.c, uart_protocol.h]
2026-07-03 last commit
    [AK5538.kicad_sch, ALL_AMPS.kicad_sch, Amp_Bank.kicad_sch, DAC_PCM1690.kicad_sch, DS.kicad_pcb, stm32_custom.kicad_sch]
2026-07-03 docs: README refleja la fusión con hardware/DS y el repo unificado privado
2026-07-03 docs: consolidación anti-duplicados + reporte del camino + checklist pre-JLCPCB unificado
    Reorganización para eliminar información redundante que estaba divergiendo:
    - docs/historico/ agrupa lo de DS9 (pin audit/map, PCM1802, esquemático PDF)
    - Netlist en UNA sola copia: hardware/DS/DS.txt (export 2026-07-02, el más
    nuevo); eliminado docs/DS11_netlist.net
    - DS_Hardware_Map_v2: única copia en docs/ (la más nueva, con sección DS10);
    la de hardware/DS pasa a ser puntero
    - WebServer.md → webserver/README.md; memory_map.md → docs/
    - Corregido MCLK 12.288→24.576MHz en hardware/DS/README.md (dato viejo)
    Checklist pre-JLCPCB UNIFICADO en hardware/DS/DS11_PLANNING.md §8 (el de
    ds1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
2026-07-03 docs(ds11): revisión de layout completada + polaridad/mapeo resueltos por diseño + netlist fresco
    Netlist regenerado (export 2026-07-03 18:02): R131=33Ω verificado en su net
    (pin1 → /ADC_AK5538/MCLK solo con IC3.24; pin2 → tronco SAI1_MCLK con JP2 y
    RN1-4) — topología exacta a la regla de bifurcación acordada.
    Revisión de layout sobre plots 600dpi (plots_png_600/): In1 = GND sólido sin
    cortes; In2 = islas de power bien particionadas; 24V daisy-chain en pour ≥8mm;
    RJ45 abre hacia afuera con TVS al lado; floorplan separa amps de la analógica
    de entrada. Ítems de layout del checklist §8.4 marcados verificados.
    Polaridad alternada + swap JSPK09/10: RESUELTOS POR DISEÑO (acla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
2026-07-03 feat(sitio): página pública de Domosonica — historia, simulación de interferencia interactiva y convocatoria a crear obra
2026-07-03 feat(sitio): versión standalone (doctype+head+OG) para hosting propio / WordPress
2026-07-04 fix(sitio): standalone en ASCII puro (entidades HTML + escapes JS/CSS) para evitar mojibake por charset del servidor
2026-07-04 chore(sitio): .htaccess para forzar charset UTF-8 en el servidor
2026-07-05 feat(ios): app Domosonica v1 (SwiftUI) + preview espacial v2 + tipografía del sitio sin serif
    - ios/: control remoto vía HTTP al ESP32 (modos, haz TX/RX, VU, AUTOFOCUS),
    vista espacial SceneKit con muro real 4x8 y gradiente de delays, follow-me demo.
    Build verificado (xcodebuild, SDK iphoneos).
    - docs/app_ios.md: física del TOF relativo con celular, roadmap ARKit/auto-survey/RIR,
    TODOs de firmware, guía de instalación y App Store.
    - sitio/: display Avenir Next ultraliviano + wordmark mono (adiós Palatino);
    build_standalone.py para regenerar el standalone ASCII de un comando.
2026-07-05 feat(ios): v1.5 — ícono, espacial multi-nodo con trayectorias y cámara orbital, medición RIR de sala
    - Ícono: campo de interferencia enfocando (icon-1024, generado por script)
    - Espacial: cámara orbital + pinch, focos guardados persistidos, trayectorias
    grabar/reproducir/streamear con estela 3D, follow-me demo
    - Multi-nodo: NodesStore con pose (x,z,yaw) por muro, editor, transformación
    global→local y fan-out paralelo — 15 nodos se coordinan hoy a nivel comandos
    - Pestaña Sala: RIR método Farina (sweep ESS + deconvolución vDSP DFT),
    RT60 broadband/bandas, curva Schroeder, veredicto de focalización
    - docs/multinode.md: estrategia completa 10-15 nodos (geometría/reloj/con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
2026-07-05 fix(docs): corregir alcance de JP2/MCLK compartido en multinode.md
    JP2 comparte solo MCLK (referencia de sobremuestreo del SCKI), no BCK/FS
    (lo que realmente fija el instante de cada muestra). Verificado en el netlist:
    puente simple sin buffer, pin1->SAI1_MCLK trunk, pin2->J5.7. Compartir MCLK solo
    probablemente no alcanza para lock de fase completo entre nodos independientes;
    falta compartir BCK/FS o disciplinar el PLL3 esclavo. Queda como pregunta empírica
    para la Fase A (2 nodos).
2026-07-05 docs(multinode): arquitectura real multi-nodo — distribución analógica autosincronizante
    Fernando aclaró la intención de diseño: la señal se distribuye analógica por el
    daisy-chain y cada nodo digitaliza/reproduce con su propio cristal. Cada nodo actúa
    como línea de retardo analógica: el error de fase inter-nodo NO se integra —
    Δτ = latencia × Δppm ≈ 0,8 µs ≈ 0,27 mm (constante, despreciable). No hace falta
    cable de clock para el caso de uso real. JP2 queda como hedge experimental.
    Peros reales: latencia por nodo constante (calibrar/determinizar al boot) y
    contenido generado internamente (solo modos de test) que sí deriva.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
2026-07-05 docs(multinode): latencia por nodo (3 niveles, sin hardware), mitigación de contenido generado, viabilidad acústica 10-15 nodos
    - Latencia: arranque determinístico (TX en el flanco del callback RX) + lectura
    NDTR para verificación — los group delays de conversores son constantes idénticas
    y se cancelan entre nodos. El loop DAC→ADC de Fernando queda como self-test +
    tap de línea (header DNP + R 1k, agregado a DS11_PLANNING §8.2).
    - Contenido generado: conmutación coordinada 'a las T' (delay de ejecución en el
    comando) + truco del oscilador en la cabecera (el nodo 1 genera e inyecta al
    daisy-chain analógico → coherencia gratis en los 15 nodos).
    - Nueva §6: viabilidad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
2026-07-05 docs: enlazar roadmap principal con multinode.md y priorizar TODOs de firmware
    beamforming_roadmap.md ahora apunta al horizonte multi-nodo tras la Fase 1.
    multinode.md: TODOs reordenados por prioridad — arranque determinístico primero
    (barato, sin hardware nuevo, listo para el experimento de 2 nodos sin esperar
    la DS11), lectura NDTR de verificación, y delay de ejecución en los comandos
    para conmutación coordinada.
2026-07-07 docs(esp32): roles del ESP32-C3 (BLE-MIDI, ESP-NOW) + verificación de keepout de antena en DS11
    - docs/esp32_roles.md: capacidades reales del chip (BLE 5 LE, ESP-NOW, caveat de
    coexistencia WiFi/BLE), aplicaciones rankeadas para Domosonica, y el enlace con el
    STM32 aterrizado sobre el pinout real del netlist (GPIO0/1↔U7.22/23, GPIOs libres
    GPIO4-7). Conclusión: el UART compartido alcanza; eficiencia = firmware (baud+F&F).
    - DS11_PLANNING §8.2: agregado gate de fabricación — verificar keepout de antena de U5
    (recorte del plano In1 GND bajo la antena) + hedge opcional de línea IRQ GPIO4→STM32.
    BLE-MIDI y ESP-NOW no requieren cambios de esquemático (firmware sobre radio ex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
2026-07-07 docs(esp32): línea IRQ GPIO4→PC13 verificada en netlist + aclarar que la inversa no hace falta
    PC13 = U7 pad 7, libre; VBAT@+3V3 (PC13 usable como GPIO); EXTI13 sin conflicto
    (ningún otro Px13 en uso). Como entrada/EXTI el drive limitado de PC13 no aplica.
    R serie ~220Ω para contención en boot asíncrono + pull interno para idle.
    Corrección honesta: el UART ya es interrupt-driven en ambos sentidos, así que la
    línea es solo hedge de timing sin jitter — NO hace falta línea inversa STM32→ESP32.
2026-07-08 docs(ds11): RN1-4 (arrays 62Ohm sin stock) -> 16 discretas 75Ohm
    Los arrays 4x0603 no están en stock. Cada RN es un array de 4 elementos aislados
    que amortigua las 4 líneas SAI (FS/SCK/SD/MCLK) de un DAC → mapea 1:1 a discretas.
    62→75Ohm OK en las 4 líneas (RC extra en MCLK ~0.75ns « 40.7ns período). Plus:
    menos riesgo de rotación y probable basic part. A cuidar: área en zona de DACs +
    skew de las 4 líneas por DAC. Anotado en §8.4 gates de fabricación.
2026-07-08 docs(ds12): abrir backlog de hardware — DS11 enviada a fabricar
    DS11 a fábrica (lote de 5). Registro de lo detectado tarde/pospuesto para DS12:
    - ALTA: buck sin margen a 24V (MP2315S abs max 26V < VBR SMBJ24A 26.7V < VC 38.9V,
    verificado con datasheet) → buck de mayor Vin o TVS más bajo. Tap VOUT + R 1k
    que no entró en el BOM final → reincorporar.
    - MEDIA: línea timing GPIO4→PC13, C45/C46 0201→0402, ferrites de salida (solo si
    full power; a bajo nivel OK), RN5/RN6 arrays→discretas.
    - Bring-up DS11: verificar AP2125=3.3V, derating 10uF.
    - Confirmado OK: D8 SMBJ24A unidireccional legítimo, sustituciones de BOM, rotations.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
2026-07-09 feat(uart): CMD_ESP_INFO — el ESP32 publica su IP y el STM32 la muestra en el heartbeat
    Evita tener que monitorear los dos puertos serie a la vez.
    - CMD_ESP_INFO (0x08), ESP32→STM32, payload = IP en ASCII. Deliberadamente SIN
    ACK: el push es no solicitado, y un ACK espurio le robaria el ack_sem a un
    comando HTTP concurrente que espera el suyo.
    - ESP32: mutex recursivo uart_tx_mutex que serializa las tramas hacia el STM32.
    Sin el, el push periodico del IP puede intercalarse con la transaccion
    comando→ACK de un handler HTTP y corromper ambas. uart_send_and_wait_ack()
    mantiene el lock durante toda la transaccion.
    - La IP se guarda en el handler de got-IP pero se envia desde el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
2026-07-10 docs: plan de generador de tono interno para validar direccionalidad TX en DS10
    El camino TX lee de beam_line (ADC); sin nada en las entradas los presets de foco
    steerean ruido. Generar la señal internamente desbloquea toda la validacion de
    direccionalidad sin micrófono en la placa.
    - Fisica: 2kHz es el punto dulce (mancha focal ±14cm vs ±27cm a 1kHz; d<=lambda/2
    hasta 2.14kHz, sin lobulos de rejilla a ningun angulo). A 1m estamos en campo
    cercano -> se mide mancha focal, no patron de campo lejano.
    - Diseño: escribir la fuente en beam_line -> la ruta TX no se toca (delays Q8,
    gains, signos siguen igual). Retardo temporal real, no offset de fase 1kHz-only.
    - TRAMPA: la ruta TX apl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
2026-07-10 feat(beam): generador de tono interno — modos 12/13 validan direccionalidad TX sin mic
    Fase A de docs/ds10_tone_beam_plan.md. El camino TX leia de beam_line (ADC);
    sin señal en las entradas los presets de foco steereaban ruido (-80dBFS).
    - Tone_NextSample(): acumulador de fase Q16 en indices de tabla sobre
    sine_table_1khz[48] (paso = f/1000), interpolacion lineal con intermedio
    int64, pico 2^22 = -6dBFS. Wrap con un solo subtract (f < 48kHz).
    - Process_ADC_Half(): rama tone_enabled escribe beam_line en las mismas
    posiciones/cadencia que el RX delay-and-sum -> la ruta TX (delays Q8,
    gains, signos, mutes) corre sin cambios y el retardo sigue siendo retardo
    temporal real a cualqui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
2026-07-10 feat(vol): control maestro de volumen via atenuacion del PCM1690 (POST /volume)
    master_gain no afecta el walker (escribe el buffer directo) y ademas puede quedar
    en silencio si el comando /command omite el array channels (gains->0). El atenuador
    del DAC es el control robusto: baja TODOS los modos por igual, resolucion 0.5dB.
    - CMD_SET_VOLUME (0x09), payload int8 dB (0..-63, <=-64 = mute). Se ACKea.
    - STM32: aplica en el main loop (no ISR — hay escritura I2C). ATDAx = 255 + db*2,
    a los 8 canales de los 4 DACs (los no poblados simplemente no ACKean el I2C).
    - ESP32: endpoint POST /volume {"db":-20} + slider de volumen maestro con boton
    Mute en la web UI embebida.
    - Valido: -20dB -> ATDA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
2026-07-11 feat(vol): persistir el volumen maestro en EEPROM
    El volumen ahora sobrevive reboots. beam_config_t (struct local, NO el del
    protocolo ESP32) suma int8 master_vol_db, que viaja con el guardado/carga +
    CRC ya existente. EEPROM_CFG_VERSION 1->2.
    - Helper Apply_Master_Volume(db) compartido entre el comando y el boot
    (ATDAx = 255 + db*2; verificado: -20dB->0xD7, -24->0xCF, mute->0x80,
    coinciden con los #define del header).
    - Default -24dB = el mismo que fuerza el init del PCM1690 -> first boot sin
    cambios de comportamiento.
    - Al boot, tras el init de DACs (que deja -24dB), se reaplica el valor
    persistido. Un EEPROM v1 previo falla el CRC por el tamaño nuevo -> usa
    defaults (seguro).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
    [eeprom_config.h, main.c]
2026-07-11 feat(mode): persistir el ultimo modo en EEPROM, restaurado al boot
    Para no tener que rebuscar el modo despues de cada reflasheo (la EEPROM es
    externa I2C, sobrevive al flash del STM32).
    - beam_config_t += last_mode; EEPROM_CFG_VERSION 2->3.
    - UI_ApplyState guarda el modo con DEBOUNCE de 3s (mode_save_due_tick): ciclar
    con K2 empuja el deadline, solo un modo asentado se escribe -> evita ~6
    underruns por toque y desgaste de EEPROM. El save real reusa el diferido.
    - Al boot se restaura el modo guardado, EXCEPTO AUTOFOCUS (dispararia un scan
    de chirps sin el mic puesto) -> cae a monitor y reescribe monitor.
    - El restore aplica idx == last_mode -> UI_ApplyState no re-arma el save (sin
    wr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
2026-07-11 docs: plan de mediciones DS10 + backlog (incl. review cruzada de bugs)
    - Protocolo de medicion para manana: mic FIJO + mover el foco (steer ON/OFF cancela
    el modo de sala en el punto), medir a 0.5-1m no 2m (foco mas fuerte cerca), 2kHz,
    espacio abierto/absorbente. Con 2 mics: entradas 1/2, el heartbeat ya imprime c0/c1.
    - Backlog priorizado (dither de frecuencia, unificar volumen en DAC, contraste
    automatico 2 mics, haz audible, resiliencia WiFi app, mDNS).
    - Bugs de review cruzada verificados contra el codigo: #1 UI_ApplyCustomBeam no maneja
    el tono (fix POR RAMA — preservar en type=tx, que es el path de medicion; apagar solo
    en type=rx); volumen sin debounce; ACK bloqueante en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
2026-07-11 feat(beam): dither de frecuencia (Fase B) + fixes de la review cruzada
    - Dither: triangulo +-5% a 3Hz sobre tone_base_hz en modos 12/13, actualizado
    por half-buffer (fase continua, sin clicks). Promedia los modos de sala sin
    tocar el haz (retardos puros) -> medicion estable en salas vivas.
    - UI_ApplyCustomBeam fix POR RAMA: type=rx apaga el tono y restaura el boost
    x32; type=tx lo preserva (protocolo de medicion mic-fijo/foco-movil).
    - Volumen unificado: master_gain digital eliminado del fill TX; /volume
    (atenuador PCM1690) es el unico maestro. gains[ch] y mute_global quedan.
    - Debounce EEPROM unificado (CFG_SAVE_DEBOUNCE_MS): modo, volumen y
    CMD_UPDATE_CFG coalescen en un save 3s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
    [eeprom_config.c, main.c]
2026-07-11 docs: manual de los 14 modos + backlog actualizado (items 1-2 y bugs 1-2 hechos)
2026-07-11 chore(build): renombrar TARGET ds9_beamforming -> ds10_beamforming
    Resabio de la migracion DS9->DS10: el firmware es 100% DS10 desde mayo
    pero el nombre del binario nunca se actualizo. Output ahora:
    firmware/build/ds10_beamforming.bin (flash targets usan $(TARGET), sin
    otros cambios).
2026-07-11 feat(ui): sincronizar web/protocolo con el fw nuevo — vol_db en telemetria, slider en vivo
    - Proto v2: ds_status_t += master_vol_db (54 bytes, ambos lados en lockstep).
    - /status expone vol_db; la UI inicializa el slider con el volumen real
    (antes arrancaba ciego en 0 dB) y lo muestra en la linea de estado.
    - Slider de volumen EN VIVO: throttle 200ms al arrastrar + valor final en
    change (habilitado por el debounce EEPROM del STM32). El poll no pisa el
    slider mientras se usa (ventana 3s).
    - Labels modos 12/13 -> "Tono 2k/1k dither"; master_gain marcado DEPRECADO
    en el parser de /command (el STM32 ya no lo aplica).
2026-07-11 chore(build): renombrar proyecto ESP32 ds9_beamform_c3 -> ds10_beamform_c3
    Mismo resabio DS9 que el Makefile del STM32. Output ahora:
    firmware_esp32c3/build/ds10_beamform_c3.bin
2026-07-12 feat(wifi): ciclar entre redes conocidas en vez de una sola (sin abandonar nunca)
    El instrumento viaja entre casas. Antes: una sola red fija, y si no conectaba
    en 10 intentos se rendia para siempre (ni background retry). Ahora:
    WIFI_NETWORKS[] en secrets.h (WIFI_SSID/PASS, WIFI_SSID_2/PASS_2, ...);
    al agotar MAX_RETRY=5 intentos de una red se pasa a la siguiente y se cicla
    indefinidamente en background sin bloquear el boot (wifi_init espera un
    tiempo acotado y sigue arrancando el HTTP server igual).
    Agregar una red nueva = sumar un par _N en secrets.h + una fila en
    WIFI_NETWORKS[]; nunca se pierde una red anterior.
2026-07-12 docs: guia de setup AUTOFOCUS con ECM8000 + Focusrite 2i2 (modo 11 revisado)
    Cadena de senal, config standalone de la 2i2 (phantom, direct monitor mono),
    gain staging contra adc_pk/OVF, procedimiento del scan y troubleshooting.
    Codigo del modo 11 revisado sin hallazgos; notas de comportamiento: el scan
    dispara al entrar al modo, delays medidos no persisten, polaridades si (hasta
    reboot).
2026-07-12 feat(beam): modo 14 MULTIFOCUS — N fuentes con tabla de delays focales propia
    Precuela de la intervencion de 8 entradas analogicas: infraestructura de
    foco POR FUENTE (mf_delay_q8[8][32] + Beam_UpdateMFocus) que despues
    alimentara el modo 8-in leyendo delay_line[src] en vez de tonos.
    Hoy: 4 tonos (1300/1600/1900/2100 Hz — multiplos de 100 para fase exacta
    entre bancos, sin relaciones armonicas, < 2140 Hz de grating) cada uno
    enfocado en su punto (fx -450/-150/+150/+450 @ 1m). Caminando la sala, un
    analizador espectral lee la posicion por cual frecuencia domina.
    - Delay como offset de fase precalculado (exacto para senos, cero costo
    64-bit por muestra); cada fuente a -6dBFS/4 -> suma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
2026-07-12 docs: resultados 2026-07-12 — beamforming TX validado en el aire
    Foco TX audible a 4m (sutil = esperado, N Fresnel 0.13) y MULTIFOCUS
    validado: caminando izq->der los 4 tonos aparecen de grave a agudo,
    coincidiendo con la geometria. Valida superposicion de tablas de foco,
    mapeo de canales y convencion de signos X.
2026-07-12 feat(beam): modo 15 MULTIFOCUS 8 entradas — la intervencion
    Cada entrada analogica del AK5538 (delay_line[src], ya capturadas siempre)
    se proyecta enfocada en su propio punto de la sala: 8 senales reales en 8
    lugares, simultaneamente. Mismas tablas mf_delay_q8 que el modo 14 (los
    tonos eran la precuela); delay temporal verdadero con interpolacion Q8
    sobre la linea, valido para senal arbitraria (voz, musica).
    - Focos default: entrada N en fx = -700+200N mm @ 1m, plano fila 1.
    - POST /beam type=mf con src 0-7 re-apunta una entrada en vivo; respeta el
    modo MULTIFOCUS activo (tonos o entradas).
    - Boost de entrada +12dB (mf_in_shift=2, nivel de linea); clamp pre-gain
    contra overflow de la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
2026-08-01 hardware: diseño DS11 completo + plots de fabricación
    Esquemáticos y PCB de la DS11 (placa recibida), libreria del AK5538VN,
    datasheet SMBJ24A y los 12 plots PNG 600dpi de las capas.
    [AK5538.kicad_sch, ALL_AMPS.kicad_sch, Amp_Bank.kicad_sch, DAC_PCM1690.kicad_sch, DS.kicad_pcb, DS.kicad_sch, DS_Power.kicad_sch, esp32-mini.kicad_sch]
2026-08-01 sitio: sección "Con el apoyo de" con logos de Mecenazgo, Balanz y cheLA
2026-08-01 chore: cierre del ciclo DS10 — notas, script de barrido de foco, manual epub
    sweep_focus.sh (barrido de foco por curl para validar direccionalidad de
    oido) y el manual de modos exportado a epub.
2026-08-01 feat(ds11): migrar firmware a la placa DS11 — 32 canales activos
    Primera placa con los 4 PCM1690 poblados. Cambios:
    - WALKER_NUM_CH 8 -> 32: el walker recorre el array completo (32 s/vuelta)
    y valida el mapa canal->parlante + cableado JSPK. CAL_NUM_CH lo sigue,
    asi que el AUTOFOCUS ahora escanea los 32 parlantes (~8 s).
    - Focos en Y a 0 (centro del array) en modos 12/13 y en los defaults de
    MULTIFOCUS: con las 4 filas pobladas la apertura vertical (480mm) tambien
    enfoca. El -240 de DS10 apuntaba al plano de la unica fila poblada.
    - ADC monitor: las 8 entradas se repiten en cada fila (entrada N en la
    columna N de las 4 filas) en vez de que ch8-31 repitieran la entrada 0.
    - Modo 1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
2026-08-03 fix(sai): arrancar los 4 bloques sin prints en el medio + medir sync y CPU
    Hallazgo de una review cruzada con Codex, verificado: SAI1_A y SAI2_A son
    masters ASINCRONOS entre si (comparten PLL3 -> misma frecuencia, no fase) y
    entre sus arranques habia un UART_Print de 41 chars = ~3.6 ms bloqueantes a
    115200. Ese offset inicial queda fijo para siempre.
    Consecuencia: rompe el invariante del fix de 2026-07-02 (procesar RX antes de
    los 4 fills para que compartan delay_write_pos). Con los bancos desfasados sus
    callbacks caen en pasadas distintas del main loop y toman wp que difieren
    hasta en 480 muestras -> offset acustico de hasta ~10 ms (3.4 m de camino)
    entre filas 0-1 y filas 2-3. En DS10 era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
    [main.c]
2026-08-03 docs: checklist de primer encendido DS11 + sincronismo entre bancos SAI
    - ds11_bringup_checklist.md: secuencia de bring-up de los 32 canales, pensada
    para usar frente a la placa. Alimentar a 19-20V (buck al limite), flashear
    ambos micros, verificar el log, y las pruebas ordenadas por valor
    diagnostico (walker primero: valida el mapeo que asume todo el steering).
    - manual_modos.md: documenta las lineas SYNC y CPU del heartbeat, y una
    seccion nueva sobre el sincronismo entre bancos SAI — por que los dos
    masters son asincronos, por que rompe el invariante del wp compartido, y la
    regla firme de arrancar los 4 bloques sin nada en el medio.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
2026-08-07 docs: errata DS11 — dos cortos de fabrica por gerbers sin refill de zonas
    Afecta a TODA la tirada. Causa raiz comun: los gerbers se plotearon con los
    rellenos de zona desactualizados, asi que los planos nunca abrieron clearance
    alrededor de objetos nuevos de DS11. El DRC con rellenos almacenados da
    0.0000 mm; con --refill-zones las violaciones desaparecen; el drill de
    produccion confirma que se fabrico. El diseno estaba bien, el ploteo no.
    - Falla #1: via de stitching GND en (136.815, 36.619) atravesando el plano de
    +3V3 en In2 -> +3V3 a GND = 0.3 ohm, placa muerta por cualquier camino de
    alimentacion. Invisible con lupa (capa interna). Se repara taladrando.
    - Falla #2: pistas de +5VA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
2026-08-07 feat(amps): control del banco de 32 PAM8302A por comando; arrancan apagados
    Tras el incidente del 2026-08-04 (reinicio al primer tono del walker: la
    telemetria mostro underruns reseteandose a 0 = loop de reboot), el pin SD
    (PD3) ya no se habilita solo al final del boot.
    - CMD_SET_AMPS (0x0A) + POST /amps {"on":true|false} + botones en la UI web.
    - Los amps arrancan APAGADOS: la placa llega a un estado estable e
    interrogable aunque haya un problema de alimentacion.
    - Valor diagnostico: con amps OFF corre todo el pipeline en silencio, lo que
    separa "es alimentacion" de "es otra cosa" sin ambiguedad.
    Contexto: buck MP2315S al limite + 660uF de bulk en vez de 880 tras remover
    C290 para rep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
    [main.c, uart_protocol.c, uart_protocol.h]
2026-08-13 perf(dsp): I-cache + delay_line en DTCM + -O2 — el modo 15 pasa a entrar en CPU
    El modo 15 (MULTIFOCUS 8 entradas, el fill mas caro: 8 fuentes x 32 salidas)
    perdia el 55% de los deadlines de fill y era inusable con los 32 canales.
    Causa raiz: ninguna de las dos caches del Cortex-M7 estaba habilitada. No habia
    un SCB_EnableICache() en todo el proyecto, asi que el core a 480 MHz buscaba
    cada instruccion desde flash con 4 wait states. Medido: 186 ciclos por muestra
    de salida para ~30 instrucciones de trabajo real.
    Tres cambios:
    - SCB_EnableICache() al entrar a main(). Sin riesgo de coherencia (el codigo no
    se automodifica) y sin timings dependientes: pcm1690.c usa solo HAL_Delay.
    El D-c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
2026-08-14 docs(perf): soak test de 19,6 h — numeros reales y correccion de la estimacion
    Log de UART7 tras 70511 s de operacion continua en modo 7.
    Lo importante es la estabilidad, no la velocidad:
    - Err: 0 a lo largo de 1156 ciclos de 60 s (19,3 h). Cero errores de SAI.
    - Temperatura estable en 38-40 C todo el soak.
    - SYNC bancos constante en 839 +/- 6 ciclos las 19 h (un solo outlier). No
    deriva con el tiempo ni con la temperatura.
    - RXdma=100/s y OVF=0 sostenidos; link al ESP32 vivo (155 KB de tramas).
    Numeros de performance, ahora medidos en vez de estimados:
    Fill avg 1493 us -> 668 us (2,23x)
    ciclos/muestra 186,7 -> 83,6
    CPU fills 59,2% -> 26,6%
    SYNC bancos 4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
2026-08-14 docs: reporte del ciclo DS11 (agosto) + cheatsheet actualizado a 32 canales
    Reporte consolidado del bring-up de la DS11, en la linea de reporte_2026-07.md:
    el mapa del ciclo con el registro de por que se decidio cada cosa, enlazando a
    los docs tecnicos en vez de repetirlos.
    Cubre: los dos cortos de fabrica y su causa raiz comun (gerbers ploteados sin
    refill de zonas), el falso corto de J7 pin 1, los reinicios que resultaron ser
    el limite de corriente de la fuente, el cierre de la duda del sincronismo entre
    bancos (4 us -> 1 us, estable), el hallazgo de que el M7 corria sin caches, y el
    soak de 19,6 h con Err: 0.
    Incluye una seccion de estado (validado vs pendiente) para poder retomar sin
    r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
2026-08-16 fix(audio): eliminar los pops — el print y la EEPROM ya no roban deadlines de fill
    Fernando escucho "un pedito cada vez que se imprime el serial" en el modo 12. Eso
    cierra el caso de los underruns residuales: no eran un contador feo, eran audio
    corrupto. Cada underrun es medio buffer reemitido en los 32 canales a la vez = un
    salto de fase de 10 ms, audible como un pop en un tono continuo.
    ds11_perf.md decia que la causa A "no es un problema del pipeline de audio". Era
    cierto sobre la causa y falso sobre la consecuencia.
    Tres bloqueos, todos por encima del deadline de 10 ms del fill:
    heartbeat (~238 chars @115200) ~20 ms -> +2/s
    bloque Fill/Jitter/Temp (cada 10 s) ~18 ms -> +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
    [eeprom_config.c, eeprom_config.h, main.c]
2026-08-17 docs: purga de documentacion + guia de operacion en lenguaje llano
    NUEVO: docs/guia_operacion.md — guia de uso y conexionado escrita para alguien
    que no es ingeniero de sonido ni electronico (un arquitecto va a operar el
    equipo). Cubre en lenguaje llano: que es el aparato y por que enfoca (analogia
    de la ola en la tribuna), las tres conexiones en orden, alimentacion con sus
    limites, el conexionado de los 32 parlantes con su polaridad, las entradas de
    audio por RJ45, encendido y control, la prueba de recorrido como validacion
    inicial, el flasheo de los dos micros, y una tabla de sintomas.
    Incluye dos trampas que no son obvias y que estaban solo en notas tecnicas:
    JSPK09/10 cruzados, y que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
2026-08-17 perf(adc): filtro short-delay del AK5538 — 292 us de latencia gratis
    Lectura dirigida del datasheet (015099878-E-02) buscando margen de optimizacion.
    HALLAZGO: el AK5538 tiene cuatro filtros de diezmado seleccionables y el group
    delay cambia 4x entre ellos. Estabamos en el default (Sharp roll-off) pagando
    19/fs = 396 us. El Short-delay sharp da 5/fs = 104 us con passband (22 kHz) y
    atenuacion de stopband (85 dB) IDENTICOS. Lo unico que se pierde es la fase
    lineal: la distorsion de group delay pasa de 0 a 2,8/fs.
    Esa distorsion NO afecta al beamforming: el filtro es el mismo en los 8 canales,
    o sea que su retardo es comun. El patron del haz lo fijan los delays RELATIVOS
    que aplica el STM3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
    [main.c]
2026-08-17 docs: presupuesto de potencia y latencia — lectura de MP2315S, PAM8302A y PCM1690
    NUEVO docs/presupuesto_potencia.md. Responde con numeros una pregunta que
    veniamos arrastrando: cuanta potencia hay para sonido y cuando se acaba.
    - El buck da 15,45 W (5,15 V x 3 A) para TODA la placa.
    - El consumo estatico se lleva ~4,2 W tipicos antes de que salga un sonido, y el
    mayor consumidor son los 4 PCM1690 con 2,23 W — mas que los 32 PAM8302A en
    reposo juntos (0,66 W).
    - Quedan ~11 W para audio = 0,29 W por canal sostenidos = -9,3 dB del maximo de
    cada PAM. A los volumenes de trabajo (-20 dB o menos) el consumo es un
    no-problema; solo se vuelve critico cerca de plena potencia.
    HALLAZGO: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
2026-08-17 docs(correccion): 12 V solo sirve en banco, no en daisy-chain
    Fernando senalo el problema con la recomendacion de bajar la entrada a 12 V: con
    distribucion en daisy-chain los cables tendrian que ser mucho mas gruesos. Tiene
    razon — el analisis anterior miro el buck en aislamiento e ignoro la arquitectura
    del sistema.
    A igual potencia la corriente escala inverso a la tension y las perdidas de cable
    van con I^2R. Cadena de 4 placas a plena carga sobre 10 m de 1,5 mm2 (0,23 ohm):
    20 V -> 3,4 A -> 0,79 V de caida (4%) -> 2,7 W perdidos en el cable
    12 V -> 5,7 A -> 1,33 V de caida (11%) -> 7,6 W perdidos en el cable
    El buck ahorra ~0,3-0,6 W por placa al bajar de 19 a 12 V, o sea 1,2-2,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
2026-08-17 fix(audio): SendStatus y el volumen dejan de robar deadlines — buffer destrabado
    Prerrequisitos para bajar el buffer de 480 a 240 muestras. Al auditar todo lo que
    bloquea el main loop aparecieron DOS operaciones que no entraban, no una.
    UART_Protocol_SendStatus: ~60 bytes = ~5,2 ms a 115200. Entra bajo el deadline de
    10 ms actual, no bajo uno de 5 ms. Ahora manda byte a byte sirviendo los fills via
    un hook __weak UART_Protocol_Yield() que main.c redefine.
    Apply_Master_Volume: HALLAZGO NO PREVISTO. Hace 32 escrituras I2C (4 DACs x 8
    canales) a 100 kHz, ~300 us cada una = ~9,6 ms. Estaba JUSTO en el borde del
    deadline actual, o sea que cada cambio de volumen ya venia metiendo un pop en los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
    [main.c, uart_protocol.c, uart_protocol.h]
2026-08-17 feat(boot): verificar la revision de silicio — VOS0/480MHz no existe en rev Y/W
    Fernando actualizo el datasheet del H743 a Rev 11 (ene-2026, veniamos de 2023).
    Revisando que cambio se llego a algo mas importante en la errata ES0392, que
    nunca habiamos mirado — y acabamos de habilitar el I-cache sin revisarla.
    ES0392 §2.2.21: "VOS0 voltage scaling level is not available on silicon revision
    Y and W devices. This limits the maximum CPU frequency to 400 MHz." El workaround
    es usar silicio revision V o X. Estado: P (workaround parcial) en TODAS las
    revisiones.
    Este firmware configura VOS0 + 480 MHz. Sobre un chip revision Y o W eso queda
    fuera de especificacion: la escritura de VOS0 no tom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
    [main.c]
2026-08-17 docs(hw): revision cruzada netlist+datasheets — 4 hallazgos P0 para DS12
    Revision cruzada del netlist contra los datasheets. Todo lo de alimentacion esta
    VERIFICADO contra hardware/DS/DS.txt y el BOM de produccion, no inferido.
    CORRECCION DE DATO: el bulk de +5VA son CINCO electroliticos de 220 uF, no cuatro
    — ademas de C290-C293 esta C71 (mismo part number C25503905 en el BOM). Eran
    1100 uF y tras remover C290 quedan 880, no 660. ds11_errata.md tambien lo dice mal.
    HALLAZGOS NUEVOS:
    A. Los amplificadores estan limitados termicamente ANTES que el buck. El
    encapsulado es MSOP-8 (verificado en el netlist) → theta-JA = 180 C/W. Con OTP a
    120 C y 40 C de ambiente cada PAM8302A puede dis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
2026-08-17 docs(perf): AN4891 saca el D-cache del roadmap y pone MDMA en su lugar
    Lectura de AN4891 (arquitectura y performance del H7). Corrige una recomendacion
    mia y abre otra mejor.
    CORRECCION: veniamos diciendo que el D-cache era "el otro factor 2-3 que queda
    sobre la mesa". Es falso. AN4891 §5.2 es explicito: habilitar la cache mejora
    todos los accesos EXCEPTO las TCM-RAM, donde no tiene efecto. Y desde que movimos
    delay_line a DTCM, los dos arrays calientes del pipeline (delay_line y beam_line)
    ya viven ahi — o sea que el D-cache no tocaria ni una lectura del lazo interno.
    Lo unico que quedaria por ganar son las escrituras a audio_buffer* en RAM_D2, que
    son justo los buffers que toca el DMA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
2026-08-17 feat(amps,term): desenclavar el UVLO de los PAM + aviso termico a 85 C
    Dos cambios seguros salidos de leer AN5312, AN5036 y el datasheet del PAM8302A.
    Ninguno toca el camino de audio.
    1) 'amps on' ahora SIEMPRE pulsa SD 0->1, aunque ya estuviera encendido.
    El PAM8302A tiene un UVLO ENCLAVADO: del datasheet, 'when the supply voltage drops
    to 2.1 V or below, the PAM8302A goes into a state of shutdown, and the device comes
    out of its shutdown state by reset the power supply or SD pin'. O sea que tras
    cualquier hundimiento del +5VA los amps que hayan cruzado 2,1 V quedan mudos aunque
    SD siga alto — y como SD ya estaba en 1, un 'amps on' no los recuperaba.
    El sintoma seria 'se me murieron al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
    [main.c]
2026-08-18 docs: -O2 APROBADO + la saturacion no era del ADC
    HITO: primera vez que el test de 60 s da '>>> TEST PASSED: DMA pipeline clean!' con
    Total Underruns: 0. Modos 1, 12, 0 y 14 verificados a oido — sin crujidos, sin ruido
    de fondo, sin pops. Las 8 entradas analogicas capturando. El -O2 queda validado y no
    aparecieron bugs latentes de volatile.
    El arreglo del pop del volumen quedo ademas MEDIDO: 6 cambios de volumen + un
    guardado de EEPROM + un pulso de amps, todo con underruns = 0. Antes cada cambio
    costaba ~9,6 ms de bloqueo, o sea al menos un deadline perdido.
    CORRECCION DE DIAGNOSTICO: Fernando reporto que con la Mac por encima del ~20% de
    volumen 'satura', y planteo estudiar la entrada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
2026-08-18 docs(datasheets): AN4891/5036/5312/5612/1709, errata ESP32-C3 y H743 datasheet Rev 11
    Rev 11 (ene-2026) del datasheet del H743, que reemplaza la de 2023. De ahi salieron
    Table 113 (a VOS0 la T_J maxima es 105 C, no 125) y Table 114 (VCAP 2,2 uF, que la
    placa cumple).
    Errata del ESP32-C3: sus dos unicas entradas son del SAR ADC con DMA, que no usamos.
    No nos aplica ninguna.
    Application notes, en orden de lo que aportaron:
    - AN4891: saco el D-cache del roadmap (no cachea la TCM, donde ya vive delay_line) y
    puso MDMA en su lugar. Ademas valido la mudanza a DTCM por determinismo, no por
    velocidad promedio.
    - AN1709: el PVD del STM32 avisa ~200 mV antes del reset, pero en DS11 es inalcanzab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
2026-08-18 feat(diag): medicion de nivel sticky — separa saturacion del ADC de la de salida
    Fernando reporta que el audio sigue saturando a ~30% de nivel de la Mac. Mi
    conclusion anterior ('al ADC le sobran 45 dB, es el boost del modo 0') se apoyaba
    en una medicion pobre y hay que tratarla como no demostrada.
    EL PROBLEMA DE LA MEDICION: ADCpk se calculaba en el heartbeat sobre UNA ventana de
    10 ms, y OVF se leia como nivel instantaneo del pin — ambos una vez por segundo, o
    sea muestreando el 1% del tiempo. Los picos musicales pasan entre medicion y
    medicion. Con ese muestreo no se puede afirmar que el ADC no satura.
    AHORA:
    - El peak-hold se acumula en Process_ADC_Half, que corre 100 veces por seg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
    [main.c]
2026-08-18 perf(latencia): buffer de 480 a 240 muestras — latencia total -44%
    El buffer dominaba la latencia: de los 11,4 ms del pipeline, 10 eran esto. A 240
    muestras el medio buffer pasa a 5 ms y el total a ~6,4 ms.
    El precio es que el deadline de fill pasa de 10 ms a 5 ms. Por eso este cambio
    estuvo bloqueado hasta ahora: habia CUATRO operaciones que bloqueaban mas que eso
    —los prints del heartbeat (20 ms), el guardado en EEPROM (12 ms), SendStatus
    (5,2 ms) y cada cambio de volumen (9,6 ms de escrituras I2C)— y cualquiera habria
    producido pops. Las cuatro se hicieron cooperativas primero y se verificaron con 0
    underruns; recien entonces se toco la constante.
    Verificado en hardware tras flash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
2026-08-18 feat(nivel): ganancia de ENTRADA ajustable — la estructura de ganancia estaba al reves
    DIAGNOSTICO CERRADO. La medicion sticky dio la respuesta sin ambiguedad:
    >>> SATURACION: ADC(OVF)=0 SALIDA(clip)=3152 <<<
    El ADC no satura. Satura la SALIDA digital, 3152 veces por segundo. No son los
    parlantes ni nada mecanico — Fernando dudo de esa hipotesis y tenia razon.
    LA CAUSA es que la estructura de ganancia estaba invertida: el modo 0 amplificaba
    +30 dB (para poder oir un microfono) y despues el atenuador del PCM1690 tiraba
    -40 dB. Amplificar 30 para tirar 40, con el clamp digital justo en el medio. Con
    ADCpk=448804 (-25 dBFS) el x32 lo lleva a +4,6 dBFS: se pasa del fondo de escala y
    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
2026-08-18 feat(nivel): la ganancia de entrada se persiste y gobierna TODA la cadena del ADC
    Verificado en hardware: con /ingain 0 la fuente sube al 100% sin recortar
    (antes rompia al 30%). Pero habia que mandar el comando despues de CADA boot,
    y los modos 2-6 seguian con el +30 dB hardcodeado.
    Dos cambios sobre d083c47:
    1. PERSISTENTE. in_gain_db entra a beam_config_t -> EEPROM v4, junto al volumen
    y al modo. Deja de ser un default por modo: la ganancia que hace falta
    depende de QUE ESTA ENCHUFADO, no del modo de beamforming activo. Cambiar de
    modo ya no la pisa. Se configura una vez por instalacion.
    El default de fabrica pasa a 0 dB (linea), no +30. Las entradas de la DS11
    son de li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
2026-08-18 feat(operabilidad): mDNS, K2 largo para los amps y saturacion en la telemetria
    Tres cosas que hacen al equipo usable por alguien que no tiene una terminal al
    lado. Todo verificado en hardware con las dos placas flasheadas.
    mDNS — http://domosonica.local
    El DHCP cambia la IP sin avisar, y averiguarla obligaba a abrir el monitor
    serie del STM32 (linea "ESP:"): un cable y una terminal antes de poder mandar
    un solo comando. Resuelto: dns-sd devuelve 192.168.100.64 y /status responde
    por el nombre. mdns_init() NO va con ESP_ERROR_CHECK — si falla, la placa
    tiene que seguir andando por IP; es comodidad, no requisito.
    K2 con pulsacion larga = toggle de amps
    Los amps arrancan apaga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
2026-08-18 feat(ui): pad de MULTIFOCUS — colocar las 8 entradas arrastrando
    El modo 15 es el objetivo artistico del instrumento (8 entradas, cada una
    colocada en un punto del espacio) y hasta ahora solo se manejaba con un curl por
    fuente. Era el hueco mas grande entre lo que el firmware sabe hacer y lo que se
    puede pedir.
    Vista en planta en SVG: X horizontal, Z (distancia al array) en vertical, el
    array dibujado abajo. 8 puntos arrastrables numerados + slider de altura (fy)
    para el seleccionado. Los defaults espejan MFocusIn_ApplyDefaults() del STM32.
    Throttle de 150 ms durante el arrastre: cada POST espera el ACK del STM32 por
    UART a 115200, asi que sin eso se encola y la UI se traba.
    Verificado: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
2026-08-18 fix(modo 14): tabla de senos a DTCM y fase entre bancos — dos bugs del buffer 240
    El buffer de 480 a 240 se valido en modo 0 y se dio por bueno. No alcanzaba: el
    modo 0 es el mas barato de todos. Probando modo por modo, el 14 estaba roto de
    dos maneras distintas. Los dos bugs son de la misma familia — el buffer no es
    solo un numero de latencia, es el periodo que aparece en varios invariantes.
    1. sine_table_1khz estaba en FLASH
    Sintoma: en modo 14 /status daba timeout y se acumulaban 1234 underruns en
    20 s (~15% de los deadlines). El modo 15 —que es MAS pesado, 8 fuentes contra
    4— no perdia ninguno. Que ande el pesado y no el liviano descarta el
    presupuesto de CPU: la dif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
    [main.c]
2026-08-18 fix: mf_frame al reloj comun, reset de fabrica, y el pad ya no secuestra el modo
    Reportado: modos 12, 13 y 14 con pops, el 14 el peor, y "los modos TX toman
    señal del ADC y se comportan como RX". Medido primero: clip=0, underruns=0 en
    los tres. O sea que no era ni recorte ni deadline perdido — eran
    discontinuidades de contenido. Tres causas distintas.
    1. mf_frame lo avanzaba un banco de TX
    Ya lo habia movido del primer banco al ultimo para arreglar la contrafase,
    pero eso solo cambiaba de banco privilegiado y dejaba en pie el segundo
    problema: si ESE banco no se llenaba en una pasada, la fase no avanzaba y el
    tono repetia la ventana — un pop.
    El reloj del pipeline es Pr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
    [main.c, uart_protocol.c, uart_protocol.h]
2026-08-18 feat(modos 7-10): tono interno de 1k en vez del ADC + numero en los botones
    Reportado: "los modos TX centro/izq/der siguen reproduciendo la señal del ADC;
    deberia producirse el tono de 1kHz con el steering indicado". El firmware hacia
    lo que estaba diseñado, pero el diseño asumia algo que la DS11 no tiene.
    Los modos 7-10 tomaban como fuente el RX beam, o sea los MICROFONOS. La DS11 no
    tiene: J9 son entradas de LINEA sin bias. Con eso, esos cuatro modos
    reproducian lo que hubiera enchufado en el ADC y no se distinguian del modo 0
    salvo por el retardo — que es exactamente el sintoma reportado.
    Escuchar la entrada ya lo hacen los modos 2-6 (beam RX) y, mucho mejor, el 15
    (cada entrada en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
2026-08-18 feat(proto v4): estado real en telemetria + config de los 32 canales
    Dos huecos que se validan por telemetria, sin oido.
    1. LA UI MENTIA SOBRE EL ESTADO
    POST /beam cambia lo que suena sin tocar ui_state_idx — a proposito, para que
    el proximo K2 retome el ciclo desde el ultimo preset. La consecuencia es que
    la pagina puede mostrar "modo 13" mientras la placa hace otra cosa: hoy costo
    una sesion entera de debug. Y el estado de los amps era memoria del ultimo
    boton apretado, que se vuelve falsa con un reboot o con el K2 largo.
    ds_status_t += state_flags (bit0 amps, bit1 custom). La pagina ahora muestra
    ON/OFF real de los amps y un aviso naranja cuando el modo marcado no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
    [main.c, uart_protocol.c, uart_protocol.h]
2026-08-18 fix: el resumen de 60 s tiraba fills pendientes + telemetria que mentia
    Encontrado probando por telemetria, sin escuchar, y explica un sintoma viejo.
    1. UN POP POR MINUTO
    El bloque que imprime el resumen cada 60 s ponia en cero, junto con las
    estadisticas, las DIEZ banderas need_fill_* / rx_3b_*_ready. Eso no es
    resetear una estadistica: es TIRAR TRABAJO PENDIENTE. Una bandera puesta
    significa "este medio buffer todavia no se lleno"; borrarla sin llenarlo deja
    que el DMA reproduzca el contenido anterior — medio buffer repetido en los 32
    canales, o sea un pop, una vez por minuto.
    Encaja con el "pedito cada vez que se imprime el serial" que se venia
    reportando: los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
    [main.c, uart_protocol.h]
2026-08-18 docs(proto): comentarios de tamaño que quedaron en 52/16 canales
2026-08-19 fix: tres carreras encontradas auditando concurrencia ISR/main loop
    Auditoria motivada por el -O2: lo clasico que destapa subir el nivel de
    optimizacion es estado compartido mal declarado.
    Lo que estaba BIEN: las 28 variables que escriben las callbacks del SAI y las 6
    del parser del UART son todas volatile. La disciplina del pipeline diferido esta
    bien sostenida. Y las prioridades son correctas — DMA de audio en 0, UART4 en 1,
    asi que el ACK del ISR no puede retrasar una callback de audio.
    Aparecieron tres carreras estructurales, ninguna detectable por el compilador.
    1. DOS ESCRITORES SOBRE EL MISMO UART
    SendStatus escribe la trama en TDR byte a byte DESDE EL MAIN LOOP, sirviendo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
    [eeprom_config.c, eeprom_config.h, main.c, uart_protocol.c, uart_protocol.h]
2026-08-19 perf(modo 15): estaba al tope del presupuesto, y no habia forma de verlo
    El % de CPU del pipeline solo salia por el puerto serie, asi que diagnosticar
    "este modo no entra" pedia un cable enchufado. Proto v6 lo publica en /status
    (cpu_fills_pct). Con eso el diagnostico paso de conjetura a medicion.
    EL HALLAZGO
    Con el modo 15 activo /status NO CONTESTABA y se acumulaban ~25-55 underruns
    por segundo; los demas modos daban 0. Al exponer el %: modo 0 = 4,9%,
    modo 12 = 25,2%, modo 14 = 56,8%, modo 15 = al tope.
    Causa: cuando la ganancia de entrada paso a ser ajustable, el << mf_in_shift
    del lazo interno se reemplazo por Apply_In_Gain(), que es una multiplicacion
    de 64 bits sobre una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
2026-08-19 docs(checklist): presupuesto de CPU esperado por modo, para la sesion de escucha
2026-08-19 fix(modos 7-10): 2 kHz en vez de 1 kHz — a 1 kHz el array casi no puede enfocar
    Reportado tras escucharlos: "los modos 8 y 9 hacen lo mismo que el 13". El
    firmware aplicaba los focos correctos (verificado por telemetria: -500, 0, +500),
    asi que no era un bug de steering. Era la frecuencia, y la elegi yo.
    La apertura en X son 600 mm (8 columnas x 80 mm + 40 del patron ladrillo):
    1 kHz -> lambda 343 mm -> apertura 1,75 lambda -> spot @1m = +-286 mm
    2 kHz -> lambda 172 mm -> apertura 3,50 lambda -> spot @1m = +-143 mm
    A 1 kHz los focos de izquierda y derecha, separados 1 m, se solapan tanto que
    desde el centro suenan identicos. A 2 kHz el spot es la mitad. El techo es
    2144 Hz (c/2d, lo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
    [main.c]
2026-08-19 docs(modos 7-10): por que 2 kHz, y el A/B desde un punto fijo
    Estos modos NO se distinguen por el timbre —es el mismo tono— y escucharlos
    parado en el centro no prueba nada: es justo donde los dos focos suenan igual.
2026-08-19 fix(nombres): los modos de tono no son tonos puros — "ondulante", no "tono 2k"
    Reportado escuchandolos: los modos 7-10 producen un tono con oscilaciones de
    ~1 Hz percibido, no un tono puro, y el nombre "TX tono 2k ..." confundia.
    Medido: la frecuencia hace un triangulo de +-5% a 3 Hz (a 2 kHz, entre 1900 y
    2100 Hz). Es el dither, y aplica a todos los modos con tono interno.
    Se conserva la ACUSTICA y se corrige la DESCRIPCION, que es lo pedido — y ademas
    es lo correcto por una razon concreta: un tono PURO en una sala arma ondas
    estacionarias con nodos fijos en el espacio, asi que caminando se escucharia el
    patron de la SALA en vez del foco del beam. El dither los emborrona. La
    verificac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
    [main.c]
2026-08-19 docs(perf): encabezado de estado actual + indice; el doc paso de bitacora a referencia
    770 lineas de bitacora acumulativa sin forma de ver el estado en un golpe de
    vista. Ahora arranca con la tabla de numeros vigentes (buffer, fill, jitter, CPU
    por modo, que se valido a oido, que queda pendiente), como leerlos por HTTP sin
    cable, y un indice de las 10 secciones. El registro historico queda intacto.
    De paso, la seccion del buffer de 240 estaba marcada como 'pendiente' y se hizo
    hace dos dias.
2026-08-19 feat(modo 16): BARRIDO + el modo 7 pasa a foco lejano; y por que no hay eje vertical
    MODO 16 — BARRIDO
    El foco recorre solo la sala, +-700 mm en un ciclo de 5 s. Los presets 8/9
    prueban el steering pero exigen pararse en un punto descentrado y comparar dos
    modos de memoria; aca no hace falta nada de eso: parado donde sea, el nivel sube
    cuando el foco pasa por vos y baja cuando se va. Es la demostracion que se
    entiende sin explicacion previa.
    Se reapunta 20 veces por segundo desde el main loop. El paso de foco por
    actualizacion son ~14 mm = 0,04 muestras de delay, asi que no hay salto audible.
    Usa Beam_SetTxFocus(), version silenciosa nueva: la que imprime la tabla de
    delays por fila era i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
2026-08-19 chore(claude): permisos por proyecto — build, flasheo y consultas a la placa sin preguntar
    Reglas de prefijo para lo que se usa todo el tiempo acá: make, idf.py, st-flash,
    las herramientas arm-none-eabi, curl contra domosonica.local, git y los filtros
    de texto. Deliberadamente NO incluye borrado (rm, git clean) ni nada que publique
    hacia afuera: eso conviene que siga preguntando.
2026-08-20 feat(modo 17): barrido VERTICAL a 800 Hz + el AUTOFOCUS se corre desde la web
    BARRIDO VERTICAL (modo 17) — no es "el 16 pero en Y", es un experimento, y
    la frecuencia ES el experimento. El eje vertical no se percibe porque las filas
    estan a 160 mm = 0,93 lambda a 2 kHz, sobre el limite de muestreo espacial
    lambda/2. A 800 Hz son 0,37 lambda: sin lobulos de rejilla en todo el rango.
    Si ahi se percibe movimiento vertical, el limitante era el aliasing y bajar el
    pitch de filas en DS12 se justifica; si tampoco, el limitante son las 4 filas
    y hay que agregar filas. Las dos respuestas deciden gasto de hardware.
    AUTOFOCUS: el fallo era indistinguible del exito. Sin microfono o con los amps
    apaga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
2026-08-20 fix: el umbral de calidad del AUTOFOCUS era el valor del ruido, y el pad cambiaba el modo solo
    AUTOFOCUS — "4/32 utiles" sin microfono, y 7/32 la vez siguiente. No era
    casual: era la MEDIANA de la distribucion del ruido. cal_quality es peak/avg*10
    de la correlacion; sobre ruido blanco |c| es media-normal, con promedio
    sigma*sqrt(2/pi)=0,798 sigma y maximo sobre N=4320 lags de sigma*sqrt(2 ln N)=
    4,09 sigma. Cociente 5,13 -> q10 ~= 51, contra un umbral de 50. Cada canal era
    una moneda al aire. Un cociente SIEMPRE encuentra un maximo: en cualquier
    ventana de ruido hay un lag que sobresale.
    - CAL_Q_MIN 50 -> 100 (exige ~8 sigma, p ~ 5e-12 sobre 4320 lags; una
    deteccion real tiene ganan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
    [main.c]
2026-08-20 feat(modo 18): la calibracion del AUTOFOCUS sobrevive al reinicio (EEPROM v5)
    El scan medía bien y el resultado SE EVAPORABA: los retardos se pisaban al
    cambiar de modo y las polaridades no pasaban el reinicio. O sea que había que
    rehacer la calibración, con el micrófono en su lugar, en cada encendido —
    exactamente lo que no se le puede pedir a una instalación.
    Es viable porque el SYNC entre bancos mide 4 us y es REPRODUCIBLE arranque tras
    arranque (medido 2026-08-13). Ese era el "no se puede" que ya no aplica.
    La clave del diseño es que se guardan DOS cosas distintas y se usan distinto:
    - cal_sign -> propiedad del HARDWARE (cableado/polaridad del parlante).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
2026-08-20 docs(guia): MULTIFOCUS, AUTOFOCUS y reset — lo que faltaba para poder operarlo
    La guia estaba escrita para alguien que conecta y enciende, y no decia nada de
    las tres cosas que hacen falta para USAR el equipo: el mapa de MULTIFOCUS (que
    es para lo que se hizo el aparato), la calibracion con microfono, y como volver
    a cero cuando quedo en un estado raro.
    Ademas:
    - 16 modos -> 19, con una tabla de 'cual usar para que' (en la practica se
    usan cinco; el resto son pruebas).
    - La trampa que mas confunde, dicha explicitamente: los modos 7-14, 16 y 17
    generan su propio tono e IGNORAN lo que entra por los cables. 'Conecte
    audio y no se escucha' casi siempre es eso.
    - Una segunda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
2026-08-20 docs(pdf): generador de la guia de operacion en PDF
    pandoc (markdown -> HTML) + Chrome headless (HTML -> PDF), con portada, indice
    y una hoja de estilo pensada para imprimir: cada seccion arranca en pagina
    propia, las tablas no se parten al medio y los avisos llevan barra y fondo para
    que salten a la vista hojeando el papel.
    Chrome y no LaTeX a proposito: la guia usa ⚠️ ✅ 💡 para marcar lo que puede
    romper el equipo, y LaTeX no los dibuja. En una guia de operacion el simbolo de
    peligro importa mas que el numero de pagina que LaTeX daria gratis.
    Dos detalles que costaron una vuelta cada uno:
    - Con plantilla propia, $toc$ trae la <ul> pelada: el <nav id=TOC> que pone
    la plantil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
2026-08-21 docs: J13 y los 6 test points de la DS11 no existen electricamente
    Fernando pregunto si se podia cerrar un lazo salida->entrada por J13 para medir
    fase y nivel. La idea es muy buena; J13 no sirve.
    En el esquematico J13 SI esta cableado a VD.P1/VD.N1 — la salida diferencial
    del DAC antes del amplificador, que es exactamente la senal que uno querria
    medir. En el PCB no llego nada de eso:
    attr: through_hole exclude_from_pos_files exclude_from_bom dnp
    pad 1: SIN RED pad 2: SIN RED
    y ninguna pista de cobre termina a menos de 0,6 mm de sus pads. Lo mismo TP1 a
    TP6: los siete footprints de debug estan DNP y sin red. La DS11 no tiene un solo
    punto donde pinchar una senal.
    Mapeando la ca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
2026-08-21 feat(modo 19): LOOPBACK electrico — medir el equipo en vez de la sala
    Emite un chirp por un canal de CADA banco a la vez y mide lo que vuelve por el
    ADC a traves de adaptadores pasivos (docs/loopback_debug.md). Informa por serie
    cada 2 s: retardo absoluto, skew entre bancos en decimas de us, polaridad,
    calidad y pico.
    Para que existe: medir el SYNC ENTRE BANCOS DEL LADO ANALOGICO. El numero de
    4 us que publica el heartbeat sale de comparar marcas de DWT->CYCCNT en los
    callbacks de DMA — mide cuando se entera el SOFTWARE, no cuando sale la senal.
    SAI1_A y SAI2_A son masters asincronos entre si y su offset queda fijo al
    arrancar los streams: es un dato de hardware que nunca se verifico po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
2026-08-21 docs: correccion — J13 SI tiene cobre, va al DAC del canal 24
    Fernando corrigio que el conector existe en la placa (sin poblar). Al rehacer el
    analisis aparecio MI error: el primer barrido de cobre usaba una regex que exigia
    capa y red en un orden fijo dentro de cada (segment ...) y se salteaba los que no
    matcheaban ese formato. Un rebarrido exhaustivo —vias incluidas, recorriendo la
    isla de cobre nodo por nodo— encontro 16 segmentos que el primero no vio.
    Lo que hay realmente:
    pad 1 -> 16 segmentos en F.Cu -> R82 (1k, SMD, POBLADA) -> VOUT1+/- de U4
    pad 2 -> sin cobre
    U4 es DAC3 = canales 24-31 (SAI2_B), asi que VOUT1 es el canal 24. O sea que
    J13 pin 1 es una toma de la salida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
2026-08-21 docs(guia): modos 18 y 19 en la tabla de 'cual usar para que'
2026-08-23 feat(loopback): medir las OCHO entradas, no cuatro
    La primera version capturaba las entradas 0-3 asumiendo que cada sonda iba a su
    indice. Eso obliga a cablear de una forma concreta y a acertarle — y el primer
    cable real (J13 -> entrada 4) ya no encajaba. Midiendo las ocho, el firmware
    DESCUBRE donde entro la senal en vez de exigir que se lo declaren: se conecta
    donde sea y el informe dice que entrada la vio, con su retardo y polaridad.
    La referencia del skew pasa a ser la primera entrada CON senal, no la 0: con un
    solo cable en la entrada 4, anclar en la 0 dejaria todo sin referencia.
    Las capturas pasan a int16: ocho canales x 2400 muestras en 32 bits serian
    76,8 kB y no hay tanto DTCM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
2026-08-23 feat(ota): actualizar el firmware del STM32 por WiFi, sin tocar option bytes
    Bootloader propio en el sector 0 del banco 1 (0x08000000, 10 kB) + la
    aplicacion desplazada a 0x08020000 + staging en el banco 2 entero.
    Por que este camino y no otro:
    - el bootloader ROM de ST necesita mover BOOT0 y NRST, y en la DS11
    ninguno de los dos llega al ESP32 (solo botones y el header del ST-Link);
    - SWAP_BANK funciona pero es un OPTION BYTE, la unica parte de este chip
    donde un error puede volverse irreversible. Aca no se escribe ni uno.
    Las cuatro garantias:
    1. la aplicacion SOLO sabe escribir el banco 2 (stage_range_ok, banco
    constante) — no puede alcanzar el firmware que esta corriendo;
    2. l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
    [boot_main.c, fw_version.c, main.c, ota.c, ota.h, uart_protocol.c, uart_protocol.h]
2026-08-23 fix(ota): el ESP32 se abrazaba a si mismo y leia el UART a 100 ms por respuesta
    Las tres primeras cargas murieron en un tramo distinto cada vez (51, 55,
    33) con 'el STM32 dejo de contestar'. El STM32 no tenia la culpa: con
    contadores temporales dio tx_fail=0, busy_nack=0, ack_sent congelado y
    el contador de bytes RX dejando de subir. No es que no contestara — es
    que dejaban de llegarle tramos.
    Dos problemas del ESP32, los dos invisibles hasta que existio el OTA:
    1. ABRAZO MORTAL. stm32_monitor_task es el UNICO que lee el UART, o sea
    el unico que puede ver un ACK. Cada 10 s publicaba su IP tomando el
    lock de TX con espera infinita — pero uart_send_and_wait_ack retiene
    ese lock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
    [main.c]
2026-08-23 feat(ota): el ESP32 tambien se actualiza por WiFi, y la pagina dice cual falta
    Completa lo del STM32. El protocolo lleva numero de version, asi que
    cualquier cambio que lo toque seguia necesitando el cable para el ESP32
    — o sea que el OTA del STM32 solo servia para cambios que no cruzan el
    enlace.
    Mucho menos trabajo que el del STM32: ESP-IDF ya trae OTA nativo, su
    bootloader de segunda etapa elige entre dos ranuras segun la particion
    otadata y esp_ota_* escribe la que no se esta ejecutando. No hubo que
    escribir ningun bootloader.
    HALLAZGO: el modulo SIEMPRE tuvo 4 MB de flash y estaba configurado como
    si tuviera 2. La mitad estaba sin usar y era invisible para el sistema.
    Con 4 MB entra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
    [partitions.csv]
2026-08-24 feat(health): autodiagnostico — preguntarle a los chips en vez de mirar contadores
    GET /health hace que el STM32 vuelva a LEER POR I2C lo que los cuatro
    PCM1690, el AK5538VN y la EEPROM realmente tienen adentro, y arma un
    veredicto por cada cosa con el numero atras.
    Por que no alcanzaba con /status: es telemetria PASIVA. Un PCM1690 al
    que se le fue el registro de formato deja de decodificar el TDM8 y saca
    ruido o silencio — y sin embargo underruns sigue en cero, el CPU sigue
    igual y el status entero se ve perfecto. Ningun contador ve eso; hay que
    ir a preguntarle al chip.
    Se devuelven los VALORES leidos, no solo un veredicto: un rojo que no se
    puede discutir es un rojo en el que no se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
2026-08-24 feat(captura): bajar las muestras crudas del ADC y analizarlas afuera
    GET /capture?n=N devuelve las OCHO entradas tal como las ve el ADC, y
    tools/captura.py las convierte en un .wav de 8 canales mas nivel por
    entrada, frecuencia dominante y retardo entre canales por correlacion
    cruzada (en muestras, us y mm de camino acustico).
    Hasta ahora medir era mirar numeros por el cable serie. El modo 19 hace
    una medicion completa y devuelve UN pico y UN retardo; todo lo demas se
    calculaba adentro del STM32 y se tiraba. Con las muestras afuera, la
    placa deja de tener que saber de antemano que se le va a preguntar.
    El buffer (256 kB) vive en la AXI SRAM, que estaba ENTERA sin usar: el
    firmware vivia e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
2026-08-25 feat(esp32): cada placa se llama distinto, derivado de su MAC
    device_id y el hostname mDNS eran constantes de compilacion: "DS_01" y
    "domosonica". Con una placa no molestaba. Con las dos encendidas, las dos
    se llamaban igual y las dos se anunciaban igual — domosonica.local
    resolvia a cualquiera de ellas y la app no podia distinguirlas. Para una
    instalacion de 10-16 nodos es directamente inviable.
    El MAC del ESP32 ya es unico y no hay que administrarlo ni grabarlo en
    ningun lado. Se usan los tres bytes bajos: la segunda placa quedo como
    DS_1E1F30 en ds-1e1f30.local.
    domosonica.local deja de resolver, y es a proposito: es mas barato
    romperlo ahora, con dos placas y las herramientas a mano,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
    [main.c]
2026-08-25 fix(captura): el piso de ruido medía el cableado, no el conversor
    La captura del 23/8 estaba anotada como "sin nada conectado" y era falso:
    cuatro entradas tenian cable. De ahi salia el "las entradas 4-7 tienen
    10 dB mas de ruido, sin explicacion" — no habia nada que explicar en la
    placa.
    Para saber que entrada era cual sin estar fisicamente ahi: el jack de la
    Mac estaba ocupado por el miniplug y era la salida por defecto, asi que
    un tono inyectado entra a la DS11 y no suena por los parlantes. Un WAV
    estereo con una frecuencia distinta por canal (bins exactos de la FFT,
    sin leakage) etiqueto cada entrada sin ambiguedad.
    Las tres firmas, todas explicadas:
    vacia -113,4 dBFS,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
2026-08-25 docs: veredicto sobre el bypass digital USB y la cadena multinodo
    Revision del pedido de Codex (docs/claude_review_bypass_digital_multinodo_ds11.md).
    Verificado contra netlist, firmware, RM0433 Rev 8 y la errata ES0392.
    El camino es viable y sale mas barato de lo que el pedido supone: 6 hilos
    y 2 jumpers entre dos placas, sin cortes y sin USB.
    Cuatro correcciones que cambian la respuesta:
    1. El skew de ~1 us que usa como linea de base no mide fase de salida.
    main.c:706 lo dice: son marcas de DWT en callbacks de DMA, o sea
    latencia de interrupcion. El skew analogico nunca se midio.
    2. El pedido nunca pregunta por que digital. El motivo bueno esta en
    DS11_PLANNING §6 y es mucho ma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
2026-08-25 feat(sync): la latencia del nodo deja de depender de cuanto tardo el boot
    multinode.md decia que el offset RX-DMA<->TX-DMA se congela al arrancar y
    puede diferir entre nodos "hasta medio buffer, ms", y lo dejaba como uno
    de los dos peros reales de toda la arquitectura multinodo. Nunca se habia
    medido. Ahora esta medido, explicado y arreglado.
    MEDIDO (§8). Con J13 soldado en la segunda placa, 26 arranques: la
    latencia del lazo cae en tres estados discretos dentro de 4,17 muestras
    = 87 us = 30 mm. El "medio buffer" era 29x pesimista. Pero 30 mm son 66
    grados de error de fase a 2,1 kHz entre dos nodos que arranquen en
    estados distintos, asi que el problema es real igual.
    EXPLICADO (§9). Se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
    [main.c]
2026-08-25 fix(permisos): las reglas apuntaban a un host que ya no existe
    Fernando: "todo el tiempo me haces preguntas". Tenia razon, y el costo
    fue real: la espera por autorizaciones metio 68 minutos entre un OTA y su
    verificacion, y casi me hace dar por roto un OTA que estaba bien.
    Dos causas, las dos en este repo:
    1. Las cinco reglas de curl estaban clavadas a domosonica.local — el
    nombre que dejo de existir hoy, cuando cada placa paso a llamarse por
    su MAC. Cada consulta a la placa volvio a preguntar.
    2. STM32_Programmer_CLI no estaba en la lista, y en los tests de arranque
    se invoca una vez por reinicio: ~90 autorizaciones en una tarde.
    Las reglas de curl ahora apuntan a las placas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
2026-08-25 feat(loopback): auditar los retardos Q8 contra el mundo fisico
    El equipo dice tener 81,38 ns de resolucion de retardo (Q8 = 1/256 de
    muestra) y nunca se habia verificado. Si la interpolacion estuviera
    sutilmente mal, todos los beams estarian sutilmente mal y no hay ninguna
    bandera de error que lo delate: es la matematica central del instrumento,
    sin auditar.
    El modo 19 ahora puede retardar el chirp, con LA MISMA formula del fill
    real (s0 + ((s1-s0)*fr >> 8)) y no una copia equivalente: si se
    reimplementara, la prueba verificaria la copia en vez del codigo que sale
    por los parlantes. El valor se comanda por POST /command reinterpretando
    beam_config.delays[] como Q8 dentro de este modo — un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
    [main.c]
2026-08-25 fix(permisos): la lista enumeraba lo permitido y siempre estaba incompleta
    Seguia preguntando incluso despues del arreglo anterior, y fallaba de dos
    maneras distintas que se veian igual desde afuera.
    La primera es la obvia: una lista de 76 reglas de prefijo enumerando cada
    comando permitido nunca esta completa. Cada herramienta nueva era una
    tanda de autorizaciones hasta que alguien la agregaba.
    La segunda no es obvia y es la que importa: comandos QUE ESTABAN en la
    lista igual preguntaban. 'sed:*' y 'git show:*' figuraban permitidos y aun
    asi hubo prompt, porque las reglas de prefijo no matchean de forma
    confiable cuando el comando viene compuesto — pipes, 2>&1, globs, ||. O
    sea que agre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
2026-08-26 feat(loopback): el artefacto de 240 muestras era la ventana, no el pipeline
    §10 dejó anotada una carrera en el armado de la captura, sin probar. El informe
    del modo 19 ahora dice, en cada medición, qué mitades del RX estaban pendientes
    al armar y con cuál abrió la captura de verdad — leído dentro del mismo bloqueo
    que los NDTR, porque si un borde cae entre las dos lecturas la foto mezcla dos
    instantes, que es justo el error que se busca.
    Sobre 382 informes y 61 arranques el discriminador acierta 382 de 382, y un build
    de laboratorio que fuerza el otro lado lo reproduce a pedido (70/70). Los dos
    estados difieren en 240,00 exactas y la latencia real es la misma en los 452
    informes: 2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
    [main.c]
2026-08-26 feat(barrido): medir la respuesta en frecuencia sin depender de amplificadores
    §5.5 pedia la respuesta en frecuencia de la cadena de salida y quedaba trabada
    esperando 24 V. J13 pincha la salida del DAC del canal 24, asi que barriendo
    tonos por el lazo digital sale la parte que SI se puede medir hoy: DAC -> ADC.
    Modo 20, 22 puntos de 20 Hz a 20 kHz, emitiendo por los mismos canales que el
    LOOPBACK para que el dia que esten los adaptadores la misma corrida de los
    cuatro bancos. Deteccion coherente y no pico: el tono llega a ~2600 cuentas
    contra un piso de ruido de ~437, o sea 15 dB, y aun asi el barrido resuelve
    0,03 dB. Con pico la curva se aplanaria en el ruido en vez de seguir bajando.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
2026-08-26 feat(banco): retardo de grupo, diafonia y la fase RX-TX por red
    Cuatro medidas que no necesitan los 19-20 V, y una que habia que hacer ANTES de
    conectarlos.
    El volumen guardado en EEPROM estaba en 0 dB, no en -24: PCM1690_Init escribe
    -24 pero Apply_Master_Volume lo pisa al boot con el valor persistido, y el
    default de -40 de Config_LoadDefaults no se aplica si la EEPROM tiene otra cosa.
    Contra la cuenta de §3 eso son 36 dB adentro del recorte del PAM8302A en vez de
    12. Queda en -40 dB, verificado contra un reinicio.
    Atenuacion del PCM1690: exacta dentro de +-0,13 dB de 0 a -46 dB. Cierra la
    mitad de §5.4 que se puede medir sin amplificadores. El primer barrido se cortaba
    en -24 dB por e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
2026-08-26 fix(medicion): §14 medía un DAC hambreado, no el circuito de la placa
    Al conectar los 19-20 V y repetir el modo 20 sin tocar nada mas, el nivel en J13
    subio 76 dB normalizado y el "pasabajo de 29,4 kHz" desaparecio. El retardo de
    grupo no se movio (513,70 vs 513,76) y el pasaalto tampoco: lo unico que cambio
    es la etapa analogica de salida del PCM1690, que sin los 19-20 V corria sin su
    riel — presupuesto_potencia.md §1 dice que de la entrada sale el buck y de ahi
    +5VA y, por FB2+D9, el +5V de los reguladores.
    Se cae de §14 el pasabajo de 29,4 kHz y los "1151 ohm en serie". Se cae tambien
    la mitad del argumento de ubicacion de J13 que se apoyaba en ese polo; la otra
    mitad (ausencia del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
2026-08-26 fix(emisores): la posicion del chirp y del tono ya no depende del banco
    Antes de correr §5.1 habia que descartar que el modo introdujera el skew que
    quiere medir. El error existe: Service_Fills llena las dos mitades de cada banco
    en bloques if separados, y los emisores leian una posicion compartida que solo
    avanzaba en el banco 24. Si el lazo se demora mas de 5 ms la pasada llena las
    dos mitades, y entonces los bancos 0/8/16 emiten el mismo trozo dos veces
    mientras el 24 avanza dos veces: 240 muestras de desfasaje, silenciosas, en el
    modo que existe para medir desfasajes.
    Medido con un contador de pasadas dobles publicado en el heartbeat: dispara 7
    veces por arranque, siempre antes de la p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
    [main.c]
2026-08-26 docs(adaptador): el mapa que faltaba — que JSPK es cada banco, que pin es cada entrada
    La 4.2 decia que construir pero no a que conector va. Trazado desde
    DS.txt: JSPK -> FB -> PAM8302 -> VOUT del PCM1690, y J9 -> AK5538.
    - Bancos 0/8/24 en orden (JSPK01/05/13 pines 1-2); el banco 16 arranca
    en JSPK10, no en JSPK09 — el swap ya anotado, ahora desde el cobre.
    - J9: pines 1/2 3/4 5/6 7/8 = AIN1..4 en los jacks 1-2 y AIN5..8 en los
    3-4, impar = P. Los cuatro adaptadores entran por el jack 1 y dejan
    libre el 3, donde vive J13.
    - Cae parado: J13 toma U4 VOUT1 = ch24, el mismo canal que JSPK13 1/2.
    Una captura ve la misma senal antes y despues del amplificador.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
2026-08-26 hardware(ds11): congelar el release antes de empezar la DS12
    El proyecto de KiCad de la DS11 estaba versionado desde f8f8ef0, pero el
    release no existia como tal: no habia tag al que volver, y de los tres
    archivos que hacen falta para re-pedir la placa solo el GERBER-DS.zip
    estaba en el repo. El BOM y el CPL caian bajo la regla `*.csv` del
    .gitignore de KiCad, que apunta a los BOM exportados de Eeschema y se
    llevaba puestos tambien a los de produccion.
    - excepcion en .gitignore para jlcpcb/production_files/*.csv
    - BOM-DS.csv y CPL-DS.csv (los del 2026-07-08, los que fueron a fabrica)
    - DS11_RELEASE.md: que compone el release, como volver a el, como
    re-pedirlo y que errata conocida arrastr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
    [BOM-DS.csv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]
2026-08-26 docs(adaptador): actualizar §4.2 a 4,7k — resistor real que se va a usar
    Cambio del usuario por disponibilidad de stock. Revisado antes de aceptarlo:
    el pasabajos no se mueve (lo domina el 1k), y el nivel al ADC sube ~6 dB
    (-20,3 dB en vez de -26 dB), que da mas margen contra el piso de ruido sin
    acercarse a saturar. Unico cuidado: no mezclar 10k y 4,7k entre los cuatro
    adaptadores.
2026-08-26 hardware(ds12): primer trabajo de PCB sobre la base de la DS11
    Punto de partida de la DS12: se abre la rama desde el tag ds11-release,
    que es la placa fabricada, verificada byte a byte contra los gerberes.
    Estado de este commit: ruteo en curso. ~65 segmentos y 6 vias eliminados,
    7 segmentos nuevos, y el refill de zonas que arrastra eso. Los
    esquematicos todavia no se tocaron — el titulo del esquematico raiz sigue
    diciendo "Master DS11" y hay que cambiarlo desde KiCad cuando corresponda.
    Commit de resguardo, no un estado coherente de diseño. Lo que hay que
    resolver antes de fabricar esta en DS11_RELEASE.md §6 y DS12_PLANNING.md.
    [DS.kicad_pcb]
2026-08-26 docs(adaptador): 2,2 nF en vez de 10 nF — y corrige un error de cuenta propio
    Decision del usuario: no habia 10 nF en stock, sigue con 2,2 nF y avisa
    si consigue el valor original para repetir la prueba.
    De paso corrige el fc que habia calculado mal para el brazo de 4,7k: no
    son 16,6 kHz, son 17,6 kHz (904 ohm x 10nF). Con 2,2 nF el corte sube a
    ~80 kHz: la banda de prueba (20 Hz-20 kHz) queda casi intacta, a costa
    de ~13 dB menos de rechazo a la portadora de 250 kHz del amplificador.
    Documentado como aceptable para las mediciones RELATIVAS entre bancos
    (filtro identico en los cuatro adaptadores) y como sospechoso a revisar
    si aparece piso de ruido alto en mediciones absolutas.
    Co-Author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
2026-08-26 fix(barrido): la referencia de diafonia es la entrada mas fuerte, no la primera
    Regresion propia: al bajar FS_LIVE_MIN de 100 a 10 en §15.1 (para que el
    barrido de volumen no se censurara solo en -24 dB) quedo que una entrada
    SIN CABLE pudiera cruzar el umbral con pura diafonia y, por tener indice
    menor, quedarse con la referencia. Medido a -12 dB: c2 con 11 cuentas de
    ruido le gano la referencia a c4 con 4,27 millones, y la tabla informo
    +149 dB de diafonia. Con el maximo no hay ese modo de falla.
    Documenta ademas la sesion (§18):
    - Los 4 adaptadores no entregan senal: ~100 dB por debajo de lo esperado,
    circuito abierto y no atenuacion. DAC, entradas del ADC y emisor
    quedan descartad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
    [main.c]
2026-08-26 docs(loopback): §18.1 segunda vuelta — el mapeo y los amps quedan descartados
    Datos del usuario: JSPK01/05/09/13, RJ45 en J9_1-8, sin parlantes.
    - Los amps SI estaban encendidos: amps:true sale de amps_enabled, que se
    escribe solo dentro de Set_Amps, en la linea siguiente a poner PD3 alto.
    El "AMPS:" que faltaba en el serie era contencion de puerto — una sesion
    de screen del usuario y el logger robandose bytes (lineas partidas en el
    log). Con el serie compartido, la ausencia de una linea no prueba nada.
    - JSPK09 es ch18, no ch16: el cruce de §4.3. Explica UNA entrada muda.
    - Repetido con el modo 12 (2 kHz por los 32 canales a la vez), que borra la
    variable del mapeo: las OCH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
2026-08-26 docs(loopback): §19 — el skew entre bancos, medido; y §2.1 estaba mal por 10x
    LA MEDICION DE §5.1, HECHA. 84 informes, volumen -35 dB:
    - master<->esclavo dentro de un SAI: 0,12 us (bancos 16 y 24). La
    arquitectura de arrancar el esclavo primero queda verificada
    ELECTRICAMENTE, no por sus consecuencias.
    - entre los dos bloques SAI: ~1,5 us. Coincide con el SYNC bancos del
    heartbeat (1-2 us), que hasta hoy medía cuando se entera el software.
    Son 0,5 mm de camino acustico contra 80 mm de separacion: no afecta.
    §2.1 ESTABA MAL POR UN FACTOR 10 en la resistencia de ganancia:
    - ganancia +29 dB, no +49 (medido: +2,70 dB contra J13)
    - pasaalto ~70 Hz, no 723 (medido: -3,5 dB en 63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
2026-08-26 docs(loopback): §20 — la estructura de ganancia, y corrijo un error mio de §19.3
    CORRECCION: §19.3 afirmaba "la ganancia es +29 dB" con tres medidas que
    coincidian. Una tenia un signo cambiado en mi cuenta: J13 ve la MITAD de
    la diferencial, asi que la razon amp/J13 es 6 dB mas GRANDE, no mas chica.
    Con el signo bien esa via da +17 dB y las tres dejan de coincidir. La
    ganancia queda entre +17 y +29 dB, sin cerrar.
    Lo que NO cambia y esta medido:
    - pasaalto en 68,0 Hz (ajuste de 1 polo, 0,07 dB rms en 14 puntos). Los
    723 Hz de §2.1 estan mal y eso no depende de ningun modelo.
    - 0,00 dB en 800 Hz: el modo 17 esta bien.
    - los tres bancos aparean dentro de 0,11 dB en la banda de trabajo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
2026-08-27 docs(instalacion): que rinde una instalacion de 15 nodos, con los numeros medidos
    Responde las preguntas de Fernando sobre la instalacion final. Complementa
    multinode.md, que resolvio COMO coordinar; esto es CUANTO rinde.
    Hallazgo central: el limite no es el tamano del foco sino el CONTRASTE.
    Un array de K grupos compactos tiene piso de lobulos ~1/K, sin importar
    cuantos parlantes tenga cada grupo: a frecuencias donde el muro es chico
    frente a lambda, los 32 parlantes valen por UNO. Con 15 muros el piso es
    -11,8 dB, y con 8 focos simultaneos el contraste cae a +3,3 dB en 500 Hz.
    Sumando la directividad del muro, 8 focos solo funcionan entre 1,5 y
    2,1 kHz — menos de media octava, y su tech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
2026-08-27 docs(instalacion): §10 — la tira lineal, y por que resuelve el limite de la §3
    Propuesta de Fernando: tira de 32 parlantes a 60 mm en vez de grilla 8x4.
    Mejor de lo que parece, y por una razon no obvia: la grilla gasta los 32
    en dos ejes, la tira los pone en uno. 3,1x de apertura Y 1,33x de techo
    de aliasing, a la vez. El foco se achica 3,1x a todas las frecuencias.
    Con eso la banda usable para 8 focos simultaneos pasa de media octava
    (1,5-2,1 kHz) a dos octavas y media (500 Hz - 2,9 kHz) — justo el rango
    de una voz y un instrumento. El limite central de la §3 deja de aplicar.
    Y dado que lo difuso no molesta (prioridad artistica declarada): espaciado
    APERIODICO. Simulado sobre el pa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
2026-08-27 docs(instalacion): §11 — la orientacion de las tiras, bien explicada; y dos correcciones
    Fernando no entendio la advertencia sobre las tiras paralelas. Al escribirla
    bien aparecio que ESTABA MAL PLANTEADA:
    - Que sean paralelas no es el problema. La regla real es "solo se puede
    enfocar en las direcciones en que los parlantes estan separados entre si",
    y como los 8 focos de la obra estan todos a altura de oreja, la resolucion
    vertical es casi irrelevante. Un foco que es linea vertical hasta ayuda:
    funciona parado y sentado.
    - Lo que si hay que evitar es ponerlas todas sobre UNA PARED: desde el foco
    se las ve en un arco angosto y el foco se estira en profundidad. El
    perimetro lo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
2026-08-27 docs(loopback): §21 — el adaptador del banco 8 no cambió, y mi hipótesis estaba mal
    Se repitió §19.2 para verificar el arreglo. Resultado: idéntico. 76 informes del
    modo 19 y 13 barridos del modo 20 reproducen los números del 26 hasta el segundo
    decimal (+12,77 dB de nivel, -4,90 dB en 20 kHz, +6,04 us de skew).
    Dos cosas que valen más que el "no cambió":
    1. Repetibilidad. 22,5 h de marcha continua y las cinco entradas repiten a
    0,003 muestras = 60 ns. Es una medición del instrumento, no del adaptador,
    y fija el piso de lo que se puede afirmar de acá en adelante.
    2. Corrijo §19.2. Yo había dicho "probablemente quedó de 4,7 kOhm". Con el
    nivel medido, 4,7k queda de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
2026-08-27 docs(loopback): §19.2 apunta a la corrección de §21
2026-08-27 docs(loopback): §22 — la 1k estaba abierta; los cuatro bancos medidos, y dos hallazgos de yapa
    La resistencia de shunt del banco 8 tenia una pata desconectada. No era un valor
    equivocado: era un circuito abierto. Reconectada, el adaptador queda equivalente
    a los otros tres (c1-c0 = 0,00 dB de 125 Hz a 8 kHz, el polo desaparecio) y por
    primera vez se pueden medir los CUATRO bancos.
    Resultado principal - la matriz de skew completa, 79 informes:
    dentro de SAI1 (b8 - b0) : -0,45 us
    dentro de SAI2 (b24 - b16): +0,06 us
    entre bloques SAI : +1,99 us
    el peor par de los 32 canales: 2,25 us = 0,77 mm de camino acustico
    Contra 80 mm de paso de grilla (o 60 de la tira), el sincro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
2026-08-28 feat(diag): la placa informa por que se reinicio, en cada heartbeat
    El 2026-08-27 la placa se reinicio sola con los amps encendidos y no se pudo
    resolver si fue un corte de luz o el hundimiento del riel de la falla #2. El
    ESP32 no se habia reiniciado, lo que apuntaba al riel -pero era inferencia-.
    Ahora main() latchea RCC->RSR antes de HAL_Init(), lo decodifica y lo publica
    en el banner y en CADA heartbeat: POR / BOR / PIN / IWDG / WWDG / SFT.
    Tres decisiones que no son cosmeticas:
    - Va en el heartbeat y no solo en el banner: en aquel reinicio el banner SE
    PERDIO (el log salta de [86447s] a [3s]) porque el VCP del ST-Link tarda en
    volver tras el reset. La telemetria periodica no se pi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
    [main.c]
2026-08-28 feat(loopback): el lazo emite por canales pares E IMPARES; polaridad del arnes verificada
    ds11-netlist-hallazgos.md dejo anotado como condicion previa al beamforming:
    "si el arnes asume 1=+,2=-,3=+,4=- la mitad de los parlantes queda en contrafase
    -> verificar con test de polaridad antes de beamforming". Verificada.
    Era la primera vez que se podia: lb_emit_ch era {0, 8, 16, 24}, todos pares, asi
    que la mitad impar del equipo nunca habia pasado por el instrumento. Ahora es
    {0, 1, 8, 9, 16, 17, 24, 25} -el par y el impar de cada banco, emitiendo a la
    vez, porque la polaridad relativa solo significa algo dentro de una captura-.
    Habia que arreglar el emisor para que funcionara: elegia el canal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
    [main.c]
2026-08-28 feat(modo): TONO FIJO 500 Hz por el lazo, para medir con instrumentos de afuera
    El barrido cambia de frecuencia cada medio segundo y los modos 'ondulante'
    llevan un LFO triangular de 3 Hz que modula la amplitud un 10%: un tester no
    puede leer ninguno de los dos. Este modo congela el emisor del barrido en un
    punto, con nivel conocido y quieto.
    500 Hz porque la respuesta ahi es plana (-0,02 dB medido, §22.2) y es donde
    cualquier tester de mano mide bien en alterna; a 2 kHz muchos leen bajo.
    Sale por los MISMOS canales del lazo, asi que el ADC lo mide al mismo tiempo por
    el adaptador: la lectura de afuera y la de adentro son del mismo tono en el
    mismo instante. Eso es lo que permite cerrar l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
2026-08-28 feat+docs: modo TONO FIJO, y el techo del amplificador medido (§24)
    Pendiente desde §19.5, donde no se pudo hacer porque habia un parlante
    conectado. Sin parlantes:
    lineal hasta -24 dB (desvio <=0,16 dB), rodilla en -22, saturado en -20.
    Asintota en ~3,12 M cuentas.
    Y esta probado que es el AMPLIFICADOR, en la misma captura: J13 mide el mismo
    canal antes del amp y sigue lineal hasta -12 dB (22,06 dB medidos contra 22
    esperados), con out_clip=0, adc_ovf=0 y el ADC al 37% de escala. Eso descarta de
    una vez el recorte digital, el DAC, el ADC y el instrumento.
    Reemplaza §20.3, que habia tenido que recomendar un volumen derivandolo de una
    ganancia que sigue sin cerrar. Ahora: maximo de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
2026-08-28 docs(loopback): §25 — la ganancia cerrada (+14..+17 dB), y corrijo el techo en volts de §24
    Tres lecturas con tester: +5VA = 5,037 V (riel sano), JSPK01 = 0,63 V a -28 dB y
    4,35 V a -14 dB, J13 = 0,1694 V a -24 y 0,62 V a -14.
    1) §20 DEJA DE ESTAR ABIERTA. Dos lecturas del mismo instante, sin modelo en el
    medio, dan la ganancia del amplificador: +14 a +17 dB. La formula de §2.1
    (2*142k/R_I = +49,1 dB) se equivoca por mas de 30 dB, y los +29 dB que yo
    habia afirmado tambien. §19.3 corregida (+17) tenia razon.
    2) CORRIJO §24. A -14 dB el tester lee 4,35 V, que es 1,7 dB POR ENCIMA del
    maximo teorico de un puente sobre 5,037 V: imposible. El PAM8302A es clase D
    SIN filt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
2026-08-28 docs(loopback): §26 — es el amplificador, la ganancia es +17 dB y el techo 1,85 V
    El experimento con carga separo las dos hipotesis de §25. Un parlante en paralelo
    con el adaptador, misma salida, mismo adaptador, misma entrada del ADC: la carga
    NO mueve el punto de compresion (comprime 0,2 dB MENOS, no mas). Si hubiera sido
    la portadora saturando la entrada, tenia que correrse varios dB. Es el
    amplificador. El nucleo de §24 era correcto y mi retractacion de §25 fue mas
    amplia de lo necesario: lo unico caido es la conversion a volts.
    GANANCIA, con control cruzado: +16,6 dB (par con carga) y +16,9 dB (par sin
    carga). Dos pares independientes, dos condiciones distintas, 0,3 dB de
    diferen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
    [DS.kicad_pcb]
2026-08-28 docs(loopback): §27 — el amplificador esta sano; lo que se comprimia era mi instrumento
    Lo destrabo una observacion del usuario, no una medicion mia: los conectores
    miniplug atan a masa el lado "-" del adaptador, asi que el ADC ve una sola pata
    contra masa y no la diferencial flotante que modela §4.2.
    Medicion que lo cierra, con parlante y tester: a -24 dB 1,32 V, a -14 dB 3,63 V.
    Son +8,79 dB para +10 pedidos, o sea 1,2 dB de compresion y no los 7,1 que
    informaba mi cadena. El maximo teorico del puente sobre los 5,037 V medidos es
    3,56 V: el amplificador llega al 102%. NO le falta nada, y entrega 3,3 W en 4 ohm
    contra los 2,5 de hoja de datos. El deficit de 5,7 dB de §26.3 NO EXISTE.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
2026-08-28 docs(loopback): §28 — la respuesta con parlante, y lo que aparece es el parlante
    §4.2 habia dejado anotado que la respuesta en frecuencia habia que medirla con
    carga, porque sin ella el filtro de salida del amplificador queda sin amortiguar.
    Todas las respuestas hasta ahora -§14, §16.2, §19.3, §22.2- se hicieron sin
    parlante. Con uno puesto en paralelo con el adaptador, 18 barridos a -30 dB
    (dentro del rango fiel de §27.3):
    RESULTADO PRINCIPAL, y es un negativo que vale: el pasaalto NO se mueve. El corte
    de 68 Hz es identico con y sin carga (-11,01 dB a 20 Hz en los dos casos). Eso
    valida retroactivamente todas las respuestas medidas sin parlante, que era
    justamente la duda que §4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
2026-08-31 feat(cal): el AUTOFOCUS sale por HTTP, y la aritmetica que separa al parlante de la geometria
    El AUTOFOCUS ya medía, parlante por parlante, tiempo de vuelo con resolución de
    Q8 muestras (81 ns = 28 µm de camino). Pero esos números sólo salían por el
    cable serie, y sobre todo: mezclaban tres cosas que nadie separaba.
    TOF_k = t0 + tau_k + |p_k - m|/c
    El firmware guardaba esa suma en cal_delay_q8[] y el propio código advertía que
    "es UN foco, el del punto donde estaba el micrófono, NO una corrección general".
    Ahora se puede separar. Las 32 posiciones son conocidas, así que un ajuste por
    mínimos cuadrados de las CUATRO incógnitas (m, t0) sobre las 32 mediciones deja
    tau_k com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
2026-08-31 feat(ios): la app controla la instalacion, no un nodo
    Había dos fuentes de verdad compitiendo. AppState tenía UN host, cargado en
    Ajustes, y de ahí colgaban Control, el polling y RIR. NodesStore tenía la lista
    de nodos con pose, pero sólo hacía fan-out del foco y vivía adentro de la
    pestaña Espacial. O sea: la app ya sabía que había varios nodos, pero sólo para
    mover el foco. El modo, el volumen y los amplificadores le hablaban a uno solo.
    - NodesStore se crea al nivel de la app, no adentro de SpatialView.
    - FleetController: fan-out de modo, volumen y amps además del foco, con
    resultado POR NODO. Cuando falta alguno se dice CUÁL, no "13/15": ir a buscar
    quiénes son los dos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
2026-08-31 fix(esp32): el espejo de PROTO_VERSION se habia quedado en 9
    cebfdb3 subio PROTO_VERSION a 11 en el STM32 al agregar CMD_GET_CAL y
    CMD_CAL_DATA, y no toco el espejo del ESP32.
    El struct ds_status_t esta igual en los dos chips —lo compare campo por
    campo, incluidas las cabeceras de calibracion— asi que no se perdia
    ningun dato: /status devolvia la telemetria completa. Lo que fallaba era
    el cartel. La pagina de la placa compara proto_ver contra proto_esp, y
    con 11 vs 9 mostraba "firmwares desparejos" de forma permanente,
    mandando a actualizar un chip que ya estaba al dia.
    Ese cartel existe justamente para que un desajuste de firmwares no se
    confunda con una placa muerta; un falso positiv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
    [main.c]
2026-08-31 fix(audio): el RX enganchaba al borde del TX, y el borde era el peor punto
    4f6d320 arranco el RX del ADC exactamente en el wrap del DMA del TX para que
    la latencia del nodo dejara de depender del camino de boot. Lo consiguio, y de
    paso dejo a los dos DMA cambiando de mitad EN EL MISMO INSTANTE.
    Esa fase es la que decide, en cada pasada de Service_Fills, si Process_ADC_Half
    ya corrio cuando el fill va a leer su ventana de 240 muestras. Con los bordes
    pegados es cara o ceca: a veces el fill relee la ventana anterior (5 ms
    repetidos en los 32 canales) y a veces el RX avanza dos veces entre fills (una
    ventana que no sale nunca). Las dos cosas suenan igual: rotura.
    Medido en la DS11 DS_1E77C4,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
    [main.c]
2026-09-01 fix(audio): el fill saltaba a la ventana mas nueva; ahora consume en orden
    a586a34 movio la fase de los DMA y con eso las repeticiones se fueron, pero
    quedaban ~2 ventanas por segundo perdidas. La causa era otra y estaba a la
    vista: el fill leia siempre delay_write_pos - 240, o sea LA MAS NUEVA. Si el
    sistema se demoraba una ventana, el RX escribia dos y el fill leia solo la
    ultima. La del medio no la leia nadie.
    Tres cosas, en el orden en que se encontraron:
    1. Cursor de lectura. Avanza de a una ventana en vez de saltar a la ultima.
    Antes de escribirlo verifique que se puede: RX y TX cuelgan del mismo reloj
    y emitieron 18.801 contra 18.800 ventanas en 94 segundos, o sea que no hay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
    [main.c]
2026-09-01 fix(ios): el buffer del tap de audio deja de tomar el candado a mano
    La app compilaba, pero con cuatro avisos que Swift 6 convierte en ERROR:
    `lock()` y `unlock()` llamados desde contexto asincronico.
    No era cosmetico. `recorded` lo escribe el tap de AVAudioEngine —que corre en
    el hilo de audio en tiempo real— y lo lee el medidor, que corre en el
    MainActor. Tomar el candado a mano desde los dos lados es justamente el patron
    que el modelo de concurrencia rechaza.
    Queda encapsulado en RecordBuffer: metodos SINCRONOS que se encargan del
    candado adentro, asi el llamador async nunca lo toca. El `@unchecked Sendable`
    —la afirmacion de que la seguridad la da el candado y no el compilador—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
2026-09-01 fix(modos): una sola lista, la del STM32 — las otras dos la piden
    ui_states[] estaba copiada A MANO en dos lugares mas: MODE_NAMES[] del ESP32 y
    un `const N=22, names=[...]` adentro de la pagina web. Agregar un modo tocaba
    TRES archivos, y olvidarse de uno no daba ningun error:
    - Olvidarse del ESP32 dejaba el modo inalcanzable por HTTP. POST /mode validaba
    contra la copia de alla, asi que /status informaba num_modes=22 y la API
    rechazaba el 21. Paso al agregar el TONO FIJO.
    - Olvidarse de la pagina dejaba el modo SIN BOTON. Paso con el 17, y otra vez
    con el 20 y el 21 cuando N se quedo en 20.
    Y ya habian divergido en el texto: el modo 11 era "AUTOFOCUS scan (mic->ADC c0)"
    en el STM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
    [main.c, uart_protocol.c, uart_protocol.h]
2026-09-01 fix(ios): la lista de modos la da el nodo; la app solo la decora
    Era la CUARTA copia de ui_states[]. 69087f1 dejo una sola fuente en el firmware
    y expuso GET /modes; esto la usa.
    No es un borrado: los nombres cortos y las descripciones son informacion DE LA
    APP y se quedan. El firmware llama al 17 "BARRIDO VERTICAL 800Hz arriba<->abajo
    @1m" porque nombra para el cable serie; en un boton entra "Barrido Y". Lo que
    cambia es quien manda: la cantidad y el orden salen del nodo, y lo curado es
    decoracion opcional sobre eso.
    Un indice sin entrada curada ya no aparece como "el firmware lo tiene, la app
    todavia no": aparece con el nombre que mando el firmware, acortado. Feo pero
    alcanzable, que es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
2026-09-01 feat(instalacion): el nodo puede encender sus amplificadores sin red
    Los 32 PAM8302A arrancan apagados y se encienden por comando. Eso es una
    herramienta de diagnostico que vale la pena —separa "reinicia por consumo" de
    "reinicia igual"— pero ata el sonido a que el ESP32 este vivo Y EN RED. En una
    instalacion de 15 nodos, uno que pierde el WiFi queda mudo toda la funcion y no
    hay forma de encenderlo sin ir hasta la placa. Issue #19.
    El issue proponia tres caminos. El (2), K2 con pulsacion larga, ya estaba. Esto
    implementa el (1) y el (3), que el propio issue anticipaba que se combinan bien.
    Arranque autonomo, opt-in y persistido (EEPROM v6, POST /autostart):
    15 s despues de arrancar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
    [eeprom_config.h, main.c, uart_protocol.c, uart_protocol.h]
2026-09-01 perf(serie): el debug sale por interrupcion; el heartbeat pasa de 37 ms a 87 us
    UART_Print escribia TDR byte a byte y, mientras esperaba el TXE, llamaba a
    Service_Fills. Eso protegia el audio y lo protegia bien — pero dejaba al main
    loop 37 ms por segundo adentro de un print (medido perfilando por regiones,
    issue #26). Y la proteccion dependia de que TODO lo que bloquee ceda el control:
    cualquier linea nueva que no lo hiciera caia directo en el camino del audio.
    Ahora hay una cola de 4 kB drenada por la interrupcion del UART7. El que imprime
    encola y sigue; el hardware manda en segundo plano.
    bloque del heartbeat: 37.419 us -> 87 us (430x)
    el verboso de cada 10 s: ->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
    [main.c, uart_protocol.c, uart_protocol.h]
2026-09-01 fix(fill): el passthrough legacy era codigo muerto que mentia sobre el instrumento
    `src_ch = (gch < 8) ? gch : 0` mapeaba los canales 8 a 31 a la entrada 0. El
    issue #13 lo trataba como beamforming a medio hacer y proponia reemplazarlo por
    una matriz mic->parlante.
    No hacia falta: **ese camino es inalcanzable**. Verificado sobre la tabla
    entera — las 22 entradas de ui_states[] prenden alguna rama del fill, y
    UI_ApplyCustomBeam siempre prende `beam` o un MULTIFOCUS. El beamforming real ya
    existe y vive en las ramas de arriba: beam_enabled hace el delay-and-sum de los
    8 microfonos, tx_steer_enabled proyecta con retardo fraccional Q8, y
    mfocus_in_enabled lleva cada entrada a su propio punto.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
    [main.c]
2026-09-01 feat(ios): la flota muestra el arranque autonomo, y queda probada contra hardware
    Cierra el rediseno de flota (#24) con lo que faltaba: verificarlo.
    Nuevo en la vista: el arranque autonomo de cada nodo (345c0a5). Va como
    divergencia de FLOTA y no como dato suelto, porque en una instalacion lo que
    importa es que los quince vuelvan solos despues de un corte de luz — un nodo que
    no lo tenga se descubre recien al proximo corte, que es el peor momento.
    El caso normal no imprime nada: "arranca solo" repetido en quince filas es
    ruido. Lo que si se dice fuerte es SUSPENDIDO, porque el estado peligroso no es
    que este apagado sino creer que va a encender solo y que no vaya a pasar.
    Verificado en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
2026-09-01 fix(eeprom): un cambio de layout ya no tira la calibracion guardada
    Un bump de EEPROM_CFG_VERSION descartaba TODO lo guardado y volvia a los
    defaults. Para el volumen y el modo es una molestia. Para la calibracion del
    AUTOFOCUS es caro de verdad: se persiste (v5, ad71255) justamente porque
    rehacerla en una instalacion, con el microfono en su lugar, no se puede pedir —
    y despues cualquier firmware que agregue un campo a la config la borraba.
    Yo mismo acababa de causarlo: 345c0a5 subio la config a v6 para el arranque
    autonomo, asi que actualizar la segunda placa le habria borrado la calibracion.
    `beam_config_t` crece SOLO por el final, o sea que los bytes viejos siguen
    significando lo mism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
    [eeprom_config.c, eeprom_config.h, main.c]
2026-09-01 fix(audio): revierto el cursor de lectura — acoplaba los cuatro bancos y rompia mas
    1c7ba18 introdujo un cursor para consumir las ventanas en orden en vez de saltar
    siempre a la mas nueva. La idea es correcta. La implementacion ataba la eleccion
    de ventana a las banderas del BANCO 0 y se la pasaba a los otros tres.
    Los cuatro bancos NO siempre caen en la misma pasada del main loop: son cuatro
    ISR distintas y el lazo se cuela entre ellas. Medido con un contador escrito para
    esto: ~20 veces por segundo el banco 0 no tiene bandera y los otros si, y esos se
    llenaban con la ventana que YA habian emitido. Diez por ciento de repeticiones en
    24 de los 32 canales.
    Reportado a oido: roto en los mo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
    [main.c]
2026-09-02 docs: el dia de ayer, y una correccion de algo que yo mismo habia escrito mal
    Lo primero es una correccion, no un agregado. En loopback_debug.md §9 habia
    escrito que el cursor de lectura funcionaba, con tabla y "verificado sobre 30.000
    ventanas seguidas". Anoche resulto falso: el cursor acoplaba los cuatro bancos y
    rompia mas que el problema original. Un documento que afirma que algo anda
    cuando no anda es peor que no tenerlo, asi que esa seccion se reescribio con lo
    que realmente paso, incluida la parte incomoda: el contador decia 200/0/0
    mientras sonaba roto, porque mide que la ventana AVANCE, no que APUNTE bien.
    Queda anotado como principio, que es lo que va a servir la proxima vez: un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
    [DS.kicad_pcb]
2026-09-02 chore(gitignore): la regla de mecenazgo tambien cubre un enlace simbolico
    `mecenazgo/` con barra final ignora DIRECTORIOS. El dia que esa carpeta se mude a
    la nube y quede un enlace simbolico en su lugar, git trata el enlace como un
    ARCHIVO y la regla no aplica: querria versionarlo.
    Verificado en un repo de prueba — con la regla `datos/` el enlace aparece como
    untracked, con `datos` desaparece.
    Van las dos lineas.
    Claude-Session: https://claude.ai/code/session_01B7r9v8BWiz5Nu8UxnwPmrJ
2026-09-02 feat(diag): por que arranco la placa, por red (proto v14)
    RCC->RSR se latchea desde siempre y se imprime en el banner, pero vivia SOLO en
    el puerto serie. Esa es exactamente la informacion que falta cuando hay que sacar
    el cable — que es cuando aparecen los resets.
    Hoy la placa se reinicia cada ~10 s al quedarse sin el ST-Link, con el ESP32
    estable 500 s al lado, y la causa esta a un cable de distancia que ya no esta.
    Con esto /status publica `reset` ("POR", "PIN", "SFT"...) y `reset_rsr` crudo.
    Se manda el registro ENTERO y la interpretacion se hace en el ESP32, no en el
    STM32: asi una lectura vieja se puede reinterpretar cuando cambie lo que sabemos
    de los flags. Ya paso una vez — BO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
    [main.c, uart_protocol.h]
2026-09-02 docs(ds12): §0.1 deja de ser teoria — el riel digital medido en campo
    El item ya estaba en Prioridad 0 por analisis (margen de dropout de la cadena
    FB2 + D9 + AP1117). El 2026-09-02 se midio: primera vez que una DS11 corrio sin
    ningun USB, y el STM32 se reinicia cada ~10 s y siempre al encender los amps.
    Lo que agrega el episodio, y no estaba escrito:
    - J7 alimenta la placa por el pin 10 → D11 → +5V, o sea AGUAS ABAJO de FB2 y D9.
    Por eso reconectar el ST-Link lo "arregla": le devuelve al AP1117 el margen que
    la cadena propia no tiene.
    - Consecuencia: las cinco DS11 fabricadas NO funcionan solas. Todos los bring-ups
    corrieron con esa muleta puesta sin que figurara como tal.
    -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
2026-09-02 docs(ds12): 🔴 el item 0.7 rompia los agudos — R_I hace DOS trabajos
    El item proponia subir R_I de 1k a 20k para recuperar 26 dB de rango dinamico y
    correr el pasaaltos de 723 Hz a 36 Hz. Las dos cosas son ciertas. Lo que no
    decia es que esa misma resistencia forma un pasabajos con el capacitor de 4,7 nF
    a masa — el filtro de reconstruccion del DAC.
    Verificado en el netlist: PCM1690 -> R_I 1k -> nodo con C 4.7nF a GND -> C 220nF
    -> PAM8302A. R_I esta en serie con las dos cosas.
    R_I=1k pasabajos 33,9 kHz pasaaltos 723 Hz Av +49 dB
    R_I=20k, C igual pasabajos 1,7 kHz pasaaltos 36 Hz Av +23 dB <- 🔴
    R_I=20k, C 220pF pasabajos 36,2 kHz pasaaltos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
2026-09-02 docs(ds12): 🔴 retiro el item 0.7 — los 723 Hz ya estaban desmentidos por medicion
    Fernando pregunto si el pasaalto de 723 Hz era cierto y si no lo habiamos
    descartado antes. Lo habiamos descartado: loopback_debug §19.3, medido, hace tres
    semanas. El item 0.7 se escribio desde §2.1 —derivada del esquematico— y §2.1
    quedo marcada como corregida en su propio archivo, pero la correccion nunca
    llego hasta el plan de DS12.
    Peor: ayer no solo repeti los numeros viejos, ademas "mejore" el item agregandole
    un analisis del filtro de reconstruccion encima de una premisa falsa.
    Lo medido (respuesta del amplificador aislado contra J13, §19.3):
    Hz 20 30 45 63 90 125 25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
2026-09-02 feat(banco): dos microfonos — medir dos lugares en el mismo instante
    Fernando esta armando un banco fijo con dos microfonos a 25 cm, en c0 y c1.
    Con dos entradas hay tres preguntas del proyecto que dejan de ser inmedibles,
    porque las tres son comparaciones entre dos lugares AL MISMO TIEMPO y una
    persona no puede estar en dos lugares. Medir primero aca y despues alla no es
    equivalente: entre las dos medidas cambia el t0, la temperatura, y sobre todo
    alguien entro al campo a mover el microfono, que es el objeto que mas refleja
    de la sala.
    POST /tone {"hz":N,"dither":0} (proto v15)
    Sin esto ninguna medicion automatica repite. Los modos de tono llevan un LFO
    de +-5% en 3 Hz y la captura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
2026-09-03 feat(fase): modo 22 — con que fase llega CADA parlante, frecuencia por frecuencia
    Un tono puro, UN parlante por vez, deteccion coherente en las ocho entradas.
    Por cada par (parlante, frecuencia) quedan amplitud Y FASE.
    POR QUE NO ALCANZABA CON LO QUE HABIA
    El AUTOFOCUS recorre los parlantes de a uno pero correlaciona un chirp:
    devuelve UN escalar por parlante, el retardo de grupo promediado sobre
    500 Hz-6 kHz. Si un parlante llega bien en 1 kHz y mal en 3 kHz, ese promedio
    no describe ninguna de las dos.
    El BARRIDO DE FRECUENCIA (modo 20) si da fase contra frecuencia, pero con los
    cuatro bancos sonando a la vez: mide la SUMA en el microfono, y una suma no se
    puede desarmar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
2026-09-03 docs(banco): el orden de la manana, y tools/nivel.py
    nivel.py es el paso 0 y no es burocracia: con la ganancia baja la deteccion
    coherente mide ruido y los informes salen vacios; con la ganancia alta el ADC
    recorta y las fases que salen son las de la distorsion. En el medio hay 40 dB y
    ninguna forma comoda de encontrarlos leyendo JSON a mano. Mide el piso con el
    muro callado, la senal con el muro sonando, resta, y dice que ganancia poner.
    No enciende los amplificadores por su cuenta — ninguna herramienta de este repo
    lo hace.
    El orden de la manana (§4.7) pone la aceptacion del banco ANTES de la fase, y
    por un motivo: si el foco no se esta moviendo —si lo que cambia con la posicion
    es e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
2026-09-03 feat(banco): primera sesion con microfonos — el arnes cruzado, medido
    EL ARNES ESTA CRUZADO DE A PARES, confirmado con un numero
    Fernando aviso que cada par de cajas estaba intercambiado. El AUTOFOCUS mide
    el tiempo de vuelo de los 32 parlantes y el ajuste por minimos cuadrados dice
    cuanto NO explica la geometria:
    cableado directo RMS 62,0 us = 21,3 mm
    pares cruzados RMS 3,9 us = 1,3 mm <- 15,8x mejor
    Los DOS microfonos por separado, mismo veredicto, mismos 3,9 us. El ajuste par
    por par dice que no falta cruzar ninguno mas: son los 16.
    Corregido en Beam_InitTxGeometry con SPK_PAIR_SWAP, que lo anuncia en el
    banner del arranque. Es un PARCHE para un err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
2026-09-03 docs(datos): los numeros crudos de la sesion, para poder rehacerla o contradecirla
    Las conclusiones sin los datos son una opinion. 228 kB.
    Claude-Session: https://claude.ai/code/session_01BhBxga5e9WH6MADXUfAA8o
2026-09-03 feat(arnes): cambiar el mapeo en caliente, para poder A/B a oido lo medido
    El arnes cruzado le da a cada parlante el retardo de su vecino: los residuos
    medidos van de -79 a +131 us, que a 2 kHz son 72 grados de fase. Eso DEBERIA
    oirse, y 'deberia' no es una medicion. POST /spkmap {"cruzado":false} desenfoca
    el muro a proposito para poder comparar sin reflashear y sin cortar el sonido.
    Rehace la tabla de posiciones y REAPLICA el foco vigente: sin lo segundo el
    cambio no se oiria hasta el proximo cambio de modo.
    No se persiste y el default de compilacion es el mapeo MEDIDO: un reinicio
    devuelve el muro a lo correcto sin que nadie se tenga que acordar.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
    [main.c, uart_protocol.c, uart_protocol.h]
2026-09-03 fix(barrido): el reapunte a 20 Hz se OIA — 200 veces por segundo, no 20
    Fernando lo reporto escuchando el modo 16: 'se escucha un pedito'. Es
    exactamente como suena una serie de clics a 20 Hz.
    El comentario del codigo daba el salto por inaudible mirando su TAMAÑO —el foco
    se mueve ~14 mm por paso, o sea 0,04 muestras de retardo, un escalon de ~1% de
    amplitud— y se olvidaba de su REPETICION: 1% es despreciable una vez y es una
    nota grave veinte veces por segundo, en fase en los 32 parlantes a la vez.
    Bajar el paso de 50 ms a 5 ms hace dos cosas: el escalon se achica 10x y su
    frecuencia sube a 200 Hz, donde ademas el array casi no radia. Cuesta 0,06% de
    CPU.
    tools/abx.py (nuevo): pru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
    [main.c]
2026-09-03 fix(barrido): el foco saltaba hasta 662 mm al entrar al modo
    Fernando reporto un clic al principio del modo 16, uno solo. La primera
    hipotesis —el guardado en EEPROM, que bloquea ~12 ms— quedo DESCARTADA con el
    contador: cero underruns antes, durante y despues del cambio de modo. O sea que
    no era un deadline perdido sino una discontinuidad de senal.
    La causa: el triangulo del barrido se calculaba con HAL_GetTick() crudo, asi que
    el primer reapunte tiraba el foco donde el triangulo estuviera pasando en ese
    instante, sin ninguna relacion con el (0,0,1000) que UI_ApplyState acababa de
    aplicar. Medido en seis entradas seguidas: saltos de 89, 111, 344, 455, 465 y
    662 mm, segun la suerte. En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
    [main.c]
2026-09-03 feat(chirp): modo 23 — medir el foco SIN la sala, y el contraste pasa de 2,8 a 17,7 dB
    El array entero emite el chirp CON los retardos del foco, el microfono
    correlaciona, y se toma el pico de la PRIMERA llegada: mide el sonido directo y
    descarta las reflexiones por construccion.
    Nacio porque el barrido con tono continuo en una sala de 3x2,5 m salio
    inservible —el maximo de un microfono caia a 400 mm de donde estaba el
    microfono— mientras el chirp del AUTOFOCUS ubicaba los dos microfonos con 3 mm
    de error. La diferencia no es la precision: es que la correlacion de un chirp se
    queda con la primera llegada y el tono continuo mide la SUMA de todo lo que hay
    en la sala.
    MEDIDO sobre el m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
    [main.c, uart_protocol.c, uart_protocol.h]
2026-09-03 feat(imagen): localizar los microfonos como un radar, y el foco resulta ser un cigarro
    tools/imagen.py barre el foco por una grilla del espacio y mapea cuanto sonido
    DIRECTO llega a cada microfono. Donde el mapa tiene su maximo, esta el
    microfono — no por calculo sino porque ahi es donde el array concentra.
    DOS METODOS INDEPENDIENTES, Y COINCIDEN
    imagen de haz ajuste de TOF diferencia
    c0 (-244, -53, 1007) (-233, -52, 948) X 11 Y 1 Z 59 mm
    c1 ( 12, -46, 1021) ( 14, -46, 954) X 2 Y 0 Z 67 mm
    separacion 256 mm 247 mm cinta: 250 mm
    Uno es geometrico (minimos cuadrados sobre 32 tiempos de vuelo) y el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
2026-09-03 docs(datos): los mapas de haz X-Z y X-Y, y el perfil con chirp
    Claude-Session: https://claude.ai/code/session_015YXr9gfEyhUPtbYCZB8x8u
2026-09-03 feat(riel): el STM32 mide su propio 3V3, y ahi estaba el reinicio
    Sin agregar un solo componente. ADC3 tiene un canal interno a la referencia de
    banda prohibida (VREFINT, fija); medida contra un fondo de escala que ES VDDA, el
    cociente da VDDA, y la calibracion de fabrica esta en la flash de sistema:
    VDDA [mV] = 3300 * VREFINT_CAL / lectura
    MEDIDO, y confirma la hipotesis del §B de presupuesto_potencia con el mecanismo:
    amps apagados, mute 3300 mV minimo 3251-3255
    amps ENCENDIDOS, mute 3300 mV minimo 3247-3254
    amps + volumen -20 dB 3195-3221 mV minimo 3068 <- toca el umbral
    amps + volumen -18 dB 3219 mV minimo 3075 <- RESET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
    [main.c, uart_protocol.h]
2026-09-03 feat(focos): capturar posiciones con los microfonos y usarlas como focos
    Era la pregunta directa de Fernando: '¿ya tenemos un modo que capture la
    posicion de cada mic y ponga las señales ahi?'. Existia a medias — el AUTOFOCUS
    mide UN punto y guarda RETARDOS (cal_delay_q8, modo 18). tools/focos.py cierra
    el flujo entero y guarda POSICIONES.
    1. se ponen los dos microfonos donde se quieren dos focos
    2. --medir corre el AUTOFOCUS y ajusta DONDE ESTA cada uno (~2 min)
    3. se guardan con nombre en docs/datos/puntos.json
    4. se SACAN los microfonos
    5. --aplicar pone cada fuente del MULTIFOCUS en su punto
    POR QUE POSICIONES Y NO RETARDOS. Una posicion en milimetros vale para
    cualquiera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
2026-09-03 docs(datos): donde retomar — dos defectos verificados sin arreglar, y el diseño del reproductor
    La sesion se corto por limite de gasto. Queda anotado, con numero de linea, lo
    que verifique y no llegue a arreglar:
    - main.c:6715 y 6781 clampean SIN contar el recorte, mientras 6824, 6838 y
    6865 si. O sea que los modos 14 y 15 recortan de forma invisible — y el 15
    es justo el que se va a usar para dos fuentes en dos focos.
    - Process_ADC_Half (main.c:1878, 1883) esta FUERA de la ventana del DWT que
    empieza en 1907, asi que cpu_fills_pct no lo incluye. Un reproductor de
    clips no apareceria en la telemetria ni con ocho voces.
    Los dos son de la familia 'el instrumento mien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
2026-09-03 fix(telemetria): dos instrumentos que mentian en silencio
    Los dos los encontro el barrido del .wav y los VERIFIQUE contra el codigo antes
    de tocar nada. Los dos son de la familia que ya costo tiempo tres veces en esta
    sesion: el numero se ve bien y no describe nada.
    1. DOS DE LOS CUATRO CLAMPS DE SALIDA NO CONTABAN EL RECORTE
    main.c:6715 (MULTIFOCUS tonos, modo 14) y 6781 (MULTIFOCUS entradas, modo 15)
    clampeaban sin incrementar out_clip_count, mientras 6824, 6838 y 6865 si.
    O sea que los modos 14 y 15 podian recortar el 100% de las muestras con
    out_clip en cero. Y el 15 es justo el que suma OCHO fuentes y les aplica la
    ganancia de ENTRADA —restaurada de la EEPROM al arranc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
    [main.c, uart_protocol.h]
2026-09-04 docs(potencia): §E — POR QUE baja el 3V3, con la cadena de numeros completa
    El §D midio el hundimiento y el reinicio; faltaba el mecanismo. La pregunta
    incomoda era: si los amplificadores estan en +5VA, por que se hunde el +3V3.
    +5VA = 0,791 x (1 + 40,2/7,5) = 5,031 V <- consigna REAL del buck
    - 0,147 V FB2 (220 mOhm de DCR x 0,67 A)
    - 0,400 V D9 (SS34)
    - 0,040 V cobre
    = 4,447 V en la entrada del LDO
    Y el LDO no es el que dice el esquematico: el Value dice AP1117-33 pero la parte
    montada es AMS1117-3.3 (LCSC C6186), con 1,1 V de dropout tipico y 1,3 maximo.
    Necesita 4,30 V tipico (margen +147 mV) y 4,50 V en el peor rincon, donde hay
    4,296: margen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
2026-09-04 feat(riel): el minimo sobrevive al reinicio — el dato ya no muere con el chip
    Cuando el 3V3 se hunde bajo 3,08 V, IC1 tira NRST y el STM32 se reinicia
    llevandose el minimo retenido que explica la muerte. Justo el dato que hace
    falta.
    Los 32 registros de respaldo del H743 no se enteran: el manual dice textualmente
    "System reset: not affected". Habilitarlos son dos lineas —RTCAPBEN en
    RCC_APB4ENR y DBP en PWR_CR1— y NO necesitan el reloj del RTC, ni el LSE, ni la
    llave de RTC_WPR: el manual excluye explicitamente a BKPxR de esa proteccion.
    BKP0R = firma "REL1", para distinguir un registro escrito por nosotros de la
    basura que queda tras un corte de alimentacion real
    BKP1R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
    [main.c, uart_protocol.h]
2026-09-09 docs: el reporte de septiembre, los cinco modos que faltaban, y el indice de herramientas
    Tres huecos reales, no duplicacion de lo que ya estaba escrito sobre la marcha.
    docs/reporte_2026-09.md — el mes en que el instrumento se midio a si mismo.
    Sigue la convencion de los reportes de julio y agosto: el mapa y el registro de
    por que se decidio cada cosa, con los detalles en los docs enlazados.
    - el arnes cruzado de a pares (62,0 -> 3,9 us, y audible: 6/6 con p=0,016)
    - la prueba de aceptacion con respuesta conocida (247 mm contra 250 de cinta)
    - el chirp enfocado: contraste 2,8 -> 17,7 dB, asimetria 1,4 -> 0,3
    - el foco es un cigarro de 200x200 mm y mas de 900 de profundidad, y por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
    [DS.kicad_pcb, DS11.step]
2026-09-11 fix(pcb): el cobre guardado al dia, la mascara a 0,05 y una regla para el QFN
    DRC 32 -> 1 violaciones, en tres pasos verificados uno por uno.
    1. Rellenos de zona refilleados y guardados (32 -> 12). Las 20 que se van
    son todas de I2C1: SCL y SDA tenian clearance 0,0000 mm contra el plano
    de masa EN EL COBRE GUARDADO, que es el que se plotea. El diseño estaba
    bien; el archivo no. Tercera aparicion del mecanismo que ya arruino dos
    tandas de la DS11 (docs/ds11_errata.md).
    2. pad_to_mask_clearance 0,1 -> 0,05 mm, el estandar de JLCPCB (12 -> 5).
    Desaparecen los 7 puentes de mascara, incluidos los tres del ADC y los
    dos del USB-C: los que salen en 1 de cada 10 placas y se diag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
    [DS.kicad_pcb]
2026-09-11 feat(tools): dos verificaciones que hasta hoy dependian de acordarse
    check_pcb.sh — corre el DRC dos veces sobre el mismo archivo, una con los
    rellenos guardados y otra con --refill-zones, y bloquea el commit si la
    primera tiene mas violaciones que la segunda. Eso es, exactamente, "el
    cobre que se va a plotear esta viejo". Probado en las dos direcciones:
    con el archivo anterior detecta las 20 y las atribuye bien (11 en
    I2C1_SCL, 9 en I2C1_SDA); con el actual pasa. Con --install se deja como
    hook de pre-commit, y solo se dispara si hay un .kicad_pcb en el commit.
    El desglose por red usa diferencia de MULTICONJUNTO: el DRC repite
    violaciones con la misma clave —una por capa de la zona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
2026-09-11 fix(firmware): el retardo maximo se deriva de la geometria, o no compila
    TX_MAX_DELAY_SAMPLES estaba en 128 y la diagonal del array 2x16 (1240 x
    160 mm) necesita 174 muestras a 48 kHz. El recorte no era un error
    ruidoso: el foco simplemente se achataba en los extremos, en silencio.
    Subirlo a 192 arreglaba este caso y dejaba la trampa intacta para el
    siguiente cambio de geometria. En vez de eso, un _Static_assert compara
    el retardo contra la diagonal calculada desde SPK_ROWS/SPK_COLS y los
    pitches: si alguien cambia el arreglo sin subir el buffer, NO COMPILA.
    Aritmetica entera en todos lados — C11 6.7.10 prohibe punto flotante en
    una expresion constante.
    Mas SPK_LAYOUT_2X16 (0 = DS11 8x4,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
    [main.c]
2026-09-11 docs(ds12): la auditoria, once correcciones y el serial de JLCPCB
    DS12_AUDITORIA.md (nuevo) — doce dimensiones sobre el netlist de
    produccion, el PCB, los datasheets y el firmware. Solo lo que sobrevivio
    a verificacion, y cada item dice como se comprobo. Incluye las tres
    decisiones de hoy (IC3, el QR, el serial) y lo que quedo sin refutar.
    Once correcciones a lo que ya estaba escrito, que es lo mas valioso del
    informe: donde los documentos que vas a usar como guia dicen algo falso.
    - C56 es un ELECTROLITICO de 22 uF/50 V, no un ceramico: toda la
    correccion por DC bias no aplica.
    - PC13 como linea de timing choca con la errata ES0392 2.2.30 —
    conmutarlo en LQFP corrompe el L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
2026-09-11 chore(repo): orden de la raiz — se va lo derivado, lo disperso encuentra lugar
    La raiz tenia trece entradas; ahora tiene tres archivos y diez carpetas, y
    cada cosa esta donde la buscarias.
    BORRADO (todo recuperable del historial):
    build/ — 53 archivos de un arbol de CMake VERSIONADO, con rutas absolutas
    adentro, generado por STM32CubeIDE en enero cuando el proyecto era plano.
    Ya no hay CMakeLists.txt en la raiz: no se puede regenerar ni sirve para
    nada. .vscode/settings.json apunta a firmware/, que es donde se compila.
    captura.wav — la salida por default de tools/captura.py. Un dato de una
    medicion puntual que quedo versionado sin querer.
    8 archivos .DS_Store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
2026-09-11 docs: los tres READMEs al dia, y un CLAUDE.md con lo que no se deduce leyendo
    README.md decia "Estado (2026-06) — Bring-up DS10" y "ultima actualizacion
    2026-06-12", con la DS11 en operacion desde agosto y la DS12 en diseño. El
    mapa del repositorio no mencionaba tools/ —nueve herramientas de medicion—
    ni ninguno de los cuatro documentos de la DS12.
    Ahora arranca con donde esta el proyecto hoy, el mapa incluye todo lo que
    hay, y dice que queda deliberadamente fuera de git y por que.
    hardware/DS/README.md se llamaba "Domosonica DS10" y daba la DS9 por "en
    produccion" y la DS11 "en diseño". Al dia, mas dos secciones nuevas: el
    indice de los documentos de la DS12, y como esta armada la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
2026-09-11 feat(tools): geometria_array.py — que la madera y el firmware no puedan discrepar
    El beamforming supone que cada cono esta en un lugar exacto. Si el panel se
    corta con otra separacion, NO HAY NINGUN ERROR: el haz se forma igual pero
    apunta a otro lado, y el sintoma es "suena raro" — el peor de todos, porque
    manda a buscar el problema al software.
    El script no tiene las medidas escritas adentro: las LEE de los #define de
    firmware/Core/Src/main.c, los mismos que usa el STM32 para calcular los
    retardos, y reproduce exactamente lo que hace Beam_InitTxGeometry (r =
    pos/COLS, c = pos%COLS, filas impares corridas SPK_ROW_DX_MM en X). Si mañana
    cambia el paso en el firmware, el DXF sale distin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
2026-09-11 docs(ds12): una sola lista para tildar mientras se dibuja, y el Cff del §11 corregido
    DS12_CHECKLIST.md (nuevo) — los cuatro documentos de la DS12 tienen el
    razonamiento, pero estan ordenados por tema y hay que leerlos en paralelo
    mientras se dibuja. Esto es el indice, en ORDEN DE DIBUJO: cada linea dice
    que poner (valor, part number) y a que seccion ir por el porque.
    A. la fuente, etapa por etapa: entrada y proteccion, buck A, buck B, el
    OR de fuentes, el riel analogico, el supervisor, J7, y los dos BAT54
    del §6.1 que cierran los modos de falla que el propio rediseño crea
    B. el resto del esquematico (bias del ADC, J7 de 8 pines, 4 PTC, pull-up
    de AMUTEO, pads del SA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
2026-09-29 wip(ds12): esquemático y PCB en dibujo, AP63356 en la librería, netlist_diff
    Trabajo en curso, sin revisar: se sube para seguir desde Claude cloud.
    ATENCIÓN: el DS.kicad_pcb tiene los rellenos de zona desactualizados
    (check_pcb: 147 violaciones guardadas vs 127 refilleando). Se commiteó
    con --no-verify. Correr tools/check_pcb.sh --fix antes de fabricar.
    [AK5538.kicad_sch, ALL_AMPS.kicad_sch, Amp_Bank.kicad_sch, DAC_PCM1690.kicad_sch, DS.kicad_pcb, DS.kicad_sch, DS_Power.kicad_sch, esp32-mini.kicad_sch]
2026-09-29 cambios en el esquematico
    [stm32_custom.kicad_sch]
2026-09-29 tools(ds12): el netlist sin KiCad, el estado del PCB, y el checklist tildado contra lo dibujado
    Revisión del diseño de la DS12 al 29-sep desde la nube, donde no hay kicad-cli ni
    DS.net (está en .gitignore). Para poder preguntarle algo al esquemático que se está
    dibujando hacía falta el netlist, así que:
    - tools/sch2net.py deriva el netlist directamente de los .kicad_sch (jerarquía con
    instancias múltiples, buses, etiquetas de los tres tipos, símbolos de
    alimentación, las doce orientaciones de símbolo de KiCad). Autoprueba: sobre el
    esquemático de la DS11 (tag ds11-release) da 0 diferencias de conexión en 2049
    pines contra el netlist que exportó KiCad de esa placa (DS.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
